paomodabaibai/CyberBrick2-User-Research-UX/README.md

# milk 组桌面双足对战机器人（当前使用 CyberBrick 1）

仓库名沿用早期 CyberBrick 2.0 命名；当前两台机器人实际使用 **CyberBrick 1**。这里集中管理用户研究、方案汇报、视觉素材、结构建模、控制程序与实测记录。

## 当前重点

- 旋转巴掌机器人：遥控行走、转向、倒退和巴掌攻击已实测。
- 出拳机器人：持续遥控、行走/转向、上慢下快出拳及按住 K4 跳舞已获现场确认；独立电池、主动断链与长时稳定性仍待专项验证。
- 项目资料：研究结论、竞品与参考资料、提案文件、硬件 BOM、串口控制原型。

## 快速入口

- [手工竞技场 v08：Figma尺寸图、A/B布局、3D与打印文件](06_游戏设计/Figma制作图与3D_v08/index.html)
- [手工制作 v07：采购、裁切与装配说明](06_游戏设计/手工制作与贴图_v07/README.md)
- [拳头机器人基本完成交接](00_项目管理/2026-10-17_拳头机器人基本完成_交接.md)
- [落地墙体竞技场 v04（历史方案）](06_游戏设计/落地墙体竞技场_v04/README.md)
- [换电脑继续工作：最新状态、环境安装和上传方法](00_项目管理/换电脑继续工作_2026-10-11.md)
- [项目上下文与当前进展](PROJECT_CONTEXT.md)
- [CB1 双机接口对照](04_结构与硬件/CB1双机接口对照_2026-10-11.md)
- [Otto V9 组装速查](04_结构与硬件/Otto_V9组装速查_2026-10-11.md)
- [出拳机器人头部建模详细说明](04_结构与硬件/Otto_CB1出拳头部_v01/出拳机器人头部_建模详细说明_团队同步版.md)
- [出拳头部建模与装配说明](04_结构与硬件/Otto_CB1出拳头部_v01/README_建模与装配.md)
- [出拳头部参数](04_结构与硬件/Otto_CB1出拳头部_v01/parameters.json)
- [出拳头部建模脚本](04_结构与硬件/Otto_CB1出拳头部_v01/build_punch_head.py)

## 目录说明

| 目录 | 内容 |
| --- | --- |
| `00_项目管理` | 计划、任务与协作资料 |
| `01_研究参考` | 用户研究、官方资料与竞品参考 |
| `02_汇报` | 阶段提案与汇报材料 |
| `03_视觉素材` | 图片、图标等视觉资源 |
| `04_结构与硬件` | CAD、打印件、BOM 与装配文档 |
| `05_程序与测试` | 控制程序、串口工具与测试记录 |
| `06_游戏设计` | 对战地图、制作尺寸、贴图与3D交付 |

## 协作约定

1. 开始工作前先拉取 `main` 的最新内容。
2. 每项工作新建短分支，例如 `mechanical/punch-head-fit` 或 `control/home-sensor`。
3. 提交信息写清对象和结果，例如 `调整出拳滑轨间距至 24mm`。
4. 通过 Pull Request 合并到 `main`，在描述中注明改动、验证方式和待确认事项。
5. CAD 参数与生成结果同步更新；物理试装结果写入对应验证记录。

## 本地生成环境

运行时、依赖缓存、第三方应用只读副本和重复交付压缩包不纳入版本控制。出拳头部可在其目录中按说明安装依赖并重新生成 STL、STEP、GLB、预览图和运动验证文件。
