paomodabaibai/CyberBrick2-User-Research-UX/04_结构与硬件/队友拳头模块_2026-09-28_增量审阅/README.md

# CyberBrick 2.0 用户研究与体验设计

本仓库用于团队协作，集中管理桌面双足对战机器人的用户研究、方案汇报、视觉素材、结构建模、控制程序与测试记录。

## 当前重点

- 旋转巴掌机器人：已有结构方案、打印件与控制验证记录。
- 出拳机器人：基于 CyberBrick 1.0 LA024 电机与 LA016 1:48 减速箱，采用滑块曲柄机构实现拳头打出与收回。
- 项目资料：研究结论、竞品与参考资料、提案文件、硬件 BOM、串口控制原型。

## 快速入口

- [项目上下文与当前进展](PROJECT_CONTEXT.md)
- [出拳机器人头部建模详细说明](04_结构与硬件/Otto_CB1出拳头部_v01/出拳机器人头部_建模详细说明_团队同步版.md)
- [出拳头部建模与装配说明](04_结构与硬件/Otto_CB1出拳头部_v01/README_建模与装配.md)
- [出拳头部参数](04_结构与硬件/Otto_CB1出拳头部_v01/parameters.json)
- [出拳头部建模脚本](04_结构与硬件/Otto_CB1出拳头部_v01/build_punch_head.py)

## 目录说明

| 目录 | 内容 |
| --- | --- |
| `00_项目管理` | 计划、任务与协作资料 |
| `01_研究参考` | 用户研究、官方资料与竞品参考 |
| `02_汇报` | 阶段提案与汇报材料 |
| `03_视觉素材` | 图片、图标等视觉资源 |
| `04_结构与硬件` | CAD、打印件、BOM 与装配文档 |
| `05_程序与测试` | 控制程序、串口工具与测试记录 |

## 协作约定

1. 开始工作前先拉取 `main` 的最新内容。
2. 每项工作新建短分支，例如 `mechanical/punch-head-fit` 或 `control/home-sensor`。
3. 提交信息写清对象和结果，例如 `调整出拳滑轨间距至 24mm`。
4. 通过 Pull Request 合并到 `main`，在描述中注明改动、验证方式和待确认事项。
5. CAD 参数与生成结果同步更新；物理试装结果写入对应验证记录。

## 本地生成环境

运行时、依赖缓存、第三方应用只读副本和重复交付压缩包不纳入版本控制。出拳头部可在其目录中按说明安装依赖并重新生成 STL、STEP、GLB、预览图和运动验证文件。
