paomodabaibai/CyberBrick2-User-Research-UX/04_结构与硬件/落地墙体竞技场_v04/README.md

# 落地墙体竞技场 v04 · 试打印组件

2026-10-12。所有组件直接放在同一层地面上。纵向结构只有落地墙和整枚落地靶；靶无支架、底座或升高平台。本目录是待试打的几何原型。

## 打印清单

| STL | 尺寸 mm | 完整场地数量 | 用途 |
|---|---|---:|---|
| 01_wall_160x40x60 | 160 × 40 × 60，四条竖边 R4 | 2 | 限制横向切入的落地墙 |
| 02_ground_target_80x160 | Ø80 × 160，壁 0.8，底 1.2 | 2 | 开口朝上的整枚落地靶，整枚倾倒判定 |
| 03_floor_tile_179p6 | 179.6 × 179.6 × 6 | 15 | 180 节距的平整地板，5 × 3 排列 |
| 04_bridge_connector | 44 × 18 × 2 | 22 | 地板底面连接；不得放在行走面上 |
| 05_seam_coupon_left | 39.8 × 40 × 6 | 试配 1 | 与右样片组成 0.4 mm 接缝 |
| 06_seam_coupon_right | 39.8 × 40 × 6 | 试配 1 | 与左样片和连接片试配 |

优先只打印 **2 面墙、2 枚靶、2 片接口样片和 1 个连接片**，在现有平整桌面上摆放试打。墙脚用可移除胶固定；靶底不粘。墙和靶均不应在机器人初始直线路径上造成必须绕行的小缺口。实体试打确认后再考虑 15 块地板。

## 打印与拼装

- 墙平底向下打印，模型为实心 CAD 外形；切片可用稀疏填充。固定墙脚再测试，不能依赖墙的自重防滑。
- 靶底向下、开口向上打印；0.8 mm 薄壁须在切片中确认能连续生成。两枚靶使用同样材料、层高、壁厚和底层参数。记录实际称重，不能仅靠外观判断一致。
- 地板和接口样片建议翻转，让完整行走面朝打印台，底部连接凹槽朝上打印。打印后翻回，完整平面朝上使用；消除接缝毛边。平整打印面仍须检查翘曲。
- 连接片直接平放打印。底凹槽深 2.4 mm，连接片厚 2 mm；接口每侧名义余量 0.3 mm。地图节距 180 mm，地板边长 179.6 mm，拼接缝 0.4 mm。
- 接口是定位片，没有弹性自锁。拼接后在背面胶带定位，再整体放在平桌面上；不要在上表面横跨接缝贴厚胶带。切勿只靠连接片搬运整张地板。
- 5 × 3 地板共有 12 条横向相邻边和 10 条纵向相邻边，共需 22 个连接片。外围空凹槽在底面，不形成路面台阶。
- 地板 179.6 mm 加两侧各 8 mm brim 为 195.6 mm；最高零件为 160 mm。以上只验证名义 200 mm 打印体积，实际切片仍需核对设备可用范围。

## 击倒目标的适配边界

靶高 160 mm 是可调整的初始值。文档模型给出的约 135 mm 击打参考高度落在靶身内，**不是实测击打高度或动态包络**。实际巴掌与拳头能否打中、会不会先用机身推靶，均需摆放机器人验证。

按理想 CAD 体积和假设材料密度 1.24 g/cm³，脚本给出理论实体质量。它不包含切片误差、材料差异，墙的稀疏填充也不会按实体质量打印。Ø80 的底部及 160 mm 高度没有经过击倒测试，不能据此声称容易击倒或两种攻击平衡。

第一轮试打记录：实际击打高度、两枚靶称重、静置是否稳定、单次攻击能否倾倒、靶是被攻击机构击倒还是被身体推倒、墙是否滑移、两种机器人的表现差异。若需修改靶高度或底部尺度，同一场的两枚靶必须同步修改。

## 数字检查与再生成

`geometry_report.json` 保存每个 CAD 实体的有效性、单实体数量、STL 水密性、连通性、法线绕序、体积和包围盒，另检查接口样片与连接片的精确实体交叠为零。没有进行物理打印、切片、强度或游玩验证。

修改 `parameters.json` 后，在仓库根目录运行：

```powershell
& 'D:/python/python.exe' '04_结构与硬件/落地墙体竞技场_v04/build_components.py'
```

脚本使用已有 `04_结构与硬件/cad_runtime/Lib/site-packages` 中的 CadQuery 和 trimesh。生成 6 种 STL、检查报告，以及包含说明、参数和脚本的 `试打印组件包_v04.zip`。
