paomodabaibai/CyberBrick2-User-Research-UX/requirements-serial.txt

# For uploading/diagnosing CB1 MicroPython boards on a new Windows PC.
mpremote==1.29.0
pyserial==3.5
