paomodabaibai/CyberBrick2-User-Research-UX/03_视觉素材/milk_slap_blue_concept_v01_生成记录.md

# 巴掌款单机概念图 v01

文件：milk_slap_blue_concept_v01.png

生成方式：内置 imagegen；2026-09-16。无参考图片输入。用户希望巴掌与拳击两种版本，先生成巴掌款。

用途：课程提案外观概念图。不是精确复刻 Otto CAD，也不是已验证的机械装配图。图中关节细节、手掌尺寸和转轴安排仍需结合硬件校核，PPT 应标注“概念效果图”。

## 完整提示词

Use case: product-mockup. Create one high quality industrial design concept rendering for a university design presentation: a single small 15 cm tabletop two-legged toy battle robot, a slap-hand variant, no other robots. Otto DIY inspired simple construction: compact rounded rectangular cream-white body with two simple round dark eyes on its front (physical inset discs, NOT a screen), two extremely short blue legs directly below body, no knees, each leg attaches to a broad flat blue foot, four-servo-style biped geometry with believable hip and ankle pivots, low compact stance. One lightweight slapping module mounted on upper side of body: short simple horizontal swing arm on a vertical shoulder pivot, ending in an open five-finger rounded padded blue toy hand held vertically, palm clearly visible and ready to swing horizontally. No elbow, no human-like articulated limbs, no boxing glove, no oversized heavy arm, no weapon. Other side of body has no arm. Body and feet suggest practical 3D printed plastic with subtle layer texture, hand suggests soft foam or silicone. Minimal visible mechanical complexity, plausible toy proportions; this is an exterior concept, not a validated mechanism or technical blueprint. Clean warm off-white studio background and ground, gentle contact shadow, soft diffuse lighting, polished but approachable student product-design aesthetic. Three-quarter front view, both feet and the open hand completely visible, entire robot within frame, generous clean margin. Landscape 4:3 composition. Cream white and friendly medium blue palette, charcoal eye accents. No text, no logo, no arrows, no dimensions, no extra views, no collage, no humans, no sci-fi armor, no wheels, no long legs. Prioritize readable simple short-leg biped shape and clear open-palm slap attachment.
