paomodabaibai/CyberBrick2-User-Research-UX/00_项目管理/继续任务_给其他Agent.md

> **2026-10-17 最终状态：拳头机器人基本完成。** 用户已确认最终四关节 ±25° 跳舞版“没问题了”。持续遥控、行走/转向、上慢下快拳头、推住持续出拳/松杆停止、K4 按住跳舞/松开停止均已具备现场确认。后续重点转为稳定性与对战演示；独立电池组合运行、主动断链停止、长时温升仍待专项验证。当前功能、接线、启动文件及证据边界见 [基本完成交接](2026-10-17_拳头机器人基本完成_交接.md)，本段优先于下方旧状态。

> **2026-10-22 双机控制已部署与资料合并：** 10月21日拳头5文件、巴掌9文件均已上传并板端SHA256核对，启动日志进入持续遥控。共用robot_remote.py，髋30°/踝20°/周期1秒，K4按住跳舞松开停；拳头M1上慢下快，巴掌D1双向900/2100µs、回中1500µs停。巴掌右杆无反应实测为接线松动，重插后用户确认完全恢复控制；攻击后续连接检查恢复转动。最大指令500/2500µs仅短测确认更快且机构正常，未长期保留。10月22日再次运行199项PC测试全部通过；最新转向轨迹、重心与长时负载仍不作全部验收声明。合并同伴场景分支32a21800，补齐PPT、80×120cm场景和插图；汇报原始资料入口为10.22最终汇报素材。短视频尚未制作。下方10月20日“待上传”均为历史状态。

> **2026-10-20 双机统一控制与K4跳舞（PC完成，尚未上传）：** 按用户新要求，两机已改为共用robot_remote.py的行走、单杆前后弧线、换向收步、K4按住跳舞/松开恢复、回中使能、失联停止与持续启动。只在攻击输出和各遥控器ADC校准值上区分profile：拳头M1上慢下快，巴掌D1正反转。统一髋30/踝20/周期1秒，舞蹈四关节±25；最终按用户要求以第一台原步幅为准，第二台髋±30范围待实测。199项PC测试通过（14项新增共享控制/D1/入口测试），两实际profile等效输入下腿PWM逐拍一致；未连串口、未上传、未驱动。原项目程序目录的“待上传_双机统一控制_2026-10-20”包为当前上传入口（巴掌9文件/拳头5文件），替代上一轮只传second_punch_remote.py的旧包。详见程序目录《2026-10-20_双机统一控制与K4跳舞_交接.md》。旧otto_session保留作历史调试，已不作为新巴掌启动入口。

> **2026-10-20 拳头单杆倒退修复（PC通过，待上传）：** 用户确认问题是同一根杆前推、后拉都沿前进弧线。已确认原拳头循环将单杆drive=0统一设为direction=+1；新增walk_direction保留推拉符号，stride_turn分离步幅侧与前后方向，并在换向前收至零幅度。保留髋20/踝16度最大幅度，差幅比由2:1改为3:1；共185项PC测试通过（新增11项），无串口、无上传、无机器人动作。本地巴掌源码也有原单杆默认前进分支，未把两机实物差异归因于不存在的独有映射错误；巴掌与共享振荡器文件没有修改。报告：`05_程序与测试/CB1_Otto控制框架_v02/2026-10-20_拳头单杆后拉前进_修复报告.md`。正式源码在 `E:/课程作业/milk-github-sync`；原项目同级程序目录有“待上传_拳头单杆倒退修复_2026-10-20”包，已有持续版第二台接收板仅替换second_punch_remote.py并复位，入口版本second-punch-walk-reverse-2026-10-20。用户回家再上传，现场前后位移与物理左右仍待确认。

> **2026-10-17 K4 功能更新：** 第二台拳头机器人的 K4（ch9、低电平按下）已由急停改为按住跳舞、松开结束；跳舞期间随机平滑变化四腿姿态，暂停行走输入并停止拳头电机。髋和踝目标偏移均已提高到 ±25°（用户已确认可用），仍受全局 65°–115° 输出限制。失联停止与回中使能保留；K4 不再是急停。173 项 PC 测试通过，三个文件已校验上传并复位；用户现场确认：按住跳、松开停，普通遥控正常，实机验收通过。

> **2026-10-17 第二台拳头机器人最新状态，覆盖下方 10 月 6 日旧断点：** 接收板已部署第二台专用 `main.py`，上电后持续运行三根杆：左/右行走与转向、上推慢拳 1024、下推快拳 1800；用户确认复位后都能控制且稍后仍有反应。PC 171 项通过。原厂 `boot.py` 仍禁用，发射板原厂无线启动未改；第二台启动源文件是 `05_程序与测试/CB1_Otto控制框架_v02/second_punch_main.py`，板上安装名是 `main.py`，切勿用仓库里第一台巴掌机器人的 `main.py` 覆盖。独立电池与断链实机专项验收仍待做。完整证据见 [第二台拳头控制现场记录](../05_程序与测试/CB1_Otto控制框架_v02/2026-10-13_拳头M1持续转动_修复记录.md)。

> **2026-10-06 第二台实测：** 四只位置舵机 S1–S4 已逐路 90→110→90 用户确认；Otto 连续步态脚本悬空/落地短试成功，用户确认落地前进；M1 拳头电机半速连续 5 秒用户确认正常。尚未做第二台遥控、并发出拳、自启动。接手先读 [第二台机器人实测记录](../05_程序与测试/CB1_Otto控制框架_v02/2026-10-06_第二台机器人实测记录.md)，下方 9 月旧断点只作历史参考。

> **2026-09-26 最新实测，覆盖下方巴掌旧猜测：** 用户确认 D1/GPIO21 直驱1700µs逆时针连续3秒、1300µs顺时针连续3秒，均正常；原先1600µs“动了”实际仅约30°，不是持续成功。下一步只把ATTACK.delta_us从100改200并验收摇杆正反转/松手停止。正式配置尚未改，测试已结束并释放D1，遥控主循环尚未恢复。执行入口：[巴掌正反转已验证_最小接入计划](../05_程序与测试/CB1_Otto控制框架_v02/2026-09-26_巴掌正反转已验证_最小接入计划.md)。摇杆自动回中；中间1500µs精准停转及五舵机并发仍需验收。
> **2026-09-26 攻击模块最新交接：** D1/GPIO21 已接巴掌360°连续旋转舵机，50Hz/1600µs实测用户确认能转。连续测试已停止、D1输出已关闭，尚未恢复遥控行走。用户纠正：第三根单轴摇杆会自动回中，旧“不回中”记录错误。历史通道ch2/L3、中位1860需自然回中复核。下一任务为双向低速、松手停止、与行走共享循环；目前只出计划，未实现。执行入口：[2026-09-26_D1巴掌摇杆控制_执行计划.md](../05_程序与测试/CB1_Otto控制框架_v02/2026-09-26_D1巴掌摇杆控制_执行计划.md)。下方旧硬件/控制状态不能覆盖本段。
# 给接手 Agent：milk 桌面双足对战机器人完整交接

> **最新交接（2026-09-26，覆盖下方所有旧断点）：** 全机完成：行走+转向+倒退+巴掌攻击均实机验收通过（用户确认）。攻击 = ch2 杆（自动回中，静止 1824-1827）→ attack_control.py → D1/GPIO21 连续舵机（1500 停/±200 定速）。上电即 otto_session 无限待命。PC 151 测试全绿。遗留小项：1500µs 慢爬长观察、五舵机长时供电、攻击方向语义对齐（翻 direction=-1 即可）。权威记录：《2026-09-26_攻击功能验收通过_最终记录.md》+《2026-09-26_D1巴掌控制_执行完成报告.md》。下方旧段均为历史。

以下为 2026-09-23 晚较早阶段的历史交接，最新实机细节优先看文件顶部链接的夜间遥控行走试验交接记录。

**🆕🆕 2026-09-23 晚：标定完成，板端已处于"可使能行走"状态，下一步就是用户在场走第一步：**
- **四路标定已回写并上板**：config.py 四路 calibrated=True；方向=实测（S1+=左腿前摆、S3+=右腿后摆、S2+=翘尖、S4+=压尖，均③用户确认）；S1 后摆 -10° 顶死 → left_hip min 收窄 82°（步态最多用 -8°）；其余 ±10° 无顶死。板端三文件（config 变体 c3c249f5…、gait_planner f988ef0e…、walk_session d7c948c6…）板上 SHA256 与本地一致，**板上 walk_blockers=[] / can_walk=True**。strict enable 使能时仍需：发射机开、K4 松、双杆回中、有有效帧。
- **左右踝符号已拆**（9-23 晚）：GAIT.ankle_sign_left/right 取代单值 ankle_sign（旧键保留为回退）。依据：双踝镜像（S2+=翘/S4+=压），单值符号永远无法让双脚同向倾斜。初始两值均 1.0，**未经验证，是现场调参旋钮**。
- **新板端入口 walk_session.py**（定时步行会话）：`import walk_session; walk_session.run(45)` —— 严格使能→按 20ms 轮询遥控 45 秒→打印每次状态变化→finally 保证关 PWM。专为串口 exec 无法转发 Ctrl-C 的现实设计；失败/K4/失联不自动恢复，靠打印观察。PC 测试覆盖：交替步、K4 停、无帧拒使能。
- **PC 测试 103 项全绿**（拆踝符号+walk_session+标定事实翻转后）。诚实门禁保留：诚实性测试改用"降级副本"驱动（真实硬件已标定，降级副本模拟未标定仍被拒绝）。
- **未做（下一个 Agent 的活，全部需要用户在场）**：①托住站姿 20s（walk_session.run(20)，期间用户把机器人放桌上）→ 观察双脚平放/倾斜/顶死；②桌面落地短站；③walk_session.run(60) 遥控单步：左杆前推=左步、右杆=右步、回中再触发、K4 停；④现场调参顺序：先看哪只脚该卸载没卸载 → 调 lean/ankle_sign_*（预期至少一个要翻转）→ hip_swing → 各阶段时间；一次只改一个，改完 PC 侧重新生成 _upload/config.py 变体（只改 DRIVER 行）→ 上传 → 板上 pop sys.modules 再 import。**不以"序列执行完"冒充一步成功**；每步记录观察。
- 今日已排除的假故障（都别再怀疑舵机）：S2/S3 "零反应"=插头接触不良，重插即恢复；每次动作前先按压检查四个插头。

**🆕 软件主线已切到 v02，并已完成验收整改+复核收尾（2026-09-22深夜，纯软件未碰实机，v01原样保留）：**
- 位置 `05_程序与测试/CB1_Otto控制框架_v02/`；`python run_demo.py` 一条命令演示（跑在sim_config虚拟档案上，不掩盖真实配置缺件），**整改+阶段A复核后84项测试全绿**（结果存档 output/测试结果_2026-09-22.txt）。**验收复核入口：《验收整改汇报_v02.md》**（按"问题→修改文件与位置→行为变化→验证方法与结果→尚未验证项"逐项写）；首轮汇报《任务汇报_v02_2026-09-22.md》仍留档。
- 正式分层框架：input_adapter→command_mapper→controller状态机→gait_planner五阶段（主髋摆动在unload_swing，land只落脚）→trajectory→joint_model→drivers。**cb1_pwm按关节配置（enabled/actuator/calibrated）决定通道，禁用/连续旋转通道永不创建PWM**；超限拒绝不钳位；停止≠松开输出；失联FAULT需显式recover。
- **显式使能（ENABLE_ON_FIRST_LINK已删除，收尾轮修通可执行流程）**：完整流程=`main_v02.run()`→Ctrl-C暂停（力矩保持）→`main_v02.SESSION.enable()`→`resume()`→`SESSION.recover()`→退出`SESSION.release()`；分步调试=`start(link=RcLink())`+逐拍`poll()`。enable/recover**现场重读遥控**，无活跃帧或K4按住拒绝；**回中后才接受迈步**。Ctrl-C暂停会**取消进行中步态**（STOPPED），暂停期K4/失联检测不运行；`resume()`仅重入循环；异常先释放输出再抛出；`release()`=关闭PWM≠切断舵机电源。**⚠️ REMOTE['stop_button']=3 是按钮组内偏移（from_rc内部+6），勿按v01习惯填全帧索引9。**
- **时间防护**：timeutil统一计时（板端ticks_diff/PC回绕等价）；dt<0记0；单拍>500ms走行中→FAULT拒绝跳阶段；新步不继承请求前等待。板端兼容静态检查完成（导入链无os.path/sys.path等CPython依赖），**板端运行待验证**。
- **新鲜度诚实化**：官方帧无序号/收包时间→timeout_ms=None不伪造新鲜度；不用摇杆值不变推断失联。
- **台架脚本`bench_v02.py`与《台架验证计划_v02.md》已交付**（阶段A）：diag只读/monitor无PWM/joint单关节/demo3缺件/gait完整单步/remote_gait；阶段B1/B2已实测通过（见下），B3等用户托住。
- **Otto V9腿部对中计划阶段一已交付并复核修正（2026-09-23）**：`04_结构与硬件/Otto_V9腿部对中计划_v01/`（安装图/记录表/使用说明/**安装图人工对照核对单**/**现场顺序卡_阶段C对中_一页**）+ **《硬件现货清单_2026-09-23.md》**（04_结构与硬件，未知全标"未核对"）；对中工具PWM两处缺口已修（切换自动关旧通道/seconds打断保证关闭），98项测试全绿+ v02 `center_joint.py`（单关节90°对中，write_one单通道接口，拒S2，导入无PWM，95项测试全绿）。阶段二（逐关节装舵盘）等四只180°舵机齐全+用户在场；手册第5-8页照片渲染图在 `01_研究参考/robot-battle-reference/manual_hi_p5..p8.png` 供人工对照。
- **阶段B1/B2实测已通过（2026-09-23，零舵机动作）**：接收板COM7；13文件（含补传timeutil）板上哈希一致；导入/diag/无动作验证（PWM通道空）通过；**左右杆前推=+1.00方向正确、K4识别正确、关遥控全部返回None（固件不缓存旧帧，失联保护可用）**。明细见v02《实测记录_阶段B_2026-09-23.md》与《台架验证计划_v02.md》状态表。
- 待补/未验证：config标定值（calibrated=False→B3须enable_debug）；B3缺左踝动作验证等用户托住；真实PWM出脉冲未验证（只验证了不产生）；C/D/E未开始；板上REPL Ctrl-C交互未实测。驱动选择`create_driver(jm,cfg)`只认传入配置。注意：`mpremote fs cat`经Windows管道转
，哈希校验须在板上用uhashlib算。**左踝换PG001后只需改config一条目，不改驱动。**
- 真机标定实测值（方向/trim/step_sign/ankle_sign）出来后回写v02的config.py，不要写死在别处。

**⚠️ 本文件下方第2、7、8节含已过时信息，以2026-09-22深夜勘误为准：**
1. **四个接口/四个舵机全部正常**。"S2舵机损坏"是误判（实为360°连续旋转舵机，中位死区）；"S3无响应"是脚本索引bug（改pin后旧脚本按旧索引驱动了S2）。
2. 接口映射实测：S1=左髋、S2=左踝位（现360°舵机占位）、S3=右髋、S4=右踝。方向读数：S1/S3 +10°=向右转（镜像安装）、S4 +10°=翘脚尖；语义未定标。
3. 遥控已通：左摇杆=L1/ch0（静止~1959）、右摇杆=R1/ch3（~1797）、唯一按钮K4/ch9（按下=0）；milk_jog.py摇杆直控舵机用户验证成功；REMOTE_MAPPING_VERIFIED=True。
4. **接收板boot.py已改名boot_official_disabled.py**，官方程序不再自启；恢复官方功能需改回文件名。
5. 托住单步四阶段（test_bench_step_held.py）程序侧已跑通，用户肉眼观察待补。
6. 硬件唯一缺口：~~左踝需180° PG001舵机~~（**已于2026-09-23换装完成**，四路齐）。

## 1. 用户目标、偏好与范围
项目目录：`E:\课程作业\大三上\张茫 用户研究与体验设计`。不要把文件放在本会话另一个作品集目录。
milk第2组，傅宬博、白昊灵、孔舒然、罗圣希。课程六周左右，提案汇报已完成，方向认可。
想做10–20cm桌面短腿机器人对战，两个遥控器分别控制两个机器人，击倒对方获胜。当前先做一台巴掌原型。
腿使用Otto V9原版，无膝关节，4舵机；身体和脚已打印，没打印原头壳。用户允许在身体钻小孔固定顶部模块。
巴掌奶白/蓝色方向，手掌饱满、塑料玩具感，掌面竖直、手指横向，绕竖直轴水平横扫。用户不喜欢先前薄片手掌；最终使用Tripo生成的网格。
拳头红色，用户选James Bruton Punchy齿轮连杆式出拳。只借鉴上部，不用其轮式底盘。
用户倾向快速做实物、当天试验，避免重复问已经确认的问题；愿意焊/转接舵机线。本轮暂不采用裸电机+减速箱驱动巴掌。
NFC刷技能卡、机器人脚部感知场景/道具属于“可能”，不可写成必需已完成。人工判倒地、扶起是首版工作假设，未承诺自动起身或闭环平衡。

## 2. CB1迁移与现有硬件
老师明确CB2不能用，当前CB1。旧CB2申请表必须保留为历史，不要按其接口编程。
曾申请六主控板：两机器人、两手柄、两场景/备用；面板开关6、电池6、双通道摇杆4。不是已实收清单。
当前实机有CB1接收扩展板Shield X11/XA004、发射扩展板XA005、XA003 ESP32-C3核心。
- 接收S1/S2/S3/S4：GPIO3/2/1/0。
- D1/D2灯信号：GPIO21/20，是第五舵机候选。官方buzzer.py使用这两个脚的machine.PWM，硬件实际线序、电源负载与资源仍须测试。
- M1驱动GPIO4/5，M2驱动GPIO6/7，经电机驱动桥；M口不是裸GPIO，不能给位置舵机当控制口。
- 按先前照片大电源座朝下：左上D2、右上D1、左下M2、右下M1、中间S1–S4。
- CB1白色小3pin线为SH1.0 3P；舵机黑色常规3孔插头通常为2.54mm，需要配公针的转接。现成SH1.0到杜邦公针线可选。即使插得上，仍要核实V/G/S顺序，不能全黑线凭位置猜。
- 用户照片确认B-LA026差速器包，以及B-LA016 1:48单轴减速包两包。它们不是已经装好的减速箱；裸电机具体型号看起来像030，未凭照片确认为LA024。
- 电机接口支持正反转、PWM调速、停止。以后拳头计划电机驱动，不代表已选定电机/减速比或适配完成。

PG001位置舵机资料：4.8–6V、180°；6V额定扭矩≥0.4kgf·cm、堵转≥1.2kgf·cm，堵转电流≤650mA。不可把堵转扭矩当持续能力。
机械：主体23×12mm，安装耳总32.5mm、孔距27.8mm、孔槽2.2mm；40T/约4.85mm输出花键，使用原配舵盘。SG90“9g”不代表舵盘或全部尺寸通用。
用户提过360°舵机也可能能用，但**实际巴掌舵机型号仍未确认**。普通连续旋转型控制速度/方向，不能按角度准确回位。
五舵机供电未带载验证；灯口电源不能凭存在就认为足够带舵机；也不能直接用高压电池给PG001供电。

## 3. 机械文件与不可混用的版本
### 原模型
`01_研究参考/robot-battle-reference/Otto-V9/`
- CAD/OttoDIY_v09.step
- 3Dprint/OttoDIY_body_V9.stl，以及Leg、foot等原打印文件。
原身体外包络69×69×39mm；装配坐标x/y±34.5，z=-39..0。

### 顶部架v01
`04_结构与硬件/Otto_PG001顶部巴掌模块_v01`
build_model.py、parameters.json、STL_打印件、STEP_可编辑实体、装配与渲染。
外框75×75，套合内口69.8，裙边8mm；桥75×22×3mm，舵机槽23.8×12.8mm，耳孔x±13.9；顶部桥z22..25，侧面固定框允许后钻孔。
v01中的旧薄巴掌/旧杆不是最新打印目标。保留框和PG001桥。

### 当前尺寸与v02接口
用户最后确认：**手掌最长边75mm；轴心到杆末端孔组中心51mm**。杆总长63.5mm，宽10、厚3。不能把51误作杆总长。
原Tripo：`C:\Users\Administrator\Downloads\thumbs+up+hand+3d+model.stl`。
项目副本：`04_结构与硬件/巴掌_Tripo网格与尺寸调整/巴掌_Tripo原始.stl`。
该目录的“输出_手掌75mm_杆距51mm”是旧无接口版本，不应重新当作最终掌打印。
最新：`04_结构与硬件/Otto_75mm巴掌腕部接口_v02/`
- build_interface.py：CadQuery+网格布尔，render_interface.py：VTK渲染。
- STL_打印件：01腕部试装件、02插入连接块、03杆末端试装片、04完整手掌75mm带接口、05完整连接杆51mm杆距。
- STEP_结构件：连接块/结构杆等实体；手掌依旧网格，不是假装参数化STEP。
- 装配坐标_勿直接打印、接口参数.json、几何验证报告.json、先读我_试装与打印.md。
- 整机总装_v02.png/.glb，腕部连接_装配拆解剖视.png。
连接块23×12×6mm；掌腕槽每侧0.25mm间隙。根部两颗 **M2×8**、两颗M2螺母；横穿腕部 **M2×25** +第三颗M2螺母；小垫片厚约0.3–0.5mm。根部不是M2×10，否则影响插拔。
已做闭合网格、静态重叠、离散插拔和螺钉包络检查；不等于强度、连续运动、打印公差已验证。

### 用户实际决定先打印整套
`04_结构与硬件/2026-09-21_整机首轮试打印包/`
五件各一：身体顶部框、PG001桥、51mm杆距杆、腕连接块、75mm完整掌。
同级 `2026-09-21_整机首轮试打印_五件各一.zip`。
用户已说“在打印了”，随后照片出现蓝色巴掌；不能推断所有五件都装好或通过测试。
不再强迫先打印三件量规，这是用户已覆盖的旧顺序。

### 工具环境
CAD Python：`04_结构与硬件/cad_runtime/Scripts/python.exe`，有cadquery、trimesh、numpy、VTK、manifold3d、fast-simplification等。
交互比例图：`C:\Users\Administrator\.codex\visualizations\2026\09\14\01a09d93-5828-7951-8f50-b4e4bdacf50a\otto-palm-proportions.html`；最新状态75/51。它早于v02正式接口，只用于比例，不是实际装配证明。

## 4. Punchy与提案资料
`01_研究参考/攻击模块/Punchy/`：Punchy.stp、joystick.stp、PunchyRobot.zip、LICENSE、README.md。
原仓库：https://github.com/XRobots/Punchy （MIT）。未完成缩放、驱动选择、安装座适配或承载分析。
提案：`02_汇报/2026-09-17_项目提案/`，14页PPT、逐页文案/讲稿、构建脚本；旧外观概念图曾被用户否定结构，只认可配色。

## 5. 当前控制需求与代码
用户要“推左杆 -> 左脚完整迈一步；右杆 -> 右脚一步”，不是单杆直接控单舵机。四舵机应协调移重心、挪步。机械没有膝盖，不做类人抬膝。
遥控现有两个单轴推杆；是否自动回中未知。可配按钮，现建议K1攻击、K2使能、K3停止。各插口及按钮极性未验证。
`05_程序与测试/CB1_Otto单步实验_v01/board/` 六文件：
- milk_config.py：所有映射和参数。
- milk_core.py：Trigger、Gait、RemoteGate、角度限位。
- milk_hw.py：PWM与Attack。
- milk_bench.py：REPL单关节、站姿、步态。
- milk_probe.py：固件和遥控只读检查。
- milk_receiver.py：官方rc_module接收循环。

来源与算法边界：
OttoDIY/OttoDIYLib的Otto.cpp walk：髋幅30°、踝幅20°，踝偏置+4/-4，髋踝相差90°；Oscillator用正弦；steps是周期数，不是指定左脚事件。
本版**不是完整移植原步态**，是参考配合关系独立写四阶段（移重心/卸载/摆动/落脚）小幅插值实验；无足底反馈，不能保证实际卸载。
当前幅度hip8°、lean7°、lift3°；4阶段各450ms；末端保留髋部偏角。
明确局限：首步任选，此后左右交替；同侧重复拒绝，尚未实现用户全部自由单侧迈步需求。不要对外说已经全部完成。
按杆过阈值一次触发；回中才再解锁；双杆冲突不动作；忙时丢弃不排队；攻击与步态互斥。
遥控两杆回中、攻击松开、使能按1秒才开始。停止锁存腿部最后指令，不自动回中；Ctrl-C退出释放PWM，因此需人工支撑。
250ms失联超时依赖rc_slave_data返回None。若固件返回缓存旧帧，本版没有包序号，不能可靠探测，应停下修复通信方案。
位置巴掌小幅往返；continuous模式按住转松手停并有700ms上限；默认关闭，未实测。
17项PC测试通过、CPython语法通过；六模块在真实MicroPython导入通过。不等于姿态、PWM、无线、供电和走路验证。

## 6. 实机连接与上传结果
串口环境：`05_程序与测试/serial_runtime/Scripts/python.exe`，独立venv安装mpremote1.29.0/pyserial3.5。
默认系统python是hermes环境，不往那个环境随意安装库。
COM7（接收）：序列58:E6:C5:A8:1B:0C，GPIO10=0，rc_index=1。
COM8（发射）：序列58:E6:C5:A7:00:A4，GPIO10=1。重插后应按序列与角色重新确认。
固件ESP32-C3，MicroPython1.23.0-preview，2026-03-25构建。
原文件已备份 `05_程序与测试/板载备份_2026-09-22/COM7,COM8`。保留boot.py、app/bbl/rc_config/log/.ignore；40文件271750字节，不是flash/NVS备份。
六milk文件仅上传COM7，SHA256核对一致，import全部成功。原boot.py和发射端文件未改。
连接使用`mpremote connect COM7 resume ...`避免隐式软重启；为进入REPL已经打断原应用。COM8也被打断，后续遥控测试需恢复发射端运行。
不要直接soft_reset接收器试运转；原boot.py会导入rc_main并自动运行原官方控制。不能让官方控制和实验程序同时占PWM。

## 7. 最重要的现场断点
详情见同项目程序目录 `现场调试记录_2026-09-22.md`。
- 用户不知道S口与四关节的对应，所有名称都还是占位！不要用config.name当真实映射。
- 用户托好后允许测试；S1(GPIO3)中位1秒，命令成功并关闭输出。用户说没关节动。
- 用户确认电池开着，允许继续。
- S1中位±5°缓慢往返两次（约3秒运动，加前后等待），最终关闭输出；终端START和PWM OFF正常。**用户尚未反馈这次有没有动。**
- 过程中一次内联串口命令因引号SyntaxError未执行；改成本地test_s1_live.py运行成功，不要当硬件故障。
- 没测试S2/S3/S4，没跑站姿、步态或巴掌。CALIBRATED/REMOTE_MAPPING_VERIFIED/ATTACK_ENABLED都False。
- 用户当前只要求总结保存，交接文档不构成自动扩大幅度或接着动其他通道的授权。

## 8. 接手下一步，不从头重做
1. 先询问S1第二次测试的观察结果，必要时重新确认托好和巴掌断开。
2. 若动，记录实际关节和+/-方向，再逐路小幅辨认；若不动，优先电源/线序/接触/插口/单个已知舵机隔离，不扩大到大角度。
3. 记录“接口->真实关节”后重新排列JOINTS的pin；center/trim微调，不用大trim掩盖舵盘安装错齿。
4. 四关节标定后托住做站姿，再验证支撑侧。脚踝符号与LEFT_SIGN需现场校验，尚未验证的小步可能只拖脚或原地扭动。
5. 再试串口左右交替；随后恢复发射端、读取十通道原始值、测失联行为，再启用遥控。
6. 最后单测第五舵机接线、模式、停止中点与扫掠空间，再加巴掌。
7. 每次明确记录：只成功发命令，还是用户已确认真实动作，不能混淆。

## 9. 主要来源
- CB1：https://github.com/CyberBrick-Official/CyberBrick_Controller_Core
- 固定参考提交：9712a8439f339a09e454baf543b8e97a5b1f03a7。
- API：https://makerworld.com/en/cyberbrick/api-doc/index.html（曾访问失败，优先本地源码及rc_module.rst）。
- Otto：https://github.com/OttoDIY/OttoDIYLib
- 030减速箱官方图：https://store.bblcdn.eu/s8/default/5eb26f09c19c49e481ebe4e0ace72cdd/Assembly_Guide_of_Single_Axis_030_Reduction_Motor.pdf
- CB1研究与STEP：`01_研究参考/CyberBrick1迁移研究/`。
早期CyberBrick软件API调用403、误调用Claude问题不是当前活跃任务；不要为当前校准重新配置大模型API。CB2的旧MCP连接也不是现在CB1串口控制的依赖。

## 后续只读复核补充：以最新进展为准（2026-09-22）
本轮读取了深夜更新，没有连接串口、运行舵机或上传代码。以下是本地源码复核，不是新的实机结论。
1. 当前真实断点已经前进：S1左髋/S2左踝位/S3右髋/S4右踝；S2是连续旋转舵机而非损坏。遥控jog用户验证成功，正式步态未验证。旧交接中“等待S1第二轮反馈”“boot未修改”已过时。
2. **不要直接重跑test_bench_step_held.py。** 脚本注释称S2只发中位，但循环实际调用out.pose(pose)，milk_hw.Output.pose逐个原样发送偏角，没有屏蔽左踝。因此会给S2连续旋转舵机发送非中位脉宽。应先换正确180°舵机，或修改测试明确排除S2并验证；排除S2的三关节演示不代表完整步态。中位是否真能停转仍需校准，不能凭1500us假定。
3. **正式milk_receiver.py目前无法用K4解锁。** config把ATTACK_BUTTON/ENABLE_BUTTON/STOP_BUTTON均设9：按下使能时同时stop=True且pressed=True，RemoteGate优先停止、neutral条件也要求not pressed。jog成功不等于正式接收状态机成功。需另设计单按钮状态逻辑或增加独立按钮，并测试冲突后再启用。
4. milk_config.py头部仍写左踝FAULTY，已被最新实物识别推翻，后续改代码时同步清理此过时注释。
5. 17项测试通过属于旧配置历史结果；当前REMOTE_MAPPING_VERIFIED=True后旧测试test_default_config_no_activation断言False不再适配。没有在本轮重跑，不声称最新修改仍全部通过。
下一步优先处理上述两项源码与说明矛盾，然后在180°左踝就位、方向与中位确认后做完整步态。不要按旧文直接绕过CALIBRATED门禁。
