paomodabaibai/CyberBrick2-User-Research-UX/00_项目管理/新电脑Agent完整交接_2026-10-12.md

> **2026-10-17 最终状态：拳头机器人基本完成。** 用户已确认最终四关节 ±25° 跳舞版“没问题了”。持续遥控、行走/转向、上慢下快拳头、推住持续出拳/松杆停止、K4 按住跳舞/松开停止均已具备现场确认。后续重点转为稳定性与对战演示；独立电池组合运行、主动断链停止、长时温升仍待专项验证。当前功能、接线、启动文件及证据边界见 [基本完成交接](2026-10-17_拳头机器人基本完成_交接.md)，本段优先于下方旧状态。

> **2026-10-17 K4 功能更新：** 第二台拳头机器人的 K4（ch9、低电平按下）已由急停改为按住跳舞、松开结束；跳舞期间随机平滑变化四腿姿态，暂停行走输入并停止拳头电机。髋和踝目标偏移均已提高到 ±25°（用户已确认可用），仍受全局 65°–115° 输出限制。失联停止与回中使能保留；K4 不再是急停。173 项 PC 测试通过，三个文件已校验上传并复位；用户现场确认：按住跳、松开停，普通遥控正常，实机验收通过。

# CyberBrick 项目总结与新电脑启动交接

> **2026-10-17 最新状态，覆盖下文旧的“无 main.py/限时测试”描述：** 拳头接收板原厂 `boot.py` 已禁用，第二台专用 `second_punch_main.py` 已作为板上 `main.py` 安装，复位后持续运行 `seconds=None, mode='both'`；三根杆分别控制左/右行走和转向、上推慢拳 1024、下推快拳 1800。用户现场确认复位后全部可用，稍后仍有反应。通道为左 ch3、右 ch0、拳头 ch2、K4 ch9；拳头上推 ch2 高值、下推低值。PC 171 项测试通过。**独立电池模式和断链实机专项验收仍未完成。** 当前源文件在 `control/second-punch-remote` 分支；详见 [`2026-10-13_拳头M1持续转动_修复记录.md`](../05_程序与测试/CB1_Otto控制框架_v02/2026-10-13_拳头M1持续转动_修复记录.md)。

更新日期：2026-10-12（澳门时间）。本文可直接交给新电脑 Agent，按步骤下载项目、建立环境、上传并启动拳头机器人的限时遥控程序。

## 1. 先读这几个结论

- 仓库：<https://github.com/paomodabaibai/CyberBrick2-User-Research-UX>。
- **最新拳头代码在 `control/second-punch-remote` 分支。不要只下载 main。** 截至本次核对，已推送的最新功能提交是 `3dd8122`；交接文档本身可能产生更新提交。以该分支最新内容为准。
- 仓库名中的 CyberBrick2 是早期名称，当前使用 **CyberBrick 1、ESP32-C3、板载 MicroPython**。
- 本项目上传 `.py` 文件，使用 `mpremote`。保留原厂固件、无线配置和电机驱动，不需要 esptool 或 STM32 烧录工具。
- 当前任务重点是第二台“拳头机器人”。第一台“巴掌机器人”的程序、标定和自启动不能直接覆盖第二台。
- 当前拳头程序已随接收板上电自动运行；仓库 `second_punch_main.py` 是第二台专用入口，板上文件名 `main.py`。仓库根目录下另一份 `main.py` 是第一台巴掌机器人的入口，不可覆盖第二台。
- 用户确认硬件没有变化，要求沿用原通道映射，不强制重新逐杆采样；若同一套硬件连接正常，直接用 `second_remote_ready.py` 的配置继续。
- 用户要求每次项目更新在验证后及时提交并推送 GitHub。使用工作分支，报告实际推送结果。

## 2. 项目总体情况

这是 milk 组的桌面双足对战机器人项目，采用 Otto V9 四舵机双足底盘，两个机器人分别配置旋转巴掌和直流电机出拳机构。仓库包含用户研究、汇报、视觉素材、机械模型、打印件、接口表、控制源码及现场记录。

| 设备或功能 | 已知状态 |
|---|---|
| 第一台巴掌机器人 | 仓库记录已完成遥控行走、转向、倒退和巴掌攻击的实机验收 |
| 第二台历史测试 | 仓库记录已验证四舵机、短时前进及 M1 半速运行；不是本次连接的完整状态证明 |
| 本次第二台前进与左转 | 2026-10-11 执行前进 2 秒、左转 2 秒，用户明确确认“完全可以很不错呢” |
| 本次无线链路 | 发射板初始化成功；接收板能连续收到十通道帧 |
| 本次遥控运行 | 30 秒运行显示 ARMED，正常结束，没有异常 |
| 遥控机械验收 | 尚未收到用户对这轮遥控行走、出拳和并发真实动作的反馈；不能宣称全部验收 |
| 软件测试 | 原框架 151 项 + 新增 17 项，共 168 项测试通过 |
| 自动启动 | 未部署；原厂 boot.py 保留 |

目录：`00_项目管理` 为交接与计划，`01_研究参考` 为研究资料，`02_汇报` 为提案，`03_视觉素材` 为图片，`04_结构与硬件` 为模型/打印/接口，`05_程序与测试` 为代码与实测。

旧电脑仓库位于 `C:\Users\Windows11\Desktop\cyberbrick`。新电脑可以另选位置，后续命令均从新仓库根目录执行。

## 3. 新电脑下载正确分支

以下以 Windows PowerShell 为例。先安装 Git 和 Python。建议 Python 3.13，本次实际运行和测试使用 3.13；旧文档要求的 3.11 也可建立环境，但需自行跑回归。

目标文件夹不存在或为空时：

```powershell
git clone --branch control/second-punch-remote https://github.com/paomodabaibai/CyberBrick2-User-Research-UX.git cyberbrick
Set-Location .\cyberbrick
git branch --show-current
git log -3 --oneline
```

已有仓库时，先 `git status --short`，保留已有修改，再执行：

```powershell
git fetch origin
git switch control/second-punch-remote
git pull --ff-only origin control/second-punch-remote
```

如果此分支后续已合并到 main，应检查 main 是否确实包含下面三个遥控文件及最新实测记录，再决定切换；不能因 main 名称就假定它最新。

旧电脑 Git 直连失败，需要系统已有代理。新电脑仅在实际有对应代理时使用，例如：

```powershell
git -c http.proxy=http://127.0.0.1:7897 clone --branch control/second-punch-remote https://github.com/paomodabaibai/CyberBrick2-User-Research-UX.git cyberbrick
```

不要假定新电脑的代理端口也为 7897。

## 4. 建立独立 Python 环境并验证

仓库根目录：

```powershell
py -3.13 -m venv .venv
& '.\.venv\Scripts\python.exe' -m pip install -r requirements-serial.txt
& '.\.venv\Scripts\python.exe' -m mpremote --help
```

依赖固定为 mpremote 1.29.0、pyserial 3.5；无需激活 venv，直接使用其 python 路径即可。如果使用其他 Python 版本，修改 venv 创建命令即可。

运行不连接硬件的 PC 回归：

```powershell
Push-Location '.\05_程序与测试\CB1_Otto控制框架_v02'
try {
    & '..\..\.venv\Scripts\python.exe' -B -m unittest discover -s tests -p 'test_*.py' -q
} finally {
    Pop-Location
}
```

本次版本预期 168 项通过，耗时约 21 秒。若仓库有后续测试新增，以最新结果为准。失败时先处理环境或源码问题，不运行实机动作。

## 5. 识别接收板和发射板

先枚举，无须接管板端程序：

```powershell
& '.\.venv\Scripts\python.exe' -m mpremote connect list
```

上一台电脑的身份记录：

| 板卡 | 原串口，仅供参考 | USB 序列号 | GPIO10 |
|---|---|---|---|
| 拳头机器人接收板 | COM14 | `80:F1:B2:1E:0F:FC` | 0 |
| 配套发射板 | COM15 | `80:F1:B2:1D:43:3C` | 1 |

**新电脑的 COM 号可能不同。** 根据序列号优先匹配，再定义实际端口，例如：

```powershell
$receiverPort = 'COM14'  # 替换成新电脑实际值
$transmitterPort = 'COM15'  # 替换成新电脑实际值
$controlDir = '.\05_程序与测试\CB1_Otto控制框架_v02'
```

必要时逐块连接，读取角色：

```powershell
& '.\.venv\Scripts\python.exe' -m mpremote connect $receiverPort resume exec "import machine; print(machine.Pin(10,machine.Pin.IN).value())"
& '.\.venv\Scripts\python.exe' -m mpremote connect $transmitterPort resume exec "import machine; print(machine.Pin(10,machine.Pin.IN).value())"
```

第一条应为 0，第二条应为 1。mpremote 会接管 REPL，可能打断原应用；检测后应恢复发射端无线初始化。不要同时打开 IDE 串口监视器和 mpremote。

## 6. 接线与最新参数

| 接口 | GPIO | 拳头机器人用途 |
|---|---|---|
| S1 | 3 | 左髋 |
| S2 | 2 | 左踝 |
| S3 | 1 | 右髋 |
| S4 | 0 | 右踝 |
| M1 | 4、5 | 拳头直流电机 |
| D1 | 21 | 拳头程序不用；属于第一台巴掌方案 |

四腿为位置舵机，50 Hz。测试步态髋幅 20°、踝幅 16°、偏置 4°、周期 1000ms、转向分幅 10°、直行配平 0。串口前进和左转实测保持这些参数。

遥控最新配置在 `second_remote_ready.py`：

```python
MAPPING = dict(left=3, right=0, attack=2, stop=9,
               left_center=2051, right_center=2128, attack_center=2146)
```

左 ch3、右 ch0、攻击 ch2、K4 ch9；K4 按下 0、松开 1。用户指定沿用映射。中值来自当前板的静态帧，不要再用核心模块内旧的 1797/1959/1825 默认值直接运行。

本次接收板原厂 `bbl/motors.py` 使用 `easypwm`，没有 `motors_period_cb()`；新控制代码兼容这一版本，也兼容需要周期回调的旧驱动。不要为补回调函数覆盖原厂驱动。

## 7. 上传代码：三份遥控文件缺一不可

先关闭串口占用，托稳机器人并让拳头前方留空。上传不会自动执行测试，但接管 REPL 可能终止之前运行的程序。

已有上传工具只负责前两个文件，不会上传 `second_remote_ready.py`。需要按下面步骤补传最新配置入口。

如果 PowerShell 阻止脚本，可只对当前会话设置：

```powershell
Set-ExecutionPolicy -Scope Process Bypass
```

上传主程序和振荡器，工具会核验接收板、检查 M1 接口、备份旧文件并回读 SHA256：

```powershell
& "$controlDir\准备拳头测试.ps1" -Port $receiverPort -ConfirmedReceiver
```

若报错，停止后续步骤。不要将失败时的部分上传当作完整成功。

备份并上传配置入口：

```powershell
New-Item -ItemType Directory -Force '.\work' | Out-Null
$backupDir = Join-Path '.\work' ('new_pc_upload_' + (Get-Date -Format 'yyyyMMdd_HHmmss'))
New-Item -ItemType Directory -Force $backupDir | Out-Null

# 先查看板端文件；second_remote_ready.py 已存在时执行下面的备份命令。
& '.\.venv\Scripts\python.exe' -m mpremote connect $receiverPort resume fs ls
# 仅在板端已有该文件时执行：
# & '.\.venv\Scripts\python.exe' -m mpremote connect $receiverPort resume fs cp :second_remote_ready.py "$backupDir\second_remote_ready_before.py"

& '.\.venv\Scripts\python.exe' -m mpremote connect $receiverPort resume fs cp "$controlDir\second_remote_ready.py" :second_remote_ready.py
if ($LASTEXITCODE -ne 0) { throw '配置入口上传失败' }
& '.\.venv\Scripts\python.exe' -m mpremote connect $receiverPort resume fs cp :second_remote_ready.py "$backupDir\second_remote_ready_readback.py"
if ($LASTEXITCODE -ne 0) { throw '配置入口回读失败' }
if ((Get-FileHash "$controlDir\second_remote_ready.py").Hash -ne (Get-FileHash "$backupDir\second_remote_ready_readback.py").Hash) {
    throw '配置入口哈希不一致'
}
```

最终接收板必须具备：`otto_oscillator.py`、`second_punch_remote.py`、`second_remote_ready.py`。原厂 boot.py、rc_config、bbl、app 保留。

不要上传整个目录覆盖板端，不要把第一台的 config.py/boot.py 一起复制。虚拟环境和本地备份无需上传。

## 8. 恢复发射端并启动遥控

发射板沿用原厂程序，不需要上传机器人控制文件。本次初始化方式：

```powershell
& '.\.venv\Scripts\python.exe' -m mpremote connect $transmitterPort resume exec "import machine, rc_module; assert machine.Pin(10,machine.Pin.IN).value()==1, 'not transmitter'; print('master_init=',rc_module.rc_master_init()); print('data=',rc_module.rc_master_data())"
```

正常应显示 `master_init=True` 和十通道数据。若只是重新上电且原厂发射程序已经正常运行，可不重复接管；若无数据，先排查供电、角色和配对。

接收板只做导入验证，不动作：

```powershell
& '.\.venv\Scripts\python.exe' -m mpremote connect $receiverPort resume exec "import second_remote_ready as remote; print(remote.MAPPING)"
```

使用者在场、机器人受支撑、三个杆回中且 K4 松开时，启动限时测试：

```powershell
& '.\.venv\Scripts\python.exe' -m mpremote connect $receiverPort resume exec "import second_remote_ready as remote; remote.run(seconds=30, mode='both')"
```

显示 ARMED 后可拨杆。命令运行约 30 秒，正常结束输出 M1 stopped / leg PWM off。Agent 应在测试前给用户清晰的开始提示，不要在未提示情况下多次重跑。

也可以分别执行：

```powershell
& '.\.venv\Scripts\python.exe' -m mpremote connect $receiverPort resume exec "import second_remote_ready as remote; remote.run(seconds=10, mode='walk')"
& '.\.venv\Scripts\python.exe' -m mpremote connect $receiverPort resume exec "import second_remote_ready as remote; remote.run(seconds=10, mode='attack')"
```

一次只运行一条，结束后再运行下一条。不要直接执行 `second_punch_remote.run()`，它会使用旧中心值。

## 9. 操作语义和停止

- 连续回中 0.5 秒才使能；启动时杆已偏转则不使能。
- 两行走杆同向推：前进；同向拉：倒退。单杆或差动输入：弧线转向，实际左右语义仍需用户观察。
- 出拳杆任一方向过阈值：M1 正向半速 1024。没有电机反转；松杆停止，连续最多 1.5 秒，完全回中后才能再次触发。
- K4 按下、无帧或坏帧会停电机并释放腿 PWM。回中后可以重新使能，K4 不是永久锁存急停。
- Ctrl-C、时限到或异常会执行清理，停 M1 并关闭腿 PWM。PWM 关闭不切断供电，机器人可能失去支撑；现场保留电池开关可用。
- 无线 API 没有帧序号/收包时间。失联保护依赖固件返回 None，不能保证识别缓存旧帧；必须实测遥控断电的停机行为。
- 拳头机构没有回零传感器；当前短时转动不保证“一拳一次”或自动回到收拳位置。

若同一硬件不进入 ARMED，可读取几帧判断链路和回中是否偏移；这是故障诊断，不需要从头重新做硬件研究。用户已经指定保留原通道映射。

## 10. 没有发射板时的已验证串口动作

仅在用户要求动作时运行。上传 `second_scripted_motion.py` 后执行：

```powershell
& '.\.venv\Scripts\python.exe' -m mpremote connect $receiverPort resume fs cp "$controlDir\second_scripted_motion.py" :second_scripted_motion.py
if ($LASTEXITCODE -ne 0) { throw '动作脚本上传失败' }
& '.\.venv\Scripts\python.exe' -m mpremote connect $receiverPort resume exec "import second_scripted_motion as test; test.run()"
```

该脚本回中等待 2 秒，前进 2 秒，左转 2 秒，300ms 回中后关闭 PWM，拳头电机保持停止。2026-10-11 用户确认实际前进和左转可用。

## 11. 若硬件继续插在旧电脑上

上述步骤默认 USB 硬件直接插在新电脑。如果硬件仍接旧电脑，新电脑不能直接使用自己的 COM 号；应先 SSH 到旧电脑，然后在旧电脑运行 mpremote，或使用仓库的 `远程上传CB1脚本.ps1`。

旧电脑曾使用 `windows11@192.168.1.107`，sshd 已配置；新地点/IP 是否可达需要验证。Windows 管理员用户密钥路径取决于 sshd_config，可能使用 `C:\ProgramData\ssh\administrators_authorized_keys`。已有远程上传助手只支持单个文件，不会自动部署三份遥控文件或配置发射端。SSH 场景同样需完整上传依赖，并显式调用远程 PowerShell。

## 12. GitHub 同步与交接约定

仓库文档 `00_项目管理/GitHub同步约定.md` 记录了用户的持续授权。每次代码、配置或实测有更新，跑相关验证，更新实测记录，然后提交并推送 `control/second-punch-remote`；不要强推，不随意覆盖团队 main。

```powershell
git status --short
git diff --check
# 用明确路径加入本次修改，不把无关内容一起提交。
git add <本次修改文件路径>
git commit -m "说明实际修改和验证结果"
git push origin control/second-punch-remote
```

新电脑需配置 Git 提交身份并登录具有仓库写权限的 GitHub 账号。旧电脑账号 nexuskarisma 首次遭遇 403，随后权限生效并推送成功；新电脑认证仍须单独建立。发生 403 时报告真实失败，不把本地提交称为已上传。

本地 `work/` 和 `.venv/` 已忽略，备份不要进入 GitHub。新电脑必须自行备份板端；旧电脑工作目录的备份不会随 clone 下载。

优先阅读 `README.md`、本文件、`2026-10-11_拳头遥控测试说明.md` 和三个最新遥控源码。PROJECT_CONTEXT.md 和旧交接保留过时 COM 号、电脑路径及历史状态，不能据此覆盖最新配置。

## 13. 新 Agent 的任务边界

继续第二台拳头机器人的遥控测试，沿用已准备的最新入口与用户指定的映射。先完成环境和上传校验，再在现场用户准备好后启动短时测试；记录程序输出和用户观察，区分“运行成功”与“真实动作验收”。后续推进倒退、右转、出拳、并发、K4 和断链停止验收。自动启动、长期运行、回零传感器或改变攻击输入属于后续设计项，不能假定已经完成。
