paomodabaibai/CyberBrick2-User-Research-UX/04_结构与硬件/CB1双机接口对照_2026-10-11.md

# milk 组 CB1 双机接口对照（发给组员版）

**方向约定：** 机器人面朝前，左/右按机器人自身左右。两台底盘都用 Otto V9 四只 **180°位置舵机**；四路均已做过中位及小幅动作观察。安装时先接对端口，再给 90°中位，最后锁舵盘。

| 接收板接口 | 主控 GPIO | 机器人部位 | 已验证状态 |
|---|---:|---|---|
| **S1** | 3 | 左髋：左腿前后摆 | 两台均已动作；第一台 +角度=左腿向前 |
| **S2** | 2 | 左踝：左脚倾斜 | 两台均已动作；第一台 +角度=脚尖翘起 |
| **S3** | 1 | 右髋：右腿前后摆 | 两台均已动作；第一台 +角度=右腿向后 |
| **S4** | 0 | 右踝：右脚倾斜 | 两台均已动作；第一台 +角度=脚尖压下 |
| **D1** | 21 | 第一台的 360°连续旋转巴掌舵机 | 第一台实测可正反转；第二台不用 |
| **M1** | 4、5 | 第二台的拳头直流电机，经板载 H 桥 | 第二台实测半速持续转 5 秒；第一台不用 |
| M2 | 6、7 | 备用直流电机口 | 板载驱动源码有映射；本项目未实测 |
| D2 | 待核实 | 备用扩展口 | 不列入当前接线；不要凭猜测接舵机 |

**舵机中位：** PG001 项目当前使用 50 Hz、1500 µs = 90°。S1–S4 是带位置反馈的 180°舵机；巴掌 D1 是连续旋转舵机，1500 µs 代表停止、1300/1700 µs 是两个转向，不能把它当作“90°定位”。M1 为两线直流电机口，不接三线位置舵机。插头方向按实物 `S/V/G` 丝印核对；先确认供电电压和极性，不要只按线色猜测。

## 遥控器与程序现状

| 项目 | 第一台巴掌机器人 | 第二台拳头机器人 |
|---|---|---|
| 左右行走杆 | 第一台实测：实体左杆 ch3、右杆 ch0；前推 ADC 增大 | 遥控器与接收板配对、通道映射尚未单独验收 |
| 攻击输入 | 第三单轴杆 ch2，自动回中，控制 D1 巴掌正反转 | 尚未接入遥控拳头控制 |
| 按钮 | K4 对应 ch9，但第一台现用程序中无功能 | 待定义 |
| 当前能力 | 第一台遥控行走、转弯、倒退、巴掌已实测 | 第二台仅脚本短时前进 + 独立 M1 电机运行实测；尚非遥控对战成品 |

## 安装时随时让四路保持 90°

板端脚本：[hold_90_cb1.py](../05_程序与测试/CB1_Otto控制框架_v02/hold_90_cb1.py)；电脑端发送工具：[发送四舵机90度.ps1](../05_程序与测试/CB1_Otto控制框架_v02/发送四舵机90度.ps1)。**一次只接一台接收板**，脚本会确认 GPIO10=0，防止误发给遥控发射板。已装好腿脚时请先托住机器人，程序可能让关节突然回中。

在 PowerShell 进入项目 `05_程序与测试/CB1_Otto控制框架_v02` 后运行：

```powershell
& '.\发送四舵机90度.ps1' -Port COM9
```

把 `COM9` 换成电脑当前显示的接收板串口。只插着一块 USB 接收板时，可省略 `-Port` 自动识别。程序会上传脚本并执行 `hold()`，四路会一直输出 90°信号，供装舵盘。装完后若要主动关闭 PWM，在板端 REPL 输入 `import hold_90_cb1 as h; h.off()`；断电或重启也会解除保持。此工具**不会修改 `boot.py`、无线配对、D1 或 M1**。

依据：[Otto 官方 V9 手册](../01_研究参考/robot-battle-reference/OttoDIY_Manual_V9.pdf)、[第一台逐关节安装记录](Otto_V9腿部对中计划_v01/逐关节安装记录表.md)、[第二台 2026-10-06 实测记录](../05_程序与测试/CB1_Otto控制框架_v02/2026-10-06_第二台机器人实测记录.md)、第二台板载 `bbl/motors.py`。第一台与第二台的 GPIO/端口映射相同；脚的实际正向观察不能自动推广到第二台。
