paomodabaibai/CyberBrick2-User-Research-UX/05_程序与测试/CB1第五舵机扩展核查_2026-09-22.md

# CB1第五舵机扩展核查

结论：四个专用舵机插座已占满，但不等于ESP32-C3只能控制四舵机。优先验证GPIO21或20所对应的LED信号通道作为第五个50Hz舵机信号；尚未接实物，不宣称灯插座即插即用。

新增证据：官方buzzer.py明确将GPIO21/20配置为machine.PWM。因此PWM复用有官方代码依据，不仅仅是GPIO理论推测。ESP32-C3官方LEDC文档确认6个独立通道；四腿＋一个攻击舵机共5路，在通道数上可行，但需要检查目标固件及其他PWM对象是否占用。停用同脚LED/蜂鸣器控制，避免覆盖输出。

实现分为信号、电源两部分：确认实际板为XA004/X11，读清LED端口GND/电源/信号顺序和连接器，核对信号路径/电平，再制作匹配转接线。第五舵机由合适的稳压电源供电，信号地共地；不默认LED电源引脚可承担舵机浪涌。不把外置稳压器正极与板载5V输出直接并联。PG001为4.8～6V，不能将接收板7.4～12.6V输入直接接舵机。

备选1：PCA9685类I2C舵机PWM扩展板，需两条适用且可双向通信的GPIO、匹配逻辑电平及独立舵机电源V+。不能仅据LED口能输出PWM就认定LED路径可当I2C SDA，也不能把PCA板当电源扩容器。
备选2：第二套核心＋接收底板专管攻击，增加体积、重量、电源与无线逻辑；作为备用，不优先为一个额外信号增加整块板。
普通舵机一分二线只是复制同一路脉冲，不能得到独立第五通道。直流电机口经H桥，不能直接当舵机信号或5V电源。

下一步实物确认：用户提供接收板正反面及LED口清晰照片，确定转接线类型/线序；再读固件并单独验证信号和一颗无负载舵机，最后四腿＋攻击联动测供电。不在此阶段上传执行程序。

来源：
- 官方蜂鸣器PWM源码：https://github.com/CyberBrick-Official/CyberBrick_Controller_Core/blob/master/src/app_rc/bbl/buzzer.py
- 官方舵机源码：https://github.com/CyberBrick-Official/CyberBrick_Controller_Core/blob/master/src/app_rc/bbl/servos.py
- 芯片PWM通道：https://docs.espressif.com/projects/esp-idf/en/stable/esp32c3/api-reference/peripherals/ledc.html
- 社区作者针脚核查：https://github.com/rotorman/CyberBrick_ESPNOW/wiki/CyberBrick-Receiver-Shield-(X11)
- 扩展板原厂接线：https://learn.adafruit.com/16-channel-pwm-servo-driver/hooking-it-up
