paomodabaibai/CyberBrick2-User-Research-UX/02_汇报/2026-10-22_项目问题与迭代总结/配图说明.md

# 配图说明

照片保留原貌；模型截图与装配图只说明设计过程，不替代实物验证。

## 01_接收扩展板正面_现场照片.jpg
- 类型：实物照片
- 适合说明：接口扩展：四路舵机口与电机口。不能用它证明无线配对状态。
- 原始文件：E:\作品集\抖音ai创作大赛26\.codex-remote-attachments\01a09d93-5828-7951-8f50-b4e4bdacf50a\68e87115-cae1-4de8-bdfc-6e447bc61fe0\2-Photo-2.jpg

## 02_板卡背面_现场照片.jpg
- 类型：实物照片
- 适合说明：板卡与硬件排查过程，配合接口说明使用。
- 原始文件：E:\作品集\抖音ai创作大赛26\.codex-remote-attachments\01a09d93-5828-7951-8f50-b4e4bdacf50a\68e87115-cae1-4de8-bdfc-6e447bc61fe0\1-Photo-1.jpg

## 03_舵机接口不匹配_现场照片.jpg
- 类型：实物照片
- 适合说明：标准舵机头与小型白色插头的差异。
- 原始文件：E:\作品集\抖音ai创作大赛26\.codex-remote-attachments\01a09d93-5828-7951-8f50-b4e4bdacf50a\763f91a8-5f86-4196-a0e4-7bba41f46830\1-Photo-1.jpg

## 04_电机与舵机对比_现场照片.jpg
- 类型：实物照片
- 适合说明：说明两种执行器的选择，不表示裸电机能直接完成出拳。
- 原始文件：E:\作品集\抖音ai创作大赛26\.codex-remote-attachments\01a09d93-5828-7951-8f50-b4e4bdacf50a\f4761830-4aff-4445-9262-d7a1ac32300c\1-Photo-1.jpg

## 05_减速齿轮包_现场照片.jpg
- 类型：实物照片
- 适合说明：拳头机构需要减速组件及相应安装结构。
- 原始文件：E:\作品集\抖音ai创作大赛26\.codex-remote-attachments\01a09d93-5828-7951-8f50-b4e4bdacf50a\c155bebf-af22-414e-ad86-e7ccae083f0f\1-Photo-1.jpg

## 06_拳头俯视检查_模型截图.png
- 类型：模型截图
- 适合说明：展示朝向、位置与整机比例检查，不能当实物照片。
- 原始文件：E:\课程作业\大三上\张茫 用户研究与体验设计\04_结构与硬件\拳头_整体比例预览_v02\check_top.png

## 07_拳头位置调整_模型截图.png
- 类型：模型截图
- 适合说明：展示整机预览中的攻击模块位置调整。
- 原始文件：E:\课程作业\大三上\张茫 用户研究与体验设计\04_结构与硬件\拳头_整体比例预览_v03\check_adjusted.png

## 08_拳头模块装配标注_模型图.png
- 类型：装配模型图
- 适合说明：对应底座、曲柄、连杆、滑架、拳头等连接关系。
- 原始文件：E:\课程作业\大三上\张茫 用户研究与体验设计\04_结构与硬件\拳头_全套打印包_2026-09-29\成品装配图_零件标注.png

## 09_巴掌连接剖视_模型图.png
- 类型：装配模型图
- 适合说明：说明巴掌与横臂、腕部接口的连接设计。
- 原始文件：E:\课程作业\大三上\张茫 用户研究与体验设计\04_结构与硬件\Otto_75mm巴掌腕部接口_v02\腕部连接_装配拆解剖视.png

## 10_球靶调高与锁紧_模型图.png
- 类型：装配模型图
- 适合说明：说明按打击高度设计目标和锁紧结构；不代表实打验收。
- 原始文件：E:\课程作业\大三上\张茫 用户研究与体验设计\06_游戏设计\打印脱落球靶_v09\制造初样_v01\04_总装与检查\01_总装与调高锁紧.png
