paomodabaibai/CyberBrick2-User-Research-UX/06_游戏设计/打印脱落球靶_v09/两机模型击打高度测量_2026-10-19.md

# 两机模型击打高度测量 · 2026-10-19

状态：已实际读取本地三角网格并测量；静态CAD结果，不是实物动态试打。旧v07木条、布带悬挂靶方案已被用户否决，新方案优先打印。本文件仅记录测量依据与初样建议，不代表新靶已定版或生成STL。

## 基准与结果

统一采用原版Otto V9中立装配姿态；身体顶面Z=0，脚底Z=-89 mm。离行走面高度=模型Z+89 mm，不叠加场地板厚。

| 部位 | 装配Z范围/mm | 离地高度/mm |
|---|---|---|
| 75mm巴掌实体 | 23.299～78.803 | 112.299～167.803 |
| 用户微调后拳头实体 | 24.032～70.032 | 113.032～159.032 |
| 拳头最前端10mm区域 | 25.880～66.773 | 114.880～155.773 |

拳头前端10mm按X >= 最大X-10筛选网格顶点，是几何参考带，不等于整个区域同时接触球靶。球曲率、拳面形状及来向决定实际接触点。巴掌数值是全掌实体的包络，不代表每一个高度都有同样面积与力道。

两实体高度交集113.032～159.032 mm。拳头前端参考带与巴掌交集114.880～155.773 mm。初样可将靶心定在135mm附近，保留约120～150mm调节范围；范围为设计建议，不是已验证适配。

## 数据来源与变换

1. 01_研究参考/robot-battle-reference/Otto-V9/3Dprint/OttoDIY_foot_V9.stl：脚底Z=-89。
2. 04_结构与硬件/Otto_75mm巴掌腕部接口_v02/装配坐标_勿直接打印/04_完整手掌75mm_带接口.stl：采用render_interface.py中的总装平移[5.34,0,39.97]。并读取同目录整机总装_v02.glb独立核对part_9及part_3/4，结果一致。
3. 04_结构与硬件/拳头_整体比例预览_v03/拳头微调导出.stl：按prepare_fist_print_v01.py及render_assembly_guide.py方法，以面邻接连通分量提取最大分量（501668面），得到用户最终微调后的拳头。没有使用旧预览的yaw等参数重新生成覆盖用户微调。
4. 04_结构与硬件/拳头_全套打印包_2026-09-29/05_拳头与腕部连接_一体试打印.stl：打印姿态外包络87.273×31.198×46mm，与微调拳头Z高度46mm一致；该文件被平移到打印床，不能直接把其Z=0当作机器人地面。装配恢复方法见render_assembly_guide.py。

拳头机构按设计沿X直线运动，行程不会改变Z高度；巴掌按模型绕竖直轴旋转，水平转动不会改变Z包络。这些结论均以机身中立且机构安装与模型一致为前提。

## 对新靶结构的影响

- 可以用同款、同高度球靶，无需目前就分别做两个高度。
- 135mm从旧腕部参考值变为此次实体测量支持的初样起点，但仍不能称实测最佳靶心。
- 若球直径60mm、球心135mm，球体105～165mm；若直径70mm，则100～170mm。两者均覆盖共同参考带，优先比较轻量60mm初样及实际命中容错。
- 下托磁吸座须尽可能小，并在球下方；后支撑臂和立柱仍须结合完整攻击扫掠检查。高度重叠不能证明支架无碰撞，也不能证明磁吸阈值合适。
- 模型与实物差异：巴掌总装参考PG001/PG002外形，实物连续舵机的输出轴安装高度若不同、舵盘/垫片改变、腿中位或站姿倾斜，都可能改变离地高度。因此保留调节，不要求用户现在先人工测量才继续设计。
