paomodabaibai/CyberBrick2-User-Research-UX/03_视觉素材/儿童围观对战_过肩镜头_2026-10-21/生成记录与提示词.md

# 儿童围观对战｜过肩镜头生成记录

- 日期：2026-10-21。
- 生成方式：内置 image_gen / imagegen，三张独立图片。
- 需求：很多小孩围观同一场游戏、热烈气氛、过肩镜头、前景机器人占比较大、现场有很多不同款式的同系列机器人；延续横版16:9构图。
- 场边新增薄荷绿、紫色、黄色、橙色、粉色及不同外壳装饰作为概念款式。
- 这是AI生成的使用场景与产品款式示意；原始输出由工具写入默认目录，交付原图另存本目录。

## 参考图片

1. E:\CodexData\Temp\codex-clipboard-7de9c0b0-d19b-4b7e-bb32-ce48b2da7fe2.png
2. E:\work\大三上\CyberBrick2.0\用户研究与体验设计\03_视觉素材\儿童试玩场景_2026-10-21\03_近景互动_16x9.png
3. E:\work\大三上\CyberBrick2.0\用户研究与体验设计\03_视觉素材\地图双机纯插图_2026-10-21\地图双机_电影感横屏_v02.png

## 通用提示词

```text
Use case: photorealistic-natural.
Generate ONE HORIZONTAL LANDSCAPE 16:9 high-resolution photographic concept usage scene of many children enthusiastically watching a match played with the user's own little biped robot toy product. A genuine OVER-THE-SHOULDER SHOT is essential. Large clearly readable robots in the foreground, lots of excited children beyond the arena, multiple distinct variants of the SAME robot product family present. Full bleed single photograph, no collage or graphics.
Reference 1 supplies ONLY the crowded semicircle of people leaning in to watch a live robot demonstration and spontaneous documentary energy. Replace the audience with predominantly 7–11-year-old Chinese children. Do not copy the large humanoid robot, signage, exact people's identities or room.
Reference 2 supplies real photographic product appearance, materials, small physical scale and teal play arena; reference 3 supplies clear product forms. Preserve the cream rounded rectangular bodies, two simple black oval eyes, two very short Otto biped legs without knees, two broad independent flat feet, visible pivots, top-mounted playful soft palm or fist modules. The primary blue robot has a turquoise top frame, blue broad feet and a blue open palm facing vertically with fingers pointing sideways at the end of a short horizontal top arm. The primary red robot has red broad feet and a compact red top mechanism holding a red soft rounded fist. Each complete robot is about 15–20 cm tall, enlarged IN THE CAMERA COMPOSITION by close perspective, not scaled into human-size machines. They look like tangible high-quality matte 3D-printed plastic prototypes, with subtle material texture and realistic contact shadows, not shiny CGI characters.
Show SEVEN distinct physical robots in total: the two primary blue-palm and red-fist robots currently facing off in the near central playing area, plus FIVE clearly visible varied sibling designs arranged along the sidelines ready for the next match. Each sibling retains the unmistakable cream box body + two oval eyes + short biped legs + wide colored feet + one top palm or fist module. Five sibling designs: mint-green accents with a tiny rounded dinosaur ridge on its shell and matching palm; lavender accents with small rounded cat-ear shell corners and a purple fist; sunny-yellow accents with a rounded helmet-like shell rim and yellow palm; orange accents with chamfered cheek-like shell panels and an orange fist; pink accents with two small round bear-ear shell details and a pink palm. These are credible interchangeable toy shells and colorful top modules, not unrelated humanoids or animals. Space every robot clearly, all fully assembled with two feet resting on the same physical arena/table surface. Do not merge their mechanisms or limbs.
The arena is the user's large low rectangular play board on a sturdy wooden activity table: teal-blue printed tech floor with fine geometric tiles and modest yellow details, thin wood perimeter and two low staggered dark teal T-shaped dividers with white support feet. Leave a clear central match zone so robots are not blocked by walls.
12–16 distinct children crowd along the far and side edges of the play table, laughing, cheering, leaning forward, a few clapping, a few with small raised celebratory fists, varied natural reactions and everyday colorful cotton clothes. Their eyes follow the robot match. No duplicated faces, no staged straight line, no stiff posing. The foreground player naturally holds a small unbranded physical two-stick controller below the shoulder; hands and controls correct and believable.
Composition priority: cropped out-of-focus near child's shoulder/back of head anchors the extreme edge, LOOK PAST THAT SHOULDER directly into the game. Foreground human should occupy no more than 15–20% of the frame; don't obscure the robots. Two main robots are the sharp hero subjects, each around 28–38% of image height, occupying the near lower-central area. Other five robots visibly occupy the sidelines at smaller perspective size; cheering crowd fills the upper half. Moderate depth of field keeps the spectators' expressions readable while the extreme foreground shoulder is soft. Normal wide-angle 28–35mm photography, camera near tabletop at seated child's shoulder level, perspective plausible, no fisheye.
Natural indoor light and warm energetic real-event atmosphere. Photorealistic Chinese children's activity reportage. No illustration, no humanoid exhibition robots, no full-size robots, no wheels, no long legs, no virtual effects, no sparks, no floating objects, no text, no logo, no watermark. AI imagined product usage scene.
```

## 01_男孩肩后_热烈围观_16x9

完整提示词为上方通用提示词加以下场景描述：

```text
Specific shot: from JUST BEHIND THE LEFT SHOULDER of a seated boy wearing a mustard-yellow cotton T-shirt at a school robotics open day. A soft cropped patch of his back, left shoulder, side/back of head at the left edge forms a clear over-the-shoulder foreground; a glimpse of controller at the lower left. Camera peers just to the right of his shoulder toward the blue-palm robot on the near-left and the red-fist robot on the near-right, both in a readable three-quarter view and playfully facing one another, mechanisms poised just before contact. Close proximity makes these TWO ROBOTS LARGE and prominent, but never oversized relative to the physical board. The five colorful sibling robots line the far-left and right sidelines, separated and readable. 14 cheering children fill a layered semicircle beyond them, some laughing with open mouths, two clapping, one leaning in excitedly with hands on the wooden rim. Airy sunlit makerspace, warm afternoon sidelight, pale walls and softly blurred shelves. Balanced documentary realism, intense shared attention to this one game.
```

## 02_女孩肩后_决胜欢呼_16x9

完整提示词为上方通用提示词加以下场景描述：

```text
Specific shot: from JUST BEHIND THE RIGHT SHOULDER of a seated girl in a pale lavender sweatshirt with a dark ponytail. Her softly defocused right shoulder and a little back-of-head enter from the extreme right edge, hands on a controller at the lower right. Camera sits close to her shoulder, just above the play surface, and looks diagonally across the arena. The blue palm and red fist robots dominate the near-center foreground in sharp three-quarter views, both complete feet and bodies visible, approaching one another in a lively competitive moment. The five differently styled sibling robots stand in staggered sidelines on the same surface, fully visible. A dense excited crowd of 13 children forms an arc in the background of a children's science activity center, varied ages 7–11 and everyday clothing, some cheering with raised hands, some laughing and calling toward the game, others leaning in with suspense. All focus on the robots. Bright broad window light, natural warmer highlights on wood, a small amount of genuine gesture motion in the crowd but crisp robots. Strong feeling of being right beside the player at a popular game, true over-shoulder composition.
```

## 03_双人肩间_机器人主视角_16x9

完整提示词为上方通用提示词加以下场景描述：

```text
Specific shot: a dynamic DOUBLE OVER-THE-SHOULDER composition from behind two seated child competitors at a crowded school play event. A very narrow soft cropped navy-clad shoulder and back-of-head at the far left, and a very narrow soft cropped cream-and-green-striped shoulder at the far right frame a broad unobstructed view BETWEEN them. The camera is at their shoulder level very close to the board, near the robots' level. Blue palm robot and red fist robot fill the near lower-middle, both full bodies in crisp focus and larger in the frame than any other object, facing each other diagonally so their eyes, feet and top-mounted modules remain readable. Five colorful alternate shell designs (mint dinosaur detail, lavender cat-ear detail, yellow helmet rim, orange chamfered shell, pink bear-ear detail) form a loose waiting lineup along the two sides of the same board, with obvious air gaps. Behind the match, 15 children are packed in a lively two-row horseshoe: front row leaning toward the arena, back row peeking between friends, naturally cheering and clapping at the action. Faces are distinct, expressive and happy. A bright community maker workshop with daylight from broad side windows, high-quality candid event photography, palpable excitement and believable physical tabletop scale. Avoid a centered posed group portrait: all attention flows into the foreground match.
```
