paomodabaibai/CyberBrick2-User-Research-UX/05_程序与测试/CB1_Otto控制框架_v02/2026-10-11_拳头遥控测试说明.md

# 第二台拳头机器人：限时遥控测试

新增入口 `second_punch_remote.py`；导入不动作，未修改第一台代码、boot.py 或 main.py。未做新的实机动作验证。

## 准备

电脑环境 `.venv` 已安装 mpremote 1.29.0、pyserial 3.5。当前枚举：COM6 / USB 序列 80:F1:B2:25:B6:A0；COM9 / USB 序列 80:F1:B2:14:16:54。哪一个是拳头接收板尚待现场确认。

先确认拳头接收板串口并扶稳机器人。在仓库根目录运行（示例 COM9，必须改为实际确认端口）：

```powershell
& '.\05_程序与测试\CB1_Otto控制框架_v02\准备拳头测试.ps1' -Port COM9 -ConfirmedReceiver
```

该脚本接管 REPL，核验 GPIO10=0、板载电机 set_speed/stop API 和 M1 GPIO4/5，备份旧文件，上传两个测试文件并回读校验，不自动运行。核验只能区分接收角色，不能自动区分两台机器人。任一失败停止后续步骤；两文件更新并非事务，失败后按备份恢复，不直接启动。控制循环兼容需 motors_period_cb 的旧驱动和原生 easypwm 驱动。

进入板端 REPL：

```powershell
& '.\.venv\Scripts\python.exe' -m mpremote connect COM9 resume repl
```

## 先确认遥控，不动作

```python
import second_punch_remote as p
p.monitor(15)
```

依次移动左行走杆、右行走杆、出拳杆、按 K4，记录十通道帧的变化与松杆中值。默认暂借第一台映射：左 ch3 / 1797，右 ch0 / 1959，攻击 ch2 / 1825，K4 ch9（按下 0、释放 1）。不能把默认值当第二台已验收映射。无帧时先检查配对，不运行动作。

按实测值建立配置，例如：

```python
mapping = dict(left=3, right=0, attack=2, stop=9,
               left_center=1797, right_center=1959, attack_center=1825)
```

## 依次短测

开始前所有杆回中、K4 松开；连续回中 0.5 秒后显示 ARMED。

```python
p.run(seconds=10, mode='attack', mapping=mapping)
p.run(seconds=10, mode='walk', mapping=mapping)
p.run(seconds=15, mode='both', mapping=mapping)
```

一次执行一条，观察结束后再进行下一条。attack 不创建腿 PWM；walk 不创建电机驱动；both 在同一循环并发。

行为：两行走杆同向推为前进，同向拉为倒退，单杆为弧线转向。第二台倒退/转向尚未实机验收，先托住观察。采用第二台已验证的髋 20°、踝 16°、偏置 4°、周期 1000ms；转向分幅 10°、直行配平 0，不复制第一台的更大振幅或配平值。

出拳杆任一方向过阈值均使用 M1 正向 1024（半速），不提供电机反转。松杆或回到中间过渡区域停机；连续运行最多 1.5 秒，必须完全回中才重新触发。这是连续曲柄机构的短时运行，不保证单次出拳或收拳归零：没有回零传感器。

K4 按下、无帧、坏帧：停电机并释放腿 PWM。恢复连接且所有杆回中 0.5 秒才能重新使能。Ctrl-C、时限到或异常同样停止电机并释放腿 PWM；释放 PWM 不切断电源，托住机器人避免失去支撑。

官方 API 没有包时间/序号；失联处理依赖 rc_slave_data 返回 None。第二台须实测关闭遥控器时是否停机，旧帧缓存不能靠本程序可靠辨别。首次并发测试只做短时观察，关注供电复位、卡滞和机构扫掠。

## 软件验证

新增 17 项测试覆盖回中门禁、按住超时、松杆重新触发、失联重连、K4、异常帧、并发、1ms 电机服务调度、PWM 异常清理、两种单独模式和原生 easypwm 驱动。模拟验证不能替代真实无线映射、负载供电和机构验证。

## 本次上传结果

2026-10-11 用户连接接收板后，检测到唯一串口 COM14，USB 序列 `80:F1:B2:1E:0F:FC`；GPIO10=0，MicroPython 1.23.0-preview / ESP32-C3。此板初始仅有原厂目录和 boot.py，没有此前第二台短试文件。不能由仓库历史记录断言它保留了旧配对或实测硬件状态。

板载 bbl/motors.py 使用 easypwm 原生模块，没有 motors_period_cb；已按现场源码修正兼容并通过新增测试。没有实例化电机驱动或执行动作。

已上传 `otto_oscillator.py`、`second_punch_remote.py`，两个文件回读 SHA256 一致，MicroPython 导入成功。boot.py 前后 SHA256 一致，未修改 main.py、无线配置或原厂驱动，未运行 monitor/run。板端保持 REPL；重启仍执行原厂 boot.py。

备份与校验文件在仓库 `work/COM14_before_punch_upload/` 和 `work/punch_backup_20261011_171703/`。下一步接发射板后确认配对和遥控映射，再分模式短测。

## 串口动作实测：用户已确认

随后用户明确授权“前进两秒，然后左转两秒”。通过 COM14 上传并执行 `second_scripted_motion.py`：先回中等待 2 秒，前进步态 2 秒，候选左转步态 2 秒，再用 300ms 回中并关闭腿 PWM；全程 M1 停止。终端正常输出 FORWARD、LEFT ARC、DONE 和 PWM OFF。

用户反馈“完全可以很不错呢”，确认本次前进、左转实际可用。左转参数为 `turn=+1`、`turn_split=10`，在前进相位下减小左髋振幅。髋 20°、踝 16°、偏置 4°、周期 1000ms，直行配平 0。这个结果只证明本次短时前进和左转，不证明倒退、右转、遥控、出拳或并发已经验收。

最新完整 PC 回归：168 项测试通过。遥控测试代码已在接收板上，但没有自动运行，boot.py 保持原厂版本；发射板可用后应先确认配对及各通道再更新参数。

## 发射板连接与无线检查

用户连接发射板后枚举 COM15，USB 序列 `80:F1:B2:1D:43:3C`，GPIO10=1。读取原厂 app/rc_main.py 确认其使用 rc_master_init 启动发射；本次手动初始化返回 True，未修改发射板原厂文件。COM14 上 rc_slave_init 后可连续收到十通道帧，证明当前无线链路可用。

5 秒预采样及 30 秒逐杆提示采样都未观察到明显通道运动或按钮变化，不能宣称实体左右杆/攻击杆/K4 已映射。近似稳定值：ch0=2128，ch2=2146，ch3=2051，ch4=3207，ch5=1796；按钮 ch6–ch9 都为 1。这些只是本次静态值，是否真正回中和实体对应仍待人工确认。

特别是候选攻击 ch2 与旧 attack_center=1825 的偏差超过 neutral 门限；不能直接启动旧默认参数，也不能通过自动把当前值当中位来掩盖未确认的输入位置。需用户逐杆操作重新采样，然后把实测中心值作为 mapping 参数传给 run。

接收板测试文件已再次备份、上传并回读校验，纯策略导入正常且 armed=False。未启动遥控机械动作，未更改配对文件或自动启动。接收板维持 REPL，发射端 native radio 已初始化；断电重启后按原厂启动流程运行。

## 用户指定保留映射并启动遥控测试

用户明确要求不用再采样，硬件未变，直接上传。沿用左 ch3、右 ch0、攻击 ch2、停止 ch9，不再进行逐杆辨认；当前静态帧中值用左 2051、右 2128、攻击 2146。通道语义依据用户确认，中值来自本轮无线读数，不代表完成全量程标定。

新增手动入口 `second_remote_ready.py`，导入不动作，`run(seconds=30, mode='both')` 将上述 mapping 传入已验证控制循环。已上传并回读 SHA256 一致。串口执行 30 秒并发遥控测试，输出 ARMED，表示有效帧和回中门禁已通过。没有更改 boot.py 或发射板文件。真实行走、转向、出拳和 K4 的结果仍需用户观察反馈。

下次手动测试：`import second_remote_ready as remote; remote.run(30)`。默认只运行 30 秒，不会在上电后自动运行。

本轮 30 秒已正常结束，终端输出 M1 stopped / leg PWM off，未报异常。日志仅证明程序使能并正常收尾，不证明期间用户拨杆或机构完成动作。
