paomodabaibai/CyberBrick2-User-Research-UX/05_程序与测试/CB1_Otto控制框架_v02/2026-10-13_拳头M1持续转动_修复记录.md

# 第二台拳头机器人 M1 持续转动：现场修复

日期：2026-10-13。分支：`control/second-punch-remote`。

## 现象与证据

- 用户发现拳头电机在未执行出拳操作时持续转动。接收板 COM9（USB 序列 `80:F1:B2:1E:0F:FC`）执行 `MotorsController().stop(1)` 后，用户确认电机立即停止。
- 板上三份程序 `otto_oscillator.py`、`second_punch_remote.py`、`second_remote_ready.py` 已重新上传，板上 SHA256 与本分支文件逐字节一致。因此“代码未上传”不是这次持续转动的原因。
- 接收板原厂 `boot.py` 会启动 `app/rc_main.py`，其接收端循环根据板上 `rc_config` 调用官方控制器。两块板的 `rc_config` 原来完全一致，名称为“叉车”：发送端通道 ch2、ch4 有四条指向 `MOTOR1`/`MOTOR2` 的 `controls`，接收端 `receiver_1.MOTOR1.en` 和 `MOTOR2.en` 都是 `true`。当时发射端 ch4 静态读数约 3300，明显偏离配置的 2048 中位。这个旧映射具备在原厂程序运行时持续驱动 M1 的条件，且与用户观察吻合。
- 自定义拳头程序的 `run()` 有 `finally: motor.stop(1)`；先前日志中的该语句只证明自定义测试结束时发了停止命令，不能保证随后原厂程序不会再驱动 M1。

## 修改

1. 分别从接收板和发射板备份原 `rc_config` 到本机未提交的 `work/board_audit_20261013/rc_config`、`transmitter_rc_config`。两份原文件 SHA256 相同。
2. 对两块板的 `rc_config` 做同样的最小修改：从 `sender.channels[*].controls` 中移除 `actuator` 为 `MOTOR1`、`MOTOR2` 的四条自动绑定；将 `receiver_1.MOTOR1.en` 与 `MOTOR2.en` 设为 `false`。保留其他通道、设备类型、无线配对和文件内容。板端回读与修改后的本地文件 SHA256 一致。
3. 接收板重启后，板端复核 `M1/M2 en=False`、电机绑定列表为空；用户确认电机保持停止。发射板同步修改并重新 `rc_master_init()` 成功、能读十通道帧；用户再次确认摇杆回中时电机保持停止。

## 后续使用与边界

- 自定义 `second_punch_remote.py` 直接用 `bbl.motors.MotorsController` 控制 M1，不依赖原厂 `rc_config` 的叉车绑定；本次改动旨在禁止**原厂自动控制**抢占电机。修改后尚未重新实测“拳头杆触发出拳”，需单独验证。
- CyberBrick 软件重新下发“叉车”配置或再次配对时，可能把旧电机绑定写回板上；如电机又自行转动，先关闭电池开关，停止 M1，再检查两块板的 `rc_config`。不要只重传 `.py` 程序。
- 发射板原始配置和接收板原始配置仅在本机忽略目录 `work/`，不在 GitHub；若换电脑前需要保留可恢复的字节级备份，应另行安全复制。仓库保留本记录和修改规则，不发布现场配对数据。
- 另一项未解决的遥控输入问题：2026-10-13 发射端逐杆十通道采样表明，拳头杆单独推动时 **ch3 约 886–3702**；右行走杆单独推动时十通道变化都不超过 15，左行走杆单独推动时也都不超过 18。用户分别确认实际推动了对应杆。原 `second_remote_ready.py` 的 `left=3, right=0, attack=2` 与当前硬件事实不符：ch3 实际是拳头杆，两根行走杆尚未被发射板读到。不要继续用该映射做带动作验收。先检查两根行走杆的插头、供电、所接接口与发射板配置，再逐杆重采样；不应仅靠修改机器人步态代码猜测修复。
- 修复原厂自动电机绑定后，**尚未重新启动 M1 出拳测试**，避免在输入未确认时重复出现电机持续转动。用户确认接收板重启、发射板恢复后，拳头电机都持续保持停止。

## 原厂程序抢控制的根因与后续修复

用户随后发现：推左杆时只有左脚单关节旋转，右杆和拳头杆均无预期动作，判断自定义代码并未接管。复核第一台巴掌机器历史记录：当时将**接收板**的原厂 `boot.py` 改名为 `boot_official_disabled.py`，之后用自己的 `main.py` 启动 Otto 遥控；发射板仍需原厂无线程序。第二台此前只上传三份 `.py`，接收板仍有原厂 `boot.py` 且无 `main.py`。上电会执行 `boot.py -> app/rc_main.py -> 原厂控制器`，按旧 `rc_config` 操作舵机/电机。此前仅清除 M1/M2 自动绑定，`ch3 -> PWM1` 的原厂绑定依旧存在，足以解释左脚单轴转动。上传文件、导入文件与持续运行文件是三种不同状态。

2026-10-13 实机处理：

1. 确认拳头接收板 USB 序列 `80:F1:B2:1E:0F:FC`（本机 COM9，GPIO10=0）；板上原有 `boot.py`、没有 `main.py` 或 `boot_official_disabled.py`。
2. 将原 `boot.py` 读回本机 `work/board_audit_20261013/boot_official_original.py`；板上复制为 `boot_official_disabled.py`，回读 SHA256 与原文件一致；随后移除板上 `boot.py`。发射板的 `boot.py` **未改**。
3. 重启接收板后板端确认 `boot.py=False`、`main.py=False`、`rc_main` 未导入。用户推杆实测：左脚不再单轴乱转，拳头电机保持停止。这验证原厂应用确实是抢控制来源。

当前接收板为**安全待命**，不是自动遥控成品：三份自定义程序在板上，但无 `main.py`，上电不启动任何行走/出拳循环。自定义 `second_remote_ready.run()` 只能手动运行，且现有映射与当前物理输入不符，暂不应带动作调用。先检查两根行走杆的插头/供电/接入口，逐杆确认十通道变化；再修改 `second_remote_ready.MAPPING`，完成短时行走、出拳、并发与停止测试。最后才建立第二台专用的上电入口，不复制第一台 `main.py`。如需恢复原厂启动，从备份把原 `boot.py` 放回板上；再次重配对可能清空文件系统，应重核启动文件和自定义程序。

## 2026-10-13 后续实测与拳头触发修复（覆盖上文旧判断）

- 严格分时逐杆采样重做后，真实映射为左行走 ch3、右行走 ch0、拳头 ch2、K4 ch9。旧的“拳头 ch3、行走无信号”是测试指令与用户操作未同步造成的误判，不应据此改线或改映射。接收板只读采样在用户反复推拳头杆时收到 1215 帧，ch2 范围 3–4086。
- 接收板单独输出 S1 约 105° 再回 90°，用户确认明显转动。限时仅行走运行打印 1241 帧、428 拍行走请求、腿部输出约 70°–110°；用户确认腿脚明显行走或摆动。这证明自定义程序在运行，原厂程序抢控制问题已解除。
- M1 直驱 1024 约 1 秒，用户确认拳头机构明显运动。初次限时仅攻击运行虽已 ARMED，ch2 范围 2–4087，但 `attack_ticks=0`。根因在 `RemotePolicy.update()`：从中位缓慢推向端点必经过 `neutral < abs(a) < threshold` 的半推区间，原 `else` 在首次越过半推区间就将 `attack_ready=False`，导致端点永远不触发。原单元测试直接从中位跳到端点，没有覆盖真实连续摇杆轨迹。
- 已修正为：出拳前经过半推区间保留触发资格；出拳开始后往半推区间回退立即停止，并必须真正回中才能再次触发。新增连续轨迹回归测试。修正上传后限时攻击运行打印 1241 帧、`attack_ticks=604`、ch2 范围 1–4088；用户确认“推杆时运动、松杆后停止”。结束后另发 M1 停止指令成功。PC 全套 **169 项测试通过**。
- 当前仅手动限时运行 `second_remote_ready.run(seconds=..., mode='walk'/'attack'/'both')`；接收板无 `main.py`，上电仍为安全待命。行走与攻击同时进行、电池独立运行、断链时 M1 停止及自启动均尚未实机验收。`trace=True` 会打印帧数、腿部动作拍数和角度范围、拳头触发拍数及 ch2 范围，便于后续验收。

## 2026-10-13 绿灯与“断连”复核

用户观察两板闪绿灯、推杆无反应，怀疑失联。接收板 COM9 执行只读检查，`rc_slave_init()` 返回 True，3 秒收到 141 帧，证实无线链路仍通。随后手动运行 `second_remote_ready.run(seconds=60, mode='both', trace=True)`，板端记录 2979 帧、行走请求 47 拍、拳头请求 599 拍；用户现场确认**行走和拳头都恢复动作，灯从绿变黄**。限时结束后程序打印 M1 stopped，另发 M1 停止命令成功。由此确认此次“绿灯无动作”的直接原因是控制会话已到时退出、且第二台尚无 `main.py` 自启入口；**不能把绿灯单独等同无线配对丢失**。灯色的官方完整状态定义本次未独立核对，不作更广泛推断。

## 2026-10-17 持续推拳头杆时自动停转的修复

用户希望拳头电机在拳头杆持续偏转期间一直运动，松杆才停止。原 `RemotePolicy` 用 `attack_ms=1500` 限制单次出拳时间，即使持续推杆也会停止，和本次控制语义不符。新增“持续推杆超过 15 秒仍输出、回中立即停止、再次推杆可重启”的回归测试，先确认旧代码失败，再移除自动超时，保留回中/半程释放停止、失联与 K4 停止逻辑。PC 全套 169 项通过。`run(seconds=...)` 仍是整个手动测试会话的时间上限（1–120 秒）；本改动仅取消一次推杆的出拳时长上限。实机上传和持续推杆验收状态以后续记录为准。

实机验收补记：拳头接收板 USB 序列 `80:F1:B2:1E:0F:FC`（本机 COM9，GPIO10=0）已上传修正版 `second_punch_remote.py`，板上与本地 SHA256 同为 `a8014dd3eeaf9a7808a72a2f7fb456dc9048d7e4f37bd1eed729dc2c783cc41f`。板端纯策略测试在持续推杆 5.4 秒后仍输出 1024，回中输出 0。45 秒限时实机测试收到 2230 帧，拳头杆范围 0–4087，出拳输出 942 拍；用户确认“**一直运动，松手即停**”。结束后程序自动停止 M1，并额外补发停止命令成功。此结果验证了本次持续按杆需求；整段会话仍会在 `seconds` 到时结束，自动启动尚未部署。

## 2026-10-17 上推慢拳、下推快拳

板载 `bbl.motors.MotorsController.set_speed()` 的文档范围为 -2048～2048，`_speed_handler()` 按 `speed/2048` 换算占空比；之前双向统一使用的 1024 约为半速，并非最高速。接收板只读实测：拳头杆**上推 ch2 约 4076（高值）**，**下推 ch2=0（低值）**。据此改为上推 `slow_speed=1024`、下推 `fast_speed=1800`，两侧仍驱动 M1 同一旋转方向，回中立即停；持续按杆、K4、失联处理保持原语义。`attack_up_is_high=True` 在第二台映射中显式标明，速度可在 `second_punch_remote.DEFAULT` 中调整，须满足 `0 < slow_speed < fast_speed <= 2048`。

新增双方向速度及反向映射的策略回归测试，PC 全套 **170 项通过**。修正版上传接收板，文件 SHA256 与本地一致；板端纯策略确认上推 1024、回中 0、下推 1800。120 秒限时实机对比中收到 5951 帧、两侧 ch2 范围 0–4086、出拳输出 584 拍；用户确认“**下推更快，松手都能停**”。结束后 M1 自动停止并补发停止命令。1800 为约 88% 指令占空比，未采用 2048 全速；速度变化不等同于电机扭矩或实际拳头动能的线性变化。

## 2026-10-17 第二台持续遥控入口

此前第二台只用 `second_remote_ready.run(seconds=...)` 的 1–120 秒限时测试，测试到时会主动关闭 M1 和四路腿部 PWM；板上无 `main.py`，上电后也不会自动启动。这解释了用户所说“测试一结束，移动杆没反应、像连接断开”。新增 `run(seconds=None, mode='both')` 无限会话，仍保留有时限的手动测试入口；新增 `second_punch_main.py`，只安装到**第二台接收板**的 `main.py`，上电自动启动行走＋转向＋上慢下快拳头。异常退出会在 `run()` 的 `finally` 中停 M1、释放腿部 PWM，启动入口隔 2 秒重试；K4/失联仍要求回中后重新使能。

PC 全套 **171 项通过**，新增无限会话超过原 120 秒测试时限后仍执行并可被中断释放的回归测试。2026-10-17 已核对接收板 USB 序列 `80:F1:B2:1E:0F:FC`、GPIO10=0、原 `boot.py` 不存在；上传修正版 `second_punch_remote.py` 与 `main.py`，板上分块 SHA256 分别为 `d458804ee1d8a59731951f3199b6a38d88be5a73747b1c271619519a9708577b`、`486a58aa9ac25c2f852b870dbc438cc2897736f44bc32162211ae667d8508897`，均与本地一致；板上编译成功并执行复位。用户现场确认**重启后左、右行走杆和拳头杆都能控制，稍后再推仍有反应**。独立电池模式和主动关闭遥控器后的失联停止仍待专项实测。

## 2026-10-17 K4 按住跳舞

按用户要求，K4/ch9 从急停改为跳舞键：低电平按住时跳舞，松开结束；跳舞期间覆盖普通行走请求并停止 M1，松开后普通杆恢复。输入配置字段由 stop 改为 dance。DanceMotion 每 300ms 生成一个伪随机目标并线性插值，髋目标 ±12°、踝 ±8°，开始时从当前姿态过渡；总输出仍受 65°–115° 保护。无帧与异常输入仍清空状态、停止运动并要求重新回中。K4 不再承担急停；实体电源开关可断电。

PC 全套 173 项通过，覆盖按住/释放、拳头停转、姿态变化及角度范围。second_punch_remote.py、second_remote_ready.py、second_punch_main.py（板上 main.py）已上传并核对 SHA256，板端均编译成功并复位到持续遥控。三者校验值分别为 4b8bf94c4830ae0c7941f7fd871ae5af14bfc70b4b17995cc71228033aa34565、7b099527b36058124c740962cba9923dc464e0f01e5b065feb7f1445646314bb、2fe998d16deba780cd38d48d76ff900ae3e7e1e9e90aab5252851a6f63d8c82f。用户随后现场确认：“按住跳、松开停，普通遥控正常”。K4 跳舞功能实机验收通过。
### K4 跳舞幅度增强

用户反馈初版跳舞幅度太小，已将 DanceMotion.LIMITS 从髋 ±12°/踝 ±8° 提高到髋 ±20°/踝 ±16°，目标更新时间仍为 300ms，保留插值与全局 65°–115° 输出限制。新增幅度下限断言，旧版先失败，修改后全套 173 项通过。已上传 COM9，板端 SHA256 与本地均为 a34fd949c97c1faeac44c35fc3a6d7880b0e736ec2eb32752cd8c139e92165bb，并复位恢复持续遥控。增强幅度的实机观察待用户反馈；初版按住/松开及恢复遥控的验收仍有效，但不能代替增强幅度的机械验收。
### K4 大幅交替摆动版

用户反馈提高角度后仍太小。此前均匀随机目标可能靠近中位且相邻目标同侧，实际行程远小于上限。改为每次各关节交替到另一侧，幅值随机为上限的 80%–100%，300ms 插值后保持 150ms，再反向；角度上限仍为髋 ±20°、踝 ±16°。新增端点保持、最小幅值和交替方向测试，旧版失败，新版全套 174 项通过。已上传 COM9，板端与本地 SHA256 均为 94824bdadb4188f293c99b92a9318ab5c683bfc94977fed2e43699c2fec57888，复位恢复持续遥控。该版机械幅度反馈待补。
### K4 四关节 ±25° 版

用户反馈大幅交替版仍太小，明确要求继续增加角度。已将四关节目标上限统一提高到 ±25°（绝对角度 65°–115°），目标幅值为上限的 80%–100%，其他时序与全局角度限制不变。相关 23 项测试通过，已上传 COM9 并核对 SHA256 为 0200610cafb9eaff146897cd450e6d1c3b94698e63bc94434245a2f2f525fe6b，复位恢复持续遥控。此前完整回归为 174 项通过；本次仅重跑受影响的 23 项，不宣称新角度已实机验收。
### 最终用户确认：拳头机器人基本完成

2026-10-17，最终四关节 ±25° 版上传并复位后，用户确认：“没问题了，拳头机器人基本好了，更新项目文档吧”。据此将最终舞蹈幅度状态更新为用户现场确认可用，第二台核心功能进入基本完成阶段。上文各旧版“待反馈”属于当时状态，不代表当前仍卡住。总交接已整理为 `00_项目管理/2026-10-17_拳头机器人基本完成_交接.md`。独立电池、主动断链、长时间供电/温升及对战负载等专项验证仍保留为后续事项。
