paomodabaibai/CyberBrick2-User-Research-UX/06_游戏设计/落地墙体竞技场_v04/交付验证.md

# v04 数字检查

2026-10-12。用户已明确否定悬挂/架空，当前交付只有单层行走面、接地墙体和整枚落地目标。

- 地图900×540mm，15块180mm节距地板，22片内部接缝连接片。
- A=(255,150)朝+X打TB=(480,150)；B=(645,390)朝−X打TA=(420,390)。双方参考中心距225mm，按静态拳头包络估算接近61.727mm；路线无需转弯。
- 墙均位于Y=250–290。静态机器人半宽57，行进线Y150/390，至墙最小侧隙43mm；不等同于动态净空。
- 默认2片160mm墙从X290连续排至610；左右平面留白各290mm。另一个布局X10–170及730–890，中央净开口560mm。
- 6种打印件CAD均有效且单实体；STL水密、绕序一致、单连通、正体积。接缝样片与底部连接片实体交叠0。详见硬件目录 `geometry_report.json`。
- 最高件160mm，地板最宽179.6mm，加两侧各8mm brim占195.6mm，处于名义200mm幅面内。精确机型与切片尚未检查。
- 竖靶CAD材料体积估算约46.68g（假设密度1.24g/cm³），未经打印称重。底部和墙底直接在Z=0行走面上；无抬高靶座、悬挂、桥梁或活动机构。
- 离线预览与SVG由同一个地图JSON生成；立体总览为按尺寸绘制的构造示意，机器人只画静态占地，不假设真实高度。
- 组件包内容与源文件字节核对一致。页面脚本、链接与两种布局的地面几何做本地检查。

浏览器预览会话最初因本地服务已停止而连接失败；服务恢复后，浏览器仍处于被URL策略阻止访问的错误页，因此本轮不声称完成浏览器交互验收。提供离线HTML和静态图，可直接打开文件查看。

尚未完成打印、接口试装、底座防滑、动态步态/扫掌净空、身体是否先推靶、有效击倒力度、公平性或复玩测试。先用两墙两靶在平桌上验证，不先扩印整场。
