paomodabaibai/CyberBrick2-User-Research-UX/06_游戏设计/落地墙体竞技场_v04/策划与制作说明.md

# 落地墙体竞技场 v04

日期：2026-10-12。状态：按用户纠正完成的场地与试打印原型，未打印或实机试玩。

## 这次修改

用户要求“纵向有些墙体阻碍一下行动就可以，绝对不要架空”。场地因此只有一个行走高度，墙和目标都直接落在地面；移除悬挂、共享摇摆、吊架和高台设计。机器人不登高，也没有需要穿过的架空结构。

两方依旧攻击敌方颜色的目标：A攻击TB，B攻击TA。目标的字母表示归属。本版只通过可移动的落地墙改变活动空间，不增加机关或任务链。

## 平面布局

场地900×540mm，5列×3行180mm节距地块；完整制造需要15块地板、22个底面连接片（横向12、纵向10）。179.6mm实物地板之间留0.4mm缝，外包络约899.6×539.6mm。全场由平整桌面承托，桌沿另留余量。

|对象|中心坐标 X,Y / mm|朝向或用途|
|---|---|---|
|蓝方 A|255,150|朝+X，直进打红TB|
|红TB|480,150|属于红方，蓝方攻击|
|红方 B|645,390|朝−X，直进打蓝TA|
|蓝TA|420,390|属于蓝方，红方攻击|

两条攻击线相距240mm，双方开局已对准目标，参考中心距225mm。按拳头模型最前点123.273mm与靶半径40mm，接近量约61.7mm；不是已测射程或需要执行的固定步数。两机分别校准摆位，短距离即可停步攻击，必经转弯为0。身体或脚先碰到目标时必须调整摆位/靶形，不能把推倒目标当击打。

## 两片落地墙

统一墙件160×40×60mm，竖边圆角R4，底部直接贴在地面。墙高60mm只是阻挡行动的初始高度，不要求机器人翻越。底部用可移胶固定；撞墙导致墙移位时暂停修正，不把墙当推行道具。摆位完成后再开局，不在局中搬墙。

|布局|墙中心 X,Y / mm|限制方式|
|---|---|---|
|中央短墙（默认）|(370,270)、(530,270)|两片墙接成320mm短墙，挡住中央横向穿行；左、右各留290mm空间|
|中央开口|(90,270)、(810,270)|墙移至两端，中央开口560mm，改变两区之间的通行位置|

所有墙在Y=250–290之间。上下平面通行带各250mm；按114mm静态宽度估算，路线上的机器人侧缘至墙最近43mm。这个值不包含摆脚、机身晃动和旋转巴掌，须实测；若正常动作碰墙，优先将墙移开或减小高度，不让玩家做更精密的纠偏。

两种布局的直达攻靶路线都不穿墙。侧边290mm空间只是几何留白，不能保证难转弯机器人能轻松完成绕行。因此绕墙不是胜利所需动作，不安排S弯、窄门或必须先绕障碍的任务。

## 整枚落地竖靶

两枚同款竖靶为Ø80×160mm薄壁开口筒，壁厚0.8mm、底厚1.2mm。整个靶底直接接触行走面，没有独立靶座、台面或悬挂支撑。杯筒内部的空腔用于减轻重量，不是可通行的架空结构。红/蓝身份标签放在旁边地面，或用两种同材质同规格色料，避免给一方增加重量。

现有拳头模型给出的击打参考约134.8mm；160mm靶高让该高度落在侧壁范围内，但巴掌实际高度、力道和动态扫掠尚未实测。竖靶比以前的短杯更高也更重，不能由外形推断一定更容易击倒。以实际试打寻找两机都能击倒的共同目标参数，两靶同款同质量同高度，不临时单独修改一方。

## 简单规则

裁判摆正两机和竖靶，说明“蓝打红、红打蓝”，倒数开局，60秒为试用时长。玩家前进、停步、攻击。**主动攻击件把敌方竖靶打至侧壁落地、无法自行恢复直立时获胜。** 仅滑走、轻微倾斜、摇晃后回正，均不算。若两靶倒下先后看不清则平局；到时未分胜负也平局，不比较距离。

|情况|处理|
|---|---|
|机身或脚推倒、手碰、桌面震动误倒|双方暂停，复位目标，不记得分；重复发生先改摆位或组件|
|明显偏航、撞墙卡住，需要精细转弯才能命中|每机每局至多一次人工摆正，保留沿原路线的前进进度；再次需要帮助记操控未完成，回到校准|
|两机接触或攻击扫到对方机器人|暂停检查动态净空，不要求互相推挤或拦截|
|失联、供电或机构异常|技术中止，不算玩家失败|

普通体验一局即可；连续玩最多三局，先得两胜结束，平局占一局，三局后胜局数相同则整场平局。换机、换边、换墙摆法作为开局前变化。两机转向能力有限，因此这版仍以敌靶竞速为主；墙体提供空间限制，不把它夸成已经验证的攻防策略。

裁判复位前确认机器人和攻击件停止。现有记录中第一台K4没有停止功能，不把按K4当停止确认；必要时物理断电。第二台最新仓库记录仍仅有试走和独立拳头电机测试，完成遥控及并发控制验收后再进行双人比赛。本轮没有修改控制程序或驱动机器人。

## 先试什么

先在平桌上贴胶带摆场，制作2片墙、2枚竖靶和接缝样片，不急着打印15块地板。检查竖靶静置稳定、墙不被普通步态带动、两种攻击都能击中侧壁。两机各做5次短直进试打，建议至少4次不需要转弯或重摆即可击倒；这是验证目标，不是已取得成绩。

确认固定摆位可操作后，再比较两种墙位各3局，记录人工重摆、误碰墙、主动攻击击倒、普通走动误倒、是否愿意再玩。若墙带来的只是频繁卡住，将墙外移；若单靶都难以击倒，先调整共同靶参数，不增加机关。

组件参数、装配与打印数量见 [硬件目录](../../04_结构与硬件/落地墙体竞技场_v04/README.md)。地图坐标源为同目录 `arena_layouts.json`。尚未验证打印机精确有效幅面、FDM配合、目标稳定性、实际桌面大小和玩法平衡。
