paomodabaibai/CyberBrick2-User-Research-UX/04_结构与硬件/拳头_3D生成参考/2026-09-28_拳头模型与队友结构接入记录.md

# 拳头模型与队友结构接入记录（2026-09-28）

## 用户新输入
- 拳头源文件：C:\Users\Administrator\Downloads\red+clenched+fist+3d+model.stl
- 项目归档副本：04_结构与硬件/拳头_3D生成参考/红色拳头_AI原始模型_v01.stl
- 队友仓库：https://github.com/paomodabaibai/CyberBrick2-User-Research-UX
- 队友以本项目完整副本继续开发；只检查新增/变更，避免重复导入和覆盖现有巴掌机器人程序。

## 已完成的文件检查
- 二进制 STL，25,083,884 字节，501,676 个三角面；文件长度与面数吻合。
- SHA256：44a6a2ff47b8a384697fa40c79c541d02ed35e50667fdda6469e9698cd666dd2
- 原始包围盒尺寸（X/Y/Z）：0.668609738 / 0.985290647 / 1.0。
- STL 不带单位；这些是原始坐标数值，不能当作已确定的毫米尺寸。尚未缩放、修网格或增加安装孔。
- 尚未验证水密性、独立壳体、壁厚和装配适配性。
- 之前巴掌的75mm与51mm杆距仅属巴掌版，不自动套用拳头。

## 队友仓库访问情况
- 当前 GitHub CLI GraphQL、REST API 与公开网页读取均返回不存在/404。
- 原因尚不明确，可能私有权限或链接变化；已向用户询问。未读取到队友新增结构，不能声称已比较或已适配。
- 本地基线提交：1af63663；已有巴掌程序与结构未改。

## 获取仓库或本地导出包后继续
1. 用独立目录只读检查，不覆盖本项目。先比较提交历史；历史不共享则按相对路径和文件哈希识别新增/修改。
2. 优先读新增拳击结构的说明、CAD源文件、装配图、STL及物料表；重复内容跳过。
3. 确定实际驱动器、传动方式、输出轴/连接杆接口、孔距、行程、拳头质量预算及安装空间。
4. 据此定拳头尺寸和腕部接口，保留原始模型；生成适配版本并核查装配干涉后再准备打印。
