paomodabaibai/CyberBrick2-User-Research-UX/04_结构与硬件/队友拳头模块_2026-09-28_增量审阅/审阅结论与下一步.md

# 队友拳头模块增量审阅（2026-09-28）

## 来源与比较范围
用户提供微信本地《用户研究与体验设计.zip》。按去除顶层目录后的相对路径、文件大小和CRC32与本地比较（非Git祖先比较，不代表全部差异都是新开发）。跳过.git、node_modules、虚拟环境和缓存等目录；11485个文件一致，142个路径新增，17个同路径内容不同，15470个依赖/缓存等文件跳过。仅差异文件提取到本审阅目录，未覆盖本地项目。包内还包含建模包的嵌套副本，不能按路径新增数理解为独立新零件数量。

## 真正新增的机械内容
入口：本目录 `04_结构与硬件/Otto_CB1出拳头部_v01/README_建模与装配.md`。
包含参数化CadQuery源码、参数JSON、BOM、9件STEP/STL、两极限位置总装、预览、动画、数字验证报告、官方参考CAD。
设计：LA024 030直流电机 → LA016 1:48减速齿轮组 → 曲柄 → 连杆 → 双导杆滑架 → 可拆拳套。
默认曲柄半径10mm、连杆孔距34mm、行程20mm；同向转一圈即打出并收回。
双导杆为Ø3×64mm，中心距40mm。主体套合净开口69.8mm，对应69mm身体。
平台零件包围尺寸122.5×75×50.8mm；安装圈最大89×75×8mm；不能因机身接口匹配就认为顶部重量和前伸已经适配。

## 与AI拳头的连接
新AI拳头是外形网格，不是可直接替换的安装件。原05拳套包围尺寸26×30×29mm，已有空腔、腕部插槽和M3固定孔。
从build_punch_head.py第244–253行核实：滑架舌头沿X长度12、Y宽12、Z厚8mm；插槽切削体X长13.5、Y宽12.5、Z厚8.5mm（含单边0.25间隙）；固定通孔Ø3.2，沿Z。实际插入深度需结合腕部几何确认，不能单靠切削体长度认定。
AI拳头原始三轴尺寸约0.66861×0.98529×1，STL无单位。下一步先定朝向和与机构的相对位置，再作尺寸预览、选择大小、加该腕部接口和必要减重，重新检查整个行程。不要直接套用巴掌75mm尺寸，也不要整体缩放机构来迁就拳头。

## 必须保护本地现有软件
队友包的main.py调用battery_walk.run()，本地主线调用otto_session.run()。
队友config仍使用左ch0/右ch3、K4停止及旧关节范围，且没有本地已加入的ATTACK配置；本地为已实测交换的左右映射及巴掌集成。差异不能整体合并，否则会回退已验收功能。
队友机械说明中的K4停止也是旧状态，不能当成当前已实现功能。第二台拳击机器人应以当前已验收代码为底座，单独做电机攻击驱动；不得改坏第一台巴掌配置。

## 验证程度
本轮实际做了文件差异检查、源码接口核对、validation.json与文档核对、总装预览查看。没有运行队友建模脚本、重新做几何碰撞计算、连板或实物装配。
随包报告记录9件有效/闭合，37个角度采样无所检查的碰撞；这是队友数字报告，不等于本轮独立验证，更不等于打印公差、摩擦、扭矩、重心通过。

## 下一步顺序
1. 核实LA024、LA016及上下减速箱壳体，准备两根光滑导杆和BOM五金。
2. 先打印07身体量规、08输出轴量规，确认实物配合。
3. 用用户AI拳头做与总装的比例预览，确认大小后增加腕部接口；保留原05作基线。
4. 打印01/02/03/04/09结构件，先不带拳头手动整圈检查，再独立低速电机测试。
5. 拳击控制先做按住连续往复、松开停。若要单击打一拳并自动收回，需要额外原位反馈，不能靠定时保证回位。
6. 最后上Otto检查负载和行走，复用现有可靠遥控输入读取而非旧框架。
