paomodabaibai/CyberBrick2-User-Research-UX/05_程序与测试/CB1_Otto控制框架_v02/2026-09-26_巴掌正反转已验证_最小接入计划.md

# 巴掌正反转已验证：最小接入执行计划

> 执行 Agent：按 executing-plans 逐项完成。本计划优先于《巴掌舵机无反应_问题交接》中的旧猜测。本轮只完成直接PWM实测与计划，未修改正式运行代码或配置。无需重新排查焊接、扫描GPIO或重写攻击控制器。

**目标：** 第三根自动回中摇杆控制巴掌：两侧分别持续正反转，松手停止。使用已经实测成功的脉宽，保留当前行走与转向。

**架构：** 沿用 ch2/L3 → AttackController → PalmPwmDriver → D1/GPIO21；首轮仅改攻击速度参数，独立验证后再与行走联动。

**环境：** MicroPython / CB1。工作目录 `E:\课程作业\大三上\张茫 用户研究与体验设计\05_程序与测试\CB1_Otto控制框架_v02`。串口工具 `..\serial_runtime\Scripts\mpremote.exe`。

## 可靠事实（2026-09-26，本轮用户确认）

直接运行 `PWM(Pin(21), freq=50, duty=0)`，与原先成功脚本同一初始化方式：

| 信号 | 时间 | 板端延时200ms后的读回 | 用户实际观察 |
|---|---|---|---|
| 1700µs | 3秒 | 1699245ns，50Hz | 逆时针持续约3秒 |
| 1300µs | 3秒 | 1300069ns，50Hz | 顺时针持续约3秒 |

方向以用户本次观察视角为准。两段之间发送1500µs两秒；结束发送1500µs、duty(0)、deinit，日志 FINISHED D1 PWM OFF。用户确认两段转动完全正常，但未单独明确回答中间1500µs是否精准停住；此项需遥控验收。

早先用户说“动了”，指的是只转约30°，不是持续旋转；不要继续写成“1600µs已验证稳定持续旋转”。1400/1600这组低速信号在之前试验中未稳定连续转动。±200成功支持优先调整速度范围，但尚不能断言唯一物理原因是扭矩不足、死区或供电。

当前接线至少支持本次单舵机正反转。不能据此声称五舵机并发供电也验证完成。

另一个已排除的误判：立即调用PWM getter可能仍读到旧值；等待200ms后1500/1600/0的读回能正确改变。不要再次把立即读回不变认定为硬件锁定。getter也不是接头实际波形测量。

## 当前接手状态

- 接收板最近为COM7，USB序列58:E6:C5:A8:1B:0C，按序列重新识别。
- 测试已停止，D1输出已释放，尚未恢复正常遥控主循环。
- 上次读板ATTACK：enabled=True、channel=2、gpio=21、freq_hz=50、neutral_us=1500、delta_us=100、center=1860、span=1800、direction=1。
- 本地config默认enabled=False、DRIVER为模拟用途；必须生成板端变体，不直接覆盖板端配置。
- 用户确认攻击杆自动回中。历史自然中位采样1824–1827，距配置1860在现有死区内。不要为了本次接入重做整套标定。
- 用户曾纠正：没有观察到“行走导致巴掌失效”。不要把这个作为故障事实。

## 任务1：只改速度参数并做PC验证

- [ ] 读取最新git状态和config，保留他人更新；备份当前板端配置及相关已部署文件。
- [ ] 将本地ATTACK的 `delta_us=100` 改为 `delta_us=200`。其余脉宽配置保持：

```python
neutral_us=1500,
delta_us=200,
freq_hz=50,
gpio=21,
channel=2,
actuator='continuous',
```

- [ ] 保留回中死区、上电/重连回中门禁和反转过渡。不修改腿部限位、步态参数、摇杆左右映射、K4功能，不盲目删除检查。
- [ ] 核对当前测试是否把1400/1600硬编码为生产默认。测试专用delta=100的自建配置可保留；使用实际默认配置的期望值应更新。新增或更新至少一项真实配置用例：
  - 回中后ch2=0 → 1300；回中后ch2=4071 → 1700；松手中位 → 1500。
  - 上电杆偏着不转；失联后停止且重连需回中；直接换向经过neutral过渡。
  - 驱动允许1300/1700，超过配置范围仍拒绝。
- [ ] 使用现有unittest运行针对性测试和一次完整回归，记录实际结果。不要为通过测试修改行为、删除检查或依赖旧测试数量。

## 任务2：上传且确认实际运行的新配置

- [ ] 从最新本地配置生成 `_upload/config.py`（或当前项目实际使用的上传变体），设置DRIVER='cb1_pwm'、ATTACK.enabled=True、delta_us=200。不要从陈旧备份生成整份配置。
- [ ] 若只有参数变化，只上传config；如更新了必要运行代码，连同对应文件上传。测试文件不上传。
- [ ] 比对板端文件哈希，并在新的明确启动环境中打印实际生效的ATTACK三个关键值：enabled=True、neutral_us=1500、delta_us=200。避免旧config模块缓存；不要只验文件没验当前对象。
- [ ] 确认旧测试进程已退出，GPIO21只有正式PalmPwmDriver控制。启动现有main.py → otto_session路径，不并行启动另一个无限循环。

## 任务3：最短现场验收

- [ ] 双行走杆保持回中，攻击杆先回中，再各推一侧2–3秒并松手。由用户确认两个方向连续转、松手停止。默认direction=1时高ADC输出1700，低ADC输出1300；物理前推对应哪个ADC需按观察记录。
- [ ] 若操作方向与用户意图相反，只改ATTACK.direction；不能交换腿部映射或翻转步态相位。
- [ ] 若松手仍慢爬，区分：目标是否已回1500？未回则检查实际回中输入/死区；已回则微调舵机neutral_us。不要用改摇杆center掩盖舵机停止中位，也不要把这两种校准混为一谈。任何neutral调整后，脉宽上下限及两向速度均重新确认。
- [ ] 站立遥控通过后，再短时边走边攻击，观察是否失力、重启或异常停止；只有这一步才能验证共同负载。不要在此时同时改转弯参数。
- [ ] 验证关遥控时巴掌停止、重连后需先回中；再确认正常重启后无需电脑即可遥控。K4仍按最新配置的实际功能报告，不冒称急停。

## 如果±200直驱正常，遥控仍不转

不要回头轮番换PWM写法或扫描GPIO。只记录同一拍的：原始ch2、armed/engaged、AttackController返回值、PalmPwmDriver是否实际执行write、异常/释放原因。确认当前主入口确实在运行。

先分两支：
1. 目标未达1300/1700：检查板端启用配置、回中门禁和当前实际通道。
2. 目标正确但输出无动作：检查正式驱动异常、重复释放/其他输出者；在同一运行环境做已验证直驱与正式驱动的短时对照。读回等至少一个PWM周期后观察，不把即时getter旧值当根因。

本轮已验证两种初始化写法实际都为50Hz，不能仅凭 `PWM(21,50)` 与 `PWM(Pin(21),freq=50)` 语法不同就宣称原因已找到。

## 完成标准与交付

- [ ] 用户确认第三杆两侧持续反向旋转、松手停止。
- [ ] 行走和攻击互不串控，短时并发工作通过。
- [ ] 失联/重连与独立电池启动行为实测；未做的明确列出。
- [ ] 更新本次交接、PROJECT_CONTEXT及总交接顶部，纠正“1600持续成功”“硬件焊接后失效已证实”“行走后失效”等不成立历史说法。
- [ ] 提交本任务最小改动；留下明确运行状态和回滚入口。

此计划已完成，配置修改、上传与遥控验收由执行Agent继续，尚未实施。
