paomodabaibai/CyberBrick2-User-Research-UX/05_程序与测试/CB1_Otto控制框架_v02/2026-09-26_巴掌舵机无反应_问题交接.md

# 巴掌舵机无反应：完整问题交接（2026-09-26 凌晨）

**现象一句话：攻击链路软件全通（输入→解码→决策→脉冲值全部正确），但物理巴掌在五种 PWM 写法、两个候选 GPIO 下都完全不动。**

## 一、系统当前状态

- 接收板 COM7（USB 序列 58:E6:C5:A8:1B:0C）；主入口 main.py → otto_session 无限模式
- **行走完全正常**：双杆前推直走/后拉倒退/单杆弧线转向，用户确认（Otto 连续振荡步态，髋 30°±25 转向差、踝 20/8）
- 攻击功能已集成：config.ATTACK（enabled=True，板端变体）、attack_control.py（纯逻辑）、drivers/palm_pwm.py（D1 唯一写者）；otto_session 每拍共享一次无线帧，嵌套 finally 保证退出时 D1 释放；PC 133 测试全绿；板端哈希核对一致
- **四个行走舵机当前可能被保持在 90°**（见"板端残留"节）

## 二、攻击链路软件侧：全部验证通过（证据为板上实时探针）

探针（脚本直接调 AttackController，15 秒版 + 90 秒版各一轮，原始数据在 `../攻击链路诊断.txt` 和 `../攻击链路诊断2.txt`）：

- ch2 静止值 **1824~1827**（参考中位 1860，偏差 0.02 归一化，在容差内；armed 立即=True）
- 杆推到一头（ch2=0）→ 输出 **1400µs**，engaged=True ✓
- 推到另一头（ch2=4071）→ 输出 **1600µs** ✓
- 松手 → **1500µs** 停止脉冲 ✓
- 滞回、武装门控、方向决策全部符合设计

**结论：从摇杆到"该发什么脉宽"的整条决策链没有问题。**

## 三、输出物理实验：全部无效

实验脚本顺序发信号到 GPIO21（约 10 秒五段，原始记录 `../D1输出实验.txt`）：

| 段 | 写法 | 脉宽 | 结果 |
|---|---|---|---|
| A | PWM(21,50).duty_ns(1600000) | 1600µs | **巴掌声都不响，全程没动** |
| B | duty_ns(1500000) | 1500 中位 | 无反应 |
| C | duty_ns(1400000) | 1400µs | 无反应 |
| D | duty_u16(1600/20000*65535) | 等效 1600µs | 无反应 |
| E | duty(1600*1023/20000) | 等效 1600µs | 无反应 |
| 追加 | PWM(20,50) 同样 1600µs 3 秒 | — | 用户未报（见下） |
| 追加 | GPIO21 Pin.OUT 数字翻转 5 次 | — | 用户未报（见下） |

`../GPIO对比实验.txt` 显示脚本正常跑完（GPIO21 3 秒 → GPIO20 3 秒 → GPIO21 数字翻转），**但用户尚未报告这两段 GPIO20/数字翻转的观察结果，也未回答"手转巴掌是紧还是软"的关键问题**。

## 四、历史对照（重要线索）

- 前一 Agent 曾验证："50Hz、1600µs 连续信号，用户确认巴掌转动"——**发生在用户把舵机焊到 G/V/D1 之前**（当时可能是杜邦线/临时接线）
- 焊接后所有输出写法全部无效——**焊接环节是头号嫌疑**

## 五、嫌疑排序（给下一位排查者）

1. **焊点虚焊/焊错**：G/V/D1 三点任一虚焊=无信号或无电。重新加热每 个焊点观察，或万用表通断档测舵机三线到板口的连通
2. **D1 丝印 ≠ GPIO21**：板上扩展口丝印 D1/D2 与 ESP32-C3 GPIO 编号的对应关系**从未被独立证实**（GPIO21 是执行计划里继承的断言）。已试过 GPIO21 和 GPIO20 均无效。查 CyberBrick 官方引脚图确认 D1/D2 的真实 GPIO；或用现有实验脚本逐个 GPIO 扫（GPIO 0-5 被其他功能占用，候选 20/21 之外的合法输出口需查文档）
3. **V 口供电能力**：扩展口 V 可能是 3.3V 逻辑电平而非 5V 电源轨，舵机可能供电不足（通常表现为：有信号时微微抖动但转不起来，或干脆软绵绵）
4. **关键未答问题——手转测试**：让用户用手轻转巴掌：**有阻力顶劲=有电（查信号/虚焊）**；**软绵绵=没电（查 V/G 焊点和电源）**。这一个测试能把嫌疑砍一半

## 六、给下一位的现成工具

- 板上直写实验模板（改 GPIO/脉宽即可复用）：
```python
import time
from machine import PWM
p = PWM(21, 50)          # 换 GPIO 号
p.duty_ns(1600000)       # 1600µs；duty_ns / duty_u16 / duty 三种写法
time.sleep(2)
p.deinit()
```
- 攻击决策链已可用：`AttackController(cfg.ATTACK).update(raw_frame, now)` 直接返回目标脉宽（1400/1500/1600），无需重写
- 行走栈独立于攻击：排查时行走不受影响；不要动 gait/转向/标定

## 七、板端残留与注意

- 若上次 90° 保持脚本仍在跑（进程被杀后板子应已软重启回 main.py），上电即 otto_session 自动待命，**攻击链路 enabled=True**——排查 D1 时注意 otto_session 不会主动写 D1（除非攻击杆推过），不干扰实验
- 绝不第三方烧录/flash-erase；COM 口按 USB 序列识别（接收 58:E6:C5:A8:1B:0C / 发射 58:E6:C5:A7:00:A4）
- PC 测试：`python -m unittest discover -s tests`（133 项，含攻击链路 17 项）
