paomodabaibai/CyberBrick2-User-Research-UX/05_程序与测试/CB1_Otto控制框架_v02/2026-09-26_攻击功能验收通过_最终记录.md

# 攻击功能验收通过 + 全机操控最终状态（2026-09-26）

**结论：用户确认"完美"。行走、转向、倒退、攻击全部实机可用。git 已即时备份。**

## 攻击功能最终参数（实机验收通过）

- 第三杆 ch2（L3），自动回中，静止实测 1824~1827（config center=1860 参考在容差内）
- 巴掌连续旋转舵机：D1/GPIO21，50Hz，**neutral 1500µs、delta 200µs（即 1300/1700µs 已验证转动，100µs 差值太弱带不动）**
- 松手 → 1500µs 停止脉冲持续保持；断电是绝对停止
- 上电/重连后杆偏着不转（回中门禁），回中后才响应
- 行走与攻击共用一次帧读取，互不阻塞；退出/异常双重释放（腿 PWM + D1）

## 全机操控（最终版，上电即用）

| 操作 | 行为 |
|---|---|
| 双杆同向推 | 直走/直退 |
| 单杆推 | 弧线转向（30/5 振幅差，转向符号经验证可用） |
| 第三杆推 | 巴掌正/反转（delta=200µs 定速） |
| 第三杆松 | 巴掌停 |
| K4 | 无功能（保留为未来攻击触发等用途） |
| 断电 | 唯一总停 |

## 当天遗留问题及处理

- 单杆转向方向"只跟推拉走"的问题：外部分析定位为踝相位翻转导致的双重反转，已按最小方案删除翻转、恢复 Otto 30/10 对称转向，turn_split 后调至 25（30/5 实测可转弯）
- steer_trim 泄入踝翻转判断导致前后颠倒：已修复并加回归测试（trim 只作用于振幅）
- 直行偏右：steer_trim=0.2 上板，效果待用户后续观察微调

## 文件清单（本轮新增/修改）

- attack_control.py（纯逻辑控制器）、drivers/palm_pwm.py（D1 唯一写者）
- otto_session.py（集成攻击，共享帧，嵌套 finally）
- config.py（ATTACK 基线：continuous/center 1860/delta 200/死区滞回/反转驻留 150ms）
- tests/test_attack_control.py、test_palm_pwm.py、test_otto_session.py（集成）——PC 151 测试全绿

## 仍未做

- 巴掌"停止中位是否慢爬"的长时间观察（1500µs 若爬行需单独校 neutral_us）
- 五舵机同时运行的长时间供电稳定性（短时验收通过）
- 攻击方向语义与用户习惯的最后对齐（若反，翻 config direction=-1）
