paomodabaibai/CyberBrick2-User-Research-UX/05_程序与测试/CB1_Otto控制框架_v02/2026-10-06_第二台机器人实测记录.md

# 第二台机器人实测记录（2026-10-06）

第二台 CB1 Otto V9 机器人已装配。接收板为 COM9（当日端口，重插后可能变化），GPIO10=0；不以 COM 号作为永久身份。四只 180°位置舵机接线：S1/GPIO3 左髋，S2/GPIO2 左踝，S3/GPIO1 右髋，S4/GPIO0 右踝。

## 已验证

- 四路逐个执行 90°→110°→90°。用户逐路观察确认 S1、S2、S3、S4 均明显转动并正常回中，没有报告卡住或异响。先前有一路漏插，现四路均可响应。此测试仅验证正向约 20°与中位，不等同于完整机械行程标定。
- `second_otto_walk_test.py` 复用 `otto_oscillator.pose_offsets` 的 Otto 连续步态相位关系。先悬空运行 3 周期，再落地在平整防滑面运行 5 周期，髋振幅 20°、踝振幅 16°、偏置 4°、周期 1000ms。用户确认悬空动作正常、落地能够前进、动作基本正常。程序结束自动回中并关闭 PWM。此项为短时脚本试走；第二台尚未完成遥控行走整合。
- 拳头直流电机接 M1。读取第二台板载 `bbl/motors.py` 确认 M1 为 GPIO4/5。`second_m1_motor_test.py` 使用板载 `MotorsController` 的 `set_speed(1, 1024)` 并持续调用 `motors_period_cb()`，5 秒后 `stop(1)`。用户确认拳头机构持续正常运动。此项仅验证定速单向运行；尚未验证反转、负载下长时运行、与行走并发或遥控出拳。

## 板上文件与下步

第二台板上已上传 `servo_center_second.py`、`otto_oscillator.py`、`second_otto_walk_test.py`、`second_m1_motor_test.py`。没有改动原厂 `boot.py`，没有给第二台部署第一台的 `otto_session` 自启动或无线控制代码。

下一步建议：先确认第二台发射板和接收板配对与杆通道映射；再把已验证步态与 M1 出拳整合到同一控制循环，单独验证停止、断链停机、遥控正反方向与电池供电。不要把当前脚本试走报告成“第二台已可遥控对战”。
