paomodabaibai/CyberBrick2-User-Research-UX/01_研究参考/CyberBrick1迁移研究/CB1迁移结论与需求底稿.md

# CyberBrick第一代迁移评估与需求底稿

用户通知：CB2套件暂不能使用，改用第一代CyberBrick。老师将发实际物料表；CB1当前可领库存未知，不能沿用“已有一套CB2”抵扣CB1申请。周末目标仍是一台Otto四舵机行走模块。

## 已查证的官方资料

- 套件清单：https://asia.store.bambulab.com/en/products/cyberbrick-hardware-kit
- 接收板：https://us.store.bambulab.com/products/remote-control-receiver-shield-1pcs
- 接收板规格：https://store.bblcdn.com/s1/default/fe6984b2ca8845929a2b6984eea619aa/Remote_Control_Receiver_Shield_-_XA004.pdf
- 舵机：https://us.store.bambulab.com/products/9g-servo-motor-with-clutch-protection
- 官方控制程序：https://github.com/CyberBrick-Official/CyberBrick_Controller_Core
- 官方舵机控制代码：https://github.com/CyberBrick-Official/CyberBrick_Controller_Core/blob/master/src/app_rc/bbl/servos.py

页面抓取保存在kit.txt、receiver.txt、servo.txt；官方规格.zip、官方CAD.zip已下载，舵机与主板相关PDF/STEP/STL已提取。机械尺寸图已查看；没有完成Otto装配干涉检查或实物测试。

## 第一代硬件体系

XA003核心板采用ESP32-C3与定制MicroPython。核心板配XA004接收底板用于机器人；另一核心板配XA005发射底板用于手柄。它不是CB2的CB001＋CB010体系，CB2的端口发现、SDK和现有MCP流程不能直接当作一代已兼容功能。

XA004接收底板：4路PWM舵机、2路直流电机、2路LED，输入7.4–12.6V，规格表最大电流3A，尺寸30×29mm。舵机口供常见5V舵机使用；不能把电池电压直接接到PG001。3A标注不是已证明的四舵机轨持续供电额定值，仍须查清输出电源与实测。

其他公开物料包括：XA011双轴摇杆、单轴摇杆、三挡开关、按键模块、独立电源开关、WS2812灯及分线板、030直流电机、1:48减速齿轮、7.4V锂电池和充电器、AAA电池盒、不同规格SH1.0/XH2.54连接线、磁铁/弹簧/螺丝。并不是CB2那套距离/磁力/显示等模块的直接替代清单。

## PG001和PG002绝不能混算

PG001：180°位置舵机，用于Otto四个腿部关节。PG002：连续旋转舵机，以速度/方向控制，不是可控360°位置舵机，不能替代腿部PG001。

官方PG001规格书：4.8–6V；6V时额定扭矩≥0.4kgf·cm、堵转扭矩≥1.2kgf·cm、堵转电流≤650mA、空载速度≤0.12秒/60°。不能把堵转扭矩当持续可用扭矩。

机械图：壳体约23×12mm，图示含输出端总高27.30mm；安装耳总长32.50mm，安装槽中心距27.80mm，槽径标注2.20mm。安装与轴心以官方STEP为准，不只凭三个外形数改模型。舵盘接口40T/直径4.85mm，优先使用原配舵盘。

重量来源有差异：产品网页写0.016kg，PG001独立规格书写9±0.5g。不能悄悄当成相同口径；总重评估以实际称重或供应方确认。

这个外形属于常见微型舵机形态，与Otto原9g舵机路线接近，可优先检查局部舵盘、孔位和仓体适配，但尚不能保证免改直接装。已有两边STEP，下一步可做装配对照。原有CB2专用改件设想停止推进。

## 对设计的影响

1. 周末四舵机腿部：一个XA003＋一个XA004即可提供四路控制，控制接口数量吻合，行走可行性仍受负载、供电和步态影响。
2. 四腿舵机已经占满接收板。后续第五路巴掌舵机不能直接插入，电机口也不能作为舵机口使用。
3. 可选扩展：额外XA003＋XA004承担攻击（增加重量/供电/通信复杂度）；或验证额外PWM接口/扩展驱动（尚未确认）；或经用户同意改为电机驱动巴掌（需回位/限位结构，不能偷偷改变已确认方案）。本周不必先定。
4. 拳头电机在接口类型上可考虑空余直流电机口，但030电机、减速比、电流与Punchy机构尚需匹配，不等于买来能直接推动原结构。
5. 原官方程序有ServosController、set_angle与需要周期调用的timing_proc。四舵机步态要编排协调运动，图形界面里各自绑定摇杆不等于能走路。角度状态变量是程序维护值，不是CB2那种文档化实测反馈，不能混用。
6. 当前软件里的CB2 AI/MCP是ESP32-S3专用工具描述，一代是ESP32-C3。需按官方一代程序路径验证当前软件是否支持代码编辑/上传，不能套用CB2驱动或刷固件解决。
7. NFC与技能继续作为候选扩展。普通遥控一对一/一对多不证明能自动完成多机技能裁判和通信仲裁；模块与驱动需另证。

## 本周末单机行走需求总量（非增补数）

|物料|准备量|说明|
|---|---:|---|
|XA003核心板|1|腿部控制|
|XA004接收底板|1|四路舵机|
|PG001 180°位置舵机|5|4用1备；PG002不计入|
|匹配接收板的电池、电源开关、连接线|1套|优先官方匹配供电|
|匹配充电器|1|按电池核对|
|数据线|1–2|电脑调试|
|Otto打印件、原配舵盘与紧固件|1台份＋试片|先试装单个舵机|

若周末要求无线遥控，再加XA003×1、XA005×1、对应手柄电源和摇杆/按键。先电脑触发步态则不必把遥控作为走路前置。

## 完整项目资源底稿（老师清单到手后核算增补）

|物料|拟定总量|备注|
|---|---:|---|
|XA003核心板|6|沿用六节点资源上限；额外攻击节点若使用会占用场景/备用份额|
|XA004接收底板|2必需＋2预留，合计4|两机器人；另两块用于攻击/场景/备用择用|
|XA005发射底板|2|两手柄|
|PG001位置舵机|11暂保留|腿8＋巴掌1＋备用2；第五路控制仍需解决|
|XA011双轴摇杆|4|保持用户确认的四个总量|
|瞬时按键模块|6预留|手柄、场景与备用；接头数量按发射板核算|
|独立电源开关|6预留|替代面板开关需求，具体套件配套确认|
|电源组件|按6节点配齐|机器人可用7.4V锂电，手柄有AAA电池盒路线；不能直接要求与CB2同款电池6块|
|030电机与匹配减速/连接件|2套验证资源|拳击与备用；负载定型前不保证够力|
|舵机延长线、电源线、摇杆/按键线|按一代接口重新配|不沿用CB2 5pin线缆数量|
|NFC读卡器/技能卡/小标签|保留5/20/20的候选资源意向|必须先确认一代接入路径，不能作为原生兼容物料提交|

官方公开入门套件清单有2核心板、1接收底板、1发射底板，但PG001通常仅1个；大套件也不能仅按舵机总数判断足够。无论套件名称如何，必须分别统计PG001与PG002。校内发放可能不同，老师实际清单优先。

## 下一步

等老师清单核对PG001数量、XA003/XA004/XA005、电池和接线；对照PG001与Otto STEP确认装配差异；再进行单舵机校准与四轴步态测试。本轮仅研究与保存资料，未控制设备、上传代码或修改模型。
