paomodabaibai/CyberBrick2-User-Research-UX/01_研究参考/CyberBrick1迁移研究/servo.txt

Title: 9g Servo Motor with Clutch Protection

URL Source: https://us.store.bambulab.com/products/9g-servo-motor-with-clutch-protection

Published Time: Thu, 17 Sep 2026 09:42:52 GMT

Markdown Content:
Image 1: 9g Servo Motor with Clutch Protection (https://store.bblcdn.com/s7/default/daa575b5a74645058e5e8c9bf4dd80e0/9g_Servo_Motor_with_Clutch_Protection_2947360e-9083-4cc7-9d89-7f73d389a76d.png)

1/5

Image 2: 9g Servo Motor with Clutch Protection

Image 3: 9g Servo Motor with Clutch Protection

Image 4: 9g Servo Motor with Clutch Protection

Image 5: 9g Servo Motor with Clutch Protection

Image 6: 9g Servo Motor with Clutch Protection

Image 7: Free Shipping on Eligible Orders

Free Shipping on Eligible Orders

Image 8: 30-Day Returns

30-Day Returns

Image 9: Lifetime Support

Lifetime Support

Image 10: Secure Payment

Secure Payment

## 9g Servo Motor with Clutch Protection

$5.49 USD

Earn 6 Bambu Credits with this purchase

Size

*   9g Positional Digital Servo-180° (1PCS) - PG001
*   9g Continuous Rotation Digital Servo-360° (1PCS) - PG002

Quantity

Need to Know

Order Info

*   Free shipping on orders over $59.

*   Free shipping on orders over $199 to remote areas including Alaska, Hawaii, Puerto Rico, Guam, Northern Mariana lslands and American Samoa.
*   Shipping rates vary by locations. See our[Shipping Policy](https://us.store.bambulab.com/policies/shipping-policy)for details.

Service
*   Free Shipping on Eligible Orders
*   30-Day Returns

Payment

Order Info

*   Free shipping on orders over $59.

*   Free shipping on orders over $199 to remote areas including Alaska, Hawaii, Puerto Rico, Guam, Northern Mariana lslands and American Samoa.
*   Shipping rates vary by locations. See our[Shipping Policy](https://us.store.bambulab.com/policies/shipping-policy)for details.

Image 11: 9g Servo Motor with Clutch Protection (https://store.bblcdn.com/s7/default/daa575b5a74645058e5e8c9bf4dd80e0/9g_Servo_Motor_with_Clutch_Protection_2947360e-9083-4cc7-9d89-7f73d389a76d.png)

Image 12: 9g Servo Motor with Clutch Protection

Image 13: 9g Servo Motor with Clutch Protection

Image 14: 9g Servo Motor with Clutch Protection

Image 15: 9g Servo Motor with Clutch Protection

Image 16: 9g Servo Motor with Clutch Protection

Image 17: 9g Servo Motor with Clutch Protection

Image 18: 9g Servo Motor with Clutch Protection

Image 19: 9g Servo Motor with Clutch Protection

Image 20: 9g Servo Motor with Clutch Protection

Image 21: 9g Servo Motor with Clutch Protection

Image 22: Free Shipping on Eligible Orders

Free Shipping on Eligible Orders

Image 23: 30-Day Returns

30-Day Returns

Image 24: Lifetime Support

Lifetime Support

Image 25: Secure Payment

Secure Payment

## 9g Servo Motor with Clutch Protection

$5.49 USD

Earn 6 Bambu Credits with this purchase

Size

*   9g Positional Digital Servo-180° (1PCS) - PG001
*   9g Continuous Rotation Digital Servo-360° (1PCS) - PG002

Quantity

Order Info

*   Free shipping on orders over $59.

*   Free shipping on orders over $199 to remote areas including Alaska, Hawaii, Puerto Rico, Guam, Northern Mariana lslands and American Samoa.
*   Shipping rates vary by locations. See our[Shipping Policy](https://us.store.bambulab.com/policies/shipping-policy)for details.

Image 26: Free Shipping on Eligible Orders

Free Shipping on Eligible Orders

Image 27: 30-Day Returns

30-Day Returns

Image 28: Lifetime Support

Lifetime Support

Image 29: Secure Payment

Secure Payment

Image 30: Socket Head Cap Machine Screws (SHCS)

Image 31: Socket Head Cap Machine Screws (SHCS)

## Servo Ports Pin Definition

**Please strictly follow the wire sequence below to avoid damaging the components.**



## Introduction

The 9G Servo Motor with Clutch Protection is a high-performance servo product, designed for mechanical control.

*   **High Precision Motion Control:** Equipped with advanced digital control technology, the 9G Servo Motor with Clutch Protection can provide precise motion control, ensuring stable and accurate actions for models or mechanical devices.

*   **Clutch Function:** Unlike traditional servos, this servo has a clutch function to prevent overload damage.   
(Note: When external forces change the angle of the servo during normal operation, the servo can protect itself from damage through the integrated clutch mechanism. This function automatically resets and restores the servo to prevent any potential hazards)

*   **Powerful Torque Output:** Despite its compact size, the servo has excellent torque output capability. It can drive larger loads making it suitable for various applications requiring strong driving force.

*   **Fast Response:** With a quick response speed, it can rapidly respond to control signals, achieving fast and precise actions, enhancing the response speed and performance of models or devices.

*   **Digital Control:** Utilizing digital control, it offers stability and reliability, allowing for fine-tuning through programming to meet the needs of different application scenarios.

*   **Wide Applicability:** Suitable for various fields such as models, robots, remote-controlled vehicles, and aeromodelling, providing reliable power support for various creative and application needs.

## Product Specifications

Operating Voltage 4.8-6V DC
Standby Current 8mA at 6.0V
Rotating Direction CCW (1000→2000μs)   
Counterclockwise
Gear Set Material Plastic gear

No Load Current≤50mA at 4.8V   
≤60mA at 6.0V
No Load Speed≤0.14sec/60° at 4.8V  
≤0.12sec/60° at 6.0V
Operating Travel Angle PG001 - 180°+10°   
(500~2500μs)  
PG002 - 360°+10°   
(500~2500μs)
Motor Type Iron core

Rated Torque (G*CM）≥0.32kgf·cm at 4.8V   
≥0.4kgf·cm at 6.0V
Stall Current≤550mA at 4.8V   
≤650mA at 6.0V
Stall Torque (G*CM）≥1.0kgf·cm at4.8V   
≥1.2kgf·cm at6.0V
Product Weight 0.016 kg

## Considerations

*   When installing the servo, ensure that it is correctly matched with the mechanical structure of the model or device to avoid excessive stress or unstable installation.

*   Use a power supply that meets the specifications to avoid damage to the servo due to excessive or insufficient voltage.

*   Avoid overloading the servo to prevent damage to internal components or the motor.

*   When using the clutch function, operate gently to avoid excessive force and protect the internal mechanical structure and circuitry of the servo.

*   When manually operating the clutch function, avoid excessive rotation of the servo to prevent damage to internal components or mechanical structures.
