paomodabaibai/CyberBrick2-User-Research-UX/01_研究参考/CyberBrick2软件研究/MCP_tools_list.txt

event: message
data: {"result":{"tools":[{"name":"esp32-s3-mpy-run-repl","description":"在已连接 CyberBrick 的 ESP32-S3 板端 MicroPython raw REPL 中直接运行一小段代码（不依赖板端文件，适合快速查询板端状态，例如读取引脚、列出端口、检查传感器）。\n代码长度限制 utf-8 ≤ 200 字节。\n运行到 timeoutSeconds 上限会自动停止并返回这段时间内的输出（属于预设时间到，不是错误）。\n前提：CyberBrick 应用正在运行，且已在编辑器顶栏连接 ESP32-S3。","inputSchema":{"type":"object","properties":{"code":{"type":"string","description":"要在板端 raw REPL 执行的 MicroPython 代码（utf-8 ≤ 200B）。"},"timeoutSeconds":{"type":"integer","minimum":1,"maximum":30,"description":"运行时间上限（秒，1~30，必填，可填 30）。到达上限自动停止板端并返回这段时间内的输出。若代码需要用户做实物操作（按按钮、转电机等），请按此上限提前告知用户在多少秒内完成操作。"},"deviceId":{"type":"string","description":"在哪一块已连接的核心板上运行（必填）。取值先调用 cb2_device_list 获取目标板的 deviceId。没有「默认板 / 主板」概念：未指定或指定了一个当前未连接的 deviceId 都会直接失败。"}},"required":["code","timeoutSeconds","deviceId"]}},{"name":"esp32-s3-mpy-run","description":"在已连接 CyberBrick 的 ESP32-S3 板端 MicroPython 中直接运行一个【板端文件系统里已存在】的 .py 文件。\n注意：本工具运行的是板端副本，不会自动同步本机最新代码——如果你刚改过代码，请先调用 sync_files_to_board 把文件写入板端，再运行。\n运行到 timeoutSeconds 上限会自动停止并返回这段时间内的输出（属于预设时间到，不是错误）。\n前提：CyberBrick 应用正在运行，且已连接 ESP32-S3。","inputSchema":{"type":"object","properties":{"path":{"type":"string","description":"要在板端运行的 .py 文件路径（项目相对，例如 main.py 或 lib/foo.py）。"},"timeoutSeconds":{"type":"integer","minimum":1,"maximum":30,"description":"运行时间上限（秒，1~30，可选，默认 30）。到达上限自动停止板端并返回这段时间内的输出。"},"deviceId":{"type":"string","description":"在哪一块已连接的核心板上运行（必填）。取值先调用 cb2_device_list 获取目标板的 deviceId。没有「默认板 / 主板」概念：未指定或指定了一个当前未连接的 deviceId 都会直接失败。"}},"required":["path","deviceId"]}},{"name":"sync_files_to_board","description":"把 mcp-project 中的代码写入已连接 CyberBrick 的 ESP32-S3 板端文件系统。\n调用前请先把要运行的全部代码文件准备好，任选其一：\n  1) 通过 cb2_file_write / cb2_file_edit / cb2_file_copy 等 MCP 文件工具写入；\n  2) 若 MCP 与本机 CyberBrick 在同一设备，直接用本机文件工具读写目录：C:\\Users\\Administrator\\AppData\\Roaming\\CyberBrick\\ai-editor\\projects\\mcp-project\\project；\n  3) 手动把文件复制到上述目录（保持目录结构）。\n前提：CyberBrick 应用正在运行，且已在编辑器顶栏连接 ESP32-S3。\n本工具只同步 src 指定的子树；不会校验 src 是否等于该设备当前绑定的 codePath。","inputSchema":{"type":"object","properties":{"deviceId":{"type":"string","description":"把文件写到哪一块已连接的核心板（必填）。取值先调用 cb2_device_list 获取目标板的 deviceId。没有「默认板 / 主板」概念：未指定或指定了一个当前未连接的 deviceId 都会直接失败。每块板文件系统独立，要让同一份代码在多块板都能跑需对每个 deviceId 各调用一次。"},"src":{"type":"string","description":"本次同步来源目录（project 相对路径，如 `project`、`project/codebase/board1`）。仅同步该子树，并在写板端时剥离此前缀。"}},"required":["deviceId","src"],"additionalProperties":false}},{"name":"list_skills","description":"列出 CyberBrick 官方 skill（仅 name + 简短描述，开销极小）。\n涉及 CyberBrick / CB2 / ESP32-S3 / MicroPython 的嵌入式任务（如电机、舵机、IMU、摇杆、点阵屏、LCD、红外、音频播放、接线、项目搭建等）时，先调用本工具——这些 API 随固件版本变化、不在训练数据里，凭记忆易错。\n命中相关 skill 后用 read_skill 取正文，需要时再用 read_skill_file 读子资源。与硬件无关的问题不必调用。","inputSchema":{"type":"object","properties":{},"additionalProperties":false}},{"name":"read_skill","description":"读取指定 skill 的完整说明（SKILL.md 正文）以及它附带的子资源文件清单。\n这是三级渐进式披露的第二步：name 必须来自 list_skills 返回的某个 skill 名称。\n返回内容里若列出了 <skill_files>（如驱动代码、字体、模板等），按需用 read_skill_file 逐个读取，不要一次性全读。","inputSchema":{"type":"object","properties":{"name":{"type":"string","description":"要读取的 skill 名称（来自 list_skills 的返回结果）。"}},"required":["name"]}},{"name":"read_skill_file","description":"读取某个 skill 目录内的一个子资源文件内容（如驱动代码、字体、模板、参考文档等）。\n这是三级渐进式披露的第三步：仅在 read_skill 返回的 <skill_files> 中出现、且当前任务确实需要时才调用。\nfile 是相对该 skill 目录的路径（如 lib/auto_port.py），只能访问该 skill 目录内的文件；单个文件大小上限约 200KB。","inputSchema":{"type":"object","properties":{"name":{"type":"string","description":"skill 名称（来自 list_skills 的返回结果）。"},"file":{"type":"string","description":"相对该 skill 目录的子资源文件路径，例如 lib/auto_port.py。"}},"required":["name","file"]}},{"name":"cb2_device_list","description":"列出当前通过 USB 串口插入的 CyberBrick CB2 / ESP32-S3 设备。\n返回 devices 数组（支持多块板同时连接）；deviceId 规则为 serialNumber 优先，否则为 port 路径。\n所有当前已连接的板都会标记 connected:true，并各自独立通过 REPL 探测 network（联网状态 / SSID / IP 等）与 components（Port.list 外设列表）。\n调用 esp32-s3-mpy-run / esp32-s3-mpy-run-repl / sync_files_to_board 前先调用本工具拿到目标板的 deviceId：这些工具的 deviceId 为必填，没有默认板 / 主板，无论连了几块板都必须显式指定。\n未连接或串口正忙（运行 / 写入中）的设备仅返回基础信息；busy 时 connected 设备带 probeSkipped: true。\n前提：CyberBrick 应用正在运行；要对某设备获取完整信息，需先在编辑器顶栏连接该板。","inputSchema":{"type":"object","properties":{"apiHost":{"type":"string","description":"可选。Bambu API 域名，用于判定板端能否访问外网（如 api.bambulab.cn / api.bambulab.com）。省略时使用应用当前 region 缓存，默认 api.bambulab.com。"}}}},{"name":"cb2_wifi_setup","description":"为指定 CB2 设备配置或删除 WiFi，通过 USB 串口操作 syslib/wifi_conf.py 与 boot.py（凭据由 wifi_conf 内部安全持久化，不进 .py），与 App 内 ui_wifi_setup 共用底层 configureBoardWifi。\n【配置】ssid 非空时：写入 syslib/wifi_conf.py 与 boot.py（注入 CB_WIFI_BOOT 块），把 SSID + 密码经 REPL 持久化并立即连接；上电后 wifi_conf.boot_start() 自动重连。仅支持 2.4GHz。\n【删除】ssid 传空字符串（\"\"）时：清除板端已持久化的凭据与 syslib/wifi_conf.py、移除 boot.py 中的 CB_WIFI_BOOT 块（保留 boot.py 其余内容），并让板端 WLAN 断开 + 关闭。此时 password / maxBackoffAttempts 会被忽略。删除是幂等的——板端原本没有相关文件也会安全返回成功。\n注意：删除仅清理 CyberBrick 自己写入的配置（板端凭据 + syslib/wifi_conf.py + CB_WIFI_BOOT 块）。若该板的联网是通过其它方式（自定义 boot/main、第三方模块、ESP32 NVS 残留凭据）建立的，删除只能断开当前连接，无法保证重启后不再自动联网。\ndeviceId 必须与当前已连接的串口板一致（可先调用 cb2_device_list 获取）。\n配置 / 删除成功后 AI Editor 资源管理器的网络徽标会自动刷新；可再次调用 cb2_device_list 确认 network 状态。\n前提：CyberBrick 应用正在运行，且目标板已通过编辑器顶栏连接。","inputSchema":{"type":"object","properties":{"deviceId":{"type":"string","description":"目标设备 ID（与 cb2_device_list 返回的 deviceId 一致）。"},"ssid":{"type":"string","description":"WiFi SSID（仅支持 2.4GHz）。传空字符串（\"\"）表示删除该板的 WiFi 配置并断网。"},"password":{"type":"string","description":"WiFi 密码。删除配置（ssid 为空）时此参数被忽略，可传空字符串。"},"maxBackoffAttempts":{"type":"integer","description":"开机自动重连的最大退避尝试次数（默认 10）。删除配置（ssid 为空）时此参数被忽略。","minimum":1,"maximum":100}},"required":["deviceId","ssid","password"]}},{"name":"cb2_file_list","description":"列出 mcp-project 项目目录下的文件与子目录（不递归；要看子目录请再传 path）。\n操作的是 CyberBrick 为 MCP 准备的固定项目目录（cb2 空项目），与 App 内编辑器当前打开的项目无关。\n当 path 为空或为项目根时，返回会包含 project 分区统计（codebase 分组 + 非 codebase 区）。\n返回结果包含 host（WIN-BKV95G91T26）与 projectDir（C:\\Users\\Administrator\\AppData\\Roaming\\CyberBrick\\ai-editor\\projects\\mcp-project\\project）。\n若 MCP 客户端与本机 CyberBrick 运行在同一设备（host 一致），可直接用本机文件工具读写 projectDir，无需逐一调用 cb2_file_*；改完后调用 sync_files_to_board 同步到板端。\n也可用本工具或其它 cb2_file_* 通过 MCP 读写同一目录。\n前提：CyberBrick 应用正在运行。","inputSchema":{"type":"object","properties":{"path":{"type":"string","description":"可选。要列出的目录，项目相对路径（例 lib/）；缺省或空字符串表示项目根。"}},"additionalProperties":false}},{"name":"cb2_file_read","description":"读取 mcp-project 项目中的单个文本文件内容。\npath 为项目相对路径（例 main.py、lib/foo.py），不要带 project/ 前缀。\n操作目录：C:\\Users\\Administrator\\AppData\\Roaming\\CyberBrick\\ai-editor\\projects\\mcp-project\\project。同机也可直接用本机文件工具读取该目录。\n前提：CyberBrick 应用正在运行。","inputSchema":{"type":"object","properties":{"path":{"type":"string","description":"要读取的文件，项目相对路径。"}},"required":["path"],"additionalProperties":false}},{"name":"cb2_file_write","description":"在 mcp-project 项目中写入或新建文件（完整替换内容）。\npath 为项目相对路径（例 main.py）；写入后需调用 sync_files_to_board 才能同步到 ESP32-S3 板端。\n操作目录：C:\\Users\\Administrator\\AppData\\Roaming\\CyberBrick\\ai-editor\\projects\\mcp-project\\project。同机也可直接用本机文件工具写入该目录。\n前提：CyberBrick 应用正在运行。","inputSchema":{"type":"object","properties":{"path":{"type":"string","description":"要写入的文件，项目相对路径。"},"content":{"type":"string","description":"完整文件内容。"}},"required":["path","content"],"additionalProperties":false}},{"name":"cb2_file_edit","description":"对 mcp-project 项目中已有文件做精确字符串替换（局部编辑）。\npath 为项目相对路径；oldString 须与文件中的原文完全一致（含空白与缩进）。\n编辑后需调用 sync_files_to_board 才能同步到板端。\n操作目录：C:\\Users\\Administrator\\AppData\\Roaming\\CyberBrick\\ai-editor\\projects\\mcp-project\\project。\n前提：CyberBrick 应用正在运行。","inputSchema":{"type":"object","properties":{"path":{"type":"string","description":"要编辑的文件，项目相对路径。"},"oldString":{"type":"string","description":"要替换的确切原文。"},"newString":{"type":"string","description":"替换后的新文本。"},"replaceAll":{"type":"boolean","description":"是否替换所有匹配项，默认 false。"}},"required":["path","oldString","newString"],"additionalProperties":false}},{"name":"cb2_file_copy","description":"在 mcp-project 项目中复制文件：将源文件内容写到目标路径。\nsourcePath：项目相对路径（例 main.py），或 knowledge/... 挂载路径（例从 skill 模板复制）。\ndestPath：项目相对路径，目标必须在 mcp-project 内。\n复制后需调用 sync_files_to_board 才能同步到板端。\n前提：CyberBrick 应用正在运行。","inputSchema":{"type":"object","properties":{"sourcePath":{"type":"string","description":"源文件路径。"},"destPath":{"type":"string","description":"目标路径，项目相对路径。"},"overwrite":{"type":"boolean","description":"目标已存在时是否覆盖，默认 false。"}},"required":["sourcePath","destPath"],"additionalProperties":false}},{"name":"cb2_file_delete","description":"从 mcp-project 项目中删除指定文件（本机磁盘 + 内存缓冲）。\npath 为项目相对路径。不会自动删除板端上的同名文件。\n操作目录：C:\\Users\\Administrator\\AppData\\Roaming\\CyberBrick\\ai-editor\\projects\\mcp-project\\project。\n前提：CyberBrick 应用正在运行。","inputSchema":{"type":"object","properties":{"path":{"type":"string","description":"要删除的文件，项目相对路径。"}},"required":["path"],"additionalProperties":false}},{"name":"lvgl_font_subset","description":"把内置中文字体（HarmonyOS Sans SC）按你这次实际要显示的字符子集化，生成一个体积很小的 LVGL 可加载 .bin 字体，写入 mcp-project 目录。专用于在 CyberBrick CB2 LCD 上显示中文文本。\n为什么需要：CB2 LCD 的原生 LVGL 字体只能渲染 ASCII/Latin-1，直接 label.set_text('你好') 只会显示方块。生成 .bin 字体后，板端 lv.binfont_create 加载 + set_style_text_font 应用，即可 label.set_text('中文') 由 LVGL 自动排版。\n字体只包含你传入的字符；要显示新字需重新生成（建议一次把会用到的字都传进去）。彩色 emoji / 图标 / 几何图形请改用 A8/ARGB 位图方案，不要用本工具。\n板端加载必读：.bin 经 LVGL 文件系统层按路径打开，必须先注册一个 LVGL 盘符（VFS）再用盘符路径加载——lvgl_vfs.register('S') 后 lv.binfont_create('S:/assets/font.bin')（不是裸 /assets/font.bin）。未注册盘符 / 路径没带盘符时中文会静默不显示。盘符驱动 lvgl_vfs.py 由 cb2-lcd-display skill 同捆，按其第 5 节拷到 lib/ 后使用。\n生成后请调用 sync_files_to_board 把字体、lib/lvgl_vfs.py（及代码）一起写入板端再运行。板端 LVGL API 可用 read_skill 读取 lvgl-lib-mpy / cb2-lcd-display。","inputSchema":{"type":"object","properties":{"text":{"type":"string","description":"要包含进字体的字符集合，句子/词组都行（自动去重、自动跳过换行等控制字符）。例：今天天气晴朗0123456789℃"},"outputPath":{"type":"string","description":"输出 .bin 字体的项目相对路径，必须以 .bin 结尾。可选，默认 assets/font.bin"},"size":{"type":"integer","minimum":8,"maximum":128,"description":"输出像素高度（字号），可选，默认 24。越大越清晰、越占板端 flash"},"bpp":{"type":"integer","enum":[1,2,4],"description":"灰度位深，可选，默认 4。1=黑白最省体积；2=4 级灰度；4=16 级灰度最平滑"}},"required":["text"]}}]},"jsonrpc":"2.0","id":2}
