paomodabaibai/CyberBrick2-User-Research-UX/01_研究参考/攻击模块/攻击模块资料索引.md

> 更新：用户已改为巴掌直接由电机/舵机驱动，拳头采用 Punchy 结构。下文曲柄摇杆/凸轮建议仅保留为研究记录，最新决定以根目录 PROJECT_CONTEXT.md 为准。

# milk 组：攻击模块现有资料索引

整理日期：2026-09-16。用途：10–20 cm 桌面双足对战机器人课题研究与汇报。

## 先看结论

- 横向扇巴掌：优先研究曲柄摇杆，把连续旋转变成左右摆动。将机构布置在水平面，手掌接在输出摆臂上，这是我们对通用机构的改造设想，并非找到可直接安装的 Otto 配件。
- 想要“慢慢蓄势、突然拍出”：研究蜗形凸轮配弹性回位。资料中的示范多靠重力下落；横置后需要另行设计弹簧或弹性件、摆臂和限位。
- 直线出拳：优先研究曲柄滑块，以及有 CAD 的 Punchy。机构要有导向，避免让细长推杆承担全部侧向载荷。
- 目前没有核实到同时满足 Otto 安装尺寸、CyberBrick 驱动、横向巴掌和完整装配资料的即用模块。

## 1. Punchy：最值得拆解研究的实物拳击机器人

作者：James Bruton / XRobots。

- [原作者制作与对战视频](https://www.youtube.com/watch?v=XNV1myy1sbA)
- [原作者 CAD 与代码仓库](https://github.com/XRobots/Punchy)
- [CAD 原始下载](https://raw.githubusercontent.com/XRobots/Punchy/main/CAD/PunchyRobot.zip)
- 本地：`Punchy/PunchyRobot.zip`、`Punchy/Punchy.stp`、`Punchy/joystick.stp`。已下载并检查压缩包完整性，压缩包包含两个 STEP 文件；原 README 和 MIT LICENSE 一并保留。

根据原作者视频的索引文本，这是轮式遥控拳击机器人，使用电机、齿轮和连杆驱动往复出拳，拳头可磁吸脱落。适合参考拳击传动、拳头连接和遥控交互，不宜把整个底盘直接搬到 Otto 上。

核实程度：已检查仓库和实际 CAD 文件包；读过视频索引文本，未逐帧观看全片，也未对 STEP 做装配干涉验证。代码公开，但本次本地保存的是 CAD 与许可，控制程序请通过仓库访问。不能视为 CyberBrick 可直接运行的程序。

## 2. 曲柄摇杆：横向巴掌的基础运动机构

- [Print a Motion 原作者交互模型](https://printamotion.com/fourbar.php)

运动链：旋转的短曲柄 → 连杆 → 往复摆动的摇杆。

曲柄摇杆示意

页面可设置底座、连杆、输出杆的相对长度和输入角度，并提供 Download Model 按钮。本次确认了页面参数与下载入口，未实际生成和测试模型。

适配设想：输入轴和输出轴竖直安装，使连杆在水平面运动，输出端安装轻质软手掌。注意手掌朝向须让掌面迎着横扫方向。它能够来回摆动，但并不自动产生弹簧释放式的突然拍击；杆长和布置也决定能否连续转动。

## 3. 蜗形凸轮：慢蓄势、快释放

- [Rob Ives 原作者机构讲解](https://www.robives.com/mechanism/cam/)
- [原作者凸轮演示模型页面](https://www.robives.com/project/camdemo/)

蜗形凸轮动作

凸轮半径逐渐增大时缓慢抬升从动件；经过轮廓突降处时，从动件迅速回落。这比普通圆形偏心轮更接近“蓄势—拍出”的节奏。

重要区别：图示是重力回落的机构演示，不是现成电动巴掌模块。用于水平扇巴掌，需要我们增加弹性回位、转换摆动的连接方式和限位，并测试电机负载、磨损及复位。适合当第二阶段探索，不能把概念拆解图当成已验证的装配图。

## 4. 曲柄滑块：直线出拳的基础机构

- [Print a Motion 原作者交互模型](https://printamotion.com/crankslider.php)

曲柄滑块示意

运动链：电机旋转 → 曲柄 → 连杆 → 带导向的滑块/拳头前后移动。

页面提供连杆长度、偏置、角度等参数及下载入口，本次未实测模型生成功能。通常一转形成一次伸出和收回；若希望按一次按钮只打一拳，连续旋转电机还需要考虑位置检测和停止位置，不能仅假定按固定时长就能稳定复位。

## 5. Boxing Santa：双足机器人加拳击手臂

- [原作者装配教程](https://www.instructables.com/3D-Printed-Boxing-Santa-Biped-Robot-With-LOLIN-D32/)
- [模型页面](https://www.myminifactory.com/object/3d-print-boxing-santa-biped-robot-85558)
- [演示视频](https://www.youtube.com/watch?v=DwLPysVhIJE)

原项目采用 3 个行走舵机、2 个手臂舵机，共 5 个舵机；打印零件较多。适合参考双足本体与攻击手臂的组合及空间布局。腿部不是你们确定的 Otto 四舵机结构，不能把其硬件数量直接写进你们的清单。

## 6. Mechanical Clapping Hand：手掌铰链与柔性传动参考

- [作者 StatusSymbol 的模型页面](https://cults3d.com/en/3d-model/game/mechanical-clapping-hand)
- [作者装配短片](https://www.youtube.com/shorts/F_ZL5hwMqsI)

作者提供双手拍掌玩具，文件列表包含手掌、主体、环、弹簧、传动件和 TPU 的 V 形运动件，页面明确部分传动件需 TPU。适合借鉴手掌铰接和柔性件；它不是现成的单臂水平攻击模块。当前购买条件未核实，未下载模型。

## 7. THE SLAP MACHINE：巴掌主题外形参考

- [STLFLIX 原模型页](https://thangs.com/designer/STLFLIX/3d-model/THE%20SLAP%20MACHINE-59385)

有作品照片和下载入口，但本次页面资料不足以确定内部传动、驱动方式与装配关系。只列为造型和手臂参考，不把它作为凸轮机构的证据。当前下载条件未核实。

## 8. 四杆冲压教学模型：补充连杆参考

- [模型作者页面](https://cults3d.com/en/3d-model/various/modern-punching-mechanism-four-bar-linkage-3d-printable-model)

作者提供四杆冲压机构演示和九个 STL 文件列表。这里 punching 指冲压，不等于机器人拳击；可研究杆件与支点关系，不能仅凭名称当成可用拳头模块。当前下载条件未核实。

## 给本组的选择建议（设计判断，尚未实测）

| 希望呈现的动作 | 优先参考 | 当前需要验证 |
|---|---|---|
| 巴掌水平扫过去、收回来 | 曲柄摇杆 | 摆角、总宽度、掌面朝向、与机身干涉 |
| 巴掌慢蓄势、突然拍出 | 蜗形凸轮加弹性回位 | 释放与复位、负载、磨损、软限位 |
| 拳头向前伸出再缩回 | 曲柄滑块、Punchy | 行程、导向摩擦、重量和碰撞后的卡滞 |

先做独立桌面动作样机，再装到双足上测试反作用力与重心。统一为轻质软掌/软拳头，课堂目标是动作清晰、对战有趣。选定舵机/电机及控制板后，再计算接口、电源和安装空间；本次资料不证明某种 CyberBrick 板能直接驱动全部执行器。

汇报建议用语：“已调研公开的连杆、凸轮机构与实物拳击机器人，拟先验证水平摆掌，再验证往复拳击；最终结构依据桌面样机测试确定。”
