paomodabaibai/CyberBrick2-User-Research-UX/03_视觉素材/巴掌_Tripo参考_v01/生图提示词.md

# 巴掌独立参考图 v01

生成方式：内置 imagegen。用途：导入 Tripo 生成独立巴掌模型。

用户要求：饱满、有塑料感、像米奇的卡通手套、扇巴掌姿态。沿用项目横向扫掌方向，只有巴掌和短腕口，不含机器人或机械结构。

## 本次完整提示词

Create a high-quality single-object 3D product reference image intended for Tripo image-to-3D reconstruction. Subject: ONLY one plump Mickey Mouse-style classic cartoon white glove hand, manufactured as a smooth solid satin-gloss white plastic toy accessory. Full open-hand slap gesture: four chubby rounded fingers extended together, nearly touching with shallow readable separations, a distinct rounded thumb opened to the side. Large inflated palm with substantial rounded thickness, soft bulbous fingertips, clean simplified sculptural geometry, rounded edges. The fingers point HORIZONTALLY TO THE LEFT, the short wrist points RIGHT, palm plane vertical, appropriate for a horizontal sweeping slap on a tiny toy robot. Show the broad PALM side at a slight three-quarter angle, only about 15 degrees off frontal, revealing the thick side profile while all four fingers and the thumb remain clearly legible. Small chunky rounded glove cuff at the right wrist, terminated cleanly, no arm extending beyond it. This is a rigid molded plastic object, not fabric, not a realistic human hand, not flat artwork. No black drawn lines, no text, no logos, no mounting mechanism, no holes in palm, no robot, no extra objects, no stand, no motion lines, no arrows, no multi-view panels. Neutral pure white seamless background, soft studio lighting with gentle gray shading to separate the white object from background, restrained broad specular highlights, no harsh cast shadow. Center entire hand uncropped with generous margins, landscape composition, consistent solid geometry, premium toy product render. Make the hand look like an appealing full, rounded cartoon slapping glove, NOT a fist, NOT a waving upright hand, NOT spread fan fingers.

## 与机械模型衔接

生成后的网格用于替换 v01 的掌面外形。图片不承诺准确尺寸或安装孔位；下载模型后按实际体积、重量与腕部连接尺寸适配，不直接假定适合当前舵机。保留独立连接件，以便修改外观时不重做安装框。
