paomodabaibai/CyberBrick2-User-Research-UX/04_结构与硬件/Otto_PG001顶部巴掌模块_v01/建模计划.md

# Otto + PG001 顶部模块 v01 实施计划
用户已授权直接建模，并确认允许对原身体钻孔加螺钉。原腿脚和身体保留，原头壳未打印。

目标：交付可打印的安装接口、开放式舵机支架、参数化源模型、STEP及装配说明。此次为机械试装版，不作为已验证的对战成品。

- [x] 核对原版身体 STL：外包络69×69×39mm，顶面z=0，上缘内外形需检查。
- [x] 核对PG001厂家尺寸图：宽12、壳体长23、耳距27.8、总耳长32.5，孔槽约2.2mm。
- [x] 生成身体套合量规，先验证打印尺寸补偿。
- [x] 生成舵机孔位量规，验证壳体、安装耳与固定件。
- [x] 建模开放安装框与可拆卸舵机桥，螺钉固定身体。
- [x] 校验实体有效性、STL闭合性、名义装配位置干涉，生成预览与说明。

结构：外套框净开口69.8mm（单边0.4设计间隙），上沿承托；桥位于身体上方，舵机壳体暂不深入身体；桥可拆卸。外套框侧孔作为试装后身体钻孔定位，最终锁紧需配垫片/螺母，不强拧薄壁。

待实物验证：打印间隙、原身体内部螺母空间、PG001实物安装耳与螺钉、原配舵盘尺寸、主板电池位置。第三方CAD含线材等附件，不能将整体包络当作舵机壳体尺寸。
