paomodabaibai/CyberBrick2-User-Research-UX/04_结构与硬件/巴掌_Tripo网格与尺寸调整/如何调整尺寸.md

# 手掌大小与连接杆长度怎么调整

已保留Tripo原始STL；不修改Downloads原件。原文件最长边约1个单位，不代表实际打印尺寸。主体420590三角面且闭合，另有17个极小零散组件，生成尺寸版时仅保留主体。闭合检查不等于完整可打印性、无自交或强度验证。

## 方式一：切片软件调整手掌外观大小
导入“输出_手掌50mm_杆距37.5mm”中的手掌STL，打开缩放/尺寸功能，保持XYZ等比例锁定，修改最长边。原始方向X为50mm，Y约19.86mm，Z约37mm；旋转后对应轴可能变化。
例如：想要45mm最长边，50mm文件缩放90%；想要55mm，缩放110%。优先填写毫米尺寸，避免把原文件的1单位误当作1米或1毫米。50mm是沟通和比例检查基准，不是已验证最佳尺寸。
当前手掌未加安装孔/腕部连接。现阶段可以整体缩放；后续加好接口后，不能再整体缩放，否则孔径和配合尺寸一起改变。

## 方式二：双击调整工具同时生成尺寸版
双击本目录“双击调整尺寸.cmd”。
1. Palm size [50]：输入手掌最长边毫米数；直接回车为50。
2. Rod reach [37.5]：输入舵机转轴中心到杆末端两个安装孔中点的距离；直接回车为37.5。
3. 输出在独立的“输出_手掌XXmm_杆距YYmm”目录。相同数值再次生成会更新该目录文件，原始文件和v01不变。

这里的杆距不是整根杆的外形长度：总长=杆距+12.5mm。默认杆距37.5mm对应总长50mm。若把杆距改成42.5mm，总长变为55mm。
工具保持宽10mm、厚3mm、末端孔距5mm、末端孔径2.2mm，以及舵盘端孔位与孔径不变，只延长/缩短中段和移动末端孔组。因此不要在切片软件中缩放整根杆。
工具可输入范围只是防止明显几何错误，绝不是舵机允许的负载或长度范围。

## 重要：目前还不是可以直接装配的一对零件
新卡通手掌仍没有安装接口。工具输出连接杆沿用v01末端两孔，用来确定杆长；后续需要根据你最终选定的手掌尺寸、腕口位置做连接座/接口。不要把两个STL摆在一起就当作已经连接。
连接杆保持STEP，方便用CAD修改；Tripo手掌是三角网格，不会因为改存STEP就自动变成可编辑曲面实体。

建议先确定手掌视觉尺寸与杆距，再完成接口。切片时同时看预计重量：手掌增大或杆变长都会加重舵机负担。最终需要试装和运动测试，不仅看外观。
