paomodabaibai/CyberBrick2-User-Research-UX/05_程序与测试/CB1_Otto单步实验_v01/实施计划.md

# 实施计划与边界
已获用户授权准备代码；沿用上一轮确认的双杆单步设计。使用 writing-plans 与 test-driven-development 方法。
1. 固定来源：保存 Otto.cpp、Oscillator.cpp、CB1 rc_module 文档及舵机源码。
2. 先写主机测试：边沿触发、回中解锁、双杆冲突、忙时丢弃、限位、停止、左右交替。
3. 实现纯 Python 步态核心，MicroPython PWM 适配器、串口校准和官方 rc_module 接收入口。
4. 默认不产生 PWM；校准确认与遥控映射确认独立开关。攻击默认关闭。
5. 写上传、恢复、校准说明；运行测试和语法检查。没有实机，不声称已走稳或完成无线验证。
第一版限制：连续同侧指令被拒绝，要求左右交替（首步任选）；避免在另一脚承重时强行回摆。更自由的重复同侧步态留待实测。
