paomodabaibai/CyberBrick2-User-Research-UX/05_程序与测试/CB1_Otto单步实验_v01/实机上传记录_2026-09-22.md

# 2026-09-22 实机上传记录
- COM7 USB序列58:E6:C5:A8:1B:0C；GPIO10角色值0，机器人接收端；配对索引1。
- COM8 USB序列58:E6:C5:A7:00:A4；GPIO10角色值1，遥控发射端。
- 两板MicroPython 1.23.0-preview，ESP32-C3，构建2e7b6351 / 2026-03-25。
- 使用 mpremote connect PORT resume，打断现有Python应用以访问REPL，未软复位/重刷固件。两端原Python循环当前已中断；未重启，避免接收端原应用恢复驱动。
- 备份目录 ../板载备份_2026-09-22/COM7 和 COM8，包含boot.py、rc_config、.ignore、app、bbl、log，共40文件271750字节。不是固件/NVS整片备份。
- 六个milk_*.py仅上传COM7根目录，SHA256逐个与本地一致。板上全部import成功。
- CALIBRATED=False、REMOTE_MAPPING_VERIFIED=False、ATTACK_ENABLED=False。
- 未修改boot.py/main.py或发射端文件；未运行校准、步态或新PWM。未验证此前原程序留下的硬件输出状态。
- 断电重启仍会执行原官方boot.py，不会自动运行本实验代码。
- 下一步确认接线与机械卸载后校准单个舵机；需要遥控时恢复发射端运行，再监测原始通道。不要直接恢复接收端原控制循环与实验程序并行。
