paomodabaibai/CyberBrick2-User-Research-UX/05_程序与测试/CB1_Otto控制框架_v02/2026-09-23夜间遥控行走试验_交接记录.md

# 2026-09-23 夜间遥控行走试验：完整交接记录

**结论：未实现遥控行走；最后一次由用户现场观察为“完全没反应”。** 用户明确要求今晚停止调试。本文记录已发生的事及未证实项，不将上传成功、两板亮灯或 PC 测试通过写成实物行走成功。

## 项目和实物状态

- 项目根目录：`E:\课程作业\大三上\张茫 用户研究与体验设计`。本会话当前工作目录可能是别的项目，所有文件操作须使用此根目录。
- 目标：CB1 接收板控制 Otto V9 四关节短腿机器人；CB1 发射板上两个单轴杆，左杆前推请求左步，右杆前推请求右步，K4 停止。先实现托住条件下的一步，再落地行走。巴掌和拳头模块均不参与本夜测试。
- 四关节已换齐 180°位置舵机，90°电气中位与舵盘重装、各路方向及小范围验收、`calibrated=True`、`can_walk=True` 均为之前现场记录；这仅表示允许严格使能，**站姿、卸载与实际位移尚未通过**。左髋后摆 -10° 顶死，配置限制为最低82°。
- 接收板 USB 序列 `58:E6:C5:A8:1B:0C`，本夜为 COM7；发射板 `58:E6:C5:A7:00:A4`，本夜为 COM8。COM 号可能变化，应按序列号识别。两板各有电池供电，现场仅一根 USB 数据线，换线不一定使仍由电池供电的板子重启。

## 本夜新增并上传的代码

- `battery_walk.py`：接收板电池供电、限时试走入口。冷启动先等待有效遥控帧；双杆回中且 K4 按住至少1秒、再松开，才尝试 strict enable。使能后20ms轮询，K4/失联停止，最多120秒；结束和异常都执行 `session.release()` 关 PWM。结束后不自动恢复，须重启接收板再试。使能前理论上不创建舵机 PWM。
- `main.py`：上电导入并运行 `battery_walk.run()`。**板上原 `boot.py` 仍改名为 `boot_official_disabled.py`，但现在有 `main.py`；下次接手切勿再写“接收板上电后停在 REPL、不自启”。** `main.py` 是本夜临时试走入口，不是已验证可行走的正式固件。
- 两文件已用 `mpremote connect COM7 resume fs cp` 上传，且用板上分块 `uhashlib.sha256()` 核对：`battery_walk.py` = `333ad71550c055ce3f08ce6f5b8f58a2fbd22bea861aed5dd8e7c436c909f562`；`main.py` = `2267029f9136bacfbc082f73b74af8262187d9dbec07e3369da0939ac7037d67`。板上 config.py 为 `DRIVER='cb1_pwm'` 变体，已有哈希 `c3c249f51f88e260c962eb55e8b4c698d334cc29b518ae3e08518e6a03fc7aad`。
- PC 侧 `python -m unittest discover -s tests -q` 复跑原 v02 测试：**103 项通过**。新电池启动入口做了语法编译和板上哈希验证，**没有新增其端到端自动测试或真机动作验证**。一次板上用 `open(f).read()` 整文件哈希触发 `MemoryError`，随后改为256字节分块哈希成功；这只是哈希方法的内存问题，不是步态异常。

## 实际操作与观察（按时间顺序）

1. 接收板接 USB，第一次 `walk_session.run(20)`：strict enable 立即因“remote returned no valid frame”拒绝；程序打印 `PWM off`，没有进入行走。接收板 `rc_slave_init()` 后一次只读探针的第0帧是 `None`，后续数帧曾出现正常10通道数据，左右杆约1959/1782–1792、K4=1。这说明遥控链路**曾短暂可读**，并不证明后续持续可用。
2. 延迟500ms再试 `walk_session.run(20)`，仍在 enable 阶段因无有效帧拒绝；随后15次、25次间隔采样均为 `None`。
3. 为解决一根线换到发射板后无法从接收板串口启动的问题，新增并上传上面的 `battery_walk.py` 与 `main.py`。用户将 USB 从接收板换到发射板，接收板靠电池；两板指示灯均为绿色，用户认为正常时应为黄色。**灯色的含义尚未从官方资料核实，不能仅凭绿灯判定配对或数据收发成功。** K4 与摇杆均未引起动作。
4. 用户将 USB 换回接收板，发射板仍靠电池且亮灯。板上检查显示 `battery_walk` 模块已加载、`config.DRIVER='cb1_pwm'`；`rc_slave_init()` 返回 True，但连续15次遥控读取仍全部为 `None`。检查本身通过 `mpremote` 进入 REPL，会打断正在运行的程序，因此该检查之后要重启接收板才能重新运行 `main.py`。
5. 用户再将 USB 换到发射板。其 `boot.py` 存在，内容在上电后导入 `/app/rc_main` 并调用 `rc_main.main()`；GPIO10=1（发射角色），`rc_main` 可导入。此前用串口检查发射板可能打断了其官方发送程序，而电池持续供电使拔插 USB 不会自动重新执行 `boot.py`。据此执行 `machine.reset()`，启动输出包括 `HARD_RESET`、`MASTER_INIT`、`PARSE_UPDATE`、`AUTO_SLEEP_DIS`，证明**发射程序在这次重启时启动**。随后用户再次按说明重启接收板、尝试 K4 和左杆，现场反馈仍然**完全没反应**。
6. 最后一次试验没有同时抓到接收板启动日志/遥控帧，也未看到 `battery_walk` 的 arm/enable/状态打印。故目前不能判定卡在：发射没有持续送帧、接收没收帧、K4 手势未达门槛、`main.py` 冷启动异常、还是已进入 READY 但步态请求未触发。**也没有本夜任何新舵机动作证据。**

## 当前软件语义与需注意之处

- 正式 v02 步态已实现五阶段协同；左右杆前推 +1、回中解锁，双杆同时推为冲突；同侧连续重复步在 v02 被拒绝，先交替左右试。理论功能已过 PC 测试，不等于真实走路。
- `battery_walk.py` 的 K4 在**启动前**用“按住1秒后松开”手势使能；启动后 K4 恢复停止。停止/失联会结束这次入口并关 PWM，重试须重启接收板。试验窗口120秒。它没有视觉反馈；没有串口日志时，用户无法仅凭灯色确认是否使能。
- `mpremote resume exec/fs` 可进入板端 REPL，但通常会打断正运行的程序；在两板由电池持续供电时，仅拔插 USB 不能保证官方发射程序或 `main.py` 自动恢复。每次串口检查之后，下一次试走前必须明确重启被检查的板。接收板 `main.py` 自动运行这一点也意味着下次调试须先确认安全支撑和物理断电开关位置。
- 接收板原官方 `rc_config` 仍在，但原官方 `boot.py` 已禁用；它不应直接驱动舵机。发射板官方 `boot.py` 未改。
- S2/S3 先前“零反应”曾是插头接触不良，不能由今晚整体无响应直接推断舵机坏。若未来证实已发 PWM 而某单关节不动，再回到插头/供电检查。

## 下次接手的最短诊断路线（仅用户再次允许动手后执行）

1. **先只读启动链，别先调 gait。** 两板电池正常；发射板在完成串口检查后明确断电再上电。接收板接 USB，用不会主动发送 Ctrl-C 的串口监听方式，在用户重启接收板时采集 `main.py` / `battery_walk.py` 启动输出；确认是否打印等待遥控帧、有无异常。若日志不好抓，可临时让安全等待状态输出极少量标记，但避免每20ms刷写 flash。
2. **只读无线帧。** 发射板官方程序运行时，在接收板连续读取10通道值，记录 10 秒有效帧/None 比例；分别看 K4 松/按和左右杆。若全为 `None`，先查发射/配对/角色/电源，别碰步态；若帧稳定，继续第3步。
3. **只读启动门槛。** 在控制器仍禁用的条件下确认双杆归一化绝对值均≤`RECENTER_BAND=0.20`，K4 按下读0、松开读1，持续按压达到1000ms；必要时打印 arm 状态。若无启动，查 `battery_walk` 和 `session.enable()` 返回/异常。
4. **只有确认 READY 后才做受支撑动作。** 先保持双脚站姿，再只推左杆一次；记录每阶段输出/用户观察。若 PWM 有输出而腿不动，查四个 S 插头与电源；若腿动但无位移，才调 ankle_sign_left/right、lean 等机械步态参数。每次只改一个变量。
5. 根据根因修正代码后，同步更新 `PROJECT_CONTEXT.md`、`00_项目管理/继续任务_给其他Agent.md` 和本记录。始终区分 ①PC测试、②板端命令/日志、③用户观察动作、④真实位移。

**停止点：用户已明确“今天先不搞了”。不要在本轮继续重启、上传、驱动或要求用户做现场操作。**
