paomodabaibai/CyberBrick2-User-Research-UX/05_程序与测试/CB1_Otto控制框架_v02/2026-09-24_遥控无动作_公开资料复核与执行交接.md

# 遥控无动作：公开资料复核与下一位 Agent 执行交接

日期：2026-09-24。用户要求暂停繁杂实测，先研究公开经验；本轮只检索网络、阅读本地代码、整理文档，没有连接串口、上传程序、驱动机器人或修改运行代码。

## 结论及证据边界

尚未找到能直接证明本机根因的公开案例。已找到同平台高度相关案例：自编脚本和官方控制互相干扰、上电入口与 USB 临时执行不一致、板子亮灯但外设供电不成立。不要将类似案例直接套成本机定论。

本机当前定位应从“重新配对/调整长按/调步态”转向“运行入口、会话生命周期、执行器输出的唯一控制者”。无线在此前录制的试验窗口内确实传递过摇杆数据；这不等于机器人执行过步态，也不保证每次开机都运行同一个入口。

## 本机最新事实（覆盖上午的过时猜测）

- 上午用户确认 demo_scripted 曾在鼠标垫上走四步；只对当时环境成立。
- 本轮长按诊断：2664 个样本，初始化后持续有效；K4 连续按住约 10.4 秒，产生 WOULD_ENABLE。没有重现抖动，不能继续把按钮抖动列为已确认原因。
- 真实 battery_walk 曾成功 enabled，随后因 K4 pressed 退出。用户承认其中一次松开后又按了一次。因此至少一次“不响应”可由进入停止并退出解释。
- trace_remote_walk 捕获真实左右杆原始值变化，并经过同一帧输入触发 step start / step done。代码中该脚本读的是真实 RcLink，没有自动交替触发。日志证明软件接受命令，不证明机械运动。
- 用户反馈：只看见开头舵机动一下，之后推杆仍无反应。这个反馈优先于日志中的 done，遥控行走仍未验收。
- 最后又运行了 demo_scripted.run(1)，日志完成自动左右两步，但用户尚未给出这一轮明确物理反馈。不得写为本次自动步行成功。
- 既有读板结果 DRIVER=cb1_pwm，四关节 enabled/position/calibrated；驱动与 joint_model 板端哈希对上本地。不能因此推断物理 PWM 已送到舵机。
- 证据文件：output/arm_probe_2026-09-24.txt、battery_walk_live_2026-09-24.txt、battery_walk_live_retry_2026-09-24.txt、remote_steps_2026-09-24.txt、trace_remote_walk_2026-09-24.txt、scripted_compare_2026-09-24.txt。

## 公开案例与适用性

### 1. 执行脚本之后，原先遥控按钮失效；作者与用户报告解决

https://forum.bambulab.com/t/non-code-action-buttons-stop-responding-after-code-execution/217925

2025-12-20，用户报告执行代码后普通按钮不再控制动作，重启才能恢复。项目作者说明版本差异及脚本/界面舵机控制混用问题；将各动作统一改为脚本控制后报告改善，原用户随后确认。它支持“同一执行器不要混用两个控制路径”的排查方向，但不是官方对底层 bug 的最终定性，也不是本机已复现。

### 2. 电机只动一下，无报错；尚无公开解决回复

https://github.com/CyberBrick-Official/CyberBrick_Controller_Core/issues/7

用户在桌面 App 代码框调用 MotorsController.set_speed 后电机短暂转动即停。本次 GitHub API 查询评论为空。症状相近，但对方是电机+App 代码框，本项目是独立入口+直接 PWM 舵机；不能宣称这个 issue 证明我们根因或提供了修复。

### 3. USB 下脚本能运行，脱离电脑不运行；自编代码与界面配置不同步

https://forum.bambulab.com/t/possible-to-save-python-code-files-on-the-cyberbrick/258238

2026-08，发帖人遇到临时执行与独立运行差异，后按自定义启动文件方案操作，报告断开电脑重启后能运行。可借鉴入口部署思路；其后采用的社区方案涉及 ESP-NOW，不能直接复制到本项目现有 rc_module 配对方案。

### 4. 控制板亮灯但所有外设不动

https://forum.bambulab.com/t/cyberbrick-users-manual/172976/9

用户实测把用于遥控端的 AAA 电池盒接到接收端，会出现板子亮灯但外设不工作的情况；另提醒舵机插头方向。只能作为供电分支，不能据此断言本项目接错电池。我们上午确实走过，故应查当前状态是否改变而非盲目换硬件。

## 官方 API 与源码核对

MakerWorld 在线 API 两个页面在本次抓取中未拿到有效正文，curl 返回的也不是可用 API 内容。转而直接读取官方 GitHub 的文档源和实现；不假装已经读到平台页面。

- 平台入口：https://makerworld.com/en/cyberbrick/api-doc/index.html
- RC 文档源：https://github.com/CyberBrick-Official/CyberBrick_Controller_Core/blob/master/docs/cyberbrick_core/lib/rc_module.rst
- 官方主循环：https://github.com/CyberBrick-Official/CyberBrick_Controller_Core/blob/master/src/app_rc/app/rc_main.py
- 官方控制与权限管理：https://github.com/CyberBrick-Official/CyberBrick_Controller_Core/blob/master/src/app_rc/app/control.py
- 官方舵机驱动：https://github.com/CyberBrick-Official/CyberBrick_Controller_Core/blob/master/src/app_rc/bbl/servos.py
- 官方启动入口：https://github.com/CyberBrick-Official/CyberBrick_Controller_Core/blob/master/src/app_rc/boot.py
- 本次查询 master SHA：9712a8439f339a09e454baf543b8e97a5b1f03a7。需要复现时用此 SHA 替换链接中的 master。

确认事项：

1. rc_slave_init 初始化无线接收；rc_slave_data 返回 L1/L2/L3/R1/R2/R3/K1/K2/K3/K4。它不会根据我们的需求自动协调四条关节。原始遥控数据可用与动作程序正常是两个层次。
2. 官方 Python 启动脚本调用 rc_main.main；接收侧另外创建 BBL_Controller，再把遥控数据送给它。官方界面通道映射由这层处理，不是无线 API 自带的行为。
3. 官方舵机也是 machine.PWM，50Hz，S1–S4 对应 GPIO3/2/1/0；当前直驱方案在这些基本参数上相符，没有证据表明必须改用官方舵机类。
4. 官方 BBL_Controller 有 Timer(0) 周期回调、舵机插值，以及 BEHAVIOR/EVENT/EXEC 权限管理。App 代码片段还经过执行器映射。外部独立程序直接 PWM 不自动参与这套权限管理。如果同一运行环境还保留官方输出任务，存在覆盖风险。
5. 仅导入模块不等于后台控制正在运行。必须找到初始化/运行路径、实例和回调才能证实竞争；不能看到 control.py 或 rc_main 文件存在就认定它在抢占。
6. 当前自定义代码不使用官方 set_angle_stepping，因此“补调官方 timing_proc”不适用于我们，不能照搬。
7. 官方仓库 issue #6 曾记录板载 .mpy 与公开仓库版本不一致：https://github.com/CyberBrick-Official/CyberBrick_Controller_Core/issues/6 。因此公开源码说明机制，不证明板上固件精确相同；不要无依据升级或降级。

## 已确认的本地流程缺陷

这些是阅读文件即可确认的行为，并不等于已确认全部故障根因：

- battery_walk 是一次性会话：等待 K4 长按松开使能，开始后最长 120 秒；K4/失联终止会话并 finally 关 PWM，函数返回。不重启/重新调用就不会再次接受遥控。
- trace_remote_walk 默认 90 秒后退出；walk_session 也是定时入口。用户之后继续推杆没有动作是预期行为，界面却没有持续明确告诉用户是否还可控制。
- 起步门槛包括：回中、前推超过阈值、左右交替、忙时丢弃请求。同侧反复推和向后拉不会按用户直觉反复迈步。
- 这些限制不足以解释 trace 日志中已接受并完成的步态为何没有可见动作。不能靠降低阈值、缩短长按或取消安全门禁“修复”这一证据矛盾。
- 反复 resume/热导入是为了保留无线运行状态，但也使“当前是否有旧实例/旧回调”不透明。删除 sys.modules 不是清除已有实例或硬件回调的证明。

## 给下一位 Agent 的执行顺序（本轮不执行）

### A. 先做一次静态入口与输出所有权审计

利用已有备份和源码，列出两板各自 boot.py → main.py/rc_main → 工作循环的实际路径；将“文件已上传”“已导入”“正在持续运行”分开。记录两板固件、Python 应用版本，别混为一个版本。

接收板建议保留 rc_module 作为无线输入，四关节只由 cb1_pwm 一处输出。发射板先保持当前能发送有效数据的方案。不要重新配对，不重写无线协议，不修改步态参数。

查全部 PWM(Pin(...))、ServosController、BBL_Controller、Timer 初始化及 release/deinit 路径。若确有第二个舵机写入者，给出明确调用路径后清理。若干净上电从未初始化官方控制器，应排除该猜测，不继续归咎于官方抢占。

注意：本机历史接收板 boot 曾改名禁用，后来软件重配又清空过文件。必须以最新已保存内容为依据；历史描述不够时只列待核实项，不擅自猜当前状态。

### B. 修清楚产品运行生命周期，再恢复用户测试

规划一个唯一的正常遥控入口，和所有定时诊断入口分开。冷启动保持未使能；用户显式使能；K4 随时停止；失联停止；恢复仍需显式操作和回中。不要依靠“有帧即走”。

正常运行不能悄悄在 90/120 秒后结束。如果实验仍需超时，必须显示倒计时、超时原因和恢复方法。停止/故障后程序可以继续服务输入但不能自行恢复运动。定义清楚使能手势与停止按钮是否共用，提供等待、就绪、运动、停止、失联的可观察状态。

这部分是后续设计/实现任务，不是本轮已完成修复。先提出最小改动，保留原始代码备份与限位，勿大规模重构。

### C. 必要时只做一项小范围闭环验收，不再轮番跑长脚本

在明确唯一入口、唯一输出者后，由后续执行者安排：真实左杆触发一个已标定关节在安全范围内变化，回中后可重复；K4 停止。不要先接五阶段全身步态，不增加角度，也不取消保护。

如果软件接收并下发但仍无动作：再检查输出实际脉宽/频率与舵机端供电，必要时测量，不用更多状态日志替代物理输出。PWM getter 只是寄存器/对象层证据，不等于舵机接头有正确波形。

如果该闭环可靠，再接回现有步态并按“左推→左步、回中→右推→右步”确认。用用户确认/视频建立时间对应，软件 done 不算动作验收。通过之后再讨论同侧重复请求和连续走。

## 不应做的事

- 不把黄灯或 step done 当成机器人已遥控成功。
- 不继续凭上午猜测改 K4 去抖/长按阈值。
- 不盲目停所有 Timer、删除系统库、恢复出厂或升级固件。
- 不因存在社区 ESP-NOW 示例就整体替换当前已收到帧的链路。
- 不直接实例化官方 ServosController 做替代测试：它会初始化四个输出，必须先处理与现有 PWM 的所有权及限位。
- 不把尚未回复的自动步行对照观察写为成功或失败。

## 备选参考

社区有独立固件脚本/遥控例程，可参考分层与上电入口，但不是本次优先迁移目标：
https://forum.bambulab.com/t/where-is-documentation-on-building-applications-for-cyberbrick/172330/37
https://github.com/rotorman/CyberBrick_Controller_Core/tree/espnowdemo/src/app_espnow

最终状态：研究完成；软件修复与实机验收未执行。根因仍待最小闭环确认，优先审计入口生命周期与输出控制权，不再把全部问题笼统叫“遥控没连上”。
