paomodabaibai/CyberBrick2-User-Research-UX/05_程序与测试/CB1_Otto控制框架_v02/2026-09-24长按诊断记录.md

# 2026-09-24 K4 长按诊断（接上午交接）

两板同时USB连接，按序列号确认COM7=接收、COM8=发射；本轮未打开COM8串口，以免中断发送。仅上传并运行 `diagnose_arm.py`，60秒只读，不创建PWM、不实例化Controller、不执行enable。

本地新增诊断及5项测试；全量111项PC测试通过。生产 `battery_walk.py`、main.py、步态参数未改；板上读取 battery_walk.py 内容与现有入口相符。

原始输出：`output/arm_probe_2026-09-24.txt`。

- 2664次采样，只有初始化第0帧无效；之后稳定有效。
- 双杆一直在中位附近：L约-0.01，R约-0.002，未超过0.20门槛。
- t=45445ms读到K4按下，t=46455ms达到1000ms门槛，t=55862ms读到松开。
- 连续按压最大10394ms；因掉帧、摇杆偏移、提前松开而重置的次数全部为0；产生1次 `WOULD_ENABLE`。
- 用户确认按住并松开。结论为②板端日志：**本次未复现按钮抖动或长按失败；不能继续把接触不良认定为根因，也无需凭猜测缩短门槛。** 诊断镜像不执行真正的 `session.enable()`，不能代替使能阶段的现场验证。

下一步：用户能够支撑机器人后，保持同一串口会话运行真实 battery_walk，记录启动/enable/状态或异常，识别真实入口与只读诊断的行为差异。

代码核查补充：`demo_scripted.py` 输入是虚拟帧，K4始终置为松开，所以运行它时**真实遥控K4不能急停，真实失联也不会使其停止**；只保留能力检查、限位、定时和finally释放。不能把“同一控制器”描述成所有真实无线安全条件都有效。当前lean=10、lift=5时步进踝目标为lean+lift=15°；不能把lean单项的10°称作整套步态最大偏角。延长时程不改变目标角度，只改变执行速度。
