paomodabaibai/CyberBrick2-User-Research-UX/05_程序与测试/CB1_Otto控制框架_v02/台架验证计划_v02.md

# 台架验证计划_v02

日期：2026-09-22（阶段 A 交付）。配套脚本：本目录 `bench_v02.py`。
**纪律：不覆盖 v01；模拟通过 ≠ 实机成功；用户不在场不启动任何执行器。**

## 一、操作入口与安全属性

`import bench_v02` 绝不产生 PWM、不连遥控、不动关节——所有动作在显式函数里。

| 入口 | 类型 | PWM | 遥控 | 需 confirmed=True | 允许 DRIVER='sim' |
|---|---|---|---|---|---|
| `diag()` | 只读诊断 | 永无 | 不连 | 否 | 无关（不建驱动） |
| `monitor()` | 无PWM遥控监测 | 永无（不建驱动） | RcLink 只读 | 否 | 无关 |
| `joint('right_hip', 5)` | 托住单关节 | 该关节一通道 | 不需要 | **是** | 否（须 allow_sim=True） |
| `demo3()` | 缺件三关节演示 | 三个已启用通道 | 不需要 | **是** | 否 |
| `gait()` | 完整四关节单步 | 四通道 | 不需要 | **是** | 否 |
| `remote_gait()` | 完整双杆流程 | 四通道 | RcLink + run循环 | 走 main_v02 门禁 | 否 |

共同规则（由代码强制，非口头约定）：

- 通道一律按**关节名 → config.JOINTS 的 port/gpio** 选择，脚本不按列表位置猜舵机；
- 动作范围：单关节 ±10° 上限；每次动作先打印范围/时长/结束行为；
- 结束行为：回零位 → 短保持 → **关闭 PWM**（停止脉冲；**舵机电源不会被软件切断**，物理开关负责）；
- 缺件不静默：`demo3()` 在输出完整时拒绝（提示改用 `gait()`）；`gait()` 在缺件时列出全部原因后拒绝；`enable_debug()` 的每个动作日志持续带 "INCOMPLETE OUTPUT"；
- `joint()` 对 disabled 通道、continuous 舵机直接拒绝（左踝 S2 现为 360° 连续旋转，不可位置命令）；
- 移动类入口在 `DRIVER='sim'` 时拒绝执行（防"软件跑了但舵机没动"的误判），PC 彩排须显式 `allow_sim=True`；
- 单关节测试**不需要标定完成**（台架小幅动作正是标定手段），但四关节步态必须全部 `calibrated=True`。

## 二、阶段 B：用户在场 · 板端流程（未验证）

前置：用户在场并同意；托住机器人；物理断电开关在手边。

1. **B1 只读检查与备份**（只允许 `diag`/文件操作）：
   - 重新识别串口（按 USB 序列 `58:E6:C5:A8:1B:0C` 认接收板，不假定 COM7/8）；
   - 备份板载文件到 `05_程序与测试/board_backup_<日期>/`（**不覆盖**旧备份）；
   - 确认官方自启仍禁用；核对舵机型号与 `config.JOINTS` 一致；
   - 板上跑 `bench_v02.diag()`，输出应与 PC 端一致（左踝 disabled/continuous）。
2. **B2 上传与无动作验证（✅ 2026-09-23 已完成，见文末状态表）**：
   - 上传白名单（逐个 SHA256 核对）：`config.py, joint_model.py, trajectory.py, gait_planner.py, input_adapter.py, command_mapper.py, states.py, controller.py, main_v02.py, bench_v02.py, center_joint.py, timeutil.py, drivers/__init__.py, drivers/cb1_pwm.py`（**共14个，center_joint.py 为对中计划新增（复核修正后版本：切换关节自动关旧通道、seconds等待打断保证关输出；板上尚未上传），timeutil 是阶段A清单漏项、首次上板时补传发现**，timeutil 是阶段A清单漏项、首次上板时补传发现**；PC 专用 `sim_config/run_demo/tests/simulator` 不上传）；
   - 验证 `import main_v02`、`bench_v02.diag()` 正常，**确认上电与有效遥控帧均不产生 PWM**（示波器/舵机不动）；
   - `bench_v02.monitor()` 读左右杆/K4：核对方向、静止值（L≈1959/R≈1797）、行程与 config 映射一致；
   - **实测关遥控后 `rc_slave_data()` 返回什么**：若持续返回旧帧 → 记录"失联保护尚不可用"，停止进入自由遥控（`remote_gait` 不开放），另提通信修正方案。
3. **B3 缺左踝期间的验证（⏸ 等用户可托住机器人后执行）**（左踝保持禁用）：
   - `diag()` 确认无 left_ankle PWM 通道；
   - 托住状态下 `joint()` 逐个测 right_hip / left_hip / right_ankle 小幅动作；
   - 验证使能（`SESSION.enable()` 会拒绝 → 用 `enable_debug()`）、K4 停止、Ctrl-C 暂停、恢复、`release()`；
   - `demo3()` 只验证命令顺序；**不评价站稳/行走**。

**B 通过标准：板端流程可操作、默认不动作、通道选择正确、停止行为明确。**

## 三、阶段 C：左踝到位后标定（未开始）

前提：四个腿部执行器均为可定位 180° 舵机（含 S2 换装 PG001）。config 先改
`left_ankle: enabled=True, actuator='position'`（仍 `calibrated=False`）。

顺序：核对 S1–S4 与真实关节 → 托住逐关节设中位（错齿重装舵盘，不用大 trim 掩盖）→ ±5° 测正负方向 → 探明不顶住的机械范围 → 写回 config（center/trim/direction/min/max）→ 最后才逐关节 `calibrated=True`。

记录表格（逐关节填写，**用户观察确认列必须由用户当面确认**，程序跑通不等于标定完成）：

| 关节 | 接口/GPIO | 型号 | 中位/微调 | 正方向实际动作 | 安全范围 | 用户观察确认 |
|---|---|---|---|---|---|---|
| left_hip | S1/GPIO3 | ? | | | | ☐ |
| right_hip | S3/GPIO1 | ? | | | | ☐ |
| left_ankle | S2/GPIO2 | PG001(待换) | | | | ☐ |
| right_ankle | S4/GPIO0 | ? | | | | ☐ |

## 四、阶段 D：调出真实单步（未开始）

用 `gait(side='left'/'right')`（调试命令触发，**不引入遥控干扰**）。顺序：站姿平放 → 小幅移重心 → 左脚卸载/摆动/落脚 → 右脚 → 交替衔接。

每轮只改一类参数，顺序：**中位与方向 → 重心偏移(lean) → 卸载幅度(lift) → 髋部摆幅(hip_swing) → 阶段时间**。记录：改前改后参数、用户观察、拖脚/打滑/倾倒/顶住、是否真实移动、下一次修改理由。**"角度序列执行完"不等于一步成功。**

## 五、阶段 E：双杆玩法（未开始）

`remote_gait()`：左杆前推一次=左脚一步，右杆=右脚；长推不重复；回中后再触发；忙时不排队；双杆冲突不留延迟动作；停止/重连不自动续走；同侧仍显式提示不支持。初步验收：**连续五次左右交替，每步之间可停顿，由用户继续触发**。

## 六、状态汇总（阶段 A 交付时点）

| 阶段 | 结果 |
|---|---|
| A 软件复核 | **通过**（84 项测试全绿；暂停保持流程已闭合） |
| B1 只读检查 | **通过**（COM7=接收板；11文件备份 board_backup_2026-09-23_B1；官方自启仍禁用） |
| B2 上传与无动作验证 | **通过**（13/13 哈希一致；导入+diag 正常；无动作验证 PWM 通道为空；杆方向前推=+1.00 双侧一致、行程满量程；K4 识别正确；**关遥控 196/196 采样返回 None——固件不缓存旧帧，失联保护可用**） |
| B3 缺左踝验证 | ⏸ 等用户可托住机器人（joint 逐关节 / demo3 / 使能-停止-暂停-恢复-释放） |
| C 标定 | 未开始（等左踝到位）。**机械对中按《..//../04_结构与硬件/Otto_V9腿部对中计划_v01/》（安装图/center_joint.py/记录表/使用说明，阶段一已交付）** |
| D 真实单步 | 未开始 |
| E 双杆玩法 | 未开始 |

实测明细见 `../CB1_Otto单步实验_v01/现场调试记录_2026-09-22.md`（2026-09-23 节）与 `实测记录_阶段B_2026-09-23.md`。
操作同步教训：板端采集用户看不到实时输出，须用 UI 选项点击触发（点击后立即开始操作），否则时序错开。

四类结论始终分开记录：①自动测试通过 ②板端命令执行成功 ③用户确认真实动作 ④实际站稳或移动。当前只有 ①。
