paomodabaibai/CyberBrick2-User-Research-UX/05_程序与测试/CB1_Otto控制框架_v02/实测记录_阶段B_2026-09-23.md

# 实测记录：v02 阶段 B1/B2 板端接入（2026-09-23）

结论等级标注：①自动测试通过 ②**板端命令执行成功（本记录全部属于此级）** ③用户确认真实动作 ④实际站稳/移动。
本轮**没有产生任何舵机动作**（B3 未开始），因此 ③④ 均未发生。

## 环境
- 接收板 COM7（USB 序列 58:E6:C5:A8:1B:0C），发射板 COM8；连接方式 `mpremote connect COM7 resume`（不软复位）。
- PC：serial_runtime venv，Python 3.11.15。板上 MicroPython（CB1 官方固件）。
- v01 文件原样保留，未覆盖；板载原 11 文件已备份 `../board_backup_2026-09-23_B1/`。

## 上传清单与一致性
13 个文件：config.py（板上副本 DRIVER='cb1_pwm'）、joint_model.py、trajectory.py、gait_planner.py、
input_adapter.py、command_mapper.py、states.py、controller.py、main_v02.py、bench_v02.py、
**timeutil.py（阶段A清单漏项，首次上板 import 报错后补传）**、drivers/__init__.py、drivers/cb1_pwm.py。
一致性：板上 uhashlib.sha256 与本地 13/13 完全一致。
（方法教训：`mpremote fs cat` 经 Windows 管道会做 \n→\r\n 转换导致校验假 DIFFER，哈希必须在板上算。）

## 板端验证结果（全部 ②）
| 项目 | 命令 | 结果 |
|---|---|---|
| 导入 | `import main_v02, bench_v02` | OK，无 machine 顶层导入 |
| 只读诊断 | `bench_v02.diag()` | 与 PC 一致：左踝 disabled/continuous；行走 BLOCKED 列出 4 项缺失原因 |
| 链路初始化 | `main_v02.RcLink()` | rc_module 初始化 OK，帧持续到达 |
| 无动作验证 | 15 拍 `poll()`（有效帧、未使能） | state=disabled，**PWM 通道={}，零脉冲** |
| 静止杆量 | 同上 last_inp | L=-0.00 / R=-0.01（实测中位 1959/1797 与 config 吻合） |
| 左杆方向/行程 | 36s 采集（用户操作） | 前推=+1.00、后拉=-1.00，方向正确，双向满量程 |
| 右杆方向/行程 | 同上 | 前推=+1.00、后拉=-1.00，方向正确，双向满量程 |
| K4 | 同上 | 按下正确识别（读 0），松开恢复 |
| **失联行为** | 关遥控后 6s 探针 | **196/196 采样返回 None**：固件不缓存旧帧，connected=False 立即成立，失联保护可用；v02 `timeout_ms=None`（None=立即断链）设计与真实固件一致 |

## 阶段 B 通过标准核对
- 板端流程可操作：✅（导入/诊断/链路/轮询全通）
- 默认不动作：✅（上电+有效帧均零脉冲；使能仍会因未标定被拒绝）
- 通道选择正确：✅（diag 的 port/gpio 与实测映射一致；左踝无 PWM）
- 停止行为明确：✅（K4 识别正确；失联立即断链）——K4 触发的实际停止动作属 B3 验证

## 未验证（等实机条件）
B3 全部：joint() 逐关节动作、demo3() 命令顺序、enable_debug/K4 停止/Ctrl-C 暂停/恢复/释放 全流程。
C/D/E 未开始。distinction：以上均未发生过舵机运动，无 ③④ 级结论。
