paomodabaibai/CyberBrick2-User-Research-UX/05_程序与测试/CB1_Otto控制框架_v02/验收整改汇报_v02.md

# v02 控制框架验收整改汇报

日期：2026-09-22 深夜（第二轮，验收整改）。整改范围：上一轮验收提出的五个任务。
**本轮未连接串口、未上传程序、未驱动实机；v01 原样未动。**

全量测试：**61 项，全部通过**（`python -m unittest discover -s tests`，结果存档
`output/测试结果_2026-09-22.txt`）。演示：`python run_demo.py` 正常，14 事件。
以下按任务逐项汇报，格式：**问题 → 修改文件与位置 → 行为变化 → 验证方法与结果 → 尚未验证项**。

---

## 任务一：显式使能

**问题**：`ENABLE_ON_FIRST_LINK=True` 收到第一帧有效遥控即自动使能并发站姿，违反"默认不动作"。

**修改文件与位置**：
- `config.py`：删除 `ENABLE_ON_FIRST_LINK`；`REMOTE['stop_button']` 注释明确 K4 只停止。
- `main_v02.py`：BoardSession 删除自动使能逻辑；新增 `enable()` / `enable_debug()` 门禁入口（`_gate()` 检查活跃帧与 K4）；`start()` 工厂；模块 docstring 写明 REPL 操作方法。
- `controller.py`：`enable()` / `enable_debug()` 内部调用 `_disarm_trigger()`（mapper.ready=False）；`recover()` 同样重新武装检查。

**行为变化**：有效帧不再触发任何使能/站姿/动作；使能必须显式调用；无活跃帧或 K4 按住时拒绝使能并说明原因；使能与恢复后必须**先观察到两杆回中**才有迈步请求；上电摇杆已推不会即走；停止/失联/重连均不自动续走，恢复后也要重新回中。

**验证方法与结果**（新测试全部通过）：
- `tests/test_board_loop.py::test_valid_frames_never_enable`（20 拍有效帧保持 DISABLED、零输出）、`test_no_link_stays_disabled`
- `test_enable_rejected_while_k4_held`（K4 按住拒绝；松开后可使能）
- `test_enable_then_recenter_gate_then_step`（推杆保持前推时使能不迈步；观察到回中后才触发）
- `test_recover_requires_recenter_old_input_does_not_fire`（恢复后旧输入不触发，回中后才触发）
- `test_link_loss_never_resumes`、`tests/test_controller.py::test_9b` / `test_stop_keeps_no_auto_resume_and_recenter_gate` / `test_enable_requires_recenter_before_first_step`

**尚未验证项**：板上 REPL 使能流程未在真机演练（本阶段禁止连机）。

---

## 任务二：单步阶段修正

**问题**：原 `unload_swing` 不转髋，主要髋部摆动发生在 `land` 且落脚与摆动耦合；双髋被假设恒等。

**修改文件与位置**：`gait_planner.py` 全量重写：阶段目标表、逐髋起点 `lh/rh = current_pose[0]/[1]`、模块 docstring 逐阶段物理意图 + "未证明平衡/行走"声明；`config.py` GAIT 新增 `step_sign_left/step_sign_right/ankle_sign`。

**行为变化**：新序列为 预备（踝回中、髋各自保持）→ 移重心（双踝 A·lean）→ **卸载并完成主髋摆动**（双髋→S·hip，摆动踝 A·(lean+lift)）→ 落脚（**髋保持 S·hip 不再摆**，踝回中触地）→ 稳定（保持下一步所需姿态）。插值始终从真实当前命令姿态开始，左右髋独立，中途急停冻结的不对称姿态可正确续接。同侧重复仍显式拒绝。左右方向与踝方向符号可配置（只改 config 三个数）。新序列是设计假设，**不声称能平衡或前进**。

**验证方法与结果**（通过）：
- `tests/test_gait.py::test_swing_completes_during_unload_swing`（摆动在落脚前完成）
- `test_land_phase_moves_hips_not_at_all`（land 阶段髋位移 <0.2°，踝回中）
- `test_asymmetric_start_keeps_each_hip_individually`（非对称起点逐髋保持，不瞬移）
- `test_phase_continuity_by_construction`（全程每拍相邻差 ≤3°）
- `test_6_alternate_step_continuous_no_jump`（交替衔接连续，起点=上一步终点）
- `test_5a/5b`（首步左/右均可、镜像）、`test_7`（同侧拒绝）、`test_step_and_ankle_signs_are_configurable`（符号翻转有效）

**尚未验证项**：序列的物理合理性（能否重心转移成功）需真机托住观察，属设计假设。

---

## 任务三：MicroPython 兼容与时间异常

**问题**：板端导入链依赖 `os.path`/`sys.path`；dt 用裸减法（回绕不安全）；无卡顿防护；步态请求会把请求前等待时间算进新动作。

**修改文件与位置**：
- `timeutil.py`（新）：板端 `ticks_ms/ticks_diff`；PC 端 30 位回绕时钟同语义。
- `drivers/__init__.py`、`drivers/cb1_pwm.py`、`main_v02.py`：移除 `os.path`/`sys.path`（板端平铺导入，不再需要路径拼接）；静态检查确认板端 12 个模块无 `os.path`、`sys.path`、`__slots__`、f-string。
- `controller.py`：dt 一律经 `timeutil.diff_ms`；dt<0 记 0；`dt > STALL_MS` 时走行中→FAULT（拒绝把丢失时间喂给轨迹，防止跳阶段/瞬移），空闲→从当前继续；`request_step` 置 `_fresh_step`，起始拍轨迹推进为 0。
- `config.py`：`STALL_MS=500`（理由写在注释：循环 20ms、最短阶段 250ms，>500ms 即丢 ≥25 拍）。
- `input_adapter.py`：删除 `__slots__`。

**行为变化**：计时回绕安全；时钟倒退不动姿态；走行中大卡顿→FAULT 且姿态不跳变；空闲大间隔无害；新步首拍 gait 时间恒为 0。

**验证方法与结果**（通过）：`tests/test_controller.py::TestTiming` 四个用例——`test_timeutil_wrap_difference`（回绕正负差）、`test_walk_across_counter_wrap_same_result`（时间戳跨 2^30 边界与不跨界的终态完全一致）、`test_negative_dt_never_moves_pose`、`test_stall_while_walking_faults_instead_of_jumping`（5000ms 间隔→FAULT、reason 含 stall、姿态与使能前相同）、`test_long_idle_then_first_step_does_not_inherit_wait`（起始拍 elapsed=0，后续每拍 20ms）。

**尚未验证项**：**静态检查完成，板端运行待验证**——无 MicroPython 环境未实测；`time.monotonic`/`ticks_*` 实际行为、导入耗时是否满足 20ms 循环需上机确认。

---

## 任务四：执行器能力配置化

**问题**：`cb1_pwm` 写死跳过 `left_ankle`；无"是否启用/执行器类型/是否标定"概念；缺件会被演示掩盖。

**修改文件与位置**：
- `config.py`：JOINTS 每关节新增 `enabled / actuator('position'|'continuous') / calibrated`；真实配置如实记录 left_ankle=禁用+连续旋转+未标定、其余未标定。
- `joint_model.py`：`walk_blockers() / can_walk() / output_blockers()` 能力报告。
- `controller.py`：`enable()` 校验 4 关节能力，不满足即拒绝并列出原因；`enable_debug()` 允许缺件但设置 `debug_incomplete`，步态开始/完成日志持续标记"DEBUG incomplete output"。
- `drivers/cb1_pwm.py`：删除写死关节名；按配置决定通道——禁用/连续旋转通道**永不创建 PWM**。
- `sim_config.py`（新，仅 PC）：虚拟四位置舵机全可用档案；`simulator.py` 默认用它，与真实配置物理隔离（deepcopy，互不影响）。

**行为变化**：缺关节/未标定/类型错误时拒绝使能行走并给出人话原因；三关节演示是显式的 `enable_debug()` 调试模式，日志不报告"完整步态成功"；明天换 PG001 只改 config 一个条目。

**验证方法与结果**（通过，`tests/test_capabilities.py` 10 项）：
- 缺关节 / 未标定 / 错误类型 → `test_missing_joint_rejected` / `test_uncalibrated_joint_rejected` / `test_wrong_actuator_type_rejected` / `test_continuous_channel_is_reported_when_enabled`
- 真实配置当前拒绝使能：`test_real_config_rejected_until_calibrated`（诚实反映"现在不能走"）
- 禁用/连续通道无 PWM：`test_disabled_and_continuous_channels_never_get_pwm`（桩 machine 下 GPIO2 永无 PWM 对象，即使发姿态）、`test_continuous_joint_never_commanded_even_if_enabled`
- 通道正常发声：`test_enabled_position_channels_receive_pulses`（中位=1_500_000ns）
- 虚拟/真实隔离：`test_virtual_profile_never_mutates_hardware_truth`；换 PG001 只改配置：`test_swap_left_ankle_to_pg001_is_config_only`
- 调试模式标记：`test_debug_enable_allows_incomplete_and_marks_it`

**尚未验证项**：真实 ESP32-C3 上的 PWM（duty_ns 频率/分辨率）未实测；桩测试只覆盖通道策略。

---

## 任务五：输入新鲜度与恢复逻辑

**问题**：`timeout_ms` 从未参与失联判断（形同虚设）；无读取时间/数据时间区分；停止/释放后轨迹与阶段状态残留风险。

**修改文件与位置**：
- `config.py`：`REMOTE['timeout_ms']=None` + 长注释说明官方 `rc_slave_data()` 无序号/收包时间戳、无法识别缓存旧帧、拒绝伪造新鲜度。
- `input_adapter.py`：`from_rc` docstring 声明 `now_ms` 是读取时间而非数据时间，`connected` 仅表示"本拍返回了帧"；明示不得用"摇杆值不变"推断失联。
- `main_v02.py`：BoardSession 记录 `last_inp / last_valid_ms`（最后有帧的拍），不伪装新鲜度。
- `controller.py`：`_clear_action()` 统一清空 trajectory/phase/step_side/support_side/landed，`stop() / fault() / release_output() / recover() / enable()` 全部调用，恢复不可能继承无效动作。

**行为变化**：失联判断只依据"本拍是否有帧"（官方接口限制下的诚实语义）；任何终止路径后动作残留为零；恢复/再使能从干净状态开始。

**验证方法与结果**（通过）：`tests/test_board_loop.py::test_freshness_bookkeeping`（last_valid_ms 只在有帧拍更新）、`test_link_loss_never_resumes`；`tests/test_controller.py::test_8`（停止后 trajectory/phase/step_side 均为 None）、`test_8b_release_clears_state_and_disables`（释放后清空、再使能干净）、`test_9`（失联清空轨迹、重连不恢复）。

**尚未验证项**：`rc_slave_data()` 在发射端关机后是否吐缓存旧帧——需真机实测（v01 遗留实验，本阶段禁止连机）。

---

## 复现命令

```bash
cd "E:\课程作业\大三上\张茫 用户研究与体验设计\05_程序与测试\CB1_Otto控制框架_v02"
python -m unittest discover -s tests -v      # Ran 61 tests ... OK
python run_demo.py                            # 14 事件，final state: ready
```

产物：`output/demo_log.csv`（801 行）、`demo_joints.svg`、`demo_phases.svg`、`测试结果_2026-09-22.txt`。

## 完成声明边界

本轮完成的是：**控制语义一致、默认不动作、步态阶段合理、异常处理完整、缺失硬件不会被隐藏、电脑测试可复现**。
不声明：机器人能走稳、MicroPython 板端已验证、任何实测成果。所有"实测"字样仅指 2026-09-22 白天的 v01 真机结论（接口映射/遥控通道），未因本轮软件改动新增任何实测。

---

# 复核收尾轮（第三轮，2026-09-22 深夜）

复核结论采纳：核心框架整改通过；板端操作入口收尾 + 驱动选择修正。**仍未连接串口/未上传/未驱动实机；v01 原样未动。** 全量测试 **68 项全部通过**（结果已重新存档 `output/测试结果_2026-09-22.txt`），演示回归 14 事件正常。

## 收尾一：板端"初始化 → 持续读取 → 显式使能 → 运行 → 停止/恢复 → 退出"真实可执行

**问题**：文档中的手动使能流程走不通——`start()` 只建对象不初始化遥控；`main()` 阻塞循环且 session 是局部变量，REPL 无法同时调用 `session.enable()`；`_gate()` 依赖上次保存的输入，隔久了会把旧输入当当前状态。

**修改文件与位置**：
- `main_v02.py`（整体重写）：
  - `RcLink` 类：唯一持有 `rc_module` 初始化与 `read()` 的地方。
  - `BoardSession.__init__(ctrl, cfg, link=None)`：链路作为依赖注入；`start(cfg=None, link=None)` 不再自动初始化遥控（PC 可无链路构造）。
  - `poll()`：单拍实时入口——读一帧遥控 + 控制器走一拍（REPL 分步调试用）。
  - `_live_input(action)`：**每次使能/恢复现场重读遥控**，不再读 `last_inp`；无链路/无有效帧/K4 按住均拒绝。`enable()`/`enable_debug()`/`recover()` 全部走它，并把读到的新帧喂给控制器（回中观察从真实当前杆量开始）。
  - `run()`：阻塞循环，Ctrl-C **暂停且力矩保持**，session 存入模块级 `main_v02.SESSION`，打印继续方法；`resume()` 带同一 session 重入循环；退出必须显式 `SESSION.release()`（PWM 断电）。
  - `stop()` 便捷入口；docstring 顶部写明六步完整流程与新鲜度限制。
- `README.md` / `参数说明与硬件接入清单.md`：操作流程改为真实可执行的 A（run/暂停/enable/resume/recover/release）与 B（`start(RcLink())` + 逐拍 `poll()`）两种，并保留"rc_slave_data 无序号/收包时间戳，无法识别固件缓存旧帧"的明确记录。

**行为变化**：使能与恢复不再可能基于过期输入放行；REPL 操作者按文档即可完成全过程（不再要求"测试里手工绕过入口"）；Ctrl-C 语义从"退出并断电"改为"暂停保持力矩"，避免暂停-使能-继续流程被自动断电打断。

**验证方法与结果**：`tests/test_board_loop.py` 重写为两层——`loop_once`（注入帧+时钟的纯逻辑层）与真实入口层（`FakeLink` 仿真无线模块、`FakeClock` 注入 20ms 时钟，全部走 `poll()/enable()/recover()/run()/resume()`，不绕过入口）。新集成场景：完整六步流程端到端（初始化 3 拍不动作 → 使能 → 交替两步 → K4 停止 → 失联拒恢复 → K4 按住拒恢复 → 恢复 → 回中 → 再走一步 → release 断电）；使能用的是现场读数（`read_count` 递增断言 + 存量输入后被断链仍拒绝）；恢复同门禁；`run()` Ctrl-C 暂停后 session 存活、力矩保持、`resume()` 重入；无 session 时 `resume()` 拒绝。

**尚未验证项**：板上 REPL 实际交互（mpremote 环境的 Ctrl-C 行为）未验证；`rc_module` 初始化/读取未真机跑。

## 收尾二：驱动选择改用传入配置

**问题**：`build_controller(cfg)` 收了配置，但 `create_driver(jm)` 仍读全局 `config.DRIVER`——模拟配置可能意外选到硬件驱动（反之亦然）。

**修改文件与位置**：`drivers/__init__.py`：`create_driver(joint_model_ref, cfg)` —— **cfg 必填**，只按传入配置的 `DRIVER` 分派；调用点同步：`main_v02.build_controller`、`simulator.Simulator`、`tests/test_controller.py`（2 处）、`tests/test_capabilities.py`。

**行为变化**：驱动选择与关节模型来自同一份配置；`sim_config` 虚拟档案永远选 sim 驱动，全局 `config` 的 `DRIVER` 不再影响任何已注入配置的构造路径。

**验证方法与结果**：`tests/test_capabilities.py` 新增 `TestDriverSelectionFromConfig`：污染全局 `config.DRIVER='no_such_hardware_driver'` 后用虚拟档案构造仍得 SimDriver；`cfg.DRIVER='bogus_mode'` 时 `create_driver` 抛 ValueError 且消息含该值。

**尚未验证项**：板上 `DRIVER='cb1_pwm'` 路径（真实 PWM）仍板端未验证。

## 复测与产物

```bash
python -m unittest discover -s tests -v      # Ran 68 tests ... OK
python run_demo.py                            # 14 事件，final state: ready
```

---

# 阶段A软件复核（第四轮，2026-09-22 深夜）

复核任务："v02 板端接入与双杆单步验证"的阶段A。**未连串口/未上传/未驱动实机；v01 原样未动。**
复现基线：68 项测试 OK（serial_runtime venv，Python 3.11.15）→ 修正后 **84 项全部通过**，演示 14 事件正常，存档 `output/测试结果_2026-09-22.txt`。

## A2 暂停保持流程审查结果（七项核对）

1. **Ctrl-C 暂停取消活动步态**：新增 `main_v02.pause(session)`——暂停时若在 WALKING 则 `ctrl.stop('paused by Ctrl-C')`（轨迹清空、STOPPED、姿态保持），恢复循环绝不会自动续走；`run()` 的 KeyboardInterrupt 分支调用它。测试：走行中暂停→STOPPED→连拍不产生新写入。
2. **暂停期保护范围如实标注**：`pause()`/`run()`/模块 docstring/README 均写明"暂停期间 K4 与失联检测不运行，保持的输出不受遥控保护"。
3. **暂停时间不计入步态**：暂停已取消轨迹；恢复后经 recover+回中开的新步从 elapsed=0 开始（`_fresh_step`）。测试：暂停后时钟跳 10s → 无 FAULT、新步 elapsed_in_seg==0 且正常走完。
4. **resume()≠使能/恢复**：`resume()` docstring 与暂停提示打印均声明"仅重入循环"；测试：暂停(STOPPED)后 resume+推杆仍 STOPPED 不走。
5. **未处理异常明确清理**：`run()` 的非 KeyboardInterrupt 异常分支先 `session.release()`（PWM off）再重新抛出，并打印 CRASHED 提示。测试：注入抛错链路→断言异常再抛、driver.released、state=disabled。
6. **PWM≠断电**：`release()`/`run()` 提示、README、参数说明统一改为"关闭 PWM（停止脉冲信号）；舵机电源不会被软件切断，由物理开关负责"。
7. **start() 参数一致性**：发现 README/参数说明示例 `start(main_v02.RcLink())` 会把链路误传给 cfg 形参——已改为 `start(link=main_v02.RcLink())` 并加测试锁定关键字用法。

## A3 台架操作脚本与清单

- 新增 `bench_v02.py`：`diag()`（只读诊断）/`monitor()`（无PWM遥控监测）/`joint(名称,±10°内)`（托住单关节，回零+关PWM结束）/`demo3()`（缺件三关节演示，输出完整时拒绝）/`gait()`（严格使能四关节单步，缺件拒绝）/`remote_gait()`（双杆完整流程）。导入不动作；通道按关节名→port/gpio 选择；移动类需 `confirmed=True` 且拒绝 sim 驱动（防"软件跑了舵机没动"误判）。
- 新增《台架验证计划_v02.md》：五入口安全属性表 + 阶段B（只读检查/备份/无动作验证/失联实测）/C（标定表）/D（单步调参顺序）/E（双杆验收）完整清单，各阶段结果标注"未验证/未开始"。
- 新增 `tests/test_bench.py` 10 项：导入安全、监测无PWM、禁用/连续/超程/未确认/sim驱动拒绝、按名称动作并释放、demo3 不伪装完整步态、gait 缺件拒绝。

## 本轮边界

仅 ①自动测试通过。②板端命令执行 ③用户确认真实动作 ④实际站稳/移动 均未发生。阶段B 及以后等用户在场，详见《台架验证计划_v02.md》。
