paomodabaibai/CyberBrick2-User-Research-UX/10.22最终汇报素材/同伴PPT与场景/儿童试玩场景_2026-10-21/生成记录与提示词.md

# 儿童试玩场景｜生成记录

- 日期：2026-10-21
- 生成方式：内置 image_gen / imagegen，三次独立生成。
- 按用户“横版”需求采用 16:9 横向构图；场景为 AI 生成示意图。
- 参考：用户提供的儿童机器人活动照片（摄影风格），项目最新双机插图（产品外观），v11 地图整体效果（场地）。
- 交付：01_地板试玩_16x9.png、02_桌面对战_16x9.png、03_近景互动_16x9.png。
- 成图保存到本目录；内置工具原始输出按工具要求保留在默认目录。

## 通用提示词

```text
Use case: photorealistic-natural.
Create a single high-resolution HORIZONTAL LANDSCAPE 16:9 photographic usage-scenario image for the user's CyberBrick toy robot project. Full-bleed photograph, not a collage.
Input image 1 is ONLY a reference for natural candid Chinese children's activity photography, emotional authenticity and natural indoor light; do NOT copy those children's exact faces or its humanoid robots.
Input image 2 is the PRODUCT DESIGN reference: faithfully reproduce this pair of small friendly cream rectangular Otto-style biped toy robots, one with turquoise top frame, blue wide flat feet and a single blue open-palm paddle on a short horizontal arm mounted atop the body; the other with red top frame, red wide flat feet and a single rounded red fist on a compact horizontal mechanism atop the body. Retain small black oval eyes on cream front faces, visible practical pivots, short legs without knees, two independent broad feet, NO wheels, NO humanoid bodies. Translate the stylized product reference into plausible matte 3D-printed plastic and soft paddle/fist materials under real photographic lighting. Each robot is about 15–20 cm tall, much smaller than a child's torso. Keep the palm vertical with fingers pointing sideways, mounted to its top arm. Both robots fully assembled and standing on the board.
Input image 3 is the physical arena reference: a low 80x120 cm rectangular play board with thin natural wood perimeter, teal-blue printed technological floor, small yellow accents, two low staggered T-shaped dark-teal dividers with white support feet. Reproduce the overall practical board without labels or measurement lines.
Natural faces, hair, skin texture and clothing, relaxed genuine delight and concentration, hands correctly holding simple physical dual-joystick controllers with thumbs on joysticks. Children look at the robots. Product and kids share physically consistent scale, perspective, contact shadows and lighting. Photorealistic editorial image, believable indoor activity, no cartoon styling, no CGI look, no sparks, no glowing trails, no floating geometry, no text, no logos, no watermark, no banners. This is an AI imagined usage scene, not documentary evidence.
```

## 01_地板试玩_16x9

完整提示词为上方通用提示词加以下场景描述：

```text
Scene: bright Chinese primary-school activity room with wooden floor, soft window daylight and indistinct activity furniture in the background. Exactly two main Chinese children around 7–9 years old, one short-haired boy in a simple dark navy T-shirt and one girl with two braids in a pale powder-blue cotton top, sitting cross-legged side by side behind the arena on the floor, each holding a small controller. The boy smiles with delight, the girl is playfully concentrated. Frame them at seated child eye level in a natural wide medium shot, their full heads and controllers visible. The low arena fills the lower third, both small robots clearly visible in the near-middle of the arena, facing each other at a three-quarter angle so both their cream front faces and their blue palm/red fist modules are recognizable. Restrained classroom background with a couple of distant children softly blurred, none competing with the main subjects. Warm, authentic candid mood like input 1, gentle daylight, 35 mm documentary photography, sufficient depth of field to keep robot details and children's expressions legible.
```

## 02_桌面对战_16x9

完整提示词为上方通用提示词加以下场景描述：

```text
Scene: sunlit Chinese school makerspace with pale wooden tables, a few softly blurred shelves and plants. Exactly two Chinese children aged 8–10, a boy in a cream and muted-green striped T-shirt and a girl with a ponytail in a pale peach sweatshirt, seated on opposite adjoining sides of a sturdy low wide wooden activity table. The teal arena rests fully supported on the tabletop. Both children lean slightly forward, holding their own small dual-stick controller naturally, smiling and concentrating on the two robots navigating the clear space between the low dividers. A side-front three-quarter medium-wide documentary composition, faces, controllers, BOTH robots and most of the arena clearly visible. The palm robot and fist robot are in the near-middle of the board angled toward one another, with their distinctive top mechanisms unobscured and their cream front faces readable. Products occupy enough of the lower middle for clear recognition but stay physically small. Soft sidelight through a window, believable classroom textures, unposed lively interaction, professional natural lifestyle photography, 40 mm lens, moderate depth of field.
```

## 03_近景互动_16x9

完整提示词为上方通用提示词加以下场景描述：

```text
Scene: cozy bright children's activity room, soft daylight and warm wood tones. A close, engaging landscape documentary photograph from the near edge of the low tabletop arena, slightly above the robots' height. In the foreground-middle, the blue palm and red fist biped robots face each other on the teal board near a low divider; frame both complete robots including their feet, mechanisms and cream front faces. In the middle background, two Chinese children aged 7–9 (boy in muted yellow cotton T-shirt, girl in pale lavender cotton top) sit beside the table with their heads and upper bodies clearly visible, each holding a controller. Capture a moment of shared delighted laughter while they look down at the robots, not at the camera. Focus balances readable toy details with recognizable natural children's expressions; mild background blur only, not extreme bokeh. Low three-quarter viewpoint, 50 mm natural photographic perspective, accurate realistic scale, warm joyful atmosphere without theatrical gestures, no hands reaching into the robot mechanisms.
```
