paomodabaibai/CyberBrick2-User-Research-UX/04_结构与硬件/拳头_整体比例预览_v03/开放式底座_v01_试装/试装说明.md

# 开放式底座 v01（试装件）

攻击机构相对 Otto 后移 22 mm；套环仍以 Otto 身体为中心。两侧连接梁把套环和后移后的底板合成一个结构件，不再将错位孔硬拧在一起。

底板前方开 19×28 mm 操作窗口；套环前后侧开放 28 mm 宽的走线/接口窗口。主控板可从未被后移模块覆盖的身体前部及这些窗口接近。原电机托架、导杆座和机械连接保留。

先在切片软件检查一体底座的桥接/支撑，再试套身体。需要实物确认 USB、开关、线束方位及螺钉长度；此文件不等于装机验证。不要直接打印整机比例预览 STL。
