paomodabaibai/CyberBrick2-User-Research-UX/04_结构与硬件/拳头_整体比例预览_v03/按用户参数导出_STL/先读我_导出说明.md

# 拳头机器人整机 STL：参数确认后的调整底稿

按用户 2026-09-28 最后一次预览状态导出，2026-09-29 完成。**长度单位按毫米解释。**

| 参数 | 数值 |
|---|---:|
| 拳头高度 | 46 mm |
| 拳头绕 Z 轴转角 | +14° |
| 拳头绕 Y / X 轴转角 | 0° / 0° |
| 攻击模块整体前后 | -22 mm（后移） |
| 滑架到拳头的腕部延长示意 | 38 mm |
| 拳头独立 X / Y 偏移 | 0 / 0 mm |
| 曲柄半径、内部连杆孔距 | 10 / 34 mm |
| 出拳总行程 | 20 mm |

坐标：X 向前，Y 向机器人左，Z 向上；Otto 身体顶面为 Z=0。原拳头是无单位网格，以上高度是缩放后的设计尺寸。

## 文件怎么用

- `整机_收回_参数预览.stl` / `整机_打出_参数预览.stl`：同一比例的双足机器人、攻击机构、电机参考件和新拳头，用于看全机布局。两份的拳尖 X 最大值分别约 103.27 / 123.27 mm，差 20 mm。
- `攻击模块_收回_参数预览.stl` / `攻击模块_打出_参数预览.stl`：去掉 Otto 身体和脚，便于单独修改头部。
- `新拳头_已缩放旋转定位.stl`：单独拳头，在收回状态下的全局坐标，适合单独选中后加工腕部。
- `腕部延长_尺寸示意_不可直接打印.stl`：仅为 38×10×8 mm 的位置示意长方体，**不具备锁紧孔、连接面或强度设计**。
- `所选参数与导出信息.json`：数值与导出文件包围盒；`../export_selected_stl.py` 可重建本组文件。

STL 无颜色和零件层级，整机文件是多件网格的组合，并非布尔合并的实体。在建模软件中要方便地单独选零件，可用同位置的单件文件，或按不相连网格分离整机 STL。

## 尚需在 3D 软件中完成

1. 原 AI 拳头网格 **不是水密封闭体**，应先修网格、确定壁厚和材料，再考虑打印。
2. 重做滑架到拳头的真实腕部连接，包括锁紧件、受力路径和减重；示意长方体不能直接打印。
3. 攻击模块后移 22 mm 后，现有模块平台与留在原位的身体套圈不再吻合，需要重做安装座。
4. 检查收回、打出及中间角度的导杆、支座、拳头、紧固件与机身干涉，并核查加装后的重心和行走稳定性。

本轮只做网格位置与尺寸导出，未运行 CAD 布尔干涉、力学或实物装配验证。导出的二进制 STL 已逐一重新读取文件头，三角面数与文件长度吻合。
