paomodabaibai/CyberBrick2-User-Research-UX/04_结构与硬件/队友拳头模块_2026-09-28_增量审阅/04_结构与硬件/Otto_CB1出拳头部_v01/资料核对与设计依据.md

# 资料核对与设计依据

核对日期：2026-09-28。用户授权先按官方资料建参数化版，实际电机/减速箱装配状态未确认。

## 来源与证据等级

1. [Bambu Lab 官方 CyberBrick 套件清单](https://asia.store.bambulab.com/en/products/cyberbrick-hardware-kit)：030 Micro DC Motor with SH1.0 与1:48单轴减速齿轮组为套件物料。该清单支持本版选型，但不证明用户实收库存。
2. [官方单轴030减速器装配指南](https://store.bblcdn.eu/s8/default/5eb26f09c19c49e481ebe4e0ace72cdd/Assembly_Guide_of_Single_Axis_030_Reduction_Motor.pdf)：标识LA024及LA012/LA014/LA016/LA018/LA020/LA022齿轮组，区别打印壳体和非打印件。本文按套件LA016选比，不自行打印替代精密齿轮。
3. 项目既存 `01_研究参考/CyberBrick1迁移研究/官方CAD.zip` 中的 `030 Micro DC Motor with SH1.0 - Reducer-LA024.stp`、裸马达STEP/STL。本轮仅提取到本目录，未修改原压缩包。减速器STEP含14个实体，脚本对壳体包络和实体数量设守卫；原文件SHA256随每次建模写入validation.json。精确CAD版本与实物版本可能不同，仍需量规验证。
4. 项目既存 `官方规格.zip` 内 `030_Micro_DC_Motor_-LA024.pdf`：额定8V，范围5–9V；空载10500±10%rpm、空载电流最大45mA；规格负载转速6900±10%rpm。已阅读文本并渲染第1页及第8页外观图核对。本次未重新测试这些性能。
5. [官方 CB1 电机控制源码](https://github.com/CyberBrick-Official/CyberBrick_Controller_Core/blob/master/src/app_rc/bbl/motors.py)及本地同名副本：M1/M2两路直流电机，速度接口 `set_speed(motor_idx, speed)` 支持正负方向。只能证明API与通道存在，不能证明当前板端应用已正确集成。
6. 项目已有 Otto 顶部模块说明与 `build_model.py`：身体原模型包络69×69×39mm、安装框75mm、套合净孔69.8mm。这是本版机身接口依据；没有凭空假定新机身或现有孔位完全一致。
7. [James Bruton / XRobots Punchy](https://github.com/XRobots/Punchy)：本地有STEP和MIT许可。本版采用常规曲柄滑块机构重新建模，没有复制Punchy零件。保留该参考来源，不声称与Punchy实物相同。

官方商品详情页本次部分区域返回抓取错误，未以搜索摘要中的“3mm轴”作为配合尺寸；采用本地官方STEP的实际输出轴截面。

## 从厂家STEP实际测到的内容

- 两片壳体合并包络：原坐标X为-11..11，Y为-2.8..15.2，Z为-32.2..22.15，即22×18×54.35mm。
- 输出轴中心：原坐标X=0、Z=11.15，沿+Y方向。
- 输出轴端位于Y=23.3，壳体上表面约Y=15.2，外伸约8.1mm。
- 输出轴外包圆名义直径5.3mm，有两处相对的斜向平面；脚本在原Y=20处取截面，选外轮廓后外扩0.15mm生成配合孔。因此不会把内部中心孔误当配合轮廓，也不靠手填“单D轴”。
- 安装旋转为循环换轴X→Y、Y→Z、Z→X，再平移至指定曲柄轴位。壳体水平放置，输出轴朝上。
- 保留官方实体10/11为减速箱上下壳，其他齿轮/电机/金属轴用作总装参考；参考内部齿轮不会被列为本项目需要打印的零件。

## 设计选择

曲柄滑块相较直接驱动拳头，能用同向旋转完成往复，适合现有直流马达。双金属导杆分担拳头侧向载荷；较短的20mm初始行程和34mm连杆用于首轮试装，不是经实验选出的最优值。没有设置储能弹簧或提高冲击能量的机构。

默认输出一圈的几何运动由解析公式决定。根据额定空载速度除以48可得约219rpm，但实际速度取决于电压、PWM、负载和齿轮损耗；本版不估算击打力、不承诺整机平衡。手柄的一次按键和“一圈”之间必须由软件及回位检测建立关系，机械本身没有自动停止能力。

厂家CAD/规格按参考用途保留原名称，未据此宣称本项目原创或重新授权。共享本项目时应保留来源并另行核对厂家资源使用条款。
