paomodabaibai/CyberBrick2-User-Research-UX/06_游戏设计/手工制作与贴图_v07/README.md

# 126厘米竞技场手工制作与贴图

已确认保留 **1260 × 1260 mm** 单层平地场地。制作改用雪弗板、木条和现成小五金，取消3D打印地砖与连接件。主墙位置沿用错位T墙地图；球靶沿用“磁吸脱开后落到低位、人工复位”的判定。红圈出发打红球，蓝圈出发打蓝球。

## 直接使用的文件

- `output/pdf/01_材料尺寸与手搓说明_A4.pdf`：7页。第1页采购，第2页给店家裁切，第3页墙体装配，第4页摆位，第5～6页球靶，第7页打印与装配顺序。
- `output/pdf/02_贴图与模板_A4_实际尺寸.pdf`：11页A4，210 × 297 mm。
- `output/pdf/03_贴图与模板_A3_实际尺寸.pdf`：6页A3横向，420 × 297 mm。已经把两页A4按原尺寸排在一页，最后半页留白。
- `制作与打印清单.json`：尺寸、数量、页码的机器可读清单。
- `build_handcraft.py`：可修改的矢量PDF生成源文件。

**A3与A4贴图二选一。打印100%实际尺寸，关闭“适合页面”；A3不要再选“每张两页”。** 先打印一页，量100 mm校准线，再印其余页。本文所有尺寸单位均为毫米。

## 一次买齐

| 材料 | 整套数量 | 用途与购买要点 |
|---|---:|---|
| PVC发泡雪弗板 1220 × 2440 × 5 | 1张 | 一张足够6块底板、全部主墙、2靶座及加强片；请商家代切。选PVC发泡板，不用纸面KT板做地板。 |
| 实木条截面20 × 30 | 1.2米 × 5根，或1米 × 7根 | 30朝上，20占地，做外围护沿。6根1米虽然总长够，定长排料却不够。 |
| 实木条截面20 × 20 | 1米 × 1根 | 两套球靶柱和挑臂。柱长先量实机后定。 |
| 同款轻质泡棉或海绵球 Ø70 | 红蓝各1个 | 尽量同质量、同软硬；不要用实心硬球。 |
| 小磁铁 Ø8 × 2 | 4枚 | 使用2枚、备用2枚；只是试样规格，吸力需用纸垫试调。 |
| 可被磁铁吸住的普通钢垫圈 | 2枚 | 外径12～16，孔3～4；不要买不吸磁的不锈钢件。 |
| 棉织带宽10 | 1.5米 | 每球2段260长做正交球兜，总用量1040。 |
| 光滑细绳约Ø1 | 1米 | 每套先裁300，现场定低位高度。 |
| 止挡珠或垫片 | 2个 | 外径至少10，大于3～4导孔；绳尾结还须大于珠自己的孔。 |
| 硬PET片或硬卡纸 | 20 × 20、约1厚，2片 | 球兜顶部承片，可用现成边料。 |
| 小L角码40 × 40、约15宽 | 4个 | 每根柱脚左右各1个。 |
| 小L角码20 × 20、约15宽 | 4个 | 每根挑臂与柱前后各1个。 |
| 木螺钉3 × 10 | 约24枚 | 根据角码孔位安装，避免对面螺钉相撞或穿出木条。 |
| 薄高粘双面胶、布基胶带 | 各约10米 | 靶座固定用高粘胶并跨压胶带；墙脚可少量粘接，改布局时取下。 |
| PVC发泡板兼容结构胶 | 1支或1瓶 | 墙竖片、底脚、加强片直接粘板材。按卖板店建议选胶，用余料试粘并按产品要求固化。 |
| 薄透明封箱胶带、薄纸边料 | 宽约48～50、厚不大于0.1的胶带1卷及少量纸 | 底板背面拼缝、封磁点、调吸力、做挑臂顶部开放式收绳浅槽。 |
| 哑面背胶打印纸 | A4 11张或A3 6张 | 也可普通纸打印后贴薄胶；出生圈优先作为描线模板。 |

工具：钢尺、铅笔、剪刀、美工刀和垫板、砂纸、螺丝刀、小钻；木螺钉预孔钻头约1.5～2，绳导孔钻头3～4。现场裁木柱还需要小手锯和夹具。赶时间时，先测球高，再请商家把柱也裁成最终长度。

PVC发泡板可用于裁切、印刷和覆膜；5 mm整板建议交给店家切。材料类别依据：[Palram PALIGHT](https://www.palram.com/product/palight-pvc-flat-sheets/) 和 [3A Composites FOREX CLASSIC](https://www.display.3acomposites.com/en/products/details/forex-registered-brand-classic-1092/)。本方案的厚度与裁切量是设计选值，不要求买这两个品牌，也不构成当前店铺库存或价格承诺。

## 交给店家的裁切单

以下雪弗板全部厚5，共28片矩形。

| 件号 | 长 × 宽 | 数量 | 用途 |
|---|---:|---:|---|
| F | 420 × 630 | 6 | 3列2行，拼成1260方形地板 |
| W60 | 180 × 55 | 2 | 加5厚底脚后总高60 |
| W80 | 180 × 75 | 4 | 加底脚后总高80 |
| W100 | 180 × 95 | 2 | 加底脚后总高100 |
| WS | 120 × 75 | 2 | 支墙，总高80 |
| B180 | 180 × 40 | 8 | 横墙底脚 |
| B120 | 120 × 40 | 2 | 支墙底脚 |
| TBASE | 160 × 120 | 2 | 球靶底座 |

可选但推荐：两直角边15 × 30的小三角20片。先裁15 × 30矩形10片再对角切，每道墙前后各用1片，沿墙长度错开。30竖贴墙、15横贴底脚；不会超出底脚外缘。

板厚按实际量：竖片高＝需要的墙总高−底脚实际厚度。5 mm标称板厚略有偏差时，主墙高度可接受相应小误差，但底板接缝需要单独找平。

排料按3 mm刀缝：整板1220宽分为420＋3＋420＋3＋374；两根420宽条各裁3段630。全部小件可排在374余条前约770长内。总成品面积约1.824 m²（含加强片），一张板足够。

| 木条截面 | 切长与数量 | 排法 |
|---|---|---|
| 20 × 30 | 420长6根；610长4根 | 4根1200原料各裁610＋420，第5根裁420＋420，留得下锯缝。 |
| 20 × 20 | 200长2根；220长柱毛坯2根 | 1米够。柱毛坯按实测高度裁短；H135、t8例子只需173。 |

## 摆位与装配

底板从西向东排列：南排F1/F2/F3，北排F4/F5/F6。桌面需要全幅承托底板；背面跨缝贴不大于0.1厚的薄透明胶带，不用厚布基胶堆叠垫高接缝。拼缝建议控制在0.5以内，高差0.2以内，并用机器人试走确认。地面无需满贴纸，避免纸边翘起。

墙竖片放在40宽脚座正中，两侧各留17.5。先贴墙面装饰，再剪开加强片胶合位置露出板材；竖片和加强片用板材胶粘牢，脚座再用薄双面胶固定到地板。脚座属于障碍，通道尺寸量到脚座边缘。

护沿南北各3根420长，东西各2根610长接在南北护沿之间。四角不重叠。护沿用胶固定，不能仅靠木条自重；它不等于已经验证能防止重机器人跌落的围挡。

坐标原点为左下角，X向右、Y向上：

| 对象 | 占地或中心位置 |
|---|---|
| LH1 / LH2 / LH3 / LH4 | X分别20～200 / 200～380 / 380～560 / 560～740；Y340～380；总高依次60 / 80 / 100 / 80 |
| LS | X500～540，Y380～500，总高80 |
| RH1 / RH2 / RH3 / RH4 | X分别1060～1240 / 880～1060 / 700～880 / 520～700；Y880～920；高度对应LH同号 |
| RS | X720～760，Y760～880，总高80 |
| 红出生 / 蓝出生 | (260,180) / (1000,1080) |
| 红球 / 蓝球投影 | (260,650) / (1000,610) |
| 红后柱 / 蓝后柱中心 | (260,800) / (1000,460) |
| 红靶座范围 | X180～340；Y740～860 |
| 蓝靶座范围 | X920～1080；Y400～520 |

A摆法保留10段墙，红朝+X、蓝朝−X，与原图拓扑一致，需要绕行。B摆法移除LH1/2/3和RH1/2/3连同底脚，红朝+Y、蓝朝−Y，保留4段墙；入口净宽480。建议先试玩B，再装回其余墙体验A。两种摆法共用一套材料。

## 球靶做法和必须现场定的尺寸

每颗Ø70球用两条260长的织带做正交闭环，用布基胶带包牢重叠与底部交叉处。硬帽固定到顶部布带，钢垫圈固定到帽上并用胶带跨压边缘；绳绑在帽旁织带。承重由布兜承担，不能只把钢圈粘在软球皮上。

200长挑臂前端在球前20、后端在球后180，后柱中心在球后150。磁点距臂前端20，导孔距前端60。臂下小磁铁固定并包封，钢圈随球一起掉落。磁点过强就用薄纸垫逐层减弱，先做一套试打再复制。

设H为实际需要的球心高度，t为**木臂底面到裸球顶的总距离**，包含磁铁、封胶、纸垫、钢圈、硬帽和布带。则臂底高度U＝H＋35＋t，木柱净长＝U−底座厚5。示例H135、t8时U178、柱173；135不是实机验收值。

每根绳先裁300。穿过磨圆的3～4导孔，上端设止挡珠，珠外径至少10，珠上方打结且结大于珠自身孔。把球底临时垫高20，止挡珠抵孔上口，再调绳并锁结；这样把低位定为球底20、球心55。绳上部多余段放在臂顶开放浅纸槽，不要在球旁留松环。

示例U178、系绳点近似裸球顶时，孔下有效绳长88、孔内另有20，初始孔下斜段约40.79、上方可抽余绳约47.21。实际帽和绳结高于球顶时，用垫高20的方法现场定长，不直接按88裁绳。

以t8和导孔后40为例，H至少约87.8才有足够绳长挂回磁点；为保留明显落差，设计建议H至少95。220柱毛坯在t8时最多支持H182。超出这一范围需改柱或导孔位置；不能只改一个标注数字。

实测需覆盖：攻击最高点与臂的间隙、巴掌扫掠不带住细绳、机器人身体不先撞底座、两种攻击都能触发、普通行走不误触。后柱150仅是初样；球脱落后的全摆幅可能触柱，命中后停机，检查不缠绕再复位。

判定：**脱开上磁点并降到低位才计分；只有晃动不计。** 身体撞架、手碰导致误脱则复位。先有效命中自己颜色球者胜。

## 贴图内容与尺寸

| 内容 | 裁切尺寸 | 数量 | A4页码 |
|---|---|---:|---|
| 高60墙双面 | 177 × 52 | 4 | 1 |
| 高80横墙双面 | 177 × 72 | 8 | 2～4 |
| 高100墙双面 | 177 × 92 | 4 | 5～6 |
| 支墙双面 | 117 × 72 | 4 | 7～8 |
| 红蓝出生圈 | 外径180、内径164 | 各1 | 9～10 |
| 红蓝靶座标牌 | 150 × 50 | 各1 | 11 |
| F1～F6背面编号 | 46 × 20 | 6 | 11 |

墙面贴纸比板面四边各缩进1.5。顶面、底脚和护沿保持材料本色，省去贴图与接缝。出生圈可用普通纸作描线模板；若薄贴，压平边缘，不能做有厚度的圆环。它是位置标记，不要求200长机器人整个身体都放进180圆内。

## 已确认和待试打

已确认：1260场地可放下；单层平地；两种攻击机构；红打红、蓝打蓝；命中结果保留到人工复位；本次改手工制作。

设计选值：5厚板、6块底板、40宽墙脚、30高木护沿、Ø70球及木架结构。文件已核对裁切数量、排料、坐标、贴图页边界及A3无缩放拼版，并渲染检查全部PDF页面。

仍需实测：有效击打高度与范围、过缝行走、转向、吸力与脱落手感、绳路和围沿稳固。文件是可以据此制作的手工初样，不是机器人适配已验收的证明。v05 STL/STEP与v06打印架仍作为历史资料保留，本次不要照旧文件打印。
