paomodabaibai/CyberBrick2-User-Research-UX/06_游戏设计/落地墙体竞技场_v04/README.md

# 落地墙体竞技场 v04

2026-10-12 根据用户纠正：纵向只增加落地墙体，绝对不架空。上一版悬挂摇摆台已被否定，不再作为推荐制作方案。

**单层平地＋两片矮墙＋两枚落地竖靶。** 蓝 A 打红 TB，红 B 打蓝 TA；谁先用攻击机构将敌靶整体打到侧倒，谁赢。

- [地图与立体预览](地图与立体预览.html)：默认展示全场墙体，切换俯视和两种摆墙方式。
- [策划与制作说明](策划与制作说明.md)：坐标、规则、组件、打印数量和实测事项。
- [中央短墙平面图](地图_divider.svg) · [中央开口平面图](地图_opening.svg) · [立体总览](立体总览.svg)。
- [落地组件与打印说明](../../04_结构与硬件/落地墙体竞技场_v04/README.md)。
- [数字检查记录](交付验证.md)。

地图900×540mm，180mm节距；15块地板、22片底部连接片。先在平桌上用胶带划区、试2片墙与2枚竖靶，验证后再打印完整地板。全部墙底与靶底在同一行走面上，不需要轴、轴环、铰链或活动台。

当前仍以击倒敌靶竞速为主。墙限制活动区域，不能据此宣称已经产生丰富的拦截策略；不要求难转弯的机器人绕墙完成任务。竖靶高度与倒靶手感均待实测。
