paomodabaibai/CyberBrick2-User-Research-UX/06_游戏设计/错位T墙竞技场_v05/README.md

# 错位 T 墙竞技场 v05

> **2026-10-13 靶形更新：** 用户现允许悬挂小球，并确认命中后掉落/翻转、保持至人工复位。当前推荐见 [磁吸脱落球靶 v06](../磁吸脱落球靶_v06/README.md)。本目录的场地和墙体继续作为布局基础；Ø90×160筒靶文件保留为历史，不是新球靶的打印件。新靶结构与触发参数尚待实物试打。

2026-10-13｜按本次用户俯视图制作的单层地图、可编辑 CAD 与试打印交付。保留旧 v04 作为历史，不再采用旧版颜色规则。

## 先看与下载

- `viewer.html`：离线交互 3D，双击打开。旋转、缩放、俯视、A/B 布局、地板打印分区、部件点选。
- `output/pdf/错位T墙竞技场_v05_尺寸与打印图册.pdf`：6页 A3 横版，包括 A 平面、B 平面、3D 总装、49块打印分区、拆件清单和实测表。
- `../../04_结构与硬件/错位T墙竞技场_v05/`：单件 STL / STEP、两套装配 STEP、BOM、参数、坐标与数字验证。
- `交付验证.md`：实际完成的数字检查及尚未完成的验证。

**使用规则：红圈出生，打红 TR（蓝方守护）；蓝圈出生，打蓝 TB（红方守护）。颜色表示攻击者。** 先用攻击机构把指定目标整体击倒者胜；侧壁落地且不能自行直立即有效，滑走不算。机身或脚推倒、误触或桌面震动误倒则暂停复位；先后无法辨别判平局。60秒为初次试玩建议，不增加开关、解锁或任务链。

## 本版尺寸与选择

场地名义 **1260 × 1260 mm**，7 × 7 块180节距地板，每块179.6 × 179.6 × 6，接缝0.4。地板实物边缘0.2～1259.8，外围护沿名义外包络1260。建议桌面至少1320 × 1320并全幅承托；桌面尚未确认，此尺寸是设计假设，不是用户硬性要求。不要为了桌面小而等比缩放 STL，否则通道、薄壁、接口都会变化。

用户图中的两组错位 T 墙、红左下 / 蓝右上出生、同色攻击方向均保留。与原图像素比例相比：横墙、支墙位置及靶位已按机器人与目标尺寸调整；支墙缩为120长，靶位移向开口，给倒伏留量。这是有标注的设计调整，不是逐像素描摹。

两种布局共用一套零件：

| 布局 | 装场主墙 | 出生朝向 | 操作特征 |
|---|---:|---|---|
| A 原图完整墙布局 | 10 | 红 +X、蓝 −X | 需要绕横墙、在目标前改变朝向；用于原图还原与比较，未证实容易操控 |
| B 低转向布局 | 4 | 红 +Y、蓝 −Y | 移除 LH1～LH3、RH1～RH3，入口480，沿短直线接近目标；建议从此版开始试玩 |

主墙横段180 × 40，高度60/80/100/80；支墙120 × 40 × 80。外围护沿20厚35高。所有墙和目标底部都位于同一行走面 Z=6，没有架空、台阶、桥、悬挂或联动机关。

## 坐标和编号

原点为场地名义左下角、桌面 Z=0；X向右、Y向上、Z向上。所有尺寸 mm。A1位于西南角，列1～7向东、行A～G向北。纸面编号与地面圆环只用薄印刷 / 贴膜，不做凸起打印字。

| 对象 | XY位置 / 范围 | 尺寸与数量 |
|---|---|---|
| 红 SR / 蓝 SB 出生 | (260,180) / (1000,1080) | 圆环直径180仅为标识；机身示意200 × 90 |
| 红 TR / 蓝 TB 目标 | (260,650) / (1000,610) | Ø90 × 160开口筒各1；壁0.8，底1.2 |
| LH1～LH4 | X=20～200、200～380、380～560、560～740；Y=340～380 | 高60、80、100、80 |
| LS | X=500～540；Y=380～500 | 高80 |
| RH1～RH4、RS | 上述左墙绕(630,630)旋转180° | 等高镜像 |
| 护沿 | 四周20厚、35高 | 180长26件，140长2件，角部不重叠 |

目标中心到出生中心470，不等于机器人需走470；接触前必须停步，距离按各机攻击件实测。约135击打高度来自旧CAD腕部锚点估算，不能当作有效拳面或巴掌高度。

## 操作净空与复玩

外围内侧到横墙出生带净宽320；横墙自由端到对侧护沿500；B直线入口480。中央两支墙端角静态距离为 √(180²+260²)=316.23，比Ø300设计预留略大，不能因此认定两机可会车或容易转弯。A的示意路线在中央交会，不适合未经实测就同时冲入；试玩先确认真实步态和转弯轨迹。

CAD巴掌整圆扫掠上界约Ø254，未含行走摇摆；以Ø300作首轮预留。200 × 90是本次用户约数，而拳头CAD宽114，均需实物核对。B直线布置减少对转弯的依赖，不宣称竞技平衡已经验证。

目标倒伏保守圆半径230：45 + √(160²+90²)≈229。标定位置与墙体、护沿不相交；此包络不覆盖撞飞或滚动。目标底不粘，墙脚用可移薄胶固定。两枚靶同材质、同切片、称重配对，试打共同调整尺寸。

复玩只在局前换布局、交换操作人/机器人，或将红目标Y在620～680、蓝目标Y在640～580之间成对镜像变化（红增加多少，蓝减少多少）；X固定。变化不要求增加瞄准难度，出生保持对准。先比B，再试A；若复玩带来的只是卡墙和多次重摆，应退回B并改墙位。

## 制造与验收

完整A装场173件：49地板、84底桥片、10主墙、28护沿、2靶；B装场167件，拆下6段横墙留作复用。打印一套即可。另有左右接缝样片各1和可选80高筒试样；80高样件只检查薄壁，不替代160高靶的击倒测试。

STL已经按打印朝向导出：地板和样片的行走面朝下贴台，底槽朝上；使用时翻回。STEP保留装配朝向。连接槽只在底部，槽深2.4、桥片厚2、每侧名义间隙0.3，行走面连续厚度3.6。片间接缝名义0.4，建议实测不超过0.5，高差不超过0.2；这些是验收目标，非实测结果。

先打印两片样片、一桥片、一支墙、两枚靶。在平桌按B布局试两机攻击、制动与接缝；再批量打印地板。装配时分区倒置嵌桥片，背面薄胶带固定后分区翻回，桌面全幅托住。连接片仅定位，不用其悬空搬整张场地。若加防滑层，应整场统一厚度，复核接缝，不让贴膜边缘翘起。

必要实测：桌面有效尺寸；机器人真实外包络；巴掌整圆扫掠；两机有效接触高度上下限；停止距离；90°/180°实际转弯轨迹；目标重量和有效击倒；地板摩擦和翘曲；墙脚抗滑。用户人在场时再进行机器人动作，本次交付没有连接、上传或驱动机器人。

## 可编辑与再生成

CAD脚本与参数在硬件目录，运行环境和依赖见其 README。图册用 `build_drawings.py` 生成，使用 Codex bundled Python 的 reportlab 和 Windows 微软雅黑字体。交互页内嵌 scene.json，无网络依赖。修改地图后须同步 CAD场景、图纸、交互页与检查报告；不可只改一张图就视为新定版。
