paomodabaibai/CyberBrick2-User-Research-UX/PROJECT_CONTEXT.md

# milk 组桌面双足对战机器人｜项目总入口

> **2026-10-22 双机控制已部署与资料合并：** 10月21日拳头5文件、巴掌9文件均已上传并板端SHA256核对，启动日志进入持续遥控。共用robot_remote.py，髋30°/踝20°/周期1秒，K4按住跳舞松开停；拳头M1上慢下快，巴掌D1双向900/2100µs、回中1500µs停。巴掌右杆无反应实测为接线松动，重插后用户确认完全恢复控制；攻击后续连接检查恢复转动。最大指令500/2500µs仅短测确认更快且机构正常，未长期保留。10月22日再次运行199项PC测试全部通过；最新转向轨迹、重心与长时负载仍不作全部验收声明。合并同伴场景分支32a21800，补齐PPT、80×120cm场景和插图；汇报原始资料入口为10.22最终汇报素材。短视频尚未制作。下方10月20日“待上传”均为历史状态。

> **2026-10-19 球靶改版（当前球靶入口）：** 用户确认竞技场已搭好，否决木条/布带悬挂靶，改为优先打印的下托磁吸脱落球靶。已从实际网格量出静态巴掌112.3–167.8mm、微调后拳头113.0–159.0mm；制造初样采用Ø60球、球心125/135/145三档、方柱套筒M3贯穿锁紧。CA001磁铁按官方4×2mm规格，中心1对或外圈对称3对；M3×30两颗、M3×16两颗、普通M3螺母四颗/套。当前为9主体件＋小样的可打印机械初样，16个STL复读通过水密/单实体/落床检查，三档CAD无干涉；没有切片、实打或试打。先打3种小样，再打一套，验证后复制。入口：`06_游戏设计/打印脱落球靶_v09/制造初样_v01/先看这里_打印与装配.md`。旧v06–v08球靶方案不再作为制作依据，竞技场本身不变；本版尚无自动收球，球脱落后人工拾回复位。未连接或修改机器人。

> **2026-10-21 带贴图地图模型 v11：** 用户确认沿用两组错位T形墙，主墙平行80cm宽边，要求仅地图、不要打击装置。已交付800×1200mm带v10地板和原墙贴的GLB（内嵌5张PNG）、OBJ/MTL、离线可旋转预览、整体及俯视效果图，入口：[地图3D预览](06_游戏设计/贴图地图模型_80x120cm_v11/地图3D预览.html)、[使用说明](06_游戏设计/贴图地图模型_80x120cm_v11/使用说明.txt)。模型仅地板/护沿/墙板/底脚/加强片，地板纹理4×6重复；Khronos格式校验0错误0警告。新隔断尺寸未提供，主墙460mm、支墙120mm及墙位为比例适配示意，非实物精确复刻；继承旧方案脚座相接、T竖片17.5mm间隙，参数已记录。旧制作和机器人文件未改。

> **2026-10-19 地板视觉修订 v10（最新打印入口）：** 按用户要求提亮青蓝底色、减弱旧化，增加冰青科技折线、切角边框和明黄色点缀；四边连续单元20 × 20 cm、80 × 120 cm整场与A3打印12张/A4打印24张方案不变。见 [v10明亮科技版打印说明](06_游戏设计/地板无缝纹理_80x120cm_v10_明亮科技版/先看这里_打印与拼接.txt)。三套PDF、PNG单元与预览已更新并通过数字实尺/拼接校验；v09深色版保留。实体印色仍以试打为准。

> **2026-10-19 实体场地更新：用户确认地图已改为80 × 120 cm，隔断也已完成。** 已按现有墙贴的深青蓝、细网格与警示黄制作四边连续地板：20 × 20 cm循环单元，A3双拼母版打印12张或A4单块母版打印24张，以及800 × 1200 mm整幅实尺PDF。入口：[打印与拼接说明](06_游戏设计/地板无缝纹理_80x120cm_v09/先看这里_打印与拼接.txt)。已完成数字尺寸、四边像素连续性及PDF渲染校验，未实体试印；本次不改已有隔断，不沿用旧1260 × 1260场地坐标。下方v07/v08的旧场地尺寸保留为历史制作依据。

> **2026-10-20 双机统一控制与K4跳舞（PC完成，尚未上传）：** 按用户新要求，两机已改为共用robot_remote.py的行走、单杆前后弧线、换向收步、K4按住跳舞/松开恢复、回中使能、失联停止与持续启动。只在攻击输出和各遥控器ADC校准值上区分profile：拳头M1上慢下快，巴掌D1正反转。统一髋30/踝20/周期1秒，舞蹈四关节±25；最终按用户要求以第一台原步幅为准，第二台髋±30范围待实测。199项PC测试通过（14项新增共享控制/D1/入口测试），两实际profile等效输入下腿PWM逐拍一致；未连串口、未上传、未驱动。原项目程序目录的“待上传_双机统一控制_2026-10-20”包为当前上传入口（巴掌9文件/拳头5文件），替代上一轮只传second_punch_remote.py的旧包。详见程序目录《2026-10-20_双机统一控制与K4跳舞_交接.md》。旧otto_session保留作历史调试，已不作为新巴掌启动入口。

> **2026-10-20 拳头单杆倒退修复（PC通过，待上传）：** 用户确认问题是同一根杆前推、后拉都沿前进弧线。已确认原拳头循环将单杆drive=0统一设为direction=+1；新增walk_direction保留推拉符号，stride_turn分离步幅侧与前后方向，并在换向前收至零幅度。保留髋20/踝16度最大幅度，差幅比由2:1改为3:1；共185项PC测试通过（新增11项），无串口、无上传、无机器人动作。本地巴掌源码也有原单杆默认前进分支，未把两机实物差异归因于不存在的独有映射错误；巴掌与共享振荡器文件没有修改。报告：`05_程序与测试/CB1_Otto控制框架_v02/2026-10-20_拳头单杆后拉前进_修复报告.md`。正式源码在 `E:/课程作业/milk-github-sync`；原项目同级程序目录有“待上传_拳头单杆倒退修复_2026-10-20”包，已有持续版第二台接收板仅替换second_punch_remote.py并复位，入口版本second-punch-walk-reverse-2026-10-20。用户回家再上传，现场前后位移与物理左右仍待确认。

> **2026-10-17 最终状态：拳头机器人基本完成。** 用户已确认最终四关节 ±25° 跳舞版“没问题了”。持续遥控、行走/转向、上慢下快拳头、推住持续出拳/松杆停止、K4 按住跳舞/松开停止均已具备现场确认。后续重点转为稳定性与对战演示；独立电池组合运行、主动断链停止、长时温升仍待专项验证。当前功能、接线、启动文件及证据边界见 [基本完成交接](00_项目管理/2026-10-17_拳头机器人基本完成_交接.md)，本段优先于下方旧状态。

> **2026-10-17 K4 功能更新：** 第二台拳头机器人的 K4（ch9、低电平按下）已由急停改为按住跳舞、松开结束；跳舞期间随机平滑变化四腿姿态，暂停行走输入并停止拳头电机。髋和踝目标偏移均已提高到 ±25°（用户已确认可用），仍受全局 65°–115° 输出限制。失联停止与回中使能保留；K4 不再是急停。173 项 PC 测试通过，三个文件已校验上传并复位；用户现场确认：按住跳、松开停，普通遥控正常，实机验收通过。

> **2026-10-17 Figma制作图与3D v08（当前看图入口）：** 已将当前手工方案完整写入用户指定的 [Figma图册](https://www.figma.com/design/e3jDhP0HbtQao537wypZgz/2026-CyberBrick-2.0?node-id=146-9)，原内容保留，在右侧新增12块可编辑图板：A/B平面、裁切排料、墙体装配、球靶高低位、采购与打印、A/B整体3D、11页A4与6页A3贴图、全部墙脚定位表、木臂孔位与球兜装配。737个文字层和原生矢量，已做结构与截图检查并修复遮挡。另交付 [离线3D及文件总入口](06_游戏设计/Figma制作图与3D_v08/index.html)，可旋转、切A/B和待击/低位；配套实尺PDF复制到该目录print中。Figma贴图是查看稿，出纸用100%实尺PDF；H135/柱173仍为示例，未做实机试打。裁切与采购参数承接v07；以下v05/v06等为历史方案。

> **2026-10-17 手工制作 v07（当前制作入口）：** 用户确认桌面可放下1260×1260mm，并因时间不足改为手工材料制作，不再3D打印。已改为6块420×630×5雪弗板地板、10段竖片＋40宽底脚主墙、20×30木护沿，以及两套木架磁吸脱落软球靶；一张1220×2440×5雪弗板可裁出全部板件。交付7页材料/尺寸/装配A4说明、11页A4或6页A3实际尺寸贴图（两套二选一），见 [手工制作与贴图 v07](06_游戏设计/手工制作与贴图_v07/README.md)。1260场地已确认；攻击高度135仍只是示例，柱长、磁力、绳路和双机通行需实测。旧v05打印组件与v06靶方案为历史参考，不是本次采购/裁切入口。

> **2026-10-13 靶形补充（最新）：** 用户明确允许悬挂小球等非全打印靶，并确认命中后掉落或翻转、保留结果直到人工复位。当前推荐“磁吸脱落球靶”：Ø70轻质软球，磁点定位，脱开后细绳限位降到低位；后置落地支柱，地图仍单层平地。详见 [v06靶结构](06_游戏设计/磁吸脱落球靶_v06/README.md)。这是新结构方案，磁力、臂高、球高、绳长及攻击净空需试打；v05筒靶CAD保留历史，不能作为球靶制造文件。

> **2026-10-13 地图 v05（当前，替代下方 v04 草案）：** 按用户提供的错位T墙俯视图完成1260×1260mm单层平地数字交付；49块180节距地板、84底桥片、10主墙、28护沿、2枚Ø90×160落地靶。颜色按本次用户要求：**红圈出发打红靶（蓝方守护），蓝圈出发打蓝靶（红方守护）**。A保留完整墙布局，B移除6横墙形成480净口、改出生朝向以减轻转向。支墙最终120×40×80，目标与墙位为本版设计选值，不是已确认实机尺寸；桌面尺寸、攻击高度、转弯、目标手感尚待实测。已交付6页尺寸图册、离线交互3D、STL/STEP和打印分区；数字几何检查通过，未切片/未打印/未驱动机器人。入口：[地图与图纸 v05](06_游戏设计/错位T墙竞技场_v05/README.md)、[制造说明](04_结构与硬件/错位T墙竞技场_v05/制造README.md)。

> **2026-10-12 游戏地图纠正（当前）：** 用户明确要求“纵向有些墙体阻碍一下行动就可以，绝对不要架空”。此前悬挂双靶摇摆台方向被否定，不再采用。当前为900×540mm单层平地地图，2片160×40×60mm落地墙、2枚Ø80×160mm整枚落地竖靶；蓝A打红TB，红B打蓝TA，目标整体侧倒判定。墙可改中央短墙/中央开口两种摆法，不强制绕墙或转弯；两机模型估算短进约6cm，实际动态净空与倒靶手感尚待验证。15地板/22底连接片，可先在平桌只试墙靶。入口：[地图与策划 v04](06_游戏设计/落地墙体竞技场_v04/README.md)、[落地组件 v04](04_结构与硬件/落地墙体竞技场_v04/README.md)。本轮仅准备图纸、参数与试打印几何，没有运行机器人或新增硬件验收。

> **2026-10-17 第二台拳头机器人最新状态，覆盖下方 10 月 6 日旧状态：** 第二台接收板已安装独立 `main.py` 上电入口，持续运行行走、转向、上推慢拳（1024）与下推快拳（1800）；不再受 120 秒测试倒计时限制。用户现场确认重启后左/右行走杆与拳头杆均正常，稍后再推仍有反应。失联停止和重新回中由软件保留；K4 已改为跳舞键，独立电池模式及断链实机专项验收尚未完成。PC 171 项测试通过。详见 [第二台拳头控制现场记录](05_程序与测试/CB1_Otto控制框架_v02/2026-10-13_拳头M1持续转动_修复记录.md)，当前代码在 `control/second-punch-remote` 分支。

> **2026-10-06 第二台最新实测：** 第二台 Otto V9 四路 S1–S4 已逐路 90°→110°→90° 并经用户确认正常；同一 Otto 连续步态相位关系经短时悬空与落地试走，用户确认落地能前进。拳头直流电机接 M1/GPIO4/5，以板载官方驱动半速连续运行 5 秒，用户确认机构持续正常运动。当前第二台只完成脚本试走和独立电机测试，**尚未集成遥控、并发行走出拳或自启动**。详见 [第二台机器人实测记录](05_程序与测试/CB1_Otto控制框架_v02/2026-10-06_第二台机器人实测记录.md)。

> **2026-09-28 拳头分支新增资料：** 已收到队友完整ZIP，仅提取差异至 `04_结构与硬件/队友拳头模块_2026-09-28_增量审阅/`，入口《审阅结论与下一步.md》。新增机构为LA024+LA016减速器、20mm曲柄滑块；尚未实物验证。AI拳头STL已归档至 `04_结构与硬件/拳头_3D生成参考/`，尚未定尺寸/适配腕部。队友包程序为旧battery_walk版本及旧映射，**不要覆盖本地已验收otto_session/攻击控制**。本轮未修改控制代码或驱动硬件。

> **最新状态（2026-09-26，优先于下方所有历史段落）：** **全机完成并经用户验收：行走（Otto 连续振荡）+ 弧线转向 + 倒退 + 巴掌攻击（ch2 杆 → D1/GPIO21 连续舵机，1300/1700µs 定速，松手停）全部实机可用。** 接收板上电即自动进入 otto_session 无限待命，断电是唯一停止；K4 无功能。攻击实现：attack_control.py（武装门禁/滞回/反转驻留）+ drivers/palm_pwm.py（D1 唯一写者）+ otto_session 共享帧集成；PC 151 测试全绿，板端哈希核对。关键实测参数：delta_us=200（100µs 带不动）、ch2 静止 1824-1827、直行配平 steer_trim=0.2（偏航待长期观察）。转向"只跟推拉走"的异常已由外部分析定位为踝相位双重反转并修复。遗留：巴掌 1500µs 慢爬长观察、五舵机长时供电、攻击方向语义对齐。记录：《2026-09-26_攻击功能验收通过_最终记录.md》《2026-09-26_D1巴掌控制_执行完成报告.md》。

**接手阅读顺序（最新）：** 本文件顶部 → 上述 2026-09-24 最终记录 → `00_项目管理/继续任务_给其他Agent.md` → v02 `config.py`、`command_mapper.py`、`gait_planner.py`、`walk_session.py`。用户在场才可实机动作；**绝不第三方烧录/flash-erase**；串口注意：mpremote 每次连接软重启接收板（enable 前需帧预热，已内置）、com_listen 与 mpremote 不能同时开。

以下为旧阶段摘要，末次整体验证与停止点以文件顶部的 2026-09-23 夜间更新为准。
**此文件是当前状态摘要，优先于旧汇报、CB2申请表和历史上下文。**
**本项目由多个Agent会话协作推进：文件可能已被其他会话修改，每次接手先重读本文件和现场调试记录，不要凭上次记忆行动；改完记得回写更新时间与状态。**
项目根目录：`E:\课程作业\大三上\张茫 用户研究与体验设计`。
当前会话工作目录可能是“抖音ai创作大赛26”，那不是本项目目录；务必使用本项目绝对路径。

## 接手先读
1. `00_项目管理/继续任务_给其他Agent.md`：完整交接、模型尺寸、程序和继续步骤。
2. `05_程序与测试/CB1_Otto单步实验_v01/现场调试记录_2026-09-22.md`：准确断点与下一步。
3. 同目录 `先读我_上传与校准.md`、`Otto步态拆解与本版设计.md`。

## 项目目标与已确认方向
- milk组，第2组；傅宬博（本）、白昊灵（本）、孔舒然（本）、罗圣希（研）。课程约六周，9月16日所在周为第一周，最终日期待确认。
- 约10–20cm桌面机器人，两机两遥控器对战，以击倒对方为主要玩法。先一台实验机；无膝关节的Otto V9四舵机短腿，宽脚掌。
- 已完成开题汇报，老师认可方向。当前任务是实物行走和巴掌测试，不是继续准备明天汇报。
- CB2因老师要求更新而停用，当前使用 **CyberBrick 1（CB1）**。不要再把CB2清单当实物规格。
- 巴掌版保留舵机直驱水平横扫，掌面竖直、手指横向；用户不想为本版制作减速箱。拟焊接/转接第五舵机线路，是否完成未确认。
- 拳头版红色，参考James Bruton Punchy电机齿轮连杆机构；CAD已下载，尚未适配Otto。
- NFC技能卡、场景道具和陪伴功能仅是候选。六块板规划为两机器人+两手柄+两场景/备用，面板和电池各6、双通道摇杆4是之前申请意向，不代表CB1实收数量。

## 当前完成情况
|领域|完成|未完成/未证实|
|---|---|---|
|提案|14页PPT、文案、讲稿，已汇报|不代表实物已实现|
|机械|Otto原身体腿脚已打印；75mm巴掌、51mm杆距、舵机桥和顶部框架模型已做；用户启动整套打印，照片可见蓝巴掌|最终装配/强度/扫掠空间/负载测试|
|硬件|已识别两块CB1板；**四个接口/舵机全部正常**（此前"S2舵机坏/S3无响应"均为误判）；**2026-09-23 左踝已换装180°位置舵机（PG001），四路全为位置舵机**；当日两次"零反应"均查明为插头接触不良（重插即恢复）|供电带载数值未测；S2 新舵机实物标签待复核|
|软件|六文件+milk_jog.py已上传校验；**遥控链路全通**：左摇杆=L1（静止~1959）、右摇杆=R1（~1797）、唯一按钮K4按下=0；jog摇杆直控舵机用户验证成功；REMOTE_MAPPING_VERIFIED=True；托住单步四阶段程序侧完整跑通|CALIBRATED=False；方向语义/LEFT_SIGN未定标；失联旧帧行为未实测；左摇杆反方向行程未确认|
|现场|S1=左髋、S2=左踝、S3=右髋、S4=右踝确认；**2026-09-23 四路±3°/±8°方向已全部用户当面确认**：S1+=左腿前摆、S3+=右腿后摆（镜像）、S2+=翘尖/-3°=压尖、S4+=压尖（镜像）；四路90°电气中位+舵盘重装完成；接收板boot.py已改名禁用官方自启|安全范围/trim未测；站姿/落地小步未做；单步行走未做|

## 当前板卡与程序状态
- COM7：接收板，USB序列 `58:E6:C5:A8:1B:0C`，GPIO10=0，配对索引1。
- COM8：发射板，USB序列 `58:E6:C5:A7:00:A4`，GPIO10=1，索引0；发射端索引0本身不证明配对失败。
- MicroPython 1.23.0-preview，ESP32-C3，构建2e7b6351 / 2026-03-25。重新插拔后COM号可能变化。
- 原文件备份：`05_程序与测试/板载备份_2026-09-22/COM7` 与 `COM8`，共40文件271750字节；不是整片固件备份。
- **接收板boot.py已改名为`boot_official_disabled.py`（板内保留原件）**：任何断电/硬复位后官方rc_main不再自启，板子停在REPL。恢复官方功能时改回文件名即可。发射板COM8已hard reset，官方发射程序在跑，无法再进raw REPL属正常。
- 串口会话中断/取消可能触发板子硬复位——现boot已禁用所以无害，但重插后COM号可能变化，按USB序列号重新确认。
- `CALIBRATED=False`、`REMOTE_MAPPING_VERIFIED=True`、`ATTACK_ENABLED=False`。禁止未校准就开启整机步态。
- **milk_config.py 已按2026-09-22实测改pin：left_hip=GPIO3、right_hip=GPIO1、left_ankle=GPIO2、right_ankle=GPIO0**（S1=左髋、S2=左踝、S3=右髋、S4=右踝）。物理插线已按此归位，四口四舵机全部验证能动。
- **S2上现为360°连续旋转舵机**（原误判"损坏"）：中位附近有死区，只能发中位（停转）；适合将来当巴掌横扫电机（ATTACK_MODE='continuous'）。**左踝需另购180° PG001。**
- resume模式下板上milk_config会留在sys.modules缓存，板上验证前必须`sys.modules.pop('milk_config',None)`再import。
- **实验脚本禁止写死JOINTS索引**（曾因此把S2当S3测，误判"S3无响应"），一律用接口号→索引查找，参考`test_dir_by_port.py`。
- 板载紫灯为核心板原生固件状态灯（官方无颜色文档），非我们代码驱动，不影响测试，无视。

## v02 控制框架已完成（2026-09-22深夜，纯软件，未碰实机；同夜完成验收整改第二轮）
位置：`05_程序与测试/CB1_Otto控制框架_v02/`。v01原样保留；整改+复核收尾+阶段A软件复核均未连串口/未上传/未驱动实机。
**验收整改版要点（明细见该目录《验收整改汇报_v02.md》与《台架验证计划_v02.md》，84项测试全绿，存档 output/测试结果_2026-09-22.txt）：**
- **显式使能（可执行流程，复核收尾轮修通）**：ENABLE_ON_FIRST_LINK已删除；有效帧永不自动使能；完整流程=`main_v02.run()`持续读取 → Ctrl-C暂停（**进行中步态被取消为STOPPED**、姿态保持，session存`main_v02.SESSION`；**暂停期K4/失联检测不运行，输出不被遥控保护**）→ `SESSION.enable()`（严格，需4关节已启用+位置型+已标定）→ `resume()` → 停止/失联后`SESSION.recover()` → 退出用`SESSION.release()`**关闭PWM（停止脉冲，不切断舵机电源，物理开关负责）**；分步调试用`start(link=RcLink())`+逐拍`poll()`；`resume()`只是重入循环，不等于使能/恢复；未处理异常会先释放输出再抛出。**enable/recover现场重读遥控，不用暂停前旧输入**；无活跃帧或K4按住拒绝；**使能/恢复后必须先观察到两杆回中才有迈步请求**；停止/失联/重连不自动续走。
- **五阶段重排**：主髋摆动移入unload_swing，land只落脚不摆髋；逐髋独立起点；`step_sign_left/right`、`ankle_sign`可配置。**序列未证明能平衡/行走。**
- **时间防护**：timeutil（板端ticks_diff/PC同语义30位回绕）；dt<0记0；单拍>STALL_MS(500ms)走行中→FAULT拒绝跳阶段；新步不继承等待时间。板端兼容静态检查完成（导入链无os.path/sys.path/__slots__/f-string），**板端运行待验证**。
- **执行器能力配置化**：JOINTS每关节enabled/actuator/calibrated；cb1_pwm按配置决定通道，禁用/连续旋转通道永不创建PWM（无写死关节名）；**驱动选择`create_driver(jm, cfg)`必填同一份配置，不读全局**；PC用sim_config虚拟档案隔离；**左踝换PG001只改config一条目**。
- **新鲜度诚实化**：官方帧无序号/收包时间→REMOTE['timeout_ms']=None不伪造；None帧=断链；不用摇杆值不变推断失联；停止/故障/释放统一`_clear_action()`清残留。
- 演示：`python run_demo.py` 14事件正常（跑在虚拟档案上，不掩盖真实配置缺件）。**台架脚本 `bench_v02.py`**：diag只读/monitor无PWM监测/joint托住单关节±10°/demo3缺件演示（完整时拒绝）/gait严格使能单步/remote_gait双杆流程；导入不动作、按关节名选通道、移动类需confirmed=True且拒绝sim驱动。
- 关键语义：停止=冻结姿态(STOPPED)≠松开输出(release_output才断电)；失联→FAULT，重连不自动恢复；同侧步=显式策略接口not_supported；超限拒绝不钳位。
- 文档：`README.md`、`参数说明与硬件接入清单.md`、`任务汇报_v02_2026-09-22.md`（首轮）、`验收整改汇报_v02.md`（整改轮，验收复核用）。
- **阶段B1/B2已实测通过（2026-09-23，用户在场，零舵机动作）**：接收板COM7；13文件上板哈希一致（timeutil为阶段A清单漏项、上板时补传；板上config独立副本DRIVER='cb1_pwm'）；导入/diag正常；无动作验证PWM通道空；**左右杆前推=+1.00满量程、K4识别正确；关遥控196/196采样返回None——固件不缓存旧帧，失联保护可用**。明细：v02《实测记录_阶段B_2026-09-23.md》+ v01现场调试记录2026-09-23节。
- **Otto V9腿部对中计划阶段一已交付（2026-09-23，纯资料/代码）**：`04_结构与硬件/Otto_V9腿部对中计划_v01/`（四关节中位安装图SVG、逐关节安装记录表、对中工具使用说明）+ v02 `center_joint.py`（单关节90°对中：按名选通道、一次一路、拒S2连续舵机、导入无PWM、90°=电气中位不套trim）+ 驱动新增`write_one(name, deg)`单通道接口；复核修正两处：切换关节自动关旧通道（保证一次只一路）、`seconds=N`等待被Ctrl-C/异常打断也保证关输出；`cb1_pwm.create`守卫改为检查传入cfg.DRIVER（不再读全局）。98项测试全绿。**第一批接手资料已齐**：硬件现货清单（04_结构与硬件，未核对项如实标注）、安装图人工对照核对单、阶段C现场顺序卡（均在 对中计划 目录）；六周路线图（00_项目管理/milk组_六周执行路线图_2026-09-23.md）中的过时数字已同步为98项+PWM缺口已修复。手册第5-8页为照片页无法程序化提取，渲染图存档 `01_研究参考/robot-battle-reference/manual_hi_p5..p8.png` 供人工对照；安装图几何依据=运动学+实测方向。**不声称机械校准完成。**
- **待补/未验证**：config标定值全为标称占位（B3使能须走enable_debug）；B3缺左踝动作验证（joint/demo3/使能-停止-暂停-恢复-释放）等用户可托住机器人；cb1_pwm真实PWM出脉冲未验证（B2只验证了"不产生"）；C标定/D单步/E双杆未开始；板上REPL Ctrl-C暂停交互未实测。
- 修复过程备注（首轮遗留）：simulator `_log` 重绑定列表丢日志→改`del self._pending[:]`；mapper失联/丢弃事件去重；**REMOTE['stop_button']=3是按钮组内0基偏移（from_rc内部+6），勿按v01习惯填全帧索引9**。

## 2026-09-23 四路归位完成（用户在场，含左踝换装）
- **左踝 PG001 换装 + config-only 生效验证**：v02 config.py left_ankle 改 enabled=True/actuator='position'（calibrated 仍 False），板端变体（仅 DRIVER 行不同）上传 COM7，板上 SHA256 一致（94edd6c6…）。板上 import 验证：四路 enabled+position、walk_blockers=四路 not calibrated、walking NOT ready。PC 测试同步旧"left_ankle禁用"事实断言（5处改为变体配置驱动），**98项全绿**。
- **四路电气中位 90° 全部锁定舵盘**（S2 保持12s 重装；S2 首次安装作废因 PWM 已关时误装，重来一次成功）。
- **排除两次假故障**：S2、S3 先后"零反应"，均为插头接触不良，重插即恢复（大扫动验证）。**教训：命令已发但零反应→先重插插头再怀疑舵机；每次实机测试前逐个按压检查四插头。**
- **方向观察（③用户确认，已填《逐关节安装记录表》）**：S1+=前摆、S3+=后摆（双髋镜像，与 step_sign_left=1/right=-1 吻合）；S2+=翘尖、S4+=压尖（双踝镜像）→ 单值 ankle_sign 不够用，阶段D前需把左右踝符号拆开（未改代码）。
- 未做：安全范围/trim/calibrated=True；站姿验收；B3 全流程；步态调参。

## 马上继续什么
0. **软件主线已切到 v02**；2026-09-23 四路已换齐/归位（见上文当日节）。硬件接入步骤见 v02 的《参数说明与硬件接入清单.md》。
1. **逐路测安全范围/trim**（bench_v02.joint 从 ±3° 起步逐步加大，用户观察不顶壳不顶死的角度界）→ 写入 config.py（center/trim/direction/min/max）→ 用户确认后逐路 `calibrated=True`。
2. **托住站姿 → 短时桌面落地**（阶段C关口：双脚平放、无倾斜、无顶死抖动、双向余量，照片存档）。
3. **B3 全流程验证**：enable_debug 使能 → K4 停止 → 暂停/恢复 → 释放（目前仍只能 enable_debug，因 calibrated 未全 True）。
4. **阶段D 单步调参**：先拆左右踝符号（单值 ankle_sign 不够用），再按 lean→lift→hip_swing→时间顺序一次一参数。
5. 之后：双杆连步（阶段E）→ 巴掌第五舵机。
每次动作前说明要测哪路并确认机器人受支撑；calibrated 未全 True 期间 strict enable 会拒绝，禁止绕过门禁。

## 复核问题修复（2026-09-22深夜，接在只读复核之后）
- 已修复`test_bench_step_held.py`误驱动S2问题：改为逐关节显式驱动0/1/3，GPIO2不创建任何PWM。
- 已修复K4单按钮冲突：`STOP_BUTTON=None`（专用停止取消，失联照旧解锁）；`milk_receiver`按钮通道支持None；neutral判据不再要求`not pressed`（否则按住使能键永远无法解锁）。**此改动只过了PC测试，尚未在实机验证解锁流程。**
- 测试已同步新语义并全绿：core 13项OK、receiver 4项OK（`python tests/test_core.py`、`python tests/test_receiver.py`，系统python可跑）。
- 三个文件（milk_config/milk_receiver/test_bench_step_held）已上传COM7，SHA256双端一致。
- PC测试用系统python即可（无需pytest）；serial操作必须用`05_程序与测试/serial_runtime`的venv。COM7偶发被占（并行会话或残留mpremote），稍等重试即可。

## 关键产物位置
- `04_结构与硬件/2026-09-21_整机首轮试打印包`：本轮五件各一的打印件。
- `04_结构与硬件/Otto_75mm巴掌腕部接口_v02`：最新接口CAD、STL、装配图、建模脚本。
- `04_结构与硬件/Otto_PG001顶部巴掌模块_v01`：顶部框架和舵机桥来源。
- `01_研究参考/robot-battle-reference/Otto-V9`：原版Otto，未改动原文件。
- `05_程序与测试/CB1_Otto单步实验_v01`：最新代码、测试、实机记录。
- 历史上下文已另存至 `00_项目管理/PROJECT_CONTEXT_历史_*.md`，保留旧讨论但不能据旧“下一步”覆盖本文。

## 后续只读复核补充：以最新进展为准（2026-09-22）
本轮读取了深夜更新，没有连接串口、运行舵机或上传代码。以下是本地源码复核，不是新的实机结论。
1. 当前真实断点已经前进：S1左髋/S2左踝位/S3右髋/S4右踝；S2是连续旋转舵机而非损坏。遥控jog用户验证成功，正式步态未验证。旧交接中“等待S1第二轮反馈”“boot未修改”已过时。
2. **不要直接重跑test_bench_step_held.py。** 脚本注释称S2只发中位，但循环实际调用out.pose(pose)，milk_hw.Output.pose逐个原样发送偏角，没有屏蔽左踝。因此会给S2连续旋转舵机发送非中位脉宽。应先换正确180°舵机，或修改测试明确排除S2并验证；排除S2的三关节演示不代表完整步态。中位是否真能停转仍需校准，不能凭1500us假定。
3. **正式milk_receiver.py目前无法用K4解锁。** config把ATTACK_BUTTON/ENABLE_BUTTON/STOP_BUTTON均设9：按下使能时同时stop=True且pressed=True，RemoteGate优先停止、neutral条件也要求not pressed。jog成功不等于正式接收状态机成功。需另设计单按钮状态逻辑或增加独立按钮，并测试冲突后再启用。
4. milk_config.py头部仍写左踝FAULTY，已被最新实物识别推翻，后续改代码时同步清理此过时注释。
5. 17项测试通过属于旧配置历史结果；当前REMOTE_MAPPING_VERIFIED=True后旧测试test_default_config_no_activation断言False不再适配。没有在本轮重跑，不声称最新修改仍全部通过。
下一步优先处理上述两项源码与说明矛盾，然后在180°左踝就位、方向与中位确认后做完整步态。不要按旧文直接绕过CALIBRATED门禁。

## 2026-09-23 六周执行路线图
已保存 `00_项目管理/milk组_六周执行路线图_2026-09-23.md`，作为当前从对中、单步、双杆、巴掌、第二台到试玩和最终展示的主计划。路线图用阶段验收关口推进，NFC为可选扩展；不把PC测试当作行走成功。下一可独立执行项是修复center_joint的跨通道PWM残留与定时中断清理、核对安装示意与实物、整理实收硬件清单。路线图创建时95项PC测试通过，B1/B2板端无动作验收通过；B3及机械对中仍待现场。
