paomodabaibai/CyberBrick2-User-Research-UX/00_项目管理/2026-10-22_GitHub双向同步记录.md

# GitHub双向同步记录 2026年10月22日

- 同伴更新来自codex/ground-wall-arena分支32a21800，包含PPT与80×120cm场景资料。
- 本地统一控制代码已先独立提交，随后合并场景分支，PROJECT_CONTEXT中的冲突保留双方段落。
- 本地新增球靶、打印包、调试记录、汇报文案和当天素材已纳入同步；未上传本地运行环境、依赖包与同步备份。
- 90度安装工具采用仓库中支持新电脑自动发现mpremote的版本，未被旧的固定路径版覆盖。
- 控制代码199项PC回归通过；本次同步不连接或驱动机器人。
- MP4与MP3使用Git LFS，保留原件；当天照片等原文件名保留。
- 当天素材的SHA256清单与继续制作入口位于10.22最终汇报素材。
- 本地目录的覆盖更新前制作可恢复副本；照片、视频、录音不移动、不删除。
- 最终提交号和远端核验结果以本次会话的完成记录及Git历史为准。
