paomodabaibai/CyberBrick2-User-Research-UX/10.22最终汇报素材/先看这里_汇报与短视频素材.md

# 10月22日最终汇报素材入口

本目录集中保存当天原始照片、现场视频与汇报录音，不改动原文件名。

## 当前收录
- 原始照片：35张。
- 视频：5段（包含原文件名标注raw的版本，不能仅按名字认定重复）。
- 汇报录音：1段。
- 同伴PPT与场景：已复制《milk ARENA 产品发布会》PPT与场景插图到同名子目录。
- 项目问题总结与配图：发组员ZIP包含Word、文字稿和10张配图。

## 后续短视频
尚未剪辑、未转写录音，也未给未看过的视频编造内容标签。下一步先听汇报、看现场素材，再确定短视频主题与时长。AI生成的儿童试玩图和电影感场景图仅作为设计表达，不能当成真实试玩记录。

## 换电脑继续
先安装Git LFS，再克隆仓库，执行git lfs pull获取完整视频和录音。GitHub网页上的小型指针文件不是视频原件。原始素材清单_SHA256.json可用于核对完整性。

## 其他入口
- 场景原始模型与打印资料：../06_游戏设计/贴图地图模型_80x120cm_v11/。
- PPT后半段制作记录：../02_汇报/2026-10-21_后半段优化/。
- 程序与现场记录：../05_程序与测试/CB1_Otto控制框架_v02/。

汇总日期：2026年10月22日。
