paomodabaibai/CyberBrick2-User-Research-UX/00_项目管理/PROJECT_CONTEXT_历史_20260922_192211.md

# milk 组｜桌面机器人对战项目

本项目后续工作目录：`E:\课程作业\大三上\张茫 用户研究与体验设计`。
用户于 2026-09-16 指定。之后新资料、汇报、模型改件与代码均优先保存到此处。

## 已知与已完成

- 团队名称：milk 组，第 2 组。成员：傅宬博（本）、白昊灵（本）、孔舒然（本）、罗圣希（研）。具体分工待讨论。
- 课程：用户研究与体验设计。
- 汇报：2026-09-17（周四）08:30，B413。老师未规定页数与时长，按约 10 分钟准备。
- 课程周期：约六周，2026-09-16 所在周为第一周；最终交付日未精确确认。
- 用户提供的登记方向文字：战斗机器人／桌面实体陪伴机器人。当前具体提案仍围绕既有双足对战方向，陪伴功能未确认为首版要求。
- 沟通群应命名为“CB2-第2组”；建群及邀请老师由组员执行，完成情况待确认。
- 项目方向：多人遥控双足机器人对战，通过攻击模块将对方击倒获胜。
- 机器人尺寸方向：约 10–20 厘米高；小短腿、少零件。用户喜欢 Otto 外观。
- 攻击模块：用户希望巴掌和拳头两款都保留，先开发巴掌款概念图。最新结构决定见下方交接更新。
- 2026-09-16 已用内置 imagegen 生成首张奶白＋蓝色巴掌款外观概念图，保存于 `03_视觉素材/milk_slap_blue_concept_v01.png`；仅表达造型，关节、驱动与重心尚未验证。
- 硬件：2026-09-16 晚小组讨论决定 CB1、CB2 或其他组件，尚未定案或确认采购。
- 已研究 Otto、CUBY、Zowi、Otto Humanoid、Boxing Santa，已保存基础代码与部分原始模型。
- 原始资料由旧工作区复制至 `01_研究参考/robot-battle-reference`，旧副本保留。
- 已下载的 Otto CAD/STL 是历史 V9 版本；不是已适配 CyberBrick 的整机。代码、打印件、负重行走、遥控和对战均未完成实机验证。

## 提案中使用的工作假设

- 首版先做两台机器人、两个遥控器的一对一对战；多人轮换及多机同场作为后续讨论项。
- 默认以四舵机短腿结构评估，每台先做一个攻击模块。
- 目标用户暂拟为校园朋友聚会、课间或社团活动中的同龄人；这是待调研假设，不是用户已确认的研究结论。
- 初版采用人工判定倒地、人工扶正，不默认加入自动起身和姿态传感器。

## 工作原则

- 明确区分：已经确认、设计候选、工程假设、需要实测。
- 概念图标注“概念效果图”，不得暗示已有实物或已验证内部结构。
- 不把 CB1 的接口或供电规格套用到尚未确认的 CB2。
- 老师公告中的建群与邀请是小组待办，不代表已授权向老师发送消息或添加联系人。
- 根目录已有 PDF 为用户原文件，本轮未读取或更改。

## 目录

- `00_项目管理`：决策、会议记录、分工。
- `01_研究参考`：原模型、原代码、参考链接。
- `02_汇报/2026-09-17_项目提案`：本次汇报策划、PPT 与讲稿。
- `03_视觉素材`：概念图、品牌图形、参考图。
- `04_结构与硬件`：硬件清单、尺寸、CAD、试装。
- `05_程序与测试`：遥控、步态、测试记录。

## 最新决定与 Agent 交接（2026-09-16，优先于旧方案）

用户明确选定：
1. 腿部保持 Otto 四舵机短腿、无膝关节、宽脚掌；不要改成轮式或复杂人形腿。
2. 巴掌款用奶白＋蓝色，直接把轻质手掌和短横臂接到电机/舵机输出上，绕竖直轴在水平面左右挥动。掌面竖直、手指横向，参照用户图一；不是掌面朝下拍桌子。放弃以凸轮、弹簧蓄力和复杂连杆为首版方案。电机还是位置舵机及其型号尚未确认，优先验证可控往复摆动。
3. 拳头款用奶白＋红色，采用用户图二 Punchy 的电机—齿轮—连杆往复出拳结构作为设计基准。保留可识别的连杆架构，不改成随意伸缩杆；只借鉴上部攻击机构，底盘仍为 Otto 双足。用户认可结构不代表已完成缩小、承重和装配验证。
4. 两款都要有，初版拟两机两遥控器；每机一个攻击模块。是否做快拆互换尚未确认，不得声称已经有统一快拆接口。

### 当前最紧急的交付顺序

A. 先保证本文和参考图落盘，便于额度不足时其他 Agent 接手。
B. 保存可复制的生图提示词，优先整体双机、蓝色巴掌、红色拳头、内部布局及动作示意；不必花额度立即生图。
C. 保存约 10 分钟的逐页 PPT 结构、可直接粘贴文案、口头讲稿和硬件需求清单。
D. 如资源允许，生成可编辑 PPT 初稿。当前为开题提案，不能包装成已制成的实物成果。

### 参考与文件

- 用户图一与图二保存在 `03_视觉素材/用户确认参考/`。图一是动作方向参考的游戏画面，不是工程图；图二是 Punchy 结构参考。
- Punchy CAD：`01_研究参考/攻击模块/Punchy/Punchy.stp`；原作者仓库 https://github.com/XRobots/Punchy ，视频 https://www.youtube.com/watch?v=XNV1myy1sbA 。已检查压缩包，未做 CAD 装配验证。
- 旧概念图 `03_视觉素材/milk_slap_blue_concept_v01.png`：用户只认可颜色，明确否定结构，不可拿来作最终结构示意。
- `01_研究参考/攻击模块/攻击模块资料索引.md` 中建议采用曲柄摇杆巴掌、蜗形凸轮的内容已被本次用户决定取代，只作为调研历史。

### 尚待确认，不阻塞汇报草稿

CB1/CB2 或其他控制器型号；舵机/电机规格和供电；拳击模块驱动数量及尺寸；预算；成员分工；最终展示准确日期。按六周安排，硬件以两机方案估算并清楚标注待核实。
目标用户和玩法细则可提出工作假设，但不能伪称已做访谈。陪伴功能、自动起身、自动判负、多机混战不列入首版承诺。

## 本轮交付已完成（2026-09-16）

1. `03_视觉素材/生图提示词_用户确认结构版.md`：六组中文提示词，含参考图使用方法、结构约束与出图检查。尚未调用生图；用户希望节省额度。
2. `02_汇报/2026-09-17_项目提案/PPT结构与逐页文案_含讲稿.md`：14 页、约 580 秒，包含上屏文字、讲稿、硬件估算、六周计划。
3. `02_汇报/2026-09-17_项目提案/交付/milk组_桌面双足机器人对战_提案初稿.pptx`：可编辑演示稿，内含用户两张参考图、3 张原生表格与14页演讲者备注。奶白底、蓝红配色，未加入不准确的旧概念图。逐页检查渲染，结构与排版检查通过；未在本机 PowerPoint 内打开测试。
4. `02_汇报/2026-09-17_项目提案/PPT内容数据.json`：用于保持文案与 PPT 同步的数据。`.build/build.mjs` 是构建来源，后续如重建应换一个最终输出文件名避免覆盖。

后续优先：小组确认板型、驱动规格、预算和分工 → 按提示词生成并检查蓝色巴掌和红色拳头图 → 替换/补充 PPT 中相关页面。暂不重新研究或改回复杂巴掌机构。

## 2026-09-17：汇报后更新（最新）

- 用户已完成汇报，方向获认可。
- 确认使用 CyberBrick2 套件，本周先做蓝色直驱巴掌机器人的 Demo；可能需要改 Otto 模型以适配实际舵机、主板和电池。
- 已完成本机 CyberBrick 安装资源与 MCP 只读研究，报告在 `01_研究参考/CyberBrick2软件研究/研究结论与Demo建议.md`。
- 软件内置分版本 API 文档、系统提示词、模块定义、接线配置、模板和工具；MCP 已连通，只读取工具与技能目录，未上传程序或操作硬件。
- 实物固件/接线/尺寸尚未确认。发现的 00.00.10.76 API 只是研究样本，不能直接当目标固件。下一步先确认实物，再做单独巴掌动作样机和遥控，最后接入 Otto 腿部。

## 2026-09-17：周末范围再次收敛（覆盖上一条 Demo 建议）

- 用户明确本周末仅做一个 Otto 四舵机脚步行走模块，不把巴掌样机列为本周目标。
- 用户希望规划六块主板；其分配待确认。暂按两机器人＋两手柄＋一个场景/裁判节点＋一个备用/开发节点编制条件清单。
- 卡牌 NFC 技能、脚底/场景感知与桌游玩法仅为“可能”扩展，不能视为确定交付。
- 已新增 `04_结构与硬件/CB2_Otto可行性与硬件清单_含卡牌场景预留.md`，区分周末最低物料、完整两机总量、NFC 待验证与冗余。
- 支持继续推进四舵机方案，但机械尺寸/扭矩/电源/固件尚未确认；没有完成实机验证或模型改件。模型可协助局部重建和参数化适配，需要实际舵机尺寸或厂家 CAD。
- “超功率”在设计中解释为已验证额定范围内的短时提速/冷却变化，不作为超压超流操作。NFC 未在 CB2 专属文档中找到原生接口，先样品验证再扩购。

- 用户随后确认六板分配：两台机器人＋两个手柄＋两个场景/备用节点。用户有舵机图片，将提供；具体尺寸仍待确认。

## 2026-09-17：收到用户物料表

原图及逐项转录保存于 `04_结构与硬件/CB2物料表转录与需求对照_2026-09-17.md`。关键料号：CB001 Octo主控板、CB010用户交互面板、CB204双通道摇杆带按键、CB301电池、CB302舵机、CB303直流电机。表内各电子模块标称1个，实际领取数量未知。NFC未列入。CB010不能自行认定为扩展板；CB302尺寸/电气参数仍未知。CB403有白标专用线；CB405扬声器PCBA可能错标CB403。申请主板六块不等于六整套套件。

## 2026-09-17：硬件增补申请

用户确认目前只有一套物料表中的套件。已据此生成 `04_结构与硬件/milk组_CB2硬件增补申请表_2026-09-17.md`，区分已有、目标与增补。六板方案增补主板5；舵机总11增补10，其中周末优先4已包含在内。NFC仅申请验证样品，不视为确定功能；CB010用途与供电附件仍需套件方确认。

## 最新申请原则：一次性申请

用户要求CB001主控板、CB010面板开关（按物料表名称用户交互面板）、CB301电池总量各6，已有各1，增补各5。只申请一次，尽量覆盖候选卡牌/场景、备用及线缆附件。当前只有1块主控，主从机尚未测试。最新申请表为 `04_结构与硬件/milk组_CB2硬件增补申请表_一次性申请版.md`，取代之前分阶段申请版本；项目实施仍分阶段，NFC仍待兼容性验证，不能视为已确认功能。

- 最新用户确认：CB204双通道摇杆总量4个，已有1个，增补3个；其他一次性申请数量不变。先制作一台机器人的四舵机行走模块，不同时推进双机及卡牌。

## 最新重大变更：改用第一代CyberBrick

用户通知老师要求停用CB2，改为CB1；老师将发实际清单。此前CB2申请表暂停作为现行申请使用，已有CB2库存不能抵扣CB1需求。周末目标仍为一套Otto四舵机行走。已查官方一代资料并下载PG001/PG002规格及官方硬件CAD，见 `01_研究参考/CyberBrick1迁移研究/CB1迁移结论与需求底稿.md`。关键：XA003核心＋XA004接收底板，四路舵机占满后第五巴掌舵机需要额外方案；PG001位置舵机用于腿，PG002连续旋转不能替代；CB2 SDK/MCP不直接适用ESP32-C3一代。老师清单尚未到，不编造增补数量。

## 2026-09-19打印前核对

用户希望尽快打印Otto腿部。已查SG90原厂尺寸、PG001图纸，并解析本地Otto V9 STL。主要腿壳内壁间距13mm，但局部结构及舵盘/轴心尚未完整干涉验证。建议100%比例先打一腿一脚试装；不能宣称PG001已完全兼容免改。记录见 `04_结构与硬件/PG001与OttoV9_打印前尺寸核对.md`。

## 2026-09-21：CB1自定义串口开发路线
用户分享老师非官方GPIO开发演示，拟不用官方图形化功能。已核对官方源码：舵机GPIO3/2/1/0；LED GPIO21/20；电机控制GPIO4/5/6/7（经驱动，不当裸GPIO使用）。可以开发MicroPython应用并上传板载文件系统，不等于必须重刷固件。本次无串口操作或程序上传。第五舵机可研究复用灯信号GPIO，但供电、电路、PWM资源和固件仍需验证，尚未确认可用。发射底板官方为6ADC＋4数字输入，不保证接口随意改作输出。外设不可仅凭pin数判断兼容；NFC仍需选型验证。详细记录：05_程序与测试/CB1串口自定义开发路线_2026-09-21.md。当前目标仍是单台Otto四舵机行走，机械试装计划不变。

## 最新讨论：Otto顶部攻击模块
用户确认保留CB1自定义开发路线，开始讨论在现有Otto腿和身体上增加攻击模块。希望协助CAD建模或寻找现成开源结构，同时确定舵机/电机选型、驱动器固定和连接方式。目前仍沿用先前简单水平扫掌方向；具体尺寸、动力型号、顶部接口尚未定案，未开始改模型。

## 2026-09-21：顶部巴掌机械试装版已建模
用户确认已打印Otto V9原版身体和脚、未打印头壳；授权直接开始建模，明确可以在身体上钻孔加螺钉。已生成04_结构与硬件/Otto_PG001顶部巴掌模块_v01，含6个STL及STEP（两量规、外套安装框、可拆舵机桥、舵盘连接横臂、小巴掌）、装配STEP、预览、说明和CadQuery源文件。实际读取PG001厂家CAD并核对轴心偏置5.34mm及原配单边舵盘孔位。网格闭合与名义几何干涉检查通过，尚未实物验证或完整动态仿真。主板电池未定，采用上方开放支架。先打印01/02量规，不直接当已验证对战件。舵盘小自攻螺钉需核对库存，切勿硬用M2。用户尚未提供内部布置照片。独立CAD运行环境cad_runtime已建立，勿打包该运行环境给用户。

## 巴掌外观修改：Tripo独立生成
用户认可v01整体机械结构，但不接受简化薄片巴掌。要求单独巴掌参考图用于Tripo：饱满、塑料感、米奇式卡通手套、扇巴掌姿势。已通过内置imagegen生成白色圆润横向展开手掌，保存03_视觉素材/巴掌_Tripo参考_v01/白色卡通巴掌_v01.png，同目录保存完整提示词。尚未生成或替换三维巴掌；后续接收Tripo网格再按尺寸/质量/腕部连接适配，保留已有支架。

## Tripo巴掌网格已接收，提供自主尺寸调整
用户文件Downloads/thumbs+up+hand+3d+model.stl，已复制到04_结构与硬件/巴掌_Tripo网格与尺寸调整/巴掌_Tripo原始.stl。原单位包络约1×0.397×0.740。主体闭合420590面，17个极小零散组件；尺寸输出仅保留主体。已生成最长边50mm参考掌（约50×19.86×37mm），尚无腕部安装接口。新增双击调整尺寸.cmd，可输入掌最长边和杆距，自主生成STL/杆STEP；杆距定义为轴心到末端两孔中点，默认37.5mm，总杆长=杆距+12.5mm，孔位标准/孔径不缩放。尚未把新手掌机械连接到杆上，需尺寸确定后设计接口。详细说明同目录如何调整尺寸.md。

## 整机比例可视化
用户需要看到整机关系后再决定掌尺寸和杆长。已将Otto V9原身体、镜像双腿双脚、v01框架及PG001与Tripo手掌组合，生成同尺度三方案图片04_结构与硬件/巴掌_Tripo网格与尺寸调整/整机比例三方案.png。另在本任务可视化目录生成otto-palm-proportions.html，支持手掌30～75mm、杆距25～65mm实时调整、拖动旋转及正侧视角。渲染使用简化网格，不改打印文件；腕部按示意位置对齐，尚无正式接口。交互检查通过，尺寸更新与视角切换无JS错误，360px无溢出。静态示例A=40/27.5，B=50/37.5，C=60/47.5（掌最长边/杆距，mm），不代表结构承载已验证。

## 用户确认攻击模块比例
用户通过整机比例预览明确选择：手掌最长边75mm；舵机轴心到连接杆末端孔组中心51mm。对应杆总长63.5mm，宽10mm、厚3mm，安装孔尺寸保持不变。已生成04_结构与硬件/巴掌_Tripo网格与尺寸调整/输出_手掌75mm_杆距51mm，手掌外包络约75×29.78×55.50mm，主体闭合。该目录手掌仍无腕部安装接口，不是可直接装配的终版。下一步按此确认比例设计腕部连接，不再次要求用户选尺寸；注意保留预览中的相对位置。PG001负载、重量和挥掌稳定性尚未验证。

## 2026-09-21：75mm巴掌腕部接口v02已完成机械试装模型
用户授权后，已生成04_结构与硬件/Otto_75mm巴掌腕部接口_v02。保持手掌最长边75mm和杆距51mm（总杆长63.5）。方案为23×12×6mm插入连接块：两颗M2×8从杆下方固定，块顶面捕获两M2普通螺母；掌腕内有矩形盲槽（每侧0.25间隙），一颗M2×25横穿腕部和块，另一侧六角槽捕获第三颗M2螺母。根部螺钉头有避让槽；务必用8mm根部螺钉而不是10mm，以免插拔卡住。手掌相对姿态沿用比例预览。生成5个闭合STL（腕部小样、连接块、杆末端小样、完整手掌、完整杆），3个结构STEP，GLB与真实网格渲染预览。静态重叠、离散拔出位置与螺钉包络检查通过，尚无实机/打印/载荷验证。下一步用户先打印01/02/03三小样试装，反馈紧松、螺母配合和锁紧晃动后再打印完整手掌。不覆盖原Tripo或v01。详见先读我_试装与打印.md与几何验证报告.json。

## 用户决定直接打印整套第一轮样件
用户明确希望今天的完整巴掌和顶部舵机架一并先打印。已整理04_结构与硬件/2026-09-21_整机首轮试打印包，含5件各1：v01身体安装框/舵机桥，v02杆距51mm完整杆/连接块/75mm带接口完整掌；排除旧杆、旧薄片掌和重复量规小样。新清单覆盖之前先小样的打印顺序，不再要求用户先过小样才能打印。五STL重新读取闭合、尺寸核验，未做机型专用切片或打印。附摆放、支撑与导入为独立物体说明。原身体腿脚不重印。

## 2026-09-22第五舵机问题再次核查
用户发现四腿占满四舵机插口，要求搜解决方案。新增官方证据：buzzer.py确实在GPIO21/20使用machine.PWM，ESP32-C3官方6路LEDC。优先研究LED信号通道改第五路舵机，不宣称即插即用；需核对实物线序、信号路径、电平、PWM资源和电源，尤其不能默认灯电源承受舵机电流。PCA9685或第二接收板为备选。已保存05_程序与测试/CB1第五舵机扩展核查_2026-09-22.md；尚未实机测试或上传程序。

## 2026-09-22：单步实验程序 v01
用户决定巴掌继续使用舵机，暂不装电机减速箱；已找到两包LA016 1:48减速齿轮，留待后续，拳头计划电机驱动。
已准备 05_程序与测试/CB1_Otto单步实验_v01。6个板端MicroPython文件、串口校准工具、官方rc_module遥控接收、Otto步态拆解、上传说明、源码快照/许可证及17项主机测试。17项通过、语法检查通过，未连接串口或上传。
实际需求是左杆触发左脚完整一步，右杆触发右脚完整一步，四舵机协调。v01借鉴Otto的髋踝相位协调，改为四阶段小幅插值；不是已验证的Otto原版移植。首步任选，之后限定左右交替，重复同侧明确拒绝，后续需实机扩展。
默认CALIBRATED/REMOTE_MAPPING_VERIFIED/ATTACK_ENABLED全False。先备份固件文件、停用原控制循环，再读取遥控元组、校准各关节中位/方向/限位，最后尝试步态。保留现有发射端固件。无线失联需要实测rc_slave_data是否返回None；缓存值问题不可用静止值推断。
停止锁存保持当前腿指令，退出则释放PWM；需要人工支撑，不能承诺自动站稳。巴掌位置/连续旋转型号尚待确认，第五路电源与接线未验证。
