paomodabaibai/CyberBrick2-User-Research-UX/00_项目管理/继续任务_历史_20260922_192211.md

# 给接手 Agent

先读取根目录 `PROJECT_CONTEXT.md`，它记录用户决定、未决问题和全部交付位置。最新决定优先于旧资料。

项目工作目录：E:\课程作业\大三上\张茫 用户研究与体验设计

已完成交接说明、参考图保存、六组生图提示词、14 页文案与讲稿、可编辑 PPT 初稿。请不要从头重做研究，也不要把巴掌改回凸轮或复杂连杆。蓝巴掌直驱横扫，红拳头 Punchy 连杆，统一 Otto 四舵机双足。

用户担心额度，优先复用已有材料。下一步按用户指示生成概念图或根据今晚的小组讨论修订硬件。文案中的两机数量、用户画像与玩法细则有工作假设，不得伪称已完成用户测试。硬件型号尚未定。
