paomodabaibai/CyberBrick2-User-Research-UX/03_视觉素材/生图提示词_用户确认结构版.md

# milk 组｜可复制的生图提示词

当前版本：2026-09-16 用户确认结构版。先生成第 1、2、3 张即可；其余按汇报需要补充。不要一次性让模型生成很多视角，先确定单款结构，再以成功图片作为后续参考。

## 使用前上传的参考

- 图一：`用户确认参考/图一_巴掌横向直驱_动作参考.jpg`。只借鉴掌面、短臂和竖直旋转轴的关系，不复制游戏舞台和角色。
- 图二：`用户确认参考/图二_Punchy拳击连杆_结构参考.png`。拳击机构的最高优先级结构参考，不保留原来的车轮底盘。
- Otto 腿部：从 `01_研究参考/robot-battle-reference` 中选择原始 Otto 模型截图，最好有正面和侧面。如未提供准确参考，不能保证生成的腿部与 Otto 一致。
- 旧 `milk_slap_blue_concept_v01.png` 仅作为颜色和材质参考。它的结构曾被用户否定，不要照抄。

## 全套一致性要求（每条提示词均可追加）

10–20 厘米高的桌面玩具机器人。奶白色圆角主体，轻巧、亲切、有一点笨拙的幽默感；蓝色巴掌款和红色拳头款属于同一产品家族。Otto 四舵机双足：两条独立短腿、两个宽大的平底脚掌、无膝关节、无轮子；髋部和踝部结构以 Otto 原始模型为准。3D 打印塑料质感，攻击接触面为柔软材料。主板和电池隐藏在主体内部，不凭空增加屏幕、摄像头、自动起身机构或灯效。白色或奶白背景，柔和摄影棚灯光，适合 16:9 汇报 PPT，不生成文字、标签或水印。产品概念效果图，不伪装成已经制成的实物。

## 01｜双机主视觉（用于封面/项目概览）

生成一张 16:9 工业设计产品概念效果图，展示 milk 组的两款桌面双足对战机器人。画面左侧留出约三分之一干净奶白空间用于后期排版，右侧两台机器人呈三分之四视角，彼此略微朝向。两台都是约 15 厘米高的 Otto 风格四舵机短腿机器人，圆角奶白身体、无膝关节、两只独立宽脚掌，绝对没有车轮。蓝色款：头顶一根很短的竖直输出轴，短横臂从轴伸向侧面，末端蓝色软质巴掌的掌面竖直、手指水平朝侧面，像参考图一；整个短臂和巴掌绕竖直轴水平扫动，不是举手，也不是向下拍桌子。红色款：顶部安装参考图二 Punchy 的紧凑齿轮与多连杆往复拳击机构，保留可辨认的上下连杆、铰接支点、后部齿轮和前端红色拳头；只移植上部机构到双足本体，不保留车轮。两款的模块都必须有明确的底座与机身连接，体积控制在适合小机器人承载的概念比例。姿态轻松而有对抗感，真实的塑料与软质接触面，不添加爆炸、尖刺、盔甲或武器。高质量产品渲染，无文字，无水印。

## 02｜蓝色巴掌款：看清直接驱动关系

生成 4:3 单体产品设计图。参考图一仅用于动作和连接关系。主体为奶白色 Otto 四舵机短腿机器人，蓝色脚部点缀，两个宽脚掌、两条短腿，无膝盖、无轮子。机身顶部中央固定一个紧凑驱动座，竖直输出轴露出很短一段，轴上牢固连接短横臂，横臂末端连接蓝色柔软巴掌的手腕。巴掌掌面竖直，手指向水平方向伸展，掌面迎着横扫方向；手掌不竖举、不平放朝下。采用三分之四俯视角，使驱动座、短横臂、手腕连接及手掌厚度清晰可见。采用直接驱动，不出现凸轮、蓄力弹簧、齿轮箱外露或复杂四连杆。手掌轻薄且尺寸克制，短臂避免过长。奶白背景、柔和阴影、产品设计摄影风格、无文字。这是概念图，具体舵机外壳尺寸不虚构为某个已确定型号。

## 03｜红色拳头款：严格保留 Punchy 结构逻辑

生成 4:3 红色拳头机器人产品概念效果图。以图二为攻击机构的最高优先级结构参考：保留后部驱动齿轮、上下连杆、可见转轴和前端拳头的相对关系，表现连杆带动拳头向前伸出和回收，不把它简化成套筒伸缩杆、弹簧拳头或人形机械手臂。下半身必须替换成奶白主体加 Otto 四舵机短腿，两个宽大平底脚掌，无膝关节、无车轮。顶部拳击模块使用红色外壳、深灰连杆和柔软红色拳头，与身体通过清晰的安装底座连接。取侧前方三分之四视角，拳头处于半伸出状态，清晰展示机构，所有杆件都连接到明确支点，不出现悬浮零件、穿模或无端连接。模型总体为 10–20 厘米级桌面玩具的设计方向，白色背景、柔和灯光、无文字无水印。忠于参考机构，不臆造隐藏传动细节。

## 04｜内部布局与拆解：先蓝色款，避免假工程图

以上一张通过确认的蓝色巴掌机器人为唯一外观参考，生成 16:9 工业设计内部布局概念图。左侧完整机器人，右侧同一机器人有限拆解，颜色和零件形状一致。只分解以下组件：蓝色软巴掌加短横臂、顶部竖直轴驱动组件、奶白上壳、内部控制板占位、电池占位、承力下壳、Otto 原结构两条短腿与两个宽脚掌。主板与电池用无品牌通用占位表示，靠近身体中心布局，电池尽量低置；不得声称已经适配具体 CyberBrick 板型。四个行走舵机按 Otto 参考正确布置，顶部攻击驱动独立于四个腿部舵机。展示承力底座和预留走线空间，不虚构复杂传动、PCB 电路或精确螺丝孔。拆解对象只做有限距离分离，保持装配关系可读，不为视觉效果拉出大量小零件。奶白背景，无文字和尺寸标注。此图仅说明布局意向，不能当作生产装配图。

## 05｜动作分镜（若生图不稳定，改用真实原型照片）

使用已经确认的机器人图片保持形状和颜色一致，生成 16:9 三格连续动作图，只展示同一台蓝色巴掌机器人：待机、水平挥掌、回到待机。固定机位、相同比例、相同身体与脚部姿态，唯一区别为顶部短横臂绕竖直轴的角度；掌面始终竖直、手指始终横向，不能改成上下拍击。柔软手掌和连接方式完全一致，白色背景、留白均匀，无文字、无夸张速度线、无爆炸。后期自行加动作名称和箭头，图像只表达运动意图，不代表轨迹计算结果。

## 06｜使用场景（用于目标用户与体验）

生成 16:9 场景概念图。大学生活动室内，两位大学生坐在桌子两侧，各持一个简单实体遥控器，专注又轻松地操作桌面上的两台小机器人。机器人外观严格沿用已确认的蓝色巴掌款与红色拳头款，奶白身体、Otto 短腿、无轮子，约 15 厘米高，与手、遥控器和桌面比例合理。桌上有简洁可见的对战边界，旁边一位朋友观看。正在靠近和试探的瞬间，不表现飞散碎片、真人挨打或剧烈碰撞。不复制参考图中的游戏人物和舞台。自然室内光，主体清楚，背景适度虚化，不生成品牌文字或水印。

## 通用反向约束

不要轮子、履带、复杂膝关节、长腿、悬浮手掌、多余手臂、拳头套筒、凭空增加的弹簧凸轮、巴掌朝下、手指朝上、夸张大手、锐利接触面、穿模连杆、精确伪造尺寸、品牌主板标识或未经验证的电路图。

## 出图后检查

1. 先检查两足、四舵机结构逻辑和攻击连接，再看配色。
2. 巴掌：竖直轴、水平扫动、掌面竖直、手指横向。
3. 拳头：与图二逐项核对齿轮、连杆、支点，不接受只保留红拳头外形的图。
4. 汇报中标“概念效果图”；内部布局图标“布局示意，待实测”。
5. 如需准确工程结构图，应先用真实 STEP/CAD 做模型截面或拆解截图，生图不能证明结构可装配。
