paomodabaibai/CyberBrick2-User-Research-UX/04_结构与硬件/milk组_CB2硬件增补申请表_2026-09-17.md

# milk组｜CyberBrick二期硬件增补申请表

申请小组：第2组 milk组  
成员：傅宬博、白昊灵、孔舒然、罗圣希  
项目：桌面双足机器人对战  
日期：2026年9月17日

## 申请说明

目前小组已有一套《CyberBrick二期硬件清单》所列套件。本周末计划先完成一台Otto结构的四舵机双足行走Demo；后续制作两台机器人、两个遥控手柄，并预留两个场景/备用节点，共需六块主控板。卡牌技能和场景道具为候选扩展，先申请少量验证器件，不按已确定功能批量申请。

以下已有数量按一套原始清单核算，实际领取时复核。各阶段数量为累计总量，不重复相加。

## 一、、完整项目增补申请（含上面的周末数量）

|序号|型号/物料|已有数量|项目目标总量|本次增补数量|用途与数量依据|
|-|-|-:|-:|-:|-|
|1|CB001 Octo主控板|1块|6块|**5块**|两机器人＋两手柄＋两个场景/备用节点|
|2|CB302 舵机|1个|11个|**10个**|行走8＋巴掌1＋备用2；其中4个优先用于周末，后续再补6个|
|3|CB301 电池|1个|6个|**5个**|4个移动节点＋2个场景/替换备用；无需同时启用6个节点|
|4|CB204 双通道摇杆带按键|1个|2个|**1个**|两个手柄各1个，内置按键参与功能分配|
|5|CB201 按键|1个|4个|**3个**|每手柄额外2个，预留攻击、确认或技能功能|
|6|5pin通用线缆，两端公头，15cm|2根|10根|**8根**|两机器人与手柄布线、关节活动余量及备用；长度为申请预留|
|7|5pin通用线缆，两端公头，30cm|2根|6根|**4根**|场景节点、调试与较长走线备用|
|8|AA100 BT2.5×6螺丝，20枚/包|1包|3包|**2包**|两机器人、两手柄及安装试片；最终适用孔位需核对|

说明：六块主控板不等于六套完整套件。上述CB302共增补10个，已包含周末优先申请的4个，不能再额外叠加。电池增加到6个包含场景与替换余量；如场景固定供电且不需替换电池，可将总量调整为4个、增补3个。

线缆总量是布线预留，不代表已经完成接口逐路核算。原套件8cm线缆标称11根继续复用，不额外增补；其中白标独立包装的CB403专用线应单独辨认，不计为任意模块通用备用线。请提供与CB302等模块实际兼容的原配线缆及正确线序，不用通用杜邦线替代。

## 三、请套件方确认并按需配套

|物料/资料|申请内容|原因|
|-|-|-|
|主控扩展、互连与供电组件|核实每个独立节点必需组件，补足六节点方案缺少的部分|现有表未单列扩展板；不能把CB010用户交互面板等同于扩展板|
|CB010 用户交互面板|先提供功能/接口说明；若每块主控必配，已有1个则增补5个；若仅为选配交互件，暂不增补|避免重复申请不必要组件|
|舵盘、中心螺钉及专用安装件|按11个舵机配齐，原配已含则不另算|改装Otto腿部需要可靠的舵盘连接|
|电池充电与供电附件|确认CB301充电方式，补足所需配件|原表未列充电器；不得假定任意USB电源可带多舵机|
|CB302规格及机械CAD|外形/孔位/轴心/舵盘尺寸、重量、额定电压、扭矩、速度、电流|用于Otto模型适配及供电核算|
|CB001/CB301规格|端口及接头定义、持续/峰值供电能力、四至五舵机带载建议|验证双足行走与后续攻击模块的可行性|

## 四、候选扩展：仅申请验证样品

|物料|已有|本次申请|后续扩展参考|备注|
|-|-:|-:|-|-|
|与CB2兼容的NFC读卡模块|0|**1个样品**|验证通过后，最多再补4个，形成4用＋1备|优先官方支持型号并附接线/驱动；不预设第三方模块即插即用|
|匹配的无源NFC卡片|0|**5张**|玩法确定后可增至20张|用于技能ID、刷卡与重复触发验证|
|匹配的小型无源NFC标签|0|**5枚**|场景确定后可增至10–20枚|用于机器人脚底或道具点，按天线与读距实测|

优先探索“手柄读技能卡、场景读机器人脚底标签”，减少腿部重量。若改为机器人主动读取地面标签，读卡器位置和数量需重新核对，两种方案不重复采购。已有CB103磁力传感器与CA001磁铁可用于简易触发验证，但不能替代不同NFC卡的身份识别。

## 五、已有物料先复用，暂不增补

* CB303直流电机：已有1个，先用于拳击机构验证；传动、减速与驱动匹配后再决定补件。
* CB101距离、CB102光线、CB103磁力、CB202旋钮、CB203编码器、CB205不回中摇杆、CB206微动开关：各已有1个，先用于实验或场景验证。
* CB401/CB402灯光、CB403像素屏、CB405扬声器、CB406 IPS屏：各已有1个，先集中用于一个场景/裁判节点验证，不提前为每台机器人配齐。
* 原配8cm线缆、3pin线缆、磁铁、两把内六角螺丝刀继续复用。

## 六、加工及工具支持（优先借用，不计套件增补）

3D打印支持与PLA耗材、卡尺、电子秤、万用表、USB数据线、脚底防滑材料。先制作舵机座/舵盘连接试片，通过后再打印双足整套；轴承、其他规格螺钉和转轴等模型定型后补单。

## 简短申请摘要

本组已有一套CB2套件。计划做两台双足对战机器人、两个遥控手柄，并预留两个场景/备用节点，申请增补：CB001主控板5块、CB302舵机10个、CB301电池5个、CB204摇杆1个、CB201按键3个、15cm通用线8根、30cm通用线4根、AA100螺丝2包。其中舵机4个希望优先提供，用于本周末四舵机行走Demo，其余分阶段领用。另希望申请兼容CB2的NFC读卡器1个、匹配卡片5张和小标签5枚做可行性验证，并请协助核对主控配套扩展/供电附件及提供舵机尺寸资料。
