paomodabaibai/CyberBrick2-User-Research-UX/04_结构与硬件/milk组_CB2硬件增补申请表_一次性申请版.md

> 已暂停：老师要求改用CyberBrick第一代。本表仅保留为CB2历史方案，不再作为当前申请；待第一代物料清单核算新表。

# milk组｜CyberBrick二期硬件增补申请表（一次性申请版）

申请小组：第2组 milk组  
项目：桌面双足机器人对战  
现有物料：CyberBrick二期套件1套  
申请原则：一次申请，覆盖两台机器人、两个手柄、两个场景/备用节点及必要调试余量。

## 一、套件物料

| 型号及物料 | 已有 | 申请后总量 | 本次增补 | 用途 |
|---|---:|---:|---:|---|
| CB001 Octo主控板 | 1块 | 6块 | **5块** | 两机器人、两手柄、两个场景/备用节点 |
| CB010 用户交互面板（用户所称面板开关） | 1个 | 6个 | **5个** | 与六块主控一一配套，预留独立操作 |
| CB301 电池 | 1个 | 6个 | **5个** | 与主控、面板数量一致 |
| CB302 舵机及原配舵盘/固定件 | 1个 | 11个 | **10个** | 双足8、巴掌1、备用2 |
| CB303 直流电机 | 1个 | 2个 | **1个** | 拳击机构验证1、备用1；传动与负载匹配待测试 |
| CB204 双通道摇杆带按键 | 1个 | 4个 | **3个** | 按用户要求预留4个，具体手柄配置后续确定 |
| CB201 按键 | 1个 | 6个 | **5个** | 两手柄各2个、场景/备用2个 |
| CB103 磁力传感器 | 1个 | 2个 | **1个** | 简易道具点/磁铁触发的替代方案验证 |
| CB206 微动开关 | 1个 | 2个 | **1个** | 接触触发或机构限位验证 |
| CB401 RGB驱动灯 | 1个 | 2个 | **1个** | 两侧状态/技能反馈候选，按模块实际功能使用 |
| 5pin通用线缆，两端公头，8cm | 11根（表列） | 21根（表列累计） | **10根通用线** | 面板、电池、近距离外设与备用；原包CB403专用线另行辨认 |
| 5pin通用线缆，两端公头，15cm | 2根 | 14根 | **12根** | 双足关节、手柄及备用 |
| 5pin通用线缆，两端公头，30cm | 2根 | 8根 | **6根** | 场景布线、调试及备用 |
| 3pin线缆（原套件同规格） | 1根 | 3根 | **2根** | 保留相应接口调试余量；不视为任意模块通用线 |
| AA100 BT2.5×6螺丝，20枚/包 | 1包 | 4包 | **3包** | 双机、双手柄、场景与安装试片 |
| CA001 D4×2磁铁，20枚/包 | 1包 | 2包 | **1包** | 道具触发、安装实验与替换件 |

主控板、面板、电池均为总量6个、本次各增补5个。不能把“总量6个”理解为再申请6个。线缆为一次性布线余量，最终按实际接头、线序与走线长度使用；CB403白标专用线不得混作通用线。CB010列为面板，不由其名称推断为扩展板。

## 二、卡牌与场景候选扩展（一次预留，不承诺全部实现）

| 物料 | 已有 | 本次申请 | 数量依据 |
|---|---:|---:|---|
| 与CB2兼容的NFC读卡模块 | 0 | **5个** | 手柄2、场景或机器人低位2、备用1；两种场景架构不重复配置 |
| 与读卡器协议匹配的无源技能卡 | 0 | **20张** | 两玩家技能卡与测试/替换余量 |
| 与读卡器匹配的小型无源标签 | 0 | **20枚** | 脚底身份、场景点位与替换试验 |
| NFC接线/接口适配组件 | 0 | **按5个读卡模块配齐** | 若需要转接、电平转换或辅助控制器，请按确认可用的接入方案配套，不盲配型号 |

NFC尚未在现有CB2专属文档中确认原生支持。请优先提供有CB2兼容接线和驱动支持的模块；若无法确认，请提供可行替代接入方案后配料，不用“接口插得上”代替兼容性确认。本次按一次申请预留数量，领到后先用1个验证，其余通过后部署。卡牌/桌游/道具点仍为候选玩法。

## 三、请随本次申请一并核对配齐

- 六组主控＋面板＋电池所需的专用互连、供电与充电配件。若须另有扩展板/供电模块，请按独立节点需要配齐；已有配件扣除，不重复统计。
- 11个舵机需要的舵盘、中心螺钉、安装附件及兼容连接线；原配已含则不另加。四至五舵机同时动作的供电方案请协助确认。
- 两个直流电机的兼容驱动/连接组件，原套件或模块自带部分不重复申请。减速与Punchy传动匹配尚待验证，不能默认裸电机直连主控。
- USB数据线建议准备4根，实际已有数量核对后补差；充电附件按六电池方案配齐，不假定必须同时充六块。
- 请提供CB302舵机尺寸/CAD、孔位、舵盘、重量、扭矩、速度、电流资料，以及CB001/CB301接口和供电规格。
- 申请3D打印与耗材支持；卡尺、电子秤、万用表优先借用。其他规格紧固件及转轴建议提供可选小件盒或加工支持，具体尺寸由适配模型确定，不编造轴承型号。

## 四、用途与当前验证状态

本周末先完成一套Otto四舵机行走模块。目前只有一块主控，尚未完成主从机/双板遥控测试；本申请是为后续验证和制作提供硬件，不表示六板通信已测试通过。收到增补器件后，先测试双板通信与单舵机，再做四轴步态，最后扩展双机对战。

已拥有的距离、光线、旋钮、编码器、不回中摇杆、像素屏、IPS屏、扬声器等优先复用，避免所有模块均按六份申请。多申请的场景与备用器件可后续按实际使用调剂。

## 可直接转发的申请说明

我们组目前只有一套CB2套件、一块主控，还没有条件完成主从机测试。考虑本项目将制作两台机器人、两个手柄，并预留两个场景/备用节点，希望一次申请齐全：主控板、用户交互面板和电池均配到6个总量，即各增补5个；其余按表增补舵机、电机、摇杆、按键、连接线和安装件。同时预留NFC卡牌与场景识别物料，请协助确认CB2兼容性并配齐必要接口与驱动附件。暂时未用到的物料可以后续调剂。

## 最新确认

CB204双通道摇杆带按键总量调整为4个，已有1个，本次增补3个。其他申请数量保持不变。制作先集中于第一台机器人的四舵机行走模块，再逐步扩展。
