paomodabaibai/CyberBrick2-User-Research-UX/05_程序与测试/CB1_Otto控制框架_v02/2026-10-21_巴掌接收板上传记录.md

# 巴掌接收板上传记录 2026-10-21

接收板 COM7，USB序列58:E6:C5:A8:1B:0C，GPIO10=0。
上传统一控制版本 cb1-shared-palm-gait-30-20-2026-10-20，九个文件板端SHA256全部与发布清单一致。
原有七个被覆盖文件已备份至 板端备份_巴掌_2026-10-21_220109；robot_remote.py和palm_remote_ready.py原板不存在，本轮新增。
重启日志：CB1 palm both None s; neutral 0.5s to arm; hold K4 to dance。
串口已释放，未中断持续遥控。未更改发射板及配对。
行走髋30度/踝20度、K4按住跳舞松开停、巴掌杆双向旋转回中停止。
本轮完成上传及板端启动验证；实际遥控与动作效果待用户观察。拳头版也已于今日上传，见同日拳头上传记录。

## 上传后无响应排查与用户确认

现象：新版启动后推杆无动作。只读探针确认无线帧有效，但右行走杆ch0在松手与后拉到底时均约3740–3750，明显偏离配置中位1959；RemotePolicy.armed始终False，三杆回中使能条件未通过。
用户检查后明确反馈：“确实是摇杆线松了了现在已经完全恢复控制了”。因此本次直接原因确认为摇杆接线松动；未修改中位、映射或使能逻辑。用户确认重插后恢复遥控，属于用户观察证据；本轮未新增量化步态、转向或供电验收结论。
最终保持新版持续遥控入口运行；保留现有代码。

## 随后巴掌不旋转排查（尚未解决）

用户反馈攻击杆无效。实测三杆中位约ch0=1953、ch2=1844、ch3=1782，RemotePolicy可使能；攻击杆按用户保持操作后ch2=0，输入变化正常。
使用现有PalmPwmDriver绕过遥控，GPIO21/D1 50Hz输出1300us两秒，随后1500us停机并release；板端命令成功，用户反馈“完全没动”。这不能证明实际针脚波形或电压正常，故未宣称软件全部排除；当前优先检查电池供电、D1插头、焊接线路及舵机。
测试结束已软重启恢复持续遥控，日志出现ARMED。未修改代码。已请用户断电后检查重插D1连接、焊点，再开机，待其反馈复测。

## 巴掌速度提高一档
用户反馈接线恢复后巴掌已能动，并要求提高力度。palm_remote_ready.PALM.delta_us由200提高至300，转动1200/1800us，停止1500us不变；已备份原板配置、上传并核对SHA256，重启日志ARMED。14项共享控制测试通过。仓库源文件与待上传包及清单已同步；未声称额定功率提升，提速实际效果待用户观察。

## 临时最大指令对比
依据本地保存的官方servos_code.txt set_speed函数：百分比范围-100至100，duty=round(percent*51.2/100+76.8)，50Hz对应近似500至2500us。按用户尝试极限要求，临时PalmPwmDriver配置delta_us=1000，依次1000/2000us各1秒、500/2500us各2秒，每段之间1500us停止600ms，finally释放。板端执行完成，实际转速/效果待用户确认；没有声称真实最大机械功率或转速已经测得。测试后重启恢复原delta_us=300持续遥控，未永久保存最大档。

最高指令短测用户确认：最高档明显更快，机构正常（用户观察证据）。仅验证本次短时空载/现场负载效果，未量化转速、扭矩或长时温升。当前永久配置仍为delta_us=300，即1200/1800us，未改为最高档。

## 最终档位：用户指定2100us
PALM.delta_us=600，双向900/2100us，停止1500us。已备份、上传并核对SHA256；重启恢复持续遥控。仓库源文件、待上传包及清单同步。此前最高档短测正常不代表本档位已完成实际用户验收。
