paomodabaibai/CyberBrick2-User-Research-UX/05_程序与测试/CB1_Otto控制框架_v02/2026-10-21_拳头接收板上传记录.md

# 拳头接收板上传记录 2026-10-21

已上传至 COM9 接收板（USB 序列 80:F1:B2:1E:0F:FC，GPIO10=0）。未修改发射板及配对。

上传文件：robot_remote.py、otto_oscillator.py、second_remote_ready.py、second_punch_remote.py、main.py。五个文件板端 SHA256 与待上传包一致。

版本：cb1-shared-palm-gait-30-20-2026-10-20。
重启日志确认进入：CB1 punch both None s; neutral 0.5s to arm; hold K4 to dance。
已释放电脑串口，未发送中断；持续遥控入口已启动。

采用巴掌版行走参数：髋30度、踝20度；K4按住跳舞松开停止；拳头杆上推慢、下推快、回中停止。
实际遥控效果及机械范围尚待用户观察，本轮未宣称实机行走验收通过。巴掌接收板本轮未上传。

原板四个被覆盖文件备份：板端备份_拳头_2026-10-21_192403。
首次哈希整文件读取触发内存不足，改为512字节分块读取后五项均核对成功，不影响上传文件。
