paomodabaibai/CyberBrick2-User-Research-UX/06_游戏设计/打印脱落球靶_v09/粗模说明.md

# 打印球靶粗模
用户已授权先建模查看大概效果。

本轮生成真实CAD的STEP、GLB和STL总装，以及标注预览图。均为概念模型，不是可直接制造的打印包。

球径60，球心135，最低球底平面107；磁铁顶106.5，钢片下107，间隙0.5为示意。后柱中心距离球心95，底座85×70，球前无落地底盘。球壳名义壁厚1.6，但底部加厚连接区尚需细化。

立柱槽为调高示意：滑块当前与立柱有几何交叠，尚未做导向孔、锁紧螺丝和限位。高度120–150目标尚未结构验算。球壳未分成两半，钢片座与封盖未定，不能直接打印总装。

图中高度条是静态网格包络，不代表通过碰撞或实际命中验证。60mm球的下沿约105，实际削平至107；悬臂顶101，留在已测静态攻击范围下方，但动态倾斜仍需检查。后柱95mm偏置是初样提案，不是经过完整机器人扫掠验证的净空。

脱落后的防滚/限位方案尚未纳入粗模。先审阅外形、球大小及底座布局，再细化制造。
