paomodabaibai/CyberBrick2-User-Research-UX/02_汇报/2026-10-21_后半段优化/第10-18页_内容与制作说明.md

# 棋甲对决 / milk ARENA 第 10–18 页优化

状态：已通过 black badone 账号完成 Figma 第 10–18 页，共 9 张 1920 × 1080 画板；已逐页截图检查，修正多行正文行高和商业模式页容器高度。

源文件：项目根目录 milk_ARENA_产品发布会.pptx，共 19 页。
目标 Figma：e3jDhP0HbtQao537wypZgz，自动布局 182:9。
使用账号：black badone（1514228355@qq.com），已核验连接身份。原先的授权问题已解决。
新画板位于原自动布局 182:9 的底部，命名为「10 · … · 优化版」至「18 · … · 优化版」，原有画板完整保留。

完成画板：10 = 191:137；11 = 191:181；12 = 191:235；13 = 194:19；14 = 194:63；15 = 194:112；16 = 194:170；17 = 194:222；18 = 194:277。

打开第 10 页：https://www.figma.com/design/e3jDhP0HbtQao537wypZgz/2026-CyberBrick-2.0?node-id=191-137
每页均设置 PNG 1× 导出规格。正文与布局可编辑；Figma 云端无 Huiwen-mincho，故标题与 @MILK 使用本机原字体转换为矢量，并在各页保留隐藏标题文字备份。
本地 PPT 文件未修改。

## 已确认的源样式

- 内容页：1920 × 1080，柔和浅灰径向渐变背景。
- 标题：Huiwen-mincho Regular，80 px，深灰 #5C5C5C。
- 标题左侧：现有红蓝渐变竖块。
- 正文/强调：源文本使用 Inter（中文由字体回退显示），强调为 Extra Bold。
- 主色：blue #355797、gold #977335、purple #71499F、muted #888888。
- 品牌：内容页左下角 @MILK，保留原字体外观；结束愿景页置于左上角。
- 来源画板：182:318（用户参与动机）、182:40（儿童围观场景），均在 182:9 内。

## 9 页内容

### 10 双机原型，已经就位
- 巴掌款：遥控行走、转向倒退、正反向挥掌。
- 拳头款：持续遥控、两档出拳、按键跳舞。
- 演示顺序：移动接近、选择出手、停止与庆祝。
- 证据依据：2026-09-26 巴掌验收、2026-10-17 拳头基本完成记录。
- 版式：双角色大图＋两组简短功能；浅灰内容页，不沿用旧黑底审计页。

### 11 一套工具包，三种参与方式
- 玩家：双机、双手柄、基础场地，打开即可开始对战。
- 创作者：结构文件、替换外壳与装配说明，动手改造自己的角色。
- 组织者：多机设备、备件、活动手册，组织一场完整的创客擂台。
- 状态：产品化配置规划。
- 版式：复用用户参与动机页的三列关系，压缩为短标题和两行说明。

### 12 90 分钟，把想法带上擂台
- 20 分钟：观察机构。认识旋转与往复动作，提出一项修改想法。
- 35 分钟：装配调试。装配外壳或模块，完成遥控练习与动作检查。
- 35 分钟：比赛复盘。轮换对战，记录现象，解释一次修改的效果。
- 状态：创客活动试点方案，时长待试办验证。
- 版式：三段横向时间轴，大数字，内容平铺，避免厚重卡片。

### 13 同一套机器人，持续换新玩法
- 对战擂台：移动、争夺目标、把握攻击时机。
- 绕障竞速：改变墙体布局，挑战路径与操控。
- 协作运送：两人配合完成任务，拓展载物机构。
- 状态：绕障与协作为后续研发概念。
- 版式：左侧地图大图，右侧三条玩法；不把概念写成已完成功能。

### 14 让每一次改造，都能被分享
- 打印：拓竹设备与耗材承接结构、外壳和替换件制作。
- 驱动：CyberBrick 电控为机器人提供动作与遥控基础。
- 分享：计划通过 MakerWorld 发布模型、装配资料与玩法。
- 关系：作品发布后，他人打印、修改，再分享新的版本。
- 状态：生态衔接设想，不表示官方合作或兼容认证。
- 版式：横向三阶段，加一条简洁回流关系，使用现有蓝、金、紫配色。

### 15 商业模式：体验带来用户，产品支持复玩
- 活动体验：面向营地与社团，提供设备租用、课程和活动执行。
- 教学套装：面向学校与机构，提供设备、备件、教材和维护支持。
- 扩展内容：面向玩家与创作者，提供外观、地图、玩法扩展与赛事。
- 版式：三条宽行，分别说明服务对象、交付内容、收入方式；不用“第一步第二步第三步”混淆客户和阶段。

### 16 用户规模愿景
- 上市第 1 年：1 万累计体验用户。校园与营地活动建立首批社群。
- 上市第 3 年：10 万累计体验用户。多城市体验点与机构套装扩展覆盖。
- 上市第 5 年：100 万累计体验用户。角色系列、创作社区与赛事扩大参与。
- 口径：阶段愿景目标，非实测、销量或市场预测。
- 版式：1 万、10 万、100 万三个主数字，分别接一个时间和一个实现路径。

### 17 走向规模化的三步
- 产品打磨：提高耐用性与续航，完善装配、备件和上手说明。
- 场景试点：进入营地和校园，记录完整体验、复玩意愿与真实成本。
- 社群扩展：发布模型与玩法，形成活动组织者和玩家创作者的持续参与。
- 版式：三段里程碑，突出每段应产生的具体结果，删除无依据的达标百分比。

### 18 把创造，带上擂台
- 核心句：让自己创造的机器人，成为朋友之间的一场比赛。
- 品牌句：棋甲对决 / milk ARENA。
- 愿景句：更多角色、更多玩法、更多人一起开场。
- 版式：复用现有情境图与 @MILK 品牌层，简短收束，接原第 19 页“动起来”。

## Figma 执行要求

1. 在 182:9 内复制现有源 frame，命名为 10–18 对应标题。
2. 保留原始画板，不覆盖前面已定稿内容。
3. 复用背景、标题竖块、字体、颜色变量和品牌层。
4. 正文保持原生可编辑文字，相关元素使用自动布局。
5. 逐页截图检查边界、遮挡、字号及文字完整性，再交付节点链接。
