paomodabaibai/CyberBrick2-User-Research-UX/05_程序与测试/CB1_Otto控制框架_v02/2026-10-20_拳头单杆后拉前进_修复报告.md

# 拳头机器人：单杆后拉仍前进 · 离线修复

> 后续更新：本轮的单杆方向修复已合并进双机共享核心 robot_remote.py。现在请使用“待上传_双机统一控制_2026-10-20”包；下文单文件上传步骤是历史，不再适用于最终统一版。详见同目录《2026-10-20_双机统一控制与K4跳舞_交接.md》。

日期：2026-10-20。用户澄清：同一根杆前推、后拉都沿前进弧线移动，重点不是左右转的符号相同。用户要求先在电脑完成，回家后再上传。

**当前状态：PC代码修复与回归通过，未连接串口、未读取板上文件、未上传、未驱动机器人。实机软件版本与转弯位移尚待核验。**

## 1. 确认的根因

旧 `second_punch_remote.RemotePolicy.update()` 只有两杆同向才产生 `drive`；单杆无论推拉都返回 `drive=0`。主循环随后执行 `direction = -1 if drive < 0 else 1`，因此四种单杆请求的踝部方向都固定为 +1。`turn` 虽然改变髋振幅分配，却不能让机器人使用后退步态。

例如：左杆前推 `(drive=0, turn=-1)`，左杆后拉 `(drive=0, turn=+1)`；进入振荡器的方向却都是 +1。这与“后拉也沿前进弧线”的观察一致。

**不能只把 direction 改成负值了事：** 原turn差值后拉时也翻号，若同时把踝相位与左右幅度分配都反过来，就不能让同一根杆的动作成为前推轨迹的倒放。新的 `stride_turn = turn × walk_direction` 将行驶方向与步幅侧分开。

## 2. 与巴掌版实际代码比较

读取了 `otto_session.py`、`otto_oscillator.py`、`config.py`、关节模型和PWM驱动，以及拳头版 `second_remote_ready.py` 和完整循环；没有根据旧交接猜测。

| 项目 | 本地巴掌版 | 原拳头版 |
|---|---|---|
| 摇杆左右通道 | 左ch3/右ch0 | 左ch3/右ch0 |
| 中位 | 1797/1959 | 经ready入口2051/2128 |
| 死区后drive/turn映射 | 两杆同向前后走，单杆弧线 | 与巴掌版等价 |
| 单杆的踝部行驶方向 | drive=0时也默认+1 | 同样默认+1，是本次确认问题 |
| 髋/踝/偏置 | 30/20/4度 | 20/16/4度 |
| 满杆转向髋振幅 | 30:10 | 20:10，转向差幅更弱 |
| 四关节输出映射 | JointModel，当前四路方向+1/中心90/trim0 | 固定GPIO3/1/2/0，90+偏角 |
| 攻击与K4 | D1连续舵机，独立攻击控制 | M1两档拳击，按住K4跳舞 |

PC网格对照441组归一化左右杆输入，两个旧映射没有差异。共享 `otto_oscillator.py` 已经取消过旧的“turn>0踝额外翻180度”，此次没有重新引入它。

**诚实边界：** 本地巴掌源码也有同一个单杆方向分支，因此不能声称发现了“拳头独有的映射错误”，也不能仅凭这些本地文件完整解释两台实物体验不同。两板实际部署版本、安装、负载与摩擦尚未比较。用户已确认巴掌好用，本轮没有修改巴掌运行文件或共享振荡器。

## 3. 修复后的行为

新增纯软件状态 `walk_direction`（前后相位）与 `stride_turn`（髋步幅分配），保持RemotePolicy原来的drive/turn/speed返回接口。

| 操作（满杆） | 前后相位 | 左/右髋振幅（度） |
|---|---:|---:|
| 左杆前推 | +1 前进 | 20 / 6.667 |
| 左杆后拉 | -1 后退 | 20 / 6.667 |
| 右杆前推 | +1 前进 | 6.667 / 20 |
| 右杆后拉 | -1 后退 | 6.667 / 20 |
| 两杆同推 | +1 前进 | 20 / 20 |
| 两杆同拉 | -1 后退 | 20 / 20 |

相同杆前后操作：髋分配不换侧，踝动态部分反相、静态偏置仍为+4/-4。在完整周期上可视为该步态的时间反向；并不等于已经实测相同距离的逆向位移。

两杆不等量倒退时也保留“偏转更大的杆对应更大步幅”，避免倒退时左右幅度分配错换。反向推拉两根杆的旧弧线语义保留，不承诺四舵机Otto能像履带车一样两侧反向原地旋转。

新 `WalkMotion`：周期仍1秒、幅度渐变仍500ms；正在运动时反向先收至零，再切换前后相位，重新起步。左右分配变化做200ms量级渐变；松杆时保留末次分配并继续推进相位收步，结束回中。相位取模避免无限累计。

转向比例改成与巴掌/原版参考同样的3:1，但最大髋幅度仍20，踝16、偏置4，舞蹈±25和总角度65–115保持原范围。没有复制第一台更大的机械幅度或直行校正值。

## 4. 验证证据

1. 修改前完整回归：174项通过，说明旧测试未覆盖本现象。
2. 先加入8项新测试：排除测试硬件模拟缺失后，旧代码出现6个失败断言（含左右两条单杆后退），直接复现方向丢失、幅度换侧和转向比差异。
3. 修复后8项通过，再补3项实际ADC端点真值表/取消反向/反向时松杆测试。
4. 最终新11项全部通过；完整回归 **185项，21.105秒，全部通过**。
5. 新测试调用真实 `second_remote_ready.run()`，使用本机实测ADC中位，模拟无线/时钟/PWM边界，断言直到实际GPIO和脉宽的全链路，不只是测一个公式。

检查覆盖：四种单杆、双杆前后、左右镜像、完整周期输出限位、1秒周期、换向经过零幅度、连续20ms样本角度差≤5度、松杆回中、取消换向、已有拳头两速/持续攻击/跳舞/失联/异常释放回归。

新增测试：`tests/test_second_walk_direction.py`。复现命令：

```powershell
# 工作目录：E:\课程作业\milk-github-sync\05_程序与测试\CB1_Otto控制框架_v02
& 'E:\课程作业\大三上\张茫 用户研究与体验设计\05_程序与测试\serial_runtime\Scripts\python.exe' -m unittest discover -s tests -q
```

## 5. 回来后上传范围

**已有10月17日持续遥控版的第二台接收板，只需替换 `second_punch_remote.py` 一个文件。** 未新增板端依赖。入口仍是second_punch_main.py安装为main.py，ready映射仍用本台数据，配对不用重新做。

原项目程序目录已生成 `待上传_拳头单杆倒退修复_2026-10-20`：含新模块、同名旧模块回退件、文件SHA256与操作说明。第一台巴掌板不要上传本模块；不要将仓库的巴掌main.py覆盖第二台。

实际操作时先读第二台序列号和当前模块、备份，再上传新模块并校验、复位（排除MicroPython导入缓存）。启动日志必须出现 `second-punch-walk-reverse-2026-10-20`。

最小现场验证：三杆回中使能；先托住观察左右单杆前推/后拉踝方向，再落地比较同一根杆的前弧/后弧；最后确认拳头和K4正常。物理左右名称、后退距离与转弯半径仍以用户观察为准，不用PC测试声称机械控制已经“完美”。
