paomodabaibai/CyberBrick2-User-Research-UX/06_游戏设计/错位T墙竞技场_v05/交付验证.md

# v05 交付验证

日期：2026-10-13。范围：数字几何、图纸一致性、浏览器交互与压缩包完整性。未进行切片、实物打印、受力分析或机器人动作。

## 已完成

- 12种单件 STL、12种可编辑单件 STEP。CAD有效且各为单实体；STL水密、法线绕序一致、单连通且体积为正。
- 所有单件按导出的打印朝向检查：XY两侧各加8 mm brim仍在200 × 200内，Z小于200。最大地板含brim为195.6 × 195.6，最大墙长含brim196。实际机器热床有效区域仍需切片确认。
- 底部接口精确实体检查：桥片与左右样片、相邻地板相交体积为0；样片接缝0.4，槽深2.4，桥片厚2。不是已经试配成功。
- A/B装配STEP导出后回读分别为173/167个有效实体，整体包络1260 × 1260 × 166。
- 固定墙包络互不重叠；墙、护沿和靶底都在行走面Z=6。地板与底桥片由桌面支撑。
- 图册数据中的10段墙逐项对齐 scene.json 的位置、尺寸、高度和A/B启用状态。viewer.html内嵌场景实例、零件表与游戏对象对齐最终scene；支墙均为120长度。
- 独立核算目标默认及±30成对变化的6个位置：到最近固定墙或护沿中心距均至少240，大于230保守倒伏保留半径，至少10几何余量。此计算不覆盖撞飞或滚动。
- A/B打印数量与BOM一致；A完整173件，B安装167件，差额6横墙留作复用。
- 6页PDF使用嵌入中文字体，全部渲染为PNG进行目视检查；修正了分块桥片投影遮挡、下缘尺寸标注重叠和目标开口画法。PDF逐页有可提取文本。
- 浏览器自动检查：A/B切换、俯视、目标归属点选、打印分区、展开地板、旋转、缩放复位可用；390px手机宽度无横向溢出。JavaScript错误0，外部网络请求0。
- 额外独立审查确认颜色规则、坐标、尺寸、数量和未实测声明一致。
- 完整ZIP包含模型、图册、预览、参数、源脚本、说明和SHA256清单；保留04/06相对路径结构，压缩CRC检查通过。

## 关键证据

- 硬件目录 `geometry_report.json`：逐件几何、接口和装配STEP回读记录。
- 本目录 `delivery_checks.json`：图纸/场景/交互数据一致性和±30目标净空。
- `viewer_check.png`、`viewer_top_check.png`、`viewer_B_check.png`：浏览器验收截图。
- `output/pdf/page-1.png`～`page-6.png`：最终图册渲染。

## 尚未验证

桌面实际能否承托1260方形场地；实际机器人尺寸、有效击打高度和攻击扫掠；A布局弧线转向与交会；B接近停止距离；地板摩擦、翘曲和接缝跨越；墙脚固定和护沿效果；目标静置、质量、击倒手感与两机公平性。以上均需真实测量，不能用CAD、浏览器演示或网格检查替代。

建议先在平桌按B布局测两枚目标、一个支墙及接缝样片，再批量打印49块地板。此前约135 mm仅模型腕部参考高度，不作为制造验收基准。
