paomodabaibai/CyberBrick2-User-Research-UX/04_结构与硬件/拳头_整体比例预览_v03/说明.md

# 比例预览 v03：新增拳头 X/Y 偏移

2026-09-28。保留 v02 原文件，更新同一个交互预览入口，已有界面数值通过 preview_version=2 的兼容读取保留。

新增参数：
- 拳头 X 偏移（mm）：沿出拳方向，正值仅将拳头向前移动。
- 拳头 Y 偏移（mm）：机器人横向，正值仅将拳头向左移动。
- 两者均在拳头旋转之后施加，仅改变拳头相对滑架的位置；机构主体与模块整体后移值不因此改变。
- 如设置了腕部延长/X/Y偏移，蓝色斜杆只是空间关系示意，尚非有强度、接口及导向验证的实体。Y偏移尤其可能增加侧向载荷。
- “拳尖超出前支架”读数计入X偏移，但仅沿机构X方向计算，不能表示整个拳头不被挡住或没有碰撞。

本轮浏览器检查：X=12、Y=-8时读数同步；叠加原有后移-22、腕部延长38、Z旋转14可正常显示；375px无横向溢出；无JavaScript错误。这是测试输入，不代表用户最终选择。

等用户确定最终数值后，按数值重新设计真正的滑架/腕部接口，检查导杆、前支座、壳体及极限位置的干涉和重心。当前仅用于比例比较，不能直接打印示意斜杆。
