paomodabaibai/CyberBrick2-User-Research-UX/05_程序与测试/CB1_Otto控制框架_v02/2026-09-24深夜_原地踏步卡点交接.md

# 步态卡点交接：原地踏步、无法前进（2026-09-24 深夜）

## 当前状态（git 42ef2482 已备份）

遥控链路、会话生命周期、操作模式全部工作（见《2026-09-24遥控行走实现_最终记录.md》）。唯一卡点：**机器人踏步动作全部正常执行，但不产生位移**——交替推、按住推都一样。

## 已确认的事实（别重复验证）

1. **执行链完好**：板端日志 step start/done 全对；舵机单关节/四关节带载实测都动。
2. **髋已主导**：hip_swing=20°（S1 -20°/S3 +20° 现场重扫干净，限位 70/115），用户确认"髋部已经在动了"。
3. **踝符号已按 Otto 物理翻转**（-1/-1）：迈步脚脚尖朝下（卸载抬起）、支撑脚脚尖朝上（脚跟承重）。此前 +1/+1 是反的（身体重量从未转移）——翻转后仍不前进。
4. **五阶段离散步态结构与 Otto 正弦采样点对应**（Otto: 髋居中时踝极值=weight_shift；髋极值时踝居中=swing/land），相位顺序没错。
5. PC 119 测试全绿；config 已上板（DRIVER='cb1_pwm' 变体，务必重生成 _upload/config.py 再传）。

## Otto 官方固件关键事实（研究代理已核实，源码在 OttoDIYLib/src/Otto.cpp）

- walk = 连续正弦振荡器，**不是离散单步**：双髋同一正弦 ±30°（镜像安装→剪刀腿）；双踝同一正弦 ±20°、直流偏置 ±4（镜像→物理反相倾斜）；**踝滞后髋 90°**；周期 T=1000ms=两步；更新率 30ms。
- turn = 同样协调但两髋振幅不对称（30/10）→ 弧线。
- 前进动力来自：摆动腿脚尖点地抬起该侧、身体滚向脚尖朝上的支撑腿，摆动腿在空中从后往前摆——**每半周期交换一次**。
- 参考移植：`hip=90+30·sin(ωt); ankle=90+20·sin(ωt−90°)±4`。

## 下一个 agent 的候选方向（按性价比排序）

1. **连续振荡器架构（最像正解）**：废弃"事件触发单步"，改为每 20ms 直接按正弦写姿态，推杆=驱动系数、松开=回中停。命令映射退化成读摇杆值。关键：相位关系由数学保证，脚滞后髋 90° 是前进的必要条件——我们的离散五阶段里踝和髋是串行的，可能等效相位差不对。
2. **验证重心转移是否真的发生**：慢放单步，观察迈步脚是否真的离地。如果离地但身体不前移→支撑脚打滑（鼠标垫+脚底材料）；如果根本不离地→踝 28° 在这个连杆几何下不足以卸载（需要更大或加 tiptoe bias ±4）。
3. **摩擦检查**：脚底材质/鼠标垫摩擦谱。Otto 靠脚尖点地推进，太滑/太涩都不行。
4. **机械再查**：舵盘重装后摆动平面是否还垂直；脚踝轴和髋轴是否平行。
5. 控制模型注意：用户要"按住=持续走"，方向语义可后定（哪个杆偏转=往哪转，参数翻转即可）。

## 环境备忘

- 接收板 COM7（58:E6:C5:A8:1B:0C）、发射板 COM8；mpremote 每次连接软重启接收板；改 config 后记得同步 PC/板端两份。
- **绝不第三方烧录/flash-erase**。PC 测试：`python -m unittest discover -s tests`。
- K4 无功能；ch2=攻击键（未接线）；上电即自动待命（battery_walk 已重写）。

---

## 附：2026-09-25 凌晨新问题——单杆转向方向只跟推拉方向走，不跟左右杆

**现象（用户清晰观察）**：
- 推左杆或右杆**往前**，机器人整体往**同一个**方向转（比如右转）——尽管大幅转角时动的那只脚不同（说明振幅不对称确实生效了）
- **往后推**（任一杆）才往另一个方向转
- 用户怀疑中间有镜像错误

**代码事实（供下一位 agent 分析）**：
- 单杆模式 `_axes` 返回 drive=0、turn=±0.8：**前推左杆 = -0.8，前推右杆 = +0.8，后拉左杆 = +0.8，后拉右杆 = -0.8**（符号只跟推拉方向走，跟左右杆无关——这正是用户观察到的映射！）
- `pose_offsets` 里踝翻转条件是 `flip = π if turn > 0`：前推右杆/后拉左杆（turn>0）踝相位翻 180°，前推左杆/后拉右杆（turn<0）不翻
- drive=0 时 drive_dir 强制为 1.0（前进式振荡）
- 因此：**前推左杆（turn=-0.8, 无翻转）与前推右杆（turn=+0.8, 有翻转）在代码上只差踝相位翻转**——如果实测二者物理转向相同，说明**当前物理偏航由踝相位主导，而不是振幅不对称**（振幅镜像的贡献接近零）；"后拉=另一方向"则是因为后拉恰好翻转了 turn 符号、连带翻转了踝相位
- 另有独立证据支持"踝相位主导偏航"：直行本身有向右的固定偏航（见 steer_trim），与振幅无关

**候选解释（待验证）**：
1. 偏航的物理来源是"脚尖朝下的脚在摆动半周期内拖地/点地产生的 yaw 力矩"，其方向由踝相位与哪条腿大步的相对时序决定；振幅不对称只是改变两腿接触时间比例，对净偏航贡献小
2. 若成立，转向的正确控制量是**踝相位/偏置**（或"哪只脚点地"），而不是（只是）髋振幅差；`turn_split` 大只是让单脚拖地更明显
3. 验证实验：turn=+0.8 与 turn=-0.8 各跑 10 秒，测净偏航角；再把 `flip` 强制为 0 / 强制为 π 各测一次，对比四组结果即可分离两个因素

**当前板端状态**：四个舵机被后台脚本保持在 90°（用户在做机械调整）；主入口 otto_session 无限模式（上电自动待命）；v05 全部代码 + 转向 30/5 + steer_trim=0.2 已上板。
