paomodabaibai/CyberBrick2-User-Research-UX/05_程序与测试/CB1_Otto控制框架_v02/2026-09-26_D1巴掌控制_执行完成报告.md

# D1 巴掌控制：执行完成报告（致计划 Agent）

**执行结果：全部四项任务完成，现场验收通过（用户原话："可以了可以了！完美"），git 已即时备份两笔，随后文档同步一笔。**

## 验收结果对照（完成标准逐条）

| 完成标准（计划原文） | 结果 | 证据 |
|---|---|---|
| 用户确认两侧方向相反 | ✅ 通过 | 用户验收"正反转已验证"；物理方向称呼未记录（见遗留） |
| 松手停止 | ✅ 通过 | 1500µs 持续停止脉冲；用户验收"松手自动回中停止" |
| 两行走杆和攻击杆互不串控 | ✅ 通过 | 行走验收与攻击验收独立通过；共享帧读取，决策互不进入 |
| 实测断链停止 | ⚠️ 实现+PC 集成测试覆盖（断链→None→release），**实机未单独复验** | 集成测试 test_attack_rides_shared_frame_and_releases_on_exit |
| 重新回中门禁 | ✅ 实现+PC 测试覆盖（失联后杆偏着不转）；实机随整体验收隐式确认 | test_link_loss_disarms_and_blocks_until_recenter |
| 电池独立运行有效 | ⚠️ 行走已电池实机验证；**行走+攻击组合的电池模式未显式复验**（短时 USB 验收通过） | — |

## 与计划的偏差（两处，均经用户裁定或等价覆盖）

1. **跳过 ch2 重采样**：用户指出历史数据已存在（0..4071、center 1860 参考）。实测静止值 1824-1827，偏差归一化 0.02，在 exit_deadband=0.10 容差内；舵机侧中位精度由 neutral_us 独立承担（计划本身也要求如此）。
2. **"只读取一次短采样"未单独执行**：改为会话级集成测试覆盖（wait_for_frames 消耗回中帧 → 攻击控制器武装时序，正是计划担心的时序问题，已被测试锁定）。

## 实测参数定稿

- delta_us=**200**（1300/1700µs 双向转动实测确认；100µs 差值实测带不动——修正了初版配置）
- ch2 静止 1824-1827（center=1860 参考有效）
- 正反转、松手停止、与行走同时运行：均通过；五舵机同跑未见失力/重启（短时）
- steer_trim=0.2 上板修直行偏右（长期效果待观察）

## 遗留（不阻塞使用）

1. 巴掌 1500µs 停止时是否慢爬——需一次长时间观察，爬则单独校 neutral_us
2. 五舵机长时供电稳定性——短时验收通过，长时未测
3. 攻击方向语义与用户习惯的对齐（如反，config `direction=-1` 一行）
4. README 尚未更新（PROJECT_CONTEXT、继续任务、计划勾选均已完成）

## 交付物

- 代码：attack_control.py、drivers/palm_pwm.py、otto_session.py（集成）、config.py（ATTACK 基线）
- 测试：test_attack_control.py（10 项）、test_palm_pwm.py（6 项）、test_otto_session.py 集成（1 项新增）——**151 项全绿**
- 板端：变体 config（enabled=True, continuous）+ 4 文件哈希核对一致 + 板端 import 验证
- 记录：本文、《2026-09-26_攻击功能验收通过_最终记录.md》、计划文件已逐项勾选
- git：三笔提交（功能状态 / 验收记录 / 本报告与文档同步）
