paomodabaibai/CyberBrick2-User-Research-UX/05_程序与测试/CB1_Otto控制框架_v02/2026-09-26_D1巴掌摇杆控制_执行计划.md

# D1 巴掌摇杆控制执行计划

> **✅ 已执行完毕（2026-09-26）。** 勾选=已执行或有等价验证；两处偏差：①ch2 重采样经用户裁定跳过（沿用 1860 参考，实测静止 1824-1827 在容差内）；②"只读取一次短采样"改在集成测试中覆盖。全部偏差与验收结果见《2026-09-26_D1巴掌控制_执行完成报告.md》。

> 执行 Agent：按 executing-plans 技能逐项执行并勾选。本文件是任务说明，不是已实现功能。不要重做行走或转向研究，不要恢复旧版本覆盖其他 Agent 的修改。

**目标：** 第三根自动回中单轴摇杆控制巴掌连续旋转舵机：一侧持续正转，另一侧持续反转，松手回中停止；支持与现有行走同时运行。

**架构：** 使用现有接收链路，每拍只读一次原始遥控帧。行走与独立攻击控制器共享该帧，攻击控制器只输出 D1，不进入四关节位置模型。首版两侧固定低速，不做角度定位或比例调速。

**环境：** CB1 / MicroPython；项目目录 `E:\课程作业\大三上\张茫 用户研究与体验设计`；下文代码路径相对 `05_程序与测试/CB1_Otto控制框架_v02/`。

## 最新事实与边界

- 2026-09-26 用户亲自确认：**攻击摇杆会自动回中，松手回中停止是明确需求。** config.py 中“NOT self-centering”注释错误，必须纠正。旧中位1860是历史记录，不保证是当前自然中位。
- 已记录第三杆为零基 ch2，即官方帧 L3；历史全行程0..4071。左右行走杆当前为 left_channel=3 / right_channel=0；不要混用。
- 巴掌是360°连续旋转舵机，信号接 D1/GPIO21。控制量为方向和速度，不能用90°/180°解释实际角度，也不能指望自动回到某个巴掌朝向。
- 实机已验证：50Hz、1600µs连续信号，用户确认巴掌转动。并未确认这个方向对应用户哪一侧，也未确认1400µs反转或1500µs精准停转。
- 上个 Agent 已结束持续测试，向 D1 发送1500µs约400ms后 duty(0)/deinit，板端输出 D1_STOP_PWM_OFF。接收板停留调试状态，未恢复遥控行走。新执行者应重新确认当前状态，不假定后台仍在保持输出。
- 接收板历史 COM7，USB序列58:E6:C5:A8:1B:0C；发射板历史COM8、序列58:E6:C5:A7:00:A4。端口会变，按序列识别。最近一次枚举只见接收板USB，不代表遥控板未用电池开机。
- 现有 K4 无功能，不要声称它能停止攻击。实体断电可停止。不得擅自加入或恢复旧版K4语义。
- 不重新配对、不恢复出厂、不刷固件、不修改腿部标定与转向参数。本轮不操作发射端文件。

## 文件与职责

| 文件 | 任务 |
|---|---|
| config.py | 修正ATTACK配置类型与摇杆回中注释；增加D1及脉宽、死区参数 |
| attack_control.py（新） | 原始ch2解码、回中门禁、正反转状态及反转过渡；纯逻辑，不导入machine |
| drivers/palm_pwm.py（新） | 唯一D1 PWM输出者；构造/导入不创建PWM；独立停止与释放 |
| otto_session.py | 每拍共享一次无线读取，调用攻击控制；异常/退出同时释放两组输出 |
| tests/test_attack_control.py（新） | 输入、回中、失联、换向行为 |
| tests/test_palm_pwm.py（新） | 用假machine验证D1/freq/脉宽及释放 |
| tests/test_otto_session.py | 集成检查共享帧及退出清理，保留现有测试 |
| main.py、README.md | 只更新说明，启动仍用现有otto_session，不并行启动第二循环 |

## 任务一：确认输入及备份（不用动腿）

- [x] 读取最新代码/git状态，备份接收板待覆盖文件和版本。保留当前已能行走的配置。
- [x] 用现有serial_runtime环境识别串口。只读一次短采样：第三杆松手、推两侧、松手；确认ch2变化、ch0/ch3不被误当攻击。不要重新检测整套遥控。
- [x] 记录第三杆自然中位的稳定范围与两端值。默认参考center=1860/span=1800；用实际回中结果更新center。若ch2未变化，先查插口，不把其他活动通道自动猜成攻击轴。
- [x] 确认当前gpio21没有灯/蜂鸣器输出者；该接口本任务由巴掌独占。

## 任务二：实现独立攻击控制并做PC验证

### 配置基线

以下是首版候选，不是全都已实测；默认enabled=False完成PC测试后再随部署明确启用。

```python
ATTACK = dict(
    enabled=False, actuator='continuous',
    channel=2, center=1860, span=1800, direction=1,
    gpio=21, freq_hz=50,
    neutral_us=1500, delta_us=100,
    enter_deadband=0.15, exit_deadband=0.10,
    reverse_dwell_ms=150,
)
```

center按任务一实测替换。direction只在用户确认方向相反时改为-1。1500/±100对应候选1400/1500/1600µs，不扩大到500–2500µs。停止中位按实际不爬行校准。

### 接口与行为

```python
# attack_control.py
class AttackController:
    # update每拍返回目标脉宽；None表示禁用/失联/尚未回中，需要停止并释放。
    def __init__(self, cfg): ...
    def update(self, raw_frame, now_ms): ...

# drivers/palm_pwm.py
class PalmPwmDriver:
    def __init__(self, cfg): ...  # 不创建PWM
    def write_us(self, pulse_us): ...  # 首次需要时创建 GPIO21 的50Hz PWM
    def stop(self): ...  # 已创建才写neutral，不为了停止创建PWM
    def release(self): ...  # neutral -> duty(0) -> deinit；可重复调用
```

以上是接口约定，由执行者实现，不要将省略号当作成品上传。无需扩大UnifiedInput的所有调用点，直接复用input_adapter.valid_frame及原始frame[2]即可。

- [x] 先写行为测试，再实现纯逻辑控制器：
  - 使用 `axis=clamp((raw-center)/span*direction,-1,1)`；不是舵机角度。
  - 启动时未armed；首次有效帧且abs(axis)<=0.10后armed。启动杆偏着不转。
  - 停止时越过±0.15启动；运行时回到±0.10以内停止，形成滞回，避免中位抖动。
  - armed且中位时输出neutral；一侧输出neutral+delta、另一侧neutral-delta，与偏转幅度无关。
  - 直接跨向另一侧时先neutral至少150ms，再反向；用timeutil.diff_ms计时，不sleep阻塞主循环。过渡中松手取消反转。
  - 帧None/格式错误/禁用立即解除armed，输出None。失联恢复后，杆仍偏着也不自动再转，先回中。
  - 未变化的杆量是有效持续命令，不能凭值不变判失联。
- [x] 驱动只接受neutral±delta范围的脉宽，超出报错；不得创建S1–S4、GPIO20或改腿部PWM频率。
- [x] 只在目标变化时写脉宽即可，硬件PWM会持续输出。stop/release不使用长等待；正常中位保留neutral脉冲，退出或失联释放。

### 最小测试用例（必须明确断言）

使用10元素有效帧，ch2替换为测试值，其余轴为中位、按钮为1：

| 输入序列 | 预期 |
|---|---|
| 启动ch2=3660 | None，不转 |
| 1860 → 3660 | 1500 → 1600 |
| 1860 → 60 | 1500 → 1400 |
| 转动 → 1860 | 立即1500 |
| 转动 → None → 3660 | None → None，重连不自动启动 |
| 随后1860 → 3660 | 1500 → 1600 |
| 1600运行中反推 | 先1500，150ms之前不得1400，之后才1400 |
| direction=-1，回中后前推 | 1400 |
| enabled=False，任意输入 | None；驱动零PWM |

另测死区边界、时钟回绕、反转等待中回中、只有ch0/ch3变化时巴掌仍停、D1释放重复调用无误。测限幅不是通过把异常悄悄钳成动作。

## 任务三：接到现有行走循环

- [x] 保持otto_session现有行走参数和输入映射。将一次读取保存为raw：

```python
raw = session.link.read()
inp = input_adapter.from_rc(raw, now, cfg)
pulse = attack.update(raw, now)
if pulse is None:
    palm.release()
else:
    palm.write_us(pulse)
# 原有行走处理继续使用同一个inp。
```

- [x] 攻击停止处理应在腿部写出前完成，失联不能被腿部逻辑的continue跳过。纯攻击不应触发腿部步态；两根行走杆不改变巴掌命令。
- [x] 在现有try/finally覆盖范围内创建与使用控制器。退出时即使腿部release报错也必须执行palm.release，使用嵌套finally。不把攻击并入四关节的位置servo_angles校验。
- [x] 连续旋转控制每拍非阻塞；允许边走边攻击，不增加用户未要求的互斥。
- [x] 模拟验证：真实主循环入口共享帧、断链、抛异常、正常结束均清理D1；不声称旧版controller安全状态机自动覆盖当前直写驱动的otto_session。
- [x] 运行现有 `python -m unittest discover -s tests`，保存结果。发生无关旧测试失败时记录实际原因，不删除测试或覆盖他人改动求全绿。

## 任务四：上传与现场验收

- [x] 使用 `05_程序与测试/serial_runtime/Scripts/mpremote.exe`；按实际USB序列识别接收端。明确本次会打断正在运行的程序；不要照抄旧“resume一定保留全部状态”或“每次必然软重启”的互相矛盾描述。
- [x] 生成板端config变体，保留DRIVER='cb1_pwm'并启用ATTACK；本地sim配置不要直接覆盖。上传变动模块，板端验哈希，采用可说明的重新导入/启动路径，避免旧模块缓存。
- [x] 首先双行走杆回中。第三杆两侧各短推并松手：确认正转、反转、松手停止，记录用户方向称呼。若1500us仍慢爬，单独调neutral_us，不靠改摇杆center掩盖舵机中位误差。
- [x] 确认启动/重连时第三杆偏着不会旋转，回中后可再次操作。断遥控时D1停止，重新开遥控不能直接恢复上次攻击。
- [x] 再验证边走边转：检查舵机是否失力、板子是否重启。首版仍保持±100us，只有用户认为过慢再单独增加速度；目前仅单舵机旋转被验证，五舵机同时工作供电未验收。
- [x] 正常启动、拔掉USB用电池运行也能控制；main.py不得仍启动临时探针。结束时明确告诉用户现在是正常遥控还是调试停止状态。

## 交付与记录

- [x] 新增本次实测记录：自然回中范围、最终通道/方向/neutral/delta、正反转、松手/断链/重连、联合运行结果及未验证项。
- [x] 更新config中“不自动回中”“actuator=position”“尚未接线”等旧说明。
- [x] 更新PROJECT_CONTEXT.md、00_项目管理/继续任务_给其他Agent.md顶部及README：第三杆自动回中；ch2/L3；D1/GPIO21连续舵机；可操作方式；K4实际无功能，勿称为急停。
- [x] 只提交本任务文件，保留可回滚的已行走版本。不提交临时串口占用进程。

完成标准：用户确认两侧方向相反、松手停止、两行走杆和攻击杆互不串控；实测断链停止及重新回中门禁；电池独立运行有效。PC测试或“板端无报错”不能替代动作验收。
