paomodabaibai/CyberBrick2-User-Research-UX/02_汇报/2026-09-17_项目提案/汇报策划.md

# milk 组｜9 月 17 日项目提案汇报策划

这是今晚讨论与制作的工作稿，不是定案。老师未规定页数与时长，按约 10 分钟、10 页正文准备。汇报地点 B413，课程开始时间 08:30。

团队：milk，第 2 组。成员：傅宬博（本）、白昊灵（本）、孔舒然（本）、罗圣希（研）。具体分工待组内讨论，不按本/研身份预设职责。

用户提供的登记方向为“战斗机器人／桌面实体陪伴机器人”。明天暂聚焦已讨论的双足对战方案；若小组决定增加陪伴模式，再调整提案范围。

## 汇报要表达的核心

课题暂名：**桌面双足机器人对战交互装置**。

项目描述草稿：

> milk 组计划设计一套可由玩家遥控的桌面双足机器人对战装置。机器人采用约 10–20 厘米高的小短腿形态，上方安装巴掌或拳头等攻击模块。玩家通过移动、接近、躲避和选择出手时机，尝试将对手机器人击倒。首版暂以两台机器人完成一对一对战为目标，重点验证短腿移动、遥控响应、攻击动作和负重稳定性，并通过用户试玩调整规则和操控方式。

项目目标草稿：让初次接触的玩家能够理解移动和攻击，完成一局对战；让出手、命中、失衡与胜负能被玩家和围观者看懂；让跌倒后的复位和再次开局足够方便。评价重点包括上手难度、等待时间、误操作、胜负理解及继续游玩的意愿。

不要写成已完成用户调研，不承诺已经实现稳定行走、多机无干扰、自动起身或精确击倒检测。

## 暂定 PPT 结构

| 页 | 标题 | 页面核心内容 | 配图或证据 | 对应公告 |
|---|---|---|---|---|
| 1 | milk｜桌面双足机器人对战 | 第 2 组、课题、四位成员姓名 | 两台机器人对峙的概念主视觉 | 1、3 |
| 2 | 项目目标 | 一句话说明装置；首版做两台；希望验证的体验与功能 | 简洁的使用场景或局部大图 | 4 |
| 3 | 目标用户与使用场景 | 暂拟校园同龄人、朋友互动；需求假设与调研方法 | 两位玩家同桌对战的场景概念图 | 7 |
| 4 | 对战流程与规则 | 配对开局—移动接近—选择出手—倒地判定—复位再战 | 可编辑流程图，不用生成文字图 | 7 |
| 5 | 产品形态与动作 | 10–20 厘米、小短腿、上方轻攻击模块；前后移动、转向与攻击 | 单机外观图；尺寸注明目标值 | 5.2 |
| 6 | 结构与技术路径 | 四舵机短腿候选；内部预留主板、电池与走线；Otto/CUBY 参考 | 来源参考图＋可编辑功能分区图 | 5.2 |
| 7 | 硬件需求 | 单机需求、双机合计、遥控端、条件性扩展；平台待晚间讨论 | 硬件表，必要时把详细接线放备份页 | 5.1 |
| 8 | 技术问题与验证办法 | 舵机尺寸、重心、步态遥控、攻击复位、供电、两台同场 | 风险—验证动作对照表 | 6 |
| 9 | 六周推进安排与分工 | 本周提案选型；第 2 周小样；第 3 周单机；第 4 周双机；第 5 周试玩；第 6 周展示 | 六周时间线；分工待讨论 | 6 |
| 10 | 当前决策与希望获得的支持 | 已定/待定；向老师确认套件版本、可提供部件、课程节点 | 三个明确问题与下一步交付物 | 2、5、6 |

建议主讲控制在 9 分钟，预留约 1 分钟机动。第 1–10 页依次安排约 20、45、60、65、50、70、90、60、50、30 秒，共 540 秒。硬件与结构留足讲解时间；详细接线保留在独立文档或备份页。群聊安排不必单独占一页，记录为行政待办。

## 今晚的工作顺序

1. **小组先做关键决策**：首版是否两台、硬件版本、第一种攻击、预算/现有器材、最终交付日期。避免先把内部结构画死。
2. **锁定提案内容**：填写硬件清单；确认规则和分工；确定哪些内容明天明确向老师求助。组号与成员已补齐。
3. **生成配图**：先做主视觉和单机外观，再做使用场景；内部结构只画已知模块分区。
4. **制作 PPT 和口头讲稿**：正文精简；硬件清单保留具体数量和条件；研究来源记入备注。
5. **一起试讲**：检查时间、数字与口径；确认照片/概念图标签；导出 PPTX 与 PDF 备份。

## 配图计划

建议初始视觉方向：奶白为底色，深灰文字，两台机器人用蓝/橙区分玩家；风格亲和、轻松，保留玩具格斗的动作感。此为待确认建议，不给 milk 组虚构团队背景或名称寓意。

| 素材 | 用途 | 内容要求 | 依赖与限制 |
|---|---|---|---|
| A. 双机主视觉 | 封面 | 两台圆润小短腿机器人，在桌面上面对面；轻量软质攻击端 | 标为概念图；不展示虚构主板标识 |
| B. 单机外观 | 形态页 | 与主视觉同一机器人，清楚显示短腿、宽脚、上方攻击模块 | 硬件尺寸未定，不画精确装配或夸大承载 |
| C. 使用场景 | 用户与体验页 | 两位同龄玩家各持遥控器，同桌看着两台机器人 | 明确是情境设想，不当作用户测试记录 |
| D. 动作示意 | 玩法或动作页 | 接近、蓄势、挥臂三个状态，角色一致 | 攻击结构选定后再做；不用生成图证明机构可行 |
| E. milk 字标 | 可选 | 清晰小写 milk；可尝试奶盒与拳套的简化组合 | 优先级低于硬件内容和可读性；不必为汇报强做 logo |

最多先做 A/B/C 三张核心图；D 视需要追加。页面上的标题、箭头、尺寸和标签由 PPT 添加，保持可编辑。参考项目的实物图注明作者和来源，与本组概念图区分。

## 玩法工作稿（待组内确认）

- 首版两名玩家各操作一台机器人，以一对一完成核心验证；多人可轮换参赛。
- 输入优先简化为移动/转向摇杆与一个攻击键，不要求玩家分别控制腿部关节。
- 初版建议站稳再攻击；是否允许边走边打，在稳定性验证后决定。
- 倒地暂拟由人工判定，例如机身触地且无法维持正常站立；场边跌落、自己跌倒、同时倒地的处理需今晚统一。
- 单局时长、几局几胜、是否设置出界判负尚未确定。若明天仍未定，展示为待试玩调整规则，不写成最终规则。
- 第一版人工扶正，不把自动起身、自动裁判、血条和四机混战列为必需功能。

## 用户研究计划（尚未实施）

目标用户暂拟为校园同龄人和朋友小组。需要验证：是否愿意玩实体机器人对战；移动是否容易理解；巴掌/拳击动作是否有趣；等待复位是否打断乐趣；胜负是否清楚公平。

先用概念图和动作小样进行简短访谈，再用双机原型观察首次上手、完整对局和复玩选择。记录用户行为和原话，不以“大家应该觉得好玩”代替证据。

## 六周推进安排（建议稿）

本周是第一周，总周期约六周。以下按周安排，不把推算的日期写成老师已确定的交付日。访谈与小样观察尽早开展，第五周集中进行完整对局试玩。

| 阶段 | 任务 | 可检查的结果 |
|---|---|---|
| 第 1 周：提案与选型 | 目标用户假设、初步访谈、套件确认、器材申请与尺寸核对 | 提案、首版边界、硬件清单；实物未到则标清待测尺寸 |
| 第 2 周：结构小样 | 舵机安装试件、脚腿装配、攻击机构台架；并行测试基本遥控与舵机输出 | 核心部件能装配、不卡住；控制链路跑通 |
| 第 3 周：单机整合 | 校准、前后走、转向、停止、掉线处理；加入等重假负载 | 带目标负重可完成基础操控，再复制第二台 |
| 第 4 周：双机对战 | 攻击整合、独立配对、供电检查、完整对局 | 可开局、对战、判定、复位；留出故障调整时间 |
| 第 5 周：用户试玩与迭代 | 观察上手、规则理解、对局体验；调整动作与耐用性 | 修正主要误操作与体验中断问题，保留记录 |
| 第 6 周：收尾与展示 | 冻结核心功能、外观整理、拍摄、演示排练、备用件准备 | 实物、演示视频、设计说明与测试记录 |

第三周设检查点：若目标负重下行走仍不稳定，优先减轻上身、减小攻击模块、降低动作速度；如需改变移动结构，应及时组内讨论。不要等到第六周才整合攻击与行走，也不要在最后一周增加新模式。

## 今晚需要老师或小组确认

- 最终展示的具体日期；当前按六周课程周期准备。
- 课程提供的是 CB1 还是 CB2；具体主板、接收/发射组件、舵机与供电件型号、可用数量。
- 是否允许并支持自定义程序、额外驱动板与传感器接入。
- 小组预算、打印条件、现有硬件、成员分工。
- 首版数量、攻击结构、场地边界及判负方式。

## 群聊待办

milk 为团队名；按公告另建或重命名沟通群为“CB2-第2组”，由组员邀请老师，老师再邀请曼巴老师。未代为执行建群或邀请，完成情况待组员确认。
