paomodabaibai/CyberBrick2-User-Research-UX/04_结构与硬件/Otto_75mm巴掌腕部接口_v02/设计与实施记录.md

# 75mm巴掌腕部接口 v02 实施记录

用户已确认手掌最长边75mm、杆距51mm，并授权开始连接接口。保留这组比例，保留原v01支架与杆舵盘侧接口。

设计：杆末端两M2孔固定一块23×12×6mm连接块；连接块插入巴掌腕部矩形盲槽；一颗横向M2螺钉锁住巴掌。槽尺寸单边0.25mm设计间隙。开孔/螺母与工具空间逐项做名义检查。孔位沿用轴心到孔组中点51mm，不改变杆总长63.5mm。

坐标：转轴x=0；杆底面z=0、顶面z=3；掌腕后缘x=51，腕部参考中心z约3.03。连接块x43.5～66.5，y±6，z3～9。杆末端孔x48.5/53.5；横向锁紧孔x59,z6。保持上一比例图姿态。

步骤：
- [x] 保留原网格，另建v02；手掌转为装配坐标。
- [x] 建模连接块、螺母槽与锁紧孔；切腕部盲槽和杆避让槽。
- [x] 输出完整手掌、腕部局部样件、连接块、杆及杆末端样件。
- [x] 检查闭合网格、体积、连接件及杆干涉、螺钉通路与扳手空间。
- [x] 输出预览、装配说明及试装反馈项目。

限制：尚未完成实物装配、切片验证、强度/动态载荷验证。新增连接块可承受多少碰撞不能只凭几何检查保证。手掌保留原始高精度网格，不强行转换为假STEP实体；连接块/杆提供STEP。
