paomodabaibai/CyberBrick2-User-Research-UX/04_结构与硬件/Otto_V9腿部对中计划_v01/安装图人工对照核对单.md

# 安装图人工对照核对单（Otto V9 手册照片页 vs 四关节中位安装图_v01.svg）

用途：安装图的轴向是**运动方式+既有观察的示意推断**，不是从手册照片确认的安装方位。
本单供人工逐页对照 `01_研究参考/robot-battle-reference/manual_hi_p4.png ~ manual_hi_p9.png`
（官方手册 `OttoDIY_Manual_V9.pdf` 第 4–9 页渲染图）与
`04_结构与硬件/Otto_V9腿部对中计划_v01/四关节中位安装图_v01.svg`。
**对照结论只写"证实/不证实/手册未显示"，不写猜测角度。**

## 逐项对照

| # | 安装图中的表述 | 对照手册哪页 | 人工核对方法 | 结论（证实/不证实/手册未显示） |
|---|---|---|---|---|
| 1 | 髋舵机装在身体内，输出轴沿左右方向（水平） | p5–p6 | 看腿装配步骤中舵机在身体内的姿态与轴朝向 | ☐ |
| 2 | 踝舵机装在脚内，输出轴沿前后方向（水平），实现脚尖翘/踩 | p6–p7 | 看脚与腿连接步骤中踝舵机安装方向 | ☐ |
| 3 | 舵盘在 90° 中位时装（手册有"180°"标注，p6/p8 出现） | p6, p8 | 确认该标注是否指舵盘出厂拉平/对中位 | ☐ |
| 4 | 髋部装好后双腿呈正常站立方向（左右镜像，不要求舵盘外观同向） | p5–p6 | 对照左右腿件与舵盘装配示意 | ☐ |
| 5 | 踝部装好后脚底在站姿下平放 | p7–p8 | 对照脚件装配与整体站姿图 | ☐ |
| 6 | 手册原装为 SG90 类 9g 舵机与原配舵盘 | p3–p5 零件页 | 看零件清单页的舵机照片/型号 | ☐ |
| 7 | 左右件（腿/脚）区分标志 | p5–p7 | 找手册中的 L/R 标记方式 | ☐ |
| 8 | 花键齿数/尺寸（SG90 vs PG001 是否兼容） | — | **手册未显示花键参数**；如需确认查 PG001 规格书 `01_研究参考/CyberBrick1迁移研究/9g Servo Motor 180° - PG001.pdf` 并实测齿数 | ☐ |

## 填写规则

- 任何一项"不证实"→ 回改安装图 SVG 并在 PROJECT_CONTEXT 记录变更；**不得**凭记忆改。
- 任何一项"手册未显示"→ 安装图保留"推断"标签，现场以真实零件配合和双脚中位站姿核对。
- 核对人/日期：__________　对照后签名：__________
