paomodabaibai/CyberBrick2-User-Research-UX/04_结构与硬件/Otto_V9腿部对中计划_v01/逐关节安装记录表.md

# Otto V9 逐关节安装记录表

配套：《四关节中位安装图_v01.svg》《对中工具使用说明.md》；对中命令 `center_joint.py`；小幅测试 `bench_v02.joint()`。
填写纪律：**一关节一行、一行填完才准标 calibrated=True**；"程序跑通"不等于"标定完成"；用户观察确认列必须由用户当面确认。

**2026-09-23 现场填写**（证据等级③=用户当面观察确认；S2 型号待实物标签复核）：

| 关节 | 接口/GPIO | 舵机型号（实物核对） | 是否已拆开机械连接 | 中位命令已发（90°） | 舵盘安装姿态（齿位/朝向描述） | 正方向实际动作（+角度时） | 安全角度范围（不顶壳不顶死） | 少量 trim | 用户观察确认 |
|---|---|---|---|---|---|---|---|---|---|
| left_hip（左髋） | S1 / GPIO3 | PG001 180°（沿用，未拆换） | 是（9-23 重装舵盘） | 是（9-23 保持+重装） | 90°保持期间由用户重装，具体齿位未记 | **+3° = 左腿向前摆**（用户确认） | 待测 | 待定 | 动作方向已确认；中位已确认 |
| right_hip（右髋） | S3 / GPIO1 | PG001 180°（沿用，未拆换） | 是（9-23 重装舵盘） | 是（9-23 保持+重装） | 90°保持期间由用户重装，具体齿位未记 | **+8° = 右腿向后摆**（用户确认；与左髋相反=镜像安装） | 待测 | 待定 | 动作方向已确认；中位已确认 |
| left_ankle（左踝） | S2 / GPIO2 | 180°位置舵机已换装（用户 9-23 换上；标称 PG001，实物标签待补核） | 是（整只换装） | 是（9-23 保持12s+重装） | 90°保持期间由用户重装，具体齿位未记 | **+3° = 脚尖翘起，-3° = 脚尖压下**（用户确认，双向正常） | 待测 | 待定 | 动作双向已确认；中位已确认 |
| right_ankle（右踝） | S4 / GPIO0 | PG001 180°（沿用，未拆换） | 是（9-23 重装舵盘） | 是（9-23 保持+重装） | 90°保持期间由用户重装，具体齿位未记 | **+3° = 脚尖压下**（用户确认；与左踝相反=镜像安装） | 待测 | 待定 | 动作方向已确认；中位已确认 |

### 9-23 方向观察小结（写 config 前的实测事实）

- 双髋：+ 角度下 **左髋向前、右髋向后** —— 同一电气符号对应相反的空间方向，镜像安装证实。
  GAIT 现有 `step_sign_left=1.0 / step_sign_right=-1.0` 的默认值与该观察**方向吻合**（左步=左腿向前、右步=右腿向前），但幅度仍未经行走验证。
- 双踝：+ 角度下 **左踝翘尖、右踝压尖** —— 同样相反。GAIT 的 `ankle_sign` 是单值，按此观察左右踝需要**相反的电气符号**才能做同一方向的物理倾斜，单值 `ankle_sign=1.0` 大概率不够；进入步态调参（阶段D）前应把左右踝符号拆开（或用 JOINTS 里的 `direction` 字段实现），此改动尚未做。
- 电气中位 90°（1500µs）四路均已锁定舵盘；**尚未**记录各关节安全范围/trim，`calibrated` 四路仍为 False（诚实门槛保持：strict enable 会拒绝）。

### 9-23 排除的硬件故障（均用户在场处理）

- S2 换装后初始完全无反应 → 重插舵机插头后 0°→180°→90° 大扫动正常。**原因：插头接触不良。**
- S3 随后同样完全无反应 → 重插插头后 45°→135°→90° 扫动恢复。**原因：换 S2 舵机时碰松插头。**
- 教训：每次实机测试前先逐个按压检查四个舵机插头；"命令已发但零反应"优先查插头，再怀疑舵机。

## 逐关节操作检查单（每关节按序勾选）

1. ☑ 标明接口与实体关节，托住机器人、脚悬空，物理断电开关在手边
2. ☑ 拆开可能受力的舵盘/腿脚连接（9-23 四路均重装舵盘）
3. ☑ `center_joint.send('<关节名>', confirmed=True)` 发 90° 中位；观察舵机确实响应（四路均有动作）
4. ☑ 保持中位安装舵盘（最近齿位；明显偏斜重装，不用大 trim 迁就）
5. ☑ 按安装图接回腿/脚（用户操作完成）
6. ☑ ±3~5° 双向小幅测试，记录实际方向（S2 做了双向；S1/S3/S4 做了正向，负向=反向对称未逐一复测）
7. ☐ 填表 + 用户确认 → 才改 `config.py`：写 center/trim/direction/min/max，最后 `calibrated=True`（**安全范围/trim 未测，暂不改**）
8. ☑ 改动只动 `config.py` 条目（S2 换装即 config-only 生效：enabled+position），不改驱动源码；板上 diag 能力检查通过

## 站姿阶段（四路全部完成后）

| 检查项 | 结果 | 备注 |
|---|---|---|
| 双脚底同时接触桌面 | ☐ 是 ☐ 否 | 待测 |
| 身体无明显前后/左右倾斜 | ☐ 是 ☐ 否 | 待测 |
| 左右腿无挤压、无内八/外八 | ☐ 是 ☐ 否 | 待测 |
| 四关节向步态预计方向运动有余量 | ☐ 是 ☐ 否 | 待测 |

不满足时优先查机械安装与舵盘齿位，其次 center/trim/direction。最终配置（config.py diff）+ 照片 + 观察结果存档于本目录，作为调步态基准。

## 照片/附件清单

- [ ] 每关节中位安装照片：____（本轮未拍）
- [ ] 整机站姿照片（正面/侧面）：____
- [ ] config.py 最终 diff：S2 条目 enabled=True / actuator='position'（2026-09-23，板上 SHA256 94edd6c6…）
