paomodabaibai/CyberBrick2-User-Research-UX/05_程序与测试/CB1_Otto单步实验_v01/Otto步态拆解与本版设计.md

# Otto 步态拆解与本版设计

## 核对来源
1. https://github.com/OttoDIY/OttoDIYLib/blob/master/src/Otto.cpp
2. https://github.com/OttoDIY/OttoDIYLib/blob/master/src/Oscillator.cpp
3. https://github.com/CyberBrick-Official/CyberBrick_Controller_Core/blob/9712a8439f339a09e454baf543b8e97a5b1f03a7/docs/cyberbrick_core/lib/rc_module.rst
4. 同一CB1提交的src/app_rc/bbl/servos.py和src/app_rc/app/rc_main.py。
源文件及许可证保存在reference。Otto来源为2026-09-22下载的master快照，CB1固定提交。

## 原版实际做了什么
Otto::init 中四关节顺序YL/YR/RL/RR，即左髋、右髋、左脚踝、右脚踝。
Otto::walk 使用幅度[30,30,20,20]，偏置[0,0,4,-4]。两髋同相，两踝同相；前进时踝比髋相位偏移-90°，后退+90°。
Oscillator::refresh 用正弦函数计算位置，叠加90°和中位修正。因此可概括为：
髋角=90+trim+30*sin(相位)，脚踝角=90+trim+偏置+20*sin(相位-90°)。
这里的同相指舵机坐标，不代表镜像安装的左右脚在空间朝同一个方向。
_execute 的 steps 是周期数量，还能运行部分周期。不是用户语义的“左脚单独迈一步”。
home回到四个90°并卸力，是休息动作，不应直接当作每个遥控单步的结尾。
turn 改变两髋幅度来产生不对称步幅，不是传统有膝盖机器人的逆运动学。

## 对视频动作的解释边界
无膝盖结构通过侧倾、支撑转换和髋部旋转实现挪步；视觉上可能绕支撑脚转动。
真实足迹取决于关节方向、重心、地面摩擦与打滑，不能只凭程序保证理想半圆，也不能保证每步固定多少毫米。

## 本版选择
不是直接移植原版阻塞正弦循环，也不是直接截取walk(0.5)。选择独立编写的四阶段插值状态机，借鉴原版髋/踝协调思路。
每20ms更新：移重心 -> 指定脚卸载 -> 髋部摆动 -> 脚踝回到支撑姿态。三次平滑插值减少阶段切换的速度突变。
起始hip=8°、lean=7°、lift=3°、每阶段450ms，仅为小幅标定起点，不是已经验证的落地参数。
末端保留髋部位置，下一侧步向相反髋部位置摆动。首步从0到一侧，因此小于后续两端之间的摆幅。
连续同侧被明确拒绝：没有验证如何重新准备同侧而不产生倒退或拖脚。先达成首步任选、左右交替、一次触发一次完整序列。
名义左/右、支撑侧与方向全部需要实机确认。尤其“卸载”只是目标动作名称，程序没有足底压力传感器，不能确认已经离地。

## 安全与后续
停止保留最后腿姿态，是停止继续运动，不保证机器人站稳。异常退出释放PWM，需人工支撑。
遥控官方接口返回10项原始值，文档称失联返回None；原生模块未提供新包序号，必须实测失联行为。不能把杆值没变化等同失联。
本版无自动找零、无角度传感器、无IMU平衡、无自动起身；所有角度是命令而非实测。
下一轮根据实测修正脚踝符号、支撑侧、幅度和相位，再研究重复同侧、转弯、后退。
