paomodabaibai/CyberBrick2-User-Research-UX/05_程序与测试/CB1_Otto控制框架_v02/任务汇报_v02_2026-09-22.md

# v02 控制框架任务汇报（交付验收用）

日期：2026-09-22 深夜。执行：ZCode 会话。状态：**纯软件阶段完成，全程未连接、未驱动实机**（规格红线，已遵守）。
本汇报写给验收 Agent。所有可复现命令见第 7 节。

## 1. 任务与规格要点（对照）

任务：在 `05_程序与测试/CB1_Otto控制框架_v02/` 建立正式控制软件框架。硬性要求：

1. v01 原样保留 ✅（本轮未改 v01 任何文件）
2. 本阶段不得连接或驱动实机 ✅（无任何串口/mpremote 操作）
3. 左摇杆前推=左脚单步请求，右=右脚；单步为四关节协调动作 ✅
4. 依赖单向：遥控原始数据→标准输入→动作请求→状态机→步态阶段→关节轨迹→驱动输出；**摇杆代码不得直写舵机角度** ✅（input_adapter/command_mapper 中无任何 pose/PWM 写路径，测试12同时验证 sim 模式下 machine 模块从未被导入）
5. 五阶段单步（预备/移重心/卸载摆动/落脚/稳定）✅
6. 首步左/右均可发起；之后必须交替 ✅
7. 同侧连续步：显式策略接口，当前返回"尚未支持" ✅（`same_side_strategy()` → `'not_supported'`，抛 `SameSideNotSupported`）
8. 时间驱动、非阻塞、20ms 主循环 ✅（`controller.update(inp, now_ms)` 纯增量时间；测试11证明 dt 抖动不改变结果）
9. 超限拒绝而非钳位 ✅（`LimitViolation` 整组动作拒绝，测试10b：hip_swing=40 时 plan 直接抛）
10. 停止≠松开输出 ✅（`stop()` 冻结姿态进 STOPPED；`release_output()` 才断 PWM；测试8验证步态中途停止冻结且 driver 未 released）
11. 故障需显式恢复 ✅（失联→FAULT；重连不自动恢复，测试9/9b；FAULT 中 `enable()` 抛异常）
12. K4 急停优先 ✅（测试8a）

## 2. 交付清单

| 项 | 位置 | 状态 |
|---|---|---|
| 完整源码 | v02 目录：config / input_adapter / command_mapper / states / controller / gait_planner / trajectory / joint_model / drivers(sim+cb1_pwm) / simulator / **main_v02.py** | ✅ |
| 一条命令演示 | `python run_demo.py` | ✅ 16s 回放，14 事件，输出 CSV+2 张 SVG |
| 自动测试及结果 | `python -m unittest discover -s tests`，**32 项全绿** | ✅ 存档 `output/测试结果_2026-09-22.txt` |
| 角度曲线与阶段记录 | `output/demo_joints.svg`（四关节+offset 曲线+事件竖线）、`output/demo_phases.svg`（状态/阶段时间带）、`output/demo_log.csv`（801 行 20ms 全量） | ✅ |
| 参数说明 | `参数说明与硬件接入清单.md`：参数总表 + 真机接入安全清单 + 标定顺序 | ✅ |
| 更新后的交接文档 | 根 `PROJECT_CONTEXT.md`（新增 v02 章节）、`00_项目管理/继续任务_给其他Agent.md`（第四次更新） | ✅ |
| README | `README.md`（架构图、验收语义对照表） | ✅ |

## 3. 架构（数据流即依赖方向）

```
rc 10值帧 ──input_adapter.from_rc──▶ UnifiedInput(±1标准化)
        └─ BoardSession(main_v02, 板载) ─┐
                                          ▼
                              command_mapper（事件过滤：单步触发/保持不重复/回中再武装/
                                          双推冲突/繁忙丢弃/失联去重）
                                          ▼
                              controller（DISABLED/READY/WALKING/STOPPED/FAULT 状态机）
                                          ▼
                              gait_planner（五阶段；同侧→策略接口；支撑侧策略）
                                          ▼
                              trajectory（分段+smoothstep，纯时间驱动，连续性由构造保证）
                                          ▼
                              joint_model（offset→舵机角→脉宽；超限抛异常绝不钳位）
                                          ▼
                              drivers 工厂：sim_driver（默认，只记录）| cb1_pwm（machine 懒加载，
                                          GPIO10==0 认板断言，硬跳过 left_ankle/S2 写入）
```

步态五阶段（以左脚为例，s=+1）：prepare（踝回中）→ weight_shift（双踝 s·lean 移重心）→
unload_swing（摆动踝 s·(lean+lift) 卸载）→ land（髋 s·hip 落脚，踝回中）→ stabilize（保持）。
单步 ≈1800ms（250/450/450/350/300）。

## 4. 演示事件时间线（run_demo.py 实际输出）

```
t=     0  ready     enabled (stance commanded)          显式使能
t=   200  walking   step start left                     首步（左）
t=  2000  ready     step done left  pose=[8, 8, 0, 0]
t=  2600  walking   step start right                    交替步
t=  4400  ready     step done right pose=[-8,-8, 0, 0]
t=  5000  walking   step start left
t=  5800  walking   request dropped: step in progress   繁忙丢弃（不排队）
t=  7200  ready     request rejected: both levers forward (conflict)
t=  8000  ready     request rejected (left): same-side ... not in v02
t=  9000  walking   step start right                    回中后干净步
t= 10500  stopped   stop during right step: K4 pressed  中途急停，姿态冻结
t= 12500  fault     FAULT: link lost
t= 14200  fault     request rejected (right): state=fault   故障中拒绝
（脚本尾） recover() → final state: ready                      显式恢复
```

## 5. 开发过程中发现并修复的问题（供验收重点复核）

1. **simulator 日志丢失 bug**：`_log` 用 `self._pending = []` 重绑定新列表，controller 日志绑定在旧列表 append 上，导致除第一条外全部事件丢失。已改为 `del self._pending[:]` 原地清空。
2. **mapper 事件重复**：失联每 20ms 刷一条 `link_lost`、busy 丢弃每拍重复。改为每次失联只发一次、丢弃只报一次（`_link_ok` 翻转检测 + ready 消费）。
3. **controller 吞事件**：`rejected_conflict`/`dropped_busy` 由 mapper 发出但 controller 不记日志（注释错误声称已记）。已在 controller.update 统一补日志。
4. **stop_button 索引越界（测试抓到的真 bug）**：config 按 v01 习惯填全帧索引 9，而 `from_rc` 是 `frame[6 + stop_button]`，10 值帧直接 IndexError。已改为按钮组内 0 基偏移（K4→3）并在 config 注释说明。**v01/v02 索引约定不同，接手者注意。**
5. **开机摇杆已推即走（安全设计补强）**：`ENABLE_ON_FIRST_LINK` 使能帧若摇杆已前推会立即触发步态。BoardSession 初始化把 mapper 置为未武装，上电后摇杆必须先回中一次才允许触发（有专门测试）。

## 6. 已知边界与未验证项（验收时应视为"未完成"而非缺陷）

- **一切未经真机验证**：本阶段规格禁止连实机。`main_v02.py` 板上运行、cb1_pwm 驱动、REAL 映射均待明天上机。
- config 的 center/trim/direction 全为标称占位（90/0/1），镜像安装的符号语义（v01 遗留 LEFT_SIGN）未定标；步态参数是保守起点非行走证明。
- `ENABLE_ON_FIRST_LINK=True` 是我替用户做的默认决策（K4 只当急停、无使能按钮），已写入 config 注释与硬件清单，**请用户确认是否接受**。
- 同侧连续步、后退、直接摇杆姿态模式均为显式接口占位（not_supported / NotImplementedError）。
- 演示是软件回放，不能推断物理平衡。

## 7. 验收复现命令（系统 python 即可，无需依赖安装）

```bash
cd "E:\课程作业\大三上\张茫 用户研究与体验设计\05_程序与测试\CB1_Otto控制框架_v02"
python -m unittest discover -s tests -v      # 期望：Ran 32 tests ... OK
python run_demo.py                            # 期望：14 events，final state: ready
```

产物核对：`output/demo_log.csv`（801 行）、`output/demo_joints.svg`、`output/demo_phases.svg`、
`output/测试结果_2026-09-22.txt`。

建议的验收检查点：
1. 12 项验收语义逐条对照第 1 节表格抽查源码（尤其：摇杆层无 PWM 路径、超限不钳位、停止/释放分离）。
2. `cb1_pwm.py` 确认：machine 仅函数内导入；`left_ankle` 写入被硬跳过；GPIO10 认板断言。
3. 确认 v01 目录未改动（对照 git？项目无 git，可对照现场调试记录的最新状态速览）。
4. 对 `main_v02.py` 的 ENABLE_ON_FIRST_LINK 与开机武装策略提出意见（见第 6 节第 3 条）。

## 8. 下一步（需用户在场）

1. 用户确认 ENABLE_ON_FIRST_LINK 设计（或改为按钮使能方案）。
2. 真机会话按《参数说明与硬件接入清单.md》第 2 节顺序执行：上传 11 个文件 → SHA256 校验 → `run main_v02.py` → 中位观察 → 标定 trim/direction → LEFT_SIGN → 托住单步。
3. 硬件前置不变：左踝 180° PG001 到货前不开完整步态；S2/360°舵机只允许中位。
