paomodabaibai/CyberBrick2-User-Research-UX/05_程序与测试/CB1_Otto控制框架_v02/待上传_双机统一控制_2026-10-20/先看这里_双机上传说明.md

# 双机统一控制与巴掌版K4跳舞

2026-10-20。用户要求两台机器人只有攻击单轴摇杆行为不同，其他操控完全一致。延续“先在电脑解决、回家再上传”的约束。

**状态：电脑端199项测试通过，未连接串口、未上传、未驱动机器人。新旧机上文件没有读取，不把软件回归当成物理验收。**

## 最终控制表

| 操作 | 两台共同的行为 |
|---|---|
| 两行走杆同推/同拉 | 前进/后退 |
| 单行走杆前推/后拉 | 对应前进/后退弧线；后拉不再使用前进踝相位 |
| 行走杆回中 | 平滑收步至站姿 |
| 运动中前后换向 | 先收至零幅度，再切换方向起步 |
| K4（ch9，低电平）按住 | 暂停行走输入、停止攻击，四关节随机交替跳舞 |
| K4松开 | 结束舞蹈，恢复行走；攻击杆需回中后重新偏转 |
| 上电 | 持续遥控，无倒计时；三个摇杆回中0.5秒使能 |
| 失联/无效帧/异常 | 停止攻击并释放腿PWM，恢复链路后重新回中使能 |

唯一产品功能差异：拳头ch2上推M1慢拳1024，下推快拳1800，松杆停；巴掌ch2两侧为D1正/反转1700/1300µs，回中1500µs，反向跨越时保留150ms中立停顿。两台攻击都在K4按住时停止，不允许一台舞蹈中继续攻击。

## 共同参数与迁移影响

- 两台使用同一 `robot_remote.py`；无复制的舞蹈/行走控制函数。
- 统一髋30°、踝20°、偏置±4°、周期1000ms、起止渐变500ms、满杆髋差幅3:1。
- 统一舞蹈每关节±25°，幅值80–100%，300ms移动+150ms保持，舞蹈角度65–115°；行走髋角度60–120°，踝仍65–115°。
- 用户明确要求以原巴掌版为准，最终共同采用髋30/踝20，替代上一轮保守20/16方案。第一台原步幅不再收小；第二台髋范围从65–115扩大到60–120以容纳±30，尚待实际净空/碰壳与负载确认。没有复制第一台个体机械偏航补偿steer_trim=0.2；共享直行补偿仍为0，须实机按漂移分别判断。
- 遥控器实测中位各自保留，这是ADC校准，不是产品功能差异：巴掌左1797/右1959/攻击1860；拳头左2051/右2128/攻击2146。通道两者都是左ch3/右ch0/攻击ch2/K4ch9。
- 新巴掌入口绕过旧 `otto_session` 和config.OTTO。旧文件作为历史/独立调试工具保留，不要手动调用旧会话后判断统一版没有跳舞。
- `second_punch_remote.py` 为历史兼容转发；实际逻辑已迁到 `robot_remote.py`。将来改行走或舞蹈只改共同核心，并给两板上传相同文件。

## 入口和文件清单

正式源码在 `E:/课程作业/milk-github-sync/05_程序与测试/CB1_Otto控制框架_v02`。

### 巴掌接收板：9个文件

| 源文件 | 板上路径 |
|---|---|
| palm_main.py | main.py |
| palm_remote_ready.py | palm_remote_ready.py |
| robot_remote.py | robot_remote.py |
| otto_oscillator.py | otto_oscillator.py |
| attack_control.py | attack_control.py |
| input_adapter.py | input_adapter.py |
| timeutil.py | timeutil.py |
| drivers/__init__.py | drivers/__init__.py |
| drivers/palm_pwm.py | drivers/palm_pwm.py |

仓库main.py是 `import palm_main` 的巴掌启动入口；为减少现场文件数量，待上传包已把palm_main.py直接命名为main.py，**按包内路径传即可**。无需另传palm_main.py。

### 拳头接收板：5个文件

| 源文件 | 板上路径 |
|---|---|
| second_punch_main.py | main.py |
| second_remote_ready.py | second_remote_ready.py |
| robot_remote.py | robot_remote.py |
| otto_oscillator.py | otto_oscillator.py |
| second_punch_remote.py | second_punch_remote.py（旧导入兼容） |

发射板、无线配对与原厂固件不需要更改。两个包的robot_remote.py和otto_oscillator.py须字节相同。

原项目待上传包：`E:/课程作业/大三上/张茫 用户研究与体验设计/05_程序与测试/CB1_Otto控制框架_v02/待上传_双机统一控制_2026-10-20`。

**本包取代上一轮“只上传second_punch_remote.py一份”的方案。** 单文件旧包保留作历史，但其中README已标记过期；本轮共同核心是新依赖，不能只覆盖兼容入口。

## 验证

1. 抽取共享核心后，原第二台34项相关测试先通过，确认重构没有改变原测试行为。
2. 新增14项双机与D1集成测试（含原巴掌幅度一致性），先确认原核心不支持palm攻击参数，再实现通过。
3. 对两台**实际profile入口**注入校准后的等效摇杆帧，在完整时钟下比较四个GPIO的PWM脉宽；包括行走、后退、K4开始/保持/松开、链路断开，输出逐拍一致。
4. 同时覆盖D1两方向、K4期间1500µs停止、松开恢复、攻击杆保持不回中不重启、失联释放、D1异常释放全部腿、palm模式不导入M1驱动、错误GPIO/标定参数在硬件导入前拒绝、两启动文件共享run_forever、异常延迟重试。
5. 最终完整回归：**199项，21.174秒，OK**。包含上一轮11项单杆倒退回归及原攻击/舞蹈测试。

`tests/test_shared_robot_remote.py` 是新集成测试。旧第二台测试改为直接对 `robot_remote` 做边界模拟，不用兼容模块的私有变量打补丁。

## 回来后的现场步骤

1. 识别两块接收板，备份实际板上启动和控制文件；不要仅凭COM号判断是哪台。
2. 分别传包内的接收板文件，先依赖、最后main.py；两板都核对文件哈希再复位，避免MicroPython旧模块缓存。
3. 启动日志应出现 `cb1-shared-palm-gait-30-20-2026-10-20`，随后分别是 `CB1 palm` / `CB1 punch`。
4. 回中使能后，分别确认单杆前后弧线；按住K4跳、松开停止并恢复；最后确认各自攻击杆原有功能与K4期间停止攻击。
5. 再做独立电池、主动断链、落地净空与长时运行。第一台新舞蹈和统一幅度尚未有用户动作确认，不能标记实机验收完成。
