paomodabaibai/CyberBrick2-User-Research-UX/06_游戏设计/打印脱落球靶_v09/发给组员_球靶打印简版/先看我_打印说明.txt

球靶打印说明——给负责打印的同学

这是一套球靶的打印文件。一套共9件，每个STL各打印1个。
先打印一套，装好试打后再复制第二套。

怎么打印：
1. 将“打印这9件_各1个”里的STL导入切片软件，作为9个独立零件。
2. 保持100%尺寸、文件原来的朝向。可以自动排版，不要自动定向。
3. 建议PLA、0.4mm喷嘴、0.2mm层高、4圈墙、25%填充。
4. 04磁铁托座、06球下半壳、07球上半壳：开启支撑，建议“仅接触热床”。
   其他6件通常无需支撑。
5. 两个半球加外侧Brim（防翘边）。打印后从半球大开口清理内部支撑，保持磁铁小孔通畅。
6. 一块板放不下就分几次打印，保持每件数量为1即可。

打印完共9件，看“零件对照图.png”清点，带回来装配即可。
无需打印任何“小样”；它们只是检查孔径的试配块，已从此包移除。

装配需要另外准备：
M3×30螺丝2颗、M3×16螺丝2颗、普通M3六角螺母4颗；
CyberBrick套件Ø4×2mm磁铁先用2枚，吸力不足时用6枚；少量胶。

这套是首版试装件，打印松紧与磁力要靠实物确认。
不需要负责打印的同学调机器人、买电路或研究建模文件。
