paomodabaibai/CyberBrick2-User-Research-UX/04_结构与硬件/拳头_整体比例预览_v02/说明.md

# 比例调整预览 v02（2026-09-28）

用户要求：亲自微调拳头旋转、模块整体后移及拳头前伸，确定参数后再做结构确认。本版不输出可打印件。

- 初始拳头高度42mm，沿用用户最近预览选择；其余新增参数初始为0。
- 三轴角度绕腕后端中心旋转，顺序为X侧倾→Y俯仰→Z平面转向，使用右手规则。只旋转拳头，不旋转滑架。
- 模块位移范围-60..20mm，负值后移；平台、电机、导杆、曲柄、连杆、滑架、拳头共同移动。机身/双足/套圈固定；现有安装连接未重新设计。
- 腕部延长范围0..80mm：滑架到拳头的输出延长示意，蓝色方杆。不是曲柄到滑架的内部连杆长度；内部连杆孔距34mm、曲柄半径10mm、行程20mm保持不变。
- 数值框及滑块同步；界面状态记录高度、Z/Y/X旋转、模块位移、腕部延长、曲柄角度。可以切换俯视/侧面/正面/立体和收回/打出。
- 中轴虚线为Y=0、Z=45.8的出拳轴投影。拳尖突出量按旋转后网格最大X相对于前支架X=78计算，收回与打出相差20mm；仅突出量，不代表整个拳头无干涉。
- 默认俯视以便校正；模型网格简化、部分齿轮隐藏规则继承v01。界面同一入口，v01源文件仍保留。
- 浏览器验证：三轴、后移、延长输入改变读数与形状；收回/打出切换正常，375px宽无横向溢出，无脚本异常。测试用的-25mm/35mm/8°/5°/-3°仅为测试，不是用户选定方案。

待用户确定参数后：记录正式值，复核拳头全行程与导杆/前支座避让，设计腕部固定与延长杆、重做后移安装座，再检查机身内部空间、重量及实机平衡。不能仅凭模块后移宣称重心已合适。
