paomodabaibai/CyberBrick2-User-Research-UX/04_结构与硬件/拳头_整体比例预览_v01/说明.md

# 新拳头与机构比例预览 v01

2026-09-28：使用用户AI拳头STL与队友assembly_180deg.glb，加入原版Otto身体、腿、脚进行比例展示；未改动原CAD、STL或控制程序。

预览入口：C:\Users\Administrator\.codex\visualizations\2026\09\14\01a09d93-5828-7951-8f50-b4e4bdacf50a\otto-fist-proportions.html

- 默认拳头高度45mm，可调30–70mm；长约0.98529×高度、宽约0.66861×高度。此范围是视觉探索，非可制造范围。
- 原模型腕朝+Y，旋转至机构出拳+X；腕末端中心约原坐标X=0.14354、Z=0.473214。腕后面示意对齐滑架X=s+10、Y=0、Z=45.8。
- 原Otto模型左右为X轴，预览旋转90度，使左右与机构Y轴一致；身体顶部Z=0。
- 机构保持原毫米比例，行程按r=10、L=34的几何关系计算；支持完整0–360度位置与收回/打出。
- 新拳头未切插槽、未开固定孔，当前只是按腕基准叠放，和滑架的重叠不是已完成装配。需特别复核偏置的拳头侧面与两根导杆/前支座的避让；放大后可能干涉。
- 使用简化三角网格提升交互性能，省略内部齿轮和可选传感器支架。预览不是加工图或连续碰撞验证。
- 完成浏览器核对：控件45→60mm读数更新、打出20mm、无JavaScript异常，375px宽无水平溢出；已查看默认45mm截图。截图preview_45mm.png供接手参考。

用户选定比例后，再适配腕部接口、必要前伸或偏置、减重，并重新做全行程干涉核对。
