paomodabaibai/CyberBrick2-User-Research-UX/01_研究参考/CyberBrick1迁移研究/PG001尺寸图.png

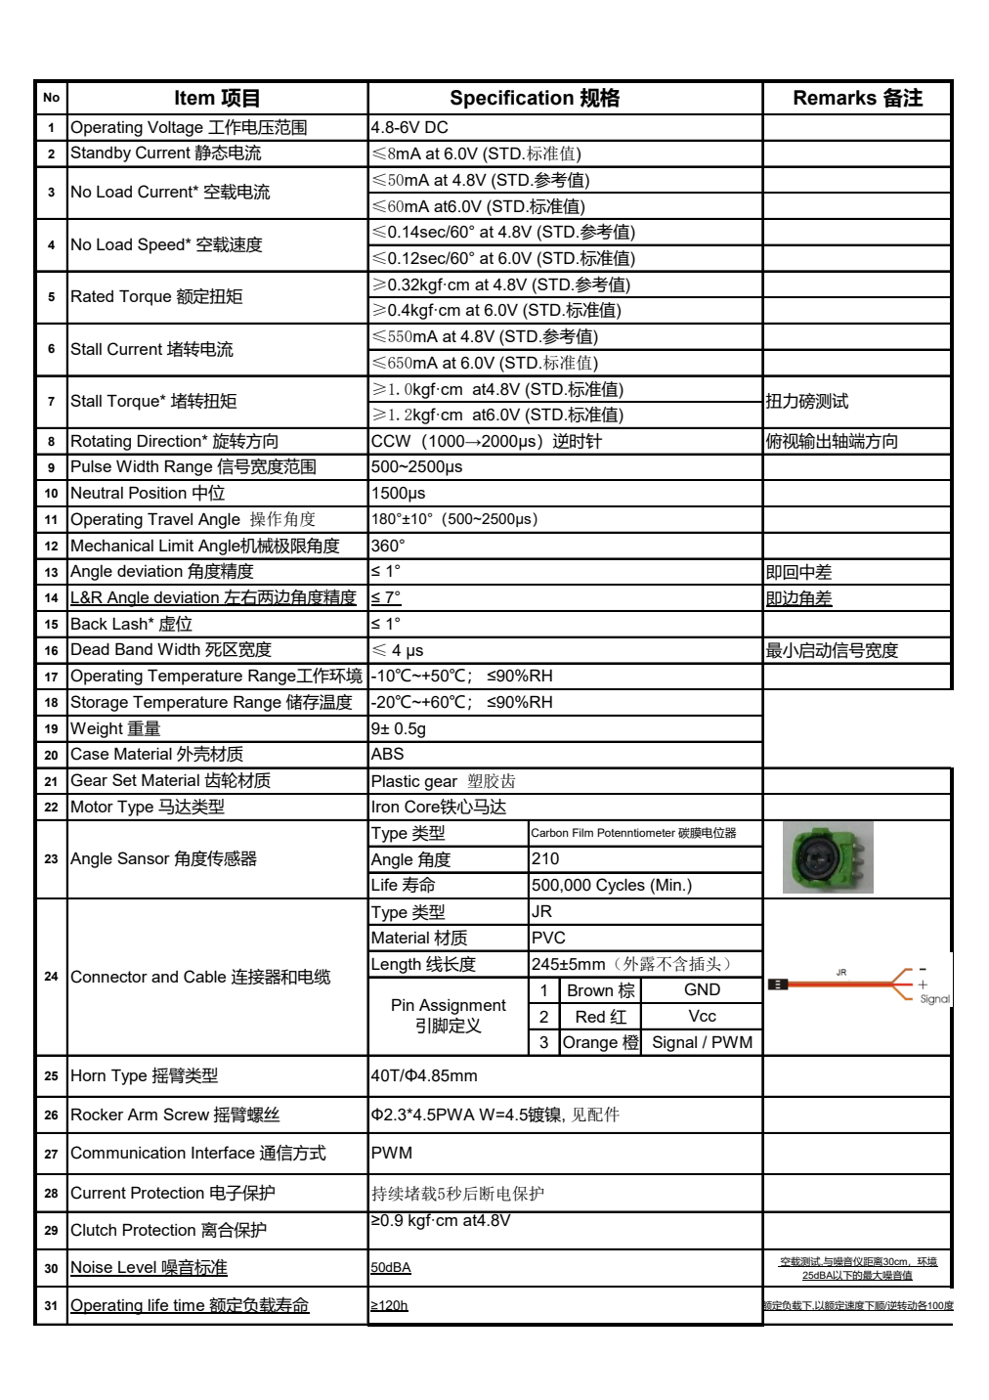
01_研究参考/CyberBrick1迁移研究/PG001尺寸图.png
