paomodabaibai/CyberBrick2-User-Research-UX/01_研究参考/CyberBrick1迁移研究/PG001机械尺寸.png

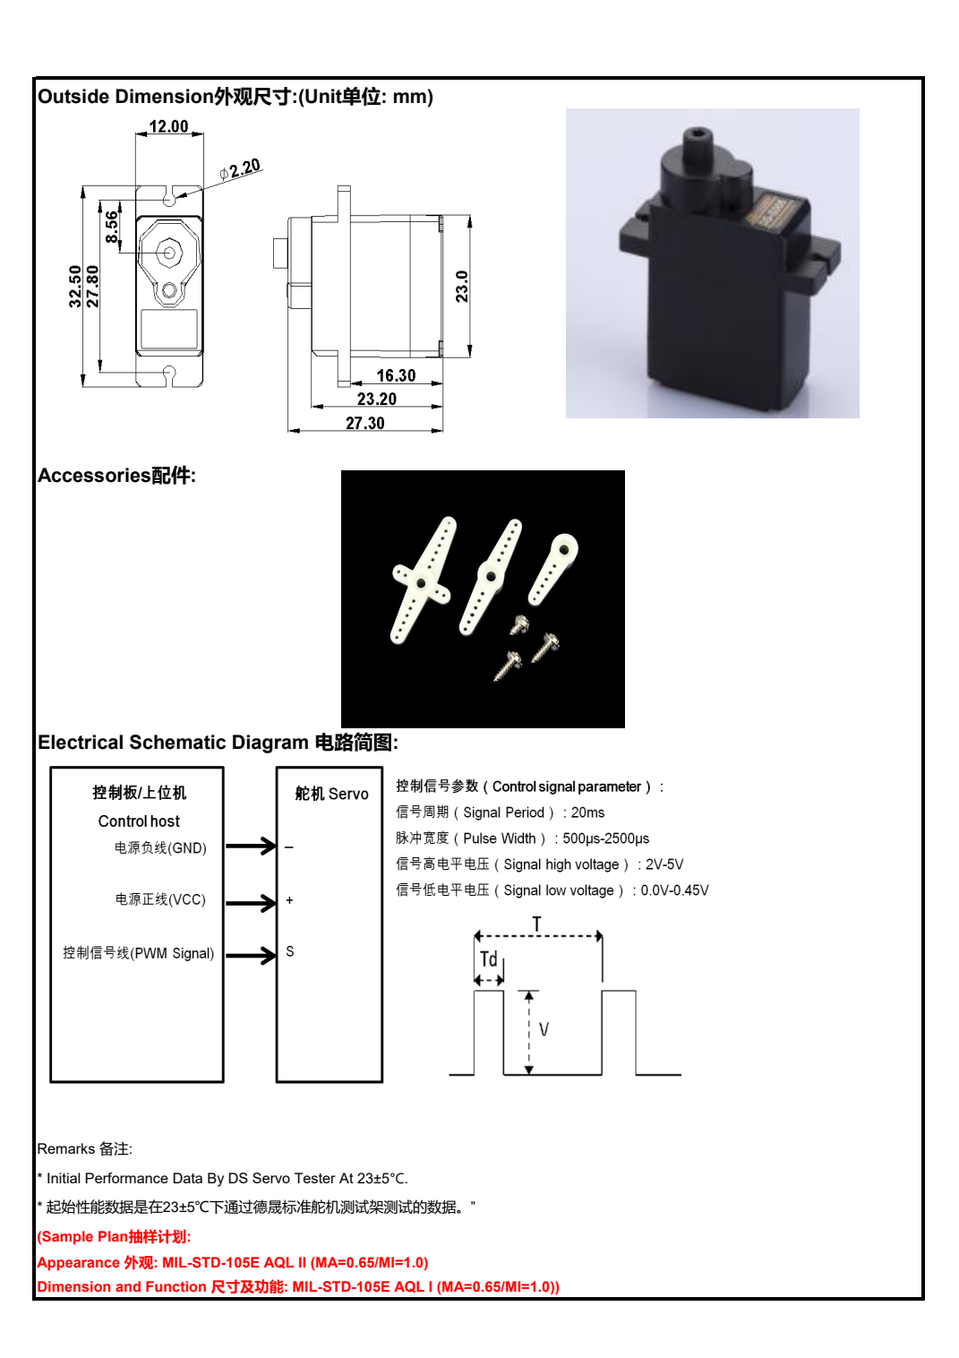
01_研究参考/CyberBrick1迁移研究/PG001机械尺寸.png
