paomodabaibai/CyberBrick2-User-Research-UX/02_汇报/2026-10-22_项目问题与迭代总结/配图总览.jpg

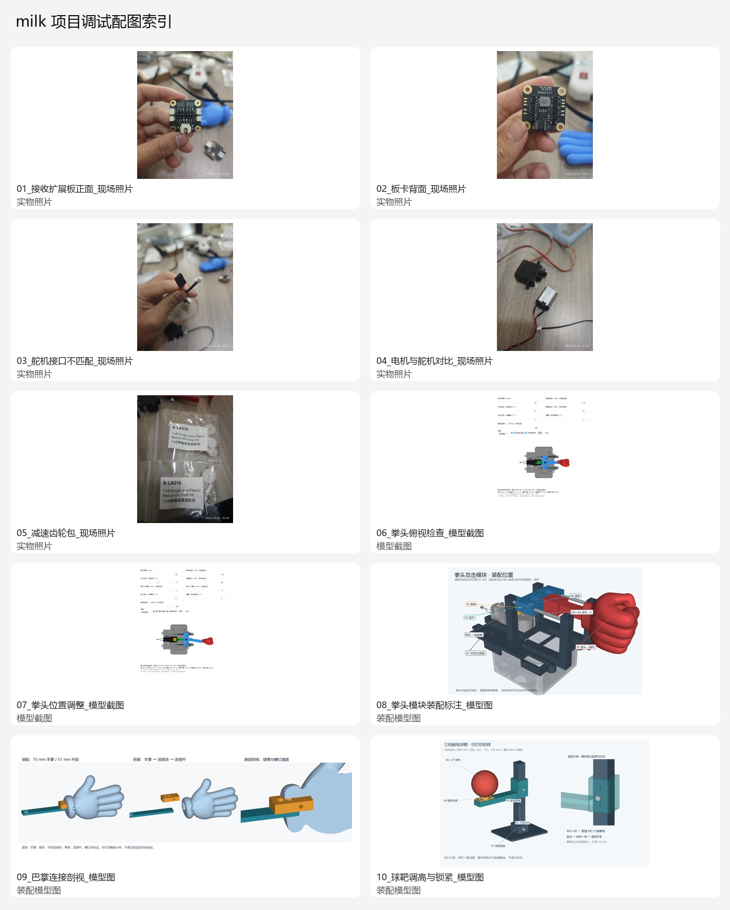
02_汇报/2026-10-22_项目问题与迭代总结/配图总览.jpg
