paomodabaibai/CyberBrick2-User-Research-UX/02_汇报/2026-10-22_项目问题与迭代总结/配图素材/04_电机与舵机对比_现场照片.jpg

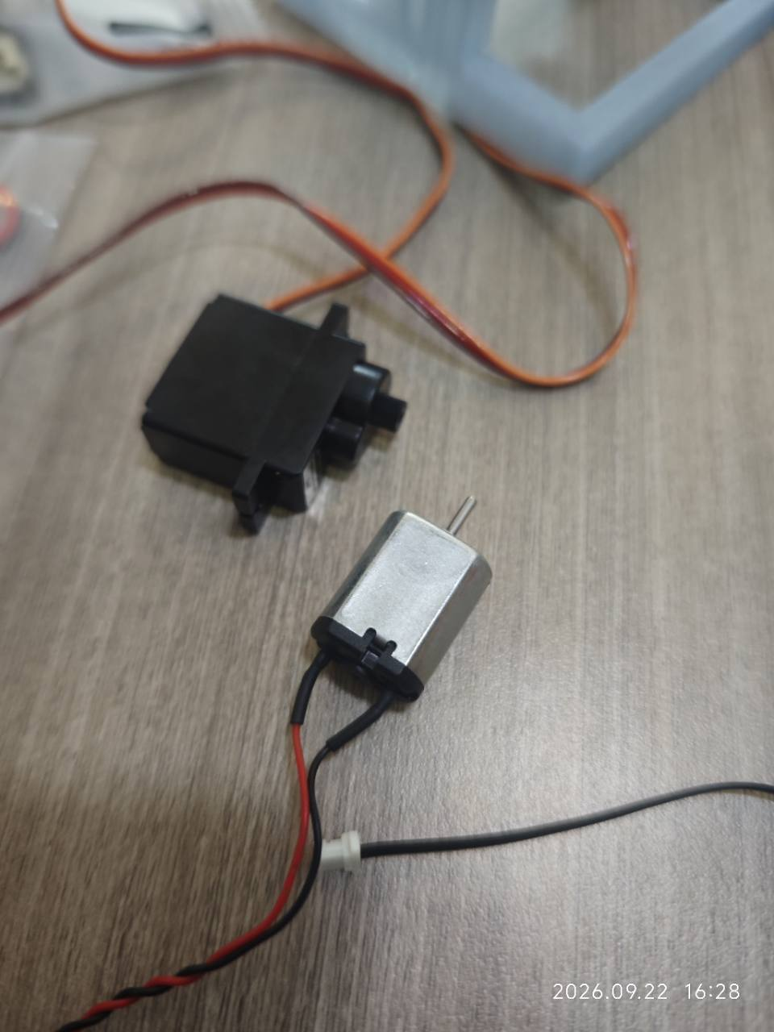
02_汇报/2026-10-22_项目问题与迭代总结/配图素材/04_电机与舵机对比_现场照片.jpg
