paomodabaibai/CyberBrick2-User-Research-UX/02_汇报/2026-10-22_项目问题与迭代总结/配图素材/09_巴掌连接剖视_模型图.png

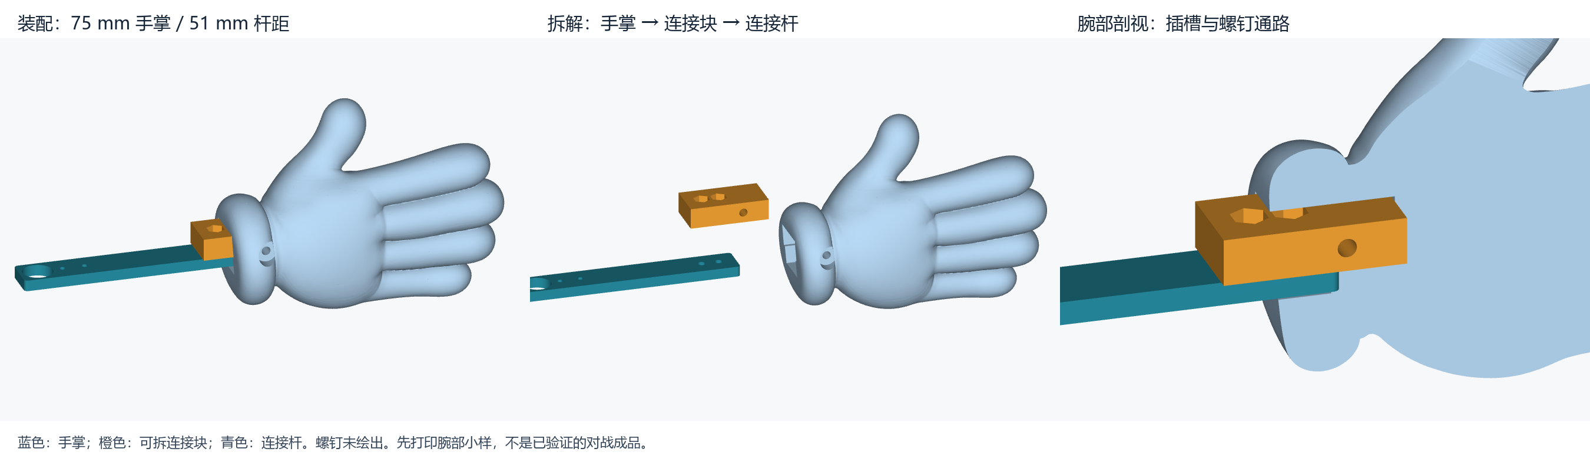
02_汇报/2026-10-22_项目问题与迭代总结/配图素材/09_巴掌连接剖视_模型图.png
