paomodabaibai/CyberBrick2-User-Research-UX/02_汇报/2026-10-22_项目问题与迭代总结/配图素材/10_球靶调高与锁紧_模型图.png

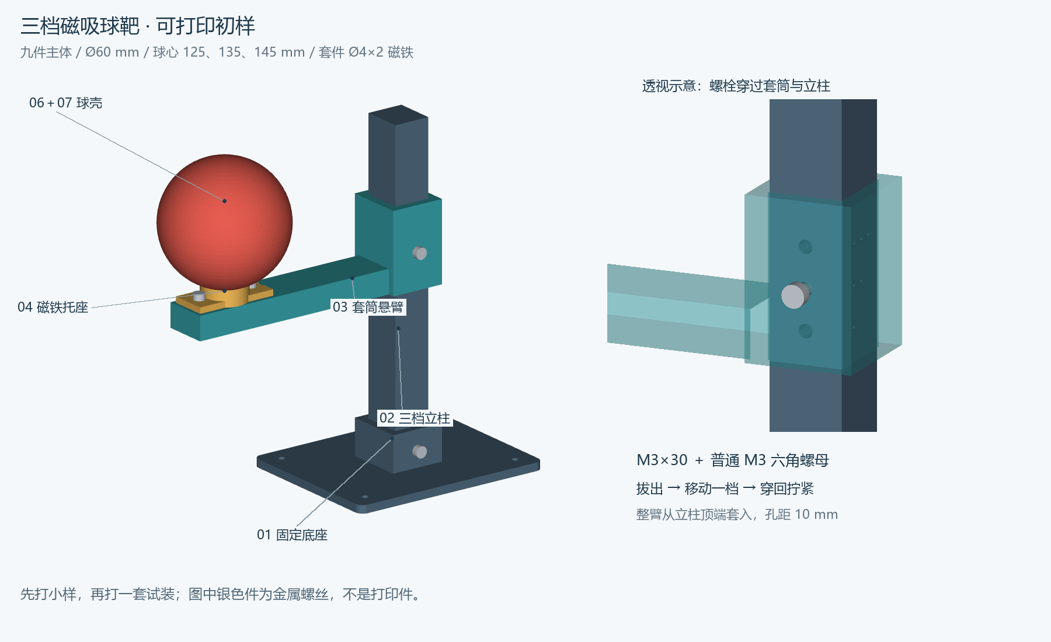
02_汇报/2026-10-22_项目问题与迭代总结/配图素材/10_球靶调高与锁紧_模型图.png
