paomodabaibai/CyberBrick2-User-Research-UX/03_视觉素材/milk_slap_blue_concept_v01.png

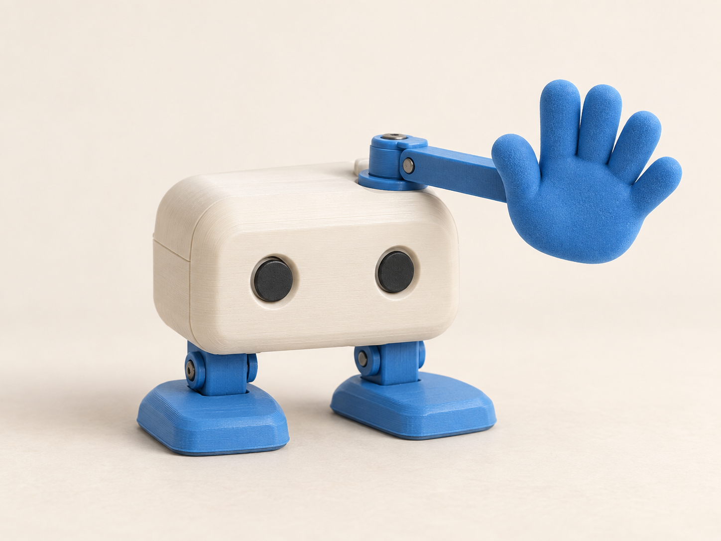
03_视觉素材/milk_slap_blue_concept_v01.png
