paomodabaibai/CyberBrick2-User-Research-UX/03_视觉素材/儿童围观对战_过肩镜头_2026-10-21/02_女孩肩后_决胜欢呼_16x9.png

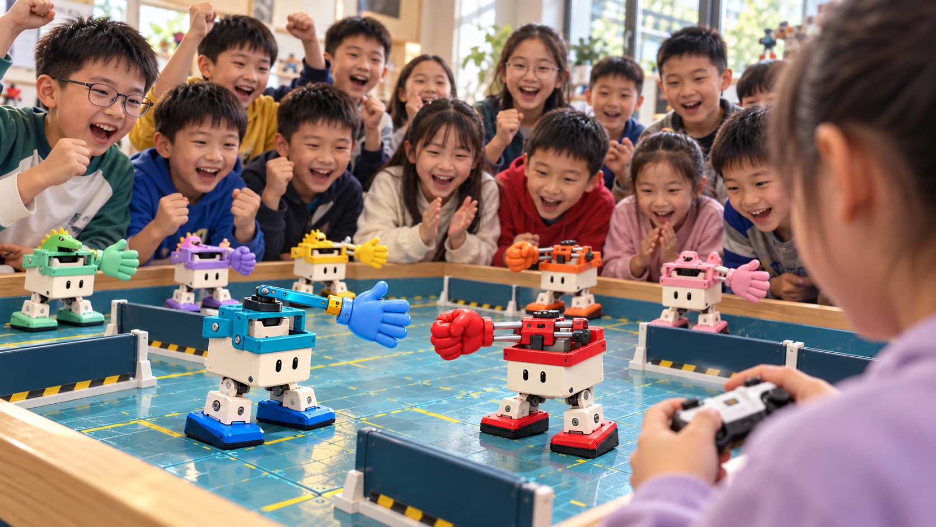
03_视觉素材/儿童围观对战_过肩镜头_2026-10-21/02_女孩肩后_决胜欢呼_16x9.png
