paomodabaibai/CyberBrick2-User-Research-UX/03_视觉素材/儿童围观对战_过肩镜头_2026-10-21/03_双人肩间_机器人主视角_16x9.png

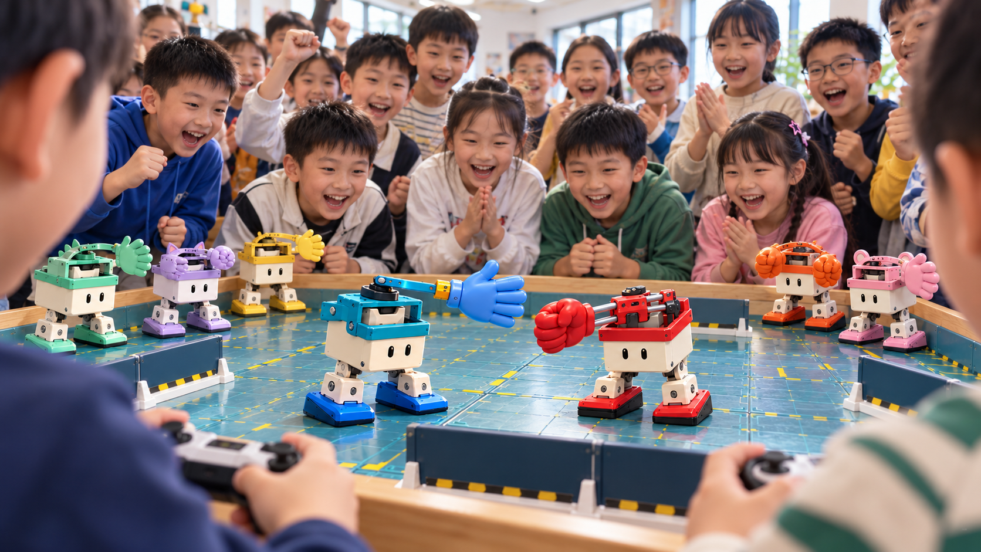
03_视觉素材/儿童围观对战_过肩镜头_2026-10-21/03_双人肩间_机器人主视角_16x9.png
