paomodabaibai/CyberBrick2-User-Research-UX/03_视觉素材/儿童试玩场景_2026-10-21/01_地板试玩_16x9.png

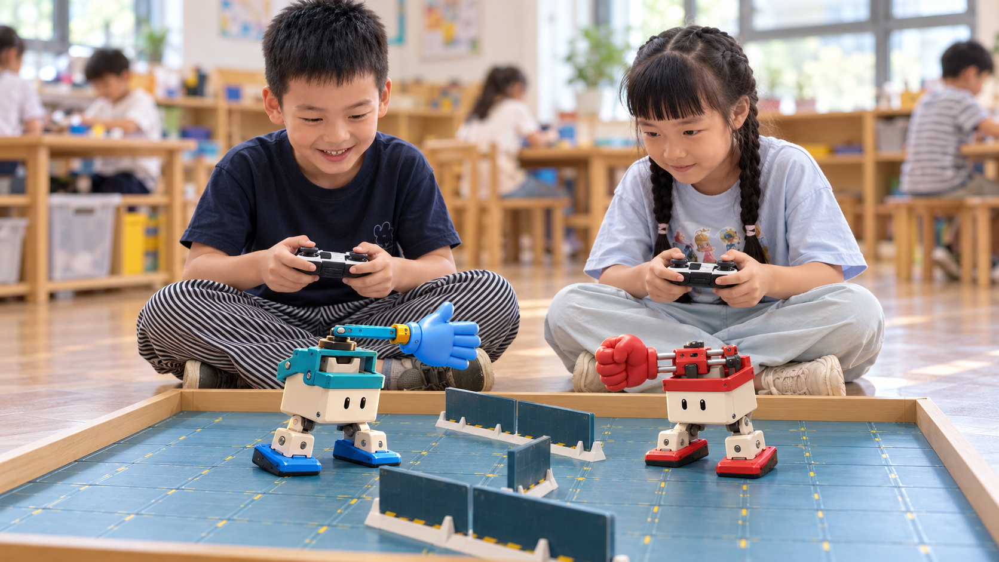
03_视觉素材/儿童试玩场景_2026-10-21/01_地板试玩_16x9.png
