paomodabaibai/CyberBrick2-User-Research-UX/03_视觉素材/地图双机纯插图_2026-10-21/地图与双机_纯插图_v01.png

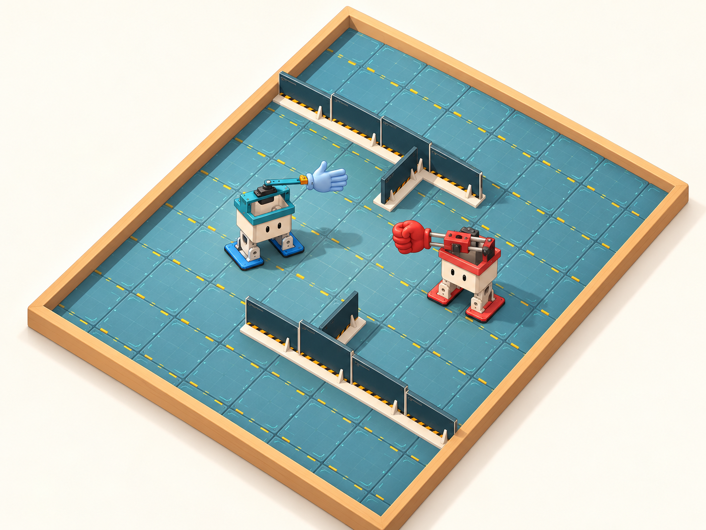
03_视觉素材/地图双机纯插图_2026-10-21/地图与双机_纯插图_v01.png
