paomodabaibai/CyberBrick2-User-Research-UX/03_视觉素材/巴掌_Tripo参考_v01/白色卡通巴掌_v01.png

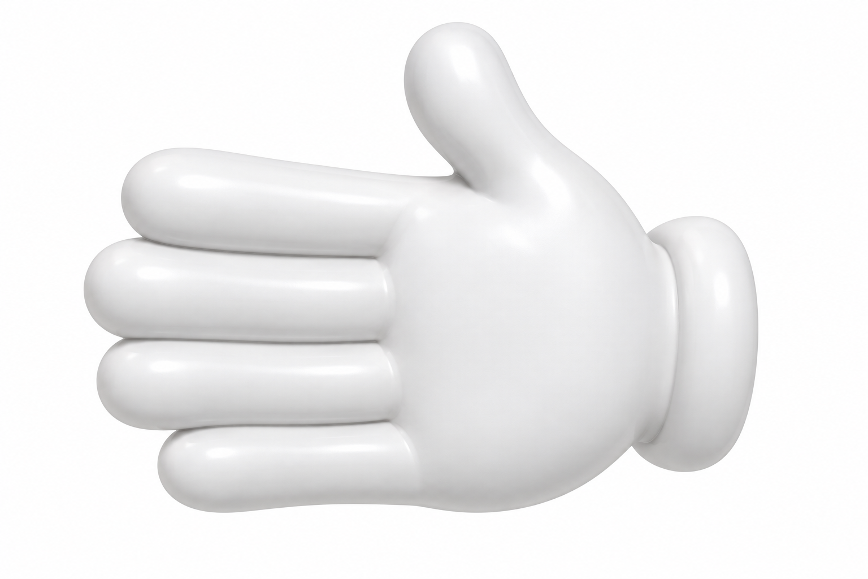
03_视觉素材/巴掌_Tripo参考_v01/白色卡通巴掌_v01.png
