paomodabaibai/CyberBrick2-User-Research-UX/04_结构与硬件/2026-09-21_整机首轮试打印包/整机总装_v02.png

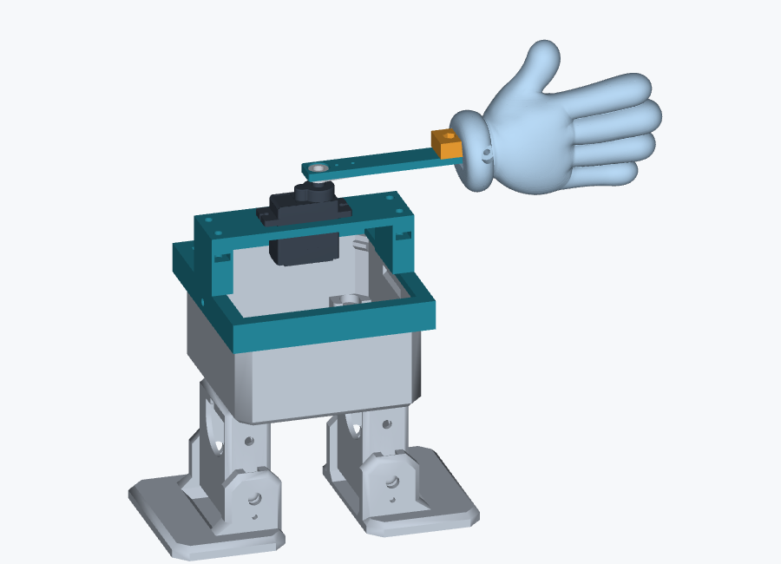
04_结构与硬件/2026-09-21_整机首轮试打印包/整机总装_v02.png
