paomodabaibai/CyberBrick2-User-Research-UX/04_结构与硬件/Otto_CB1出拳头部_v01/参考资料/motor_spec.png

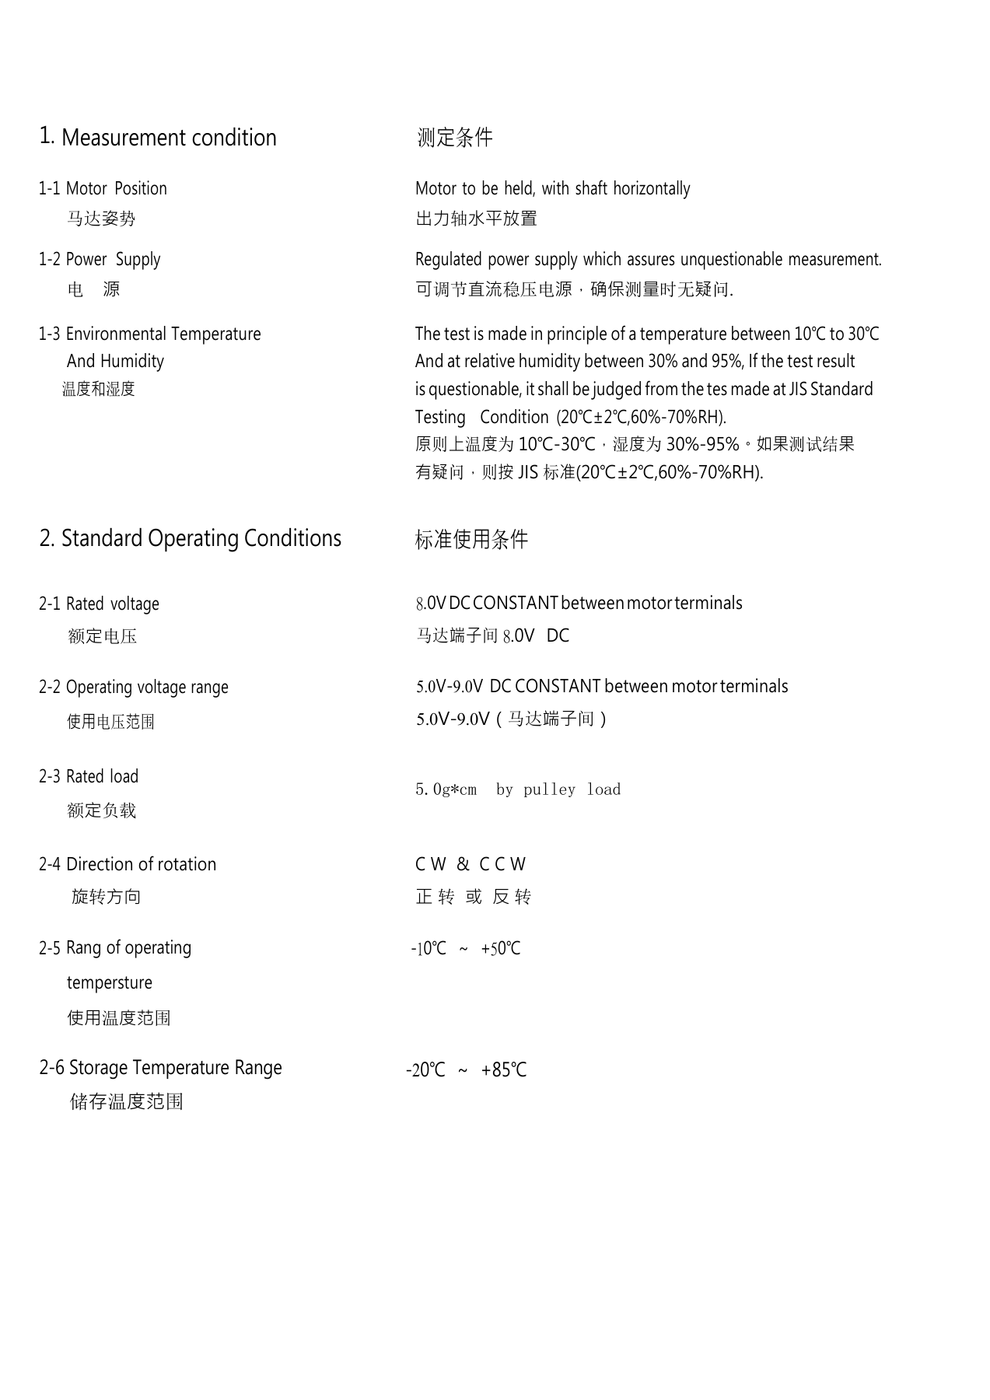
04_结构与硬件/Otto_CB1出拳头部_v01/参考资料/motor_spec.png
