paomodabaibai/CyberBrick2-User-Research-UX/04_结构与硬件/PG001尺寸图_用户提供.jpg

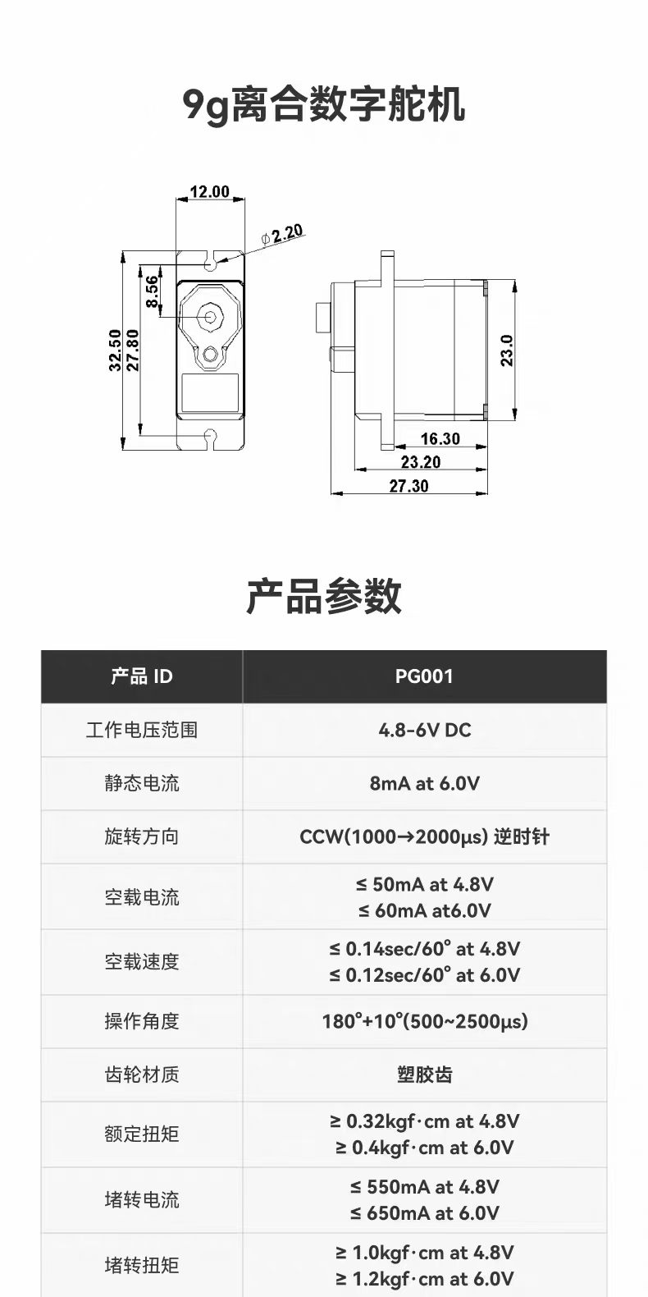
04_结构与硬件/PG001尺寸图_用户提供.jpg
