paomodabaibai/CyberBrick2-User-Research-UX/04_结构与硬件/巴掌_Tripo网格与尺寸调整/交互预览检查.png

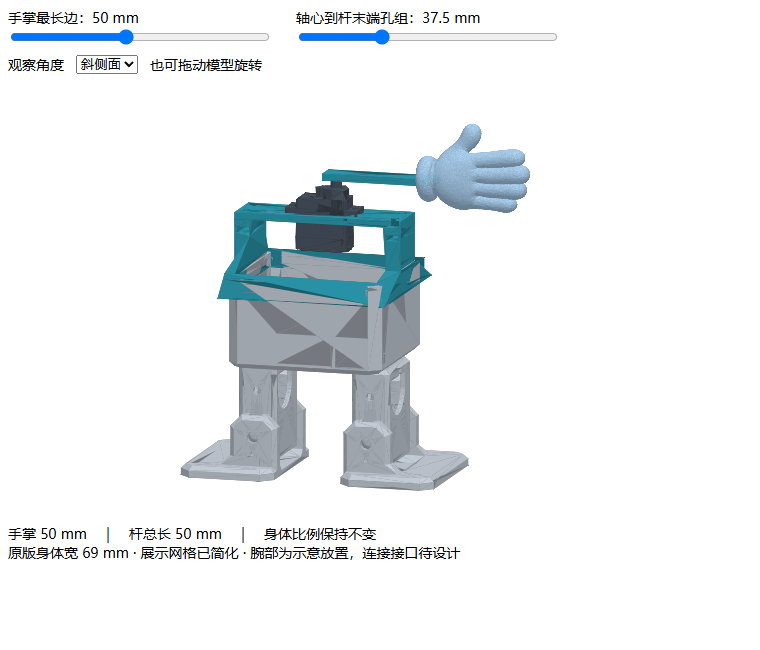
04_结构与硬件/巴掌_Tripo网格与尺寸调整/交互预览检查.png
