paomodabaibai/CyberBrick2-User-Research-UX/04_结构与硬件/巴掌_Tripo网格与尺寸调整/整机比例三方案.png

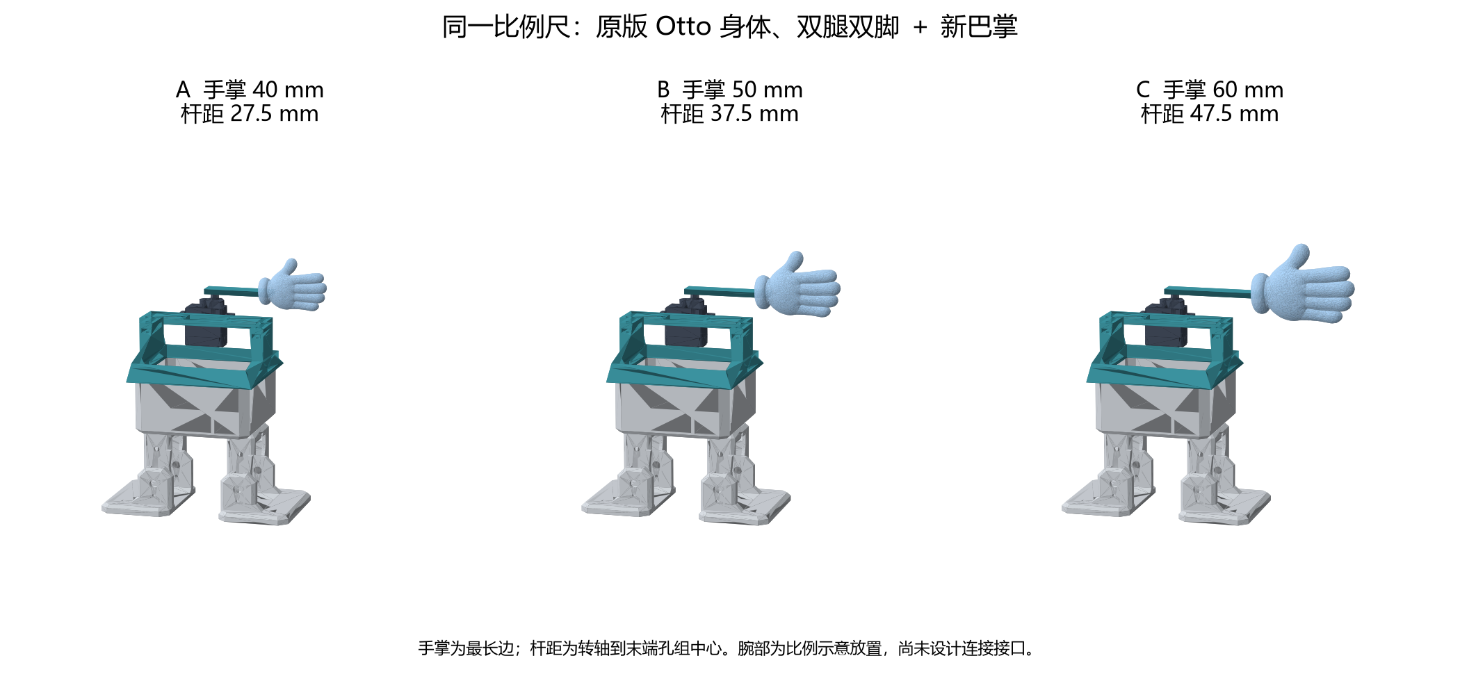
04_结构与硬件/巴掌_Tripo网格与尺寸调整/整机比例三方案.png
