paomodabaibai/CyberBrick2-User-Research-UX/04_结构与硬件/拳头_3D生成参考/红色拳头_单体三维参考_v04.png

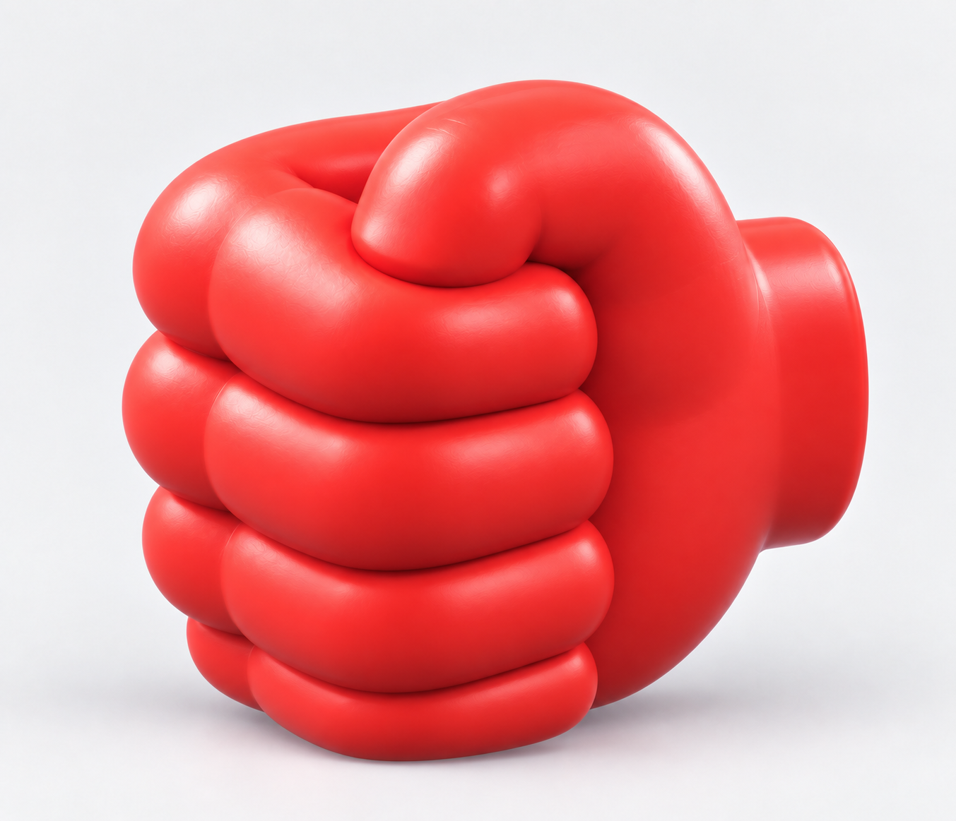
04_结构与硬件/拳头_3D生成参考/红色拳头_单体三维参考_v04.png
