paomodabaibai/CyberBrick2-User-Research-UX/04_结构与硬件/拳头_整体比例预览_v03/check_adjusted.png

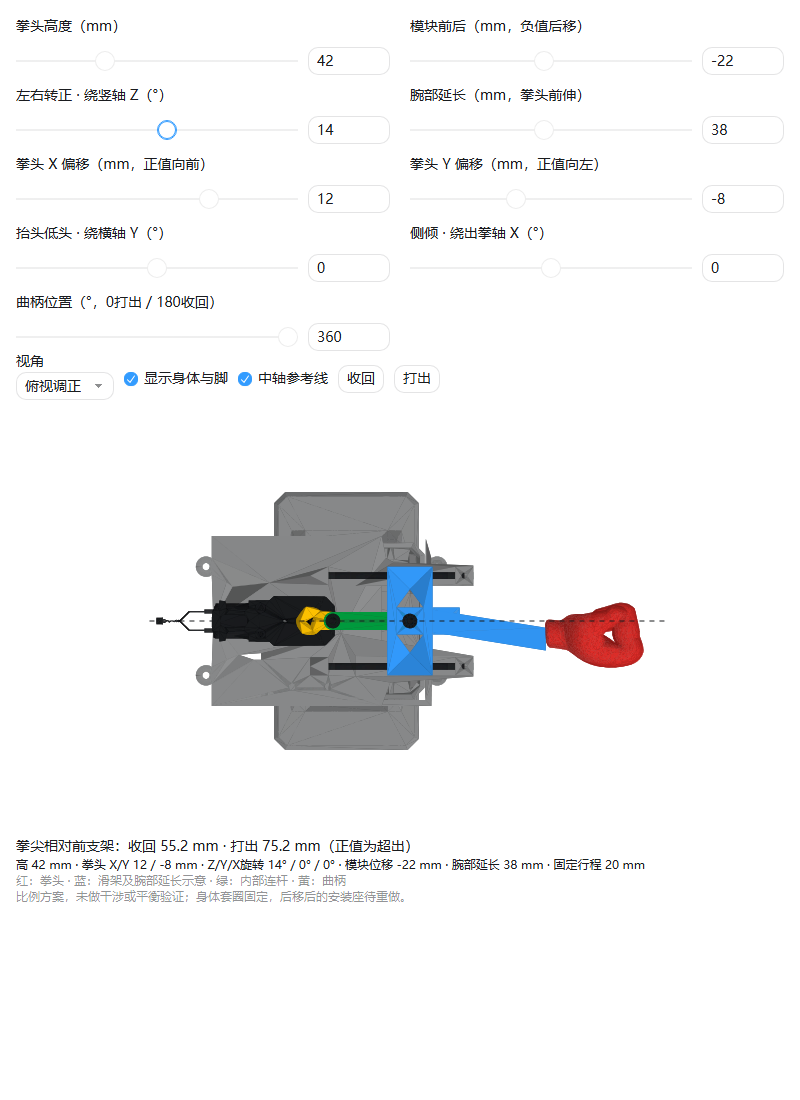
04_结构与硬件/拳头_整体比例预览_v03/check_adjusted.png
