paomodabaibai/CyberBrick2-User-Research-UX/06_游戏设计/Figma制作图与3D_v08/3d/arena_A_ready_figma.png

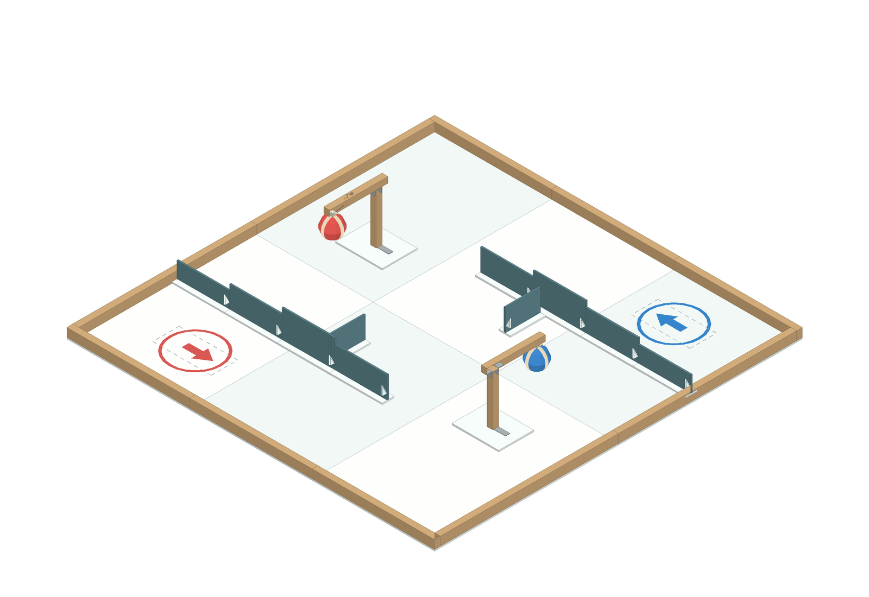
06_游戏设计/Figma制作图与3D_v08/3d/arena_A_ready_figma.png
