paomodabaibai/CyberBrick2-User-Research-UX/06_游戏设计/Figma制作图与3D_v08/3d/target_released.png

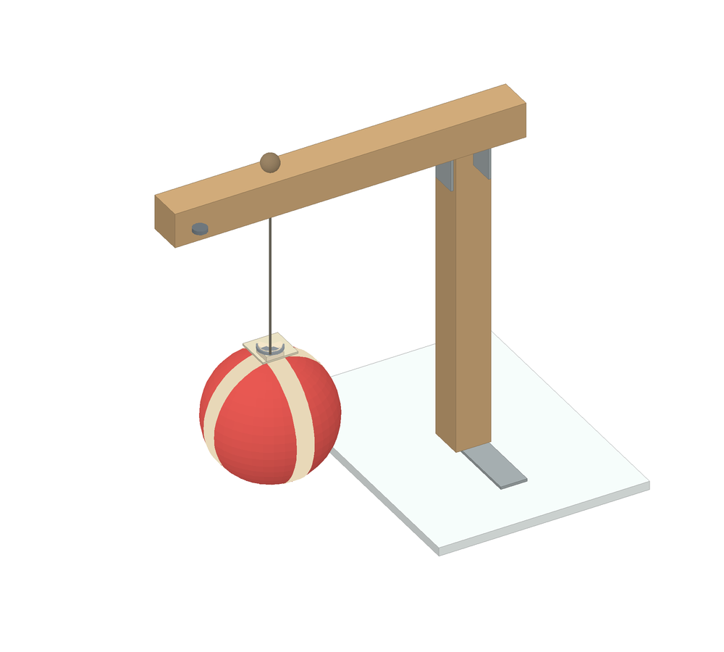
06_游戏设计/Figma制作图与3D_v08/3d/target_released.png
