paomodabaibai/CyberBrick2-User-Research-UX/06_游戏设计/Figma制作图与3D_v08/3d/wall_180_H80.png

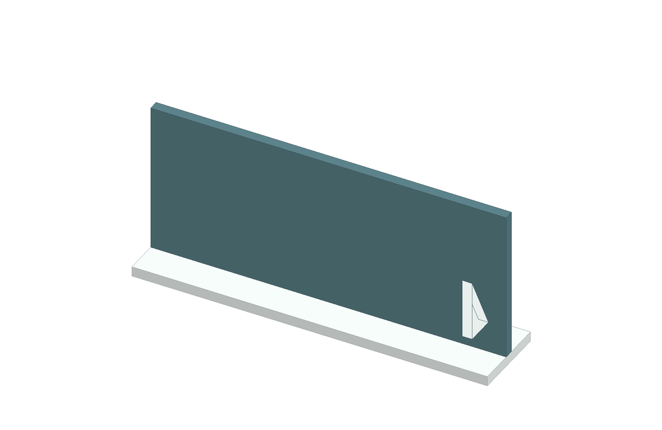
06_游戏设计/Figma制作图与3D_v08/3d/wall_180_H80.png
