paomodabaibai/CyberBrick2-User-Research-UX/06_游戏设计/地板无缝纹理_80x120cm_v09/preview/地板整体效果.png

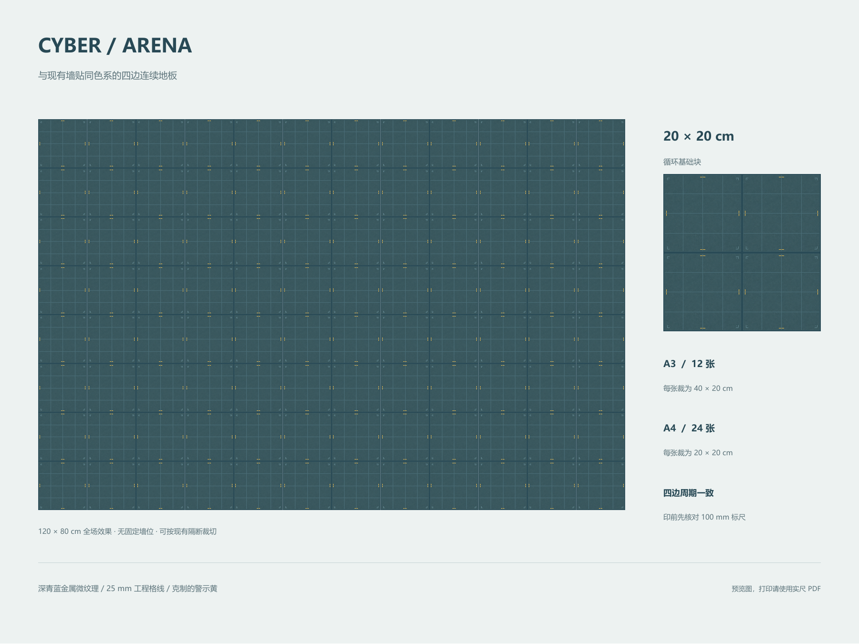
06_游戏设计/地板无缝纹理_80x120cm_v09/preview/地板整体效果.png
