paomodabaibai/CyberBrick2-User-Research-UX/06_游戏设计/地板无缝纹理_80x120cm_v09/source/青蓝金属材质_imagegen原图.png

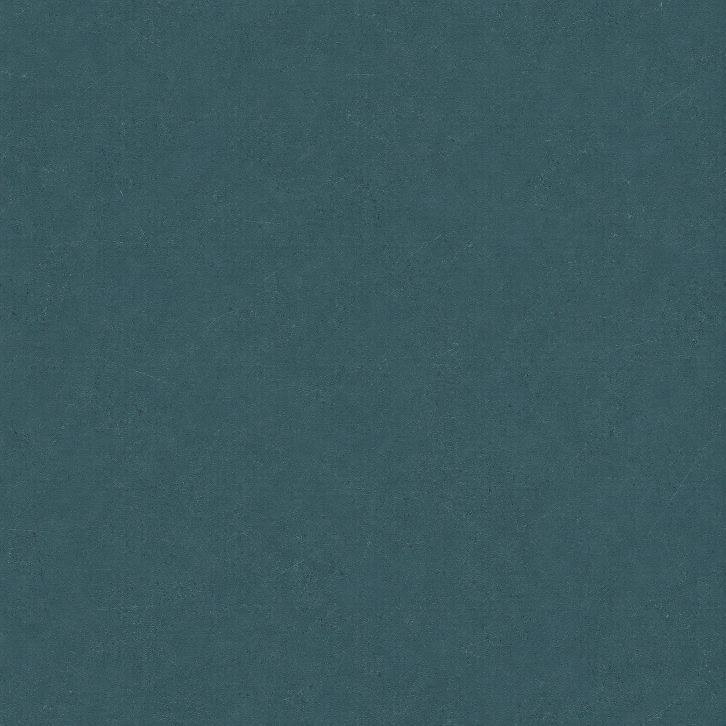
06_游戏设计/地板无缝纹理_80x120cm_v09/source/青蓝金属材质_imagegen原图.png
