paomodabaibai/CyberBrick2-User-Research-UX/06_游戏设计/手工制作与贴图_v07/output/preview/墙面贴图预览.png

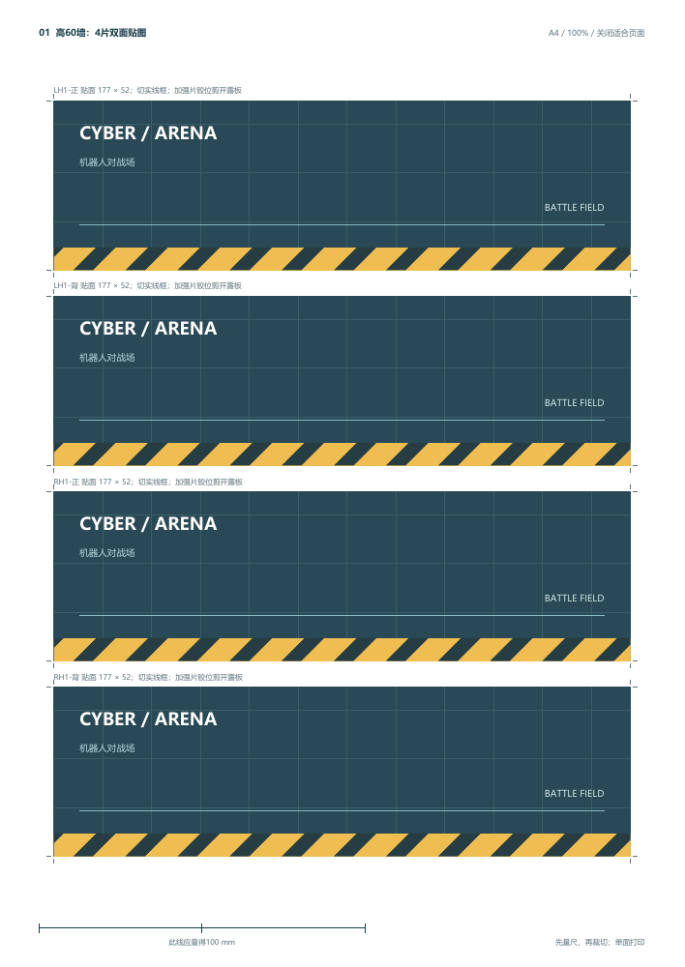
06_游戏设计/手工制作与贴图_v07/output/preview/墙面贴图预览.png
