paomodabaibai/CyberBrick2-User-Research-UX/06_游戏设计/手工制作与贴图_v07/output/preview/裁切单预览.png

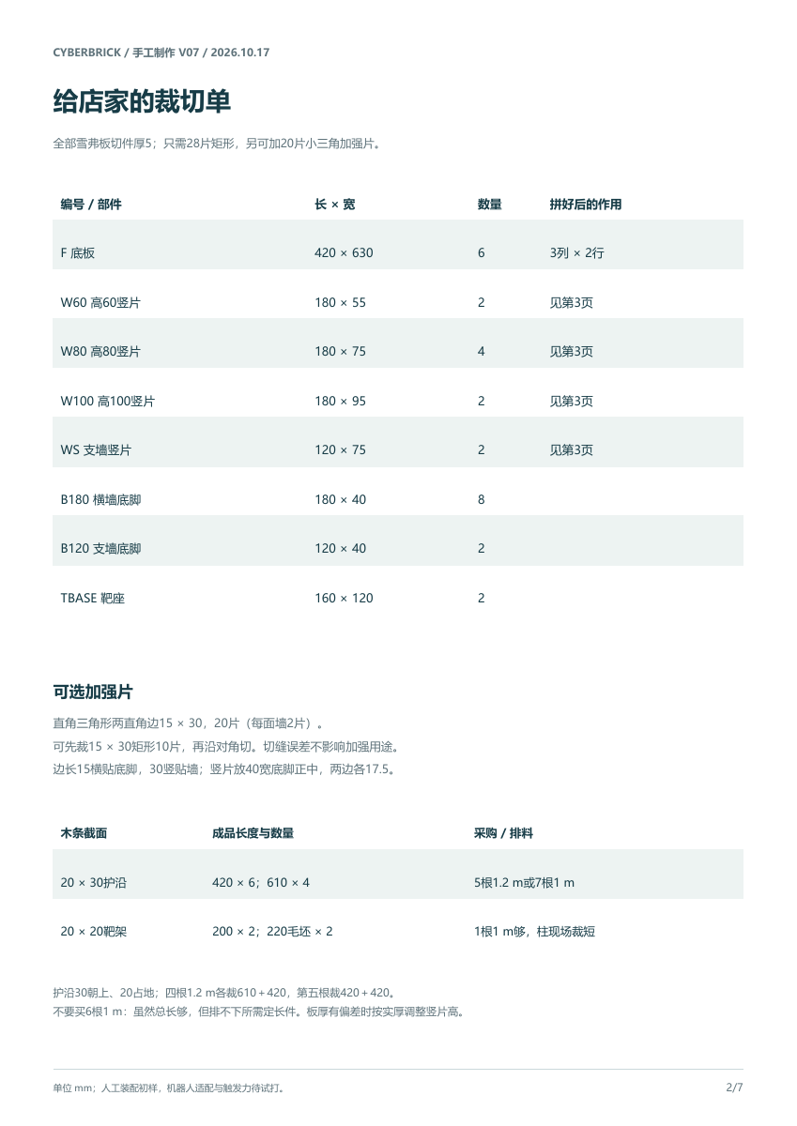
06_游戏设计/手工制作与贴图_v07/output/preview/裁切单预览.png
