paomodabaibai/CyberBrick2-User-Research-UX/06_游戏设计/手工制作图册与3D_v08/previews/图板_05.png

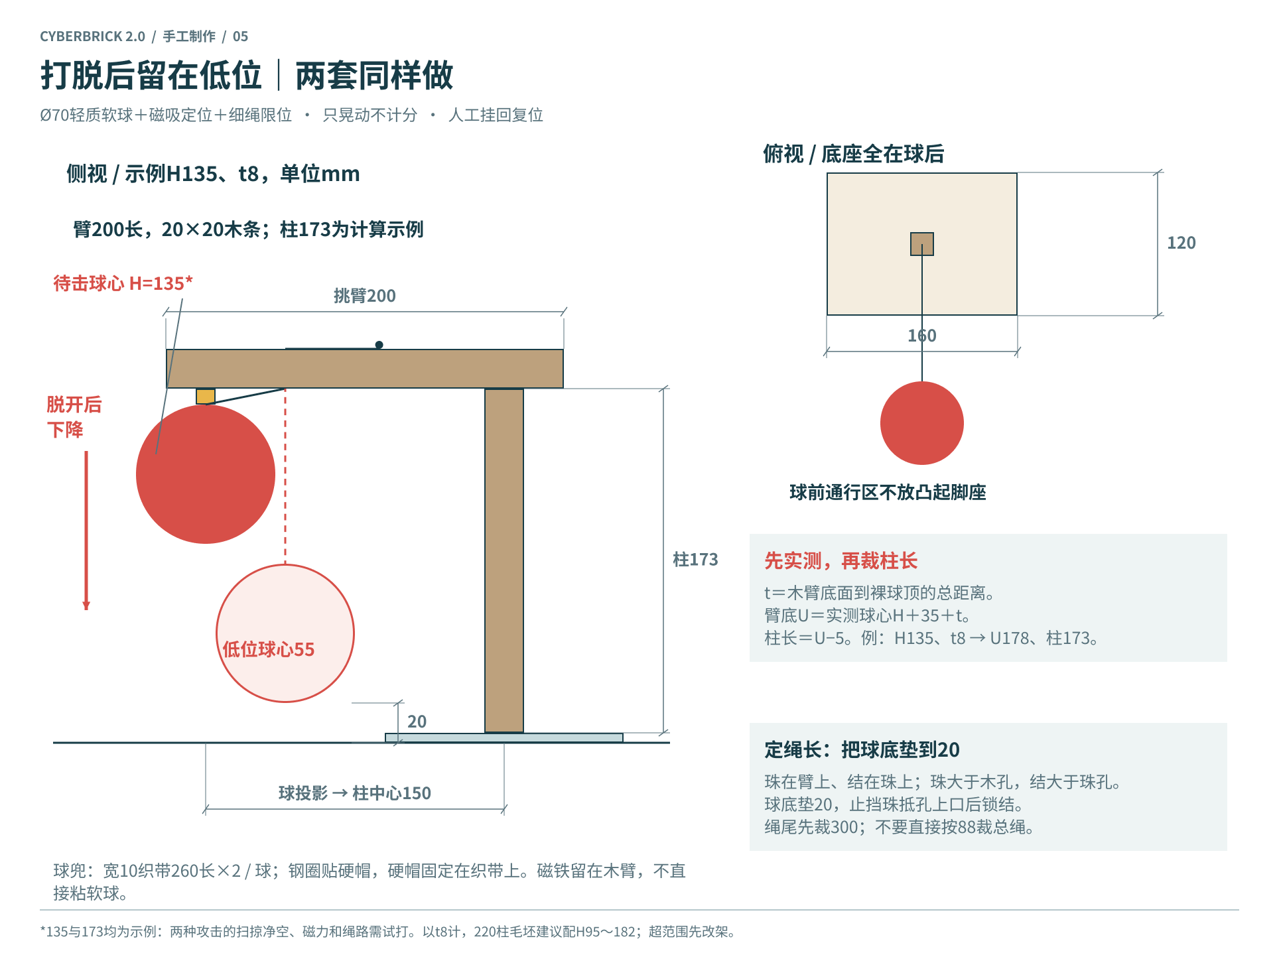
06_游戏设计/手工制作图册与3D_v08/previews/图板_05.png
