paomodabaibai/CyberBrick2-User-Research-UX/06_游戏设计/打印脱落球靶_v09/制造初样_v01/04_总装与检查/02_球壳与磁铁座拆解.png

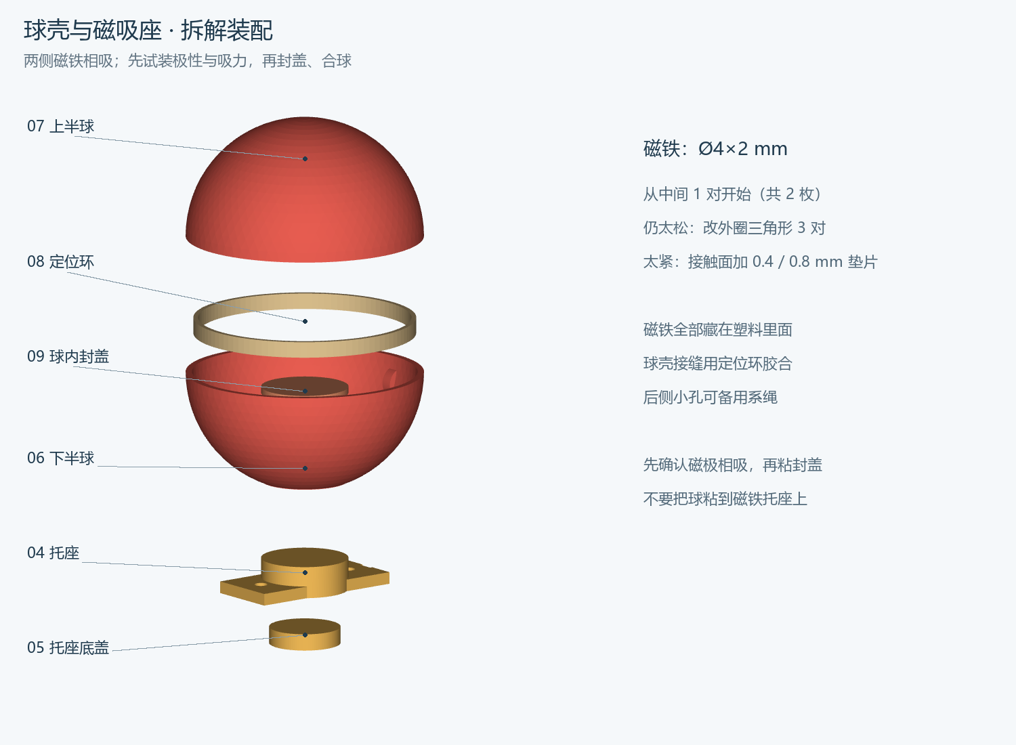
06_游戏设计/打印脱落球靶_v09/制造初样_v01/04_总装与检查/02_球壳与磁铁座拆解.png
