paomodabaibai/CyberBrick2-User-Research-UX/06_游戏设计/打印脱落球靶_v09/制造初样_v01/04_总装与检查/04_简单安装示意.png

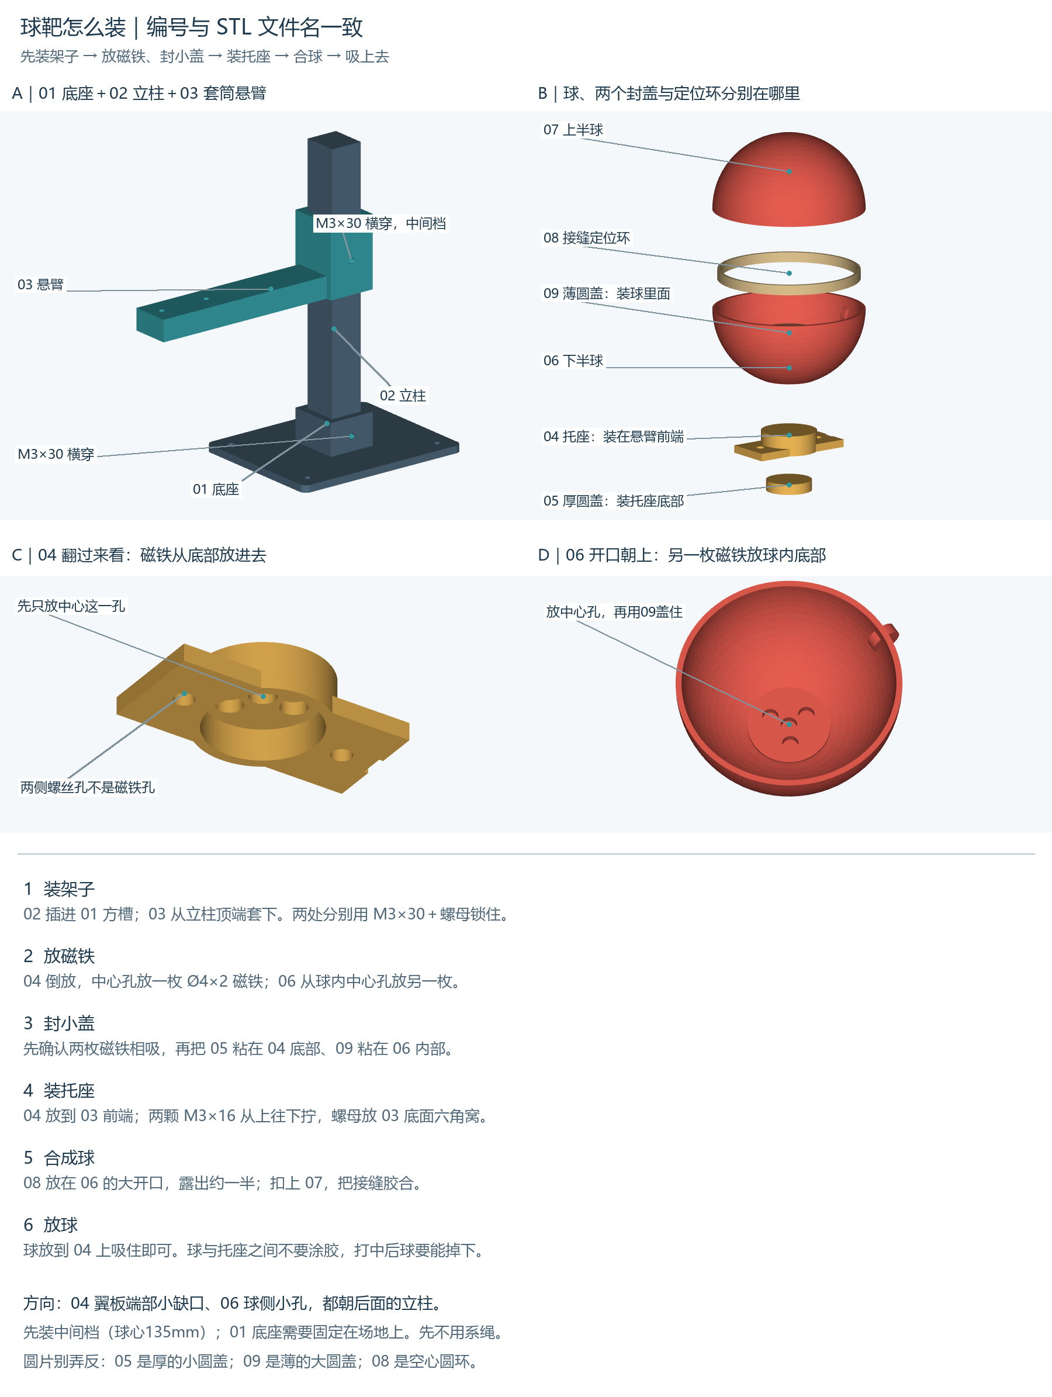
06_游戏设计/打印脱落球靶_v09/制造初样_v01/04_总装与检查/04_简单安装示意.png
