paomodabaibai/CyberBrick2-User-Research-UX/06_游戏设计/打印脱落球靶_v09/发给组员_球靶打印简版/零件对照图.png

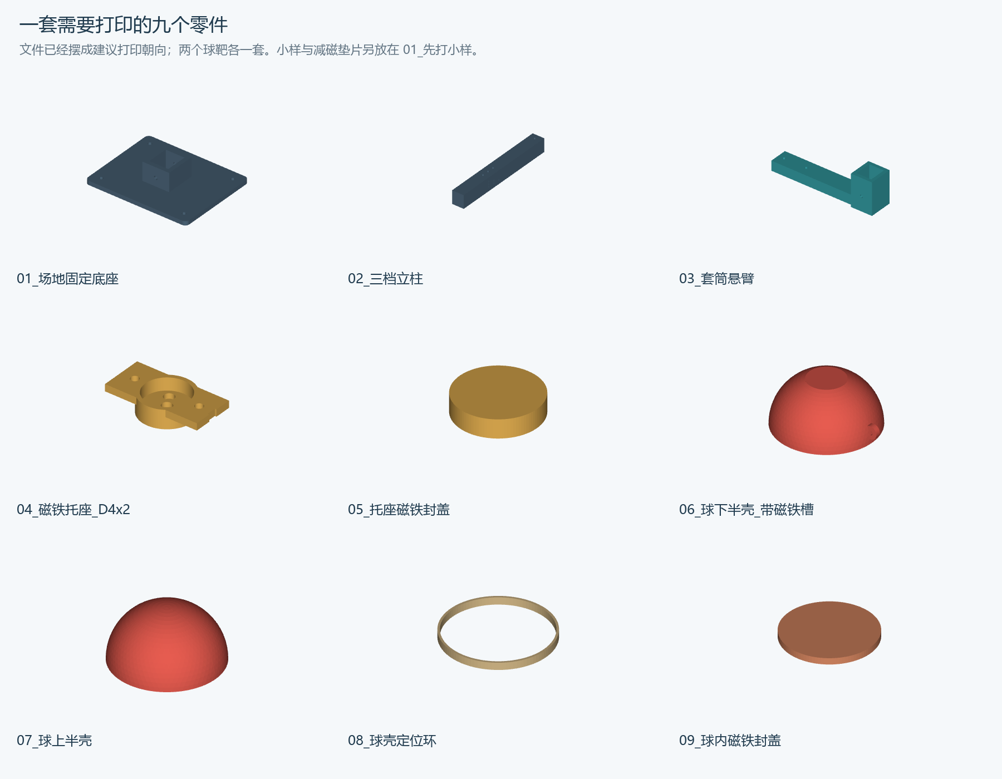
06_游戏设计/打印脱落球靶_v09/发给组员_球靶打印简版/零件对照图.png
