paomodabaibai/CyberBrick2-User-Research-UX/06_游戏设计/打印脱落球靶_v09/球靶粗模_整体与高度.png

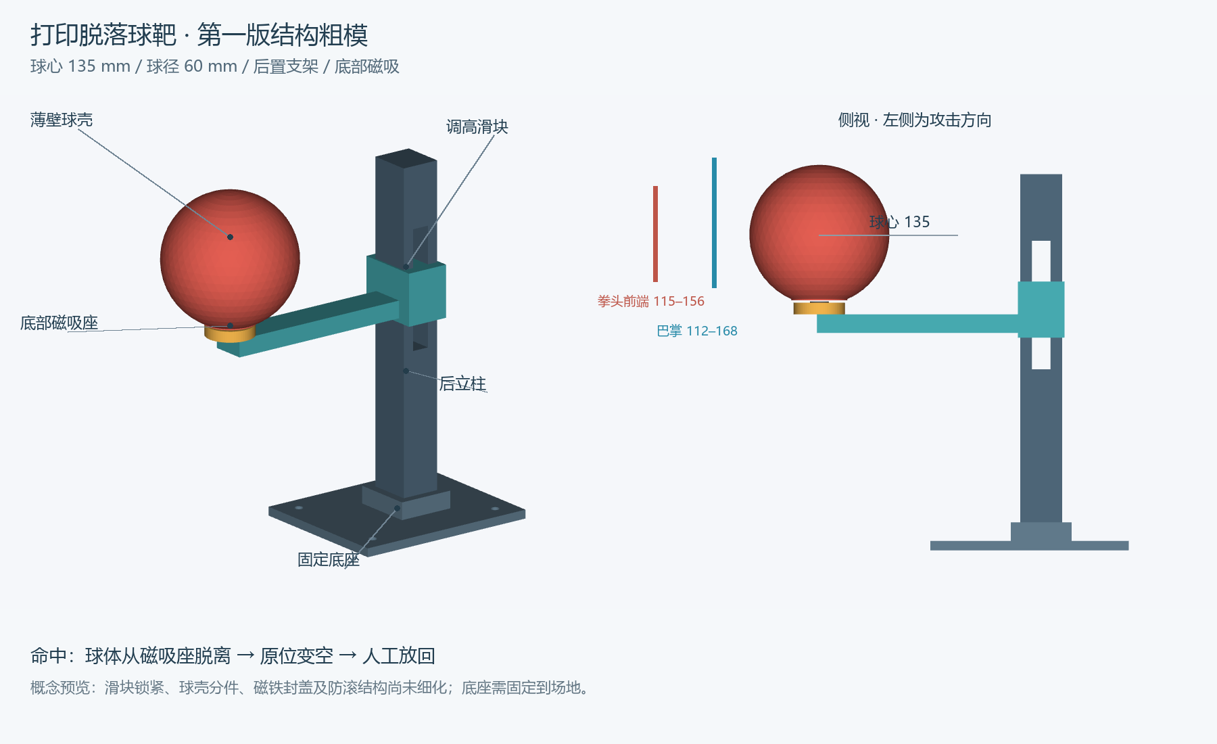
06_游戏设计/打印脱落球靶_v09/球靶粗模_整体与高度.png
