paomodabaibai/CyberBrick2-User-Research-UX/06_游戏设计/磁吸脱落球靶_v06/preview_mobile.png

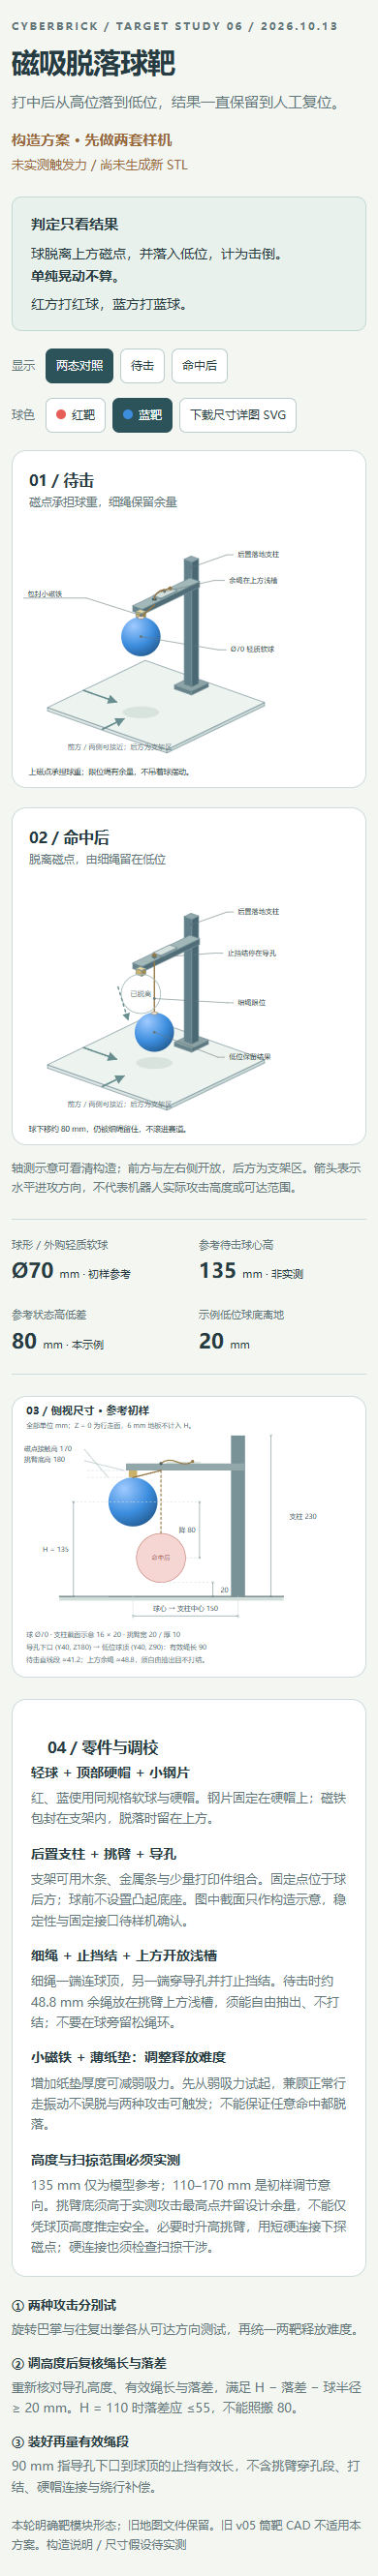
06_游戏设计/磁吸脱落球靶_v06/preview_mobile.png
