paomodabaibai/CyberBrick2-User-Research-UX/06_游戏设计/磁吸脱落球靶_v06/target_detail.png

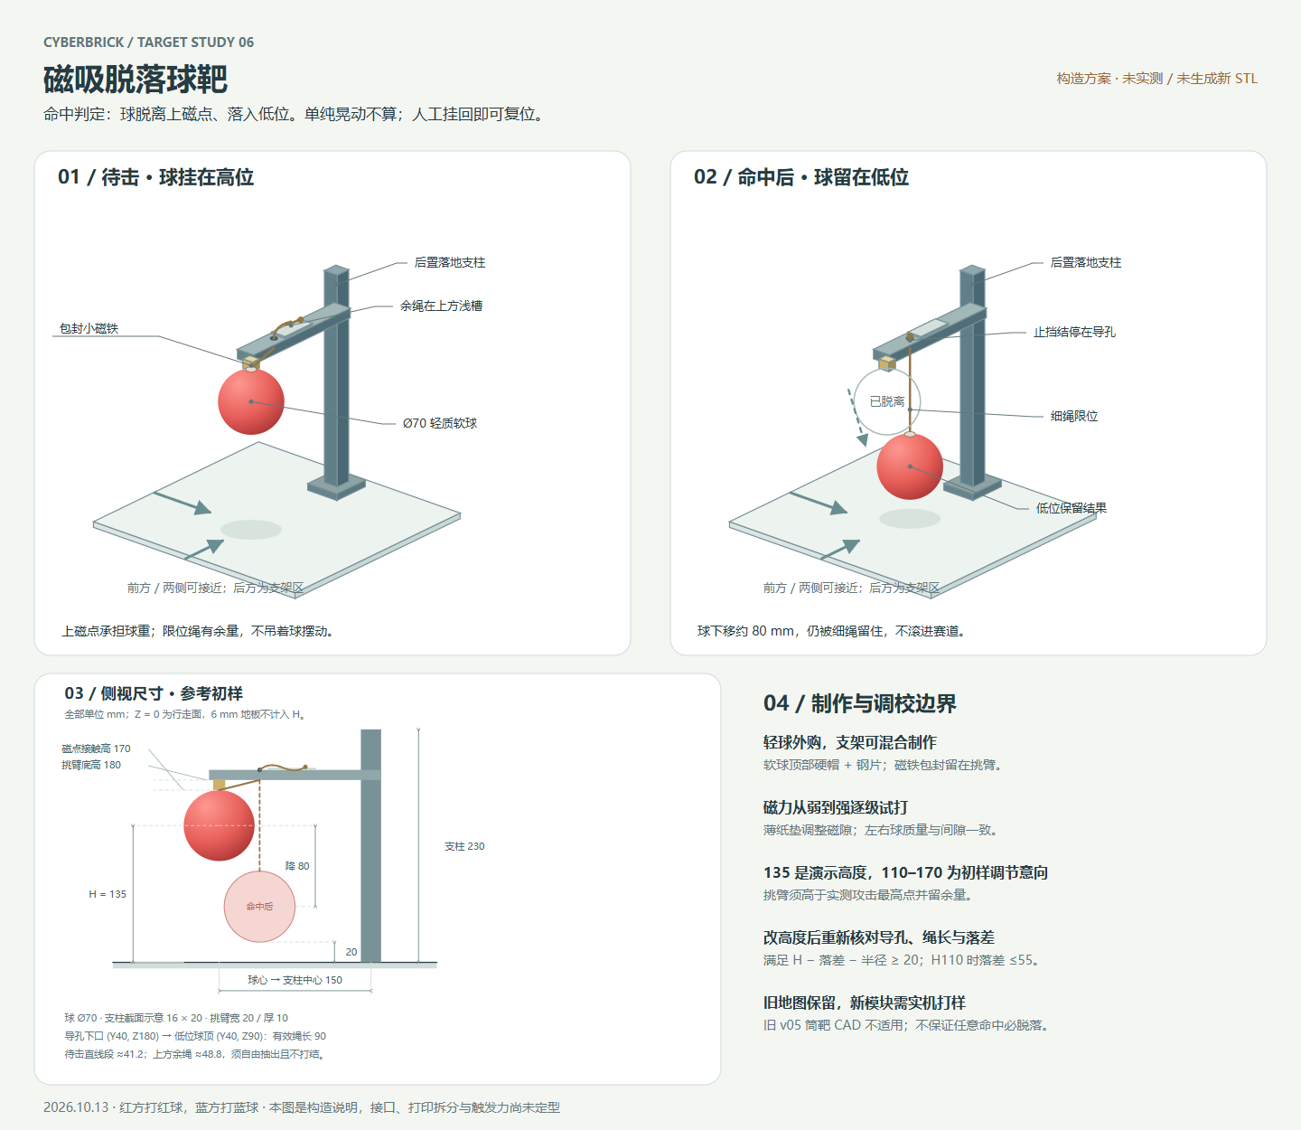
06_游戏设计/磁吸脱落球靶_v06/target_detail.png
