paomodabaibai/CyberBrick2-User-Research-UX/06_游戏设计/落地墙体竞技场_v04/立体总览.png

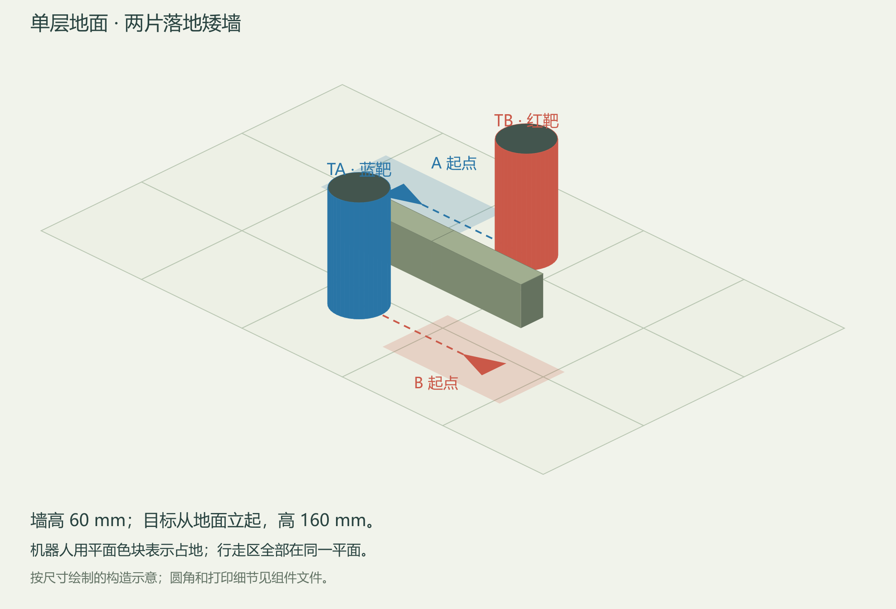
06_游戏设计/落地墙体竞技场_v04/立体总览.png
