paomodabaibai/CyberBrick2-User-Research-UX/06_游戏设计/贴图地图模型_80x120cm_v11/textures/wall_115_h95.png

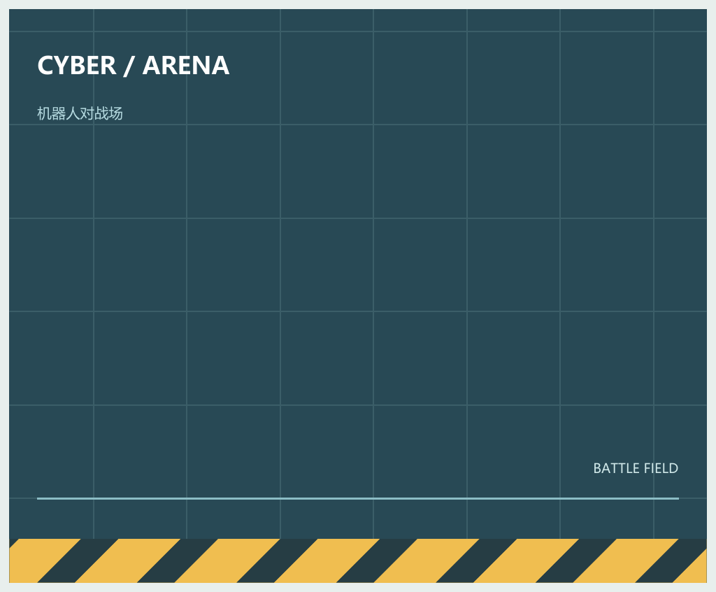
06_游戏设计/贴图地图模型_80x120cm_v11/textures/wall_115_h95.png
