paomodabaibai/CyberBrick2-User-Research-UX/06_游戏设计/错位T墙竞技场_v05/output/pdf/page-6.png

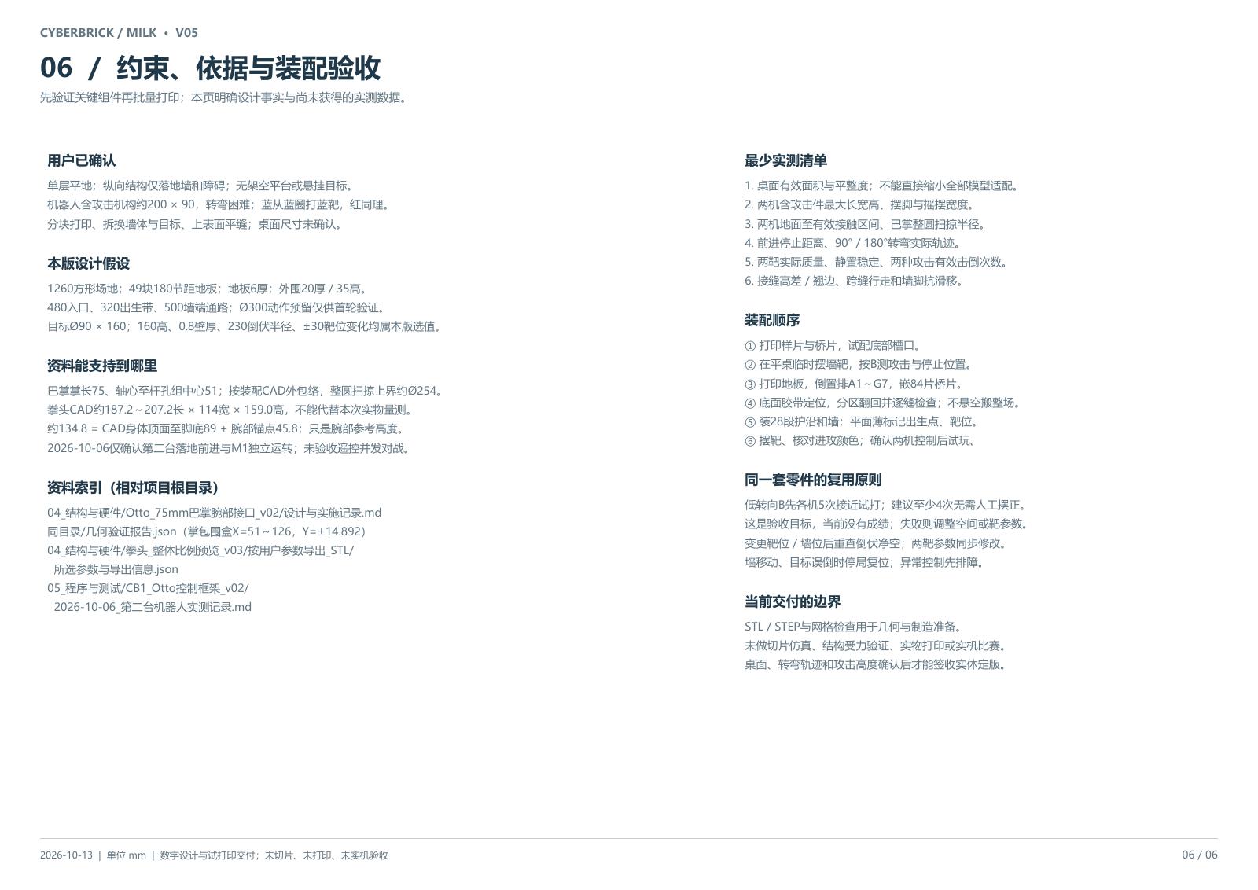
06_游戏设计/错位T墙竞技场_v05/output/pdf/page-6.png
