paomodabaibai/CyberBrick2-User-Research-UX/10.22最终汇报素材/0ccb2a9f4671a8f1456017da3ebe8dd6.jpg

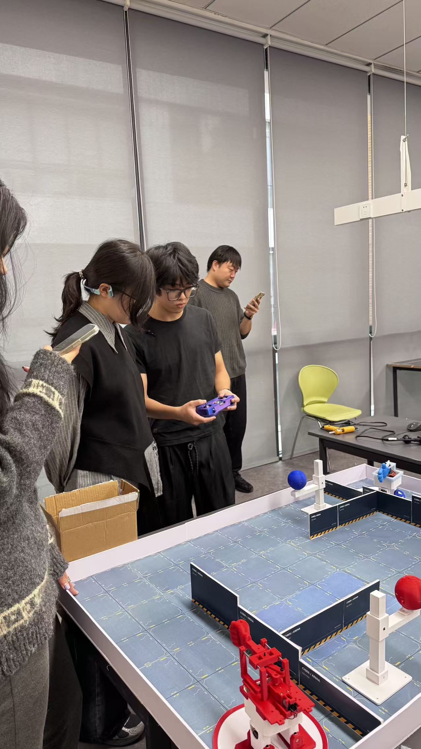
10.22最终汇报素材/0ccb2a9f4671a8f1456017da3ebe8dd6.jpg
