paomodabaibai/CyberBrick2-User-Research-UX/10.22最终汇报素材/5dc947e855c40784ce7c88d958320951.jpg

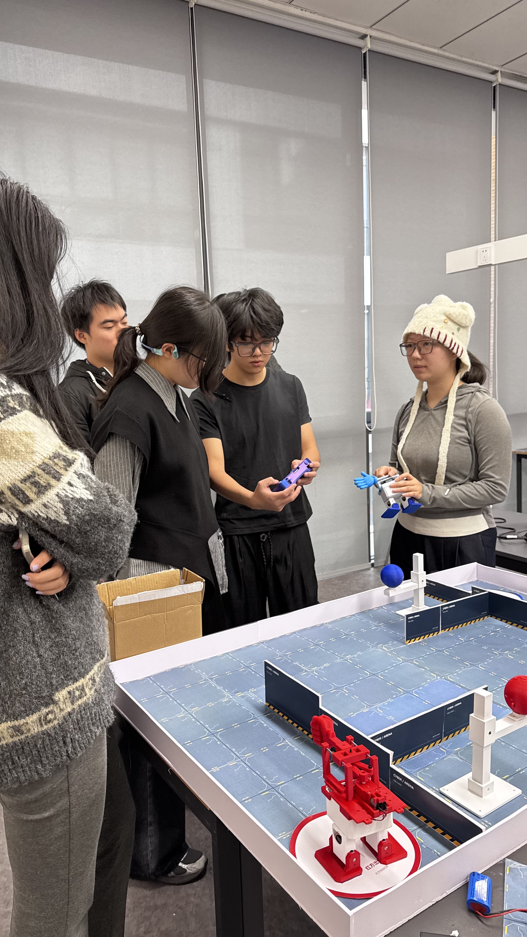
10.22最终汇报素材/5dc947e855c40784ce7c88d958320951.jpg
