paomodabaibai/CyberBrick2-User-Research-UX/10.22最终汇报素材/6a0d3efd0a36e9fbb3837427218be7d8.jpg

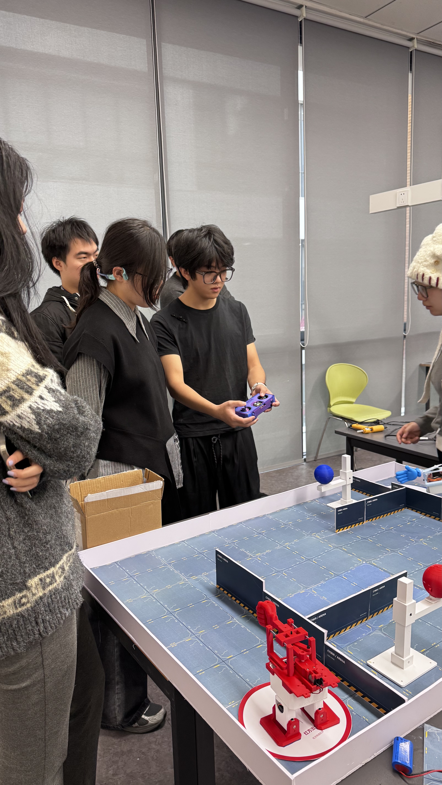
10.22最终汇报素材/6a0d3efd0a36e9fbb3837427218be7d8.jpg
