paomodabaibai/CyberBrick2-User-Research-UX/10.22最终汇报素材/8a63afd5c6b5698a2f75e5032c446935.jpg

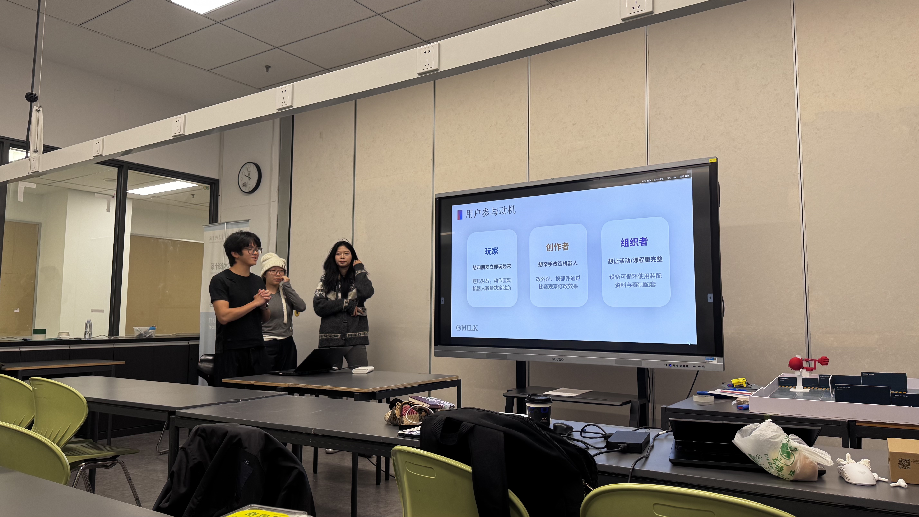
10.22最终汇报素材/8a63afd5c6b5698a2f75e5032c446935.jpg
