paomodabaibai/CyberBrick2-User-Research-UX/10.22最终汇报素材/8ee646b0349a15a3efe486eeb89cbf3f.jpg

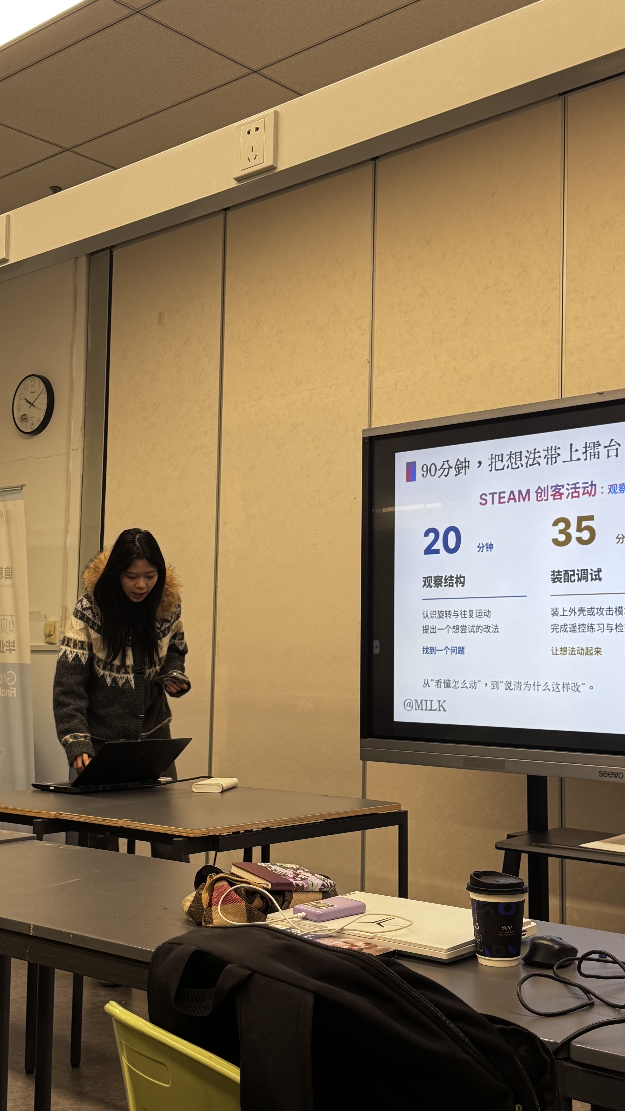
10.22最终汇报素材/8ee646b0349a15a3efe486eeb89cbf3f.jpg
