paomodabaibai/CyberBrick2-User-Research-UX/10.22最终汇报素材/69eab992865b77e5c44df2b0fc26f5c6.jpg

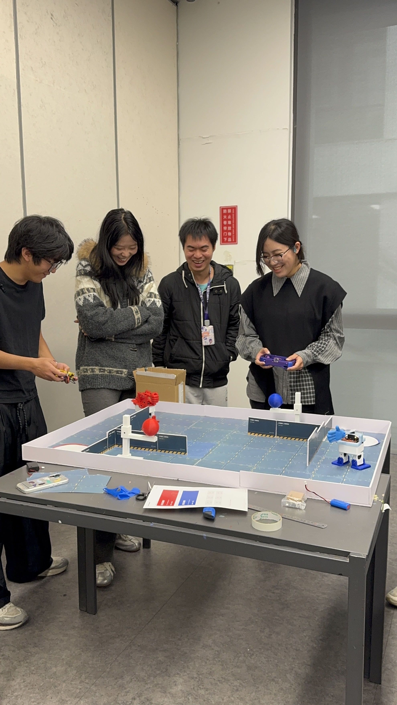
10.22最终汇报素材/69eab992865b77e5c44df2b0fc26f5c6.jpg
