paomodabaibai/CyberBrick2-User-Research-UX/10.22最终汇报素材/98dc3d617758201dcb45b6c8a9561ef5.jpg

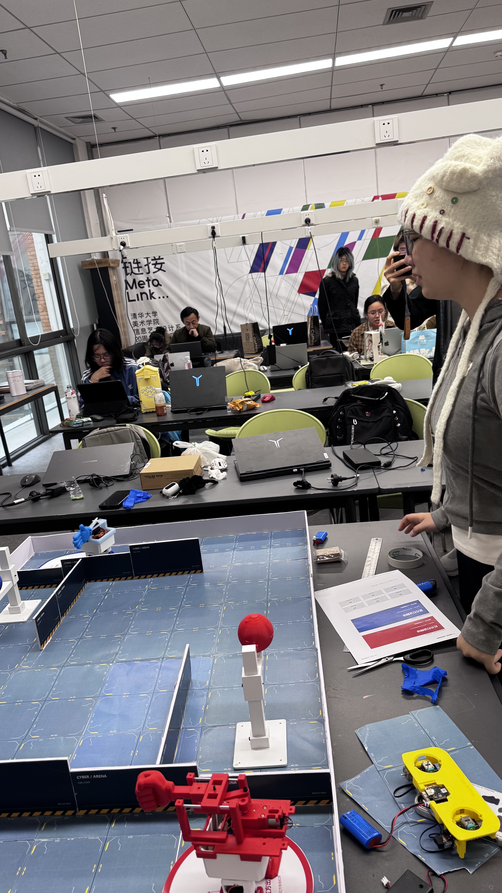
10.22最终汇报素材/98dc3d617758201dcb45b6c8a9561ef5.jpg
