paomodabaibai/CyberBrick2-User-Research-UX/10.22最终汇报素材/027860caa969391cd755b99741466d94.jpg

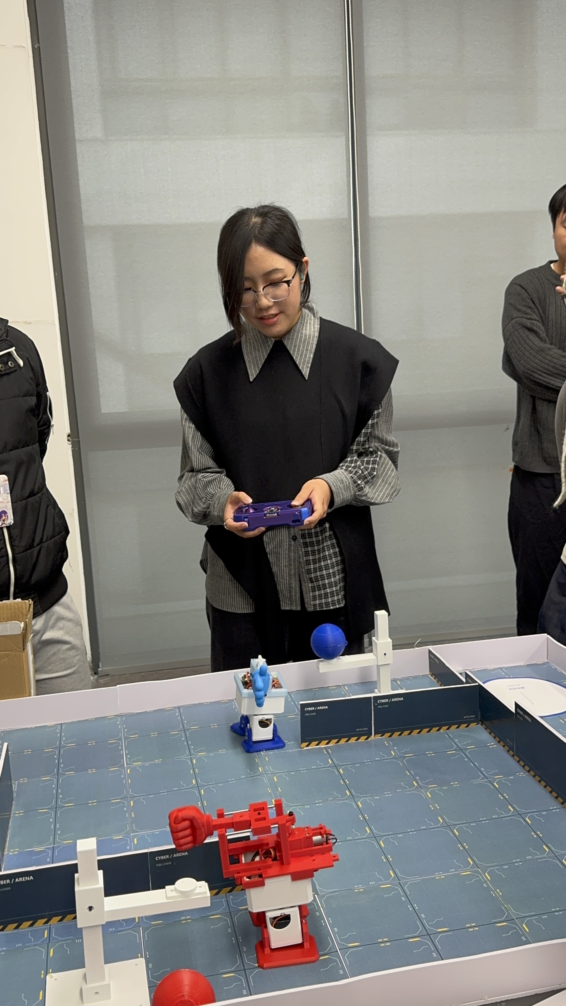
10.22最终汇报素材/027860caa969391cd755b99741466d94.jpg
