paomodabaibai/CyberBrick2-User-Research-UX/10.22最终汇报素材/a3f27e3764b75aee79184e43f438a344.jpg

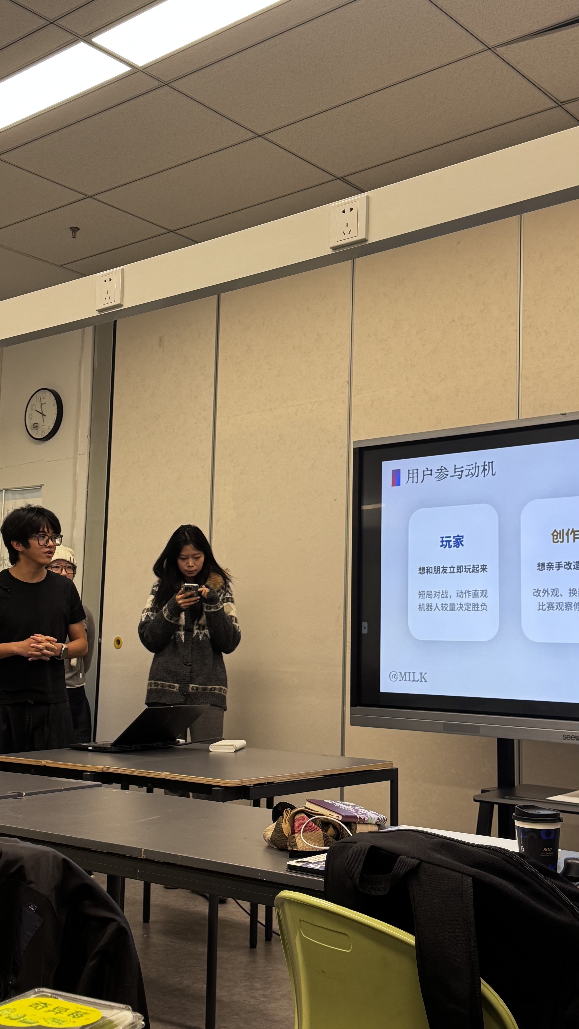
10.22最终汇报素材/a3f27e3764b75aee79184e43f438a344.jpg
