paomodabaibai/CyberBrick2-User-Research-UX/10.22最终汇报素材/a5f30a4e230532323ade0b8df7c5795a.jpg

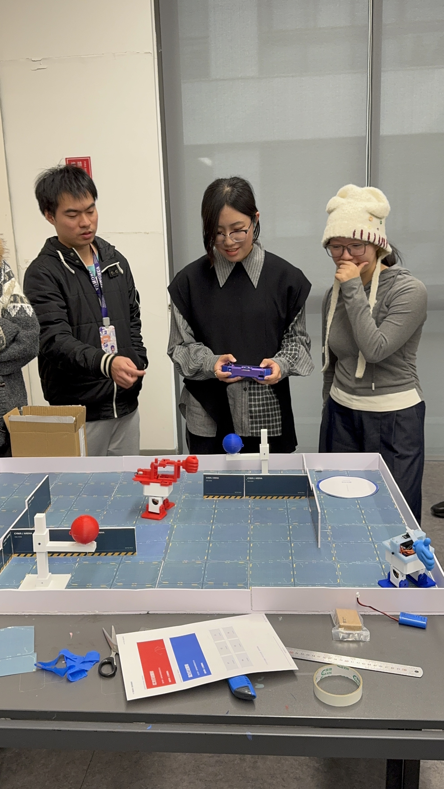
10.22最终汇报素材/a5f30a4e230532323ade0b8df7c5795a.jpg
