paomodabaibai/CyberBrick2-User-Research-UX/10.22最终汇报素材/a50b085310697ce7d380a036ea0f1320.jpg

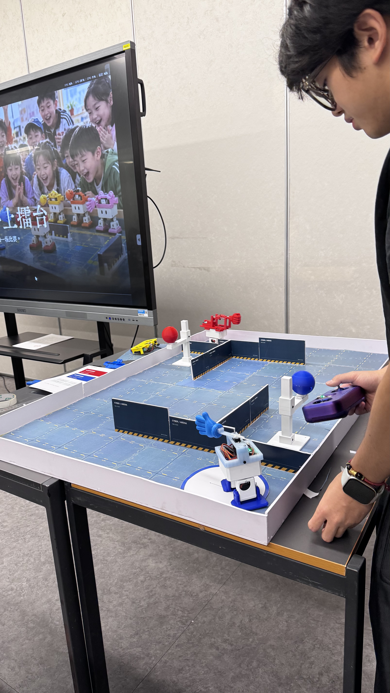
10.22最终汇报素材/a50b085310697ce7d380a036ea0f1320.jpg
