paomodabaibai/CyberBrick2-User-Research-UX/10.22最终汇报素材/b0a19558cce6ff10cf40ae10aaec3060.jpg

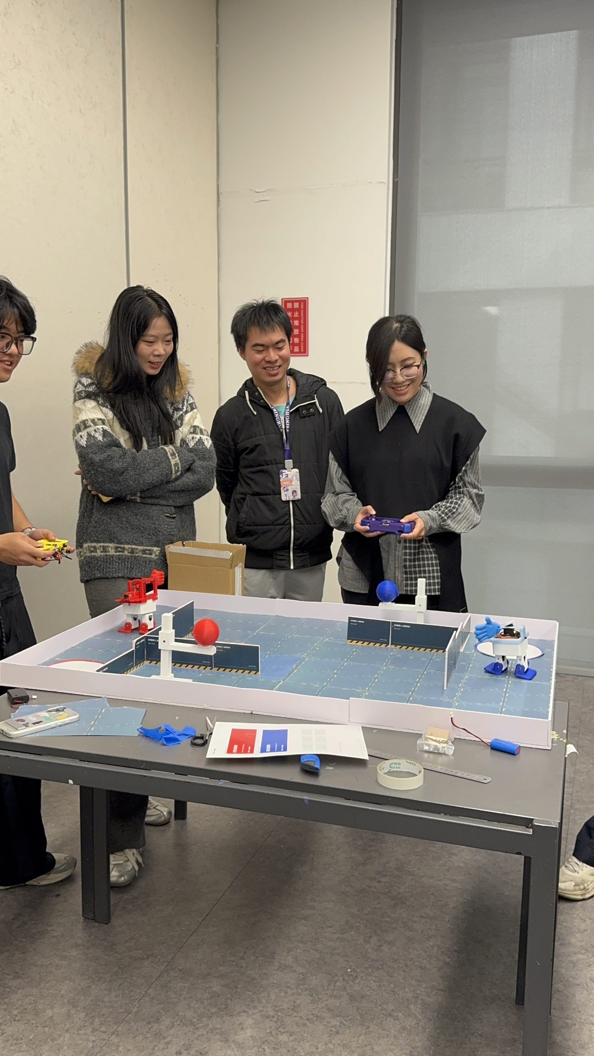
10.22最终汇报素材/b0a19558cce6ff10cf40ae10aaec3060.jpg
