paomodabaibai/CyberBrick2-User-Research-UX/10.22最终汇报素材/b37e9bf16cb761527dd4bbacb79c8a7d.jpg

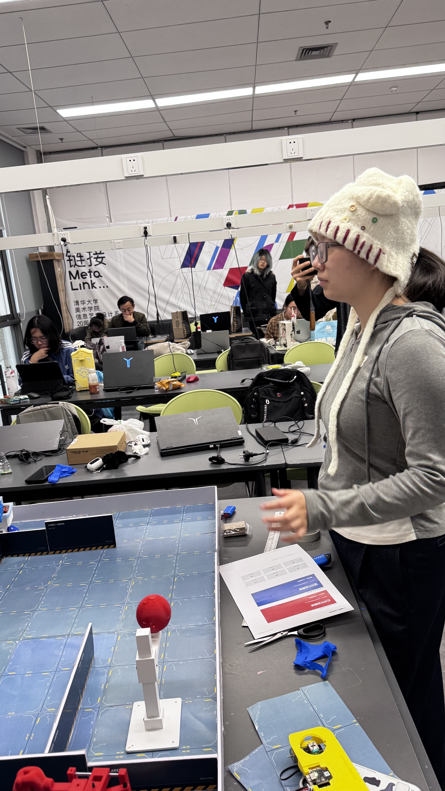
10.22最终汇报素材/b37e9bf16cb761527dd4bbacb79c8a7d.jpg
