paomodabaibai/CyberBrick2-User-Research-UX/10.22最终汇报素材/b797091d0a18e7d6d14c36d36704ad10.jpg

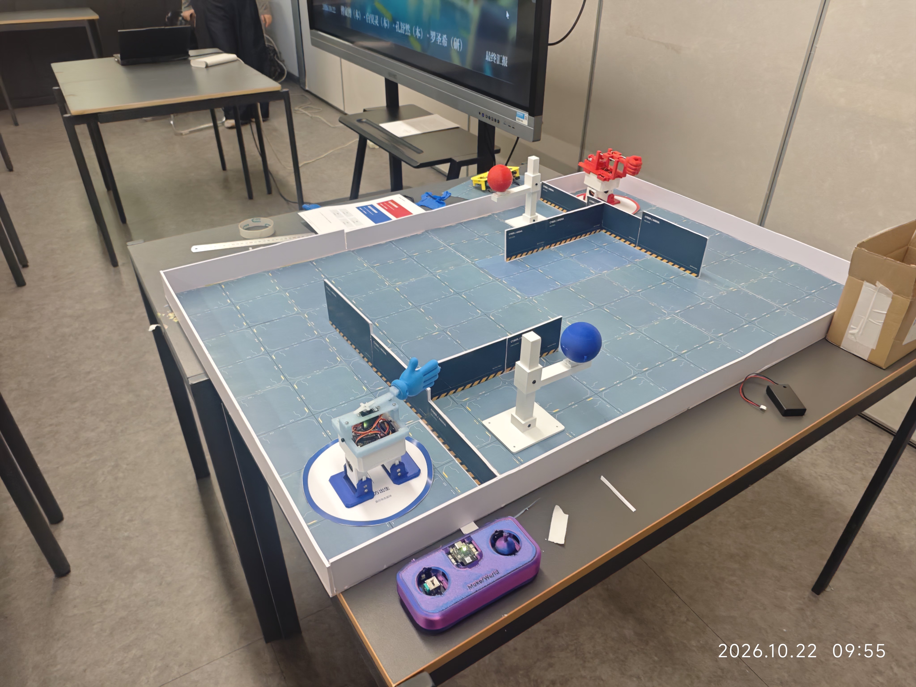
10.22最终汇报素材/b797091d0a18e7d6d14c36d36704ad10.jpg
