paomodabaibai/CyberBrick2-User-Research-UX/10.22最终汇报素材/c5a99b280ae7faca3da4f0824ba5b772.jpg

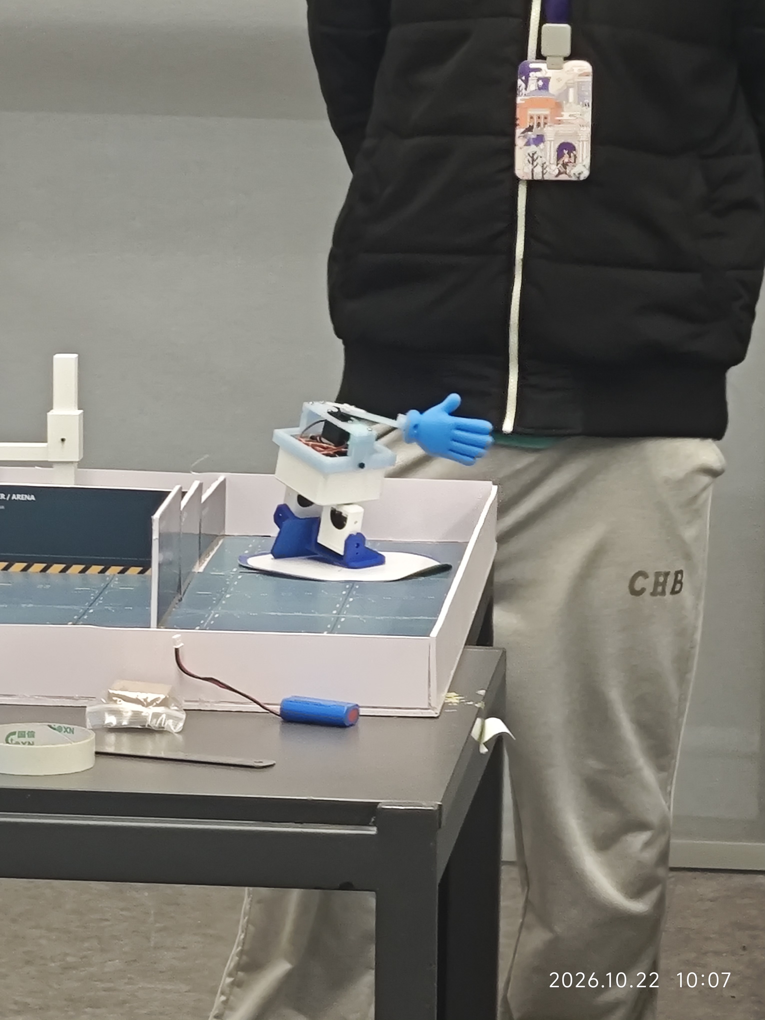
10.22最终汇报素材/c5a99b280ae7faca3da4f0824ba5b772.jpg
