paomodabaibai/CyberBrick2-User-Research-UX/10.22最终汇报素材/c88ffd86d54a688a5289ea966aa455e4.jpg

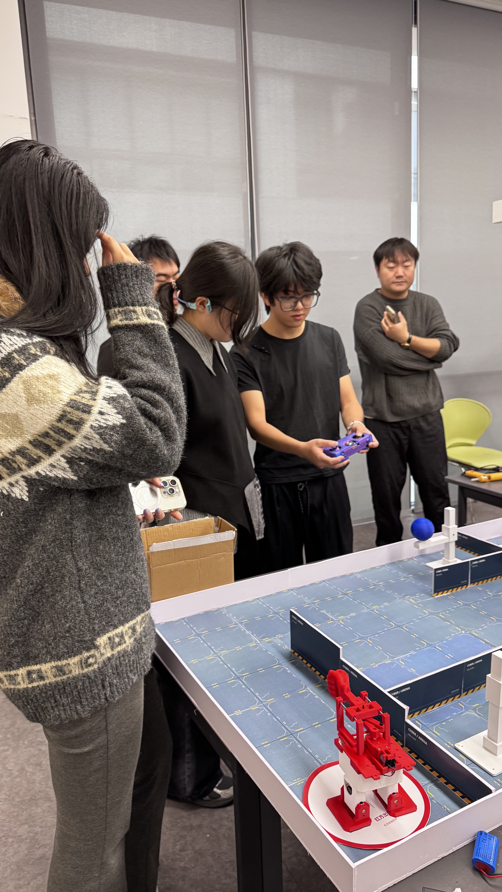
10.22最终汇报素材/c88ffd86d54a688a5289ea966aa455e4.jpg
