paomodabaibai/CyberBrick2-User-Research-UX/10.22最终汇报素材/cb9f1f7c30d2173f575c83fef466efa8.jpg

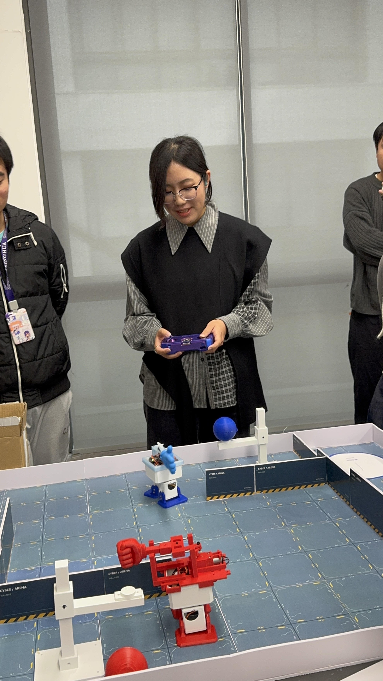
10.22最终汇报素材/cb9f1f7c30d2173f575c83fef466efa8.jpg
