paomodabaibai/CyberBrick2-User-Research-UX/10.22最终汇报素材/ceb31136992c1aeb88dc56c7c7a6aca0.jpg

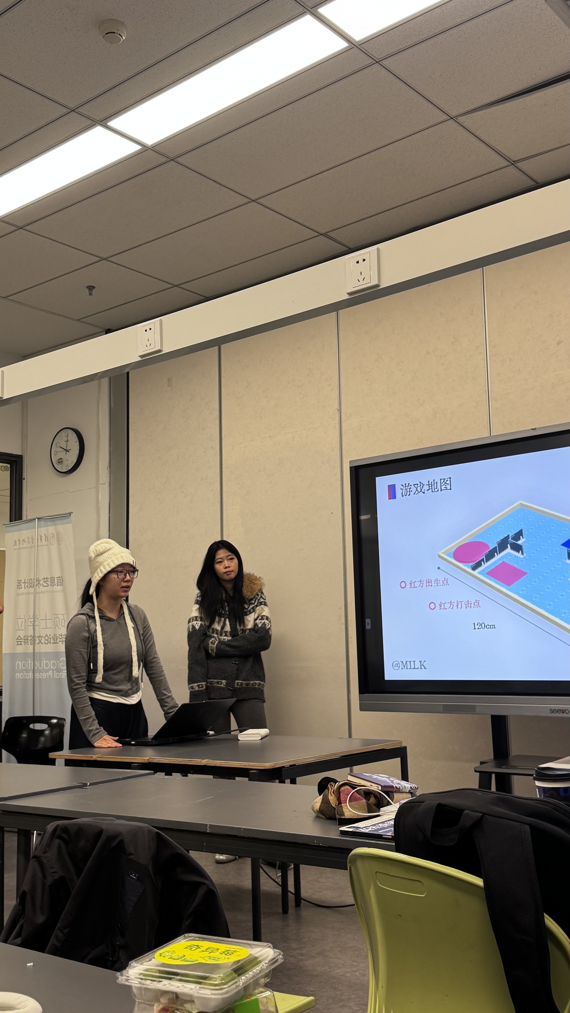
10.22最终汇报素材/ceb31136992c1aeb88dc56c7c7a6aca0.jpg
