paomodabaibai/CyberBrick2-User-Research-UX/10.22最终汇报素材/debd32059c1d0457cf6d7b486df36818.jpg

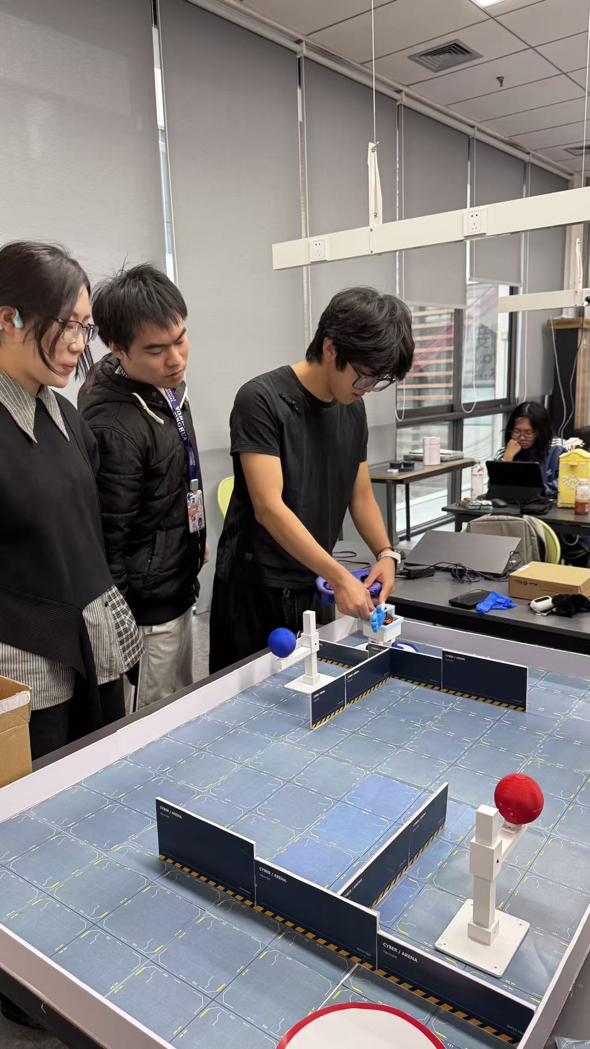
10.22最终汇报素材/debd32059c1d0457cf6d7b486df36818.jpg
