paomodabaibai/CyberBrick2-User-Research-UX/10.22最终汇报素材/dfe90636d9f2362cd751e2278c9b222a.jpg

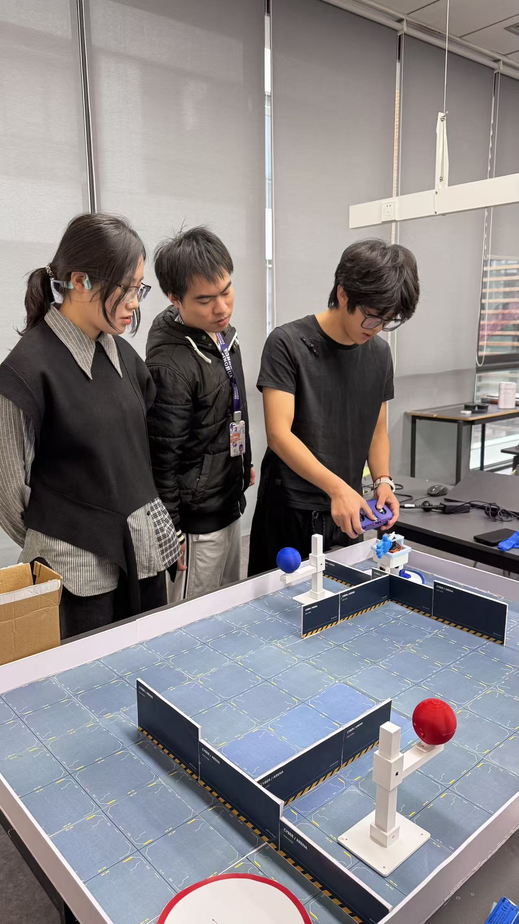
10.22最终汇报素材/dfe90636d9f2362cd751e2278c9b222a.jpg
