paomodabaibai/CyberBrick2-User-Research-UX/10.22最终汇报素材/f714ef1e944559706c747ac07fd724bb.jpg

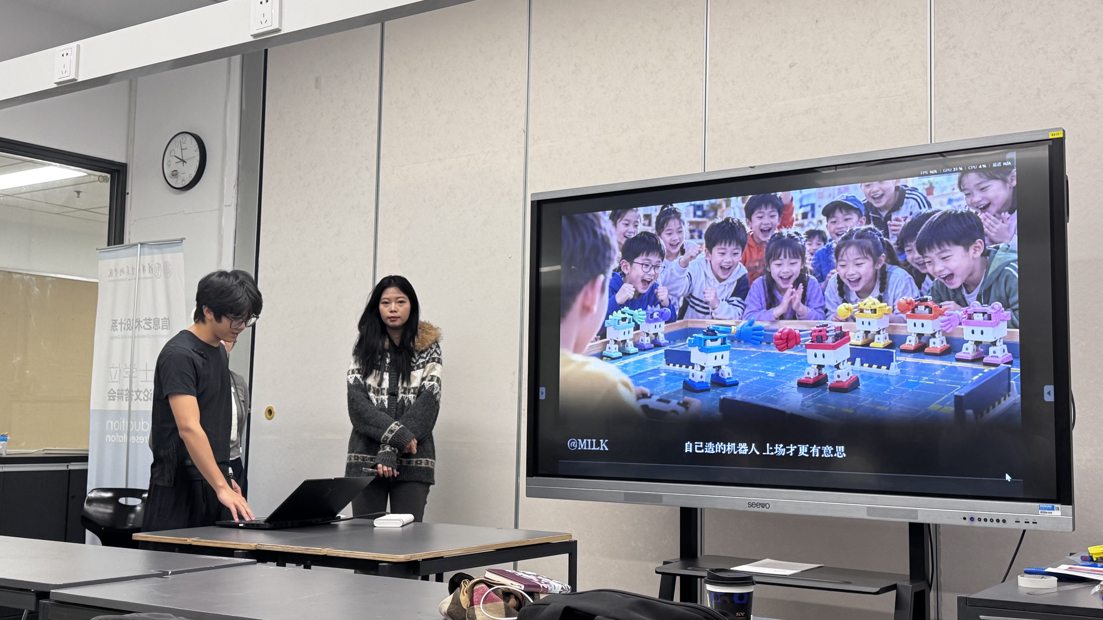
10.22最终汇报素材/f714ef1e944559706c747ac07fd724bb.jpg
