paomodabaibai/CyberBrick2-User-Research-UX/10.22最终汇报素材/fa5122bbf68d98e477ea36c78178daba.jpg

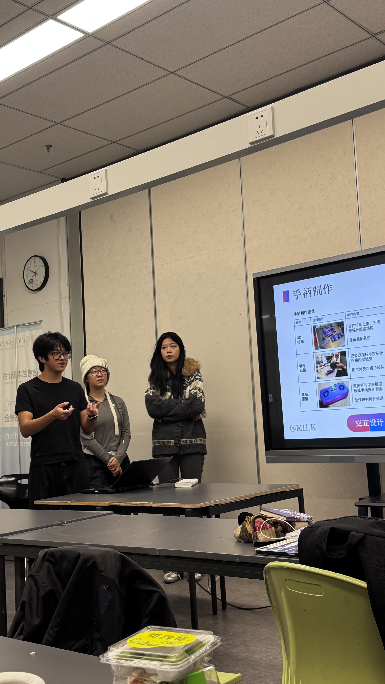
10.22最终汇报素材/fa5122bbf68d98e477ea36c78178daba.jpg
