paomodabaibai/CyberBrick2-User-Research-UX/10.22最终汇报素材/fd6b60ea2ec03df2b068583c26d441e4.jpg

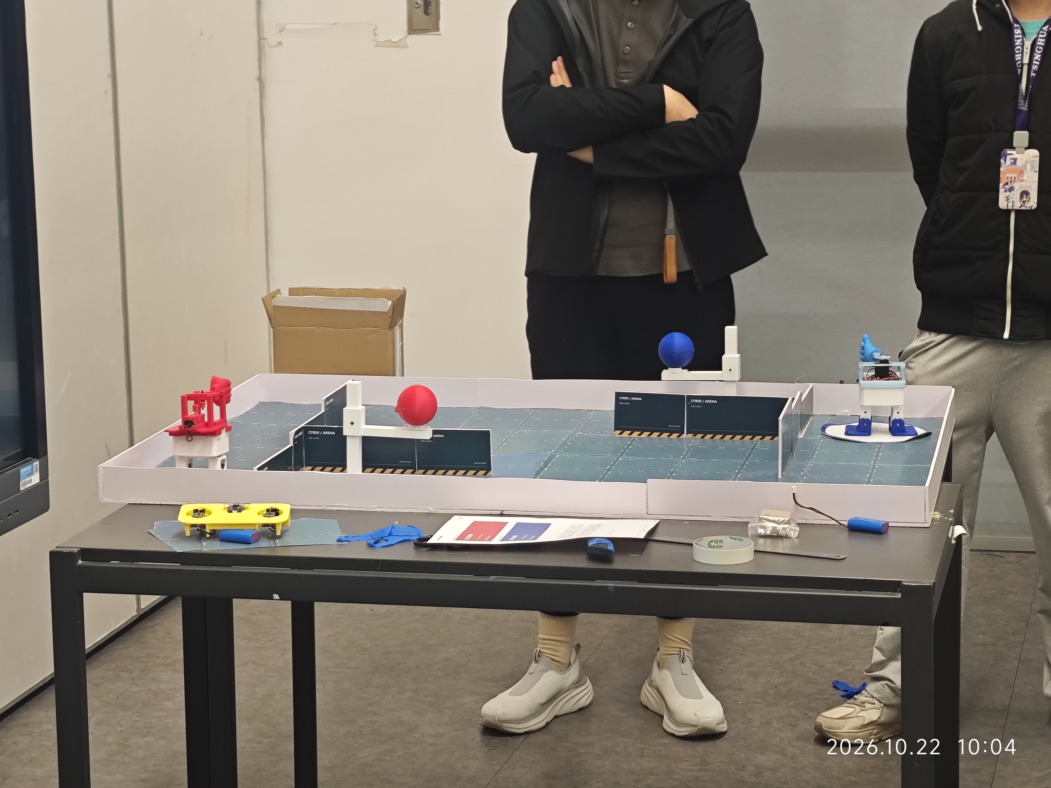
10.22最终汇报素材/fd6b60ea2ec03df2b068583c26d441e4.jpg
