paomodabaibai/CyberBrick2-User-Research-UX/10.22最终汇报素材/同伴PPT与场景/儿童试玩场景_2026-10-21/03_近景互动_16x9.png

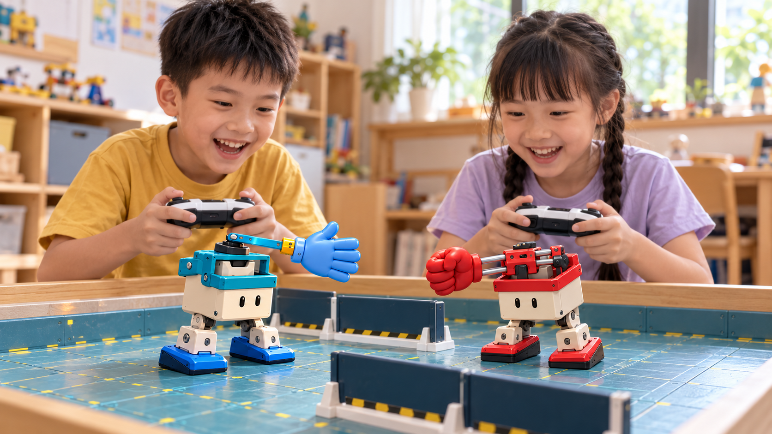
10.22最终汇报素材/同伴PPT与场景/儿童试玩场景_2026-10-21/03_近景互动_16x9.png
