paomodabaibai/CyberBrick2-User-Research-UX/04_结构与硬件/CB2_Otto可行性与硬件清单_含卡牌场景预留.md

> 2026-09-17物料表更新：准确料号与配件修正见同目录《CB2物料表转录与需求对照_2026-09-17.md》。CB010是用户交互面板，不能直接认定为扩展板；六块主板不等于六整套。

# CB2 Otto 行走 Demo：可行性与分阶段硬件清单

日期：2026-09-17。最新范围：本周末只完成一套 Otto 四舵机行走模块，不以巴掌、拳头、NFC 或完整对战作为周末验收项。卡牌与场景为候选扩展，尚未决定实施。用户已确认六块核心板分配为两台机器人＋两个手柄＋两个场景/备用节点；后两个节点具体用途保持灵活。

## 1. 能否做：有条件可行，尚非实机验证结论

| 功能 | 证据与判断 | 尚缺的验证 |
|---|---|---|
| 四舵机 Otto 行走 | Otto 官方基本方案为四个微型舵机；CB2 软件有位置舵机、速度及限位 API，控制路线成立 | 实物是否对应文档、四轴更新时序、力矩/速度/质量、供电与机械适配 |
| 两机遥控对战 | 打包 Wireless 文档提供分组、标签收发及发送者标识，软件架构有实现基础 | 实际遥控器与板型、多节点通信延迟、掉线处理、负重步态和攻击反作用 |
| 手柄刷技能卡 | 可用读卡事件触发游戏规则；CB2 专属知识库未找到 NFC/RFID 文档 | 原生模块是否另有资料，或第三方模块的电气、端口、固件总线与驱动兼容性 |
| 场景道具点 | 固定站读脚底标签，或机器人读地面标签，都可作为设计方案 | 读距、天线朝向、步行抬脚、邻近金属/舵机、读卡窗口与重复触发 |

此次没有读取板端版本、运行设备或测量机械尺寸。公开检索多命中第一代 CyberBrick，不能把其舵机和扩展板规格当成 CB2。软件定义有 A1–A6/B1–B6 不能证明供电能带满负载。

## 2. 模型是否可以修改

可以协助做参数化转接件、舵机仓、腿壳、脚壳与机身托架，输出可编辑 CAD 和打印 STL，但必须先拿到真实尺寸或厂家 CAD。

项目已有 Otto-V9/CAD/OttoDIY_v09.step，文件约 8.6 MB；STEP 是交换格式，不等于带完整设计历史的原生参数化工程。不能保证所有孔位都能像原作者工程那样直接改参数。必要时以原几何为参考重建局部零件。当前没有完成任何 CB2 改件，也未确认可直接使用的 CAD 编辑运行环境。

优先顺序：
1. 外形差异小、空间充足：做转接座，尽量保留原关节轴线。
2. 舵机仓明显放不下或轴心偏移：重建局部腿壳/脚壳及舵机仓。
3. 舵机明显更大更重：重新评估腿距、脚掌、机身，接受整机比例调整；不盲目追求原来的 10–20 cm。

不要整体等比缩放：孔距、舵盘、轴心、壁厚、接头和电池尺寸不会按相同比例变化。

### 必需测量

- 舵机型号、额定电压、额定/堵转力矩、速度、额定与峰值/堵转电流、重量（厂家数据优先）。
- 壳体长宽高、安装耳外形与厚度、孔距/孔径、输出轴心距壳体各基准面的位置。
- 舵盘直径与厚度、孔位、中心固定方式，尽量复用厂家舵盘，不凭照片重造花键。
- 接头大小、插拔方向、线缆出口与活动余量；板与电池的尺寸/重量。
- Otto 安装轴线、两腿间距、脚长脚宽及运动时干涉。

试片流程：单个舵机卡座 → 舵盘连接试件 → 一条腿及脚 → 完整双足。每一步试装后再打印下一批。

## 3. 周末测试与验收建议

先单舵机确定中位、方向、限位与反馈；再四个舵机逐个绑定左髋、右髋、左踝、右踝。先站立，再原地重心转移，最后连续走若干步。不能通过 Servo 在端口中的排序永久推断它的位置。

建议验收：能开机进入可控姿态，平面上稳定站立 30 秒，连续前进至少 5 步，重复 3 次无掉电重启或持续卡滞；这是自拟测试目标，不是已有能力。记录实际质量、脚底材料、步频、幅度和供电状态。

Ottto 原步态不能直接照搬 Arduino 程序到 CB2；需要将四轴相位、幅度、中位和时序移植到对应版本的 MicroPython API，并按新几何调参。后续加攻击/NFC的质量要逐步模拟，不能用空载走通证明最终对战可行。

## 4. 六块主板的暂定分配

用户已确认两机器人＋两手柄＋两个场景/备用节点；以下细化方案供讨论：机器人 2 块＋手柄 2 块＋场景/裁判节点 1 块＋备用/开发验证 1 块，共 6 块。裁判节点可负责技能生效、冷却、比分，是否与道具读卡共用要看实际布线距离和性能。六块并非基础对战的最低数量。

若六块实际是三机器人＋三手柄，腿部舵机需要 12 个在用，读卡器和电源另行增加，且没有剩余场景/备用板。不要把两种分配混在同一采购总数里。

## 5. 本周末最小硬件需求（仅一套腿）

| 物料 | 使用量 | 建议准备量 | 备注 |
|---|---:|---:|---|
| CB2 核心板 | 1 | 1 | 已有则不重复采购 |
| 匹配的扩展/供电组件 | 1 套 | 1 套 | 至少支持本方案四路位置舵机；核实具体部件 |
| CB2 位置舵机及原配舵盘 | 4 | 5 | 4 用＋1 备；不能用仅连续旋转的型号替代 |
| 舵机连接线 | 4 路 | 5 路 | 如原配已包含，仅补延长/备用，不重复买 |
| 核心板与扩展组件互连线 | 按套件必需 | 完整 1 套＋1 根同型备用 | 不沿用 CB1 接头规格 |
| 官方兼容电源/电池与充电组件 | 1 套 | 1 套 | 按四舵机动态负载核实；不默认仅 USB 可供电 |
| USB 数据线 | 1 | 2 | 确認可传数据 |
| 双足打印件和试片 | 1 台份 | 1 台份＋局部试片 | 先适配后打印整套 |
| 紧固件、舵盘螺钉、必要转轴 | 1 台份 | 基础数＋约 20% 备件 | 规格按模型与舵机确认，不盲购尺寸 |
| 脚底防滑材料 | 2 片 | 4 片 | 厚度与摩擦会影响步态 |
| 量具 | 卡尺、电子秤各 1 | 借用优先 | 万用表/匹配电压的功耗测量工具按需借用 |

周末可先由电脑触发动作，不要求额外手柄。若确实要遥控验收，再提前借用第 2 块板和一套输入件。

## 6. 完整两机项目的资源申请清单（包含周末物料，不与上表相加）

| 物料 | 基础用途与数量 | 扩展/备件 | 申请或预留建议 |
|---|---|---|---|
| CB2 核心板 | 两机器人 2＋两手柄 2 | 场景/裁判 1＋备用/开发 1 | 共 6 块 |
| 匹配扩展/供电组件 | 对应各节点需要 | 备用板可借用测试扩展件 | 申请上限 6 套，核对手柄套装内含再扣除 |
| 位置舵机＋舵盘 | 腿部 8＋直驱巴掌 1 | 备用 2 | 共 11 个；拳头电机另列 |
| 拳头电机及匹配驱动/传动 | 1 套暂估 | 验证后再定备件 | 本周不采购定型，先核查 Punchy 与 CB2 驱动 |
| 双轴摇杆输入 | 两手柄各 1 套 | 每套轴数与封装待选 | 2 套；不把一套双摇杆误计成一个摇杆 |
| 按钮输入 | 每手柄攻击＋确认/技能各 1 | 按原配摇杆是否含按键扣除 | 最多另配 4 个 |
| 节点电源 | 4 个移动节点 | 场景/开发 1–2 套可共用台式电源方案 | 按需 4–6 套，不等于必须买 6 块电池 |
| 舵机连接/延长线 | 9 路在用 | 2 路备用 | 共 11 路能力；原配线已含则只补不足 |
| 电机线与驱动连接 | 拳头 1 套 | 1 套同型备用待定 | 定型后统计 |
| 板间互连线、电源开关与接头 | 依 6 节点架构配套 | 同规格常用线约 20% 余量 | 精确数量待物料表，不能用通用杜邦线替代专用接头 |
| USB 数据线 | 调试 2–3 台并行 | 1 根备用 | 共 3–4 根 |
| 打印结构 | 双机器人＋双手柄 | 转接试片与易损件 | 原模型修订后出精确零件单 |
| 软质攻击端 | 巴掌 1＋拳头 1 | 可各备 1 | 后续阶段 |
| 转轴/轴承/螺钉 | 按双足与 Punchy 改型 BOM | 约 20% 小件余量 | 未完成 CAD，不编造轴承型号/数量 |

电源核算需取得舵机电流数据；按实际可能同时动作的负载与启动峰值核对电池、扩展板、接头、线缆，不用端口数量代替供电计算。

## 7. NFC 冗余：先验证，再按一种架构增购

CB2 专属知识库未检出 NFC/RFID API。这不证明硬件绝对不支持，但目前不具备“即插即用”的证据。优先问套件方有无官方模块、接线与驱动。若选第三方，PN532 可作为接口验证候选，其芯片支持 SPI/I2C/HSU；具体模块的供电、电平、引出方式与固件支持需逐项核实。ESP32-S3 有外设能力不等于 CB2 的专用端口可随意接入第三方模块。

| 物料 | 第一阶段验证 | 扩展上限参考（不一次全买） |
|---|---:|---|
| NFC 读卡模块 | 1 个样品 | 手柄 2＋场景站 2＋备用 1＝5 个；机器人带读卡器方案则以机器人 2 替代场景 2 |
| 匹配的无源技能卡 | 5 张 | 共 20 张，包含测试/备用；先确认读卡协议匹配 |
| 匹配的小型无源标签 | 5 枚 | 10–20 枚；脚底识别、道具点及替换件 |
| 第三方接口适配/电平转换 | 按实测 | 不是必然需要，先核实电气协议与引脚 |
| 独立 NFC 辅助控制板 | 暂不定购 | CB2 原生接入受阻时才考虑；软件桥接也需验证，不能认为第六块 CB2 自动解决 |

### 两种场景方案

A：手柄读卡器识别技能卡；固定道具站读卡器识别机器人脚底/低位标签。优点是腿部轻、不加活动线缆；代价是道具点需要供电和控制。机器人每只脚可各放一个标签，两个 UID 映射到同一机器人，防重复计分。固定站的读卡器本身就可检出到达，无需再默认加距离传感器。

B：手柄读卡器识别技能卡；机器人脚底/低位读卡器识别场地标签。场地可便宜地铺多个被动点，但读卡器与线缆增加腿部负担，要测步行时能否稳定读取。读卡器装在一只脚下未必覆盖整台机器人扫过的位置。按场地和天线布置确定是否需要更多读头，不能承诺一枚就覆盖全部。

两方案不叠加采购；先建议验证 A，步态稳定后再考虑 B。NFC 适合靠近/停留触发，不作为远距离连续定位。不要预设具体读取距离，需使用实际模块、外壳厚度和天线测试。

## 8. 游戏技能如何实现

卡片只提供技能 ID；由程序判断玩家、目标、冷却、生效时间和是否重复刷卡，不需要卡片直接保存电机控制程序。可以用控制节点统一判定，再向机器人发状态事件。

- 对手减速：降低步态频率或控制输入比例，并平滑切换到新参数；不能在支撑转换中突然锁腿。
- 自己爆发：从保守常态提升到已验证的速度上限，或降低攻击冷却，持续若干秒后恢复。不要通过超额定电压、电流、解除机械限位来实现。
- 场景补给：按标签/机器人 ID 发放一次资源，带离开再进入和冷却逻辑。
- 无线收到技能后要有确认、去重与超时；同一竞技场消息应能到达规则节点/目标，不可把每对机器人隔离分组后又假定互相能直接收技能。

先使用按钮模拟技能事件，证明规则有趣，再加 NFC；这不影响以后卡牌接入。

## 来源

- Otto 官方四舵机说明：https://www.ottodiy.com/blog/ottodiykit
- 已保存原始 Otto STEP：`01_研究参考/robot-battle-reference/Otto-V9/CAD/OttoDIY_v09.step`
- CB2 本机文档：`01_研究参考/CyberBrick2软件研究/关键文档/`；能力研究样本 00.00.10.76 尚未与实物匹配。
- NXP PN532 数据手册：https://www.nxp.com/docs/en/nxp/data-sheets/PN532_C1.pdf
