paomodabaibai/CyberBrick2-User-Research-UX/04_结构与硬件/Otto_CB1出拳头部_v01/BOM.csv

类别 | 名称 | 数量 | 尺寸或型号 | 说明
已有待确认 | 030有刷直流马达 | 1 | LA024 | 用户有CB1电机但实际标识待核对
已有待确认 | 单轴减速齿轮组 | 1 | LA016 1:48 | 用户尚未确认是否有完整齿轮组及已装外壳
参考打印件 | 厂家减速箱上下壳 | 各1 | 官方CAD提取 | 已有则不重复打印
打印件 | 安装平台与导杆座 | 1 | 01_mount_and_guides | 见输出STL
打印件 | 曲柄 | 1 | 02_crank_keyed_hub | 先用08量规验证轴孔
打印件 | 连杆 | 1 | 03_connecting_rod | 默认孔距34mm
打印件 | 滑架 | 1 | 04_carriage_and_wrist | 默认滑孔直径3.45mm
打印件 | 空心拳套 | 1 | 05_hollow_boxing_glove_TPU | TPU候选
可选打印件 | 传感器支架 | 0或1 | 06_optional_sensor_bracket | 传感器选型后再完善
试装打印件 | 身体开口量规 | 1 | 07_body_fit_gauge | 先检查套合
试装打印件 | 输出轴孔量规 | 1 | 08_output_shaft_fit_gauge | 先检查双扁轴配合
打印件 | 身体安装圈 | 1 | 09_body_collar | 外耳带M3螺母槽
需另备 | 光滑金属导杆 | 2 | 直径3mm 长64mm | 不要用全螺纹螺杆当滑轨
需另备 | 低头螺钉A | 1 | M3x16 | 头外径不超过5.6mm 高不超过2mm
需另备 | 低头螺钉B | 1 | M3x25 | 头外径不超过5.6mm 高不超过2mm
需另备 | 转轴间隔垫 | 2 | 厚2mm 外径不超过6mm 内孔约3.2mm | 给连杆上下错层
需另备 | 转轴防松螺母 | 2 | M3 外包络不超过6.4mm 高4mm | 不可锁死转动副
需另备 | 转轴薄垫圈 | 2 | M3 外径不超过6.4mm | 厚度按装配间隙核对
需另备 | 拳套固定螺钉螺母垫片 | 1套 | M3x20 | 实物长度以腕部总厚度核对
需另备 | 平台外耳螺钉 | 4 | M3x12 | 上方装入
需另备 | 平台外耳螺母 | 4 | M3 普通六角 | 下方螺母窝对边5.8mm
需另备 | 导杆紧定螺钉 | 2 | M3x6 | 前支座2.6mm底孔需加工/试锁
需另备 | 减速输出轴锁紧螺钉 | 1 | 必须匹配原塑料输出轴 | 不能从模型避让孔反推螺纹规格
需另备 | 尼龙扎带 | 2 | 约2.5mm宽 | 固定减速器壳体且避开曲柄
沿用或另备 | 身体侧面固定螺钉螺母垫片 | 2套 | M3 长度按原身体确定 | 孔中心低于身体上沿4mm
可选 | 原位传感器与触发件 | 1套 | 未选型 | 精准单拳回位需要另外设计接入
