paomodabaibai/CyberBrick2-User-Research-UX/04_结构与硬件/CB2物料表转录与需求对照_2026-09-17.md

# CyberBrick 二期硬件清单转录与项目需求对照

来源：用户于2026-09-17提供的纸质表照片。直接按图转录；不是厂家电气规格，也不是已领库存。原表单位均为PCS，其中磁铁、螺丝按包装说明理解为包。

|序号|型号|物料名称|标称数量|备注|
|---|---|---|---:|---|
|1|CB001|Octo主控板|1||
|2|CB010|用户交互面板|1||
|3|CB101|距离传感器|1||
|4|CB102|光线传感器|1||
|5|CB103|磁力传感器|1||
|6|CB201|按键|1||
|7|CB202|旋钮|1||
|8|CB203|盘式编码器|1||
|9|CB204|双通道摇杆带按键|1||
|10|CB205|单通道不回中摇杆|1||
|11|CB206|微动开关|1||
|12|CB301|电池|1||
|13|CB302|舵机|1||
|14|CB303|直流电机|1||
|15|CB401|RGB驱动灯|1||
|16|CB402|RGB串联灯|1||
|17|CB403|像素屏幕模块|1||
|18|CB405|扬声器|1|PCBA上面编码错印成“CB403”|
|19|CB406|IPS屏幕|1||
|20|—|5pin通用线缆：2端公头—8cm|11|原表备注：共3袋，有白色标记单条线独立包装的线为“CB403”专用；专用线是否计入11根须实物核对|
|21|—|5pin通用线缆：2端公头—15cm|2||
|22|—|5pin通用线缆：2端公头—30cm|2||
|23|—|3pin线缆|1||
|24|CA001|磁铁D4×2圆形磁铁（20pcs包装）|1|1包，内含20枚|
|25|AA100|BT2.5×6螺丝（20pcs包装）|1|1包，内含20枚|
|26|—|H1.5内六角螺丝刀|1||
|27|—|H2.0内六角螺丝刀|1||

## 对原需求清单的修正

- 六块主板明确指 CB001 Octo主控板：两机器人＋两手柄＋两个场景/备用节点，不等于申请六套完整物料包。
- CB010 名称为“用户交互面板”。仅凭这张表不能认定它是之前讨论的扩展板或每块主板必配一块；需看实物、接口图和套件说明。此前“扩展/供电组件最多6套”是预留，不能直接写成 CB010×6。
- 周末四舵机腿部：CB001×1；CB302×4在用＋1备用；CB301×1（供电能力待核实）；对应连接线、舵盘、紧固件与双足打印件。若只收到一份清单所列物料，只有1个舵机，还差3个才能组成四轴，按含1备用的准备量则差4个；这是假设，不代表已盘点库存。
- 完整两机：CB302暂按11个（腿8＋巴掌1＋备用2）。CB303拳击电机暂按1个候选，不能仅凭“直流电机”确认力矩/减速/驱动匹配。
- 遥控输入建议 CB204×2（每手柄一个双通道摇杆），自带按键先预留一个功能；额外 CB201×2作为独立攻击/确认按钮候选。原来“最多另配4按键”改为功能分配后补足，不直接重复采购。
- CB301先按两机器人＋两手柄共4个移动节点规划，场景/备用按使用方式增加0–2个；容量、额定输出、充电方式均不能从本表推断。
- 5pin线缆的存在不证明所有模块都使用同一种线序。须确认 CB302 实际接头与配线；不能沿用常规SG90三线经验。8/15/30cm按真实布线路径分配，CB403白标专用线不作为通用备用线混用。
- NFC/RFID读卡器未列出。CB103磁力传感器＋CA001磁铁可考虑做“有无磁铁/到达点”类低复杂度触发，但不能因此读出多张NFC卡的身份或技能编号。磁力传感器的实际输出方式需查对应文档并实测。
- CB401/CB402/CB403/CB405/CB406可作为技能与比分反馈候选，不列为周末行走必需。屏幕和音响先留给手柄/场景节点，避免过早加重机器人。

## 仍然缺少的信息

CB302外形尺寸、孔位、轴心、舵盘接口、重量、扭矩、速度、供电/电流；CB001接口与外设供电方式；CB010功能；CB301供电能力。收到实物照片后再决定转接座还是重建腿脚壳。现阶段没有完成CB2适配CAD。
