paomodabaibai/CyberBrick2-User-Research-UX/04_结构与硬件/硬件现货清单_2026-09-23.md

# 硬件现货清单（实收核对版）

日期：2026-09-23。填写纪律（来自六周路线图 §7.4）：**只有真实到手才写"具备"；未知填"未核对"，不当作已采购。**
状态分级：✅已实测确认 ｜ 🔎推断待实物核对 ｜ ❓未核对 ｜ 🛒待采购/待收

## 1. 板卡与遥控

| 物品 | 数量 | 状态 | 依据 |
|---|---|---|---|
| CB1 接收板 | 1 | ✅ | 实测 COM7（USB 序列 58:E6:C5:A8:1B:0C），boot 自启已禁用 |
| CB1 发射板（遥控器） | 1 | ✅ | 实测 COM8；双杆+K1–K4 按钮 |
| 遥控按钮可用数 | K4 已实测；K1–K3 | 🔎 | 36s 采集只验证了 K4；K1–K3 数量/功能未逐一核对 |
| 第二套 CB1（接收+发射） | 0 | 🛒 | 第二台对战必需，来源未定 |

## 2. 舵机

| 物品 | 数量 | 状态 | 依据 |
|---|---|---|---|
| 腿部 180° 位置舵机 | 3（S1/S3/S4 位） | 🔎 | 实测均为位置型且可动作；**型号推断 PG001，待实物标签核对** |
| 360° 连续旋转舵机 | 1（现占 S2） | 🔎 | 实测连续旋转（PG002 推断）；计划移用为巴掌横扫执行器 |
| 左踝换装用 180° PG001 | 0 | 🛒 | **来源未记录——第2周最高优先级采购项**（六周路线图 §6 降级线：缺件则只做三路台架） |
| 巴掌第五路舵机 | 0（计划用现有 360°移用 或 PG001） | ❓ | 控制策略待第4周按实物定（位置型=有限角往返；连续型=方向/速度+停转） |
| 舵盘（各舵机原配） | 每舵机1 | ❓ | SG90 舵盘与 PG001 舵盘花键兼容性未证实，各用原配 |

## 3. 结构与打印件

| 物品 | 数量 | 状态 | 依据 |
|---|---|---|---|
| Otto V9 身体/头/腿×2/脚×2 | 1 套 | 🔎 | 路线图记录"已打印"；打印质量/配合未系统记录 |
| 75mm 巴掌手掌 + 腕接口 + 顶部框/桥 + 舵机桥 | 1 套打印件 | 🔎 | 模型已有；装配与强度待证实（第4周） |
| Punchy 拳头参考件 | 0 | ❓ | 第5周目标；LA016 1:48 减速包适配未验证 |

## 4. 电气与辅材

| 物品 | 数量 | 状态 | 依据 |
|---|---|---|---|
| CB1 专用舵机线/连接线 | ? | ❓ | 未核对 |
| 供电电池 + 物理断电开关 | ? | ❓ | 开关被列为安全必备，库存未核对 |
| 第五路 D1/GPIO21 信号线序 | — | ❓ | 未核对（第4周任务） |
| 五舵机同时供电能力 | — | ❓ | 未验证（第4周掉压观察） |
| 紧固件（M2×8×2、M2×25×1、螺母×3/巴掌等） | ? | ❓ | 装配说明有清单，实物库存未核对 |
| NFC 读卡模块 | 0 | 🛒 | CB2 申请表中，非本阶段主线 |

## 5. 第二台整机缺口（汇总）

第二块 CB1 接收+发射、4×腿部舵机（其中左踝必须 180°）、巴掌声部舵机、全套打印件、独立 config 与标定记录——**全部未核对/未采购**。第 5 周前需完成缺口确认。

---
维护：每次实机 session 后更新本清单（含新采购/新核对项），与《逐关节安装记录表》联动；舵机实物型号核对结果回写 config 注释。
