paomodabaibai/CyberBrick2-User-Research-UX/04_结构与硬件/硬件需求清单_讨论稿.md

# 硬件需求清单｜小组讨论稿

估算前提：两台桌面双足机器人、两个独立遥控器、一对一；每台四个角度舵机驱动双腿，一个独立攻击执行器。数量是方案估算，不是采购定案。CB1、CB2、舵机型号与供电方案尚未确认。

## 机器人端

| 部件 | 单台 | 两台合计 | 说明 |
|---|---:|---:|---|
| 控制核心 | 1 | 2 | 接收遥控并协调运动；若套件集成需避免重复计数 |
| 接收/驱动扩展组件 | 1 组 | 2 组 | 具体形式取决于平台 |
| 角度舵机：腿部 | 4 | 8 | 要保持指定角度；不能用连续旋转舵机直接替代 |
| 攻击执行器 | 1 | 2 | 减速电机或角度舵机二选一，不能把两项都算为必购 |
| 电池/供电组 | 1 | 2 | 电压、容量、放电能力、充电方式按板卡与负载确定 |
| 电源开关 | 1 | 2 | 若套件已集成不重复购买 |
| 打印壳体、短腿与脚 | 1 套 | 2 套 | 先核对舵机尺寸和轴位置；只打印安装小样再打整机 |
| 攻击模块结构件 | 1 套 | 2 套 | 独立转轴、连杆或凸轮按选定结构确定 |
| 软质手掌/拳头与软限位 | 1 套 | 2 套 | 轻量、可更换；减少冲击直接进入齿轮和壳体 |
| 脚底摩擦材料 | 1 套 | 2 套 | 根据步态与场地试选，不直接假定越防滑越好 |

## 遥控端与主板计数

| 部件 | 两套遥控合计 | 说明 |
|---|---:|---|
| 遥控端控制核心 | 2 | 与机器人端合计暂按 4 个核心；集成遥控器不重复申领 |
| 发射/输入扩展组件 | 2 组 | 具体型号待确认 |
| 双轴摇杆 | 2 | 每位玩家一个，用于移动/转向；保留套件原摇杆也可 |
| 攻击按钮 | 2 | 每位玩家一个；按最终遥控器布局确定是否另购 |
| 遥控器供电组 | 2 | 与机器人端合计 4 组供电，未必使用同种电池 |
| 遥控器壳体 | 2 套 | 如套件已提供则不重复制作 |

## 接线：按连接用途统计

| 连接 | 双机双遥控需求估算 | 需要确认 |
|---|---:|---|
| 腿部舵机到接收板 | 8 路 | 舵机通常自带线，只有长度不足才另购延长线；可备 2–4 条合适延长线 |
| 攻击执行器连接 | 2 路 | 电机用对应两芯线；舵机用对应三芯线，随结构二选一 |
| 电池到供电组件 | 4 路 | 若经独立开关，可能每路分成两段；端子与板卡一致 |
| 双轴摇杆到发射板 | 暂按 4 路三芯线 | 仅适用于两个轴分别接线的方案；集成接口会改变数量 |
| 攻击按钮到发射板 | 暂按 2 路两芯线 | 按套件接口与线长核对 |
| USB 数据线 | 1–2 条共用 | 调试/上传用，接口与实际主板一致 |

目前能明确的是连接路数，不是所有线缆的采购条数。定案时补充接头类型、长度、是否随部件附带和备用数量；不能直接买一批同样的线代替核对。

## 条件性部件

| 部件 | 暂定需求 | 加入条件 |
|---|---|---|
| 舵机扩展驱动 | 待定 | 若选四舵机腿＋舵机攻击且板卡无额外可用输出，需要先验证扩展兼容性 |
| 攻击转轴与轴套/轴承 | 每台 1 组候选 | 凸轮或摆臂方案需要；尺寸与数量由结构决定，不先固定轴承型号 |
| 轻弹性件 | 每台 1 组候选 | 仅用于弹性释放方案；先做小能量动作样机 |
| 复位检测开关/霍尔元件 | 每台 1 个候选 | 直流电机机构如需可靠单次攻击与停在原位；须确认传感器输入支持 |
| 姿态传感器 | 首版不列必需 | 仅在自动倒地判定有必要且平台支持时增加 |
| 指示灯/蜂鸣器 | 可选 | 用于准备、攻击或结果反馈；确认接口与套件是否自带 |
| 螺丝、螺母、垫片、舵盘 | 按装配清单＋少量备件 | 先确定模型版本与实物孔位；不要预先混用 M2/M3 |
| 轮子 | 当前双足方案不需要 | 只有改成轮式备选时重新计入 |
| 擂台底板、边界标识 | 共 1 套 | 尺寸由转向半径、攻击距离和桌面确定，避免先写成固定尺寸 |

## CB1 参考约束

公开资料中的 XA004 接收扩展板有 4 路舵机和 2 路直流电机接口。因此四舵机双腿已占满舵机接口，电机攻击方案在接口数量上更直接，但仍需检查供电与负载。

来源：[CyberBrick 官方组件说明](https://wiki.bambulab.com/en/makerworld/cyberbrick/component-list)。该信息不自动适用于 CB2；待拿到具体套件资料再定案。

## 今晚应补齐的选型信息

平台/主板型号、舵机型号与尺寸、执行器方案、套件已有清单、供电件、线缆接头、首版机器人数、预算与现货。没有实物尺寸前，不生成看似精确的内部爆炸图或采购总价。
