paomodabaibai/CyberBrick2-User-Research-UX/04_结构与硬件/2026-09-21_整机首轮试打印包/先看这里_本次打印清单.md

# 本次打印清单｜以本文件为准

用户决定直接进行完整首轮试打印，包括完整手掌与顶部舵机架，不再以先打印量规作为前置条件。这里合并当前正确版本，共5件，每件打印1个；旧短杆、旧薄片巴掌、腕部小样、量规均不需要重复打印。现有Otto身体和腿脚继续使用。

|文件|数量|约尺寸mm|摆放与注意事项|
|---|---:|---|---|
|01_身体顶部安装框|1|75×75×30|沿当前姿态，外套框朝下；检查上沿悬挑、支座螺母槽桥接|
|02_PG001舵机安装桥|1|75×22×3|平放；保持孔位与开口原尺寸|
|03_连接杆_杆距51mm|1|63.5×10×3|平放；不要整体缩放杆|
|04_腕部连接块|1|23×12×6|平放，六角螺母槽朝上；清理小横孔|
|05_完整巴掌75mm|1|75×55.5×29.8|文件已侧放；曲面需检查支撑和底面接触，重点保护腕部插槽与螺母槽|

## 导入切片软件
- 只导入本目录5个STL，作为5个独立物体导入，再自动排列。不要按同一个多零件装配体导入，否则它们会挤在一起。
- 全部100%比例，按毫米。原始Tripo的1单位缩放问题已经处理，巴掌最长边应显示75mm。
- 可以把前四件放一盘，完整巴掌单独一盘，方便分别设置支撑；是否能同盘取决于打印机平台与排列间距。
- 第一轮尺寸试装可先用PLA、约0.2mm层高、3～4圈墙，约15～20%填充作为起始设置。杆/连接块很小，切片后的实体比例可能很高，不需要强求某个填充百分比。
- 巴掌按切片预览添加必要支撑，避免把盲插槽和螺母槽塞满难拆支撑。安装框顶部局部悬挑/小槽也要在预览中检查，不能承诺全部免支撑。
- 本次没有生成打印机专用3MF工程或G-code，也没有实际切片；耗材重量、时间及支撑由选定机型和切片结果确定。

## 拿到打印件后
先清除支撑毛边，干装舵机与身体接口；核对松紧后再钻原身体的固定孔。按参考说明安装腕部连接块和螺钉。只有套合困难时才局部调整，不要靠整件缩放修孔。
腕部新增螺钉：M2×8两颗、M2×25一颗，M2普通六角螺母三颗，小垫片一片。原配舵盘及其中心螺钉仍需保留；舵盘小自攻螺钉、舵机安装耳螺钉、支架M3螺钉详见两份参考说明。
参考说明中仍有旧阶段“先打印量规/小样”的文字：本次打印范围以本清单为准，其装配孔位和螺钉说明继续适用。

## 状态
本包五件已重新读取并确认STL网格闭合，尺寸核对完成。属于完整首轮试打印，不是经过实物验证的最终成品；接口松紧、打印支撑效果、舵机负载和挥掌稳定性仍需实际验证。
