paomodabaibai/CyberBrick2-User-Research-UX/04_结构与硬件/CyberBrick二期硬件清单_用户原图.jpg

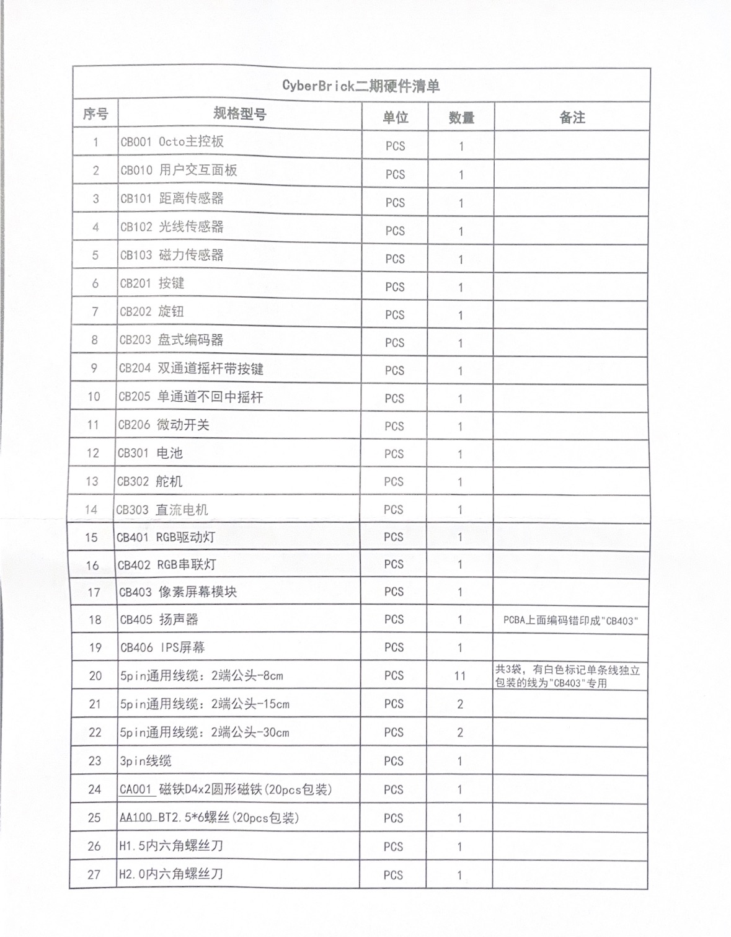
04_结构与硬件/CyberBrick二期硬件清单_用户原图.jpg
