paomodabaibai/CyberBrick2-User-Research-UX/04_结构与硬件/Otto_CB1出拳头部_v01/output/assembly_180deg.step

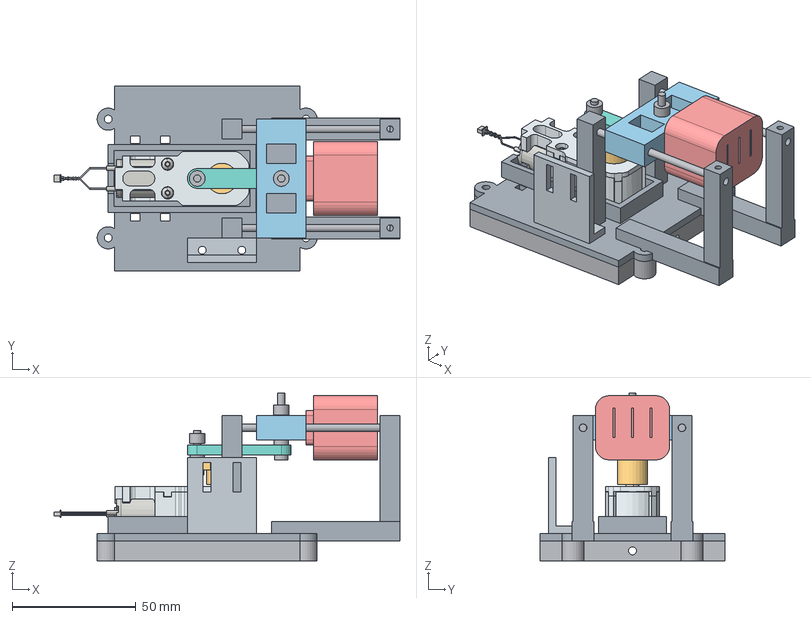
[picture p132: CAD file, 2026-09-28]
04_结构与硬件/Otto_CB1出拳头部_v01/output/assembly_180deg.step
139.9 x 75.0 x 67.8 mm
body_collar
guide_rod_-20
guide_rod_+20
base
sensor_bracket
ref_00
ref_01
ref_02
ref_03
ref_05
ref_06
ref_07
ref_08
ref_09
ref_10
ref_11
ref_12
ref_13
crank
link
carriage
glove
pin_A
washer_A
pin_B
washer_B
output_gear
