paomodabaibai/CyberBrick2-User-Research-UX/01_研究参考/CyberBrick1迁移研究/Remote Control Transmitter-XA003-XA005.stp

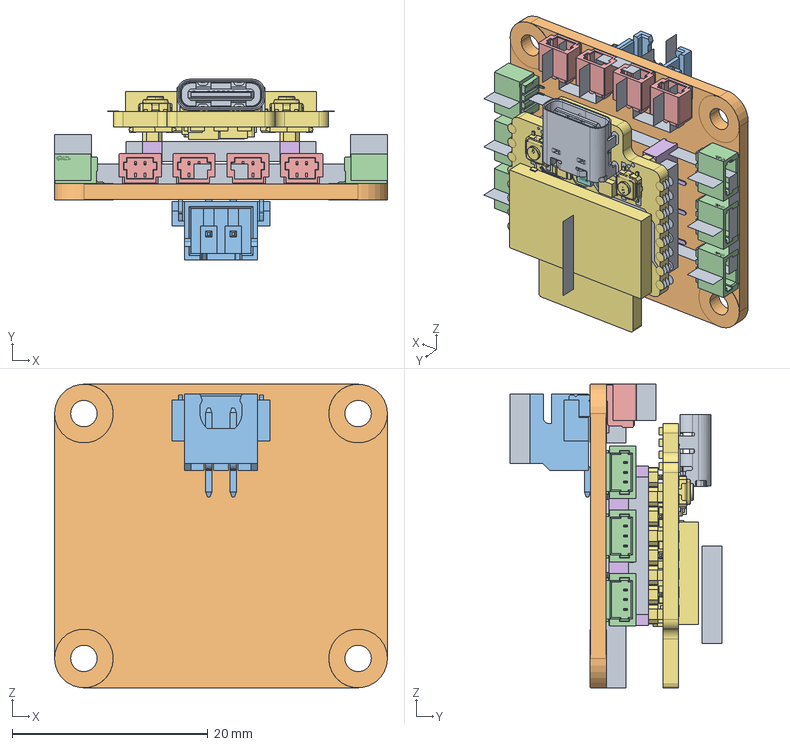
[picture p133: CAD file, 2026-09-28]
01_研究参考/CyberBrick1迁移研究/Remote Control Transmitter-XA003-XA005.stp
34.0 x 21.6 x 31.0 mm
PCB-V2000
DIANYUAN-B
1_0-3PIN x 6
1_0-2PIN x 4
2_0-8PIN x 2
CORE-V3-3
