paomodabaibai/CyberBrick2-User-Research-UX/01_研究参考/攻击模块/Punchy/joystick.stp

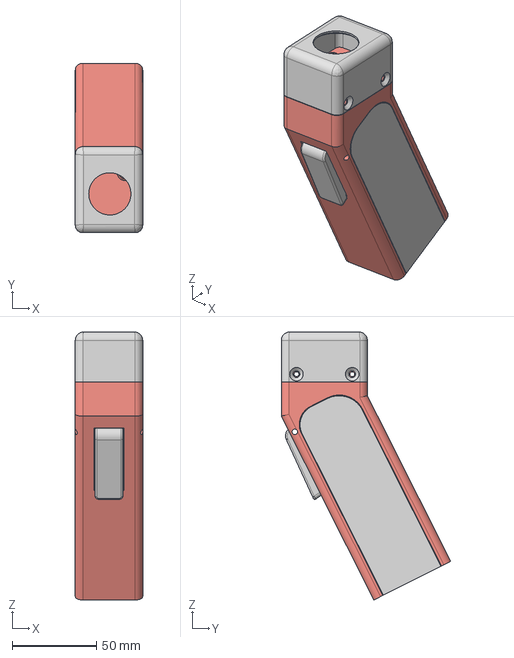
[picture p134: CAD file, 2026-09-28]
01_研究参考/攻击模块/Punchy/joystick.stp
40.0 x 100.3 x 158.7 mm
