paomodabaibai/CyberBrick2-User-Research-UX/04_结构与硬件/2026-09-21_整机首轮试打印包/01_身体顶部安装框_打印1件.stl

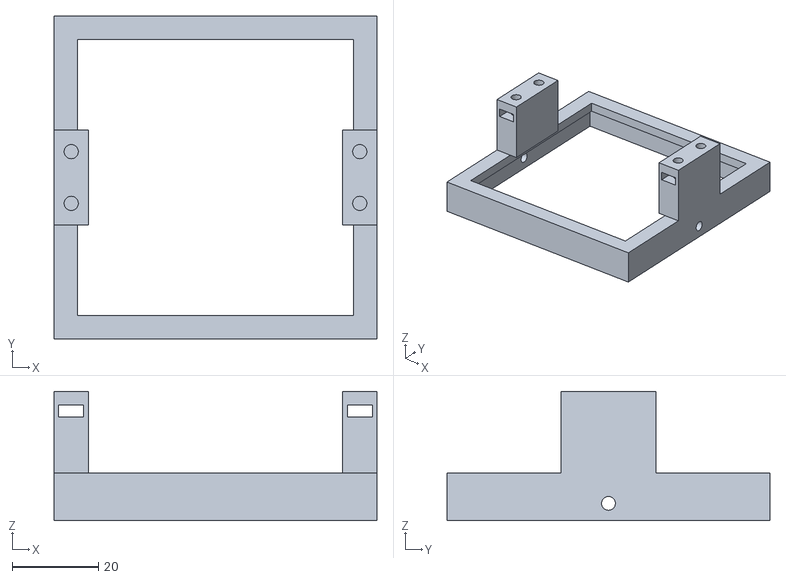
[picture p135: CAD file, 2026-09-28]
04_结构与硬件/2026-09-21_整机首轮试打印包/01_身体顶部安装框_打印1件.stl
75.0 x 75.0 x 30.0
