paomodabaibai/CyberBrick2-User-Research-UX/04_结构与硬件/Otto_75mm巴掌腕部接口_v02/STEP_结构件/05_完整连接杆_杆距51mm.step

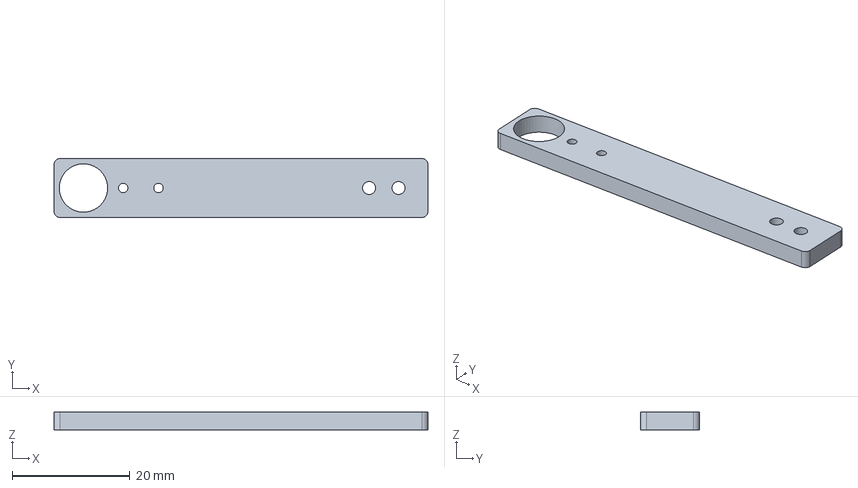
[picture p136: CAD file, 2026-09-28]
04_结构与硬件/Otto_75mm巴掌腕部接口_v02/STEP_结构件/05_完整连接杆_杆距51mm.step
63.5 x 10.0 x 3.00 mm
