paomodabaibai/CyberBrick2-User-Research-UX/04_结构与硬件/Otto_CB1出拳头部_v01/output/STEP_可编辑实体/03_connecting_rod.step

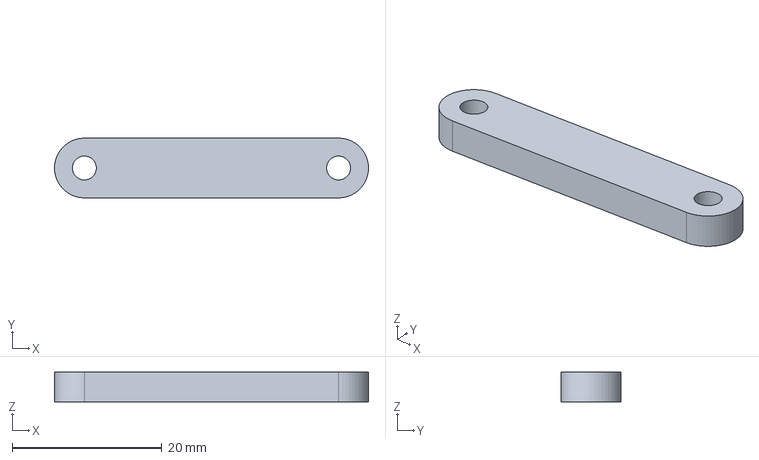
[picture p137: CAD file, 2026-09-28]
04_结构与硬件/Otto_CB1出拳头部_v01/output/STEP_可编辑实体/03_connecting_rod.step
42.0 x 8.00 x 4.00 mm
