paomodabaibai/CyberBrick2-User-Research-UX/04_结构与硬件/Otto_CB1出拳头部_v01/output/STL_打印件/06_optional_sensor_bracket.stl

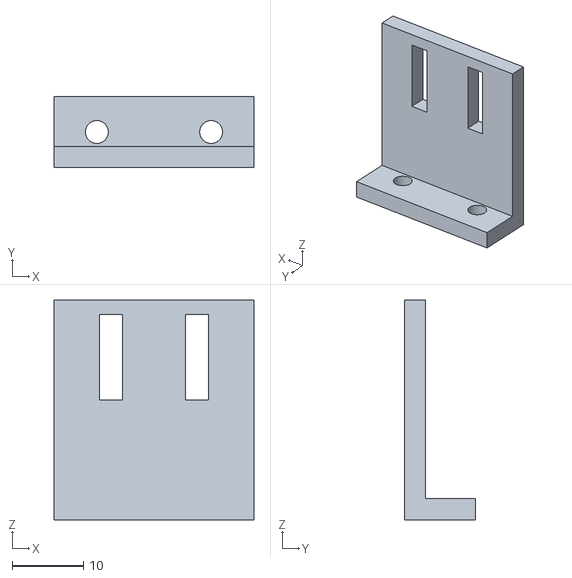
[picture p138: CAD file, 2026-09-28]
04_结构与硬件/Otto_CB1出拳头部_v01/output/STL_打印件/06_optional_sensor_bracket.stl
28.0 x 10.0 x 30.8
