paomodabaibai/CyberBrick2-User-Research-UX/04_结构与硬件/Otto_CB1出拳头部_v01/参考资料/030 Micro DC Motor with SH1.0 - Reducer-LA024.stp

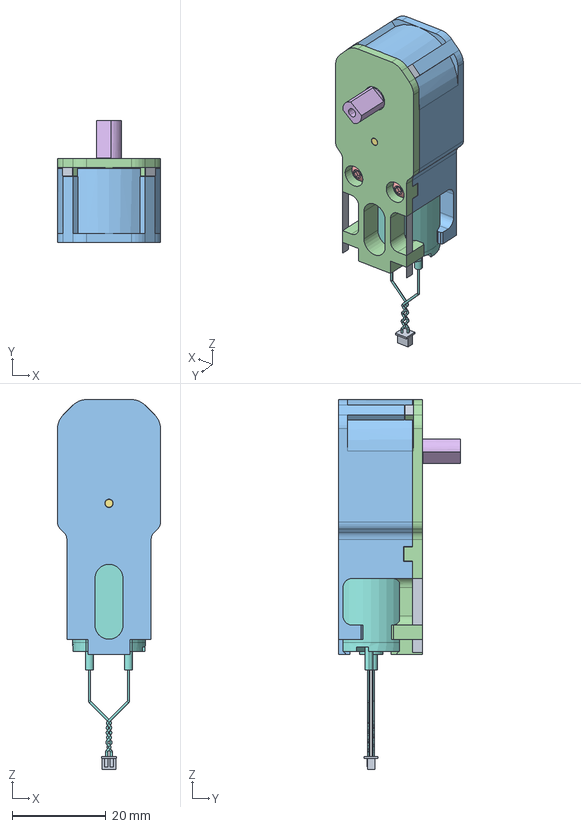
[picture p140: CAD file, 2026-09-28]
04_结构与硬件/Otto_CB1出拳头部_v01/参考资料/030 Micro DC Motor with SH1.0 - Reducer-LA024.stp
22.0 x 26.1 x 78.9 mm
01-2-18MM0 x 2
8CHI
01-030A-V20001
01-030B0001
M2_5X6_BHCS_MACHINE_SCREW_-_AA0 x 2
