paomodabaibai/CyberBrick2-User-Research-UX/04_结构与硬件/Otto_PG001顶部巴掌模块_v01/STL_打印件/06_palm_trial.stl

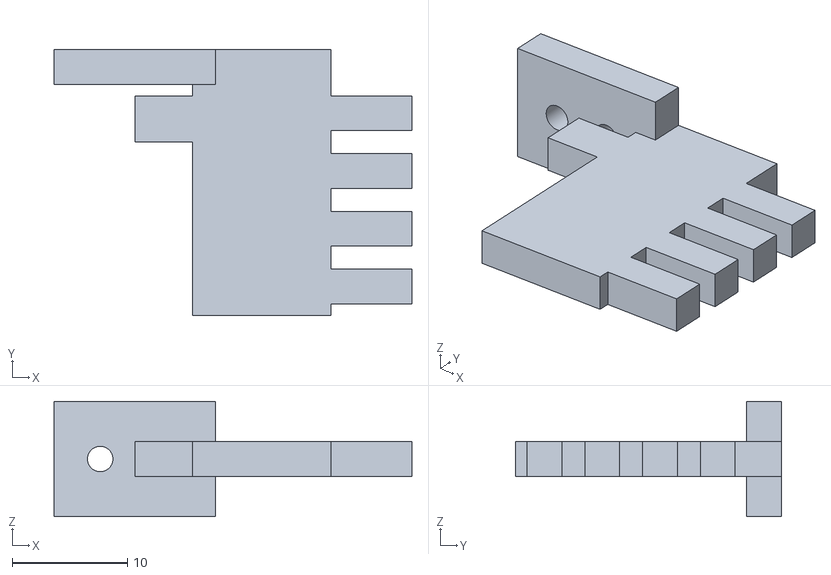
[picture p141: CAD file, 2026-09-28]
04_结构与硬件/Otto_PG001顶部巴掌模块_v01/STL_打印件/06_palm_trial.stl
31.0 x 23.0 x 10.0
