paomodabaibai/CyberBrick2-User-Research-UX/04_结构与硬件/Otto_PG001顶部巴掌模块_v01/顶部模块装配_含参考舵机.step

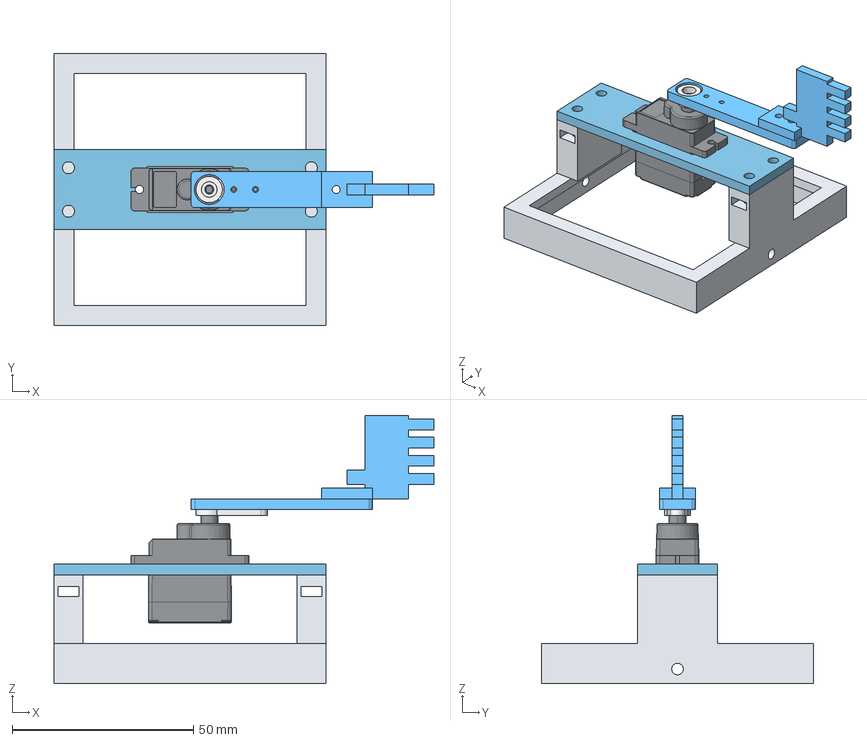
[picture p142: CAD file, 2026-09-28]
04_结构与硬件/Otto_PG001顶部巴掌模块_v01/顶部模块装配_含参考舵机.step
104.8 x 75.0 x 74.0 mm
frame
bridge
PG001_reference
original_horn_reference
arm_trial
palm_trial
