paomodabaibai/CyberBrick2-User-Research-UX/04_结构与硬件/巴掌_Tripo网格与尺寸调整/巴掌_Tripo原始.stl

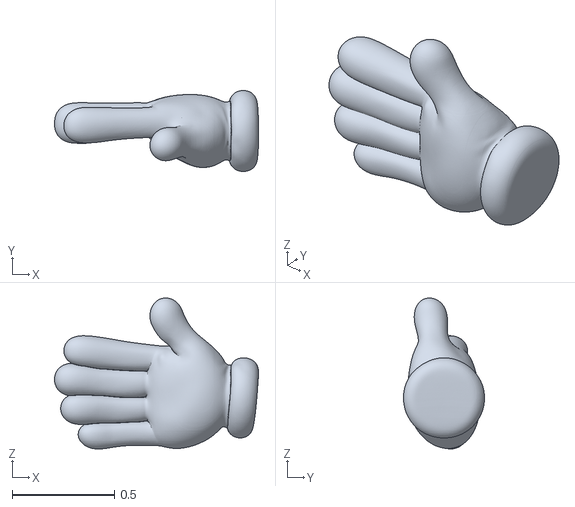
[picture p143: CAD file, 2026-09-28]
04_结构与硬件/巴掌_Tripo网格与尺寸调整/巴掌_Tripo原始.stl
1.00 x 0.397 x 0.74
