paomodabaibai/CyberBrick2-User-Research-UX/04_结构与硬件/巴掌_Tripo网格与尺寸调整/输出_手掌45mm_杆距42.5mm/手掌_最长边45mm_尚无安装接口.stl

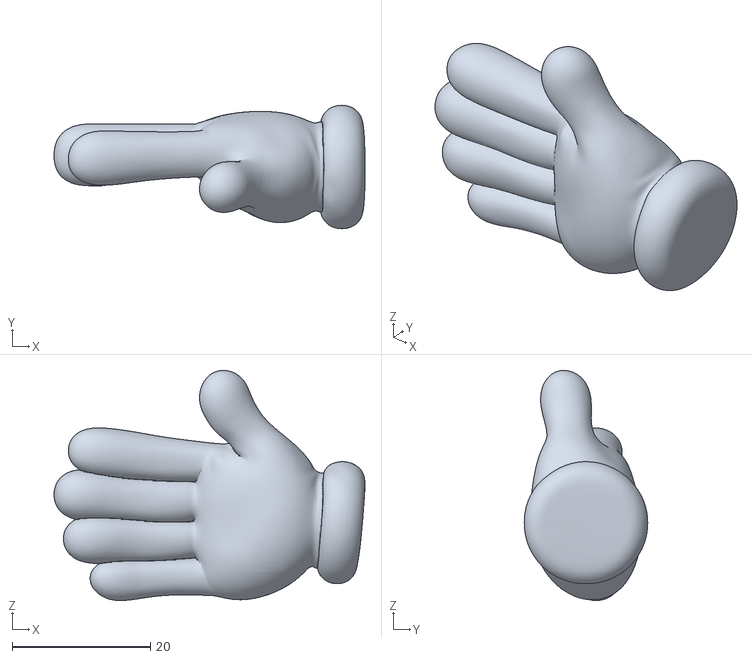
[picture p144: CAD file, 2026-09-28]
04_结构与硬件/巴掌_Tripo网格与尺寸调整/输出_手掌45mm_杆距42.5mm/手掌_最长边45mm_尚无安装接口.stl
45.0 x 17.9 x 33.3
