paomodabaibai/CyberBrick2-User-Research-UX/04_结构与硬件/巴掌_Tripo网格与尺寸调整/输出_手掌50mm_杆距37.5mm/连接杆_孔组中心距37.5mm.step

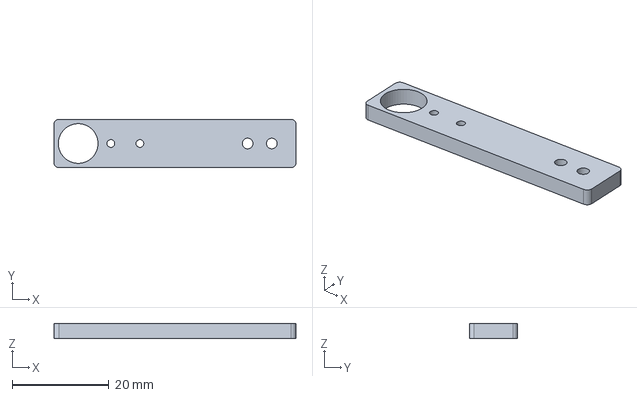
[picture p145: CAD file, 2026-09-28]
04_结构与硬件/巴掌_Tripo网格与尺寸调整/输出_手掌50mm_杆距37.5mm/连接杆_孔组中心距37.5mm.step
50.0 x 10.0 x 3.00 mm
