paomodabaibai/CyberBrick2-User-Research-UX/04_结构与硬件/巴掌_Tripo网格与尺寸调整/输出_手掌75mm_杆距51mm/手掌_最长边75mm_尚无安装接口.stl

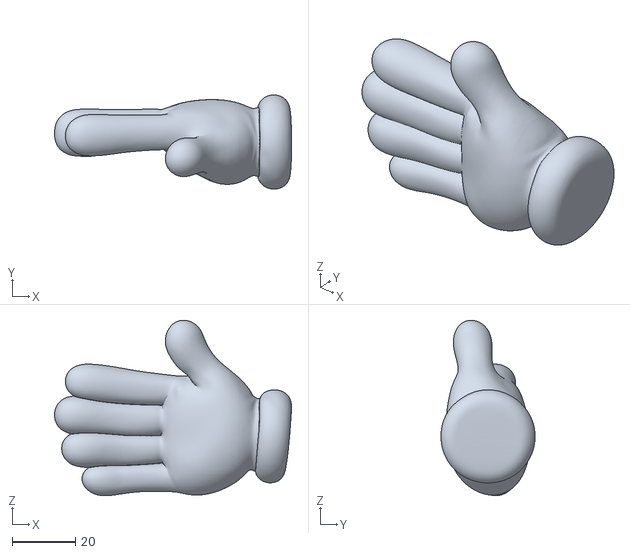
[picture p146: CAD file, 2026-09-28]
04_结构与硬件/巴掌_Tripo网格与尺寸调整/输出_手掌75mm_杆距51mm/手掌_最长边75mm_尚无安装接口.stl
75.0 x 29.8 x 55.5
