paomodabaibai/CyberBrick2-User-Research-UX/04_结构与硬件/拳头_3D生成参考/红色拳头_AI原始模型_v01.stl

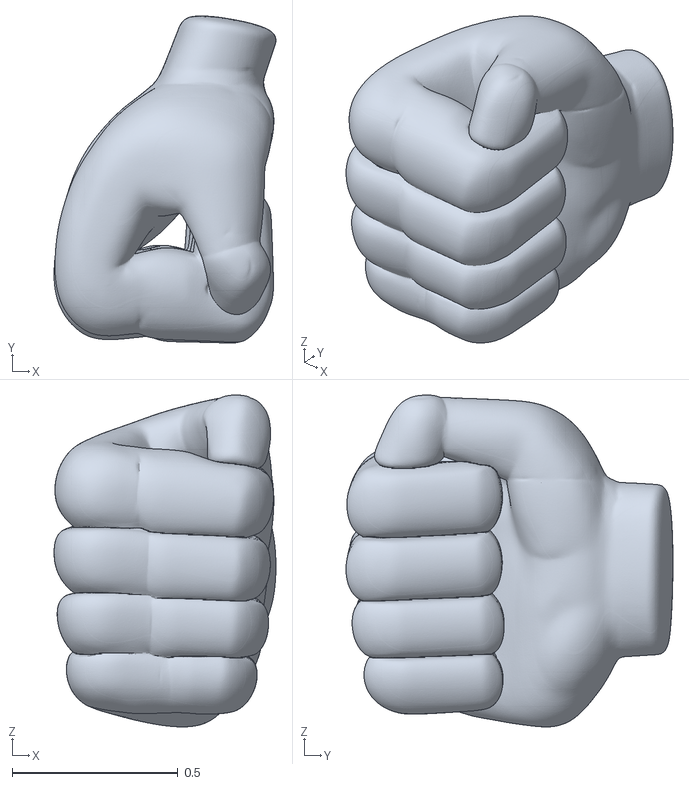
[picture p147: CAD file, 2026-10-07]
04_结构与硬件/拳头_3D生成参考/红色拳头_AI原始模型_v01.stl
0.669 x 0.985 x 1.00
