paomodabaibai/CyberBrick2-User-Research-UX/04_结构与硬件/拳头_全套打印包_2026-09-29/02_曲柄_打印1件.stl

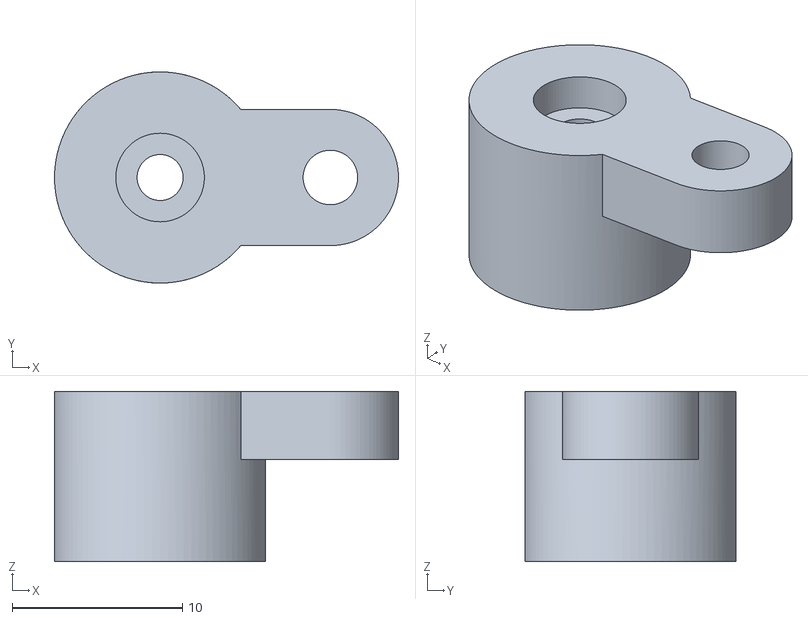
[picture p148: CAD file, 2026-10-07]
04_结构与硬件/拳头_全套打印包_2026-09-29/02_曲柄_打印1件.stl
20.2 x 12.4 x 10.0
