paomodabaibai/CyberBrick2-User-Research-UX/04_结构与硬件/拳头_全套打印包_2026-09-29/可选_试配量规/减速输出轴量规.stl

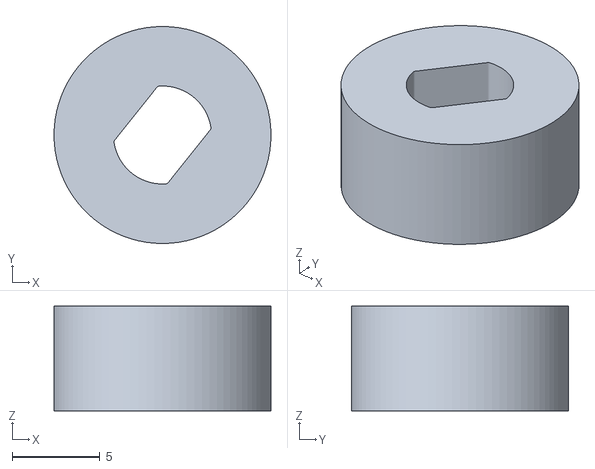
[picture p149: CAD file, 2026-10-07]
04_结构与硬件/拳头_全套打印包_2026-09-29/可选_试配量规/减速输出轴量规.stl
12.4 x 12.4 x 6.00
