paomodabaibai/CyberBrick2-User-Research-UX/04_结构与硬件/拳头_全套打印包_2026-09-29/备选_请勿与05一体拳头同时打印/腕部连接杆_需另行固定拳头.stl

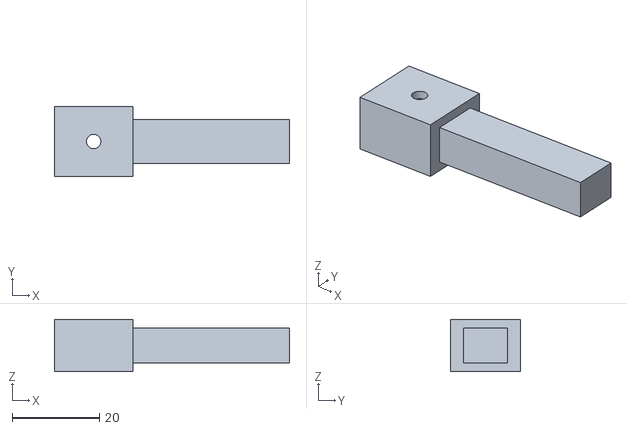
[picture p150: CAD file, 2026-10-07]
04_结构与硬件/拳头_全套打印包_2026-09-29/备选_请勿与05一体拳头同时打印/腕部连接杆_需另行固定拳头.stl
54.0 x 16.0 x 12.0
