paomodabaibai/CyberBrick2-User-Research-UX/04_结构与硬件/拳头_整体比例预览_v03/开放式底座_v01_试装/开放一体底座_后移22mm_试装.step

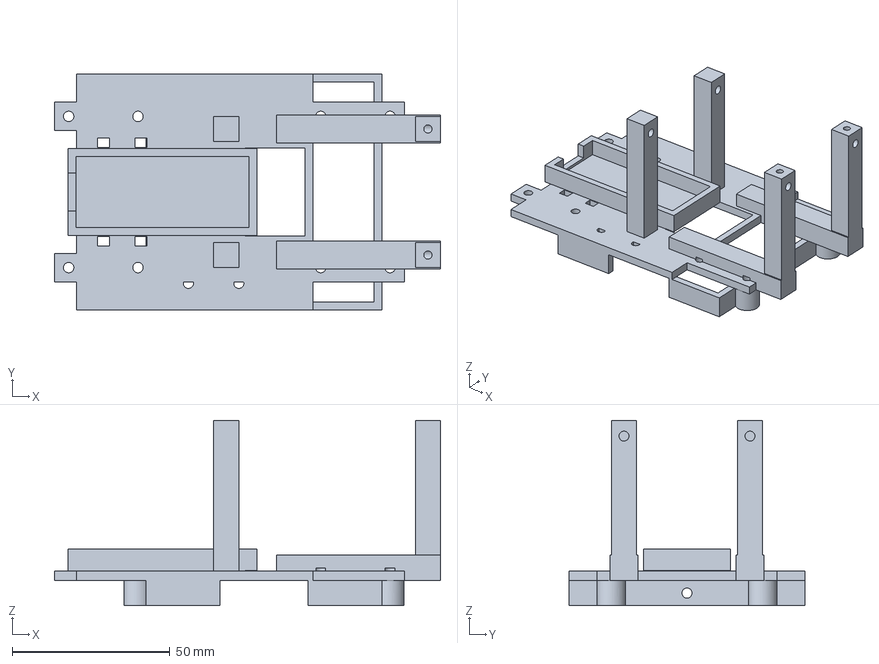
[picture p151: CAD file, 2026-10-07]
04_结构与硬件/拳头_整体比例预览_v03/开放式底座_v01_试装/开放一体底座_后移22mm_试装.step
122.5 x 75.0 x 58.8 mm
