paomodabaibai/CyberBrick2-User-Research-UX/04_结构与硬件/拳头_整体比例预览_v03/拳头微调导出.stl

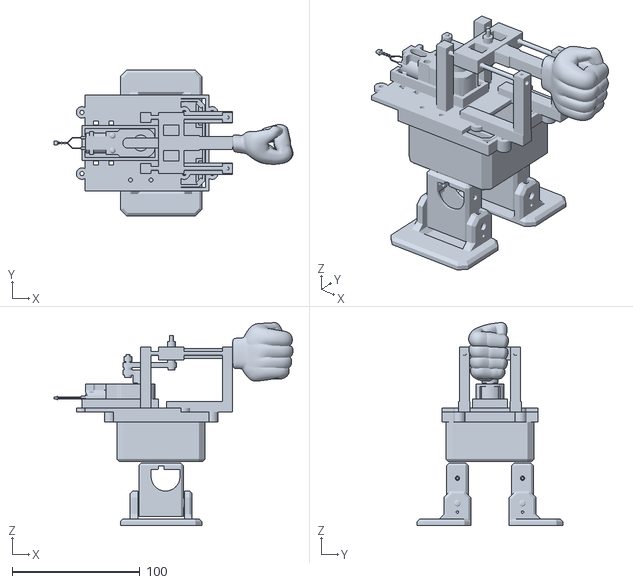
[picture p152: CAD file, 2026-10-07]
04_结构与硬件/拳头_整体比例预览_v03/拳头微调导出.stl
187.2 x 114.0 x 159.0
