paomodabaibai/CyberBrick2-User-Research-UX/04_结构与硬件/落地墙体竞技场_v04/stl/05_seam_coupon_left.stl

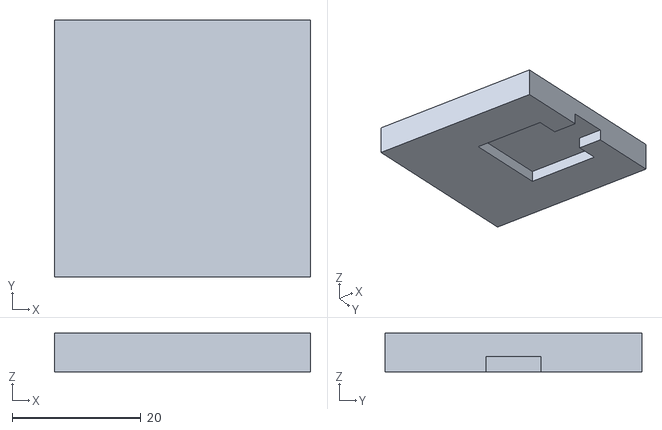
[picture p154: CAD file, 2026-10-17]
04_结构与硬件/落地墙体竞技场_v04/stl/05_seam_coupon_left.stl
39.8 x 40.0 x 6.00
