paomodabaibai/CyberBrick2-User-Research-UX/04_结构与硬件/错位T墙竞技场_v05/assembly/arena_A_reference_only.step

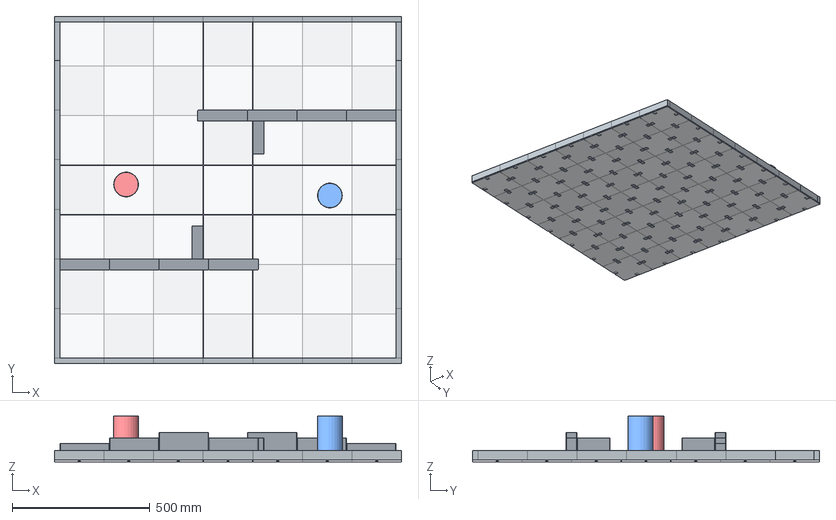
[picture p155: CAD file, 2026-10-17]
04_结构与硬件/错位T墙竞技场_v05/assembly/arena_A_reference_only.step
1260.0 x 1260.0 x 166.0 mm
F-A1
F-A2
F-A3
F-A4
F-A5
F-A6
F-A7
F-B1
F-B2
F-B3
F-B4
F-B5
F-B6
F-B7
F-C1
F-C2
F-C3
F-C4
F-C5
F-C6
F-C7
F-D1
F-D2
F-D3
F-D4
F-D5
F-D6
F-D7
F-E1
F-E2
F-E3
F-E4
F-E5
F-E6
F-E7
F-F1
F-F2
F-F3
F-F4
F-F5
F-F6
F-F7
F-G1
F-G2
F-G3
F-G4
F-G5
F-G6
F-G7
J-X-1-1
J-X-1-2
J-X-1-3
J-X-1-4
J-X-1-5
J-X-1-6
J-X-2-1
J-X-2-2
J-X-2-3
J-X-2-4
J-X-2-5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
