paomodabaibai/CyberBrick2-User-Research-UX/06_游戏设计/打印脱落球靶_v09/制造初样_v01/01_先打小样/小样_套筒_单边0.4mm.stl

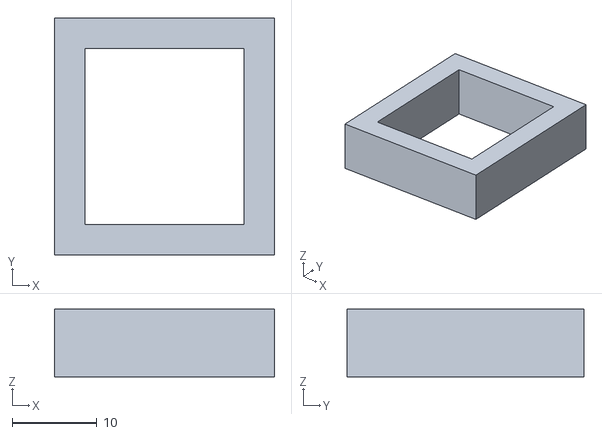
[picture p157: CAD file, 2026-10-22]
06_游戏设计/打印脱落球靶_v09/制造初样_v01/01_先打小样/小样_套筒_单边0.4mm.stl
26.0 x 28.0 x 8.00
