paomodabaibai/CyberBrick2-User-Research-UX/06_游戏设计/打印脱落球靶_v09/制造初样_v01/02_一套正式件_STL/04_磁铁托座_D4x2.stl

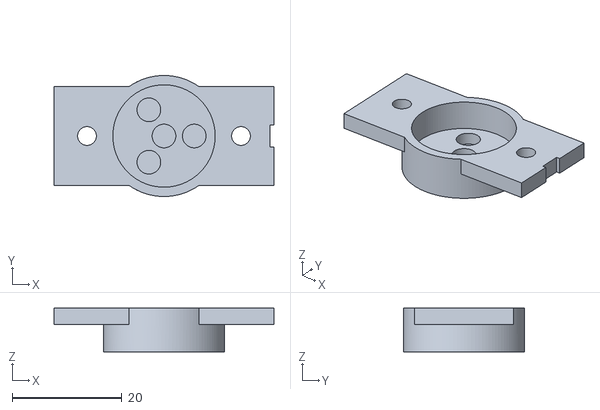
[picture p158: CAD file, 2026-10-22]
06_游戏设计/打印脱落球靶_v09/制造初样_v01/02_一套正式件_STL/04_磁铁托座_D4x2.stl
40.0 x 22.0 x 8.00
