paomodabaibai/CyberBrick2-User-Research-UX/06_游戏设计/打印脱落球靶_v09/制造初样_v01/03_可编辑STEP/小样_方柱与M3通孔.step

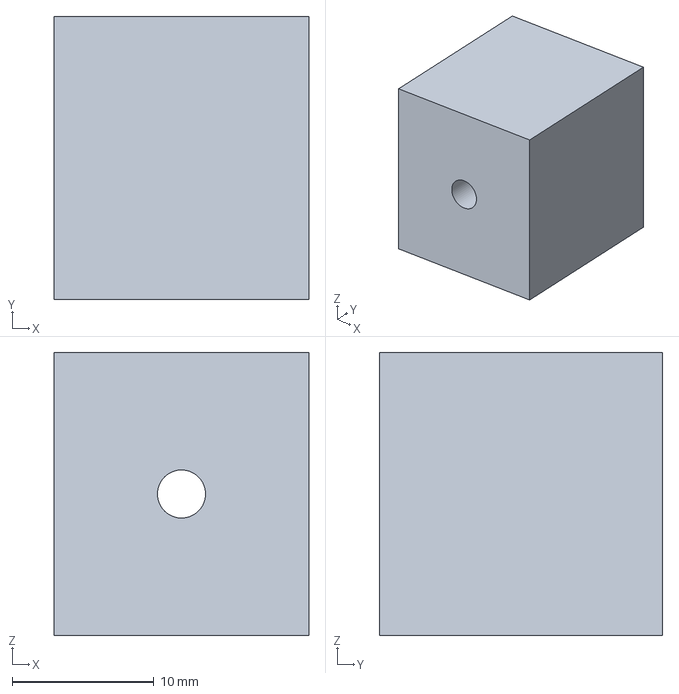
[picture p159: CAD file, 2026-10-22]
06_游戏设计/打印脱落球靶_v09/制造初样_v01/03_可编辑STEP/小样_方柱与M3通孔.step
18.0 x 20.0 x 20.0 mm
