paomodabaibai/CyberBrick2-User-Research-UX/06_游戏设计/打印脱落球靶_v09/制造初样_v01/04_总装与检查/总装135mm_仅预览.step

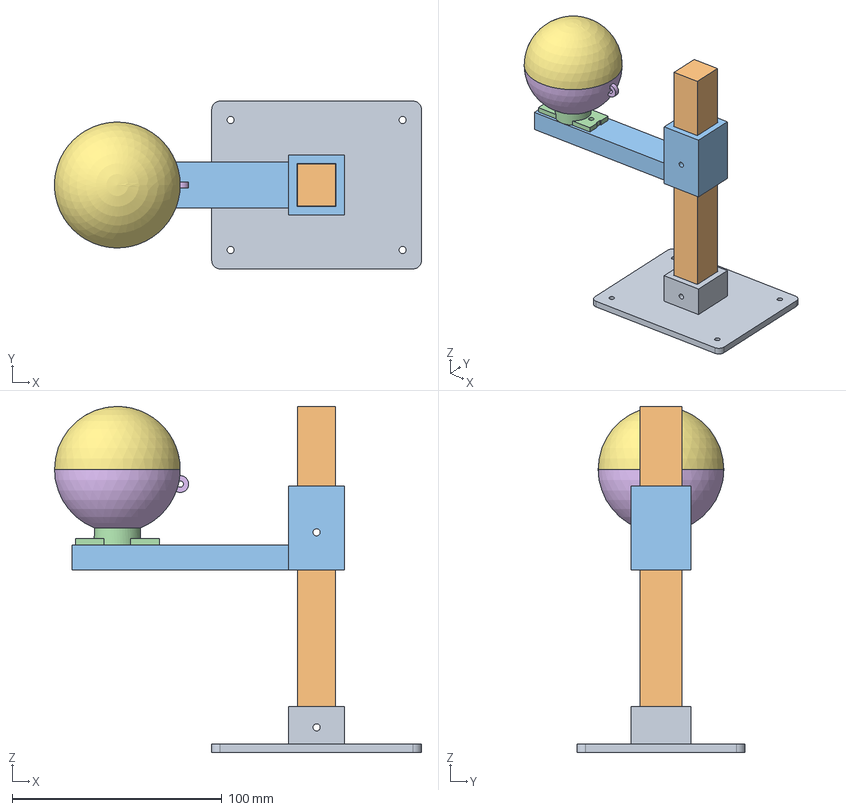
[picture p160: CAD file, 2026-10-22]
06_游戏设计/打印脱落球靶_v09/制造初样_v01/04_总装与检查/总装135mm_仅预览.step
174.9 x 80.0 x 165.0 mm
