paomodabaibai/CyberBrick2-User-Research-UX/06_游戏设计/打印脱落球靶_v09/发给组员_球靶打印简版/打印这9件_各1个/02_三档立柱.stl

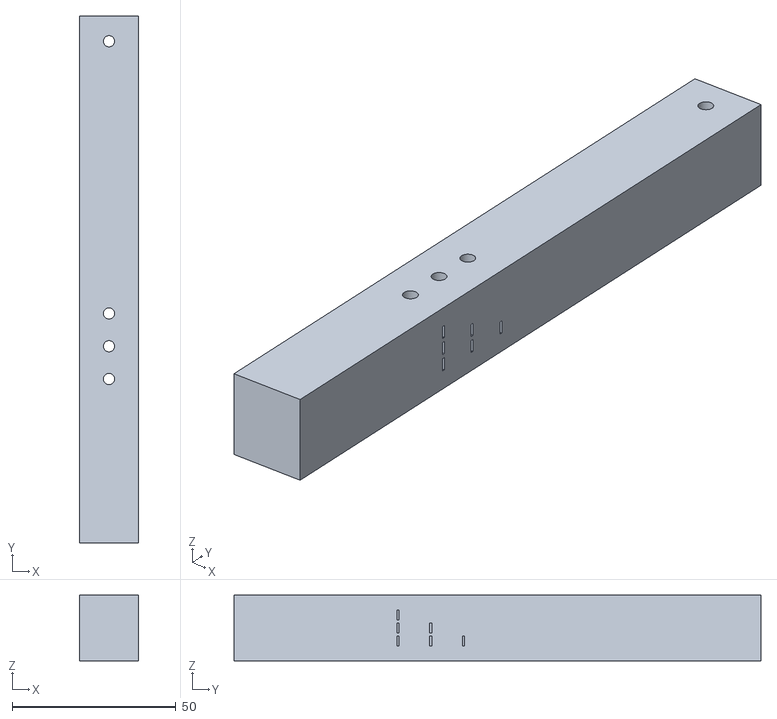
[picture p161: CAD file, 2026-10-22]
06_游戏设计/打印脱落球靶_v09/发给组员_球靶打印简版/打印这9件_各1个/02_三档立柱.stl
18.0 x 160.7 x 20.0
