paomodabaibai/CyberBrick2-User-Research-UX/06_游戏设计/打印脱落球靶_v09/球靶概念总装_不可直接打印.step

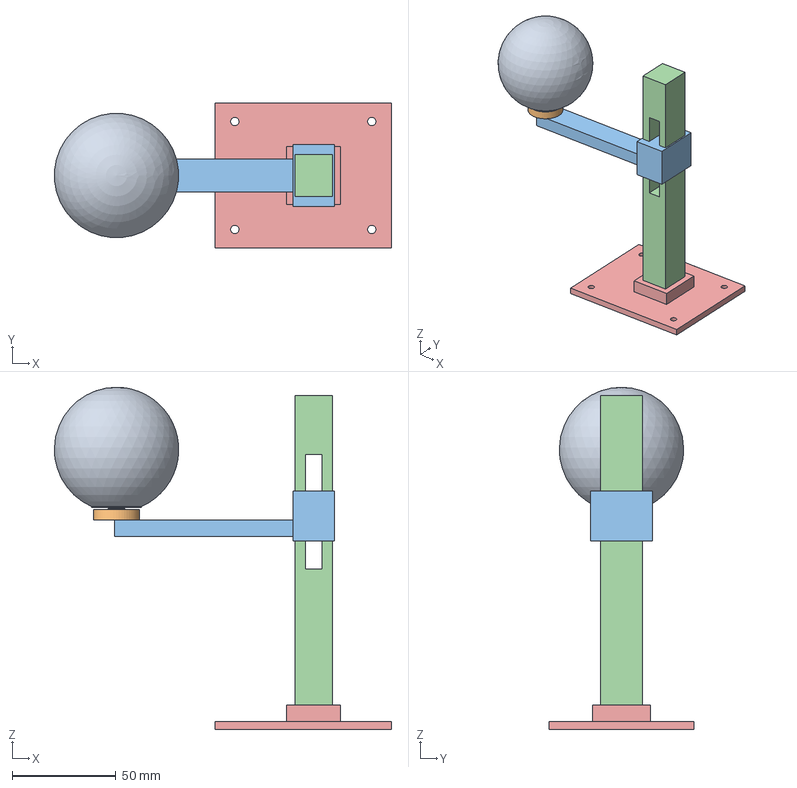
[picture p162: CAD file, 2026-10-22]
06_游戏设计/打印脱落球靶_v09/球靶概念总装_不可直接打印.step
162.4 x 70.0 x 165.0 mm
