paomodabaibai/CyberBrick2-User-Research-UX/01_研究参考/CyberBrick1迁移研究/9g Servo Motor with Clutch Protection-half arm1-PG002-PG001.stp

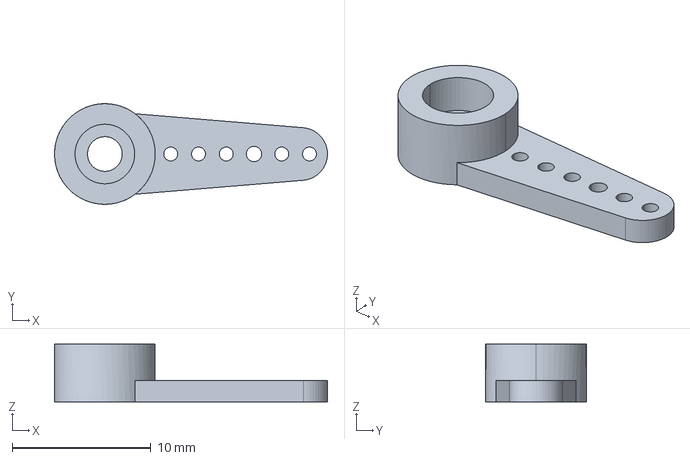
[picture p163: CAD file, 2026-09-28]
01_研究参考/CyberBrick1迁移研究/9g Servo Motor with Clutch Protection-half arm1-PG002-PG001.stp
19.7 x 7.26 x 4.15 mm
