paomodabaibai/CyberBrick2-User-Research-UX/01_研究参考/攻击模块/Punchy/Punchy.stp

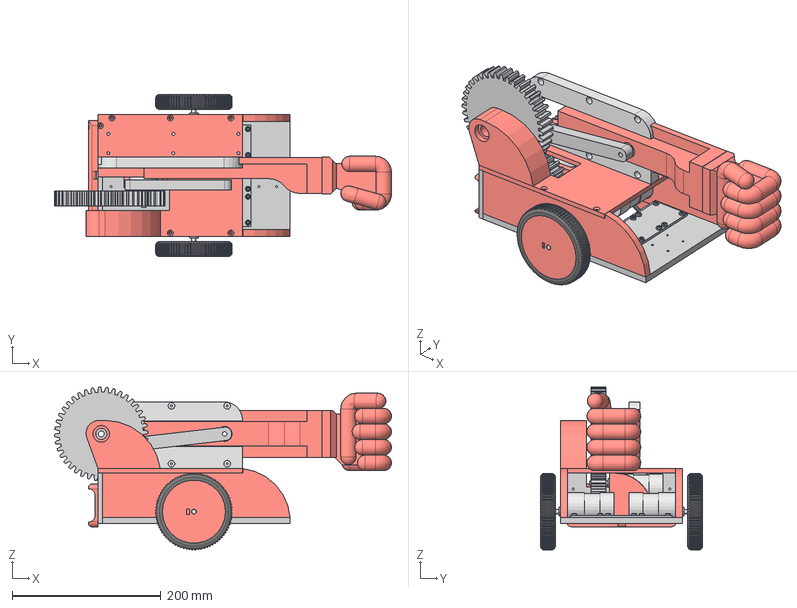
[picture p164: CAD file, 2026-09-28]
01_研究参考/攻击模块/Punchy/Punchy.stp
453.6 x 218.0 x 219.1 mm
bigGear
pushrod
slider
Battery v1
