paomodabaibai/CyberBrick2-User-Research-UX/04_结构与硬件/2026-09-21_整机首轮试打印包/05_完整巴掌75mm_打印1件.stl

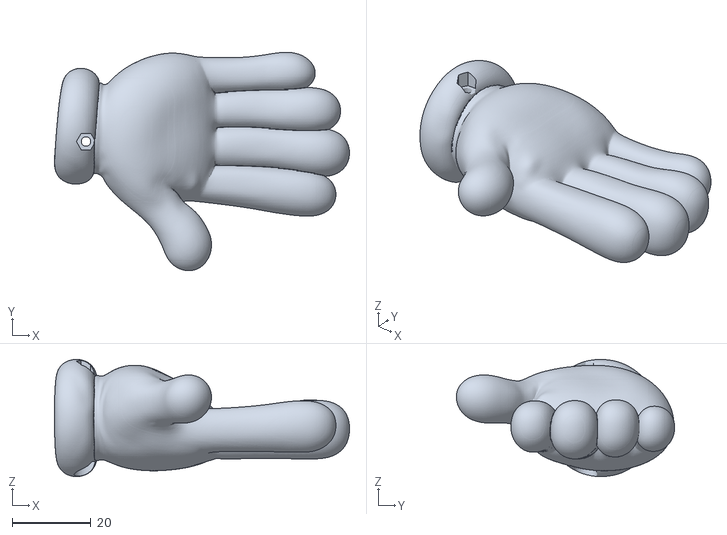
[picture p165: CAD file, 2026-09-28]
04_结构与硬件/2026-09-21_整机首轮试打印包/05_完整巴掌75mm_打印1件.stl
75.0 x 55.5 x 29.8
