paomodabaibai/CyberBrick2-User-Research-UX/04_结构与硬件/Otto_75mm巴掌腕部接口_v02/STEP_结构件/03_杆末端试装片.step

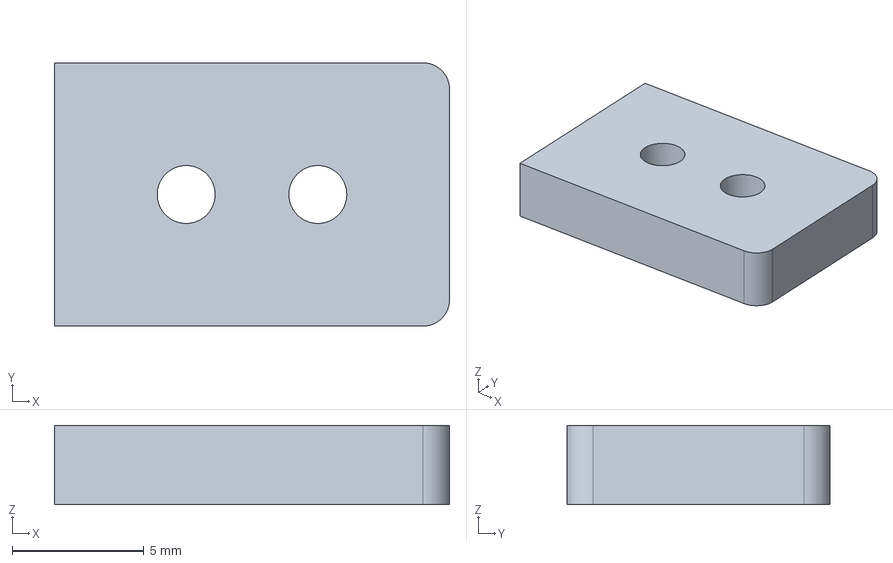
[picture p166: CAD file, 2026-09-28]
04_结构与硬件/Otto_75mm巴掌腕部接口_v02/STEP_结构件/03_杆末端试装片.step
15.0 x 10.0 x 3.00 mm
