paomodabaibai/CyberBrick2-User-Research-UX/04_结构与硬件/Otto_CB1出拳头部_v01/output/STL_打印件/04_carriage_and_wrist.stl

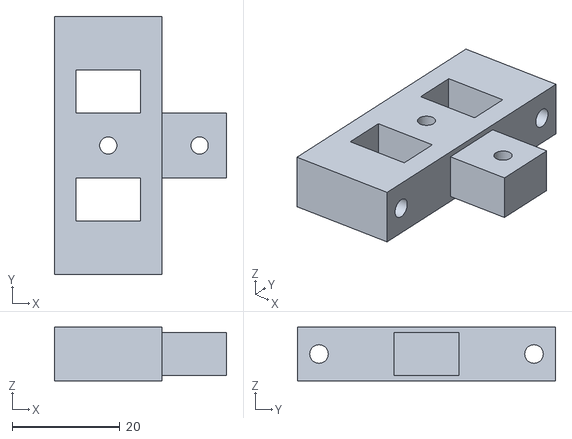
[picture p167: CAD file, 2026-09-28]
04_结构与硬件/Otto_CB1出拳头部_v01/output/STL_打印件/04_carriage_and_wrist.stl
32.0 x 48.0 x 10.0
