paomodabaibai/CyberBrick2-User-Research-UX/04_结构与硬件/Otto_CB1出拳头部_v01/output/官方壳体_如已有则不重复打印/reference_upper_case.step

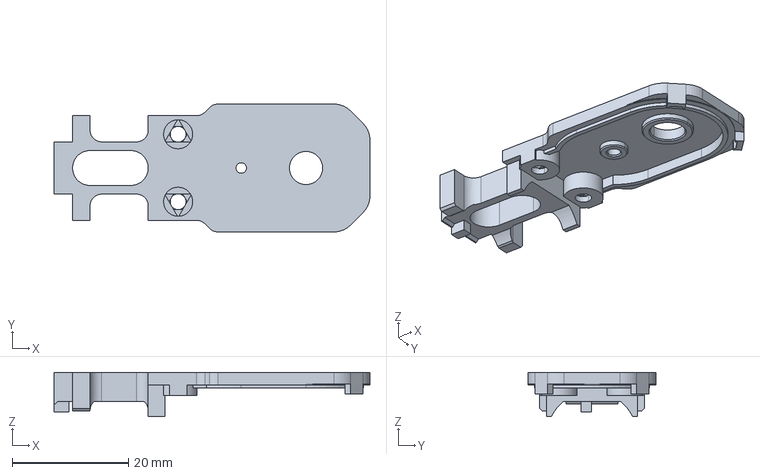
[picture p168: CAD file, 2026-09-28]
04_结构与硬件/Otto_CB1出拳头部_v01/output/官方壳体_如已有则不重复打印/reference_upper_case.step
54.4 x 22.0 x 7.65 mm
