paomodabaibai/CyberBrick2-User-Research-UX/04_结构与硬件/Otto_CB1出拳头部_v01/参考资料/030 Micro DC Motor with SH1.0-LA024 .stp

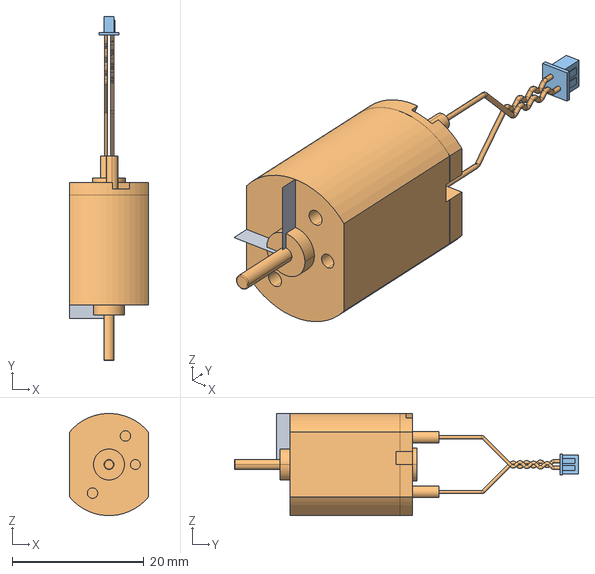
[picture p169: CAD file, 2026-09-28]
04_结构与硬件/Otto_CB1出拳头部_v01/参考资料/030 Micro DC Motor with SH1.0-LA024 .stp
12.0 x 52.2 x 15.5 mm
