paomodabaibai/CyberBrick2-User-Research-UX/04_结构与硬件/Otto_PG001顶部巴掌模块_v01/STEP_可编辑实体/01_body_fit_gauge.step

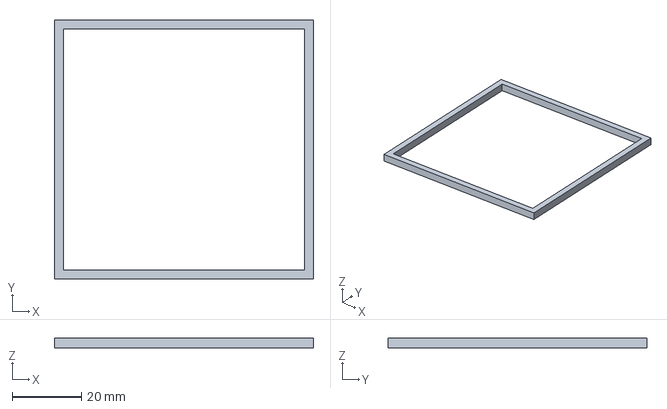
[picture p170: CAD file, 2026-09-28]
04_结构与硬件/Otto_PG001顶部巴掌模块_v01/STEP_可编辑实体/01_body_fit_gauge.step
75.0 x 75.0 x 3.00 mm
