paomodabaibai/CyberBrick2-User-Research-UX/04_结构与硬件/巴掌_Tripo网格与尺寸调整/输出_手掌50mm_杆距37.5mm/手掌_最长边50mm_尚无安装接口.stl

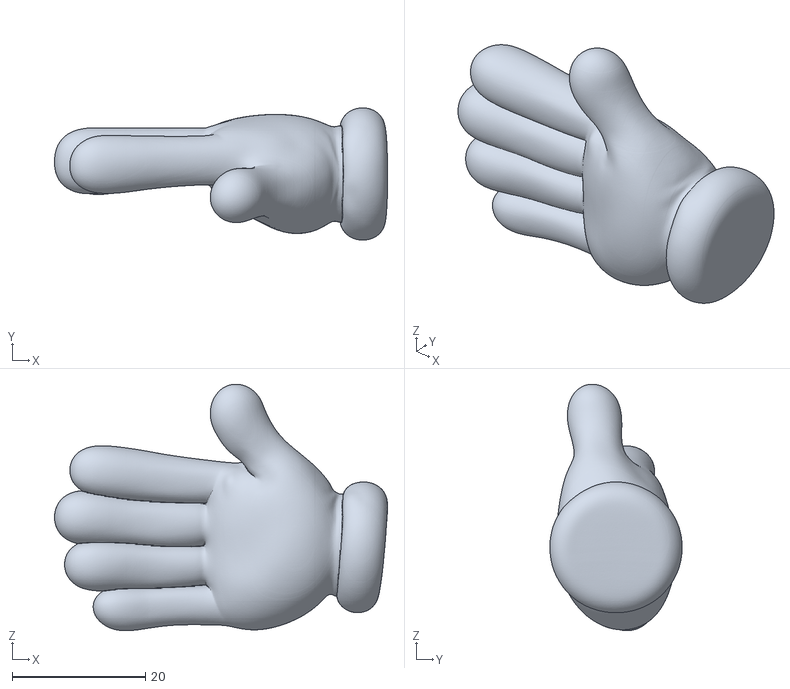
[picture p172: CAD file, 2026-09-28]
04_结构与硬件/巴掌_Tripo网格与尺寸调整/输出_手掌50mm_杆距37.5mm/手掌_最长边50mm_尚无安装接口.stl
50.0 x 19.9 x 37.0
