paomodabaibai/CyberBrick2-User-Research-UX/04_结构与硬件/拳头_全套打印包_2026-09-29/05_拳头与腕部连接_一体试打印.stl

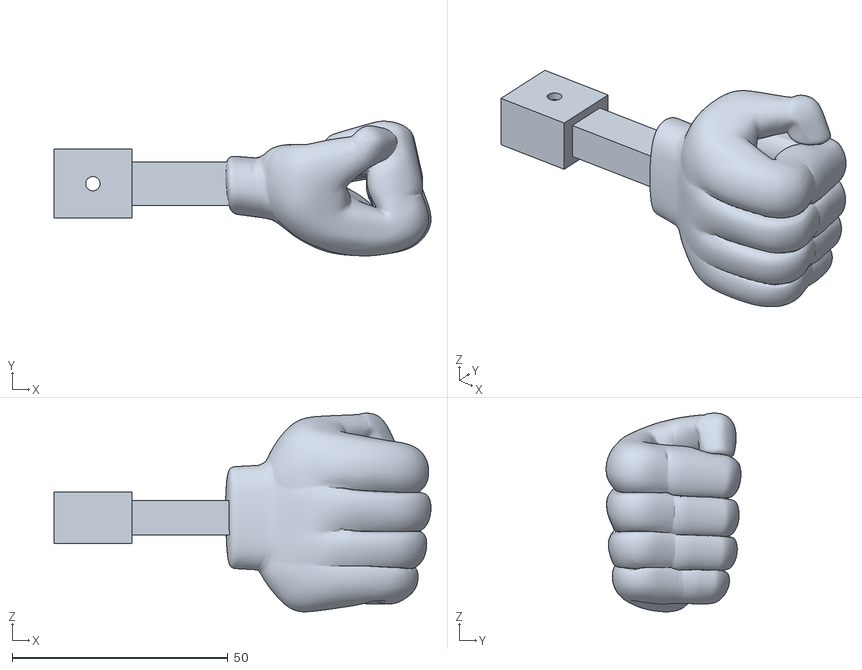
[picture p173: CAD file, 2026-10-07]
04_结构与硬件/拳头_全套打印包_2026-09-29/05_拳头与腕部连接_一体试打印.stl
87.3 x 31.2 x 46.0
