paomodabaibai/CyberBrick2-User-Research-UX/04_结构与硬件/落地墙体竞技场_v04/stl/03_floor_tile_179p6.stl

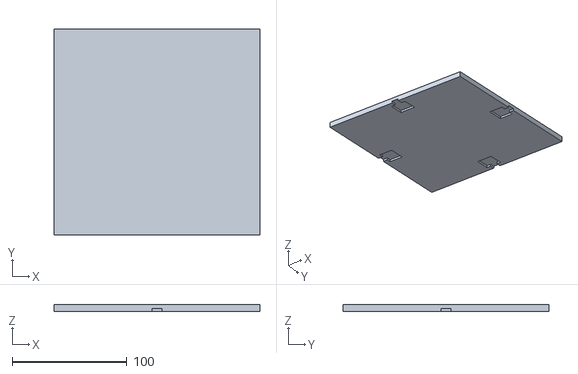
[picture p174: CAD file, 2026-10-17]
04_结构与硬件/落地墙体竞技场_v04/stl/03_floor_tile_179p6.stl
179.6 x 179.6 x 6.00
