paomodabaibai/CyberBrick2-User-Research-UX/04_结构与硬件/错位T墙竞技场_v05/step/W03_wall_180x40x100.step

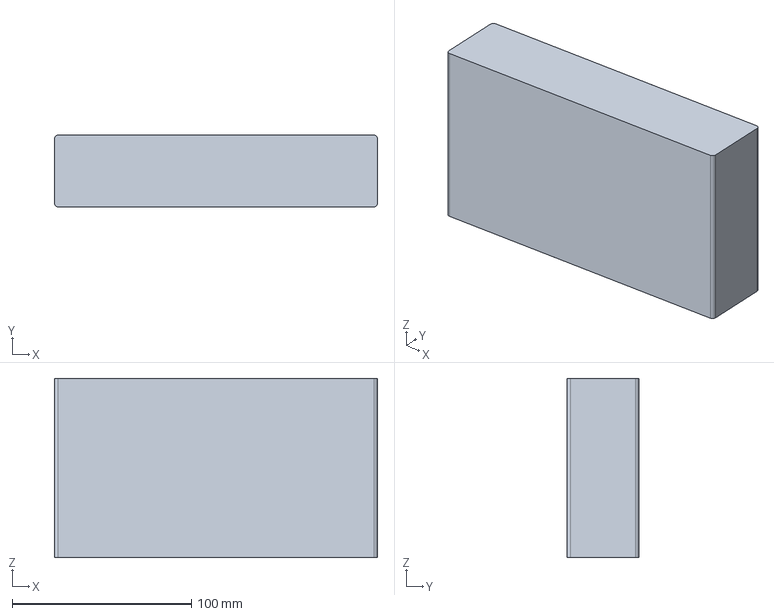
[picture p176: CAD file, 2026-10-17]
04_结构与硬件/错位T墙竞技场_v05/step/W03_wall_180x40x100.step
180.0 x 40.0 x 100.0 mm
