paomodabaibai/CyberBrick2-User-Research-UX/06_游戏设计/打印脱落球靶_v09/发给组员_球靶打印简版/打印这9件_各1个/03_套筒悬臂.stl

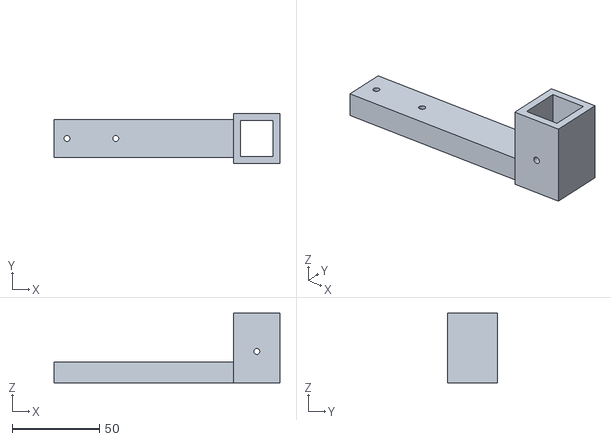
[picture p178: CAD file, 2026-10-22]
06_游戏设计/打印脱落球靶_v09/发给组员_球靶打印简版/打印这9件_各1个/03_套筒悬臂.stl
129.8 x 28.6 x 40.0
