paomodabaibai/CyberBrick2-User-Research-UX/01_研究参考/CyberBrick1迁移研究/9g Servo Motor with Clutch Protection-PG002-PG001.stp

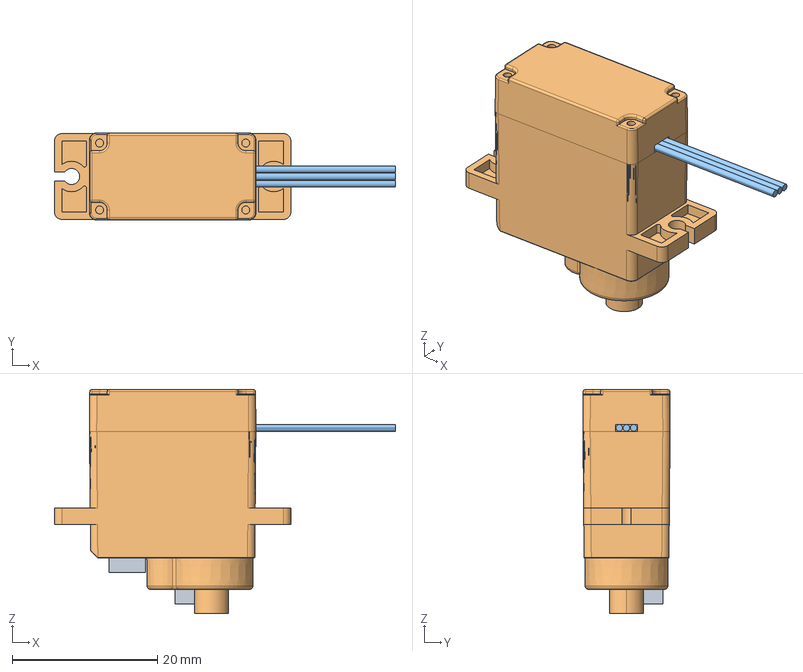
[picture p179: CAD file, 2026-09-28]
01_研究参考/CyberBrick1迁移研究/9g Servo Motor with Clutch Protection-PG002-PG001.stp
46.9 x 12.0 x 30.8 mm
