paomodabaibai/CyberBrick2-User-Research-UX/04_结构与硬件/Otto_75mm巴掌腕部接口_v02/STEP_结构件/02_插入连接块.step

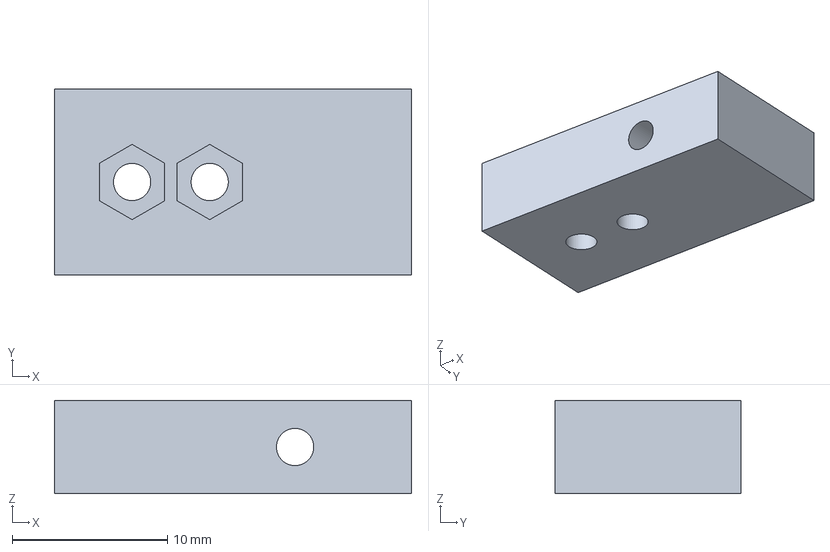
[picture p180: CAD file, 2026-09-28]
04_结构与硬件/Otto_75mm巴掌腕部接口_v02/STEP_结构件/02_插入连接块.step
23.0 x 12.0 x 6.00 mm
