paomodabaibai/CyberBrick2-User-Research-UX/04_结构与硬件/Otto_75mm巴掌腕部接口_v02/装配坐标_勿直接打印/01_腕部局部试装件.stl

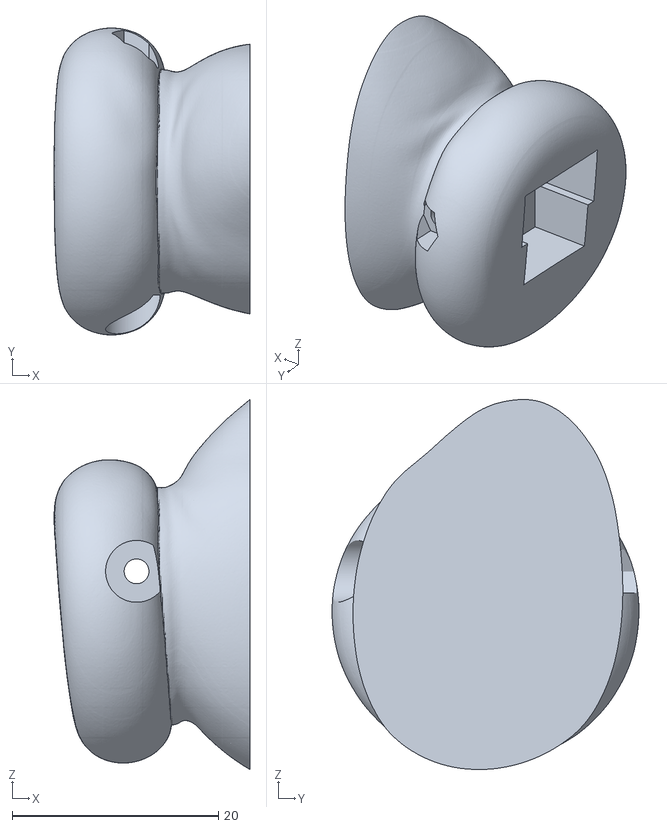
[picture p181: CAD file, 2026-09-28]
04_结构与硬件/Otto_75mm巴掌腕部接口_v02/装配坐标_勿直接打印/01_腕部局部试装件.stl
19.0 x 29.8 x 35.9
