paomodabaibai/CyberBrick2-User-Research-UX/04_结构与硬件/Otto_CB1出拳头部_v01/output/STL_打印件/05_hollow_boxing_glove_TPU.stl

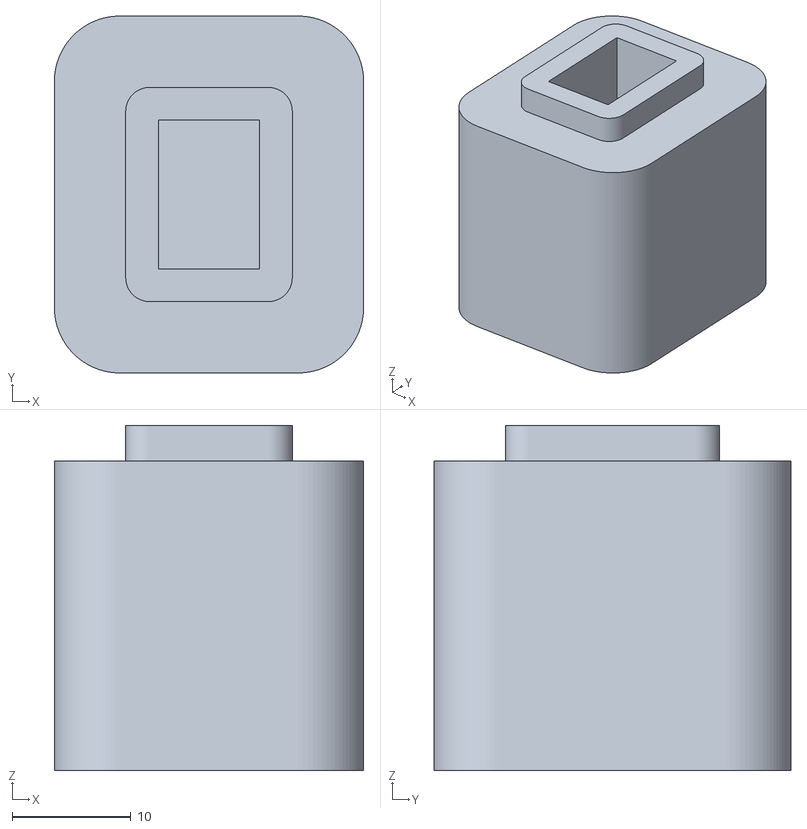
[picture p182: CAD file, 2026-09-28]
04_结构与硬件/Otto_CB1出拳头部_v01/output/STL_打印件/05_hollow_boxing_glove_TPU.stl
26.0 x 30.0 x 29.0
