paomodabaibai/CyberBrick2-User-Research-UX/04_结构与硬件/拳头_整体比例预览_v03/按用户参数导出_STL/攻击模块_打出_参数预览.stl

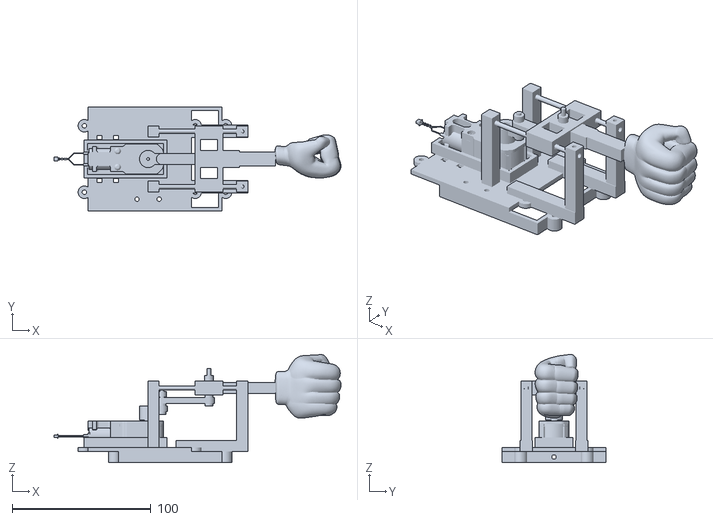
[picture p183: CAD file, 2026-10-07]
04_结构与硬件/拳头_整体比例预览_v03/按用户参数导出_STL/攻击模块_打出_参数预览.stl
207.2 x 75.0 x 78.0
