paomodabaibai/CyberBrick2-User-Research-UX/04_结构与硬件/落地墙体竞技场_v04/stl/01_wall_160x40x60.stl

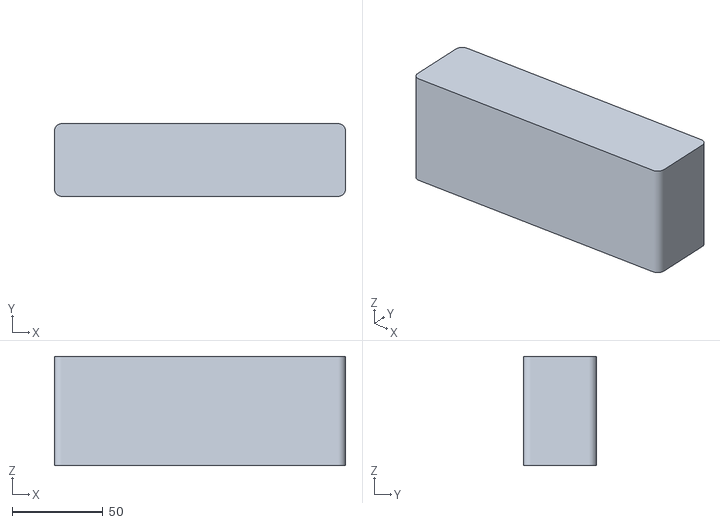
[picture p184: CAD file, 2026-10-17]
04_结构与硬件/落地墙体竞技场_v04/stl/01_wall_160x40x60.stl
160.0 x 40.0 x 60.0
