paomodabaibai/CyberBrick2-User-Research-UX/04_结构与硬件/错位T墙竞技场_v05/step/T01_target_open_cup_D90_H160.step

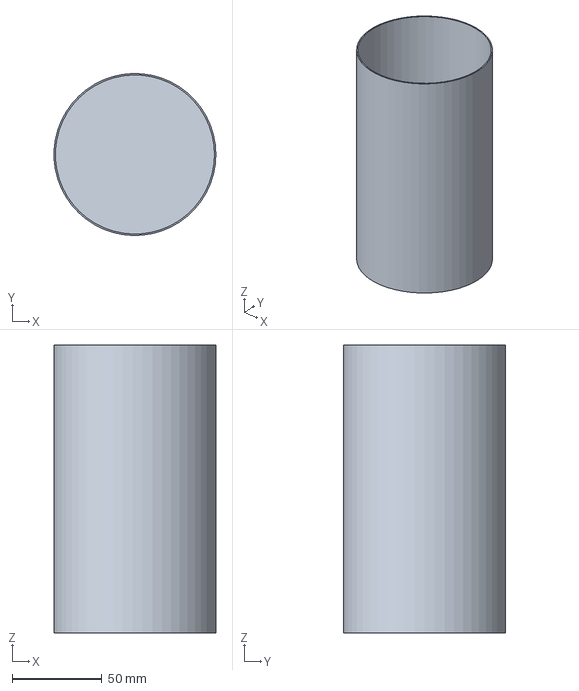
[picture p185: CAD file, 2026-10-17]
04_结构与硬件/错位T墙竞技场_v05/step/T01_target_open_cup_D90_H160.step
89.9 x 90.0 x 160.0 mm
