paomodabaibai/CyberBrick2-User-Research-UX/06_游戏设计/打印脱落球靶_v09/制造初样_v01/01_先打小样/可选_减磁垫片_0.4mm.stl

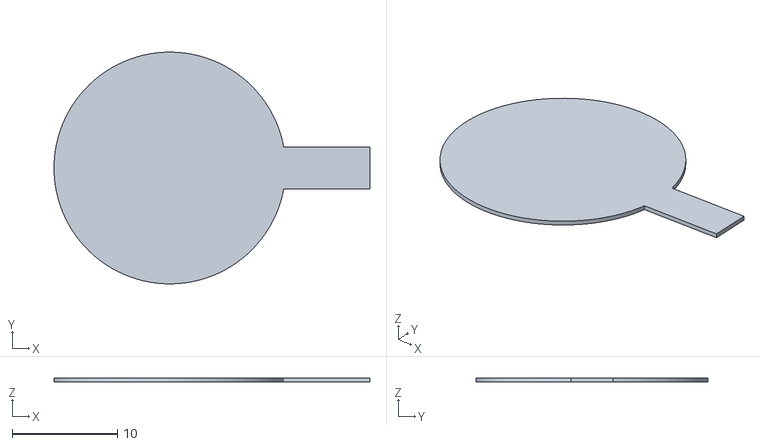
[picture p186: CAD file, 2026-10-22]
06_游戏设计/打印脱落球靶_v09/制造初样_v01/01_先打小样/可选_减磁垫片_0.4mm.stl
30.0 x 22.0 x 0.4
