paomodabaibai/CyberBrick2-User-Research-UX/06_游戏设计/打印脱落球靶_v09/制造初样_v01/02_一套正式件_STL/05_托座磁铁封盖.stl

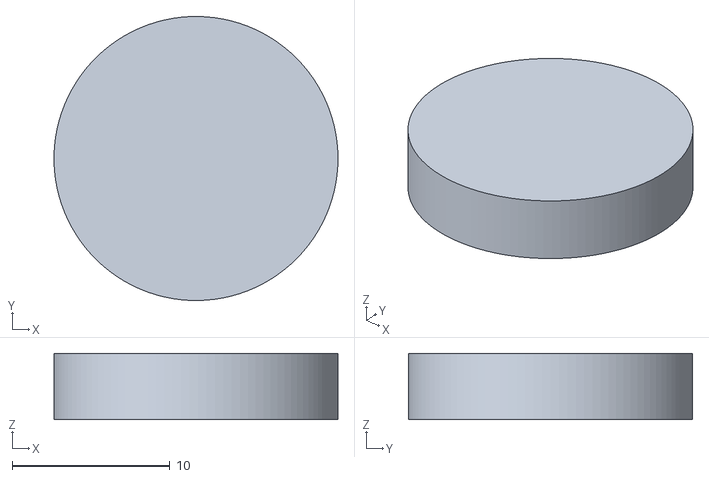
[picture p187: CAD file, 2026-10-22]
06_游戏设计/打印脱落球靶_v09/制造初样_v01/02_一套正式件_STL/05_托座磁铁封盖.stl
18.0 x 18.0 x 4.20
