paomodabaibai/CyberBrick2-User-Research-UX/06_游戏设计/打印脱落球靶_v09/发给组员_球靶打印简版/打印这9件_各1个/01_场地固定底座.stl

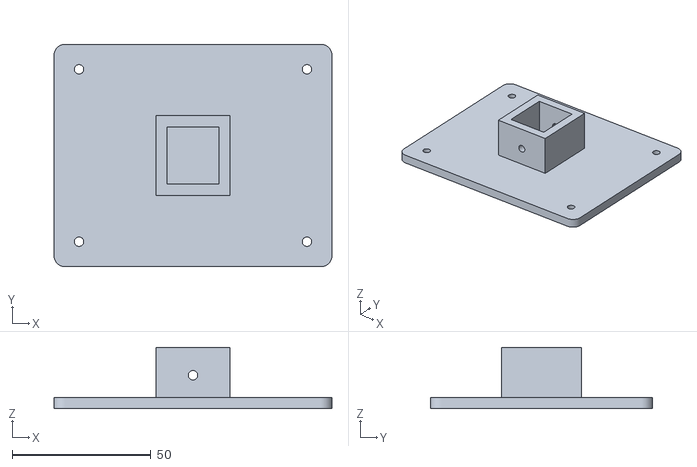
[picture p188: CAD file, 2026-10-22]
06_游戏设计/打印脱落球靶_v09/发给组员_球靶打印简版/打印这9件_各1个/01_场地固定底座.stl
100.0 x 80.0 x 22.0
