paomodabaibai/CyberBrick2-User-Research-UX/01_研究参考/CyberBrick1迁移研究/9g Servo Motor with Clutch Protection-cross arm-PG002-PG001.stp

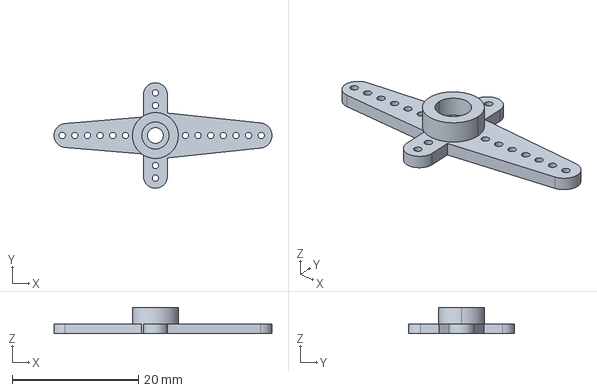
[picture p189: CAD file, 2026-09-28]
01_研究参考/CyberBrick1迁移研究/9g Servo Motor with Clutch Protection-cross arm-PG002-PG001.stp
34.5 x 16.7 x 4.15 mm
