paomodabaibai/CyberBrick2-User-Research-UX/04_结构与硬件/Otto_CB1出拳头部_v01/output/STEP_可编辑实体/01_mount_and_guides.step

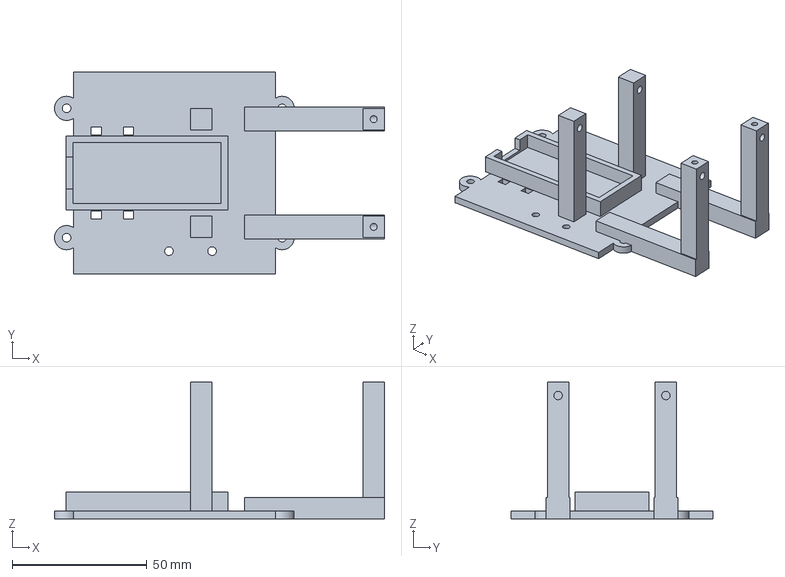
[picture p190: CAD file, 2026-09-28]
04_结构与硬件/Otto_CB1出拳头部_v01/output/STEP_可编辑实体/01_mount_and_guides.step
122.5 x 75.0 x 50.8 mm
