paomodabaibai/CyberBrick2-User-Research-UX/04_结构与硬件/Otto_CB1出拳头部_v01/output/STL_打印件/09_body_collar.stl

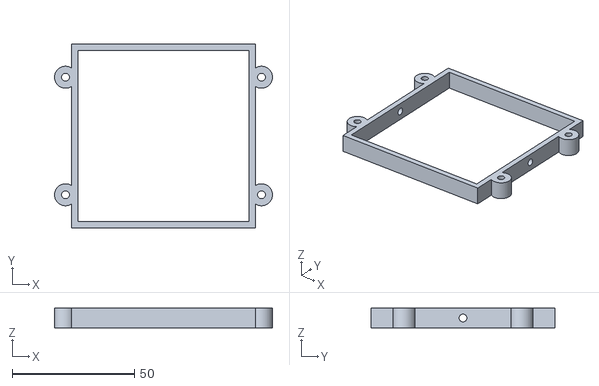
[picture p191: CAD file, 2026-09-28]
04_结构与硬件/Otto_CB1出拳头部_v01/output/STL_打印件/09_body_collar.stl
89.0 x 75.0 x 8.00
