paomodabaibai/CyberBrick2-User-Research-UX/04_结构与硬件/Otto_PG001顶部巴掌模块_v01/STEP_可编辑实体/02_servo_fit_gauge.step

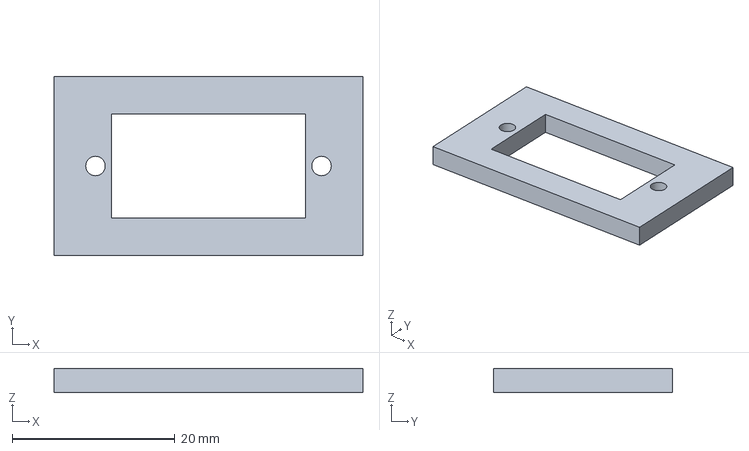
[picture p192: CAD file, 2026-09-28]
04_结构与硬件/Otto_PG001顶部巴掌模块_v01/STEP_可编辑实体/02_servo_fit_gauge.step
38.0 x 22.0 x 3.00 mm
