paomodabaibai/CyberBrick2-User-Research-UX/04_结构与硬件/Otto_PG001顶部巴掌模块_v01/STL_打印件/04_servo_bridge.stl

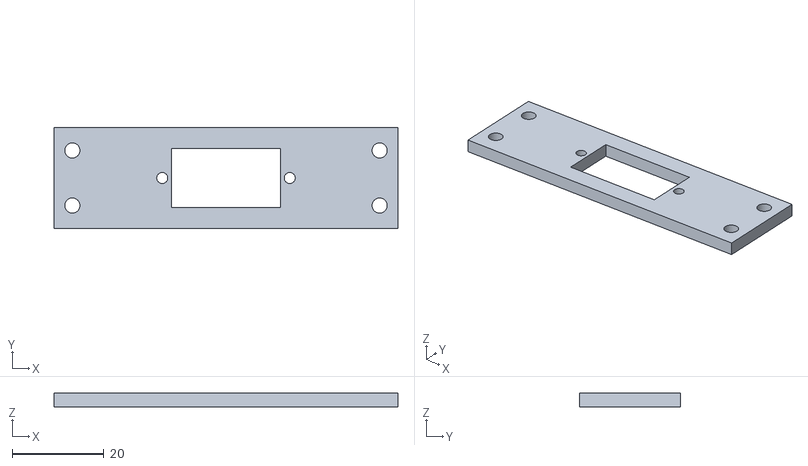
[picture p193: CAD file, 2026-09-28]
04_结构与硬件/Otto_PG001顶部巴掌模块_v01/STL_打印件/04_servo_bridge.stl
75.0 x 22.0 x 3.00
