paomodabaibai/CyberBrick2-User-Research-UX/04_结构与硬件/拳头_整体比例预览_v03/按用户参数导出_STL/腕部延长_尺寸示意_不可直接打印.stl

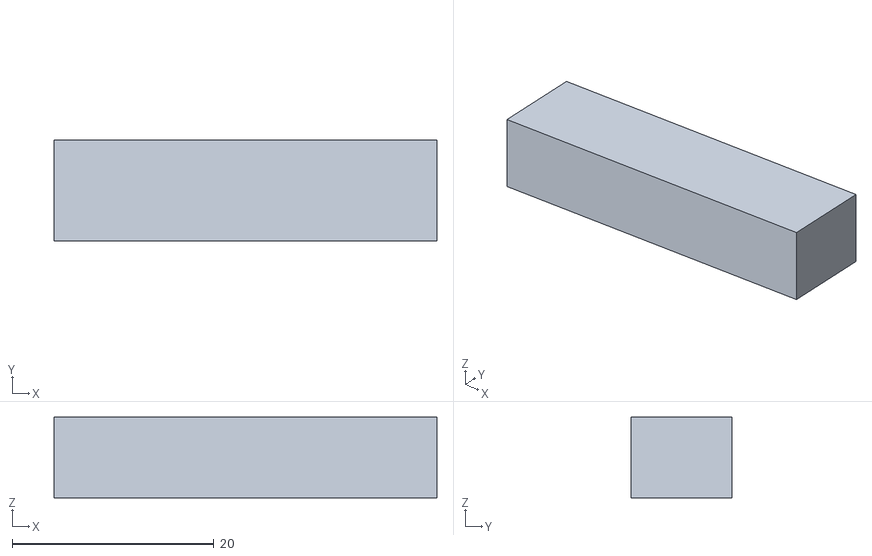
[picture p194: CAD file, 2026-10-07]
04_结构与硬件/拳头_整体比例预览_v03/按用户参数导出_STL/腕部延长_尺寸示意_不可直接打印.stl
38.0 x 10.0 x 8.00
