paomodabaibai/CyberBrick2-User-Research-UX/04_结构与硬件/错位T墙竞技场_v05/step/E02_edge_140x20x35.step

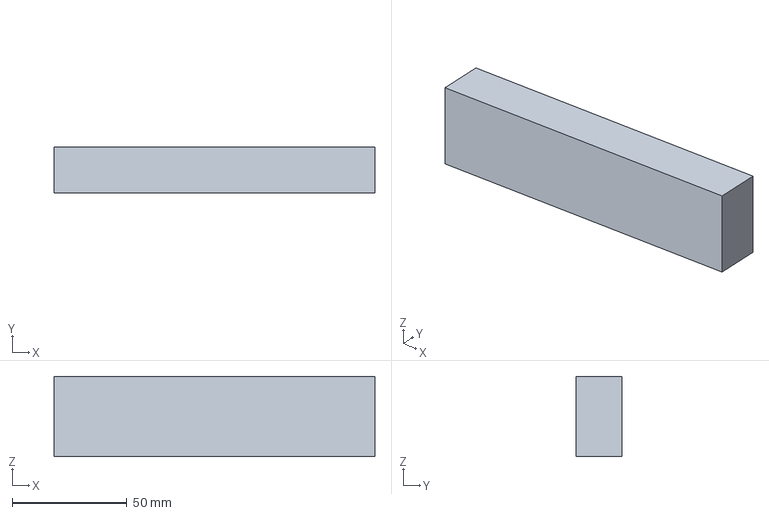
[picture p195: CAD file, 2026-10-17]
04_结构与硬件/错位T墙竞技场_v05/step/E02_edge_140x20x35.step
140.0 x 20.0 x 35.0 mm
