paomodabaibai/CyberBrick2-User-Research-UX/06_游戏设计/打印脱落球靶_v09/制造初样_v01/01_先打小样/小样_磁铁孔4p2_4p3_4p4_螺母孔5p7_5p8_5p9.stl

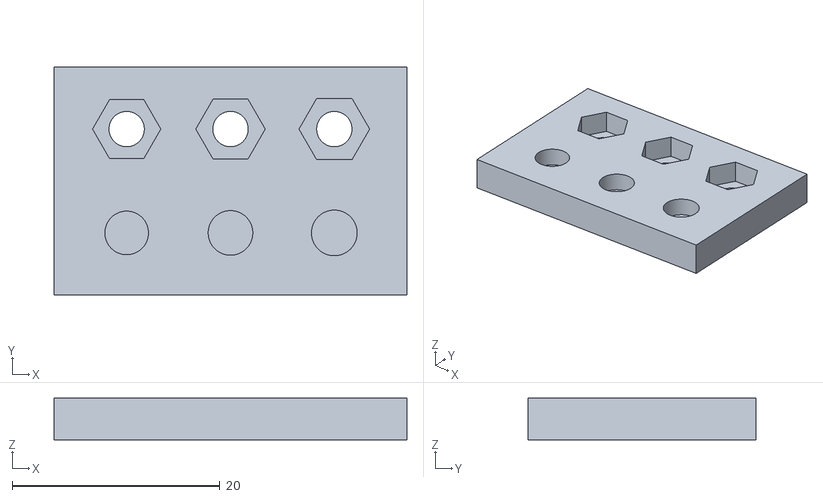
[picture p196: CAD file, 2026-10-22]
06_游戏设计/打印脱落球靶_v09/制造初样_v01/01_先打小样/小样_磁铁孔4p2_4p3_4p4_螺母孔5p7_5p8_5p9.stl
34.0 x 22.0 x 4.00
