paomodabaibai/CyberBrick2-User-Research-UX/06_游戏设计/打印脱落球靶_v09/制造初样_v01/02_一套正式件_STL/08_球壳定位环.stl

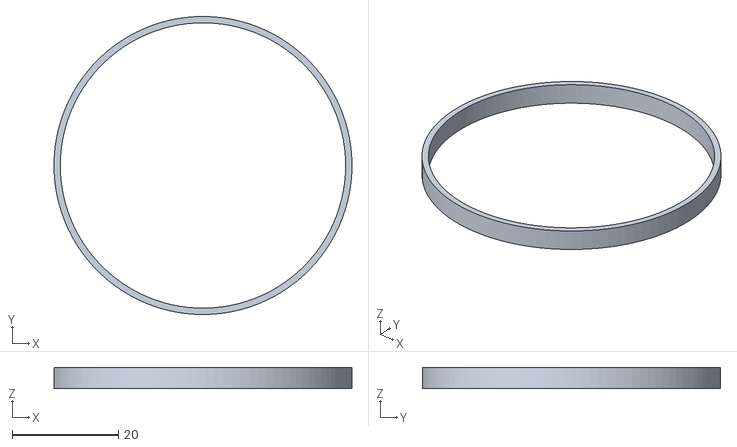
[picture p197: CAD file, 2026-10-22]
06_游戏设计/打印脱落球靶_v09/制造初样_v01/02_一套正式件_STL/08_球壳定位环.stl
56.1 x 56.1 x 4.00
