paomodabaibai/CyberBrick2-User-Research-UX/06_游戏设计/打印脱落球靶_v09/发给组员_球靶打印简版/打印这9件_各1个/07_球上半壳.stl

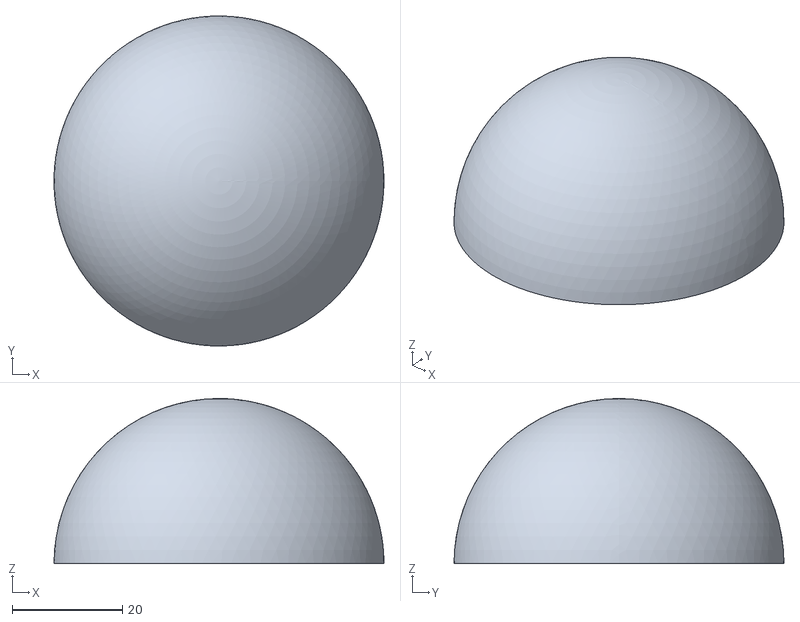
[picture p198: CAD file, 2026-10-22]
06_游戏设计/打印脱落球靶_v09/发给组员_球靶打印简版/打印这9件_各1个/07_球上半壳.stl
60.0 x 60.0 x 30.0
