paomodabaibai/CyberBrick2-User-Research-UX/01_研究参考/CyberBrick1迁移研究/Multi-Function Controller Core-XA003.stp

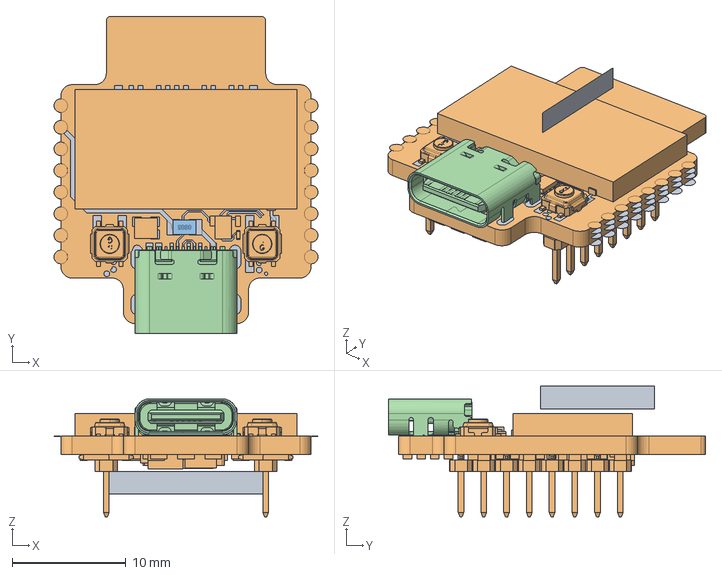
[picture p199: CAD file, 2026-09-28]
01_研究参考/CyberBrick1迁移研究/Multi-Function Controller Core-XA003.stp
23.2 x 27.9 x 11.5 mm
