paomodabaibai/CyberBrick2-User-Research-UX/04_结构与硬件/拳头_整体比例预览_v03/按用户参数导出_STL/新拳头_已缩放旋转定位.stl

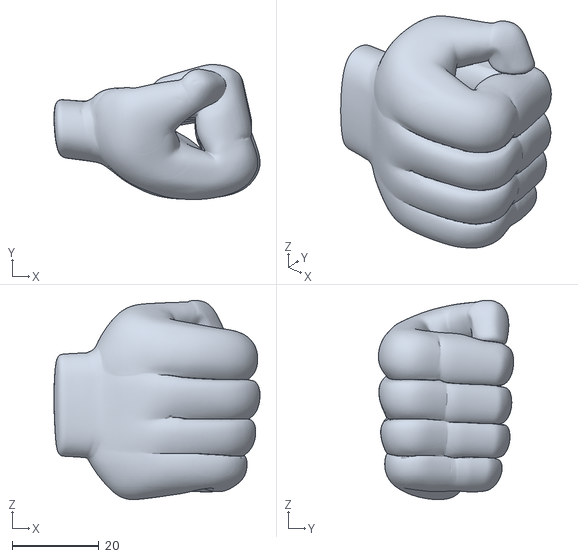
[picture p200: CAD file, 2026-10-07]
04_结构与硬件/拳头_整体比例预览_v03/按用户参数导出_STL/新拳头_已缩放旋转定位.stl
47.6 x 31.2 x 46.0
