paomodabaibai/CyberBrick2-User-Research-UX/04_结构与硬件/落地墙体竞技场_v04/stl/02_ground_target_80x160.stl

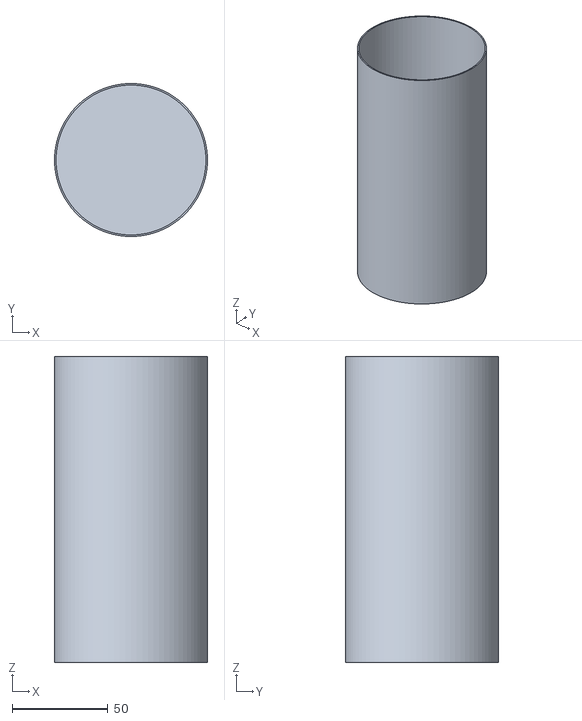
[picture p201: CAD file, 2026-10-17]
04_结构与硬件/落地墙体竞技场_v04/stl/02_ground_target_80x160.stl
80.0 x 80.0 x 160.0
