paomodabaibai/CyberBrick2-User-Research-UX/06_游戏设计/打印脱落球靶_v09/制造初样_v01/02_一套正式件_STL/06_球下半壳_带磁铁槽.stl

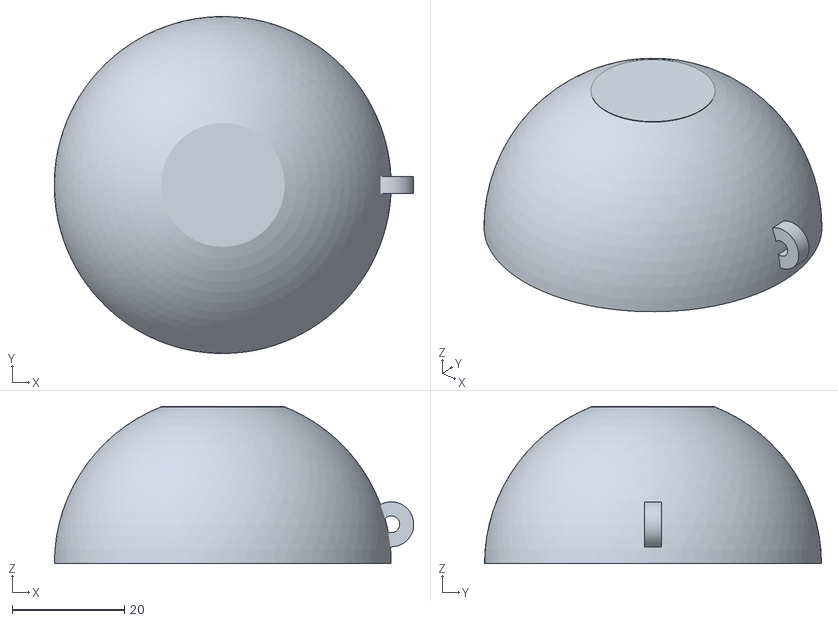
[picture p204: CAD file, 2026-10-22]
06_游戏设计/打印脱落球靶_v09/制造初样_v01/02_一套正式件_STL/06_球下半壳_带磁铁槽.stl
64.0 x 60.0 x 28.0
