paomodabaibai/CyberBrick2-User-Research-UX/01_研究参考/CyberBrick1迁移研究/Remote Control Receiver-XA003-XA004.stp

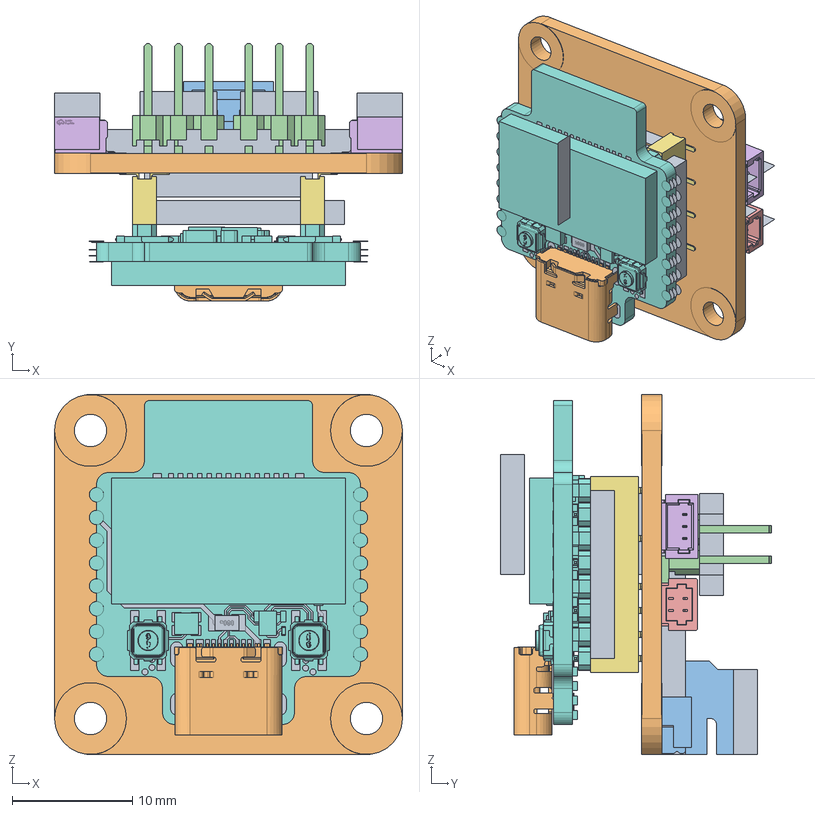
[picture p205: CAD file, 2026-09-28]
01_研究参考/CyberBrick1迁移研究/Remote Control Receiver-XA003-XA004.stp
29.0 x 22.6 x 30.0 mm
PCB-V2000
DIANYUAN-B
1_0-2PIN x 2
1_0-3PIN x 2
2_0-8PIN x 2
CORE-V3-3
