paomodabaibai/CyberBrick2-User-Research-UX/04_结构与硬件/错位T墙竞技场_v05/step/J01_bridge_44x18x2.step

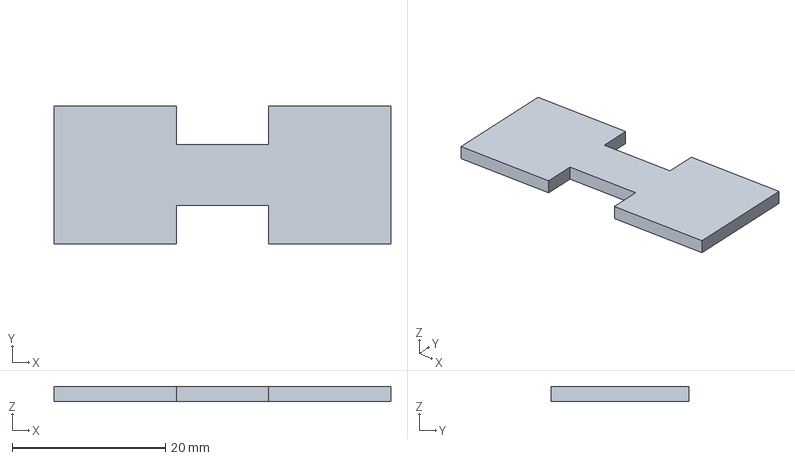
[picture p207: CAD file, 2026-10-17]
04_结构与硬件/错位T墙竞技场_v05/step/J01_bridge_44x18x2.step
44.0 x 18.0 x 2.00 mm
