paomodabaibai/CyberBrick2-User-Research-UX/01_研究参考/CyberBrick1迁移研究/9g Servo Motor with Clutch Protection-line arm-PG002-PG001.stp

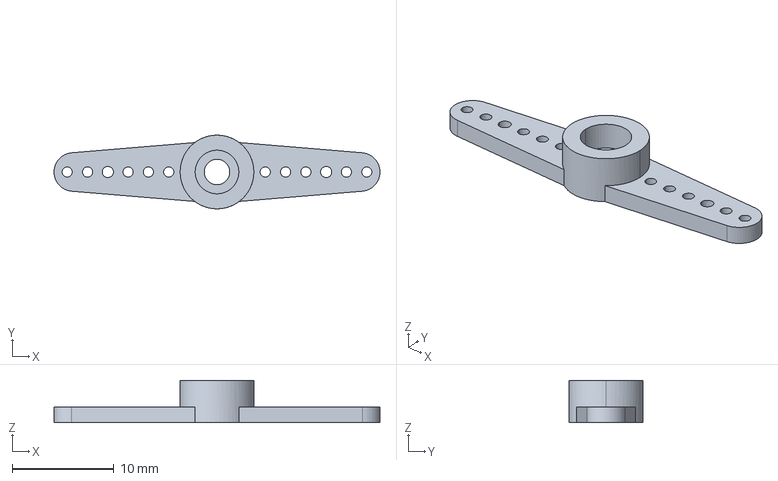
[picture p208: CAD file, 2026-09-28]
01_研究参考/CyberBrick1迁移研究/9g Servo Motor with Clutch Protection-line arm-PG002-PG001.stp
32.1 x 7.26 x 4.15 mm
