paomodabaibai/CyberBrick2-User-Research-UX/04_结构与硬件/错位T墙竞技场_v05/step/W04_wall_120x40x80.step

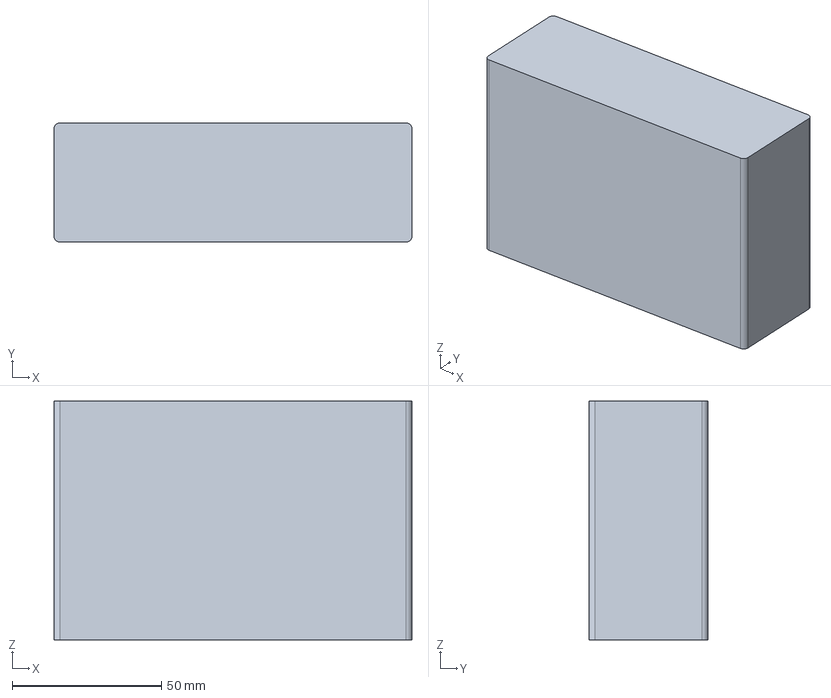
[picture p209: CAD file, 2026-10-17]
04_结构与硬件/错位T墙竞技场_v05/step/W04_wall_120x40x80.step
120.0 x 40.0 x 80.0 mm
