paomodabaibai/CyberBrick2-User-Research-UX/04_结构与硬件/错位T墙竞技场_v05/step/T02_target_test_D90_H80.step

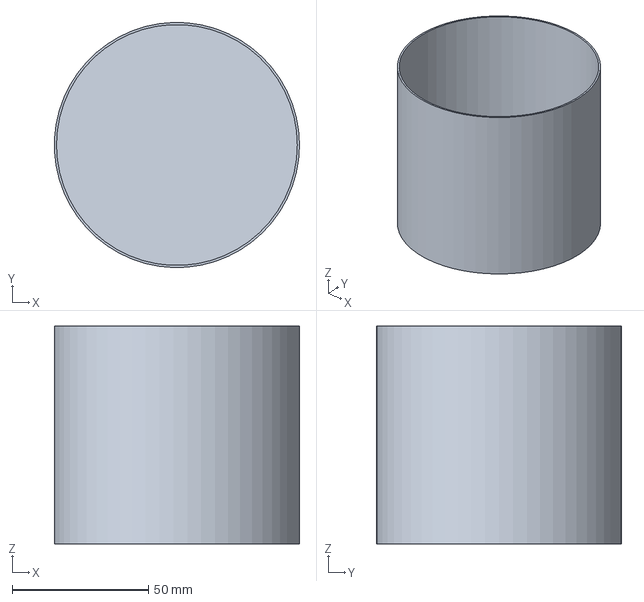
[picture p211: CAD file, 2026-10-17]
04_结构与硬件/错位T墙竞技场_v05/step/T02_target_test_D90_H80.step
89.9 x 90.0 x 80.0 mm
