paomodabaibai/CyberBrick2-User-Research-UX/(list of files, cad)

Other CAD files:
04_结构与硬件/Otto_75mm巴掌腕部接口_v02/STL_打印件/05_完整连接杆_杆距51mm.stl
04_结构与硬件/Otto_75mm巴掌腕部接口_v02/装配坐标_勿直接打印/05_完整连接杆_杆距51mm.stl
04_结构与硬件/Otto_PG001顶部巴掌模块_v01/STEP_可编辑实体/03_body_mount_frame.step
04_结构与硬件/拳头_全套打印包_2026-09-29/可选_仅缺减速箱壳体时打印/减速箱下壳_打印1件.stl
04_结构与硬件/Otto_75mm巴掌腕部接口_v02/STL_打印件/03_杆末端试装片.stl
04_结构与硬件/Otto_75mm巴掌腕部接口_v02/装配坐标_勿直接打印/03_杆末端试装片.stl
04_结构与硬件/Otto_CB1出拳头部_v01/output/STEP_可编辑实体/08_output_shaft_fit_gauge.step
04_结构与硬件/Otto_PG001顶部巴掌模块_v01/STL_打印件/01_body_fit_gauge.stl
04_结构与硬件/巴掌_Tripo网格与尺寸调整/输出_手掌75mm_杆距51mm/连接杆_孔组中心距51mm.step
04_结构与硬件/拳头_全套打印包_2026-09-29/可选_仅缺减速箱壳体时打印/减速箱上壳_打印1件.stl
04_结构与硬件/拳头_全套打印包_2026-09-29/可选_试配量规/身体套合量规.stl
04_结构与硬件/拳头_整体比例预览_v03/按用户参数导出_STL/整机_收回_参数预览.stl
06_游戏设计/打印脱落球靶_v09/制造初样_v01/01_先打小样/小样_方柱与M3通孔.stl
06_游戏设计/打印脱落球靶_v09/制造初样_v01/03_可编辑STEP/小样_套筒_单边0.2mm.step
04_结构与硬件/Otto_75mm巴掌腕部接口_v02/STL_打印件/02_插入连接块.stl
04_结构与硬件/Otto_CB1出拳头部_v01/output/STEP_可编辑实体/02_crank_keyed_hub.step
04_结构与硬件/Otto_PG001顶部巴掌模块_v01/STEP_可编辑实体/05_horn_arm_trial.step
04_结构与硬件/Otto_PG001顶部巴掌模块_v01/STL_打印件/05_horn_arm_trial.stl
04_结构与硬件/拳头_全套打印包_2026-09-29/03_连杆_打印1件.stl
06_游戏设计/打印脱落球靶_v09/制造初样_v01/03_可编辑STEP/小样_套筒_单边0.4mm.step
04_结构与硬件/Otto_75mm巴掌腕部接口_v02/STL_打印件/01_腕部局部试装件.stl
04_结构与硬件/Otto_75mm巴掌腕部接口_v02/装配坐标_勿直接打印/02_插入连接块.stl
04_结构与硬件/落地墙体竞技场_v04/stl/06_seam_coupon_right.stl
06_游戏设计/打印脱落球靶_v09/制造初样_v01/03_可编辑STEP/08_球壳定位环.step
04_结构与硬件/Otto_75mm巴掌腕部接口_v02/装配坐标_勿直接打印/04_完整手掌75mm_带接口.stl
04_结构与硬件/Otto_CB1出拳头部_v01/output/STEP_可编辑实体/09_body_collar.step
04_结构与硬件/Otto_CB1出拳头部_v01/output/STL_打印件/01_mount_and_guides.stl
04_结构与硬件/Otto_PG001顶部巴掌模块_v01/STEP_可编辑实体/06_palm_trial.step
04_结构与硬件/Otto_PG001顶部巴掌模块_v01/STL_打印件/02_servo_fit_gauge.stl
06_游戏设计/打印脱落球靶_v09/制造初样_v01/03_可编辑STEP/可选_减磁垫片_0.8mm.step
04_结构与硬件/Otto_CB1出拳头部_v01/output/STEP_可编辑实体/07_body_fit_gauge.step
04_结构与硬件/Otto_PG001顶部巴掌模块_v01/STEP_可编辑实体/04_servo_bridge.step
06_游戏设计/打印脱落球靶_v09/制造初样_v01/01_先打小样/小样_套筒_单边0.3mm.stl
06_游戏设计/打印脱落球靶_v09/制造初样_v01/03_可编辑STEP/04_磁铁托座_D4x2.step
04_结构与硬件/Otto_CB1出拳头部_v01/output/STEP_可编辑实体/06_optional_sensor_bracket.step
04_结构与硬件/错位T墙竞技场_v05/step/C01_seam_coupon_left.step
06_游戏设计/打印脱落球靶_v09/制造初样_v01/01_先打小样/小样_套筒_单边0.2mm.stl
06_游戏设计/打印脱落球靶_v09/制造初样_v01/03_可编辑STEP/03_套筒悬臂.step
04_结构与硬件/Otto_CB1出拳头部_v01/output/STEP_可编辑实体/05_hollow_boxing_glove_TPU.step
04_结构与硬件/错位T墙竞技场_v05/step/C02_seam_coupon_right.step
06_游戏设计/打印脱落球靶_v09/制造初样_v01/03_可编辑STEP/09_球内磁铁封盖.step
04_结构与硬件/Otto_CB1出拳头部_v01/output/STEP_可编辑实体/04_carriage_and_wrist.step
06_游戏设计/打印脱落球靶_v09/制造初样_v01/03_可编辑STEP/07_球上半壳.step
04_结构与硬件/错位T墙竞技场_v05/step/F01_floor_179p6.step
06_游戏设计/打印脱落球靶_v09/制造初样_v01/03_可编辑STEP/01_场地固定底座.step
06_游戏设计/打印脱落球靶_v09/制造初样_v01/03_可编辑STEP/05_托座磁铁封盖.step
06_游戏设计/打印脱落球靶_v09/制造初样_v01/03_可编辑STEP/小样_磁铁孔4p2_4p3_4p4_螺母孔5p7_5p8_5p9.step
06_游戏设计/打印脱落球靶_v09/制造初样_v01/03_可编辑STEP/小样_套筒_单边0.3mm.step
06_游戏设计/打印脱落球靶_v09/制造初样_v01/03_可编辑STEP/06_球下半壳_带磁铁槽.step
06_游戏设计/打印脱落球靶_v09/制造初样_v01/03_可编辑STEP/02_三档立柱.step
06_游戏设计/打印脱落球靶_v09/制造初样_v01/03_可编辑STEP/可选_减磁垫片_0.4mm.step
01_研究参考/CyberBrick1迁移研究/Multi-Function Controller Core-XA003.stl
01_研究参考/CyberBrick1迁移研究/Remote Control Receiver-XA003-XA004.stl
01_研究参考/CyberBrick1迁移研究/Remote Control Transmitter-XA003-XA005.stl
04_结构与硬件/Otto_CB1出拳头部_v01/参考资料/030 Micro DC Motor with SH1.0 - Reducer-LA024.stl
04_结构与硬件/巴掌_Tripo网格与尺寸调整/输出_手掌45mm_杆距42.5mm/连接杆_孔组中心距42.5mm.stl
04_结构与硬件/巴掌_Tripo网格与尺寸调整/输出_手掌50mm_杆距37.5mm/连接杆_孔组中心距37.5mm.stl
04_结构与硬件/巴掌_Tripo网格与尺寸调整/输出_手掌75mm_杆距51mm/连接杆_孔组中心距51mm.stl
04_结构与硬件/拳头_整体比例预览_v01/fist_preview_mesh.ply
04_结构与硬件/拳头_整体比例预览_v03/开放式底座_v01_试装/开放一体底座_后移22mm_试装.stl
04_结构与硬件/错位T墙竞技场_v05/stl/C01_seam_coupon_left.stl
04_结构与硬件/错位T墙竞技场_v05/stl/C02_seam_coupon_right.stl
04_结构与硬件/错位T墙竞技场_v05/stl/E01_edge_180x20x35.stl
04_结构与硬件/错位T墙竞技场_v05/stl/E02_edge_140x20x35.stl
04_结构与硬件/错位T墙竞技场_v05/stl/F01_floor_179p6.stl
04_结构与硬件/错位T墙竞技场_v05/stl/J01_bridge_44x18x2.stl
04_结构与硬件/错位T墙竞技场_v05/stl/T01_target_open_cup_D90_H160.stl
04_结构与硬件/错位T墙竞技场_v05/stl/T02_target_test_D90_H80.stl
04_结构与硬件/错位T墙竞技场_v05/stl/W01_wall_180x40x60.stl
04_结构与硬件/错位T墙竞技场_v05/stl/W02_wall_180x40x80.stl
04_结构与硬件/错位T墙竞技场_v05/stl/W03_wall_180x40x100.stl
04_结构与硬件/错位T墙竞技场_v05/stl/W04_wall_120x40x80.stl
06_游戏设计/打印脱落球靶_v09/球靶概念总装_不可直接打印.stl
