paomodabaibai/CyberBrick2-User-Research-UX/04_结构与硬件/拳头_全套打印包_2026-09-29/先看这里_打印与装配.md

# 拳头机器人顶部攻击模块：本次打印包

本文件夹根目录的 **5 个 STL 各打印 1 件**，就是本次顶部攻击模块的完整打印清单。使用用户微调后的拳头位置，攻击机构相对 Otto 身体后移 22 mm。底下已经打印好的 Otto V9 身体、腿、脚继续使用，**暂不重打身体**。

| 文件 | 作用 | 建议 |
|---|---|---|
| `01_开放一体底座_含Otto连接圈_打印1件.stl` | 套在现有身体上，承载后移的电机、导杆和机构；已包含身体连接圈 | PLA/PETG；先切片查看电机托架、横向孔和连接梁的支撑 |
| `02_曲柄_打印1件.stl` | 减速输出轴转动件 | 硬质材料；先用量规确认双扁轴孔 |
| `03_连杆_打印1件.stl` | 曲柄到滑架的传动杆 | 平放打印，转动孔去毛刺 |
| `04_滑架_打印1件.stl` | 沿两根导杆直线滑动，前端有 12×12×8 mm 舌头 | 导孔去支撑；在导杆上试滑 |
| `05_拳头与腕部连接_一体试打印.stl` | 从用户微调后的整机模型提取拳头，并融合真实腕部延长杆和滑架插槽 | 首轮用 PLA/PETG 试配；有悬空段，切片时检查支撑与手背表面 |

**不要同时打印旧版 `01_mount_and_guides.stl`、`09_body_collar.stl`、`05_hollow_boxing_glove_TPU.stl` 或 `拳头微调导出.stl`。** 前两件已由本包的新底座取代；旧拳套不是用户最终拳头；整机导出 STL 含身体及多个彼此分离的预览零件。

## 身体是否要重打

新底座的套环内开口按 **69.8×69.8 mm** 制作，对应原 Otto V9 身体约 69×69 mm 的外包络。套环与底座已经做成一件，理论上直接套在已打印身体上。先试套：能平稳落到身体顶部、不挤压主控板、USB/开关/线束仍可操作，就不需要重打身体。若你的打印件尺寸偏差、已有螺孔位置不同或接口被挡住，优先局部修整新底座；是否重打身体以实物试套结果决定。

底座前方有操作窗口，前后侧套环有走线/接口开口，保留了原电机走线槽、扎带槽和导杆座。由于主控板具体朝向尚未实测，这些开口只能算预留，不能保证每个插头都无需拆顶盖即可插拔。

## 需要另外准备的非打印件

- 1 个 LA024 电机和完整的 LA016 1:48 减速器齿轮/输出轴；**仅有裸电机不够**。
- 两根光滑金属导杆，Ø3×64 mm；不能用全螺纹杆代替。
- 两处 M3 连杆铰接螺钉、垫片、间隔垫及防松螺母；减速输出轴锁紧螺钉尺寸需用实物确认。
- 约 2.5 mm 宽扎带 2 根固定减速器；滑架拳头接口另备 M3 穿孔螺钉及螺母/嵌件。当前插槽给原滑架舌头留约 0.3 mm 单边间隙，打印机公差不同可能需要修孔。

若手里的减速箱缺少壳体，另看 `可选_仅缺减速箱壳体时打印/` 的厂家参考模型；已有壳体不要重复打印。`可选_试配量规/` 可先小成本检查身体套合与输出轴孔。`备选_请勿与05一体拳头同时打印/` 只保存独立腕杆方案，**当前不在必打印清单内**。

## 建议顺序与验证边界

先切片检查 01 和 05 的支撑，再打印量规、01、04 试套及试滑；确认尺寸后打印 02、03、05。装配时先固定减速器和导杆，再装曲柄、连杆、滑架，最后把 05 套到滑架舌头并锁紧。

五个必打 STL 已做数字检查，均为封闭网格。拳头与腕杆在模型中确实融合为一个实体，插槽与旧滑架舌头几何对齐。**尚未通过实物试套、运动干涉、冲击强度或减速箱型号验证。** 首次通电先低速空载试行程；硬质拳头试件用于尺寸验证，对战接触面可另加软质缓冲。
