paomodabaibai/CyberBrick2-User-Research-UX/04_结构与硬件/拳头_全套打印包_2026-09-29/手把手装配_先不要通电.md

# 拳头攻击模块：手把手装配

适用本文件夹根目录的 01–05 五件。先断开电池和 USB，在桌上完成机械试装。**01 已经把旧平台与身体套环做成一件**，不要照旧版说明再找 `09_body_collar`、四颗平台外耳螺钉。

## 先认方向和零件

- **前方**：01 上有两根高立柱、两根导杆会伸向的方向；拳头最终朝这个方向打出。装到 Otto 身体上时对准脚尖朝向。
- **后方**：01 上电机线预留出口的一端。
- **02 曲柄**：小短柄，中心双扁孔套减速器输出轴，旁边偏心孔接 03。
- **03 连杆**：扁平长条，两端各一个孔。
- **04 滑架**：宽件，有两条平行的导杆孔和朝前的方形舌头。
- **05 拳头**：长腕杆后端有方形凹槽，对准 04 的舌头。

此外必须有完整 **LA024 电机＋LA016 减速器、两根光滑 Ø3×64 mm 导杆**。仅有裸电机和五个打印件，无法装完这套直线出拳机构。

## 按顺序装

1. **先试套底座，不固定。** 将 01 的方形套环从上方轻套到已打印的 Otto 身体，前方对准脚尖。确认不顶主控板，USB、开关与线能从窗口触及。若套不上，先量身体与套环，别硬压或钻身体。取下底座继续在桌上装。
2. **装减速器。** 先把两根约 2.5 mm 宽扎带穿过 01 电机托盘旁的狭槽。将已组好的减速器放入托盘，**输出轴向上**，电机线朝后。扎带绕减速器外壳并收紧；不要压到输出轴、齿轮或电线。
3. **装滑架和两根导杆。** 将 04 放在左右两排导杆支座之间，让方形舌头朝前。导杆从前方高立柱的孔依次穿过、穿过 04 的左右滑孔，最后进入后方支座的盲孔。两根杆都装好后，用手推 04，必须能平顺前后滑动约 20 mm。前支座顶部的小孔用于紧定螺钉；确认导杆位置后再轻锁，别把孔拧裂。
4. **装曲柄。** 把 02 的双扁孔对准减速器输出轴，轻推到底；偏心孔朝外可接连杆。若太紧或明显空转，停下检查轴孔尺寸，**不要敲电机轴**。用与实际输出轴相配的螺钉固定，螺钉头不得高于曲柄顶面而碰连杆。
5. **连接 03 的电机端。** 在 02 偏心孔与 03 一端之间放约 2 mm 厚间隔垫，用低头 M3 螺钉穿过，加薄垫片与防松螺母。拧到不脱落且 03 仍可绕螺钉轻松转动；不要夹死。
6. **连接 03 的滑架端。** 03 另一端接 04 中央孔，同样用约 2 mm 间隔垫、低头 M3 螺钉、薄垫片和防松螺母。两处活动铰点都要能转动，螺钉头也不能扫到托盘或导杆。原设计参考螺钉为 M3×16（曲柄端）和 M3×25（滑架端），实际长度以手头垫片和打印公差为准。
7. **装拳头。** 把 05 后端凹槽从前方套到 04 的方形舌头。对齐二者的竖向孔，穿入 M3 螺钉并用螺母固定；拳头向正前方，腕杆不要碰导杆前支座。凹槽约留单边 0.3 mm 间隙，若进不去先去支撑/毛刺，别强拧。
8. **纯手动检查。** 保持断电，手缓慢转减速器输出轴/曲柄一整圈：04 应往复滑动，拳头完整伸出再收回；任何位置都不应卡住、刮线或顶到底座。若转不动，先拆 05 重试，再依次排查导杆、两处铰点和螺钉头。
9. **最后装到 Otto 身体。** 再将完整 01 套到身体上；确认窗口仍可烧录与操作开关，线束不被压住。固定套环的方法要看你已打印身体的实际孔位和壁厚；不要在有主板、电池的地方盲钻。首次通电先悬空、低速、短时间试动作。

## 先停下来的情况

- 没有完整的减速器、两根导杆，或没有可让两处铰点自由转动的 M3 紧固件。
- 01 套身体时压主板/插口，或 04 在导杆上不能用手轻松滑动。
- 手转曲柄一圈有卡点，或者拳头/腕杆撞前支座。

当前是**打印后首轮试装**。设计文件的封闭网格和端点避碰检查不等于实物已经装配成功；先完成以上机械检查，再接电机线。
