paomodabaibai/CyberBrick2-User-Research-UX/04_结构与硬件/2026-09-21_整机首轮试打印包/参考_腕部装配说明.md

# 先打印腕部小样｜75mm巴掌腕部接口 v02

## 本版做了什么
保留用户确认的手掌最长边75mm、轴心到杆末端孔组中心51mm。连接杆总长63.5mm、宽10mm、厚3mm，原舵盘侧孔位不变。

在原Tripo掌腕中增加一个矩形盲插槽，以及锁紧螺钉孔。一块23×12×6mm的连接块固定在连接杆上，手掌套入后用横向M2螺钉锁住。矩形截面限制转动，螺钉限制脱出。手掌、连接块、杆可分别拆换。

蓝色=手掌；橙色=连接块；青色=连接杆。预览图省略螺钉，装配时必须安装。这个版本没有验证击打载荷或PG001能否带动完整手掌。

## 这次先打印三件，不用打印整只手
使用 `STL_打印件` 中：

|编号|零件|打印外包络约mm|用途|
|---|---|---|---|
|01|腕部局部试装件|35.9×29.8×19|只截取腕部，包含完整插槽和锁紧孔|
|02|插入连接块|23×12×6|插进腕部，检验间隙和螺母槽|
|03|杆末端试装片|15×10×3|模拟正式连接杆末端，两孔完全一致|

三个零件全部按100%比例打印。01已经把切断的平面放到底部，插槽口朝上；02和03平放。可先用约0.2mm层高、3圈外壁做尺寸验证。检查切片中的小横孔是否需要局部支撑，避免在插槽和螺母槽中留下难以清除的支撑。这里没有替你们完成特定打印机的切片验证。

## 需要准备的紧固件
本次仅计腕部新增连接，舵盘/支架原有螺钉另外保留。

|用途|规格|数量|说明|
|---|---|---:|---|
|连接块固定到杆|M2×8机牙螺钉|2|从杆底部向上穿入；用普通低圆头/盘头，不用沉头|
|连接块内螺母|M2普通六角螺母|2|名义对边4mm、厚约1.6mm；先放进连接块顶面的六角槽|
|巴掌横向锁紧|M2×25机牙螺钉|1|从腕部圆形沉台侧穿入；不是自攻螺钉|
|横向锁紧螺母|M2普通六角螺母|1|放进腕部另一侧六角凹槽，槽帮助防转|
|横向螺钉头下垫片|M2小垫片|1|建议厚度约0.3～0.5mm、外径不超过5mm；最终按实物确认|

M2孔模型直径2.4mm；杆末端保留原直径2.2mm。六角螺母槽对边4.2mm。插槽相对连接块每侧留0.25mm名义间隙，这些是设计值，实际配合取决于打印机。

不要将连接块固定螺钉直接改成M2×10：本版用M2×8使螺钉尖端留在连接块内部，避免插拔时顶到腕部。根部若加垫片，需重新确认螺纹是否完整啮合。异形厚螺母、尼龙锁紧螺母或大头螺钉不在当前包络验证范围内。

## 小样装配顺序
1. 清掉毛边，先让连接块徒手滑入腕部，不装螺钉。允许轻微阻力，但不能靠猛压或敲打装入。
2. 取出连接块，将两颗M2螺母放入它上方的六角槽。
3. 从杆末端片底部穿入两颗M2×8，固定连接块。确认螺钉未伸出连接块顶部；不要把打印件拧裂。
4. 把腕部从连接块前端套回去，使横向孔对齐。杆下方已预留螺钉头避让通道。
5. 在腕部六角槽放入第三颗M2螺母；从另一侧圆形凹台穿入M2×25和小垫片。轻锁至不松动。
6. 握着杆末端片，轻轻扭动腕部，检查晃动和松脱，再拆下横向螺钉，确认腕部仍能拔出。

根部两颗螺钉在套上手掌后不便操作，这是有意的装配顺序：先固定连接块，再套手掌。需要拆根部时，先拆横向锁紧螺钉并取下手掌。

## 试装后反馈这三项就够
- 连接块插入：过紧 / 合适 / 明显松动。
- 两类螺母槽：能放入、不会打转吗？孔是否对得上？
- 横向螺钉锁紧后：是否还有明显晃动？拍一张装好的腕部即可。

不通过时改插槽或孔位，不整体缩放零件。这样才能保留75mm手掌和51mm杆距。

## 通过小样后再打印
- 04_完整手掌75mm_带接口.stl
- 05_完整连接杆_杆距51mm.stl
- 02连接块可继续使用，如果试装中没有受损。

完整手掌已保留圆润外形，仅切除连接槽、避让槽和螺钉孔。04为手掌侧放的初始姿态，曲面需要在切片软件中检查支撑和接触面；不代表不加支撑就能打印。接口暂按刚性材料的配合设计，若换TPU需要重新评估锁紧及变形。

先查看完整巴掌的切片预计重量，再打印；CAD实体体积不能直接当填充打印重量。装机后先固定底盘、小角度慢速测试，再考虑放开底盘和逐步增加动作，不能依据这份模型宣称已具备击倒能力。

## 已检查 / 未检查
已检查：五个STL均为单个闭合、正体积网格；连接块和杆为有效CAD实体；75mm手掌外包络保持；手掌/连接块/杆名义位置无体积重叠；沿拔出方向1、2、5、10、16mm位置检查了相关螺钉或连接件避让；检查横向螺钉杆、螺钉头与螺母的名义包络。
这些是离散位置几何检查，不是实物公差验证，也不是连续动力学仿真。尚未验证材料强度、跌落、长期磨损、实际螺钉尺寸、打印收缩或舵机负载。

## 文件说明
- `STL_打印件`：放置到平台的打印版本。
- `STEP_结构件`：可编辑的连接块、杆和试装片。
- `装配坐标_勿直接打印`：保留统一坐标，供继续修改和装配；不必导入切片软件。
- `腕部连接装配_75mm_51mm.glb`、`整机总装_v02.glb`：彩色三维预览，不作为切片打印文件。
- 原始Tripo网格及v01均未覆盖。手掌仍是网格模型；没有伪造参数化手掌STEP。
- 源文件`build_interface.py`重建本版，依赖cadquery、trimesh、numpy、manifold3d；运行时会覆盖本版导出，修改前先复制新版本。JSON记录参数，但当前脚本的关联孔位需同步修改，不能只改JSON就假定全部联动。

参考：Otto V9来自 https://github.com/Open-Hardware-Leaders/OttoDIY ；PG001厂家CAD来自Bambu Lab产品资料。保留原作者与厂商来源，本改件不代表官方认证。
