paomodabaibai/CyberBrick2-User-Research-UX/04_结构与硬件/2026-09-21_整机首轮试打印包/参考_顶部支架装配说明.md

# Otto V9 + PG001 顶部巴掌模块 v01

## 状态与边界
这是尺寸核对和小范围动作验证用的机械试装版，未经过实物安装、负载测试、跌落测试或击打验证。主板、电池布局尚未确认。用户已允许后续对原身体钻孔。本版保留原身体、腿脚，替代尚未打印的原头壳。

设计采用外套框＋可拆桥，PG001轴朝上，原配单边舵盘带动轻量横臂与竖直掌面。指向沿横臂径向，挥动方向沿水平圆弧。第一版是开放式结构，并非最终外观。

## 先打印这两件
1. `STL_打印件/01_body_fit_gauge.stl`：75×75×3mm，净方孔69.8mm。套到原身体上缘，应能自然滑入，不需硬压。设计间隙单边0.4mm。量规通过只表示套合开口合适，不表示整机已经验证。
2. `STL_打印件/02_servo_fit_gauge.stl`：38×22×3mm，舵机窗口23.8×12.8mm，安装孔中心距27.8mm、孔径2.4mm。验证PG001壳体能插入、安装耳能贴合、孔位能对上。

两个量规均平放、100%比例打印。不要通过整体缩放修正一个孔位，否则所有尺寸都会一起改变。记录是紧/松、哪一侧、实际间隙或卡尺尺寸后再局部调整。

## 完整零件
|编号|零件|数量|说明|
|---|---|---:|---|
|03|身体安装框|1|外套深8mm，承托边厚3mm，含两个桥支座；侧面预留M3通孔|
|04|可拆舵机桥|1|75×22×3mm，四个M3孔固定到支座；中央安装PG001|
|05|原配舵盘连接横臂|1|50×10×3mm；中心8.2mm避让孔，原配单边舵盘孔位距轴心6.75/12.75mm|
|06|小巴掌|1|掌面厚3mm，单独螺钉连接到横臂；指头为试验形状|

所有STL已放到打印平台z=0。STEP保留装配坐标，不用于直接判断平台摆放。身体安装框空腔可供走线，不将导线夹在套框和原身体之间。

## 紧固件准备（选购前结合实物核对）
- PG001 180°舵机1个，原配单边舵盘1个，原配中心锁紧螺钉1个。不能把普通SG90舵盘当作同规格替代。
- 桥固定：M3×10螺钉4个、M3螺母4个；支座有5.8mm宽、2.8mm高的侧向螺母槽。先试螺母能否滑入，若不合不要硬顶。
- 身体固定：M3×10螺钉2个、M3螺母2个、小垫片4个。身体薄壁要轻锁，螺钉长度需按实际壁厚及垫片核对。安装框左右各一孔，距身体上缘4mm。
- 舵机安装耳：候选M2×8～10螺钉2个、M2螺母2个及小垫片；确认不顶到壳体。桥孔2.4mm，厂家耳槽约2.2mm。
- 巴掌与横臂：候选M2×10螺钉2个、M2螺母2个，孔距5mm；核对螺帽和螺母外径及工具空间。
- 舵盘与横臂：两颗匹配原配舵盘约1mm底孔的小自攻螺钉，候选约1.4×5mm，必须实物确认；横臂通孔1.6mm。不能用M2螺钉硬拧原舵盘。若没有匹配螺钉，先反馈库存，改连接件后再装。

## 装配顺序
1. 两个量规通过后，再打印03和04。先不上电，把舵机装到桥上，确认安装耳坐实、出线不受压。
2. 把安装框套到身体上，检查内部螺母位置无元件干涉。先不要直接按图钻已装电子元件的身体。
3. 将所有电子元件与线材取出后，通过安装框侧孔定位原身体孔位；钻孔、清理碎屑，使用垫片和螺母轻锁。最终内部位置不允许时，改孔位后再钻。
4. 桥固定前，把4颗M3螺母滑入支座侧槽，对准孔位，再拧桥螺钉。支架与身体之间必须没有松动。
5. 舵机单独设置中位，断电，再装原配舵盘及中心螺钉。横臂中央避让孔允许接触中心螺钉。
6. 将横臂固定到原配单边舵盘，再固定小巴掌。舵盘CAD孔位已核对，但真实螺钉与插入深度需要试装。
7. 先固定机器人底部，进行小角度慢速动作，逐步确认走线、松动、卡滞。腿部与第五舵机同时工作前，单独验证接口与电源，不能根据这份机械模型推断电气兼容。

## 打印建议
- 量规和支架试装可先用PLA，100%尺寸，约0.2mm层高；正式耐碰撞材料待测试后选。
- 03按文件姿态打印：下套框朝下。螺母槽存在小跨度顶面，检查切片桥接效果；不要让支撑堵死螺母槽。
- 04桥及05横臂平放。小孔可能偏小，量规通过后再确定孔补偿，不强行拧入。
- 06已侧放，底部较宽的连接座接触平台，较薄掌面会悬空约3.5mm，需局部支撑。细手指仅用于动作验证；接触对战前需评估柔性掌面及支撑结构。
- 各件壁厚与填充可先按3～4圈外壁、20～30%填充试切片。文件未经特定打印机切片验证，不提供未经验证的打印时长。

## 几何核对结果
- 原身体STL包络69×69×39mm；顶部参考z=0。
- 6个输出件均为1个有效实体，导出STL网格闭合。
- 厂家舵机实体对安装框/桥、舵盘对横臂等名义装配检查未发现体积重叠。
- 厂家舵机输出轴距壳体中心X偏置5.34mm，横臂按此布置。
- 整体套框使用外包络留间隙，并非对原版每个曲面进行布尔配合；原身体与新模块未做完整紧固件装配或动态碰撞仿真。
- 未计算真实质量/重心和冲击强度。JSON中的实体体积不是切片耗材重量，不包含填充设置。

## 可编辑文件与来源
`STEP_可编辑实体`含各零件STEP；`顶部模块装配_含参考舵机.step`含装配及厂家参考件；`build_model.py`为CadQuery参数化源文件，`parameters.json`记录关键尺寸。套合间隙、舵机开口等可调；支架高度/孔位布局联动时需要同步改源文件，不能只改一个数就认定所有关联尺寸自动更新。
依赖：cadquery、trimesh、matplotlib、numpy。运行环境在同级cad_runtime目录。再生成会覆盖本v01目录输出，修改前建议复制新版本。

原Otto模型：https://github.com/Open-Hardware-Leaders/OttoDIY
厂家舵机：https://us.store.bambulab.com/products/9g-servo-motor-with-clutch-protection
厂家CAD用于尺寸参考，不据此宣称其为本项目原创或开源许可。保留原Otto来源与适用许可；本包不是经过厂家认证的配件。
