paomodabaibai/CyberBrick2-User-Research-UX/06_游戏设计/打印脱落球靶_v09/制造初样_v01/先看这里_打印与装配.md

# 三档磁吸脱落球靶 · 打印与装配

2026-10-19。**可以开始打印小样；小样合适后打一套初样，试打成功再复制第二套。** 本包已完成CAD有效性、封闭网格、三档实体干涉和主要五金空间检查。尚未切片、实际打印或试打，不能承诺所有机器都无需修孔。

本包取代旧木条/布带/悬挂球方案。不要打印上一级名称含“概念总装_不可直接打印”的文件，也不要将 `04_总装与检查` 的总装模型直接送切片。

## 先打印什么

1. 打开 `01_先打小样`，先打印：`小样_方柱与M3通孔`、`小样_套筒_单边0.3mm`、`小样_磁铁孔4p2_4p3_4p4_螺母孔5p7_5p8_5p9`，各1件。
2. 方柱应能用手滑过套筒，不卡、不需锤入；M3螺丝应能穿孔；磁铁能放入中间4.3mm孔；M3螺母能进入中间5.8mm对边六角孔且不能随意转圈。
3. 如果套筒太紧/太松，另外试0.4/0.2mm小样，再修改生成脚本重新导出对应间隙的底座与悬臂。**不要缩放整个模型来改孔径。** 原正式件采用0.3mm单边间隙；备用小样不表示正式件已自动变更。
4. 小样合适后，打印 `02_一套正式件_STL` 的01–09，各1件。两套共18件，但先只打一套。

磁铁孔小样有两排：圆孔为磁铁（4.2/4.3/4.4mm），六角孔为螺母（5.7/5.8/5.9mm对边）。两排从X负到正逐渐增大；无法区分时按STL在切片软件中查看。实际打印误差不由名义孔径保证。

## 零件数量与朝向

STL已移到打印床Z=0并设置建议朝向，**100%尺寸导入，不要自动再次旋转**。按独立零件导入，不能选“把多个文件组合成一个对象”再自动缩放。

| 编号 | 部件 | 一套数量 | 朝向/支撑重点 |
|---|---|---:|---|
| 01 | 场地固定底座 | 1 | 大平面朝下；方孔朝上。一般无需支撑；小横孔可桥接。 |
| 02 | 三档立柱 | 1 | 已侧放成长条，横穿孔朝上，避免竖直打印长柱的层间薄弱方向。 |
| 03 | 套筒悬臂 | 1 | 悬臂底面和套筒底面共面朝下；方形贯通孔竖直。一般无需支撑。 |
| 04 | 磁铁托座 | 1 | 已翻面，磁吸接触面朝床，装磁铁的开口朝上；翼板下方有悬空，需局部支撑。不要让支撑堵住磁铁孔。 |
| 05 | 托座磁铁封盖 | 1 | 平放；装入04底部大圆孔并胶合。 |
| 06 | 球下半壳 | 1 | 大开口朝床，平底朝上；需从打印床生成内部支撑，后续从大开口取出。小磁铁孔可桥接，避免支撑堵孔。 |
| 07 | 球上半壳 | 1 | 大开口朝床、圆顶朝上；内部顶部需要局部支撑，从大开口清除。 |
| 08 | 球壳定位环 | 1 | 平放。 |
| 09 | 球内磁铁封盖 | 1 | 平放。 |

建议初样：0.4mm喷嘴、0.2mm层高、PLA。结构件01–04用4圈墙、约25–35%填充；球壳06/07名义壁厚1.6mm，不要再整体实心填充。球顶与磁铁区域在切片预览中逐层检查，磁铁隔离薄皮只有0.4mm，应有两层连续挤出。薄皮不能用打磨方式调磁力。

两半球开口边缘接触床较窄，建议加外侧裙边/Brim；支撑和裙边清理后再试接缝。不要用“花瓶模式”。打印耗时和耗材以你的切片结果为准，本轮没有生成机器专用G-code。

## 每套所需非打印件

| 物品 | 数量 | 用途 |
|---|---:|---|
| CyberBrick圆片磁铁 Ø4×2mm | 先2枚，强档6枚 | 下托座、球内各1枚；强档改成各3枚，外圈三角形对称布置 |
| M3×30 螺丝 | 2 | 一颗底座锁柱，一颗套筒调高定位 |
| M3×16 螺丝 | 2 | 把磁铁托座锁到悬臂 |
| 普通M3六角螺母 | 4 | 对边约5.5mm，厚约2.4mm；不是热熔螺母，也不按加厚防松螺母设计 |
| 适用于所用打印材料的胶 | 少量 | 固定磁铁封盖和球壳接缝；胶固化前不试打 |
| 场地固定胶带/已有可靠固定方式 | 适量 | 底座必须固定，不能只靠自重放在桌面 |

有一盒M3螺丝时优先挑上述长度。M3×30选择普通盘头/内六角圆柱头均可，外侧无头型凹槽；04的两颗螺丝头直径建议≤6mm、高≤3mm。若长度不同，不要让尖端、螺母干涉地面或装配件。

磁铁依据：[拓竹官方CyberBrick Hardware Kit清单](https://asia.store.bambulab.com/en/products/cyberbrick-hardware-kit)，清单第22项为4×2mm Round Magnet；项目原二期清单亦标CA001 D4×2。这里只确认外形规格，不据此猜磁力等级。

## 装配顺序

### A. 装底座、立柱和悬臂

1. 清理03方孔、01柱座和02立柱外表面的毛边。先做无螺丝滑动试配。
2. 02插入01到底，柱上最下面的孔与底座孔对齐。螺母放入底座一侧外露的六角窝；从对侧穿M3×30并适度拧紧。
3. 03从立柱顶端套入，球托端朝向底座伸出方向相反的一侧。先对准中间孔，球心即135mm。
4. 螺母放进套筒外侧六角窝，从对侧穿入M3×30。不要靠把塑料拧变形来消除间隙。
5. 三个定位孔从低到高对应125/135/145mm；调高必须先拿下球，再拔出螺栓，托住悬臂移动一档后重新穿回。

### B. 装磁铁

1. 04倒放，从底部大孔把磁铁放入**中心小孔**；06从球内把另一枚磁铁放入**中心小孔**。不用把四个孔全填满。
2. 两件接触时应相吸。用笔给正确极性做记号；还未封盖时不要挥击、不要让磁铁散落。
3. 先做桌面轻推/手动脱离试验，临时固定封盖和球壳，避免磁铁掉出。此时只比较方案，不做机器人冲击试验。
4. 一对太弱时移除中心磁铁，改用外圈等边三角形的三对；**04翼板端部的小缺口和06球壳后侧小孔都朝立柱**，两件的外圈孔位才对齐。先确认三对都相吸，再盖好。
5. 04底部压入05，沿接触周边薄涂胶固定；05顶面与磁铁间留装配余隙，不能强压磁铁。06内部用09封盖同样胶合。
6. 托座与球之间隔着打印薄皮；**不要把球与托座粘在一起**。太难脱落时可用0.4/0.8mm打印减磁垫片，垫片用薄双面胶固定在托座上，避免随球飞出。加垫后球心相应升高少量。

强档采用三角形而非一字排磁铁，减少正拳与横向巴掌在不同脱离方向上的结构偏差；实际触发力仍需两机试打。

### C. 合球、固定托座

1. 08先试放到06大开口内，约露出2mm。正常有少量径向胶缝，不是强压卡扣。
2. 清理内部支撑，磁铁封盖完成后，将08胶合到一半，再合上07；让接缝贴平，外表面可以用临时胶带维持至胶固化。
3. 将两颗螺母放入03底面前端的六角窝。04放到03前端，翼板端部小缺口朝立柱，用两颗M3×16从上往下锁紧。
4. 球放在托座上。06后侧小孔朝后立柱，便于外圈磁铁对齐；这个小孔只是备用系绳孔，不是承重悬挂点。

## 场地固定与脱落后的处理

底座100×80mm，后置，球正前方不占地。**不能把未固定底座直接拿去对战**，否则可能整架移位，无法区分球脱落和撞架。

初样可使用能粘住现有场地表面的双面固定胶带，并在底座边缘加布胶带跨接压住；先用手从四个方向推靶，确认底座不移动/翘起。若雪弗板表层剥离或胶带滑移，停止试打并改机械固定。

底座四角预留M3通孔（孔中心相对立柱中心X±41、Y±31）。是否用穿板螺丝取决于竞技场下方空间；不要让螺母顶住桌面、抬高地板或造成新台阶。本包没有假定竞技场下方有螺母空间。

本版球脱落后可滚动，原位空座作为命中结果；仍需人工复位。若沿用“脱落即结束本局”的规则，可直接人工捡回。备用系绳孔已给出，但本轮未设计自动收球或验证绳路；不能把松弛绳随意横跨巴掌扫掠区。

## 第一套的验收

- 三档均能穿入螺栓；锁住后手推悬臂不自行降档，套筒与底座没有开裂。
- 磁铁封盖和球壳胶缝已固化，无磁铁松动。
- 球放好能稳定保持，正常机器人接近不会震落；固定底座不滑动。
- 从135mm档开始，两台机器人各试正面/常用方向攻击，记录有效命中是否能脱落、是否碰柱/先撞底座。先低速短动作，发现卡住先调整位置。
- 同一磁力配置若一台很难触发，先检查接触位置与姿态，再调垫片/高度，不直接提高机器人输出功率。
- 不能把静态高度重叠当成全部扫掠无碰撞；本轮几何检查不包含整机动态姿态与场地撞击。

通过这一套后，复制第二套同样的球体、磁铁数量和垫片配置。物理试验前不标记“对战适配已完成”。
