paomodabaibai/CyberBrick2-User-Research-UX/04_结构与硬件/Otto_V9组装速查_2026-10-11.md

# Otto V9 腿部组装速查（milk 组 CB1 版）

**图解原件：**[Otto DIY V9 官方组装手册（PDF）](../01_研究参考/robot-battle-reference/OttoDIY_Manual_V9.pdf)。先看其中身体、腿、脚和舵盘的连续图示；[本组四关节中位安装图](Otto_V9腿部对中计划_v01/四关节中位安装图_v01.svg)用来核对实际 CB1 接线。官方手册按原装 Otto 材料示意；本组使用 CyberBrick 1 的 PG001 180°位置舵机和已有打印件，孔位、舵盘花键及螺钉需以手上的实物为准。

## 组装顺序

1. **辨认方向。** 让机器人面朝前、脚尖朝前；左/右均按机器人自身的左/右称呼。先标记四只舵机的连接线，避免装好后把左右口插反。
2. **固定身体内的两只髋舵机。** 按官方手册身体安装图放入镜像的左右舵机，用合适螺钉固定；线从身体内侧走，不让舵盘和腿夹线。不要先强行锁住腿的舵盘。
3. **准备两只腿与两只踝舵机。** 按官方手册的腿内舵机、舵盘和脚的示意左右镜像安装。先试装舵盘与花键、螺钉和外壳是否匹配，能自由摆动且不磨壳。
4. **接线到接收板。** S1 左髋、S2 左踝、S3 右髋、S4 右踝。插头按板上 `S/V/G` 丝印对齐信号/电源/地，接反前不要通电。详细表见[CB1 双机接口对照](CB1双机接口对照_2026-10-11.md)。
5. **通电给四路电气中位。** 扶住机器人，先让腿脚脱离受力位置，再使用[90°保持脚本](../05_程序与测试/CB1_Otto控制框架_v02/hold_90_cb1.py)。程序持续输出 50 Hz、1500 µs，即 PG001 的 90°电气中位。**先送中位，再安装/锁紧舵盘**；把腿摆正、双脚底朝下且左右对称，选择最接近的花键齿位。不用程序中的大 trim 去弥补装歪的舵盘。
6. **逐关节小幅验收。** 托起机身，单路做 90°→约 110°→90°，确认没有顶壳、异常噪声或插头松动；再落地看双脚是否平放。第一台、第二台实际安装镜像方向可能有偏差，应以观察记录为准。若完全不动，先检查插头是否松动。
7. **最后安装顶部攻击模块。** 巴掌款顶部连续旋转舵机接 D1；拳头款直流电机接 M1。顶部结构不要堵住电池开关、USB 口或夹住舵机线。顶部模块与 Otto 原版手册无关，依各自打印包的装配说明安装。

**提醒：** 官方图中的转动箭头、180°标记是图解机械装配，不是让已装好腿脚的舵机直接跑到电气 180°端点。已装好时不要执行大幅度全程扫动；90°命令也可能让装歪的腿突然移动，操作时扶住机身、让断电开关在手边。断电或板子重启后，90°保持会消失。
