paomodabaibai/CyberBrick2-User-Research-UX/06_游戏设计/手工制作图册与3D_v08/print/03_贴图与模板_A3_实际尺寸.pdf

# CYBER / ARENA 机器人对战场

# CYBER / ARENA

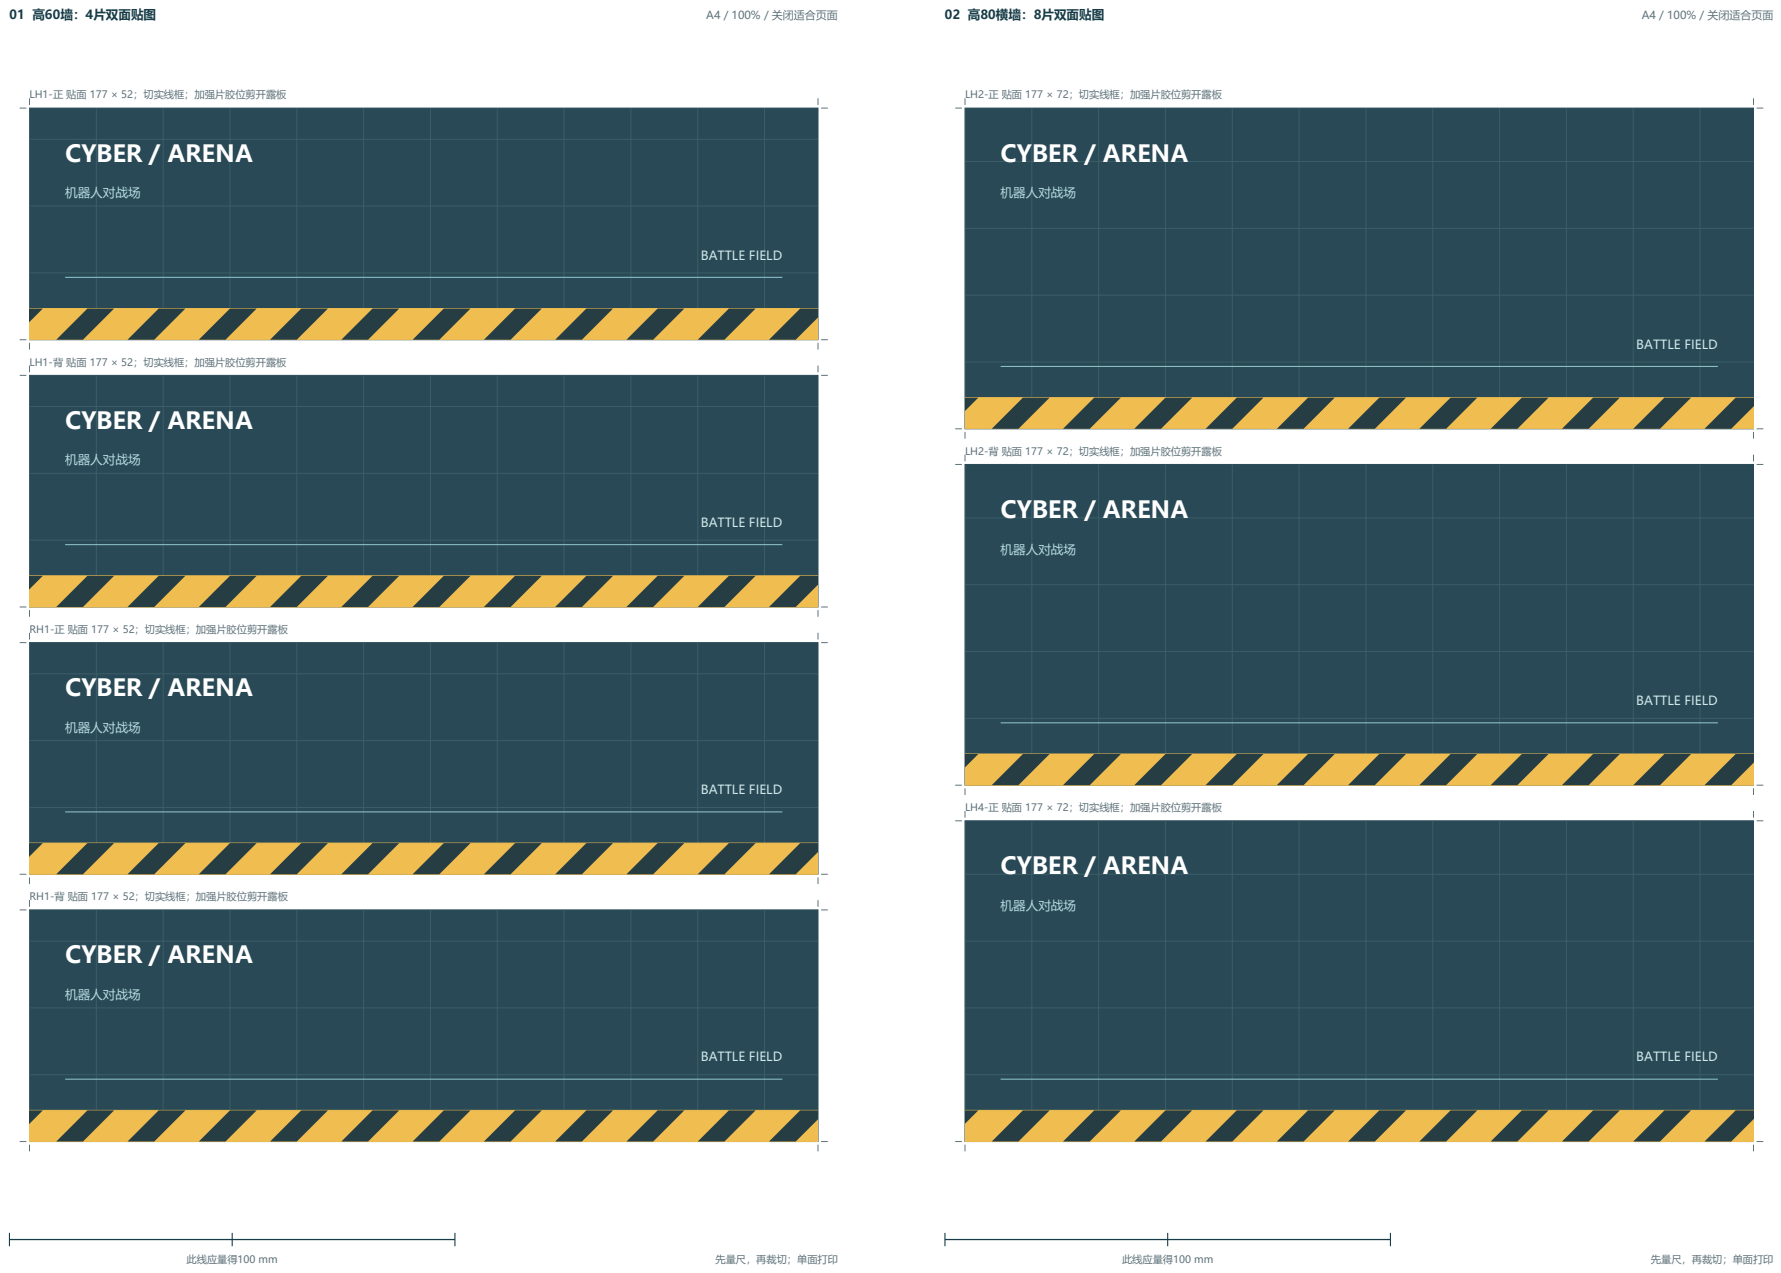
[picture p212: page 1]
01 高60墙：4片双面贴图; A4 / 100% / 关闭适合页面; 此线应量得100 mm; 先量尺，再裁切；单面打印; BATTLE FIELD; 02 高80横墙：8片双面贴图; 机器人对战场; CYBER / ARENA

LH1-正 贴面 177 × 52；切实线框；加强片胶位剪开露板

LH2-正 贴面 177 × 72；切实线框；加强片胶位剪开露板

BATTLE FIELD

LH1-背 贴面 177 × 52；切实线框；加强片胶位剪开露板

CYBER / ARENA 机器人对战场

LH2-背 贴面 177 × 72；切实线框；加强片胶位剪开露板

RH1-正 贴面 177 × 52；切实线框；加强片胶位剪开露板

LH4-正 贴面 177 × 72；切实线框；加强片胶位剪开露板

RH1-背 贴面 177 × 52；切实线框；加强片胶位剪开露板

机器人对战场

03 高80横墙：8片双面贴图 | A4 / 100% / 关闭适合页面
04 高80横墙：8片双面贴图 | A4 / 100% / 关闭适合页面

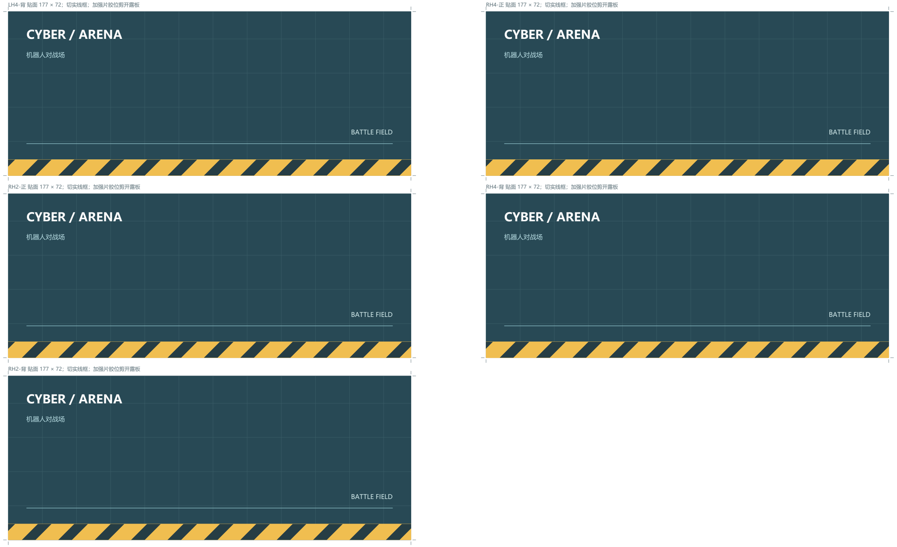
[picture p213: figure]
CYBER / ARENA; 机器人对战场; BATTLE FIELD; LH4-背 贴面 177 × 72；切实线框；加强片胶位剪开露板; RH2-正 贴面 177 × 72；切实线框；加强片胶位剪开露板; RH2-背 贴面 177 × 72；切实线框；加强片胶位剪开露板; RH4-正 贴面 177 × 72；切实线框；加强片胶位剪开露板; RH4-背 贴面 177 × 72；切实线框；加强片胶位剪开露板

05 高100墙：4片双面贴图 | A4 / 100% / 关闭适合页面
06 高100墙：4片双面贴图 | A4 / 100% / 关闭适合页面

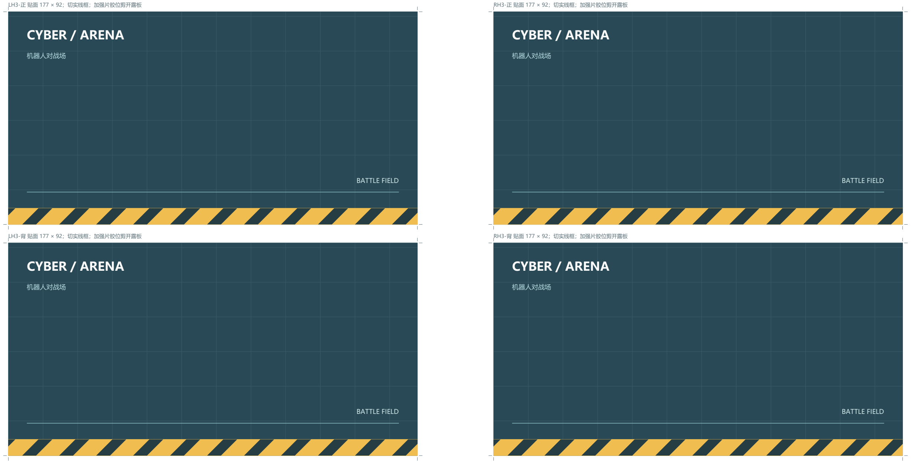
[picture p214: figure]
CYBER / ARENA; 机器人对战场; BATTLE FIELD; LH3-正 贴面 177 × 92；切实线框；加强片胶位剪开露板; LH3-背 贴面 177 × 92；切实线框；加强片胶位剪开露板; RH3-正 贴面 177 × 92；切实线框；加强片胶位剪开露板; RH3-背 贴面 177 × 92；切实线框；加强片胶位剪开露板

07 支墙：4片双面贴图 | A4 / 100% / 关闭适合页面
08 支墙：4片双面贴图 | A4 / 100% / 关闭适合页面

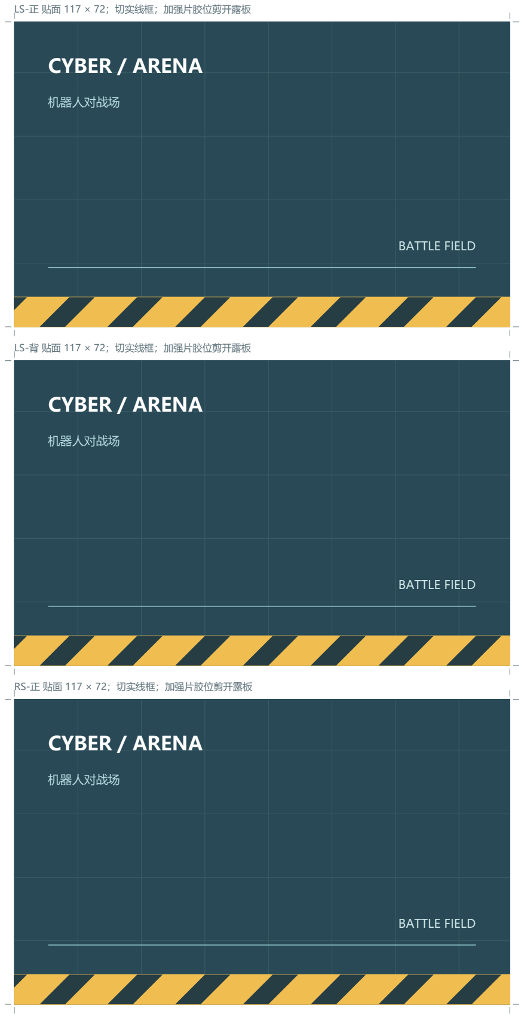
[picture p215: figure]
CYBER / ARENA; 机器人对战场; BATTLE FIELD; LS-正 贴面 117 × 72；切实线框；加强片胶位剪开露板; LS-背 贴面 117 × 72；切实线框；加强片胶位剪开露板; RS-正 贴面 117 × 72；切实线框；加强片胶位剪开露板
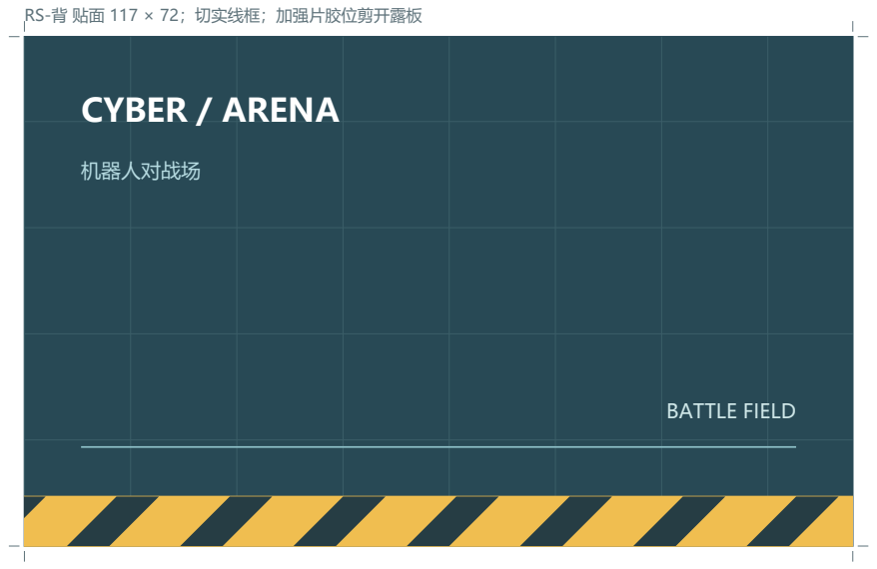
[picture p216: figure]
CYBER / ARENA; 机器人对战场; BATTLE FIELD; RS-背 贴面 117 × 72；切实线框；加强片胶位剪开露板

09 红方出生圆 / 优先作描线模板 | A4 / 100% / 关闭适合页面

# 红方出生

# 红方攻击红球

### 外径180；内径164。薄贴或按圆描线，不做凸起圆环。

### B朝向：红向上 / 蓝向下；摆放时旋转此页方向。

### A朝向：红向右 / 蓝向左；箭头朝向随布局转动。

10 蓝方出生圆 / 优先作描线模板 | A4 / 100% / 关闭适合页面

# 蓝方出生

# 蓝方攻击蓝球

### 外径180；内径164。薄贴或按圆描线，不做凸起圆环。

### B朝向：红向上 / 蓝向下；摆放时旋转此页方向。

### A朝向：红向右 / 蓝向左；箭头朝向随布局转动。

11 靶座标牌 / 底板背面编号 | A4 / 100% / 关闭适合页面

# 红方打这颗球

### 蓝方守护 / 脱开磁点并落到低位才计分

## 摇晃不算 · 人工挂回复位

贴在靶座后方或外侧立面；不要贴到球上

# 蓝方打这颗球

### 红方守护 / 脱开磁点并落到低位才计分

## 摇晃不算 · 人工挂回复位

贴在靶座后方或外侧立面；不要贴到球上

F1

底板背面编号

F2

底板背面编号

F3

底板背面编号

F4

底板背面编号

F5

底板背面编号

F6

底板背面编号

### F1 F2 F3 为南排；F4 F5 F6 为北排，从西向东排列。
