paomodabaibai/CyberBrick2-User-Research-UX/01_研究参考/robot-battle-reference/manual_hi_p5.png

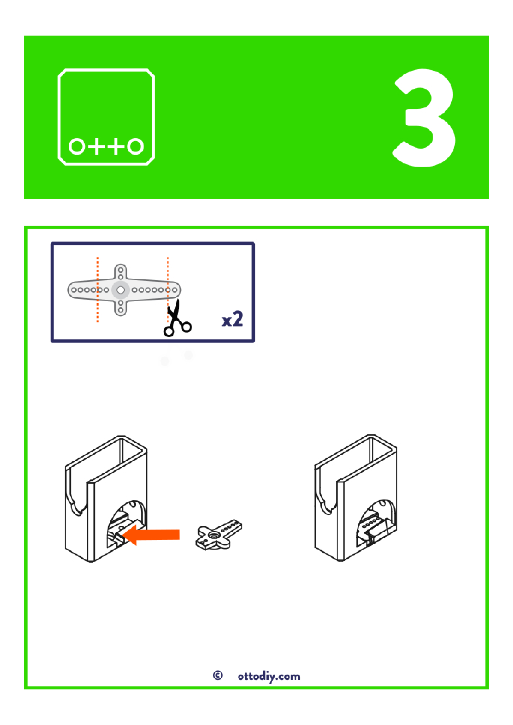
01_研究参考/robot-battle-reference/manual_hi_p5.png
