paomodabaibai/CyberBrick2-User-Research-UX/02_汇报/2026-10-22_项目问题与迭代总结/配图素材/08_拳头模块装配标注_模型图.png

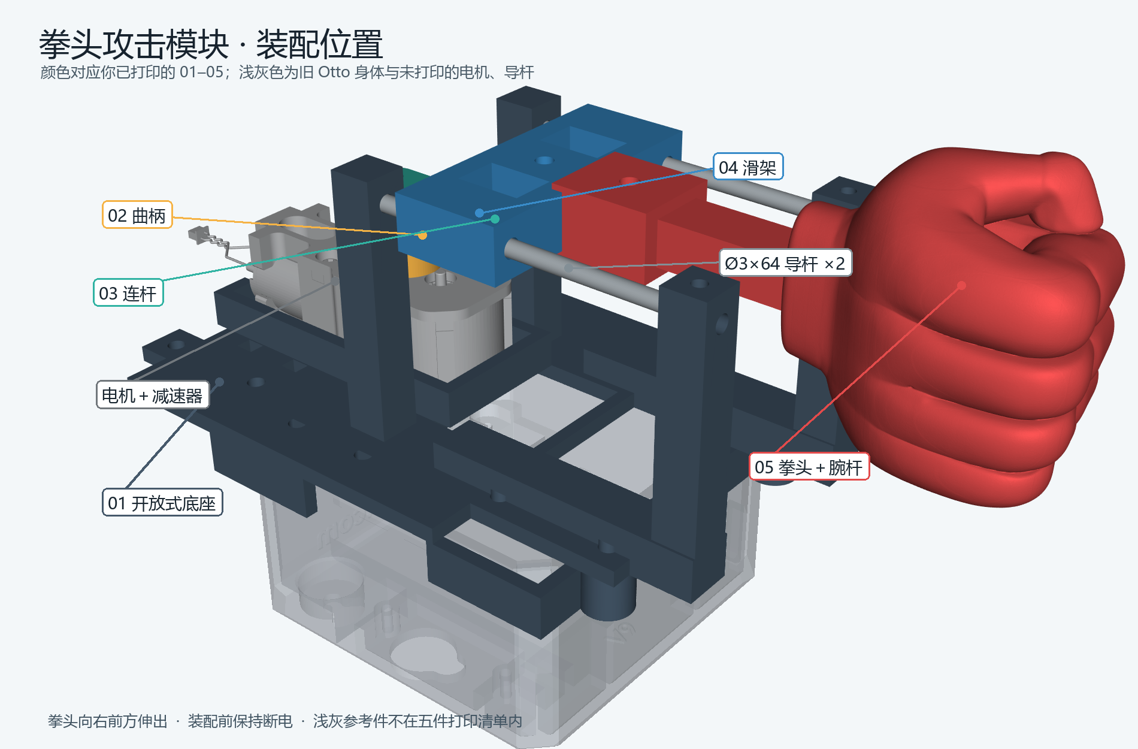
02_汇报/2026-10-22_项目问题与迭代总结/配图素材/08_拳头模块装配标注_模型图.png
