paomodabaibai/CyberBrick2-User-Research-UX/04_结构与硬件/Otto_PG001顶部巴掌模块_v01/装配与拆解预览.png

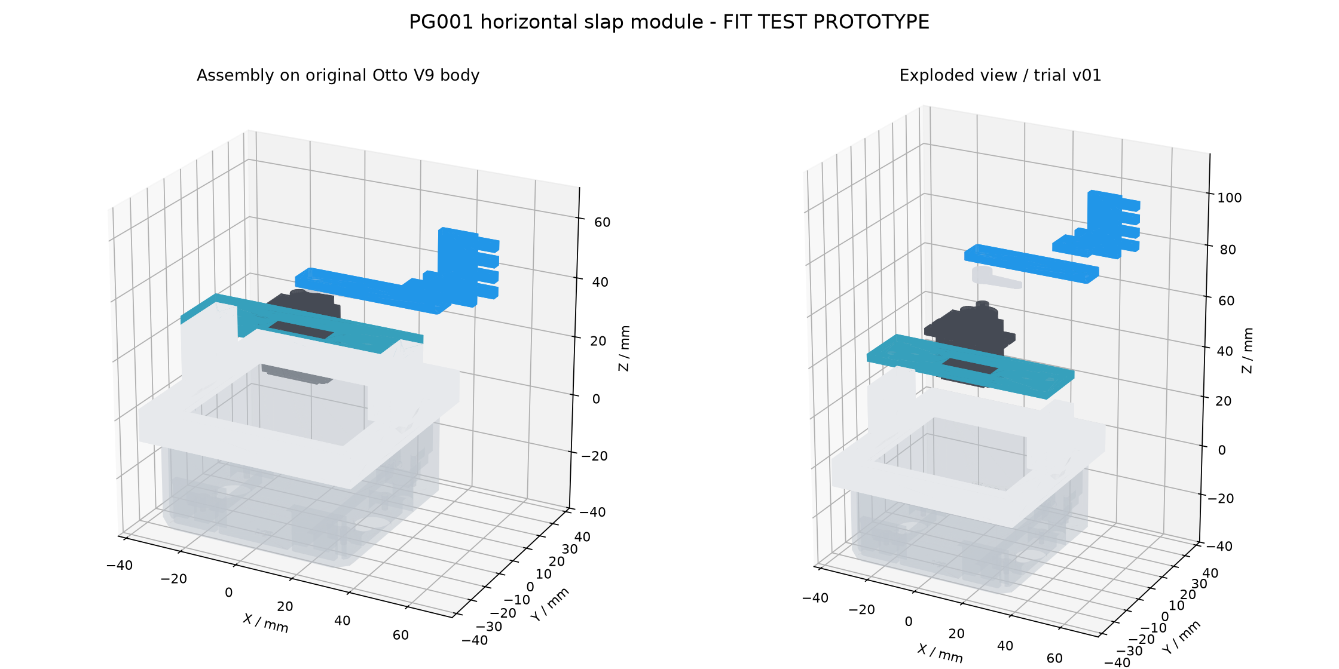
04_结构与硬件/Otto_PG001顶部巴掌模块_v01/装配与拆解预览.png
