paomodabaibai/CyberBrick2-User-Research-UX/05_程序与测试/battery_walk现场日志.txt

[  1.03s] Firmware ver: 01.01.04.13

Loader ver: 99.00.02.51

MPY: soft_reset

[  1.84s] battery_walk: waiting for live remote; center both levers, hold K4 for 1s, release to enable
