paomodabaibai/CyberBrick2-User-Research-UX/05_程序与测试/CB1_Otto单步实验_v01/现场调试记录_2026-09-22.md

# 现场调试记录 2026-09-22（舵机接口辨认专场）

> **2026-09-23夜最新停止点：** 用户要求今晚停止。CB1 v02 四路已标定，但接收板新增电池启动入口 `main.py`/`battery_walk.py` 后，最后一次双板电池供电、重启及 K4 手势试走，用户现场观察仍为**完全没反应**。期间接收板连续遥控帧曾全为 `None`；发射板随后已重启并打印 `MASTER_INIT`，但最后一次尝试时未同步抓接收板日志，根因未定。全量时序和下一次诊断见 `../CB1_Otto控制框架_v02/2026-09-23夜间遥控行走试验_交接记录.md`。本文件以下旧断点仅为历史，不要据此要求重新标定或今晚继续动硬件。

更新（同日深夜，全链路联调后）：本文件按时间追加，最新状态见各节与文末"最新状态速览"。

记录原则：只有"用户确认真实动作"才算实测；只成功发命令不算。

## 环境与前提
- 接收板 COM7（USB序列 58:E6:C5:A8:1B:0C，GPIO10=0），发射板 COM8 未动。
- 连接方式：`serial_runtime` venv 的 mpremote `connect COM7 resume run <脚本>`，不软重启。
- 测试脚本均位于 `05_程序与测试/CB1_Otto单步实验_v01/`，幅度在 JOINTS 限位 65–115° 内，每路测试后 `out.close()` 关 PWM。
- 用户全程托住机器人，巴掌未装。

## 辨认过程（按时间）
1. 此前会话：S1 中位 1 秒、S1 ±5° 往返两次，命令均成功。
2. 用户初判 S1=右脚脚跟（后经反复验证修正为左髋，见下）。
3. 连测脚本 `test_s234_live.py`：S2→S3→S4 各 ±5° 两圈。用户反馈“没感受到动”，改为逐路。
4. `test_s2_live.py`（S2 ±5° 两圈）：用户确认完全没动。
5. `test_s2_amp15.py`（S2 ±15° 两圈放慢）：仍完全没动、无舵机声响。**S2 路判定无响应，待硬件排查**；因 S1 正常，板与程序无问题，问题指向 S2 的舵机/插头/线序/供电。
6. `test_s3_live.py`（S3 ±5°）：用户确认“右脚上部、控制右脚旋转”→ **S3=右髋**。
7. `test_s4_live.py`（S4 ±5°）：用户要求加大。
8. `test_s4_amp15.py`（S4 ±15°×3）：用户报“右脚的脚跟”在动，与 S1 初判冲突。
9. `test_s1_s4_antiphase.py`（S1、S4 反相对抗，±15°）：用户观察后修正 **S1=左腿上部（左髋）**，S4=右脚跟（右踝）成立，冲突解除（此前把小幅度髋部摆动误判成脚跟翘动/左右看反）。
10. `test_s1_s3_s4_touch.py`（S1→S3→S4 顺序长间隔，用户手指搭舵机感受震动）：用户确认与上述判断**完全一致**。

## 最终实测映射（用户确认）
| 接口 | GPIO | 关节 | 备注 |
|---|---|---|---|
| S1 | GPIO3 | 左髋 left_hip | 用户确认 |
| S2 | GPIO2 | 推测左踝 left_ankle | **该路完全无动作，硬件未排查**，仅按“S1/S2=左腿、S3/S4=右腿”布局推测 |
| S3 | GPIO1 | 右髋 right_hip | 用户确认 |
| S4 | GPIO0 | 右踝 right_ankle | 用户确认（“右脚脚跟”） |

布局规律：S1/S2=左腿（髋/踝），S3/S4=右腿（髋/踝）。**S2=左踝是推测，不是实测**，排查后需单独验证。

## S2 路排查结果（同日稍后）
- 断电检查插头/线序后复测 S2（±15°两圈、60秒循环）：原舵机仍全程无动作。
- **换一只好舵机插 S2，60秒循环正常摆动 → S2 口与线路正常，原左踝舵机损坏。**
- 排查期间插线被多次调换，曾出现“驱动S2时右腿在动”的现象，属插线与端口错位，非软件问题；PWM 已确认可全关。
- 用户已按 **S1=左髋、S2=左踝、S3=右髋、S4=右踝** 重新归位插线，四路顺序验证（±15°，`test_all4_seq.py`）：S1/S3/S4 全部按预期动作；**S2 仍无动作，确认舵机坏，当前无备件**。
- 影响：S2=左踝 的对应关系由“布局推测”升级为“端口验证+布局吻合”，但缺一只好舵机装回左踝前，左踝无法实际验证，站姿/步态也无法四脚落地测试。

## 方向验证（同日更晚，脚本 test_dir_s1/s3/s4.py）
- **S1 左髋：+10° = 前摆**（用户确认，重测一次一致）。`direction=1` 下"+=前"语义成立。
- **S4 右踝：+10° = 翘脚尖（脚跟抬起）**（用户确认）。
- **S3 右髋回归问题：单测无动作，±15° 大幅复测仍无动作**；同一脚本中 S1（±10°）动作正常，排除程序/板级输出问题。此前 S3 曾多次正常动作（辨认、四路顺序验证均动）。用户断电检查后称未插反，原因未定。可能方向：插头接触不良、舵机在反复插拔中损坏、S3 口线材问题。**右髋是步态必需关节，修好 S3 前无法做步态。**
- S2 左踝：舵机坏无备件，方向无法验证。
- LEFT_SIGN 尚未标定：需要至少左右髋+左踝可用、机器人落地受支撑后做移重心小步才能定。

## 已做配置更新
- `board/milk_config.py` JOINTS pin 已按上表改：left_hip=3、right_hip=1、left_ankle=2、right_ankle=0；名称、顺序、其余参数未动。
- 已上传接收板，SHA256 双端一致（6f2081be86c25602418d9df24853bcc077c568ba03faffdac413c44f0d4dd993）。
- **坑：resume 模式下解释器不重启，旧 milk_config 仍在 sys.modules 缓存。** 后续板上验证必须先 `sys.modules.pop('milk_config',None)` 再 import；跑测试脚本同样要防缓存旧配置。清缓存后板上 import 已确认新映射生效。
- CALIBRATED / REMOTE_MAPPING_VERIFIED / ATTACK_ENABLED 仍为 False。

## 未验证项
- 各关节 +offset 对应的实际运动方向（direction/LEFT_SIGN 均未校）。
- S2 路舵机与左踝的对应关系。
- 站姿、步态、支撑侧卸载，均未测试。

## 遥控链路与 jog 模式（同日晚）
- 发射板 COM8 已 hard reset 恢复官方发射程序（重启后无法再进 raw REPL 属正常，程序在跑）。
- `milk_probe.monitor()` 三轮只读监测：帧稳定到达，配对正常；开头偶发一帧 None 后持续有效。
- **实测通道**：左摇杆=L1/ch0（静止约1959，一个方向推到0，反方向当时未观测到变化）；右摇杆=R1/ch3（静止约1797，双向全行程0..4073）；L2/ch1恒0未接；ch2/ch4/ch5只小幅抖动；**唯一实体按钮=K4/ch9，按下读0**（用户确认只有K4）。
- 官方 rc_module.rst 核对：rc_slave_data 返回[L1..K4]，未配对/发射端不工作返回 None——250ms失联检测方案成立；文档无帧序号，"发射端关机后是否吐旧帧"仍未实测。
- **milk_jog.py 摇杆直控模式跑通**（左摇杆→S1左髋、右摇杆→S4右踝、K4按住回中、±15°限幅、失联自动回中、120秒自动结束关PWM）：用户评价"很成功"。
- 注意：milk_jog.py 是模块级执行脚本，**验证导入会直接跑起来**；正式运行用 `mpremote run`，不要随意 import。
- config 已更新并上传：LEFT_CENTER=1959、RIGHT_CENTER=1797、ATTACK/ENABLE/STOP_BUTTON=9（K4）、BUTTON_ACTIVE=0、REMOTE_MAPPING_VERIFIED=True；CALIBRATED 仍 False。

## 方向复测、S2真相与boot.py禁用（深夜）
- **重大勘误：四个舵机和四个接口全部正常，此前"S3回归无响应"与"S2舵机损坏"均为误判。**
  - 根因1（脚本索引bug）：改pin后JOINTS索引语义变化，`test_dir_s3.py`等旧脚本按旧索引写，实际驱动的是S2而不是S3；`test_all4_seq.py`的第二/三段标签也错位。教训：**板上实验脚本一律用接口号→索引查找（PORT_TO_INDEX），不写死索引**，已建 `test_dir_by_port.py`。
  - 根因2（舵机类型）：S2上插的是**360°连续旋转舵机**（用户确认外观与其他不同），中位附近有死区，±15°小幅测试几乎看不出动，被误判"损坏"。用摇杆/官方程序大偏移驱动时会连续旋转。**此舵机留给巴掌横扫（ATTACK_MODE='continuous'），左踝需另配180° PG001。**
- **S2失控旋转事件**：接收板被硬复位（reset_cause多次为0/1，可能与mpremote会话中断的串口信号翻转有关），boot.py自动运行官方rc_main，按官方配置驱动S口，S2上的360°舵机被大偏移脉宽驱动而不停转。处置：抢占串口、deinit全部PWM（0-3、20/21）。
- **断根措施：接收板boot.py已改名为`boot_official_disabled.py`**，此后任何断电/硬复位都不会自动运行官方程序，板子停在REPL等待指令。本地完整备份在`../板载备份_2026-09-22/COM7`；恢复官方功能时把文件名改回boot.py即可。
- 板载紫灯：官方仓库/文档无LED颜色定义；紫灯是核心板原生固件状态（MASTER_INIT/AUTO_SLEEP那套），非我们代码驱动，不影响舵机与测试，暂无视。
- **方向复测（test_dir_by_port.py，用户读数）**：S1左髋 +10°="向右旋转"、S3右髋 +10°="向右旋转"、S4右踝 +10°="翘脚尖"。两髋电气同向、空间镜像，符合原版Otto安装。早前"S1+10=前摆"的读数与本次"向右"描述不一致，属观察视角差异——**方向语义尚未可靠标定，LEFT_SIGN必须等落地小步再定**。
- **托住单步联调（test_bench_step_held.py）**：绕过CALIBRATED门禁的实验脚本，四阶段（移重心→卸载→摆动→落脚）完整执行，姿态轨迹与设计一致（踝7°/左踝+3°/髋8°/末端保留髋偏置/自动回中），PWM正常关闭。**用户肉眼观察尚未反馈**（被S2事件打断），补做时直接重跑本脚本。

## 最新状态速览（接手先读这段）
- 接收板COM7：boot官方自启已禁用，REPL待命，CALIBRATED=False、REMOTE_MAPPING_VERIFIED=True。
- 映射（实测确认）：S1/GPIO3=左髋，S2/GPIO2=左踝位（现为360°舵机，占位），S3/GPIO1=右髋，S4/GPIO0=右踝。方向语义待落地标定。
- 遥控：左摇杆=L1/ch0（静止约1959）、右摇杆=R1/ch3（静止约1797）、唯一按钮K4/ch9（按下=0）；jog模式（milk_jog.py，`mpremote run`运行，勿import）用户验证成功。
- 硬件待办：**左踝需要180° PG001舵机**（现由360°舵机占位，只能发中位）。
- 下一步顺序：重跑test_bench_step_held.py补用户观察 → 定LEFT_SIGN与踝符号 →（有180°左踝后）托住站姿 → 落地小步 → 串口交替步/失联旧帧实测 → 巴掌舵机。

## 旧文下一步（部分已被上文取代）
1. **硬件两件事**：a) 找 PG001 备件替换左踝坏舵机；b) 排查 S3 右髋无响应（先重插 S3 插头/换线，再把该舵机换到已验证正常的 S2 口测试：动→S3 口插头/线问题，不动→舵机坏）。
2. 硬件齐后：S2/S3 各自单独验证动作与方向。
3. 托住四关节中位站姿 → 小幅移重心定 LEFT_SIGN 与踝符号（参考《Otto步态拆解与本版设计.md》）。
4. 之后才考虑串口交替步、遥控与失联测试。

## 后续只读复核补充：以最新进展为准（2026-09-22）
本轮读取了深夜更新，没有连接串口、运行舵机或上传代码。以下是本地源码复核，不是新的实机结论。
1. 当前真实断点已经前进：S1左髋/S2左踝位/S3右髋/S4右踝；S2是连续旋转舵机而非损坏。遥控jog用户验证成功，正式步态未验证。旧交接中“等待S1第二轮反馈”“boot未修改”已过时。
2. **不要直接重跑test_bench_step_held.py。** 脚本注释称S2只发中位，但循环实际调用out.pose(pose)，milk_hw.Output.pose逐个原样发送偏角，没有屏蔽左踝。因此会给S2连续旋转舵机发送非中位脉宽。应先换正确180°舵机，或修改测试明确排除S2并验证；排除S2的三关节演示不代表完整步态。中位是否真能停转仍需校准，不能凭1500us假定。
3. **正式milk_receiver.py目前无法用K4解锁。** config把ATTACK_BUTTON/ENABLE_BUTTON/STOP_BUTTON均设9：按下使能时同时stop=True且pressed=True，RemoteGate优先停止、neutral条件也要求not pressed。jog成功不等于正式接收状态机成功。需另设计单按钮状态逻辑或增加独立按钮，并测试冲突后再启用。
4. milk_config.py头部仍写左踝FAULTY，已被最新实物识别推翻，后续改代码时同步清理此过时注释。
5. 17项测试通过属于旧配置历史结果；当前REMOTE_MAPPING_VERIFIED=True后旧测试test_default_config_no_activation断言False不再适配。没有在本轮重跑，不声称最新修改仍全部通过。
下一步优先处理上述两项源码与说明矛盾，然后在180°左踝就位、方向与中位确认后做完整步态。不要按旧文直接绕过CALIBRATED门禁。

## 上述复核问题的修复（2026-09-22深夜，接上一节）
1. **test_bench_step_held.py 已修复**：改为只显式驱动索引0/1/3，GPIO2 不创建任何PWM，可安全重跑；"排除S2的三关节演示不代表完整步态"的限定仍有效。
2. **K4单按钮冲突已修复**：`STOP_BUTTON=None`（取消专用停止键，失联照旧解锁）；`milk_receiver` 按钮通道支持None；neutral判据改为仅看双杆回中（否则按住使能键自身会破坏neutral）。**仅PC测试验证，实机解锁流程未测。**
3. milk_config 头部FAULTY过时注释已清理，改为"四舵机全好、S2为360°连续舵机、禁止给索引2发非中位脉宽"。
4. 测试同步新语义并全绿：core 13项OK、receiver 4项OK（系统python直接跑tests/*.py，无需pytest）。
5. milk_config/milk_receiver/test_bench_step_held 已上传COM7，SHA256双端一致（config f05e3e85…、receiver 56937a28…）。
6. 协作提示：COM7偶发"被其他程序占用"（并行会话或残留mpremote），稍等重试即可；写板载文件前先重读最新状态。

---

# 2026-09-23 v02 板端接入（阶段B，用户在场）

## B1 只读检查
- 接收板仍为 **COM7**（USB序列 58:E6:C5:A8:1B:0C），发射板 COM8。
- 板载 11 个文件全量备份到 `board_backup_2026-09-23_B1/`（大小逐一致；旧备份 板载备份_2026-09-22 未动）。
- `boot_official_disabled.py` 在列、无 boot.py/main.py：官方自启仍禁用。

## B2 上传与无动作验证
- 上传 v02 白名单 13 个文件（含补传的 timeutil.py——阶段A清单漏了它，已在台架验证计划中修正）。板上 uhashlib.sha256 与本地 13/13 一致（注意：`mpremote fs cat` 经 Windows 管道会转 \r\n，校验须在板上算哈希）。
- 板上 config.py 为独立副本，DRIVER='cb1_pwm'（PC 侧保持 'sim'）。
- `import main_v02/bench_v02` OK；`bench_v02.diag()` 与 PC 一致（左踝 disabled/continuous，行走门禁列出4项缺失）。
- **无动作验证通过**：15 拍轮询（有有效帧、未使能）后 PWM 通道为空 {}，无任何脉冲。cb1_pwm 仅在首次 write() 建 PWM 且 duty=0 起。
- 静止杆量 L=-0.00 / R=-0.01：实测中位 1959/1797 与 config 完全吻合。

## B2 遥控实测（36s 采集 + 定向探针，用户操作）
- **方向**：左杆前推=+1.00、后拉=-1.00；右杆前推=+1.00、后拉=-1.00。与 v02"前推为正"语义一致，direction=1 无需改。
- **行程**：双杆双向均能到满量程 ±1.00。
- **K4**：按下正确识别（读0），松开恢复。
- **失联（关键）**：关闭遥控器后 6s×33Hz 采样 **全部返回 None**（196/196）——固件不返回缓存旧帧，connected=False 立即成立，**失联保护可用**，v02 timeout_ms=None（None=立即断链）设计与真实固件行为一致。
- 采集方法备注：用户看不到板端实时输出，采集须由 UI 选项点击触发同步（点击后立即开始操作），第一次因此空采。

## 待办（B3）
缺左踝验证：joint() 逐关节小幅动作（S1/S3/S4，需用户托住）、demo3() 命令顺序、显式使能(enable_debug)/K4停止/暂停/恢复/释放 全流程。未动执行器。

## 2026-09-23 三路90°首次归位（用户在场）
- 上传 center_joint.py + 新版 drivers（cb1_pwm 带write_one；__init__传cfg），板上哈希与本地一致（cb1_pwm 97da011e…、__init__ b0d0c7df…、center_joint 2005f4a2…）。**教训：mpremote resume 不清模块缓存，覆盖上传后须在exec里pop sys.modules再import。**
- 过程：right_hip(S3)→left_hip(S1)→right_ankle(S4) 各 90° 保持4s自动关输出；通道表每路后为空；S2(left_ankle)全程无脉冲。
- 用户观察：**三路都有动作**（③观察者确认）。无卡住/异响报告。
- 结论：三路位置舵机可被单通道90°命令驱动并释放；电气中位命令链路可用。机械舵盘齿位重装与方向/范围标定待下一步（中位保持模式下装舵盘）。

## 2026-09-23 三路机械中位锁定（中位保持+舵盘重装，用户操作）
- 流程：S3右髋 → S1左髋 → S4右踝，每路 center_joint.send(名, confirmed=True) 持续保持90°（1500µs实测duty_ns=1499046），用户拆舵盘→按姿态插回→拧紧，再 off() 关输出，最后 bench_v02.joint(±3°) 命令验证。
- 用户确认：S3 重装完成"装好了"；S1 重装（中途要求重新保持一次，已重发）；S4 "OK了"。S2 无脉冲。
- 机械中位状态：三路舵盘已在新中位锁定；±3°命令均执行（③观察细节待用户补录方向描述）。
- 未做：trim/direction/min/max 仍为占位；三路 calibrated 仍 False（等方向/范围记录+用户确认）；左踝 PG001 未到货。
- 下一步：①用户补答三路±3°方向观感→填安装记录表；②PG001到货换左踝→第四路对中；③四路齐→站姿验收（阶段C末）。

## 2026-09-23 第四路归位：左踝换装 PG001 → S2 对中与四路方向观察（用户在场）
- **config-only 换装生效**：PC config.py 的 left_ankle 改 enabled=True / actuator='position'（calibrated 保持 False），板端变体（仅 DRIVER='cb1_pwm' 一行不同）上传接收板，板上 uhashlib.sha256 与本地一致（94edd6c6…，5556 字节）。板端 pop 模块缓存后 import 验证：四路 enabled+position、walk_blockers=四路 not calibrated、walking NOT ready、list() 无 PWM。
- PC 侧：更新 5 处依赖"left_ankle 禁用"旧事实的测试（改为变体配置驱动，门槛诚实性保留），全量 **98 项通过**。
- **S2 排障**：首次 90° 保持后舵机零反应；0°(2s)→90°(12s) 扫动仍零反应；重插舵机插头后 0°(3s)→180°(3s)→90°(6s) 大扫动**恢复正常**。结论：插头接触不良，舵机本身完好。
- **S2 归位**：90° 保持 12s，用户调平左腿、装紧舵盘（第一次因 PWM 已关时安装作废，第二次成功）。±3° 验证：**+3°=脚尖翘起、-3°=脚尖压下**（用户确认，双向正常）。
- **S3 排障**：+3°/+8° 均零反应（昨天归位时正常，判断为换 S2 时碰松插头）；重插后 45°(2s)→135°(2s)→90°(6s) 扫动恢复。+8° 方向确认：**右腿向后摆**。
- **四路方向记录（均用户当面观察，③级）**：S1 左髋 +3°=前摆；S3 右髋 +8°=后摆（镜像）；S2 左踝 +3°=翘尖/-3°=压尖；S4 右踝 +3°=压尖（镜像）。
- 与 GAIT 默认值对照：双髋相反符号与 step_sign_left=1.0/step_sign_right=-1.0 吻合；双踝相反符号意味着单值 ankle_sign=1.0 不够用，阶段D前应把左右踝符号拆开（未改代码）。
- 状态：四路电气中位 90° 已锁定舵盘；安全范围/trim 未测；calibrated 四路仍 False（strict enable 仍拒绝）。教训入册：**"命令已发但零反应"先重插插头再怀疑舵机；每次实机测试前逐个按压检查四个插头。**
- 下一步：①逐路测安全范围/trim → 写 config → 用户确认后逐路 calibrated=True；②托住站姿 → 短时桌面落地（阶段C关口）；③B3 流程验证（使能/K4/暂停/恢复/释放）仍待做。

## 2026-09-23 晚：标定回写与上板（交接前收尾；阶段1标定完成，未行走）
- **安全范围（用户在场观察）**：四路 ±10° 扫动，S1 左髋 -10° 后摆顶死；补扫 -4/-6/-8 全正常 → left_hip min 收窄 82°（步态最大后摆 -8° 恰好在界内）。其余三路 ±10° 无顶死无异响。trim 均为 0（90° 装盘时已目视调平）。
- **config 标定回写**：四路 calibrated=True + S1 min=82 + 方向事实注释。板端变体（仅 DRIVER 行不同）上传 COM7，板上 SHA256 一致（config c3c249f5…、gait_planner f988ef0e…、walk_session d7c948c6…）。板上验证：calibrated=[True×4]、walk_blockers=[]、can_walk=True。**strict enable 现在可用**（仍要求使能瞬间有有效帧+K4 松开）。
- **左右踝符号拆分（代码改动）**：GAIT.ankle_sign_left/right 取代单值 ankle_sign（旧键仍可作回退）。依据=双踝镜像观察。两值初始 1.0，未验证，是调参旋钮。gait_planner 中 lean/stepping 偏移按各自侧符号计算。
- **新板端入口 walk_session.py**：定时步行会话（严格使能→轮询N秒→打印状态变化→finally关PWM），解决"串口 exec 无法转发 Ctrl-C"的现场问题。测试覆盖交替步/K4停止/无帧拒使能。
- **测试**：标定事实翻转后诚实门禁测试改用"降级副本"驱动；**103 项全绿**。
- **未做（交接给下一位，全部需用户在场）**：托住站姿→桌面落地→遥控单步→调参（先调 ankle_sign_*/lean，预期至少一个踝符号要翻转）。行走证据等级目标：③用户观察单步动作→④真实移动。
