paomodabaibai/CyberBrick2-User-Research-UX/05_程序与测试/CB1_Otto控制框架_v02/2026-09-24上午遥控调试_交接记录.md

# 2026-09-24 上午遥控行走调试：交接记录

> **⚠️ 已部分过时（2026-09-24 下午复核）：** 本文件"二、当前卡住的问题"中的嫌疑排序已被下午诊断推翻——K4 按住 10.4 秒信号连续无抖动（arm_probe_2026-09-24.txt，resets=0），**按钮接触抖动嫌疑作废**；battery_walk 实际成功 enabled 过、后被 K4 停止退出（battery_walk_live_2026-09-24.txt）；真实左杆触发过完整 step start/done 但用户未见动作（trace_remote_walk_2026-09-24.txt）。最新结论与执行顺序以 [2026-09-24_遥控无动作_公开资料复核与执行交接.md](2026-09-24_遥控无动作_公开资料复核与执行交接.md) 为准。本文件仍有效的部分：第一节（demo_scripted 实测成功、配对修复经过、代码重传哈希）、第三节（项目现状快照）、安全纪律。

**结论：脚本自走已成功（真机④级证据）；无线配对已修复、帧已打通、通道映射已全部验证；最后卡在"K4 按钮读取不稳定"——探针能读到按钮，但 battery_walk 现场运行时用户操作始终未触发使能。**

## 一、今天完成的突破（按证据等级）

### 1. 脚本步态自走成功（④真实位移）
- 新增 `demo_scripted.py`：板子自造虚拟遥控帧（左推→回中→右推→回中），走**同一套** strict enable + 五阶段步态代码，不绕过任何安全逻辑。K4 全程松开，结束/异常 finally 释放 PWM。
- PC 测试 **106 项全绿**（原 103 + 新 3）。板上哈希核验一致。
- **实测**：悬空单对步——髋部方向完全正确（左步=左腿前摆+右腿后摆，右步相反）。
- **落地 4 步**：桌面打滑 → **垫鼠标垫后解决**。用户反馈"幅度需要大一些"。
- 调参（一次一变量）：lean 7→10、lift 3→5，用户仍要求更大（lean=10 已到 ±10° 已验证扫动上限）。
- **展示保底方案就是它**：`import demo_scripted; demo_scripted.run(2)`，约 16 秒 4 步，放鼠标垫上。

### 2. 无线配对修复（重大转折）
- 用户用 **CyberBrick 电脑版软件**（不是 MakerWorld 手机 App！）上传配对代码，成功重新配对。两板黄/蓝灯交替闪烁。**PC 软件也能配对，之前"只有手机 App"的结论被推翻。**
- 配对副作用：**接收板文件系统被清空重建**（官方 rc_config/boot.py/app 恢复），我们全部代码被删。已重传全套并逐一验哈希（config/main/battery_walk/demo_scripted/walk_session/main_v02/gait_planner/controller/command_mapper/trajectory/drivers 三件）。期间两次 ImportError（漏传 command_mapper.py、trajectory.py）已补齐。板上 14 模块 import 全过，自启动 banner 验证通过。
- 官方 boot.py 已再次改名 `boot_official_disabled.py` 禁用。

### 3. 新配对下通道映射已全部重新验证（②板端日志）
24 秒双杆轨迹采样（文件 `../双杆轨迹采样.txt`）：
- **左杆 = ch0**：后拉→0，中位≈1942，前推→4072
- **右杆 = ch3**：后拉→0，中位≈1800，前推→4072
- **K4 按钮 = ch9**：按下读 0，松开读 1
- 结论：**帧布局与旧 config 完全兼容，config.REMOTE 不需要改**（通道由发射板硬件决定，不随 App 配置变）。

## 二、当前卡住的问题：K4 手势在 battery_walk 里始终未触发

### 现象
用户按 K4（唯一实装按钮，映射 ch9 已确认）做"按住 1 秒松开"手势，battery_walk 无反应；重启后仍无反应。**但探针采样时 K4 能清晰读到**（按键排查 60 秒里 t+41.7s~t+53.5s 密集读到 K4=0，证实按钮和链路都好）。

### 排查中遇到的干扰因素（很可能是根因线索）
1. **用户按键时机与采集窗口不同步**：多次探针（45 秒窗口）全程没读到任何按键——用户看不到采集何时开始。后来 60 秒窗口读到了，但集中在 t+41~53s，说明用户是看到消息后过一会儿才按。**battery_walk 等待循环无限期，时机不是问题**——所以问题不在这里，见下。
2. **串口会话不稳定**：mpremote exec 长监听两次中途死掉（`ClearCommError failed PermissionError 13 设备不识别此命令`）、com_listen 也遇过 COM 被占用。板子 USB 在会话中重连过（COM 号未变，仍是 COM7=接收板 58:E6:C5:A8:1B:0C，COM8=发射板 58:E6:C5:A7:00:A4）。
3. **重大嫌疑：每次 mpremote/com_listen 打开 COM7 都会复位接收板**（USB-Serial-JTAG 特性），battery_walk 冷启动重来。用户可能在**板子已被我复位后的 2 秒启动期**按按钮，或操作时帧还没恢复（链路建立需要时间——探针显示 conn=False → True 要几百 ms~2s）。若用户在 conn=False 期间按住 K4，`held_at` 一直被清零，手势永远凑不满 1000ms。**用户"按住不松"期间如果链路闪断一次，就必须重按。**
4. 按钮电气抖动/接触：探针里 K4 信号高频抖动（0/1 交替 ~200ms 周期）——t+41.7~53.5s 那段用户可能是在**反复点按**而非按住。若按钮接触不良，按住时信号断续，`held_at` 被反复清零。**这个嫌疑最大。**

### 建议下一步（按优先级）
1. **先跑 demo_scripted 保底**（展示已够用），遥控作为加分项继续查。
2. 写一个 **K4 专用长监听**（板上循环 60 秒只打印 ch9 变化+时间戳，存文件），让用户**按住 5 秒不松**再松开，看信号是否连续。若断续 → 按钮接触不良（重插按钮插头，参照舵机插头教训：命令已发但零反应先重插）。
3. 若按钮信号连续，则改 battery_walk 的手势门槛（ARM_HOLD_MS 1000→500ms，或改为"按下即 armed，松开即 enable"两段式并打印每步状态）再实测。**等待循环里加 1 秒一次的 heartbeat 打印**（等什么、读了什么），配合 com_listen 采集对照。
4. 也可以绕过手势：临时把 main.py 改为直接跑 `walk_session.run(120)`（严格使能、K4 只做停止、有帧即走），跳过 arm 门槛——**演示时风险可控**（有帧才使能，K4 停止，120 秒限时）。
5. 串口工具注意：com_listen 与 mpremote 不能同时开；mpremote exec 长时间运行可能因 USB 重连死掉，重要采集**先落盘到本地文件**再传回。

## 三、项目现状快照

- 代码：v02 框架全套在接收板上且哈希核验通过（config 含 lean=10/lift=5/DRIVER=cb1_pwm 变体，哈希 `a33f9721…`）。PC 侧 106 测试全绿。
- 步态参数：hip_swing=8（S1 后摆 -10° 顶死，不能加）、lean=10（扫动上限）、lift=5。用户还想更大——可试方向：加长 phase 时程让动作更"明显"、hip_swing 左右不对称、或先解决位移再谈幅度。
- 硬件：四关节 180° 位置舵机全部校准；S1 后摆 -10° 顶死（min=82）；S2/S3 插头接触不良史（零反应先重插）。鼠标垫是行走必需品。
- 安全纪律：区分证据等级①PC②板端日志③用户观察④真实位移；用户在场才动真机；**绝不 esptool flash-erase/第三方烧录**；mpremote 检查会打断板上程序，检查后必须重启再试走；K4 只做停止永远不做使能以外的攻击动作。
- 关键事实：**PC 版 CyberBrick 软件可以重配对**（手机 App 也可以）；App/PC 软件上传配置会清空文件系统——**重配对后必须重传全部代码**；配对状态在固件里，传 .py 文件不影响它。

## 四、给下一个 Agent 的最短路径

1. 读 `PROJECT_CONTEXT.md` + 本记录 + `2026-09-23夜间遥控行走试验_交接记录.md`。
2. 展示保底：托住/鼠标垫 → `mpremote connect COM7 resume exec "import demo_scripted; demo_scripted.run(2)"`（约 16 秒，结束自动关 PWM）。
3. 遥控排查：按上面"建议下一步" 2→3→4 顺序。
4. 所有板端文件改动后同步 PC 侧并跑 `python -m unittest discover -s tests`。
