paomodabaibai/CyberBrick2-User-Research-UX/06_游戏设计/地板无缝纹理_80x120cm_v09/print/01_A3双拼_打印12张_每张40x20cm.pdf

CYBER / ARENA | A3 · 横向 · 实际大小 100%

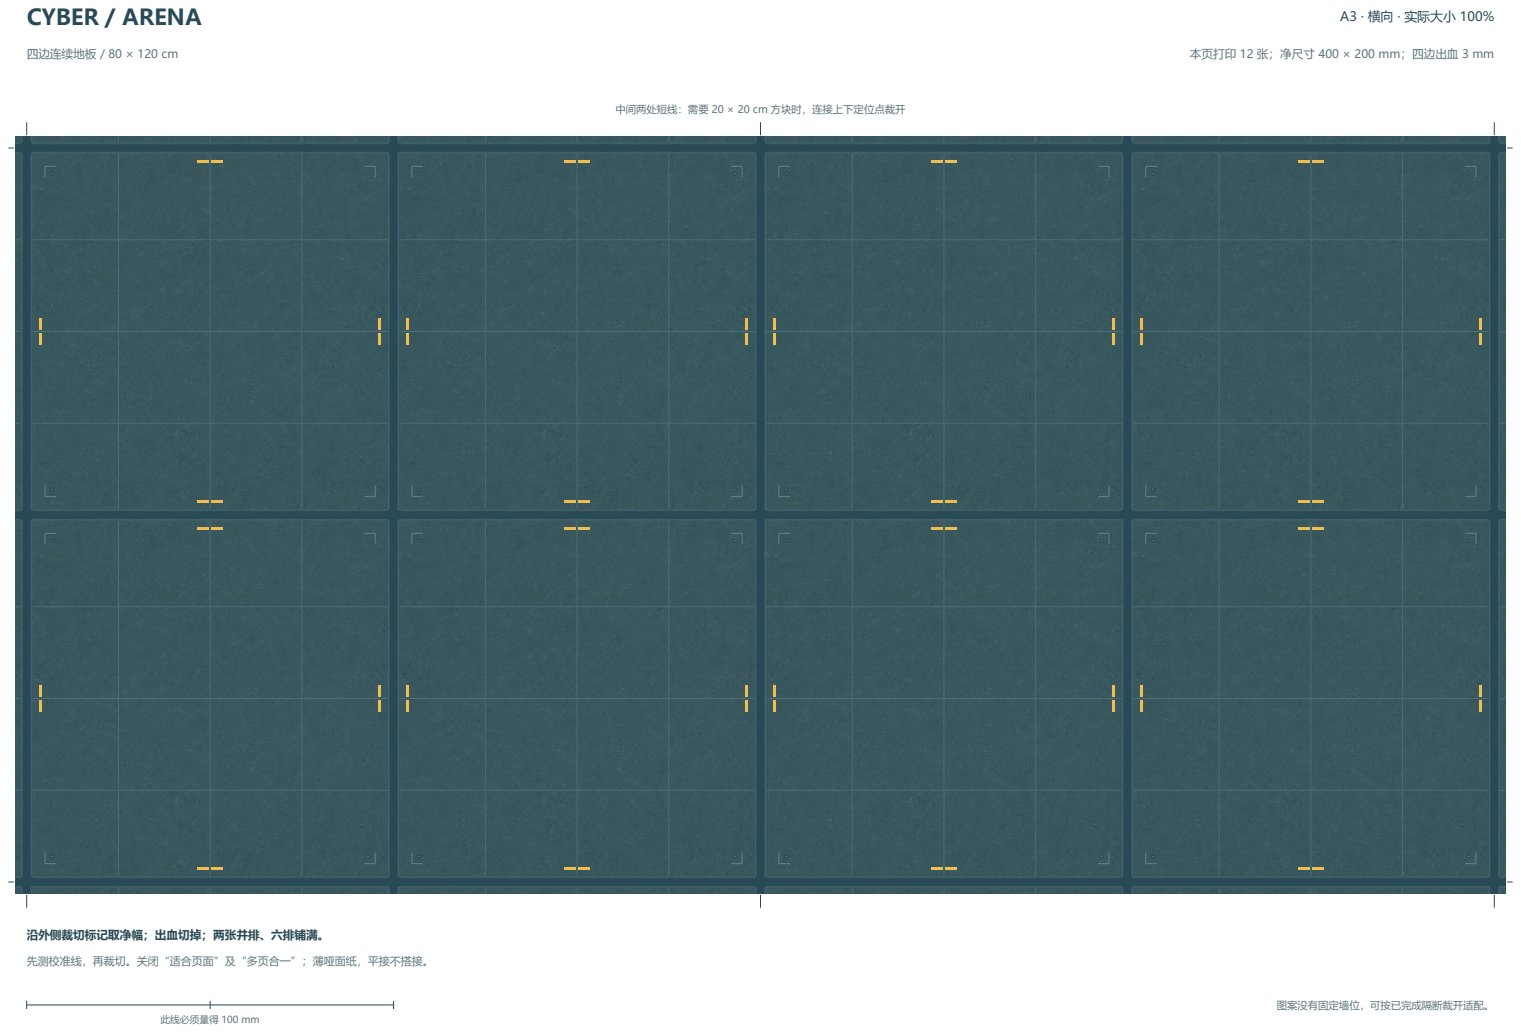
[picture p225: page 1]
四边连续地板 / 80 × 120 cm; 本页打印 12 张；净尺寸 400 × 200 mm；四边出血 3 mm; 此线必须量得 100 mm; 图案没有固定墙位，可按已完成隔断裁开适配。

中间两处短线：需要 20 × 20 cm 方块时，连接上下定位点裁开

沿外侧裁切标记取净幅；出血切掉；两张并排、六排铺满。

先测校准线，再裁切。关闭“适合页面”及“多页合一”；薄哑面纸，平接不搭接。
