paomodabaibai/CyberBrick2-User-Research-UX/06_游戏设计/地板无缝纹理_80x120cm_v09/print/03_整幅80x120cm_实尺打印.pdf

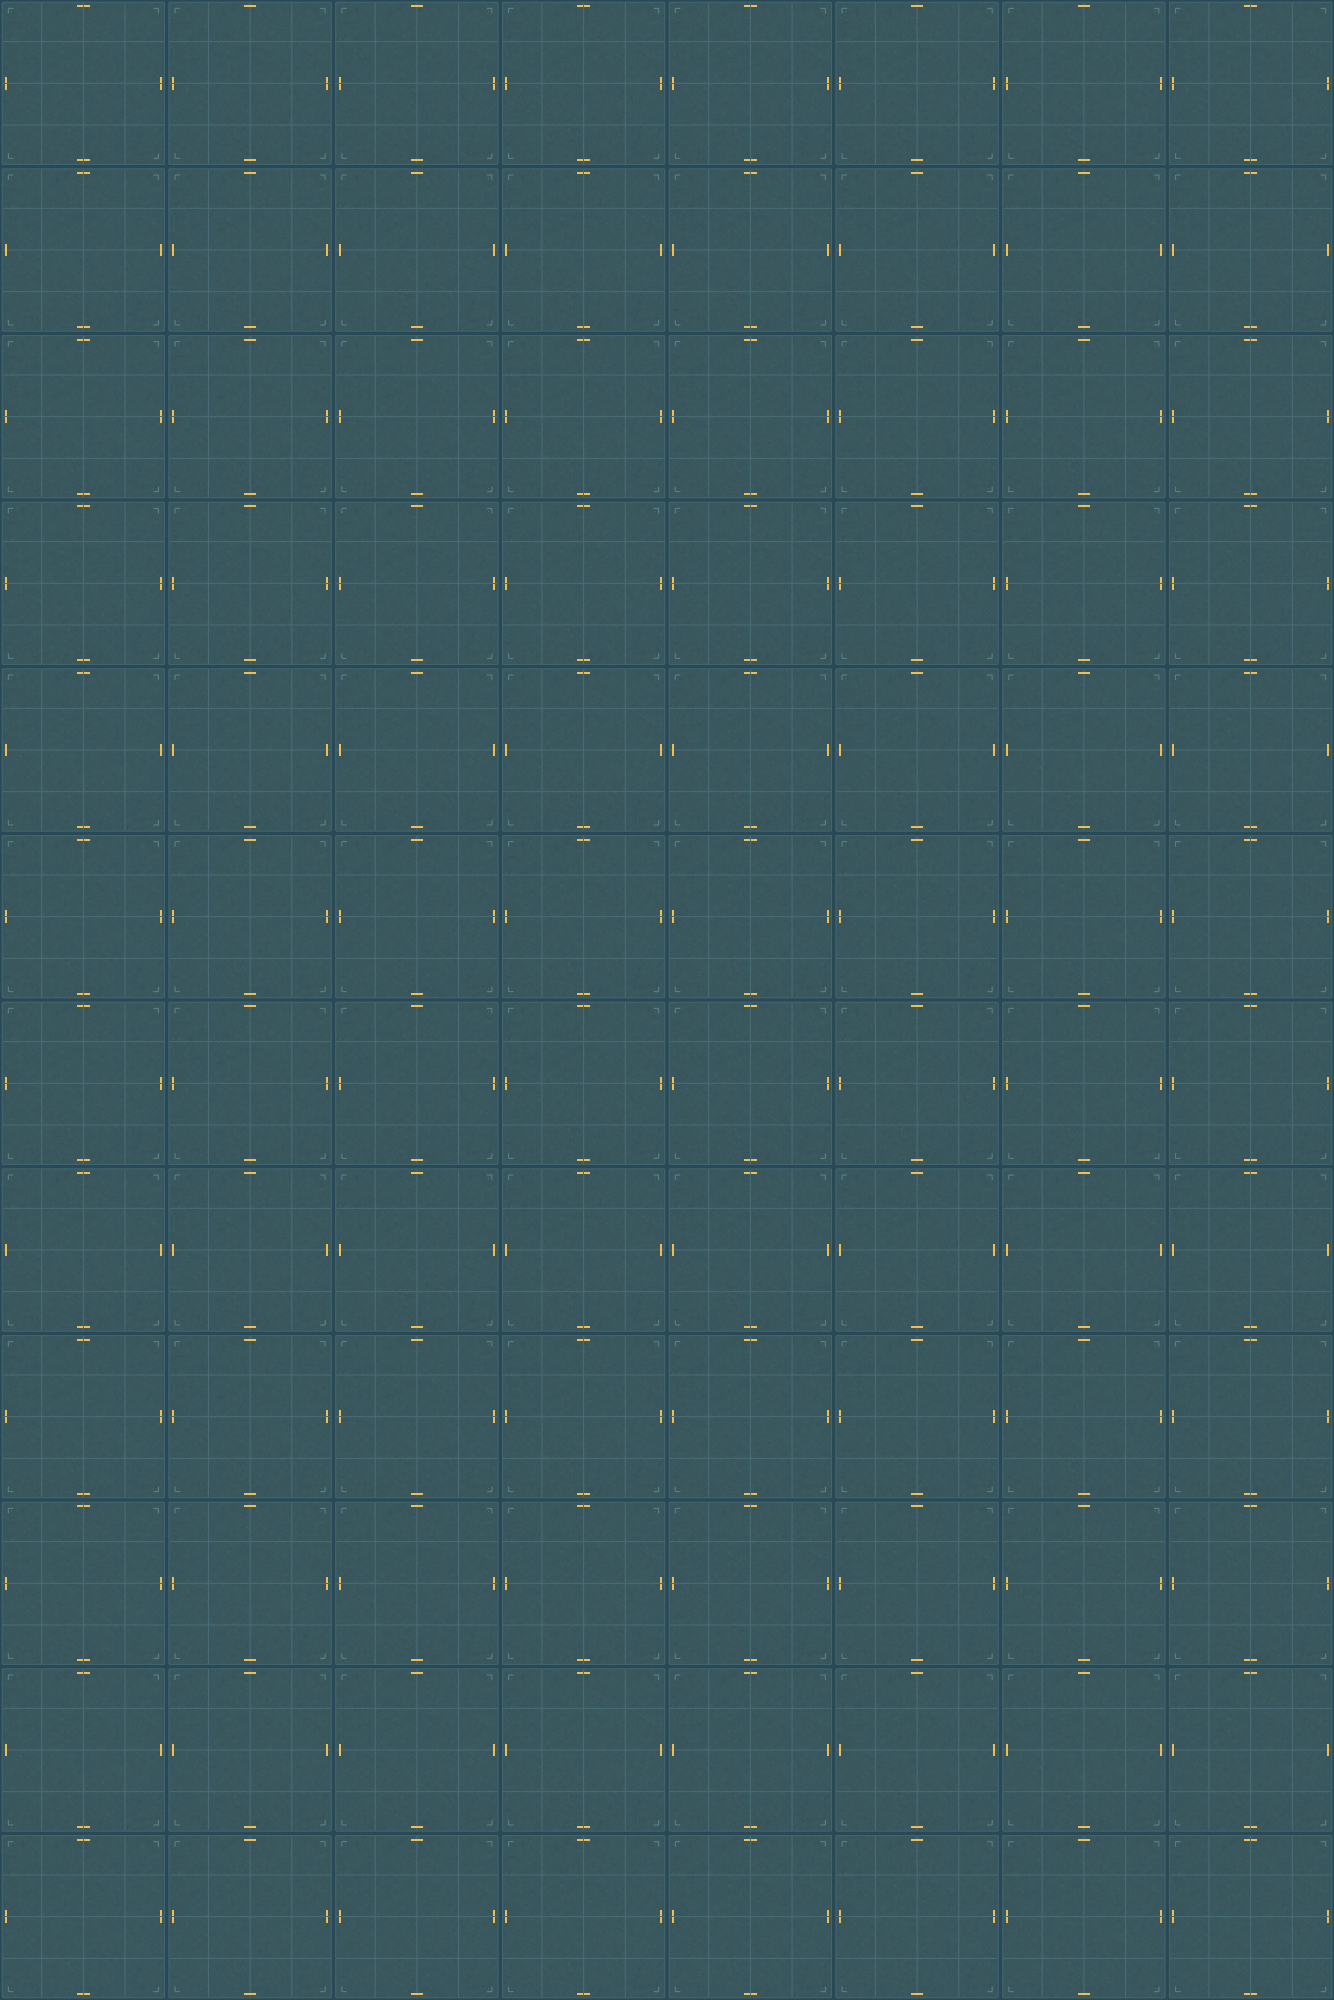
[picture p226: page 1]
