paomodabaibai/CyberBrick2-User-Research-UX/05_程序与测试/CB1_Otto控制框架_v02/second_punch_remote.py

"""Compatibility entry; both robots use robot_remote as the sole control core."""
from robot_remote import (RemotePolicy, WalkMotion, DanceMotion, run, monitor,
                          motor_service, diff, PORTS, DEFAULT, CONTROL_VERSION,
                          HIP_AMP, ANKLE_AMP, BIAS, TURN_SPLIT, run_forever)
