paomodabaibai/CyberBrick2-User-Research-UX/05_程序与测试/CB1_Otto单步实验_v01/test_dir_s1.py

import time
import machine
from milk_hw import Output
assert machine.Pin(10, machine.Pin.IN).value() == 0
out = Output()
try:
    print('S1 left_hip +10 NOW')
    out.joint(0, 10)
    time.sleep_ms(2000)
    out.joint(0, 0)
    time.sleep_ms(800)
    print('S1 left_hip -10 NOW')
    out.joint(0, -10)
    time.sleep_ms(2000)
    out.joint(0, 0)
    time.sleep_ms(500)
finally:
    out.close()
    print('S1 PWM OFF')
