paomodabaibai/CyberBrick2-User-Research-UX/05_程序与测试/CB1_Otto单步实验_v01/test_s1_live.py

import time
import machine
from milk_hw import Output
assert machine.Pin(10, machine.Pin.IN).value() == 0
out = Output()
try:
    print('S1 +/-5 degrees START')
    out.joint(0, 0)
    time.sleep_ms(300)
    for cycle in range(2):
        for a in list(range(0, 6)) + list(range(4, -6, -1)) + list(range(-4, 1)):
            out.joint(0, a)
            time.sleep_ms(60)
    time.sleep_ms(300)
finally:
    out.close()
    print('S1 PWM OFF')
