paomodabaibai/CyberBrick2-User-Research-UX/(commit log)

2026-09-28 初始化 CyberBrick 2.0 协作仓库
2026-10-11 Add Otto assembly guide, CB1 wiring map, and 90-degree hold tool
2026-10-11 Save reusable four-servo 120-to-90 assembly test
2026-10-11 Record transmitter pairing check and pending remote channel calibration
2026-10-11 Deploy retained remote mapping with current centers and run bounded test
2026-10-13 Document punch motor auto-run fix on both CB1 boards
2026-10-13 Document timed control session and LED observation
2026-10-17 Keep punch motor running while stick is held
2026-10-17 Increase all dance joint amplitudes to 25 degrees
2026-10-17 Add handmade arena plans, print sheets, and Figma 3D deliverables
2026-10-21 补充80×120厘米地图贴图、打印包与电影感插图
    - 收录手工制作图册、三维预览及配套打印模板
    - 新增深色与明亮科技风地板纹理、无缝拼接打印包和校验资料
    - 新增两组错位T形墙的带贴图地图模型、离线预览及导出文件
    - 保存双机器人纯插图、电影感横屏主视觉和生成提示词
    - 更新项目入口，并明确图片、模型与打印文档的二进制存储规则
2026-10-22 Archive final presentation media, deployed CB1 controls and printable targets
